lastoyz/dsn_pgu_adda_s3100_git/dsn/1.sch/S3100_CMU_ADDA__r210827__remap.pdf

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
SMBJ15A/DO-214AA
Breakdown Voltage: 18.5 V
Working Voltage: 15 V
Clamping Voltage: 24.4 V
Ipp - Peak Pulse Current: 24.6 A Package / Case: DO-214AA-2
Pd - Power Dissipation: 600 W

=== cut-off freq ===
1 / (2 * pi * sqrt (4.7e-6H * 22uF) ) = 15.6516404 kilohertz 1 / (2 * pi * sqrt (4.7e-6H * 47uF) ) = 10.708343 kilohertz

for power lines

for power lines

miniSMDC150F/16-2/4532
Hold Current: 1.5 A
Maximum Voltage: 16 V
Trip Current: 2.9 A
Resistance: 110 mOhms

LT1763CS8-5V
LT1763CS8-2.5V
LT1763CS8-3.3V
LT1763CS8-1.8V

DAMPER
Cbyp=22uF / Cdamp=470uF / L=4.7uH / R=0.22R Cbyp=10uF / Cdamp=220uF / L=2.2uH / R=0.22R Cbyp=100nF / Cdamp=4.7uF / L=22nH / R=0.22R

(15V-2.5V)/1mA=12.5Kohm

(15V-2.5V)/1.25mA=10Kohm ---- 1 / (2 * pi * (50 ohm) * (100 nF)) = 31.8309886 kilohertz 1 / (2 * pi * (50 ohm) * (10 pF)) = 318.309886 megahertz 1 / (2 * pi * (25e3 ohm) * (47 nF)) = 135.451015 hertz 1 / (2 * pi * (1000 ohm) * (47 nF)) = 3.38627538 kilohertz 1 / (2 * pi * (1000 ohm) * (470 nF)) = 338.627538 hertz 1 / (2 * pi * (1000 ohm) * (4700 nF)) = 33.8627538 hertz 1 / (2 * pi * (100 ohm) * (47 nF)) = 33.8627538 kilohertz 1 / (2 * pi * (100 ohm) * (470 nF)) = 3.38627538 kilohertz 1 / (2 * pi * (100 ohm) * (4700 nF)) = 338.627538 hertz ACASN1001S5001P1AT/1616 // Resistor Networks & Arrays 1K/5Kohm .1%/.05% 25/15ppm MPMA10015001AT5/SOT-23 // Resistor Networks & Arrays 1K/5Kohms 0.1%abs 0.05%ratio

414026-2
RF Series: SMB
Gender: Jack
Impedance: 50 Ohms
Minimum Frequency: -
Maximum Frequency: 4 GHz
Termination Style: Solder
Orientation: Right Angle
Polarity: Standard
Packaging: Bulk
Body Material: Brass
Contact Plating: Gold
Brand: TE Connectivity
Contact Material: Brass
Body Finish: Gold
Insulation Resistance: 1000 MOhms https://kr.mouser.com/datasheet/2/418/NG_CS_1307191_SMB_Connectors_0307-1234521.pdf

SRF2012A-121YA
Impedance: 120 Ohms
Tolerance: 25 %
Maximum DC Current: 400 mA
Maximum DC Resistance: 300 mOhms
Self Resonant Frequency: -
Minimum Operating Temperature: - 55 C Maximum Operating Temperature: + 125 C Package / Case: 0805 (2012 metric) Length: 2 mm
Width: 1.2 mm
Height: 1.2 mm
Packaging: Cut Tape
Packaging: MouseReel
Packaging: Reel
Product: Common Mode Line Filters https://kr.mouser.com/datasheet/2/54/rf2012aa-948268.pdf

DS90LV804TSQ/WQFN-32
Number of Drivers: 4 Driver Number of Receivers: 4 Receiver Data Rate: 800 Mb/s
Input Type: CML, LVDS, LVPECL Output Type: LVDS
Supply Voltage - Max: 3.45 V
Supply Voltage - Min: 3.15 V Minimum Operating Temperature: - 40 C Maximum Operating Temperature: + 85 C Mounting Style: SMD/SMT
Package / Case: LLP EP
Packaging: Cut Tape
Packaging: MouseReel
Packaging: Reel
Height: 0.8 mm
Input Voltage MAX: 0.1 V
Length: 5 mm
Series: DS90LV804
Width: 5 mm
Brand: Texas Instruments
Input Voltage MIN: - 0.1 V Maximum Output Voltage: 0.6 V Operating Supply Current: 140 mA Operating Supply Voltage: 3.3 V Pd - Power Dissipation: 4160 mW

SY89832UMG/QFN-16
Series: SY89832
Number of Outputs: 4 Output Maximum Input Frequency: 2.5 GHz Propagation Delay - Max: 570 ps Supply Voltage - Max: 2.625 V
Supply Voltage - Min: 2.375 V Minimum Operating Temperature: - 40 C Maximum Operating Temperature: + 85 C Mounting Style: SMD/SMT
Package / Case: QFN-16
Packaging: Tube
Brand: Microchip Technology / Micrel
Operating Supply Current: 75 mA
Product Type: Clock Buffer https://kr.mouser.com/datasheet/2/268/sy89832u-779039.pdf

1/(2*pi*47pF*10ohm)=338.627538 megahertz
1 / (2 * pi * (3.94700 nF) * (10 ohm)) = 4.03230157 megahertz
1 / (2 * pi * ((2.0 nF) + (47 pF)) * (10 ohm)) = 7.77503386 megahertz 1 / (2 * pi * ((1.0 nF) + (47 pF)) * (10 ohm)) = 15.2010452 megahertz GCM1885C1H202FA16J/2.0nF/1%/50V/1608

1/(2*pi*12pF*3*50ohm)=88.4194128 megahertz // 3 cap in IC
1 / (2 * pi * ((12 pF) + (130 pF)) * 3 * (50 ohm)) = 7.47206306 megahertz // 3 cap ext 1 / (2 * pi * ((12 pF) + (2* 56 pF)) * 3 * (50 ohm)) = 8.55671737 megahertz // 3 cap ext 1 / (2 * pi * ((12 pF) + (56 pF)) * 3 * (50 ohm)) = 15.6034258 megahertz

1.5A

THS4631DDA/SO-PowerPAD-8
http://www.ti.com/lit/ds/symlink/ths4631.pdf

1 / (2 * pi * (100 ohm) * (10 pF)) = 159.154943 megahertz

# 02. DAC powers regulators

# 03. [TRIG-IN/OUT, REF-IN/OUT] LVDS buffers and Clock IC trig signal to from FPGA/PLL // CMOS to LVDS

# 05. [ADC-IN] ADC port in (2ch) gain x1 or x1/12 // dc couple

# 06. ADC cores (2ch) Diff. driver // 15Msps ADC // filter BW7.5MHz // Clock driver

# 07. ADC control buffer (2ch) LVDS driver // 2.5V gate driver

# 08. AUX port and devices LAN port // DEBUG port // SIO port // EEPROM // TEMP sensor

== ext module control ==
3.3V
GND
CC11 : SDA // reserved for SSD1306 I2C CC9 : SCL // reserved ---- 3.3V

GND
CC8 : MOSI // reserved for MCP23S17 CC9 : SCLK // reserved
CC10: SCSB // reserved
CC12: MISO // reserved

TS1 TS0 SCALAR MULTIPLIER (µs/K) GND GND 10
GND VDD 40
VDD GND 160
VDD VDD 640 --T( C) = PERIOD(µs) / SCALAR MULTIPLIER(µs/ K) - 273.15 K --1MHz base count ... 0.1K resolution ... 16 bit counter

100C ~ 373K ~ 3730 us @ 10us/K 30C ~ 303K ~ 3030 us @ 10us/K

# 16. Mother board connector

S3100

# Mount holes and Power TP // Ground paths and Guide pin socket

# Powers on DGND

// +5VD

# 17. Mother board signal buffers

S3100

((3.3 V) - (1.0 V)) / (1e3 ohm) = 0.0023 amperes

# 10. Serial to Parallel circuits // MCP23S17T-E/ML and LED test drive

# 04. DAC cores (2ch) Single-Diff. translator // 400Msps DAC // filter BW90MHz // Clock IC

# 15. Powers on AGND // filters // +15V_FPGA // +15V_ANAL // +/-15V_AMP

# 14. Power Gated // +/-13.5V_AMP // +/-13.5V_ADC_BUF // +/-15V_AMP_GATED

# 12. Powers on GND_ANAL // REG and filter // +6V_ANAL // +5V_ANAL // +3.3V_ANAL // +2.5V_ANAL // +2.5V_ANAL_AUX

# 11. IO Powers on GND_FPGA // LDO REG and filter

// +3.3V_ISO | // +3.3V_FPGA_IO | // +3.3V_SP_IO // +3.3V_DAC_IO // +3.3V_EXT

XC6220B331MR-G/3.3V/1.2A/SOT-25-5 Package / Case: SOT-25-5
Output Voltage: 3.3 V
Output Current: 1.2 A
Number of Outputs: 1 Output Quiescent Current: 8 uA
Input Voltage MAX: 6 V
Input Voltage MIN: 1.6 V
Output Type: Fixed
Minimum Operating Temperature: - 40 C Maximum Operating Temperature: + 85 C Load Regulation: 10 mV
Dropout Voltage: 60 mV
Packaging: Cut Tape
Packaging: MouseReel
Packaging: Reel
Product: LDO Regulators
Type: Low Noise High Speed, CMOS LDO Voltage Regulator Brand: Torex Semiconductor
Dropout Voltage - Max: 655 mV
PSRR / Ripple Rejection - Typ: 50 dB
Voltage Regulation Accuracy: 1 % Line Regulation: 0.01 %/V
Operating Supply Current: 50 uA
Pd - Power Dissipation: 250 mW

# 13. Powers on GND_FPGA // SW REG // +5V_FPGA_CORE // MC1_VDCIN_P5V // +5V_FPGA_IO

# 01. [PULSE-OUT] AMP for DAC gain stage // LC filter

DAMPER
Cbyp=22uF / Cdamp=470uF / L=4.7uH / R=0.22R Cbyp=10uF / Cdamp=220uF / L=2.2uH / R=0.22R Cbyp=100nF / Cdamp=4.7uF / L=22nH / R=0.22R

1 / (2 * pi * (100 ohm) * (47 nF)) = 33.8627538 kilohertz 1 / (2 * pi * (100 ohm) * (470 nF)) = 3.38627538 kilohertz

1 / (2 * pi * (6000 ohm) * (47 nF)) = 564.379231 hertz 1 / (2 * pi * (6000 ohm) * (470 nF)) = 56.4379231 hertz

Place near R197
diff pair: Vadc2_amp_ac_P / Vadc2_amp_ac_N

Place near R286
diff pair: Vadc1_amp_ac_P / Vadc1_amp_ac_N

* note: place ADA4870ARRZ on BOT-side.

During normal operation, the TFL pin outputs a dc voltage (referenced to VEE) ranging from 1.5 V to 1.9 V that is relative to die temperature. The voltage on TFL changes at approximately
?3 mV/°C and can be used to indicate approximate increases in
die temperature.

* TEST drive

* trace in on BOT
* trace out on TOP

* place chokes on BOT

DAC data in has 100 ohm inside.

The pins are internally self-biased and the input signal should be ac-coupled via capacitors.

* trace in on BOT
* trace out on TOP

* place chokes on BOT

* TEST drive

DAC data in has 100 ohm inside.

*bias for 400mV
287/(287+1000)*1.8V = 0.401398601 volts 360/(360+1200)*1.8V = 0.415384615 volts

*bias for 400mV
287/(287+1000)*1.8V = 0.401398601 volts 360/(360+1200)*1.8V = 0.415384615 volts

1 / (2 * pi * (50 ohm) * (100 pF)) = 31.8309886 megahertz 1 / (2 * pi * (50 ohm) * (100 nF)) = 31.8309886 kilohertz 1 / (2 * pi * (50 ohm) * (47 nF)) = 67.7255077 kilohertz

SP_001
A[2,1,0]="001"

rise 0.05V/ms
((3.3 V) / (0.05 (V / ms))) / (2 * pi * (20e3 ohm)) = 525.211312 nanofarads

* ADC amp gain
12V --> 1V | vs | 11V --> 1V vs 1V --> 1V
1/12
x/(25+x)=1/12
25/x=12-1=11
x=25/11=2.273
24KR/1608/10ppm/0.05%/100mW_RG1608N-243-W-T1 2.2KR/1608/10ppm/0.05%/100mW_RG1608N-222-W-T1 2.2/(24+2.2)=0.08396946564=1/11.9090909091 2.4KR/1608/10ppm/0.05%/100mW_RG1608N-242-W-T1 2.2/(24+2.2)=0.0909090909=1/11

LT1763CS8-5V vs LT3045
... LT3045 for low noise 5V

ADP7182AUJZ-5.0-R7/TSOT-25-5 for -5V

250mA per ADA4870 supply with 50ohm load.

TS1 TS0 SCALAR MULTIPLIER (µs/K) GND GND 10
GND VDD 40
VDD GND 160
VDD VDD 640 --T( C) = PERIOD(µs) / SCALAR MULTIPLIER(µs/ K) - 273.15 K

삭삭:
PJ3
F3
L36
FB94
C399
CT15
C395

# LED17

R510
ZD46

삭삭:
U90
C475
C377
C376
R591
R592

삭삭:
U57
C347
ZD27
R906
R907

# LED19

C348
FB91
FB92

삭삭:
U58
C352
C353
C354
C355
U61
C372
C373
C374
C375
U63
C388
C394
C389
C393
U64
C400
C401
C402
C403

삭삭:
SJ3
SJ4
T7
T8
U113
U115
FB141
FB142
C608
C613
C625
C631
R697
R726
R734
R740
R750
R728
R731
R742
R748

삭삭:
U141
U142
D21
D22
D23
D24

삭삭:
Q1
ZD18
ZD19
Q2
ZD21
ZD20
TP66
TP70
RL1
RL2
Q3

# LED9

TP72

삭삭:
U31
U33
L27
L31
ZD40
ZD41
D5
D6
D4
D8

삭삭:
C226
C228
R184
R186
CT11
CT12

# < S3100-CMU-ADDA > Board name: S3100-CMU-ADDA ▶ Part number: S3100-CMU-ADDA-REV00 ▶ design file: S3100_CMU_ADDA__*.DSN

# Designed By: S JO Checked & Approved By: Jone

# === Revision note ===

Ver 0.0 || 2019.12.06 || PGU-CPU-F5500 test done.
Ver 1.0 || 2021.02.16 || PGU-CPU-S3000 initial draft.

# Ver 1.1 || 2021.04.05 || PGU-CPU-S3000 final BOM update

Ver 2.0 || 2021.05.13 || S3100-PGU initial draft.
Ver 3.0 || 2021.08.19 || S3100-CMU-ADDA initial draft.

# === PGU CPU BOARD ===

01.AMP for DAC [PULSE-OUT] 02.DAC powers 03.LVDS buffers and Clock IC [TRIG-IN/OUT, REF-IN/OUT] 04.DAC cores (2ch) 05.ADC port in (2ch) [ADC-IN] 06.ADC cores (2ch) 07.ADC control buffer (2ch) 08.AUX port and devices 09.FPGA interface (-1,-2,-3) 10.Serial to Parallel circuits 11.IO Powers on GND_FPGA 12.Powers on GND_ANAL 13.Powers on GND_FPGA 14.Power Gated 15.Powers on AGND 16.Mother board connector 17.Mother board signal buffer and power

# === 회회 및 BOM 변변변 요요 (2021.8.19) ===

S3100-CMU-ADDA 보보보 S3100-PGU 보보보보 수수수수, AC-counpled ADC 입입입 지지지지지.

# === Requirement === * PCB spec: FR-4, 6L, 1.6T, 360mm X 188.5mm * TOP/BOT impedance artwork (signle 50R / diff 100R)

* 2L and 5L are for GND.
* 3L and 4L are for GND / PWR.

# * BOARD edge clearance 2mm

* CGND on board egdes.

삭삭:
U133
U134

삭삭:
U111
L43
D16
C582
C583
R680
R674
C576
C592
R685
R686
R689
R692
C581
R683
C590
C595
R693
C599
R684
R690
C593

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
R698
R702
R706
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
FB149
FB150
ZD59
ZD60

삭삭:
U22
D3
L13
R82
C98
C114
C118
R102
C137
R129
R135
C157
C149
R103
C113
C131
TP43
R115
R123
C135

0
1 | 5 | 9-1 | 13
2 | 6 | 9-2 | 14
3 | | 9-3 | 15
4 | 7 12 | 10 | 16
| 8 11 | | 17

삭삭:
U3
FB13

[Molex]1719710006//50579406 --> [Molex]1719740006//50579406

mating part: [Molex]50579406

# ===final revision (2021.09.xx) ===

* 2021.5.13
임임 전전 커커커 파파 변변:

2EDGR-5.08-02P//2EDGK-5.08-02P --> 2EDGV-5.08-02P//2EDGK-5.08-02P

Guide Module
P1 for M3 bolt (PLATED)
P2/P3 for module guide pins (NON-PLATED)

삭삭:
LJ1
LJ2

# power net LAN_P3V3

삭삭:
TP
F5500용

DIAG_SIGNAL
DIAG_GUARD

DIAG_SIGNAL
DIAG_GUARD

DIAG_SIGNAL
DIAG_GUARD

M1_SPI_TX_CLK+
M1_SPI_TX_CLK-

M1_SPI_MOSI+
M1_SPI_MOSI-

M0_SPI_MOSI+ M0_SPI_MOSI-

M0_SPI_TX_CLK+ M0_SPI_TX_CLK- | M1_SPI_CS M0_SPI_CS

CAL_SPI_CS
CAL_SPI_CLK

CAL_SPI_MOSI
CAL_SPI_MISO

NC
BD_nRESET

NC
PRE_TRIG+
PRE_TRIG-

TRIG+ TRIG-

SOT+
SOT-

M1_SPI_RX_CLK+ M1_SPI_RX_CLK- M1_SPI_MISO+ M1_SPI_MISO-

M0_SPI_MISO+ M0_SPI_MISO-

M0_SPI_RX_CLK+ M0_SPI_RX_CLK-

DIAG_SIGNAL DIAG_GUARD

R1
R2---- R2 = R1 / ( Vo/0.798 -1 )

Vo = ( 1 + R1 / R2 ) * 0.798
( 1 + 40.2 / 7.68 ) * 0.798 = 4.97503125 V ( 1 + 40.2 / 6.8 ) * 0.798 = 5.51558823529 V ---- 40.2K/1608/0.1%_ERJ-PB3B4022V

7.68K/1608/0.1%_ERJ-PB3B7681V 6.8K/1608/0.1%_ERJ-PB3B6801V

R1
R2---- R2 = R1 / ( Vo/0.798 -1 )

Vo = ( 1 + R1 / R2 ) * 0.798
( 1 + 40.2 / 7.68 ) * 0.798 = 4.97503125 V ( 1 + 40.2 / 6.8 ) * 0.798 = 5.51558823529 V ---- 40.2K/1608/0.1%_ERJ-PB3B4022V

7.68K/1608/0.1%_ERJ-PB3B7681V 6.8K/1608/0.1%_ERJ-PB3B6801V

R1
R2---- R2 = R1 / ( Vo/0.798 -1 )

Vo = ( 1 + R1 / R2 ) * 0.798
( 1 + 40.2 / 7.68 ) * 0.798 = 4.97503125 V ( 1 + 40.2 / 6.8 ) * 0.798 = 5.51558823529 V ---- 40.2K/1608/0.1%_ERJ-PB3B4022V

7.68K/1608/0.1%_ERJ-PB3B7681V 6.8K/1608/0.1%_ERJ-PB3B6801V

R1
R2---- R2 = R1 / ( Vo/0.798 -1 )

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

7.68K/1608/0.1%_ERJ-PB3B7681V 6.8K/1608/0.1%_ERJ-PB3B6801V

R1
R2---- R2 = R1 / ( Vo/0.798 -1 )

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

7.68K/1608/0.1%_ERJ-PB3B7681V 6.8K/1608/0.1%_ERJ-PB3B6801V

for SY89832UMG/QFN-16

for SY89833LMG/QFN-16

for SY89832UMG/QFN-16

for SY89833LMG/QFN-16

삭삭:

U6
FB9

PN SWAP

PN SWAP

삭삭:
JJ1

# JTAG_PWR

삭삭:

FB6
FB7

# 09-1. FPGA interface

# 09-2. FPGA interface

# 09-3. FPGA interface

# +1.0VF GEN (for FPGA VCCINT)

Rb = (0.75 * 100,000) / (1.0 - 0.75) = 75,000 / 0.25
= 300,000
= 300K

# <MAX 3.0A>

Ra

Rb

# [FPGA Power] VCCINT = 1.0V VCCBRAM = 1.0V VAUX = 1.8V VAUX_IO = 1.8V VCCO_HR = 1.14~3.465V VCCO_HP = 1.14~1.89V (Spartan7에에 없없) VCCBATT = 1.8V VCCADC = 1.8V

# <MAX 2.0A>

R1

R2

# +3.3VF (for FPGA VCCO_HR)

TPS82084SIL:
Vout = 0.8V * (1+(R1/R2)) ---- 3.31V = 0.8V * (1+(160K/51K))

3.35V = 0.8V * (1+(510K/160K))

# +3.3VD GEN (for MAIN)

# <MAX 2.0A>

R1

R2

TPS82084SIL:
Vout = 0.8V * (1+(R1/R2)) ---- 3.31V = 0.8V * (1+(160K/51K))

3.35V = 0.8V * (1+(510K/160K))

# +1.8VF GEN (for FPGA VAUX)

# <MAX 2.0A>

R1

R2

TPS82084SIL:
Vout = 0.8V * (1+(R1/R2)) ---- 1.8V = 0.8V * (1+(200K/160K))

Initialization (bar)
Active-Low FPGA initialization pin or configuration error signal. The FPGA drives this pin Low when the
FPGA is in a configuration reset state, when the FPGA is initializing (clearing) its configuration memory, or when the FPGA has detected a configuration error. Upon completing the FPGA initialization process, INIT_B is released to high-Z at which time an external resistor is expected to pull INIT_B High. INIT_B can externally be held Low during power-up to stall the power-on configuration sequence at the end of the initialization process. When a High is detected at the INIT_B input after the initialization process, the FPGA proceeds with the remainder of the configuration sequence dictated by the M[2:0] pin settings.
Connect INIT_B to a ≤ 4.7 kΩ pull-up resistor to VCCO_0 to ensure clean Low-to-High transitions.

# [JTAG]

Done
A High signal on the DONE pin indicates completion of the configuration sequence. The DONE output is an open-drain output by default.

Program (bar)
Active-Low reset to configuration logic. When PROGRAM_B is pulsed Low, the FPGA configuration is cleared and a new configuration sequence is initiated. Configuration reset initiated upon falling edge, and configuration (i.e. programming) sequence begins upon the following rising edge.
Connect PROGRAM_B to an external ≤ 4.7 kΩ pull-up resistor to VCCO_0 to ensure a stable High input, and recommend push-button to GND to enable manual configuration reset.

# [FPGA Power] VCCINT = -0.5~1.1 [1.0V] VCCBRAM = -0.5~1.1 [1.0V] VCCAUX = -0.5 ~ 2.0V [1.8V] VCCAUX_IO = -0.5 ~ 2.0V [1.8V] VCCO_HR = 1.14~3.465V VCCO_HP = 1.14~1.89V (Artix7에에 없없) VCCBATT = -0.5 ~ 2.0V [1.8V] VCCADC = -0.5 ~ 2.0V [1.8V]

# [FPGA Power] VCCADC = -0.5 ~ 2.0V [1.8V] VREF = -0.5 ~ 2.0V [1.25V] to GNDADC

# FPGA - POWER

# MT25QL = 2.7V ~ 3.6V MT25QU = 1.7V ~ 2.0V

# [FPGA Power] VCCINT = -0.5~1.1 [1.0V] VCCBRAM = -0.5~1.1 [1.0V] VCCAUX = -0.5 ~ 2.0V [1.8V] VCCAUX_IO = -0.5 ~ 2.0V [1.8V] VCCO_HR = 1.14~3.465V VCCO_HP = 1.14~1.89V (Artix7에에 없없) VCCBATT = -0.5 ~ 2.0V [1.8V]

Pull-Up During Configuration (bar)
Active-Low PUDC_B input enables internal pull-up resistors on the SelectIO pins after power-up and during configuration.
> When PUDC_B is Low, internal pull-up resistors are enabled on each SelectIO pin.
> When PUDC_B is High, internal pull-up resistors are disabled on each SelectIO pin.
PUDC_B must be tied either directly, or via a ≤ 1kΩ to VCCO_14 or GND.
Caution! Do not allow this pin to float before and during configuration

If the TCK signal is
buffered, connect the buffer input to an external weak (e.g. 10 kΩ) pull-up resistor to maintain a valid High when no cable is connected.

If the TMS signal is buffered, connect the buffer
input to an external weak (e.g. 10 kΩ) pull-up resistor to maintain a valid High when no cable is connected.

VCCBATT is required only when using bitstream encryption. If battery is not used, connect VCCBATT
to either ground or VCCAUX.

If the VCCO_0 supply for bank 0 is
supplied with 2.5V or 3.3V, then the CFGBVS pin must
be tied High (i.e. connected to VCCO_0). Tie CFGBVS to Low (i.e. connected to GND), only if the VCCO_0 for bank 0 is less than or equal to 1.8V. If used during configuration, banks 14 and 15 should match the VCCO level applied to bank 0

Configuration Mode Sel (M2:0)
- Master SPI: 001
- Master Serial: 000
- JTAG: 101

# <MAX 1.0A>

# S25FL256SAGNFI001

# S25FL128SAGNFI001

# MT25QU256ABA1EW9_0SIT

Temperature-sensing diode pins (Anode: DXP; Cathode:
DXN). The thermal diode is accessed by using the DXP and DXN pins in bank 0. When not used, tie to GND.

# FPGA - Configuration Part

# EEPROM 16K 2048X8 1.8V~3.3V SERIAL EE IND

# FPGA IO

<0.55V>

# [FPGA Power] MGTAVCC = 1.0V MGTAVTT = 1.25V

# BANK 216 : MGT (NOT USED)

# Silk : ADDA BD ID : 0x05 <LSB 4Bits>

[0] [1]
[0] [1]

또또 INT를 제제제제
INT동동동동

RST를 제제제제 initialize or re-initialize

W5500

폴폴폴폴폴폴
구동
to. WIZ850 J1 | to. WIZ850 J2

JL1

JL2

# LAN 모모모모모모모모 Connector

# [F_LED0]

# [F_LED7]

# FPGA IO

* note: DAC1 has pn swap pairs.

AGND

+15V_FPGA

GND_FPGA

AGND

+15V_ANAL

GND_ANAL

+15VAIN

AGND

-15VAIN

+15V_AMP

GND_AMP

-15V_AMP

+13.5V_AMP

-13.5V_AMP

+6V_ANAL

+5V_ANAL

+2.5V_ANAL

GND_ANAL

GND_ANAL

GND_ANAL

GND_ANAL

+6V_ANAL_DAMP

+6V_ANAL_DAMP | +2.5V_ANAL_AUX

CGND

DGND | CGND
AGND | CGND

GND_AMP

GND_AMP | GND_ANAL

GND_AMP

GND_AMP | GND_ANAL

+5V_ANAL

GND_ANAL

+6V_ANAL_DAMP | +3.3V_ANAL0

GND_ANAL

+2.5V_ANAL

+5V_ANAL

GND_ANAL

+3.3V_ANAL2 | GND_FPGA

GND_ANAL

+2.5V_ANAL_AUX

GND_ANAL

GND_FPGA
GND_ANAL

+3.3V_ANAL1

GND_FPGA
GND_ANAL

+3.3V_ANAL0

GND_AMP

-13.5V_ADC_BUF

+13.5V_ADC_BUF

GND_AMP

-13.5V_ADC_BUF

+13.5V_ADC_BUF

-13.5V_AMP

+13.5V_AMP

+13.5V_ADC_BUF

-13.5V_ADC_BUF

GND_AMP

GND_AMP

+2.5V_ANAL_AUX

GND_ANAL

GND_FPGA

DISP_P3V3

GND_FPGA

GND_FPGA

TEMP_P3V3

GND_FPGA

MEM_P3V3

+15V_FPGA

GND_FPGA

+5V_FPGA_CORE

+5V_FPGA_IO

+3.3V_FPGA_IO

+3.3V_EXT

DGND

+15V_ANAL

GND_ANAL

+2.5V_ANAL_AUX

+5V_ANAL | +6V_ANAL

+2.5V_ANAL

+15VAIN

AGND

-15VAIN

+15V_AMP

-15V_AMP

+13.5V_AMP

GND_AMP

-13.5V_AMP

GND_FPGA

LED_P3V3

GND_FPGA

GND_FPGA

+3.3V_FPGA_IO

+5V_FPGA_IO

GND_FPGA

+3.3V_FPGA_IO | GND_FPGA

+3.3V_EXT

+5V_FPGA_IO

GND_FPGA

SPO_P3V3

LED_P3V3

GND_ANAL

+3.3V_ANAL1

GND_ANAL

+3.3V_ANAL2

+3.3V_ANAL0 | +3.3V_ANAL1 | +3.3V_ANAL2

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

+1.8VF

+1.8VF

VCC_ADC

+1.0VF

+3.3VF

VCC_ADC

+1.8VF | CONF_POW_1.8V

CONF_POW_1.8V

CONF_POW_1.8V

CONF_POW_1.8V | CONF_POW_1.8V

CONF_POW_1.8V

CONF_POW_1.8V

CONF_POW_1.8V

CONF_POW_1.8V

+1.8VF

+1.0VF

GND_ADC

GND_ADC
GND_ADC

GND_ADC

GND_ADC

GND_ADC

GND_FPGA

GND_FPGA

GND_FPGA

GND_FPGA

GND_FPGA

GND_FPGA

GND_FPGA

GND_FPGA

GND_FPGA | GND_FPGA

GND_FPGA

+3.3VF | +3.3VF

+3.3VF

GND_FPGA

GND_FPGA

+3.3VF | +3.3VF

+3.3VF

+3.3VF

+3.3VF | +3.3VF

+3.3VF

+3.3VF

+3.3VD | +3.3VD

+3.3VF

+3.3VF

+3.3VF

GND_FPGA

GND_FPGA

GND_FPGA

GND_FPGA

GND_FPGA

+1.8VF | +1.8VF

+3.3VF

+3.3VF | +3.3VF

+3.3VF

+1.8VF

+3.3VF

GND_FPGA | GND_FPGA
+3.3VF | +3.3VF | +3.3VF | +3.3VF

FPGA_CFG_D0

FPGA_CFG_D1

FPGA_CFG_D2

FPGA_CFG_D3

FPGA_CFG_PUDC_B

FPGA_CFG_FCS_B

FPGA_CFG_D0
FPGA_CFG_D1
FPGA_CFG_D2
FPGA_CFG_D3

FPGA_CFG_FCS_B

FPGA_CFG_PUDC_B

Title:

Size | Document Number | Rev
Date: | Sheet | of

Designed Checked Approved

TEAM

- 1.0

S3100-CMU-ADDA

Custom | S. JO | - | ____
Friday, August 27, 2021 | 1 | 2
| TBU

Title:

Size | Document Number | Rev
Date: | Sheet | of

Designed Checked Approved

TEAM

- 1.0

S3100-CMU-ADDA

Custom | S. JO | - | ____
Friday, August 27, 2021 | 1 | 2
| TBU

Title:

Size | Document Number | Rev
Date: | Sheet | of

Designed Checked Approved

TEAM

- 1.0

S3100-CMU-ADDA

Custom | S. JO | - | ____
Friday, August 27, 2021 | 1 | 2
| TBU

U163

SN74LVC1G126DBVR

OE 1

A 2

GND 3 | Y | 4
| VCC | 5

ZD5

BZT52C3V6_7_F/SOD-123 A C

R11

160K_F_1608

R92
2K_F_1608

C81

100NF_10V_0603

ZD50

BZT52C6V8-7-F/SOD-123

A C

C272

100nF/1005/10V

R98
0_F_1608

R727
100R/0603/1%

U166

SN74LVC1G126DBVR

OE 1

A 2

GND 3 | Y | 4
| VCC | 5

C145

1uF/2012/10V

C342
100nF/2012/16V/5%_VJ0805Y104JXJCW1BC

LCM23

EXC-24CH500U/1210/50R

1

2 | 3
| 4

F1

MINIASMDC150F/16-2/4532

1 | 2

C96

100NF_10V_0603

C147

10uF/3216/25V/10%

ZD53

ATV02W5V0B-HF/SOD-123

TP261

TP_DIP_H0_5XC0_9

1

R705
5.1KR/1608/10ppm/0.05%/100mW_RG1608N-512-W-T1

R984
1K/1608/1%

MH2
Mount_Hole

1

FB27

BLM21PG600SN1D_60R/3A/25%/2012

R768
100R/0603/1%

C565

100nF/3216/50V/5%_CGA5L2C0G1H104J160AA

R182

10K/1608/1%

C554
10uF/3216/25V/10%

R668
300R/1608/10ppm/0.05%/100mW_RG1608N-301-W-T1

F_LD2

LED_GREEN_SMD1608

C | A

U145

ADP7182AUJZ-5.0-R7/-5V/0.2A/TSOT-25-5

1 GND 2 Vin 3 EN | NC | 4 Vout 5

R831
100R/0603/1%

R124
10K_F_1608/DNP

J4

PIN_HEADER_2X5(2.54)

1 | 2 3 | 4 5 | 6 7 | 8 9 | 10

C114

100NF_10V_0603

C601
100nF/2012/16V/5%_VJ0805Y104JXJCW1BC

C249
100nF/2012/16V/5%_VJ0805Y104JXJCW1BC

C627
100nF/2012/16V/5%_VJ0805Y104JXJCW1BC

TP223

TP_DIP_H0_5XC0_9 1

GJ1

5223979-2

1
2
3

R887
0R/1608/1%

R712
0R/1608/1%

R139
0_F_1005

D15

1N4448WX-TP/75V/500mA/SOD-323

A | K

FB144

BLM21PG600SN1D_60R/3A/25%/2012

R300
0R/1608/1%

R1027

10K/1608/1%

R168
51_F_1608

LED12

RED/2012 C | A

R979
100KR/1608/1%

C547

1000pF/1608/50V/1%

U144

XC6220B331MR-G/3.3V/1.2A/SOT-25-5

Vin 1
GND 2
Ven 3 | BYPASS | 4
| Vout | 5

C344

100nF/2012/16V/5%_VJ0805Y104JXJCW1BC

C115

100NF_10V_0603

L42

100nH/2520/1%_LQW2UASR10F00L

LCM31

EXC-24CH500U/1210/50R

1

2 | 3
| 4

R545
0R/2012/1%

C322
100nF/1005/10V

FB2

BLM21PG600SN1D_60R/3A/25%/2012

C8

100nF/1005/10V

C330
47nF/1005/50V/5%_CC0402JRX7R9BB473

C244
100nF/3216/50V/5%_CGA5L2C0G1H104J160AA

LED7

GREEN/2012

A C

R1009 | 7.68K/1608/0.1%_ERJ-PB3B7681V

C326
47nF/1005/50V/5%_CC0402JRX7R9BB473

R918
30.1R/3216/25ppm/0.1%/2W_PCAN1206E30R1BST5

C62

100NF_10V_0603

R315
1K/1608/1%

+
CT1

470uF/7343/10V/10%/200mR_TPSE477K010R0200

R996 | 40.2K/1608/0.1%_ERJ-PB3B4022V

U19

XC6210B252MR-G/2.5V/0.7A/SOT-25-5

Vin 1
GND 2
Ven 3 | BYPASS | 4
| Vout | 5

TP124

TP_DIP_H0_5XC0_9

1

C604

10uF/3216/25V/10%

R905
0R/1608/1%

C266
47nF/1005/50V/5%_CC0402JRX7R9BB473

C648
100nF/2012/16V/5%_VJ0805Y104JXJCW1BC

MH7
Mount_Hole

1

R744
499R/1608/10ppm/0.05%/100mW_RG1608N-4990-W-T1

R879
0R/1608/1%

FB26

BLM21PG600SN1D_60R/3A/25%/2012

R309
0R/1608/1%

R797
100R/0603/1%

FB139

FBMH1608HM102-T_1KR/0.5A/25%/350mR/1608

TP216

TP_DIP_H0_5XC0_9 | 1

R328
0R/1608/1%

FB132

BLM21PG600SN1D_60R/3A/25%/2012

R94

0R/1608/1%

U127

NL17SV04XV5T2G/SOT-553

out 4

+ 5 - 3 in 2

FB65

BLM18KG121TH1D_120R/3A/25%/30mR/1608

C248

4.7uF/2012/50V/10%_CGA4J1X7R1H475K125AE

F7

PFMF.020.2/400mA_TR/400mR/4532 1 | 2

C504
100nF/2012/16V/5%_VJ0805Y104JXJCW1BC

R870

100R/0603/1%

TP7 TP_DIP_H0_5XC0_9

1

R90
2K_F_1608

R119
0_F_1608/DNP

R682

2.2K/1608/1%

C692
10pF/1608/50V/0.5pF__CGA3E2C0G1H100D080AD

R543
0R/2012/1%

LCM18

EXC-24CH500U/1210/50R

1

2 | 3
| 4

R830

49.9R/1608/25ppm/0.05%/100mW_WIN-T0603LF-03-49R9-A

C616
100nF/2012/16V/5%_VJ0805Y104JXJCW1BC

R719
100R/0603/1%

R802
100R/0603/1%

R720
0R/1608/1%

FB140

FBMH1608HM102-T_1KR/0.5A/25%/350mR/1608

R14

51K_F_1608

C64

100NF_10V_0603

R627
0R/2012/1%

R869
0R/1608/1%
1 | TP248 | TP_DIP_H0_5XC0_9

L37

IHLP2525BDER4R7M01/4.7uH

C722

100nF/1005/10V

FB81

BLM21PG600SN1D_60R/3A/25%/2012

U123

FIN1101K8X/US8-8

4 | GND_1
3 | EN | OUT+ | 6
2 | GND | VCC | 7
1 | IN-
OUT- | 5 IN+ | 8

C545
10uF/3216/25V/10%

C524

10uF/3216/25V/10%

C31

22UF_6.3V_2012_MLCC

C556

1000pF/1608/50V/1%

C84

100NF_10V_0603

FB57

BLM18KG121TH1D_120R/3A/25%/30mR/1608

R828
100R/0603/1%

R775
0R/1608/1%

T3

ACM1211-102-2PL-TL01/33.7uH/1K/6A/14mR/1211

1

3 | 2

4

C233
(OPEN)180pF/1608/50V/1%

R522
33R/1608/1%

TP222

TP_DIP_H0_5XC0_9 | 1

R839
(OPEN)0R/1608/1%

C615
100nF/2012/16V/5%_VJ0805Y104JXJCW1BC

C559
1000pF/1608/50V/1%

R778
100R/0603/1%

C242
10pF/1608/50V/0.5pF__CGA3E2C0G1H100D080AD

R898
20K/1608/1%

R43

0R/1608/1%

U107

AD8009ARZ/SOIC-8

4

V- 6
OUT | 3 +IN | 2
-IN 7 | V+ | 1

NC1

5

NC3

8

NC2

FB61

BLM21PG600SN1D_60R/3A/25%/2012

R152-1
330_F_1005

C128

100NF_50V_1005

C471

(OPEN)1000pF/1608/50V/1%

R165
51_F_1005

D16

FDLL4148/SOD

C

A

R971
0R/2012/1%

C570
10uF/3216/25V/10%

TP211

TP_DIP_H0_5XC0_9 | 1

LCM45

EXC-24CH500U/1210/50R

1

2 | 3
| 4
TP6 | TP_DIP_H0_5XC0_9

1

R104
0_F_1608

C143
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
