lastoyz/dsn_pgu_adda_s3100_git/txem7310_pll/_ref/PGU-CPU-S3100__R20210525.pdf

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
# * Measure: 3.3V * 1/11 = 0.3V See https://www.xilinx.com/support/documentation/user_guides/ug480_7Series_XADC.pdf Figure 2-8: Differential Input Signal Range // common mode 0.5V, diff mode 1V max

SILK:[0.275V] | SILK:[0.55V]

SMBJ15A/DO-214AA
Breakdown Voltage: 18.5 V
Working Voltage: 15 V
Clamping Voltage: 24.4 V
Ipp - Peak Pulse Current: 24.6 A Package / Case: DO-214AA-2
Pd - Power Dissipation: 600 W

=== cut-off freq ===
1 / (2 * pi * sqrt (4.7e-6H * 22uF) ) = 15.6516404 kilohertz 1 / (2 * pi * sqrt (4.7e-6H * 47uF) ) = 10.708343 kilohertz

for power lines

for power lines

miniSMDC150F/16-2/4532
Hold Current: 1.5 A
Maximum Voltage: 16 V
Trip Current: 2.9 A
Resistance: 110 mOhms

LT1763CS8-5V
LT1763CS8-2.5V
LT1763CS8-3.3V
LT1763CS8-1.8V

DAMPER
Cbyp=22uF / Cdamp=470uF / L=4.7uH / R=0.22R Cbyp=10uF / Cdamp=220uF / L=2.2uH / R=0.22R Cbyp=100nF / Cdamp=4.7uF / L=22nH / R=0.22R

CLK_COUT_PN 400MHz
ADC Conv clock 1 ~ 15MHz
DAC rate 400MHz

(15V-2.5V)/1mA=12.5Kohm

(15V-2.5V)/1.25mA=10Kohm ---- 1 / (2 * pi * (50 ohm) * (100 nF)) = 31.8309886 kilohertz 1 / (2 * pi * (50 ohm) * (10 pF)) = 318.309886 megahertz 1 / (2 * pi * (25e3 ohm) * (47 nF)) = 135.451015 hertz 1 / (2 * pi * (1000 ohm) * (47 nF)) = 3.38627538 kilohertz 1 / (2 * pi * (1000 ohm) * (470 nF)) = 338.627538 hertz 1 / (2 * pi * (1000 ohm) * (4700 nF)) = 33.8627538 hertz 1 / (2 * pi * (100 ohm) * (47 nF)) = 33.8627538 kilohertz 1 / (2 * pi * (100 ohm) * (470 nF)) = 3.38627538 kilohertz 1 / (2 * pi * (100 ohm) * (4700 nF)) = 338.627538 hertz ACASN1001S5001P1AT/1616 // Resistor Networks & Arrays 1K/5Kohm .1%/.05% 25/15ppm MPMA10015001AT5/SOT-23 // Resistor Networks & Arrays 1K/5Kohms 0.1%abs 0.05%ratio

414026-2
RF Series: SMB
Gender: Jack
Impedance: 50 Ohms
Minimum Frequency: -
Maximum Frequency: 4 GHz
Termination Style: Solder
Orientation: Right Angle
Polarity: Standard
Packaging: Bulk
Body Material: Brass
Contact Plating: Gold
Brand: TE Connectivity
Contact Material: Brass
Body Finish: Gold
Insulation Resistance: 1000 MOhms https://kr.mouser.com/datasheet/2/418/NG_CS_1307191_SMB_Connectors_0307-1234521.pdf

SRF2012A-121YA
Impedance: 120 Ohms
Tolerance: 25 %
Maximum DC Current: 400 mA
Maximum DC Resistance: 300 mOhms
Self Resonant Frequency: -
Minimum Operating Temperature: - 55 C Maximum Operating Temperature: + 125 C Package / Case: 0805 (2012 metric) Length: 2 mm
Width: 1.2 mm
Height: 1.2 mm
Packaging: Cut Tape
Packaging: MouseReel
Packaging: Reel
Product: Common Mode Line Filters https://kr.mouser.com/datasheet/2/54/rf2012aa-948268.pdf

DS90LV804TSQ/WQFN-32
Number of Drivers: 4 Driver Number of Receivers: 4 Receiver Data Rate: 800 Mb/s
Input Type: CML, LVDS, LVPECL Output Type: LVDS
Supply Voltage - Max: 3.45 V
Supply Voltage - Min: 3.15 V Minimum Operating Temperature: - 40 C Maximum Operating Temperature: + 85 C Mounting Style: SMD/SMT
Package / Case: LLP EP
Packaging: Cut Tape
Packaging: MouseReel
Packaging: Reel
Height: 0.8 mm
Input Voltage MAX: 0.1 V
Length: 5 mm
Series: DS90LV804
Width: 5 mm
Brand: Texas Instruments
Input Voltage MIN: - 0.1 V Maximum Output Voltage: 0.6 V Operating Supply Current: 140 mA Operating Supply Voltage: 3.3 V Pd - Power Dissipation: 4160 mW

SY89832UMG/QFN-16
Series: SY89832
Number of Outputs: 4 Output Maximum Input Frequency: 2.5 GHz Propagation Delay - Max: 570 ps Supply Voltage - Max: 2.625 V Supply Voltage - Min: 2.375 V Minimum Operating Temperature: - 40 C Maximum Operating Temperature: + 85 C Mounting Style: SMD/SMT
Package / Case: QFN-16
Packaging: Tube
Brand: Microchip Technology / Micrel
Operating Supply Current: 75 mA
Product Type: Clock Buffer https://kr.mouser.com/datasheet/2/268/sy89832u-779039.pdf

1/(2*pi*47pF*10ohm)=338.627538 megahertz
1 / (2 * pi * (3.94700 nF) * (10 ohm)) = 4.03230157 megahertz
1 / (2 * pi * ((2.0 nF) + (47 pF)) * (10 ohm)) = 7.77503386 megahertz 1 / (2 * pi * ((1.0 nF) + (47 pF)) * (10 ohm)) = 15.2010452 megahertz GCM1885C1H202FA16J/2.0nF/1%/50V/1608

1/(2*pi*12pF*3*50ohm)=88.4194128 megahertz // 3 cap in IC
1 / (2 * pi * ((12 pF) + (130 pF)) * 3 * (50 ohm)) = 7.47206306 megahertz // 3 cap ext 1 / (2 * pi * ((12 pF) + (2* 56 pF)) * 3 * (50 ohm)) = 8.55671737 megahertz // 3 cap ext 1 / (2 * pi * ((12 pF) + (56 pF)) * 3 * (50 ohm)) = 15.6034258 megahertz

1.5A

THS4631DDA/SO-PowerPAD-8
http://www.ti.com/lit/ds/symlink/ths4631.pdf

1 / (2 * pi * (100 ohm) * (10 pF)) = 159.154943 megahertz

# 02. DAC powers regulators

# 03. [TRIG-IN/OUT, REF-IN/OUT] LVDS buffers and Clock IC trig signal to from FPGA/PLL // CMOS to LVDS

# 05. [ADC-IN] ADC port in (2ch) gain x1 or x1/12 // dc couple

# 06. ADC cores (2ch) Diff. driver // 15Msps ADC // filter BW7.5MHz // Clock driver

# 07. ADC control buffer (2ch) LVDS driver // 2.5V gate driver

# 08. AUX port and devices LAN port // DEBUG port // SIO port // EEPROM // TEMP sensor

== ext module control ==
3.3V
GND
CC11 : SDA // reserved for SSD1306 I2C CC9 : SCL // reserved ---- 3.3V

GND
CC8 : MOSI // reserved for MCP23S17 CC9 : SCLK // reserved
CC10: SCSB // reserved
CC12: MISO // reserved

TS1 TS0 SCALAR MULTIPLIER (µs/K) GND GND 10
GND VDD 40
VDD GND 160
VDD VDD 640 --T( C) = PERIOD(µs) / SCALAR MULTIPLIER(µs/ K) - 273.15 K --1MHz base count ... 0.1K resolution ... 16 bit counter

100C ~ 373K ~ 3730 us @ 10us/K 30C ~ 303K ~ 3030 us @ 10us/K

# 09. FPGA module interface XEM7310

# 16. Mother board connector

S3100

# Mount holes and Power TP // Ground paths and Guide pin socket

# Powers on DGND

// +5VD

# 17. Mother board signal buffers

S3100

((3.3 V) - (1.0 V)) / (1e3 ohm) = 0.0023 amperes

# 10. Serial to Parallel circuits // MCP23S17T-E/ML and LED test drive

# 04. DAC cores (2ch) Single-Diff. translator // 400Msps DAC // filter BW90MHz // Clock IC

# 15. Powers on AGND // filters // +15V_FPGA // +15V_ANAL // +/-15V_AMP

# 14. Power Gated // +/-13.5V_AMP // +/-13.5V_ADC_BUF // +/-15V_AMP_GATED

# 12. Powers on GND_ANAL // REG and filter // +6V_ANAL // +5V_ANAL // +3.3V_ANAL // +2.5V_ANAL // +2.5V_ANAL_AUX

# 11. IO Powers on GND_FPGA // LDO REG and filter

// +3.3V_ISO | // +3.3V_FPGA_IO | // +3.3V_SP_IO // +3.3V_DAC_IO // +3.3V_EXT

XC6220B331MR-G/3.3V/1.2A/SOT-25-5 Package / Case: SOT-25-5
Output Voltage: 3.3 V
Output Current: 1.2 A
Number of Outputs: 1 Output Quiescent Current: 8 uA
Input Voltage MAX: 6 V
Input Voltage MIN: 1.6 V
Output Type: Fixed
Minimum Operating Temperature: - 40 C Maximum Operating Temperature: + 85 C Load Regulation: 10 mV
Dropout Voltage: 60 mV
Packaging: Cut Tape
Packaging: MouseReel
Packaging: Reel
Product: LDO Regulators
Type: Low Noise High Speed, CMOS LDO Voltage Regulator Brand: Torex Semiconductor
Dropout Voltage - Max: 655 mV
PSRR / Ripple Rejection - Typ: 50 dB
Voltage Regulation Accuracy: 1 % Line Regulation: 0.01 %/V
Operating Supply Current: 50 uA
Pd - Power Dissipation: 250 mW

# 13. Powers on GND_FPGA // SW REG // +5V_FPGA_CORE // MC1_VDCIN_P5V // +5V_FPGA_IO

# 01. [PULSE-OUT] AMP for DAC gain stage // LC filter

=== JTAG artwork note ===
* group route for JTAG_xxx * GND guard for JTAG_xxx

DAMPER
Cbyp=22uF / Cdamp=470uF / L=4.7uH / R=0.22R Cbyp=10uF / Cdamp=220uF / L=2.2uH / R=0.22R Cbyp=100nF / Cdamp=4.7uF / L=22nH / R=0.22R

1 / (2 * pi * (100 ohm) * (47 nF)) = 33.8627538 kilohertz 1 / (2 * pi * (100 ohm) * (470 nF)) = 3.38627538 kilohertz

1 / (2 * pi * (6000 ohm) * (47 nF)) = 564.379231 hertz 1 / (2 * pi * (6000 ohm) * (470 nF)) = 56.4379231 hertz

Place near R197
diff pair: Vadc2_amp_ac_P / Vadc2_amp_ac_N

Place near R286
diff pair: Vadc1_amp_ac_P / Vadc1_amp_ac_N

== CLK IC ==
* CLK_LD to LED
* CLK_STAT can replace CLK_LD

* note: place ADA4870ARRZ on BOT-side.

During normal operation, the TFL pin outputs a dc voltage (referenced to VEE) ranging from 1.5 V to 1.9 V that is relative to die temperature. The voltage on TFL changes at approximately
?3 mV/°C and can be used to indicate approximate increases in
die temperature.

* TEST drive

* DAC trace on BOT with one via.

* trace in on BOT
* trace out on TOP

* place chokes on BOT

DAC data in has 100 ohm inside.

The pins are internally self-biased and the input signal should be ac-coupled via capacitors.

* trace in on BOT
* trace out on TOP

* place chokes on BOT

* TEST drive

DAC data in has 100 ohm inside.

*bias for 400mV
287/(287+1000)*1.8V = 0.401398601 volts 360/(360+1200)*1.8V = 0.415384615 volts

*bias for 400mV
287/(287+1000)*1.8V = 0.401398601 volts 360/(360+1200)*1.8V = 0.415384615 volts

1 / (2 * pi * (50 ohm) * (100 pF)) = 31.8309886 megahertz 1 / (2 * pi * (50 ohm) * (100 nF)) = 31.8309886 kilohertz 1 / (2 * pi * (50 ohm) * (47 nF)) = 67.7255077 kilohertz

SP_001
A[2,1,0]="001"

rise 0.05V/ms
((3.3 V) / (0.05 (V / ms))) / (2 * pi * (20e3 ohm)) = 525.211312 nanofarads

* ADC amp gain
12V --> 1V | vs | 11V --> 1V
1/12
x/(25+x)=1/12
25/x=12-1=11
x=25/11=2.273
24KR/1608/10ppm/0.05%/100mW_RG1608N-243-W-T1 2.2KR/1608/10ppm/0.05%/100mW_RG1608N-222-W-T1 2.2/(24+2.2)=0.08396946564=1/11.9090909091 2.4KR/1608/10ppm/0.05%/100mW_RG1608N-242-W-T1 2.2/(24+2.2)=0.0909090909=1/11

LT1763CS8-5V vs LT3045
... LT3045 for low noise 5V

ADP7182AUJZ-5.0-R7/TSOT-25-5 for -5V

250mA per ADA4870 supply with 50ohm load.

TS1 TS0 SCALAR MULTIPLIER (µs/K) GND GND 10
GND VDD 40
VDD GND 160
VDD VDD 640 --T( C) = PERIOD(µs) / SCALAR MULTIPLIER(µs/ K) - 273.15 K

삭삭:
R688
C594
R695
C603

삭삭:
PJ3
F3
L36
FB94
C399
CT15
C395

# LED17

R510
ZD46

삭삭:
U90
C475
C377
C376
R591
R592

삭삭:
U57
C347
ZD27
R906
R907

# LED19

C348
FB91
FB92

삭삭:
U58
C352
C353
C354
C355
U61
C372
C373
C374
C375
U63
C388
C394
C389
C393
U64
C400
C401
C402
C403

삭삭:
SJ3
SJ4
T7
T8
U113
U115
FB141
FB142
C608
C613
C625
C631
R697
R726
R734
R740
R750
R728
R731
R742
R748

삭삭:
U141
U142
D21
D22
D23
D24

삭삭:
Q1
ZD18
ZD19
Q2
ZD21
ZD20
TP66
TP70
RL1
RL2
Q3

# LED9

TP72

삭삭:
U31
U33
L27
L31
ZD40
ZD41
D5
D6
D4
D8

삭삭:
C226
C228
R184
R186
CT11
CT12

# < S3100-PGU > Board name: S3100-PGU ▶ Part number: S3100-PGU-REV00 ▶ design file: PGU-CPU-S3100__*.DSN

# Designed By: S JO Checked & Approved By: Jone

# === Revision note ===

Ver 0.0 || 2019.12.06 || PGU-CPU-F5500 test done.
Ver 1.0 || 2021.02.16 || PGU-CPU-S3000 initial draft.

# Ver 1.1 || 2021.04.05 || PGU-CPU-S3000 final BOM update

Ver 2.0 || 2021.05.13 || S3100-PGU initial draft.

# === PGU CPU BOARD ===

01.AMP for DAC [PULSE-OUT] 02.DAC powers 03.LVDS buffers and Clock IC [TRIG-IN/OUT, REF-IN/OUT] 04.DAC cores (2ch) 05.ADC port in (2ch) [ADC-IN] 06.ADC cores (2ch) 07.ADC control buffer (2ch) 08.AUX port and devices 09.FPGA module interface 10.Serial to Parallel circuits 11.IO Powers on GND_FPGA 12.Powers on GND_ANAL 13.Powers on GND_FPGA 14.Power Gated 15.Powers on AGND 16.Mother board connector F5500 17.Isolators and Powers on DGND

# === 회회 및 BOM 변변변 요요 (2020.5.13) === S3100-PGU 보보보 PGU-CPU-S3000 에에 수수수수수수, Mother board 회로 SPI 통통통

지지지지지.

# - V2_1. 보보 크크 확확: 360mm * 188.5mm

- V2_2. 마마마마 수수: 6개로 통신 추추추추 (MH22~MH27), 5개마(MH1,MH2,MH15,MH16,MH17) 위위 조수.
- V2_3. Guide pin socket모모(GJ1) 추추.

# - V2_4. 커커커 파마 변변(PJ1,PJ2): 2EDGV-5.08-02P//2EDGK-5.08-02P

- V2_5. FJ1 S3100 connector 핀핀수회 변변.
- V2_6. LAN interface를 SPI interface회 수수지지지. LJ1, LJ2 삭삭.
- V2_7. Slot ID 통신 버버 추추: U163, U164, U165, U166.
- V2_8. SPI 버버 추추: U153~U157, U159~U162.
- V2_9. Mother board SPI 통통통 5V 전지 IC 추추: U158.
- V2_10. LDO 전지 IC package 변변: U1, U2, U6, U23, U65, U66, U143, U144, U151.

# - V2_11. 불불요 전지 회회 삭삭: 3R/2012/100ppm/1%_PCAN0805K3R00FST5 -->

0R/2012/1%

# - V2_12. SW REG IC 변변: U148, U149, U150, U152. (TPS82130SILT-->MPM3610GQV-Z) - V2_13. clock buffer IC 파마 변변: U46, U52. (SY89832UMG-->SY89833LMG) - V2_14. FAN 전지 포마 추추: PJ3 - V2_15. 과과과 전지 IC 삭삭: U6 삭삭

# === Requirement === * PCB spec: FR-4, 6L, 1.6T, 360mm X 188.5mm * TOP/BOT impedance artwork (signle 50R / diff 100R)

* 2L and 5L are for GND.
* 3L and 4L are for GND / PWR.

# * BOARD edge clearance 2mm

* CGND on board egdes.

삭삭:
U133
U134

삭삭:
U111
L43
D16
C582
C583
R680
R674
C576
C592
R685
R686
R689
R692
C581
R683
C590
C595
R693
C599
R684
R690
C593

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
R698
R702
R706
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
FB149
FB150
ZD59
ZD60

삭삭:
U22
D3
L13
R82
C98
C114
C118
R102
C137
R129
R135
C157
C149
R103
C113
C131
TP43
R115
R123
C135

0
1 | 5 | 9 | 13
2 | 6 10 | 14
3 | 7 11 | 15
4 | 8 12 | 16
| | | 17

삭삭:
U3
FB13

[Molex]1719710006//50579406 --> [Molex]1719740006//50579406

mating part: [Molex]50579406

# ===BOM update (2021.05.24) === * TBD

Relay Path 활활활활,

# 저저 (2EA) 미미미

처처 (20121.4.5):
R943, R944

* 2021.5.13
임임 전전 커커커 파파 변변:

2EDGR-5.08-02P//2EDGK-5.08-02P --> 2EDGV-5.08-02P//2EDGK-5.08-02P

Guide Module
P1 for M3 bolt (PLATED)
P2/P3 for module guide pins (NON-PLATED)

삭삭:
LJ1
LJ2

# power net LAN_P3V3

삭삭:
TP
F5500용

DIAG_SIGNAL
DIAG_GUARD

DIAG_SIGNAL
DIAG_GUARD

DIAG_SIGNAL
DIAG_GUARD

M1_SPI_TX_CLK+
M1_SPI_TX_CLK-

M1_SPI_MOSI+
M1_SPI_MOSI-

M0_SPI_MOSI+ M0_SPI_MOSI-

M0_SPI_TX_CLK+ M0_SPI_TX_CLK- | M1_SPI_CS M0_SPI_CS

CAL_SPI_CS
CAL_SPI_CLK

CAL_SPI_MOSI
CAL_SPI_MISO

NC
BD_nRESET

NC
PRE_TRIG+
PRE_TRIG-

TRIG+ TRIG-

SOT+
SOT-

M1_SPI_RX_CLK+ M1_SPI_RX_CLK- M1_SPI_MISO+ M1_SPI_MISO-

M0_SPI_MISO+ M0_SPI_MISO-

M0_SPI_RX_CLK+ M0_SPI_RX_CLK-

DIAG_SIGNAL DIAG_GUARD

R1
R2---- R2 = R1 / ( Vo/0.798 -1 )

Vo = ( 1 + R1 / R2 ) * 0.798
( 1 + 40.2 / 7.68 ) * 0.798 = 4.97503125 V ( 1 + 40.2 / 6.8 ) * 0.798 = 5.51558823529 V ---- 40.2K/1608/0.1%_ERJ-PB3B4022V

7.68K/1608/0.1%_ERJ-PB3B7681V 6.8K/1608/0.1%_ERJ-PB3B6801V

R1
R2---- R2 = R1 / ( Vo/0.798 -1 )

Vo = ( 1 + R1 / R2 ) * 0.798
( 1 + 40.2 / 7.68 ) * 0.798 = 4.97503125 V ( 1 + 40.2 / 6.8 ) * 0.798 = 5.51558823529 V ---- 40.2K/1608/0.1%_ERJ-PB3B4022V

7.68K/1608/0.1%_ERJ-PB3B7681V 6.8K/1608/0.1%_ERJ-PB3B6801V

R1
R2---- R2 = R1 / ( Vo/0.798 -1 )

Vo = ( 1 + R1 / R2 ) * 0.798
( 1 + 40.2 / 7.68 ) * 0.798 = 4.97503125 V ( 1 + 40.2 / 6.8 ) * 0.798 = 5.51558823529 V ---- 40.2K/1608/0.1%_ERJ-PB3B4022V

7.68K/1608/0.1%_ERJ-PB3B7681V 6.8K/1608/0.1%_ERJ-PB3B6801V

R1
R2---- R2 = R1 / ( Vo/0.798 -1 )

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

7.68K/1608/0.1%_ERJ-PB3B7681V 6.8K/1608/0.1%_ERJ-PB3B6801V

R1
R2---- R2 = R1 / ( Vo/0.798 -1 )

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

7.68K/1608/0.1%_ERJ-PB3B7681V 6.8K/1608/0.1%_ERJ-PB3B6801V

for SY89832UMG/QFN-16

for SY89833LMG/QFN-16

for SY89832UMG/QFN-16

for SY89833LMG/QFN-16

삭삭:

U6
FB9

PN SWAP

PN SWAP

GND_FPGA

GND_FPGA

MC2_VCCO

GND_FPGA

GND_FPGA

GND_FPGA

MC1_VCCO

GND_FPGA

MC2_P3V3

MC1_P3V3

GND_FPGA

GND_FPGA

MC1_VDCIN_P5V

AGND

+15V_FPGA

GND_FPGA

AGND

+15V_ANAL

GND_ANAL

+15VAIN

AGND

-15VAIN

+15V_AMP

GND_AMP

-15V_AMP

+13.5V_AMP

-13.5V_AMP

+6V_ANAL

+5V_ANAL

+2.5V_ANAL

GND_ANAL

GND_ANAL

GND_ANAL

GND_ANAL

+6V_ANAL_DAMP

+6V_ANAL_DAMP | +2.5V_ANAL_AUX

CGND

CGND

DGND | CGND
AGND | CGND

GND_AMP

GND_AMP | GND_ANAL

GND_AMP

GND_AMP | GND_ANAL

+5V_ANAL

GND_ANAL

+6V_ANAL_DAMP | +3.3V_ANAL0

GND_ANAL

+2.5V_ANAL

+5V_ANAL

GND_ANAL

+3.3V_ANAL2 | GND_FPGA

GND_ANAL

+2.5V_ANAL_AUX

GND_ANAL

GND_FPGA
GND_ANAL

+3.3V_ANAL1

GND_FPGA
GND_ANAL

+3.3V_ANAL0

GND_AMP

-13.5V_ADC_BUF

+13.5V_ADC_BUF

GND_AMP

-13.5V_ADC_BUF

+13.5V_ADC_BUF

-13.5V_AMP

+13.5V_AMP

+13.5V_ADC_BUF

-13.5V_ADC_BUF

TEMP_P3V3

GND_AMP

GND_AMP

+2.5V_ANAL_AUX

GND_ANAL

GND_FPGA

GND_FPGA | GND_FPGA GND_FPGA

DISP_P3V3

GND_FPGA

GND_FPGA

TEMP_P3V3

GND_FPGA

MEM_P3V3

+15V_FPGA

GND_FPGA

+5V_FPGA_CORE

+5V_FPGA_IO

+3.3V_FPGA_IO

+3.3V_EXT

DGND

+15V_ANAL

GND_ANAL

+2.5V_ANAL_AUX

+5V_ANAL | +6V_ANAL

+2.5V_ANAL

+15VAIN

AGND

-15VAIN

+15V_AMP

-15V_AMP

+13.5V_AMP

GND_AMP

-13.5V_AMP

GND_FPGA

LED_P3V3

GND_FPGA

GND_FPGA

+3.3V_FPGA_IO

+5V_FPGA_IO

GND_FPGA

+3.3V_FPGA_IO

JTAG_PWR

GND_FPGA

+3.3V_EXT

+5V_FPGA_IO

GND_FPGA

+3.3V_EXT

GND_FPGA

SPO_P3V3

LED_P3V3

GND_FPGA

MC1_P1V0

MC1_P1V8

GND_FPGA

GND_FPGA

GND_ANAL

+3.3V_ANAL1

GND_ANAL

+3.3V_ANAL2

+3.3V_ANAL0 | +3.3V_ANAL1 | +3.3V_ANAL2

+15VAIN

+15VAIN

GND_ANAL GND_FPGA

MEM_P3V3

TEMP_P3V3

DISP_P3V3

SPO_P3V3

+5V_FPGA_SWR | +5V_FPGA_CORE

GND_FPGA

+5V_FPGA_CORE
MC1_VDCIN_P5V

CGND

GND_AMP

GND_AMP
GND_AMP | GND_AMP

GND_AMP

GND_AMP

GND_ANAL

GND_ANAL

GND_ANAL

+13.5V_AMP__DAC_BUF0

-13.5V_AMP__DAC_BUF0

GND_AMP

GND_AMP

+13.5V_AMP__DAC_BUF1

-13.5V_AMP__DAC_BUF1

+5V_AMP__DAC_BUF0_0

-5V_AMP__DAC_BUF0_0
-5V_AMP__DAC_BUF0_1

+5V_AMP__DAC_BUF0_1

GND_AMP | GND_ANAL

GND_ANAL

GND_ANAL

GND_ANAL

+1.8V_ANAL__DAC_DVDD_0

+3.3V_ANAL__DAC_AVDD_0 | +3.3V_ANAL__DAC_DVDD_0
+1.8V_ANAL__DAC_CVDD_0 | +1.8V_ANAL__DAC_DVDD_0

+3.3V_ANAL__DAC_LVDS_0

GND_ANAL

+3.3V_ANAL__DAC_LVDS_0

GND_ANAL

GND_ANAL

+3.3V_ANAL__DAC_LVDS_0

GND_ANAL

+3.3V_ANAL__DAC_LVDS_0

GND_ANAL

+3.3V_ANAL__CLK

GND_ANAL

+3.3V_ANAL__DAC_DVDD_1

+1.8V_ANAL__DAC_CVDD_1

GND_ANAL

+1.8V_ANAL__DAC_CVDD_1 | +1.8V_ANAL__DAC_DVDD_1

GND_ANAL

GND_ANAL

GND_ANAL

+3.3V_ANAL__DAC_LVDS_1

GND_ANAL

GND_ANAL

GND_ANAL

GND_ANAL

+3.3V_ANAL__DAC_LVDS_1

+3.3V_ANAL__DAC_LVDS_1

GND_ANAL

+1.8V_ANAL__DAC_DVDD_1

GND_AMP

GND_ANAL

+3.3V_ANAL__DAC_AVDD_1

GND_ANAL

GND_ANAL

+3.3V_ANAL__DAC_LVDS_1

GND_ANAL

+1.8V_ANAL__DAC_CVDD_0

GND_ANAL

GND_ANAL

+3.3V_ANAL__CLK

+3.3V_ANAL__BUF

GND_ANAL

+3.3V_ANAL__BUF

GND_ANAL

+3.3V_ANAL__BUF

GND_ANAL

GND_ANAL

+3.3V_ANAL__CLK

GND_ANAL

GND_ANAL

+3.3V_ANAL__CLK

GND_FPGA

SPO_P3V3

GND_FPGA

SPO_P3V3

SPO_P3V3

GND_FPGA

SPO_P3V3

GND_FPGA

GND_ANAL

GND_ANAL

TRIG_P3V3

GND_ANAL

GND_ANAL GND_FPGA

GND_ANAL

GND_ANAL

GND_ANAL

+6V_ANAL__DAC

+3.3V_ANAL__DAC_DVDD_0

+3.3V_ANAL__DAC_LVDS_0

+3.3V_ANAL__DAC_AVDD_0

GND_ANAL

GND_ANAL

+3.3V_ANAL__DAC_DVDD_1

+3.3V_ANAL__DAC_LVDS_1

+3.3V_ANAL__DAC_AVDD_1

GND_ANAL

GND_ANAL

GND_ANAL
GND_ANAL

+1.8V_ANAL__DAC_DVDD_0

+1.8V_ANAL__DAC_CVDD_0 GND_ANAL

GND_ANAL
GND_ANAL

+1.8V_ANAL__DAC_DVDD_1

+1.8V_ANAL__DAC_CVDD_1 GND_ANAL

GND_ANAL
GND_ANAL

+3.3V_ANAL__CLK

+3.3V_ANAL__BUF

GND_ANAL

+6V_ANAL__DAC

GND_ANAL

GND_ANAL

GND_ANAL

GND_ANAL

GND_ANAL

GND_ANAL

GND_ANAL

GND_ANAL

GND_ANAL

GND_ANAL

GND_ANAL

GND_ANAL

GND_ANAL

-13.5V_AMP__DAC

GND_AMP

+5V_AMP__DAC

-5V_AMP0__DAC

GND_AMP

GND_AMP

+13.5V_AMP__DAC

+13.5V_AMP | +13.5V_AMP__DAC

-13.5V_AMP__DAC

-13.5V_AMP

+13.5V_AMP__DAC

-13.5V_AMP__DAC

+13.5V_AMP__DAC_BUF0

+5V_AMP__DAC

-5V_AMP0__DAC

-13.5V_AMP__DAC_BUF1

GND_AMP

GND_AMP

+13.5V_AMP__DAC_BUF1

+5V_AMP__DAC_BUF0_0

-5V_AMP__DAC_BUF1_1

-13.5V_AMP__DAC_BUF0

+5V_AMP__DAC_BUF0_1

+5V_AMP__DAC_BUF1_0

+5V_AMP__DAC_BUF1_1

-5V_AMP__DAC_BUF0_0

-5V_AMP__DAC_BUF0_1

-5V_AMP__DAC_BUF1_0

+13.5V_AMP__DAC_BUF1

-13.5V_AMP__DAC_BUF1

GND_AMP

GND_AMP

GND_AMP

GND_AMP

GND_AMP
GND_AMP

-5V_AMP__DAC_BUF1_1

+5V_AMP__DAC_BUF1_1

-5V_AMP__DAC_BUF1_0

+5V_AMP__DAC_BUF1_0

+5V_AMP__DAC_BUF1_1

-5V_AMP__DAC_BUF1_1

GND_AMP

GND_AMP

+13.5V_AMP__DAC_BUF0

GND_AMP

-13.5V_AMP__DAC_BUF0 | -13.5V_AMP__DAC_BUF1

+13.5V_AMP__DAC_BUF1

+13.5V_AMP__DAC_BUF0

-13.5V_AMP__DAC_BUF0

+5V_AMP__DAC_BUF0_0

-5V_AMP__DAC_BUF0_0

GND_AMP

+5V_AMP__DAC_BUF0_1

-5V_AMP__DAC_BUF0_1

GND_AMP

+5V_AMP__DAC_BUF1_0

-5V_AMP__DAC_BUF1_0

GND_AMP

GND_AMP

GND_AMP

GND_AMP

GND_AMP

GND_AMP

GND_AMP

GND_ANAL

GND_ANAL

GND_AMP

+3.3V_ANAL__CLK

+6V_ANAL__DAC

GND_ANAL | GND_AMP

TEMP2_P3V3

TRIG_P3V3

GND_ANAL

+6V_ANAL__DAC

GND_ANAL

JTAG_PWR

GND_FPGA

-5V_AMP1__DAC

-5V_AMP1__DAC

GND_AMP | GND_AMP

GND_RL

PWR_RL1_5V

GND_RL

PWR_RL2_5V

+15V_AMP

-15V_AMP

GND_AMP

CGND

+15VDIN

+15VAIN

-15VAIN

DGND | DGND | DGND | DGND
| AGND | AGND

+3.3V_FPGA_IO

DGND | GND_FPGA

GND_FPGA

+5VD

DGND

+5VD

DGND | DGND

+3.3V_FPGA_IO

GND_FPGA

+5VD

+5VD

DGND

+3.3V_FPGA_IO

GND_FPGA

DGND

DGND | GND_FPGA

DGND
+5VD

+15VDIN

GND_AMP

+13.5V_AMP__DAC

PWR_RL_5V

PWR_RL2_5V

PWR_RL1_5V

GND_RL

+15V_FPGA

GND_FPGA+5V_FPGA_SWR

+5V_FPGA_IO

+15V_ANAL

+6V_ANAL__DAC

GND_ANAL

+6V_ANAL

GND_ANAL

+15V_ANAL

+3.3V_ANAL2

+2.5V_ANAL_AUX

+3.3V_ANAL2

+3.3V_EXT

Title:

Size | Document Number | Rev
Date: | Sheet | of

Designed Checked Approved

TEAM

- 1.0

PGU_CPU_S3100

Custom | S. JO | - | ____
Tuesday, May 25, 2021 | 1 | 2
| TBU

Title:

Size | Document Number | Rev
Date: | Sheet | of

Designed Checked Approved

TEAM

- 1.0

PGU_CPU_S3100

Custom | S. JO | - | ____
Tuesday, May 25, 2021 | 1 | 2
| TBU

Title:

Size | Document Number | Rev
Date: | Sheet | of

Designed Checked Approved

TEAM

- 1.0

PGU_CPU_S3100

Custom | S. JO | - | ____
Tuesday, May 25, 2021 | 1 | 2
| TBU

R639
0R/1608/1%

LCM14

EXC-24CH500U/1210/50R

1

2 | 3
| 4

C332
10nF/1005/10V

R874

2.4KR/1608/10ppm/0.05%/100mW_RG1608N-242-W-T1

TP162 | 1

FB135

BLM21PG600SN1D_60R/3A/25%/2012

TP138

TP_DIP_H0_5XC0_9

1

FB106

(OPEN)BLM18KG121TH1D_120R/3A/25%/30mR/1608

C618
1000pF/1608/50V/1%

C649
100nF/2012/16V/5%_VJ0805Y104JXJCW1BC
1 | TP251 | TP_DIP_H0_5XC0_9

C691
(OPEN)10pF/1608/50V/5%_C1608C0G100J50VB
J25 | JUMPER/2mm_pitch
1 | 2

R327

100R/0603/1%

TP256

TP_DIP_H0_5XC0_9

1

R724
51R/1608/50ppm/0.5%/100mW_RT0603DRE0751RL

R818
0R/1608/1%

R710
0R/1608/1%

C591
100nF/2012/16V/5%_VJ0805Y104JXJCW1BC
R995 | 6.8K/1608/0.1%_ERJ-PB3B6801V

R791
0R/1608/1%

ZD43

TV02W150B-G/SOD-123

R744
499R/1608/10ppm/0.05%/100mW_RG1608N-4990-W-T1

C716

100nF/1005/10V

TP12

TP_DIP_H0_5XC0_9 | 1

R212
0R/1608/1%

R910
(OPEN)0R/1608/1%

FB47

BLM21PG600SN1D_60R/3A/25%/2012

R784
0R/1608/1%

+CT10

22uF/CASED/35V/10%_T495D226K035ATE260

U120

FIN1101K8X/US8-8

4 | GND_1
3 | EN | OUT+ | 6
2 | GND | VCC | 7
1 | IN-
OUT- | 5 IN+ | 8

F4

MINIASMDC150F/16-2/4532

2 | 1

C534

13pF/2012/250V/1%_GCM21A5C2E130FX01D

FB87

BLM21PG600SN1D_60R/3A/25%/2012

FB122

BLM18KG121TH1D_120R/3A/25%/30mR/1608

LCM16

EXC-24CH500U/1210/50R

1

2 | 3
| 4

C68

22uF/2012/10V

ZD44

TV02W150B-G/SOD-123

R761
100R/0603/1%

R305
(OPEN)0R/1608/1%

R753
0R/1608/1%

R815
499R/1608/10ppm/0.05%/100mW_RG1608N-4990-W-T1

C36

100nF/1005/10V

J24 | JUMPER/2mm_pitch
1 | 2

C607
100nF/2012/16V/5%_VJ0805Y104JXJCW1BC

R632
U143 | 0R/1608/1%

XC6220B331MR-G/3.3V/1.2A/SOT-25-5

Vin 1
GND 2
Ven 3 | BYPASS | 4
| Vout | 5

FB134

BLM18KG121TH1D_120R/3A/25%/30mR/1608

R660
0R/1608/1%

R197
100R/0603/1%

R285
0R/1608/1%

LCM48

EXC-24CH500U/1210/50R

1

2 | 3
| 4

C337

10uF/3216/25V/10%

LED3

GREEN/2012

A C

LCM32

EXC-24CH500U/1210/50R

1

2 | 3
| 4

R825
100R/0603/1%

SJ8

414026-2

GRD1 3 | SIG | 1
GRD2 4

GRD0 2

GRD3 5

C307

1uF/2012/10V

R544
0R/2012/1%

R807
499R/1608/10ppm/0.05%/100mW_RG1608N-4990-W-T1

C324
0.1pF/1005/25V/0.05pF_GRM1555C1ER10WA01D
C628 | 47nF/1005/50V/5%_CC0402JRX7R9BB473

R762
51R/1608/50ppm/0.5%/100mW_RT0603DRE0751RL

C579
4.7uF/2012/50V/10%_CGA4J1X7R1H475K125AE

MH7
Mount_Hole

1

A

B

G1

G2

C657
10pF/1608/100V/20%_101X14N100MV4T

U116
AD9516-1BCPZ/LFCSP-64

VS 1
REFMON 2
LD 3
VCP 4
CP 5
STATUS 6
REF_SEL 7
SYNC 8

LF 9

BYPASS

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
SCLK

16

CS 17

NC2 18

NC3 19

NC4 20

# SDO 21

# SDIO 22

# RST 23

PD 24

# OUT4P 25

# OUT4N 26

# VS_LVPECL 27

# OUT5P 28

# OUT5N 29

VS 30

VS 31

VS 32

EPAD_GND

65

OUT3P

40

OUT3N

39

VS

38

GND

37

OUT9N

36

OUT9P

35

OUT8N

34

OUT8P

33

OUT6P

48

OUT6N

47

OUT7P

46

OUT7N

45

GND

44

OUT2P

43

OUT2N

42

VS_LVPECL

41

# OUT0P 56

# OUT0N 55

# VS_LVPECL 54

# OUT1P 53

# OUT1N 52

VS 51

VS 50

VS 49

# REFIN_P 64

# REFIN_N 63

# CPRSET 62

VS 61

VS 60

# GND 59

# RSET 58

VS 57

R981 | 6.8K/1608/0.1%_ERJ-PB3B6801V

C606
100nF/2012/16V/5%_VJ0805Y104JXJCW1BC

R800
0R/1608/1%

MH12
Mount_Hole

1

FB153

BLM21PG600SN1D_60R/3A/25%/2012

C553

1000pF/1608/50V/1%

R799
51R/1608/50ppm/0.5%/100mW_RT0603DRE0751RL

R893
0R/1608/1%

C309

100nF/2012/16V/5%_VJ0805Y104JXJCW1BC

T6

SRF2012A-121YA/120R/400mA/200mR/2012

1 | 2
4 | 3

C659
100nF/2012/16V/5%_VJ0805Y104JXJCW1BC

R664

1.2KR/1608/10ppm/0.05%/100mW_RG1608N-122-W-T1

C509

180pF/2012/50V/1%_CC0805FRNPO9BN181

LCM5

EXC-24CH500U/1210/50R

1

2 | 3
| 4

C648
100nF/2012/16V/5%_VJ0805Y104JXJCW1BC

C266
47nF/1005/50V/5%_CC0402JRX7R9BB473

R905
0R/1608/1%

C506
4.7uF/2012/50V/10%_CGA4J1X7R1H475K125AE

C636
100nF/2012/16V/5%_VJ0805Y104JXJCW1BC

R638
51R/1608/50ppm/0.5%/100mW_RT0603DRE0751RL

LCM19

EXC-24CH500U/1210/50R

1

2 | 3
| 4

U99
ADA4870ARRZ/PSOP-20
TFL | 2
SD | 3
ON | 4
NC1 | 5
INP | 6
INN | 7
OUTF | 8
NC2 | 9

VCC

18

OUT1

17

OUT2

16

OUT3

15

VEE

13

VEE

12

VCC

19 VCC

20

VCC 1

VEE

10
VEE
11 | EP 21

OUT4

14

C719

22uF/2012/10V

FB146
FBMH1608HM102-T_1KR/0.5A/25%/350mR/1608

C700

10uF/3216/25V/10%

C313
10nF/1005/10V
C702 | 10nF/1005/10V

C539

100nF/3216/50V/5%_CGA5L2C0G1H104J160AA

C290

10uF/3216/25V/10%

C521
4.7uF/2012/50V/10%_CGA4J1X7R1H475K125AE

R722
20K/1608/1%

FB159

(OPEN)BLM21PG600SN1D_60R/3A/25%/2012

FJ1A

5536507_3

A1 | 1
A2 | 2
A3 | 3
A4 | 4
A5 | 5
A6 | 6
A7 | 7
A8 | 8
A9 | 9
A10 | 10
A11 | 11
A12 | 12
A13 | 13
A14 | 14
A15 | 15
A16 | 16
A17 | 17
A18 | 18
A19 | 19
A20 | 20
A21 | 21
A22 | 22
A23 | 23
A24 | 24

R871
0R/1608/1%

C273
10nF/1005/10V

LCM45

EXC-24CH500U/1210/50R

1

2 | 3
| 4

C604

10uF/3216/25V/10%

C300
100nF/2012/16V/5%_VJ0805Y104JXJCW1BC

R792
0R/1608/1%

C369

1uF/2012/10V

C569

100nF/3216/50V/5%_CGA5L2C0G1H104J160AA

R875 | 1KR/0603/1%

R978
100R/0603/1%

F9

PFMF.020.2/400mA_TR/400mR/4532 1 | 2

C589
100nF/2012/16V/5%_VJ0805Y104JXJCW1BC

C516
100nF/2012/16V/5%_VJ0805Y104JXJCW1BC

TP124

TP_DIP_H0_5XC0_9

1

U19

XC6210B252MR-G/2.5V/0.7A/SOT-25-5

Vin 1
GND 2
Ven 3 | BYPASS | 4
| Vout | 5
R996 | 40.2K/1608/0.1%_ERJ-PB3B4022V

FB109

BLM21PG600SN1D_60R/3A/25%/2012

SJ7

414026-2

GRD1 3 | SIG | 1
GRD2 4

GRD0 2

GRD3 5

C701 | 10nF/1005/10V

U87
SN74LVC1G06DRLR/SOT-5X3-5
out 4

+ 5 - 3 in 2

MH10
Mount_Hole

1

R999
24.9R/0603/1%

C407

100nF/1005/10V

+
CT1

470uF/7343/10V/10%/200mR_TPSE477K010R0200

R816
499R/1608/10ppm/0.05%/100mW_RG1608N-4990-W-T1

R694

100R/3216/25ppm/0.1%/6W_PCAN1206E1000BST3

R716
100R/0603/1%

C268
10nF/1005/10V

R717
10KR/1608/10ppm/0.05%/100mW_RG1608N-103-W-T1

R974
0R/2012/1%

L41
220nH/2520/1%_LQW2UASR22F00L

R915
(OPEN)0R/1608/1%

D14

1N4448WX-TP/75V/500mA/SOD-323

A | K

C557
100nF/2012/16V/5%_VJ0805Y104JXJCW1BC

FB128
FBMH1608HM102-T_1KR/0.5A/25%/350mR/1608

R315
1K/1608/1%

TP125

TP_DIP_H0_5XC0_9

1

C224

100nF/3216/50V/5%_CGA5L2C0G1H104J160AA

R806
100R/0603/1%

C2

1uF/2012/10V

TP119

TP_DIP_H0_5XC0_9

1

ZD10

BZT52C6V8-7-F/SOD-123

A C

TP257

TP_DIP_H0_5XC0_9

1

R179

10K/1608/1%

FB133

BLM18KG121TH1D_120R/3A/25%/30mR/1608

R661
47R/1608/10ppm/0.5%/100mW_RG1608N-470-D-T5

ZD33

BZT52C3V6-7-F/SOD-123

A C

C404

100nF/1005/10V

TP211

TP_DIP_H0_5XC0_9 | 1

R918
30.1R/3216/25ppm/0.1%/2W_PCAN1206E30R1BST5

C326
47nF/1005/50V/5%_CC0402JRX7R9BB473

C723

100nF/1005/10V

U101

AD8009ARZ/SOIC-8

4

V- 6
OUT | 3 +IN | 2
-IN 7 | V+ | 1

NC1

5

NC3

8

NC2

D12

1N4448WX-TP/75V/500mA/SOD-323

A | K
1 | TP164 | TP_DIP_H0_5XC0_9

R810
499R/1608/10ppm/0.05%/100mW_RG1608N-4990-W-T1

C720

100nF/1005/10V

TP209

TP_DIP_H0_5XC0_9

1

LCM4

EXC-24CH500U/1210/50R

1

2 | 3
| 4

R760
0R/1608/1%

C654
100nF/2012/16V/5%_VJ0805Y104JXJCW1BC
R1009 | 7.68K/1608/0.1%_ERJ-PB3B7681V

R894
0R/1608/1%

U151

XC6210B182MR-G/1.8V/0.7A/SOT-25-5

Vin 1
GND 2
Ven 3 | BYPASS | 4
| Vout | 5

C497
470nF/1608/50V/10%
C660 | 100pF/1005/50V/5%_UMK105CH101JVHF

R662

200R/1608/25ppm/0.5%/62.5mW_RR0816P-201-D

R367
100R/0603/1%

R406

10K/1608/1%

FB143

FBMH1608HM102-T_1KR/0.5A/25%/350mR/1608

TP129

TP_DIP_H0_5XC0_9

1

C390

22uF/2012/10V

R542
0R/2012/1%

C537
4.7uF/2012/50V/10%_CGA4J1X7R1H475K125AE

R801
0R/1608/1%

FB155

BLM21PG600SN1D_60R/3A/25%/2012

TP117

TP_DIP_H0_5XC0_9

1

U48

LTC6655BHMS8-2.048/MSOP-8

SHDN 1

VIN 2

GND3 3

GND4 4 | GND5 | 5
| VOUT_S | 6
| VOUT_F | 7
| GND8 | 8

U1

XC6220B331MR-G/3.3V/1.2A/SOT-25-5

Vin 1
GND 2
Ven 3 | BYPASS | 4
| Vout | 5

C570
10uF/3216/25V/10%

C106

1uF/2012/10V

D17

FDLL4148/SOD

C

A

C498

100nF/1005/10V

R767
1.2KR/1608/10ppm/0.05%/100mW_RG1608N-122-W-T1 | 1 | TP165 | TP_DIP_H0_5XC0_9

R911
(OPEN)0R/1608/1%

LED7

GREEN/2012

A C

C319

100nF/2012/16V/5%_VJ0805Y104JXJCW1BC

C710
4.7uF/2012/50V/10%_CGA4J1X7R1H475K125AE

U103
LT3045EMSE-1/adj/0.5A/MSOP-12

1 IN 2 IN_

3 VIOC 4 EN/UV

5 PG 6 ILIM | PGFB | 7 SET | 8
| GND | | 9
OUTS | 10

OUT_ 11

OUT 12

# GND_EP 13

+

CT18
22uF/CASED/35V/10%_T495D226K035ATE260

R703
0R/1608/1%

R759
0R/1608/1%

R537
1K/1608/1%

C244
100nF/3216/50V/5%_CGA5L2C0G1H104J160AA

C330
47nF/1005/50V/5%_CC0402JRX7R9BB473

C8

100nF/1005/10V

R730
100R/0603/1%

U65

XC6220B331MR-G/3.3V/1.2A/SOT-25-5

Vin 1
GND 2
Ven 3 | BYPASS | 4
| Vout | 5

R790
0R/1608/1%

C550

1000pF/1608/50V/1%

R538
0R/2012/1%

TP116

TP_DIP_H0_5XC0_9

1

U154

SN74LVC1G126DBVR

OE 1

A 2

GND 3 | Y | 4
| VCC | 5

R1003
(OPEN)100R/1005/1%

L40

100nH/2520/1%_LQW2UASR10F00L

C247
10pF/1608/50V/0.5pF__CGA3E2C0G1H100D080AD

LCM43

EXC-24CH500U/1210/50R

1

2 | 3
| 4

FB56

BLM18KG121TH1D_120R/3A/25%/30mR/1608

R536
0R/2012/1%

SJ6

414026-2

GRD1 3 | SIG | 1
GRD2 4

GRD0 2

GRD3 5

R741
499R/1608/10ppm/0.05%/100mW_RG1608N-4990-W-T1

OSC1
XLL738400.000000X/0705/400MHz/3.3V
CLK+ | 4
VDD | 6

GND 3

NC 2

E/D 1

CLK- | 5
R982 | 40.2K/1608/0.1%_ERJ-PB3B4022V

U129
FIN1101K8X/US8-84

GND_1 6
OUT+ | 3 EN | 2
GND 7 | VCC | 1

IN-

5 | OUT-
8 | IN+

C584
1000pF/1608/50V/1%

R201
(OPEN)0R/1608/1%

TP221

TP_DIP_H0_5XC0_9 | 1

R971
0R/2012/1%

D16

FDLL4148/SOD

C

A

FB2

BLM21PG600SN1D_60R/3A/25%/2012

C322
100nF/1005/10V

C315

100nF/1005/10V

T9

SRF2012A-121YA/120R/400mA/200mR/2012

1 | 2
4 | 3

C705

22uF/2012/10V

C299
100nF/1005/10V

TP203 1

1 | TP245 | TP_DIP_H0_5XC0_9

TP121

TP_DIP_H0_5XC0_9

1
FB43

BLM21PG600SN1D_60R/3A/25%/2012

LCM27

EXC-24CH500U/1210/50R

1

2 | 3
| 4

R812
499R
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
