lastoyz/dsn_pgu_adda_s3100_git/dsn/2.dim/fpga_hs_top__rev_b0__top_view.png

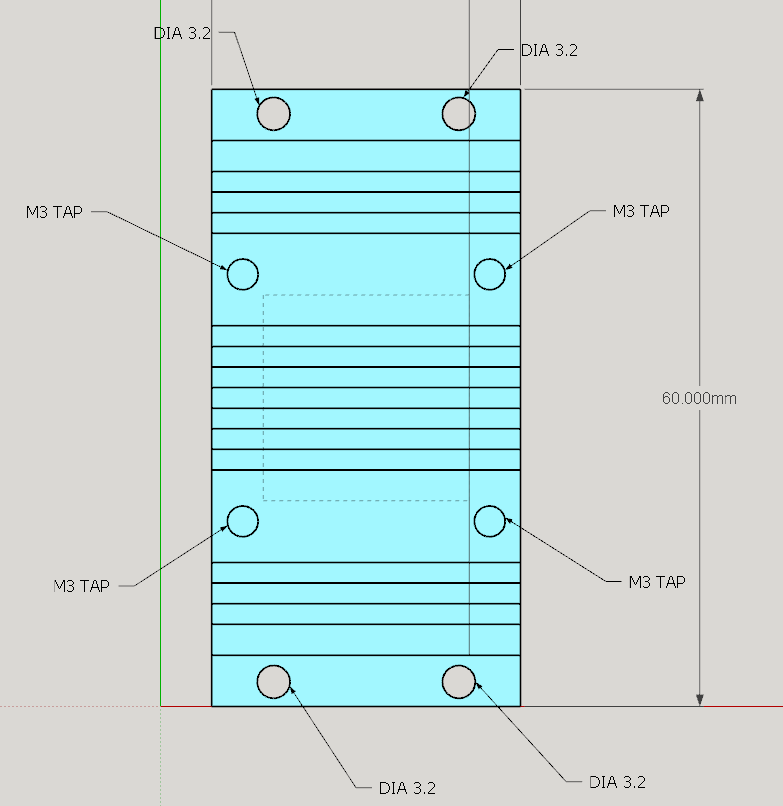
dsn/2.dim/fpga_hs_top__rev_b0__top_view.png
