lastoyz/dsn_pgu_adda_s3100_git/dsn/1.sch/_ref/CPU_CORE_CORTEX_M7_BOM_2021_1201.xlsx

CPU_CORE_CORTEX_M7_BD Revised: Wednesday, November 25, 2020 |  |  |  |  | 20211201 | R59 장착
01. COVER Revision: 1.0
TM1
Seol YK
JOH JH
Bill Of Materials November 25,2020 15:57:18
Item | Quantity | Reference | Part | pcb footprint
______________________________________________
1 | 1 | +5VD | +5VD | TP_DIP_H1_0XC1_5
2 | 1 | +5VD_IN | +5VD_IN | TP_DIP_H1_0XC1_5
3 | 1 | +3.3VD | +3.3VD | TP_DIP_H1_0XC1_5
4 | 1 | +3.3VD_IN | +3.3VD_IN | TP_DIP_H1_0XC1_5
5 | 1 | CC1 | 220UF_10V_7343(D)_TANTAL | TANTALD_7343 | 미입고
6 | 1 | C1 | 10UF_6.3V_1608 | C1608L
7 | 6 | C2,C55,C56,C59,C60,C61 | 100NF_50V_1608 | C1608L
8 | 2 | C3,C4 | 2.2UF_10V_1608 | C1608L
9 | 5 | C5,C16,C34,C44,C48 | 4.7UF_10V_1608 | C1608L
10 | 39 | C6,C7,C8,C9,C10,C11,C12,C13,C14,C15,C17,C18,C19,C20,C21,C22,C23,C24,C25,C26,C30,C31,C32,C33,C35,C36,C37,C38,C39,C40,C41,C42,C43,C49,C50,C51,C52,C53,C54 | 100NF_16V_1005 | C1005L
11 | 2 | C27,C28 | 22PF_50V_1608 | C1608L
12 | 1 | C29 | 1UF_16V_1608 | C1608L
13 | 3 | C57,C62,C63 | 100NF_50V_1005 | C1005L
14 | 2 | C58,C68 | 22UF_10V_2012 | C2012L
15 | 1 | C64 | 1UF_35V_1005 | C1005L | 25V
16 | 1 | C65 | 47UF_10V_2012 | C2012L | 6.3V
17 | 1 | C66 | 3.3NF_50V_1608_GRM1885C1H332JA01D | c1608l
18 | 1 | C67 | 10UF_50V_3216 | C3216L
19 | 1 | FMC_CLK | FMC_CLK | TP_DIP_H1_0XC1_5
20 | 1 | FMC_NCE | FMC_NCE | TP_DIP_H1_0XC1_5
21 | 1 | FMC_NE1 | FMC_NE1 | TP_DIP_H1_0XC1_5
22 | 1 | FMC_NE2 | FMC_NE2 | TP_DIP_H1_0XC1_5
23 | 1 | FMC_NE3 | FMC_NE3 | TP_DIP_H1_0XC1_5
24 | 1 | FMC_NE4 | FMC_NE4 | TP_DIP_H1_0XC1_5
25 | 1 | FMC_NOE | FMC_NOE | TP_DIP_H1_0XC1_5
26 | 1 | FMC_NWE | FMC_NWE | TP_DIP_H1_0XC1_5
27 | 1 | F1 | MINISMDC260F/4532 | MINISMDC4532
28 | 1 | HB1 | HOLE2_7XPAD5_0 | MTG2_7x5_0
29 | 1 | JP1 | 70553-0001(MOLEX)/DNP | DIP2N-SDA-70553-0001 | 1개 입고
30 | 1 | JP2 | PIN_HEADER 1x2 (2.54mm)/DNP | HEADER2N_P2_54
31 | 1 | J1 | BHRA-01-20P | HEADER_10X2_2_54_BOX_ANGLE
32 | 2 | J2,J3 | QTE-060-01-L-D-A | QTE-060-01-L-D-A
33 | 1 | J6 | AW0500_03 | DIP-AW0500-03 | 미입고
34 | 1 | J7 | LA0640_03 | DIP-LA0640-03
35 | 1 | J9 | LA0640_04 | DIP-LA0640-04
36 | 2 | LED1,LED6 | LED_YELLOW_SMD1608 | LED1608-AC
37 | 5 | LED2,LED3,LED4,LED5,LED8 | LED_GREEN_SMD1608 | LED1608-AC
38 | 1 | LED7 | LED_RED_SMD1608 | LED1608-AC
39 | 1 | PSW1 | PTS645SK50JSMTR92 LFS | TACT4_SW_YST1105S | 미입고
40 | 1 | QSPI_BK1_IO0 | QSPI_BK1_IO0 | TP_DIP_H1_0XC1_5
41 | 1 | QSPI_BK1_IO1 | QSPI_BK1_IO1 | TP_DIP_H1_0XC1_5
42 | 1 | QSPI_BK1_IO2 | QSPI_BK1_IO2 | TP_DIP_H1_0XC1_5
43 | 1 | QSPI_BK1_IO3 | QSPI_BK1_IO3 | TP_DIP_H1_0XC1_5
44 | 1 | QSPI_BK1_NCS | QSPI_BK1_NCS | TP_DIP_H1_0XC1_5
45 | 1 | QSPI_CLK | QSPI_CLK | TP_DIP_H1_0XC1_5
46 | 1 | RN1 | 0_J_RP164P | ARC3216W-1-8 | 미입고 | 3216 RN 0 옴
47 | 1 | RN2 | 0_J_RP164P/DNP | ARC3216W-1-8
48 | 9 | R1,R2,R3,R4,R5,R9,R27,R37,R38 | 10K_F_1608 | R1608L
49 | 11 | R6,R14,R15,R16,R17,R18,R28,R29,R69,R70,R77 | 10K_F_1005 | R1005L
50 | 1 | R7 | 49.9K_F_1608 | R1608L
51 | 2 | R8,R10 | 0_F_1608/DNP | R1608L
52 | 31 | R11,R12,R13,R25,R26,R33,R34,R35,R40,R41,R42,R43,R50,R56,R57,R58,R59,R60,R62,R66,R67,R68,R71,R73,R74,R75,R76,R79,R80,R85,R86 | 0_F_1005 | R1005L | R59 추가
53 | 1 | R30 | 1M_F_1005 | R1005L
54 | 2 | R31,R32 | 4.7K_F_1608 | R1608L
55 | 1 | R44 | 100K_D_1608/25PPM | R1608L
56 | 1 | R45 | 320K_D_1608/25PPM | R1608L
57 | 1 | R46 | 2K_F_1608 | R1608L
58 | 2 | R47,R48 | 2K_F_1005 | R1005L
59 | 5 | R49,R51,R52,R53,R92 | 1.3K_F_1608 | R1608L
60 | 9 | R61,R63,R64,R65,R72,R87,R89,R90,R91 | 0_F_1005/DNP | R1005L | R59 제거
61 | 1 | R78 | 100_F_1608 | R1608L
62 | 1 | SPI_#1_MISO | SPI_#1_MISO | TP_DIP_H1_0XC1_5
63 | 1 | SPI_#1_MOSI | SPI_#1_MOSI | TP_DIP_H1_0XC1_5
64 | 1 | SPI_#1_SCLK | SPI_#1_SCLK | TP_DIP_H1_0XC1_5
65 | 1 | SPI_#1_nCS | SPI_#1_nCS | TP_DIP_H1_0XC1_5
66 | 1 | SPI_#2_MISO | SPI_#2_MISO | TP_DIP_H1_0XC1_5
67 | 1 | SPI_#2_MOSI | SPI_#2_MOSI | TP_DIP_H1_0XC1_5
68 | 1 | SPI_#2_SCLK | SPI_#2_SCLK | TP_DIP_H1_0XC1_5
69 | 1 | SPI_#2_nCS | SPI_#2_nCS | TP_DIP_H1_0XC1_5
70 | 1 | SW_nRESET_OUT | SW_nRESET_OUT | TP_DIP_H1_0XC1_5
71 | 1 | SW1 | KSD-02S | SW-KSD-02S
72 | 1 | TIM#1_CH1 | TIM#1_CH1 | TP_DIP_H1_0XC1_5
73 | 1 | TIM#2_CH4 | TIM#2_CH4 | TP_DIP_H1_0XC1_5
74 | 1 | U1 | STM32F767NI | STM32F769XX
75 | 1 | U2 | TPS3808G33DBVR | TPS3808
76 | 2 | U3,U6 | IS42S16320F-7BLI | IS42_45R16320F
77 | 1 | U4 | 24LC16B | 24LC16B
78 | 1 | U5 | MT29F1G08ABAEAWP:E | TSSOP48_P0_5_W20
79 | 1 | U7 | SP3232ECN-L | NSOIC16_P1_27_W6_0
80 | 1 | U8 | TPS82130SILR/USiP-8 | USIL8N-P0_65-W2_9X3_1-TM1_1X1_9
81 | 1 | X1 | ECS-250-18-36B-CKY-TR(25MHz) | CRYSTAL_SX22
82 | 1 | ZD1 | BZT52C5V6_13_F/SOD-123 | SOD123-AC
83 | 1 | ZD2 | BZT52C3V6_7_F/SOD-123 | SOD123-AC
