lastoyz/dsn_pgu_adda_s3100_git/dsn/1.sch/_ref/S3100_CPU_BASE_VER1.0_SCH_210818_BOM_OPMODE 수정.xlsx

[S3100] CPU_BASE Revised: Wednesday, April 28, 2021
01. Cover Revision: 1.0 |  |  |  |  | 20210818 | W5300 OPMODE 수정 | R143, R145, R147 DNP 처리 | 설영기
TM1
Seol YK
Seol YK
Cho JH
Bill Of Materials April 28,2021 10:46:38
Item | Quantity | Reference | Part | 비고
______________________________________________
1 | 6 | BC1,BC2,BC5,BC6,BC10,BC11 | 22UF_16V_2012_MLCC
2 | 104 | BC3,BC4,BC7,BC8,BC9,BC16,BC18,BC19,BC20,BC21,BC22,BC23,BC24,BC25,BC26,BC27,BC28,BC29,BC30,BC31,BC32,BC33,BC34,BC35,BC36,BC37,BC38,BC39,BC40,BC42,BC43,BC44,BC45,BC46,BC47,BC48,BC49,BC50,BC51,BC52,BC53,BC54,BC55,BC56,BC57,BC58,BC59,BC60,BC61,BC62,BC63,BC64,BC65,BC66,BC67,BC68,BC69,BC70,BC71,BC72,BC73,BC74,BC75,BC76,BC77,BC78,BC79,BC80,BC81,BC82,BC83,BC84,BC85,BC86,BC87,BC88,BC89,BC90,BC91,BC92,BC93,BC94,BC95,BC96,BC97,BC98,BC99,BC100,BC101,BC102,BC103,BC104,BC105,BC106,BC107,BC108,BC109,BC110,BC111,BC112,BC113,BC114,BC115,BC116 | 100NF_50V_1608_MLCC
3 | 3 | C6,C8,BC12 | 22UF_6.3V_2012_MLCC
4 | 6 | BC13,BC14,BC15,C99,C100,C102 | 10UF_10V_2012_MLCC
5 | 2 | C10,BC17 | 47UF_6.3V_3216_MLCC
6 | 1 | BC41 | 390PF_50V_2012_MLCC
7 | 3 | CT1,CT2,CT3 | 47UF_25V_7343_TANTAL
8 | 1 | CX1 | 1000PF/2KV_세라믹
9 | 2 | CX2,CX3 | 1000PF/2KV_세라믹/DNP
10 | 1 | C1 | 470NF_50V_1608_MLCC
11 | 3 | C2,C3,C12 | 4.7UF_25V_3216_MLCC
12 | 1 | C4 | 680PF_50V_1608_MLCC
13 | 1 | C5 | 47UF_25V_3225_MLCC
14 | 1 | C7 | 15NF_50V_1608_MLCC
15 | 1 | C9 | 15PF_50V_1608_MLCC
16 | 1 | C11 | 22UF_16V_3216_MLCC
17 | 57 | C13,C16,C17,C18,C19,C20,C21,C22,C23,C24,C25,C26,C29,C30,C31,C32,C33,C34,C35,C36,C37,C38,C39,C40,C45,C46,C47,C48,C49,C50,C51,C52,C53,C54,C55,C56,C57,C66,C70,C71,C72,C73,C74,C75,C77,C78,C79,C80,C81,C82,C84,C85,C86,C88,C89,C90,C91 | 100NF_10V_0603_MLCC
18 | 1 | C14 | 1NF_10V_0603_MLCC
19 | 1 | C15 | 100PF_10V_0603_MLCC
20 | 8 | C27,C28,C41,C42,C58,C59,C93,C95 | 4.7UF_10V_1005_MLCC
21 | 2 | C43,C62 | 22UF_10V_2012_MLCC
22 | 2 | C44,C63 | 1UF_35V_1005_MLCC
23 | 2 | C60,C61 | 10NF_6.3V_0603_MLCC
24 | 8 | C64,C67,C68,C69,C76,C83,C87,C96 | 100NF_50V_1005_MLCC
25 | 1 | C65 | 470NF_6.3V_0603_MLCC
26 | 2 | C92,C94 | 22UF_6.3V_1608_MLCC
27 | 2 | C97,C98 | 18PF_50V_1608_MLCC
28 | 1 | C101 | 3.3UF_25V_2012_MLCC
29 | 2 | C103,C104 | 100PF_50V_1608_MLCC
30 | 4 | C105,C106,C107,C108 | 100NF_50V_2012_MLCC
31 | 7 | C109,C110,C111,C112,C113,C114,C115 | 1NF_50V_1608_MLCC
32 | 1 | DCDC1 | PQP3-D12-S12-M
33 | 1 | D1 | MBRA340T3G
34 | 1 | D2 | 1SS181
35 | 10 | FBX1,FBX2,FBX3,FB4,FBX5,FB5,FBX6,FB6,FBX7,FBX8 | HH_1M3216_601JT
36 | 3 | FBX4,FB7,FB8 | HH_1M3216_601JT/DNP
37 | 3 | FB1,FB2,FB3 | HH-1M1608-221JT
38 | 1 | F_TP1 | F_TP0
39 | 1 | F_TP2 | F_TP1
40 | 1 | F_TP3 | F_TP2
41 | 1 | F_TP4 | F_TP3
42 | 1 | F_TP5 | F_TP4
43 | 1 | F_TP6 | F_TP5
44 | 1 | F_TP7 | F_TP6
45 | 1 | F_TP8 | F_TP7
46 | 2 | F1,F4 | MINISMDC260F/16-2/HD2.6A/4532
47 | 1 | F2 | MINISMDC260F/16-2/HD2.6A/4532/DNP
48 | 1 | F3 | MINISMDC260F/13.2-2/HD2.6A/4532
49 | 7 | HB1,HB2,HB3,HB4,HB5,HB6,HB7 | D3.3P6.0
50 | 1 | HCORE1 | D2.7P5.0
51 | 2 | HGH1,HGH2 | D3.2P6.0
52 | 3 | HP1,HP2,HP3 | D2.8P4.0
53 | 1 | JC1 | RB1_125BAG1A
54 | 1 | JC2 | DS903M09_AN_PCB
55 | 1 | JEXT1 | N10214-5212PC_3M_MDR
56 | 1 | JIG1 | S3100_CPU_BASE_BOTTOM_PLATE | 지그 사급
57 | 1 | JIG2 | S3100_CPU_BASE_COVER | 지그 사급
58 | 7 | JIG3,JIG4,JIG5,JIG6,JIG7,JIG8,JIG9 | S3100_CPU_BASE_PCB_SUPPORT_11MM | 지그 사급
59 | 1 | JIG10 | S3100_CPU_BASE_FRONT_COVER | 지그 사급
60 | 1 | JK1 | 55917_1410/DNP
61 | 2 | JL1,JL2 | HIF3H_6SA_2.54DSA
62 | 1 | JP1 | 5536507_3
63 | 2 | JS1,JS2 | QSE_060_01_L_D_A
64 | 1 | J1 | LW0640_02
65 | 1 | J2 | 87831-1420
66 | 1 | J3 | ZST_117_03_G_D_740
67 | 1 | J4 | PIN HEADER 1X2 (2.54)/DNP
68 | 1 | J5 | HIF3FC_10PA_2.54DSA/DNP
69 | 1 | J6 | 5536507_2
70 | 2 | J7,J9 | CONSMA002-L-G
71 | 1 | J8 | LW0640_06
72 | 6 | K1,K2,K3,K4,K5,K6 | S1A050000 | 사급
73 | 13 | LED1,LD1,LED2,LD2,LED3,LD3,LED4,LD4,LD5,LED6,LD6,LD7,LD8 | LED_GREEN_SMD1608
74 | 1 | LED5 | LED_RED_SMD1608
75 | 1 | LED7 | LED_YELLOW_SMD1608
76 | 1 | LED8 | 3MM/DIP/GREEN
77 | 2 | LED9,LED10 | 3MM/DIP/YELLOW
78 | 2 | L1,L2 | IHLP2525BDER4R7M01_4.7UH
79 | 1 | L3 | RLS-686-R
80 | 2 | RN1,RN2 | 100_J_RP164P
81 | 3 | RN3,RN4,RN5 | 10K_J_RP164P
82 | 10 | RX1,RX2,RX3,RX4,RX5,RX6,RX7,RX8,RX9,R89 | 0_F_1005/DNP
83 | 11 | R1,R132,R188,R199,R200,R203,R204,R207,R208,R453,R458 | 0_F_1608/DNP
84 | 29 | R2,R3,R4,R5,R6,R7,R8,R27,R78,R127,R129,R130,R131,R133,R134,R146,R148,R149,R225,R230,R238,R242,R246,R254,R255,R262,R270,R271,R459 | 10K_F_1608
85 | 1 | R9 | 15K_F_1608
86 | 2 | R10,R25 | 4.7K_F_1608
87 | 1 | R11 | 1.6K_F_1608
88 | 76 | R12,R20,R26,R30,R31,R32,R33,R36,R37,R38,R39,R40,R41,R42,R43,R44,R45,R46,R47,R48,R49,R51,R61,R63,R64,R66,R68,R69,R122,R123,R125,R126,R150,R151,R152,R154,R177,R178,R181,R182,R186,R187,R189,R190,R191,R192,R193,R194,R195,R196,R209,R210,R211,R212,R213,R214,R215,R216,R217,R218,R219,R220,R221,R222,R223,R229,R232,R237,R239,R245,R249,R253,R256,R261,R264,R269 | 1K_F_1608
89 | 1 | R13 | 536K_F_1608
90 | 1 | R14 | 63.4K_F_1608
91 | 2 | R15,R24 | 100K_F_1608
92 | 3 | R16,R17,R23 | 160K_F_1608
93 | 2 | R18,R19 | 51K_F_1608
94 | 1 | R21 | 300K_F_1608
95 | 1 | R22 | 200K_F_1608
96 | 33 | R28,R29,R34,R35,R183,R184,R185,R197,R198,R201,R202,R205,R206,R226,R228,R233,R236,R241,R244,R250,R252,R258,R260,R267,R268,R449,R450,R451,R452,R454,R455,R456,R457 | 0_F_1608
96-1 | 3 | R143,R145,R147 | 0_F_1608/DNP |  | W5300 OPMODE 수정
97 | 8 | R50,R52,R53,R54,R56,R57,R58,R60 | 2K_F_1005
98 | 8 | R55,R92,R93,R102,R109,R111,R113,R116 | 1K_F_1005
99 | 1 | R59 | 100_J_0603
100 | 3 | R62,R65,R67 | 1K_F_1608/DNP
101 | 14 | R70,R71,R72,R73,R74,R75,R76,R77,R90,R91,R94,R96,R98,R100 | 0_F_1005
102 | 3 | R79,R80,R107 | 330_F_1005
103 | 1 | R81 | 2K_F_1608
104 | 3 | R95,R99,R101 | 10K_F_1005
105 | 1 | R97 | 10K_F_1005/DNP
106 | 4 | R103,R105,R106,R108 | 4.7K_F_1005
107 | 1 | R104 | 2.4K_F_1005
108 | 4 | R110,R112,R114,R115 | 1K_F_1005/DNP
109 | 2 | R117,R120 | 51_F_1608
110 | 3 | R118,R119,R121 | 51_F_1005
111 | 11 | R124,R128,R224,R234,R240,R247,R259,R265,R272,R273,R276 | 100_F_1005/DNP
112 | 4 | R135,R136,R141,R142 | 49.9_F_2012
113 | 2 | R137,R140 | 200_F_2012
114 | 1 | R138 | 12K_F_2012
115 | 1 | R139 | 300_F_2012
116 | 2 | R144,R277 | 4.7K_F_2012
117 | 1 | R153 | 1M_F_2012
118 | 4 | R155,R156,R158,R159 | 3.3K_F_2012
119 | 15 | R157,R160,R460,R461,R462,R463,R464,R465,R466,R467,R468,R469,R470,R471,R472 | 22_F_1608
120 | 4 | R161,R162,R166,R167 | 1.2K_F_2012
121 | 7 | R163,R164,R165,R169,R173,R174,R175 | 330_F_2012
122 | 4 | R168,R170,R171,R172 | 2.4K_F_2012/DNP
123 | 3 | R176,R179,R180 | 50_F_1608
124 | 6 | R227,R235,R243,R251,R257,R266 | 100_F_1005
125 | 1 | R278 | 330_F_3216
126 | 5 | R279,R280,R281,R282,R283 | 0_F_2012
127 | 1 | SW1 | KSP_04H
128 | 1 | SW2 | KHS22
129 | 1 | TP1 | nNE1
130 | 1 | TP2 | nNE2
131 | 1 | TP3 | nNE3
132 | 1 | TP4 | nNE4
133 | 1 | TP5 | RDY
134 | 1 | TP6 | nOE
135 | 1 | TP7 | nWE
136 | 1 | TP8 | FMC_CLK
137 | 1 | TP9 | +15VD
138 | 1 | TP10 | +5VD
139 | 1 | TP11 | +3.3VD
140 | 1 | TP12 | +3.3VF
141 | 1 | TP13 | +1.8VF
142 | 1 | TP14 | +1.0VF
143 | 1 | TP15 | +12VS
144 | 4 | TP16,TP17,TP18,TP19 | DGND
145 | 1 | TP20 | CASE_GND
146 | 1 | TP21 | HIF_GND
147 | 1 | TP22 | CW_GND
148 | 1 | TP23 | +0.275V
149 | 1 | TP24 | +0.55V
150 | 1 | TP25 | GPIB_nCS
151 | 1 | TP26 | GPIB_IRQ
152 | 1 | TP27 | GPIB_DATA_nOE
153 | 1 | TP28 | GPIB_SW_nOE
154 | 1 | TP29 | M0_SPI_RX_CLK
155 | 1 | TP30 | M0_SPI_TX_CLK
156 | 1 | TP31 | M0_SPI_MISO
157 | 1 | TP32 | M0_SPI_MOSI
158 | 1 | TP33 | M1_SPI_RX_CLK
159 | 1 | TP34 | M1_SPI_TX_CLK
160 | 1 | TP35 | M1_SPI_MISO
161 | 1 | TP36 | M1_SPI_MOSI
162 | 1 | TP37 | M2_SPI_RX_CLK
163 | 1 | TP38 | M2_SPI_TX_CLK
164 | 1 | TP39 | M2_SPI_MISO
165 | 1 | TP40 | M2_SPI_MOSI
166 | 1 | TP41 | TRIG
167 | 1 | TP42 | SOT
168 | 1 | TP43 | PRE_TRIG
169 | 2 | T1,T2 | TTWB2040LB
170 | 1 | U1 | LT3680IDD_DFN10
171 | 3 | U2,U3,U4 | TPS82084SIL
172 | 1 | U5 | EN5337QI
173 | 1 | U6 | RH-153.3D/H6
174 | 11 | U7,U8,U9,U10,U11,U23,U38,U39,U40,U42,U43 | SN74ALVC164245DGGR
175 | 6 | U12,U14,U15,U17,U18,U19 | SN74LVC8T245PW
176 | 1 | U13 | XC7A200T-1FBG484
177 | 1 | U16 | DSC1103CI2_200MHz
178 | 1 | U20 | REF3012AIDBZR
179 | 1 | U21 | MT25QU128ABA1EW9_0SIT
180 | 1 | U22 | TNT4882_BQ
181 | 1 | U24 | W5300
182 | 1 | U25 | RCLAMP0524P
183 | 1 | U26 | H_311C
184 | 2 | U27,U29 | PS2801-4/SSOP
185 | 1 | U28 | MAX3232CSE
186 | 2 | U30,U65 | MC1413D
187 | 2 | U31,U34 | LT1016IS8
188 | 2 | U32,U37 | NC7SZ08M5X
189 | 1 | U33 | LRPS-2-1J
190 | 3 | U35,U36,U41 | SN74LVC4245APW
191 | 15 | U44,U46,U47,U48,U50,U51,U53,U54,U56,U58,U59,U61,U62,U63,U64 | ST485ABDR
192 | 6 | U45,U49,U52,U55,U57,U60 | SN74LVC1G126DBVR
193 | 1 | U66 | 11AA160T-I/TT
194 | 1 | X1 | 40MHZ_3.3V_SMD5032_OSC
195 | 1 | X2 | 25MHZ_HALF_TYPE_XTAL
196 | 1 | Y1 | 10MHZ_3.3V_SMD5032_OSC
197 | 1 | ZD1 | ATV02W150B-HF/SOD-123
198 | 1 | ZD2 | BZT52C5V6_7_F(SOD123)
199 | 3 | ZD3,ZD4,ZD7 | BZT52C3V6_7_F/SOD-123
200 | 2 | ZD5,ZD6 | BZT52C2V0_7_F/SOD-123
201 | 4 | ZD8,ZD9,ZD10,ZD11 | BZT52C13T-7
