lastoyz/dsn_pgu_adda_s3100_git/dsn/2.dim/fpga_hs_top__rev_b1.stp

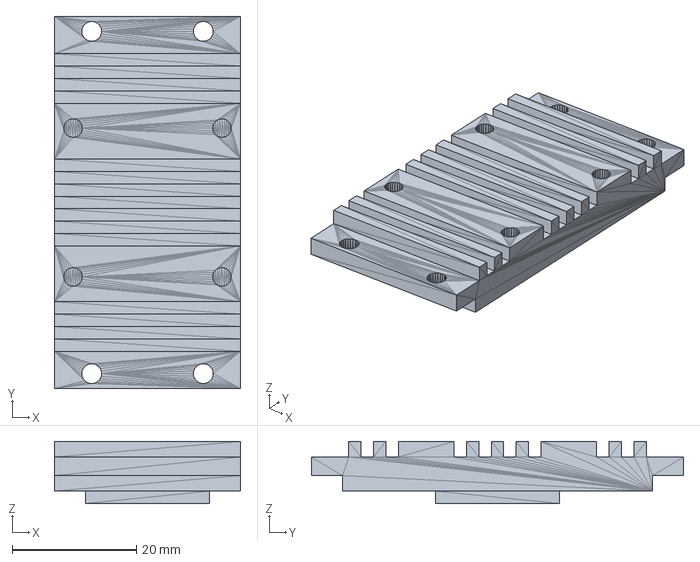
[picture p3: CAD file, 2021-12-30]
dsn/2.dim/fpga_hs_top__rev_b1.stp
30.0 x 60.0 x 10.0 mm
