lastoyz/dsn_pgu_adda_s3100_git/(list of files, cad)

Other CAD files:
dsn/2.dim/fpga_hs_top__rev_b0.stp
dsn/2.dim/fpga_hs_top__rev_b.skp
dsn/2.dim/fpga_hs_top__rev_b0.obj
dsn/2.dim/fpga_hs_top__rev_b0.skp
dsn/2.dim/fpga_hs_top__rev_b1.skp
