lastoyz/dsn_pgu_adda_s3100_git/dsn/2.dim/S3100-CMU-ADDA__r20210824__pcb_guide.png

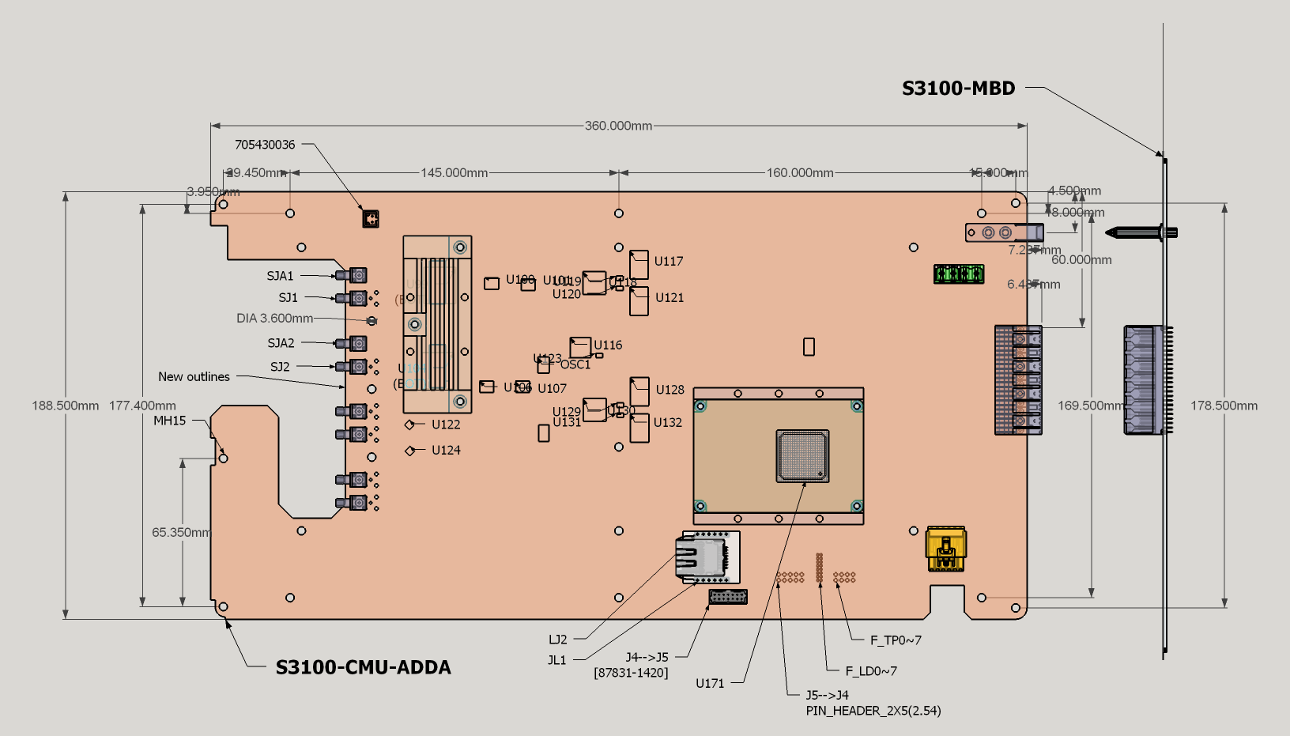
dsn/2.dim/S3100-CMU-ADDA__r20210824__pcb_guide.png
