lastoyz/dsn_pgu_adda_s3100_git/txem7310_pll/txem7310_pll.srcs/_test/cpp__TSPACE_/T-SPACE/Workspace/Test/IV_Sweep_NMOS_Id-Vg.xlsx

Sheet: Settings
=====================
Append 2
=====================
Test Name | IV_Sweep_NMOS_Id-Vg
Test Date | 2021-04-19 19:43:04
Test Time | 5.035s
Mode | Sweep Measure
Speed | Medium
Hold Time | 0.1s
Delay Time | 0.01s
Instrument Channel | SMU1 | SMU2 | SMU3 | SMU4
Force Channel Name | Vgate | Vdrain | Vsource | Vbody
Force Mode | Voltage Sweep | Voltage Bias | Voltage Bias | Voltage Bias
Sweep Mode | VAR1 | Constant | Constant | Constant
Sweep Direction | Single | N/A | N/A | N/A
Start/Level | 0 | 10 | 0 | 0
Stop/Offset | 10 | N/A | N/A | N/A
Step/Ratio | 0.2 | N/A | N/A | N/A
Number of Points | 51 | N/A | N/A | N/A
Compliance | 0.1 | 0.1 | 0.1 | 0.1
Measure Channel Name | IGate | Idrain | Isource | N/A
Measure Mode | Voltage Measured | Current Measured | Current Measured | N/A
Measure Range | Limited Auto=2V | Limited Auto=1nA | Limited Auto=1nA | N/A
Frequency | N/A | N/A | N/A | N/A
AC Level | N/A | N/A | N/A | N/A
=====================
Append 1
=====================
Test Name | IV_Sweep_NMOS_Id-Vg
Test Date | 2021-04-19 19:42:57
Test Time | 4.915s
Mode | Sweep Measure
Speed | Medium
Hold Time | 0.1s
Delay Time | 0.01s
Instrument Channel | SMU1 | SMU2 | SMU3 | SMU4
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
