lastoyz/dsn_pgu_adda_s3100_git/txem7310_pll/txem7310_pll.srcs/_test/cpp__TSPACE_/T-SPACE/Workspace/Test/Gm_test.xlsx

Sheet: Settings
=====================
Run
=====================
Test Name | NMOS_Id-Vg
Test Date | 2021-05-21 10:24:57
Test Time | 5.583s
Mode | Sweep Measure
Speed | Medium
Hold Time | 0.01s
Delay Time | 0.01s
Instrument Channel | SMU1 | SMU2 | SMU3
Force Channel Name | Vgate | Vdrain | Vsource
Force Mode | Voltage Sweep | Voltage Sweep | Voltage Bias
Sweep Mode | VAR1 | VAR2 | Constant
Sweep Direction | N/A | N/A | N/A
Start/Level | 0 | 0.05 | 0
Stop/Offset | 5 | 0.05 | N/A
Step/Ratio | 0.1 | 0 | N/A
Number of Points | 51 | 1 | N/A
Compliance | 0.1 | 0.1 | 0.1
Measure Channel Name | N/A | Idrain | N/A
Measure Mode | N/A | Current Measured | N/A
Measure Range | N/A | Limited Auto = 1nA | N/A
Frequency | N/A | N/A | N/A
AC Level | N/A | N/A | N/A
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
