lastoyz/dsn_pgu_adda_s3100_git/txem7310_pll/txem7310_pll.srcs/_test/cpp__TSPACE_/T-SPACE/Workspace/Test/IV_Sweep_NMOS_Id-Vd_test.xlsx

Sheet: Settings
=====================
Run
=====================
Test Name | IV_Sweep_NMOS_Id-Vd
Test Date | 2021-04-19 16:55:22
Test Time | 41.715s
Mode | Sweep Measure
Speed | Medium
Hold Time | 0s
Delay Time | 0s
Instrument Channel | SMU1 | SMU2 | SMU3
Force Channel Name | Vdrain | Vgate | Vsource
Force Mode | Voltage Sweep | Voltage Sweep | Voltage Bias
Sweep Mode | VAR1 | VAR2 | Constant
Sweep Direction | Single | N/A | N/A
Start/Level | 0 | 2 | 0
Stop/Offset | 5 | 4 | N/A
Step/Ratio | 0.2 | 0.25 | N/A
Number of Points | 26 | 9 | N/A
Compliance | 0.1 | 0.1 | 0.1
Measure Channel Name | Idrain | N/A | N/A
Measure Mode | Current Measured | N/A | N/A
Measure Range | Limited Auto=1nA | N/A | N/A
Frequency | N/A | N/A | N/A
AC Level | N/A | N/A | N/A
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
