lastoyz/dsn_pgu_adda_s3100_git/txem7310_pll/txem7310_pll.srcs/_test/cpp__TSPACE_/T-SPACE/Workspace/Test/IV_Sweep_NMOS_Id-Vg2.xlsx

Sheet: Settings
=====================
Append 10
=====================
Test Name | IV_Sweep_NMOS_Id-Vg
Test Date | 2021-04-05
Test Time | 09:47:12
Tact time | 74.459(sec)
=====================
Append 9
=====================
Test Name | IV_Sweep_NMOS_Id-Vg
Test Date | 2021-04-05
Test Time | 09:46:26
Tact time | 44.155(sec)
=====================
Append 8
=====================
Test Name | IV_Sweep_NMOS_Id-Vg
Test Date | 2021-04-05
Test Time | 09:46:08
Tact time | 14.048(sec)
=====================
Append 7
=====================
Test Name | IV_Sweep_NMOS_Id-Vg
Test Date | 2021-04-05
Test Time | 09:45:52
Tact time | 13.877(sec)
=====================
Append 6
=====================
Test Name | IV_Sweep_NMOS_Id-Vg
Test Date | 2021-04-05
Test Time | 09:45:36
Tact time | 13.492(sec)
=====================
Append 5
=====================
Test Name | IV_Sweep_NMOS_Id-Vg
Test Date | 2021-04-05
Test Time | 09:45:20
Tact time | 7.459(sec)
=====================
Append 4
=====================
Test Name | IV_Sweep_NMOS_Id-Vg
Test Date | 2021-04-05
Test Time | 09:45:10
Tact time | 7.522(sec)
=====================
Append 3
=====================
Test Name | IV_Sweep_NMOS_Id-Vg
Test Date | 2021-04-05
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
