lastoyz/dsn_pgu_adda_s3100_git/txem7310_pll/txem7310_pll.srcs/_test/cpp__TSPACE_/T-SPACE/Workspace/Test/IV_Sweep_NMOS_Id-Vg_Stress_org.xlsx

Sheet: Settings
=====================
Append 2
=====================
Test Name | NMOS_Id-Vg_gm.2tsd
Test Date | 2021-05-20 17:06:54
Test Time | 26.345s
=====================
Append 1
=====================
Test Name | NMOS_Id-Vg_gm.2tsd
Test Date | 2021-05-20 17:06:37
Test Time | 4.422s
=====================
Run
=====================
Test Name | NMOS_Id-Vg_gm.2tsd
Test Date | 2021-05-20 17:06:25
Test Time | 1.143s

Sheet: Data
Vdrain | Vgate | Idrain | gm
0.05 | 0 | 4.154e-13 | -5.923e-12
0.05 | 0.5 | -2.546e-12 | 2.412e-11
0.05 | 1 | 2.454e-11 | 8.076e-08
0.05 | 1.5 | 8.075e-08 | 2.103e-05
0.05 | 2 | 2.103e-05 | 7.013e-05
0.05 | 2.5 | 7.021e-05 | 9.63e-05
0.05 | 3 | 0.0001173 | 9.025e-05
0.05 | 3.5 | 0.0001605 | 8.315e-05
0.05 | 4 | 0.0002005 | 7.76e-05
0.05 | 4.5 | 0.0002381 | 7.31e-05
0.05 | 5 | 0.0002736 | 7.104e-05
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
