lastoyz/dsn_pgu_adda_s3100_git/txem7310_pll/txem7310_pll.srcs/_test/cpp__TSPACE_/T-SPACE/Workspace/Test/NMOS_Id-Vg_gm.2tsd.xlsx

Sheet: Settings
=====================
Append 1
=====================
Test Name | NMOS_Id-Vg_gm
Test Date | 2021-05-20 16:37:43
Test Time | 5.686s
Mode | Sweep Measure
Speed | Medium
Hold Time | 0.01s
Delay Time | 0.01s
Instrument Channel | SMU2 | SMU1 | SMU3
Force Channel Name | Vgate | Vdrain | Vsource
Force Mode | Voltage Sweep | Voltage Sweep | Voltage Bias
Sweep Mode | VAR1 | VAR2 | Constant
Sweep Direction | N/A | N/A | N/A
Start/Level | 0 | 0.05 | 0
Stop/Offset | 5 | 0.05 | N/A
Step/Ratio | 0.05 | 0 | N/A
Number of Points | 101 | 1 | N/A
Compliance | 0.1 | 0.1 | 0.1
Measure Channel Name | N/A | Idrain | N/A
Measure Mode | N/A | Current Measured | N/A
Measure Range | N/A | Limited Auto = 1nA | N/A
Frequency | N/A | N/A | N/A
AC Level | N/A | N/A | N/A
=====================
Run
=====================
Test Name | NMOS_Id-Vg_gm
Test Date | 2021-05-20 16:37:35
Test Time | 5.677s
Mode | Sweep Measure
Speed | Medium
Hold Time | 0.01s
Delay Time | 0.01s
Instrument Channel | SMU2 | SMU1 | SMU3
Force Channel Name | Vgate | Vdrain | Vsource
Force Mode | Voltage Sweep | Voltage Sweep | Voltage Bias
Sweep Mode | VAR1 | VAR2 | Constant
Sweep Direction | N/A | N/A | N/A
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
