lastoyz/dsn_pgu_adda_s3100_git/txem7310_pll/txem7310_pll.srcs/_test/cpp__TSPACE_/T-SPACE/Workspace/Test/test.xlsx

Vgate(V) | Vdrain(V) | Idrain(A)
4 | 0 | 2.99026e-06
4 | 0.2 | 0.000755757
4 | 0.4 | 0.00137321
4 | 0.6 | 0.00185592
4 | 0.8 | 0.00220735
4 | 1 | 0.00243216
4 | 1.2 | 0.00254801
4 | 1.4 | 0.00259745
4 | 1.6 | 0.00262153
4 | 1.8 | 0.0026368
4 | 2 | 0.0026485
4 | 2.2 | 0.002658
4 | 2.4 | 0.00266614
4 | 2.6 | 0.0026736
4 | 2.8 | 0.00268022
4 | 3 | 0.00268632
4 | 3.2 | 0.00269183
4 | 3.4 | 0.00269726
4 | 3.6 | 0.00270227
4 | 3.8 | 0.0027071
4 | 4 | 0.00271185
4 | 4.2 | 0.00271609
4 | 4.4 | 0.00272041
4 | 4.6 | 0.00272448
4 | 4.8 | 0.00272839
4 | 5 | 0.00273229
