lastoyz/dsn_pgu_adda_s3100_git/txem7310_pll/txem7310_pll.srcs/_test/cpp__TSPACE_/T-SPACE/Workspace/Test/2021.04.16.WY_C-CYTOP_100 10min.csv

[TestInfo]
Test Name | WY_MIM
Test Date | 2021-04-16
Test Time | 00:23:32
Tact time | 3.687(sec)
[TestData]
No | Index | GraphX:Vgate(V) | GraphY:Igate(A) | Isource(A)
1 | 1 | 0.00000E+000 | 2.28521E-011 | -3.43379E-011
1 | 2 | 1.00000E-001 | 3.41731E-011 | -4.49125E-011
1 | 3 | 2.00000E-001 | 5.00063E-010 | -3.78689E-010
1 | 4 | 3.00000E-001 | 5.11008E-010 | -3.92474E-010
1 | 5 | 4.00000E-001 | 5.34821E-010 | -4.12647E-010
1 | 6 | 5.00000E-001 | 5.48607E-010 | -4.27945E-010
1 | 7 | 6.00000E-001 | 5.74675E-010 | -4.53581E-010
1 | 8 | 7.00000E-001 | 6.03668E-010 | -4.79974E-010
1 | 9 | 8.00000E-001 | 6.37256E-010 | -5.13932E-010
1 | 10 | 9.00000E-001 | 6.78782E-010 | -5.56967E-010
1 | 11 | 1.00000E+000 | 7.57739E-010 | -6.38079E-010
1 | 12 | 1.10000E+000 | 8.35193E-010 | -7.17005E-010
1 | 13 | 1.20000E+000 | 9.40302E-010 | -8.18878E-010
1 | 14 | 1.30000E+000 | 1.08151E-009 | -9.59584E-010
1 | 15 | 1.40000E+000 | 1.24970E-009 | -1.13139E-009
1 | 16 | 1.50000E+000 | 1.39199E-009 | -1.26756E-009
1 | 17 | 1.60000E+000 | 1.46886E-009 | -1.35018E-009
1 | 18 | 1.70000E+000 | 1.62752E-009 | -1.50896E-009
1 | 19 | 1.80000E+000 | 1.89172E-009 | -1.77406E-009
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
