lastoyz/dsn_pgu_adda_s3100_git/txem7310_pll/txem7310_pll.srcs/_test/cpp__TSPACE_/T-SPACE/Workspace/Test/2021.04.16.WY_C-CYTOP_100 10min_350 1h.csv

[TestInfo]
Test Name | WY_MIM
Test Date | 2021-04-16
Test Time | 01:31:09
Tact time | 8.436(sec)
[TestData]
No | Index | GraphX:Vgate(V) | GraphY:Igate(A) | Isource(A)
1 | 1 | 0.00000E+000 | -8.23786E-013 | 1.25179E-011
1 | 2 | 1.00000E-001 | -2.50466E-013 | 1.10658E-011
1 | 3 | 2.00000E-001 | 3.99800E-010 | -2.62275E-010
1 | 4 | 3.00000E-001 | 4.03225E-010 | -2.65385E-010
1 | 5 | 4.00000E-001 | 4.04562E-010 | -2.66898E-010
1 | 6 | 5.00000E-001 | 4.07236E-010 | -2.68075E-010
1 | 7 | 6.00000E-001 | 4.04646E-010 | -2.65890E-010
1 | 8 | 7.00000E-001 | 3.97711E-010 | -2.61267E-010
1 | 9 | 8.00000E-001 | 3.99549E-010 | -2.63620E-010
1 | 10 | 9.00000E-001 | 4.04562E-010 | -2.68495E-010
1 | 11 | 1.00000E+000 | 3.85679E-010 | -2.53702E-010
1 | 12 | 1.10000E+000 | 4.00719E-010 | -2.65385E-010
1 | 13 | 1.20000E+000 | 3.97711E-010 | -2.62695E-010
1 | 14 | 1.30000E+000 | 4.05398E-010 | -2.69336E-010
1 | 15 | 1.40000E+000 | 4.00552E-010 | -2.65133E-010
1 | 16 | 1.50000E+000 | 4.05982E-010 | -2.69420E-010
1 | 17 | 1.60000E+000 | 4.00719E-010 | -2.65301E-010
1 | 18 | 1.70000E+000 | 4.06567E-010 | -2.70849E-010
1 | 19 | 1.80000E+000 | 4.03225E-010 | -2.66982E-010
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
