lastoyz/dsn_pgu_adda_s3100_git/txem7310_pll/txem7310_pll.srcs/_test/cpp__TSPACE_/T-SPACE/Workspace/Test/2021.04.16.WY_CYTOP_100 10min.csv

[TestInfo]
Test Name | WY_MIM
Test Date | 2021-04-16
Test Time | 00:11:27
Tact time | 4.172(sec)
[TestData]
No | Index | GraphX:Vgate(V) | GraphY:Igate(A) | Isource(A)
1 | 1 | 0.00000E+000 | 6.41239E-011 | -8.32467E-011
1 | 2 | 1.00000E-001 | 8.53311E-008 | -8.45683E-008
1 | 3 | 2.00000E-001 | 2.56924E-007 | -2.57046E-007
1 | 4 | 3.00000E-001 | 6.10576E-007 | -6.10734E-007
1 | 5 | 4.00000E-001 | 1.16787E-006 | -1.16675E-006
1 | 6 | 5.00000E-001 | 1.99253E-006 | -1.99092E-006
1 | 7 | 6.00000E-001 | 3.11310E-006 | -3.11391E-006
1 | 8 | 7.00000E-001 | 4.79765E-006 | -4.79373E-006
1 | 9 | 8.00000E-001 | 6.66244E-006 | -6.66984E-006
1 | 10 | 9.00000E-001 | 9.56710E-006 | -9.54988E-006
1 | 11 | 1.00000E+000 | 1.16679E-005 | -1.16718E-005
1 | 12 | 1.10000E+000 | 1.57756E-005 | -1.58067E-005
1 | 13 | 1.20000E+000 | 2.05221E-005 | -2.04976E-005
1 | 14 | 1.30000E+000 | 2.56910E-005 | -2.56624E-005
1 | 15 | 1.40000E+000 | 3.11940E-005 | -3.11285E-005
1 | 16 | 1.50000E+000 | 3.66125E-005 | -3.64457E-005
1 | 17 | 1.60000E+000 | 3.84285E-005 | -3.81077E-005
1 | 18 | 1.70000E+000 | 4.21545E-005 | -4.21352E-005
1 | 19 | 1.80000E+000 | 4.75840E-005 | -4.74887E-005
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
