lastoyz/dsn_pgu_adda_s3100_git/txem7310_pll/txem7310_pll.srcs/_test/cpp__TSPACE_/T-SPACE/Workspace/Test/2021.04.16.WY_CYTOP_100 10min_200 1h.csv

[TestInfo]
Test Name | WY_MIM
Test Date | 2021-04-16
Test Time | 00:39:12
Tact time | 10.499(sec)
[TestData]
No | Index | GraphX:Vgate(V) | GraphY:Igate(A) | Isource(A)
1 | 1 | 0.00000E+000 | 2.00892E-012 | -1.55971E-012
1 | 2 | 1.00000E-001 | 3.99872E-012 | -3.63650E-012
1 | 3 | 2.00000E-001 | 6.50256E-012 | -6.18036E-012
1 | 4 | 3.00000E-001 | 8.87374E-012 | -8.50736E-012
1 | 5 | 4.00000E-001 | 1.18999E-011 | -1.15600E-011
1 | 6 | 5.00000E-001 | 1.53074E-011 | -1.49462E-011
1 | 7 | 6.00000E-001 | 2.06384E-011 | -2.02758E-011
1 | 8 | 7.00000E-001 | 2.52647E-011 | -2.49715E-011
1 | 9 | 8.00000E-001 | 3.13917E-011 | -3.11102E-011
1 | 10 | 9.00000E-001 | 4.07603E-011 | -4.04015E-011
1 | 11 | 1.00000E+000 | 5.03031E-011 | -5.00181E-011
1 | 12 | 1.10000E+000 | 6.07081E-011 | -6.04938E-011
1 | 13 | 1.20000E+000 | 6.99109E-011 | -6.95599E-011
1 | 14 | 1.30000E+000 | 7.51424E-011 | -7.49479E-011
1 | 15 | 1.40000E+000 | 8.66087E-011 | -8.64245E-011
1 | 16 | 1.50000E+000 | 9.19314E-011 | -9.16623E-011
1 | 17 | 1.60000E+000 | 9.91113E-011 | -9.88602E-011
1 | 18 | 1.70000E+000 | 1.03953E-010 | -1.03706E-010
1 | 19 | 1.80000E+000 | 1.03497E-010 | -1.03172E-010
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
