lastoyz/dsn_pgu_adda_s3100_git/txem7310_pll/txem7310_pll.srcs/_test/cpp__TSPACE_/T-SPACE/Workspace/Test/2021.04.16.WY_CYTOP_100 10min_350 1h.csv

[TestInfo]
Test Name | WY_MIM
Test Date | 2021-04-16
Test Time | 01:25:50
Tact time | 9.762(sec)
[TestData]
No | Index | GraphX:Vgate(V) | GraphY:Igate(A) | Isource(A)
1 | 1 | 0.00000E+000 | 2.01721E-012 | -2.80245E-012
1 | 2 | 1.00000E-001 | 3.25255E-012 | -3.76161E-012
1 | 3 | 2.00000E-001 | 4.61225E-012 | -5.02103E-012
1 | 4 | 3.00000E-001 | 6.11289E-012 | -6.40555E-012
1 | 5 | 4.00000E-001 | 8.16073E-012 | -8.42396E-012
1 | 6 | 5.00000E-001 | 1.11454E-011 | -1.12097E-011
1 | 7 | 6.00000E-001 | 1.48183E-011 | -1.48295E-011
1 | 8 | 7.00000E-001 | 2.08457E-011 | -2.09181E-011
1 | 9 | 8.00000E-001 | 2.83821E-011 | -2.83578E-011
1 | 10 | 9.00000E-001 | 3.76513E-011 | -3.75741E-011
1 | 11 | 1.00000E+000 | 5.08337E-011 | -5.07020E-011
1 | 12 | 1.10000E+000 | 5.87349E-011 | -5.85671E-011
1 | 13 | 1.20000E+000 | 6.87834E-011 | -6.86258E-011
1 | 14 | 1.30000E+000 | 7.70493E-011 | -7.68913E-011
1 | 15 | 1.40000E+000 | 8.70398E-011 | -8.68498E-011
1 | 16 | 1.50000E+000 | 1.03091E-010 | -1.02897E-010
1 | 17 | 1.60000E+000 | 1.01184E-010 | -1.00862E-010
1 | 18 | 1.70000E+000 | 1.08778E-010 | -1.08585E-010
1 | 19 | 1.80000E+000 | 1.04351E-010 | -1.04115E-010
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
