lastoyz/dsn_pgu_adda_s3100_git/txem7310_pll/txem7310_pll.srcs/_test/cpp__TSPACE_/T-SPACE/Images/fail.jpg

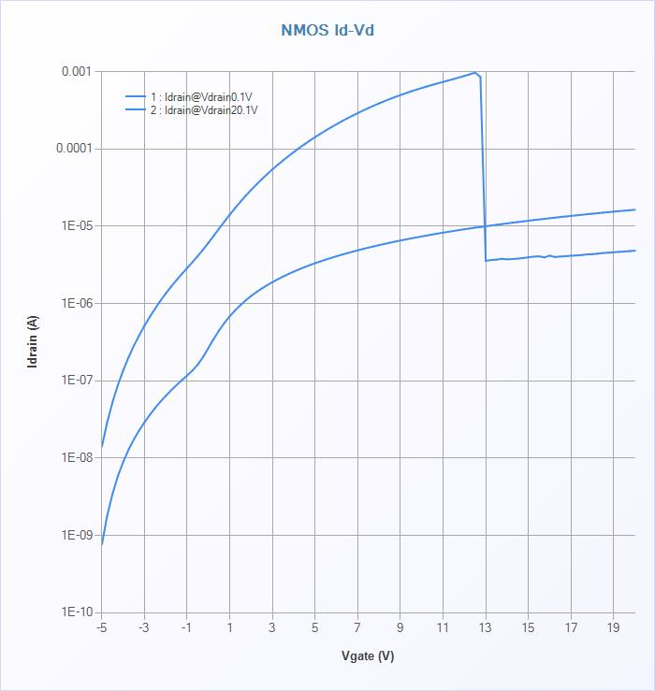
txem7310_pll/txem7310_pll.srcs/_test/cpp__TSPACE_/T-SPACE/Images/fail.jpg
