lastoyz/dsn_pgu_adda_s3100_git/dsn/1.sch/_ref/CMU_CPU_F5500_R190510__DEBUG_0709.pdf

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
D | D
C | C
B | B
A | A

# === Requirement === * PCB spec: FR-4, 6L, 1.6T, 360mm X 144mm * TOP/BOT impedance artwork (signle 50R / diff 100R)

* 2L and 5L are for GND.
* 3L and 4L are for GND / PWR.

# * BOARD edge clearance 2mm

* CGND on board egdes.

* CMU backplane pin map ... A --> B --> C --> D CC0 : SPO_CD0
CC1 : SPO_EN0
CC2 : SPO_CD1 <<< bias board
CC3 : SPO_EN1 <<< bias board CC4 : SPO_CD2
CC5 : SPO_EN2
CC6 : SPO_CD3 // reserved
CC7 : SPO_EN3 // reserved

# * Measure: 3.3V * 1/11 = 0.3V See https://www.xilinx.com/support/documentation/user_guides/ug480_7Series_XADC.pdf Figure 2-8: Differential Input Signal Range // common mode 0.5V, diff mode 1V max

SILK:[0.275V] | SILK:[0.55V]

SMBJ15A/DO-214AA
Breakdown Voltage: 18.5 V
Working Voltage: 15 V
Clamping Voltage: 24.4 V
Ipp - Peak Pulse Current: 24.6 A Package / Case: DO-214AA-2
Pd - Power Dissipation: 600 W

=== cut-off freq ===
1 / (2 * pi * sqrt (4.7e-6H * 22uF) ) = 15.6516404 kilohertz 1 / (2 * pi * sqrt (4.7e-6H * 47uF) ) = 10.708343 kilohertz

CC8 : MOSI // reserved for MCP23S17 CC9 : SCLK // reserved
CC10: SCSB // reserved
CC11: TEST-OUT
CC12: MISO // reserved
CC13: RBCK2
CC14: RBCK1
CC15: UNBAL

CC16: D_R
CC17: C_R
CC18: B_R
CC19: A_R
CC20: D_D
CC21: C_D
CC22: B_D
CC23: A_D

CD0+: MOSI0+ // reserved
CD0-: MOSI0- // reserved
CD1+: MOSI1+ // reserved
CD1-: MOSI1- // reserved
CD2+: MISO0+ // reserved
CD2-: MISO0- // reserved
CD3+: MISO1+ // reserved
CD3-: MISO1- // reserved

== thermal note ==
LM317SX/TO-263-3 // 41.0 deg/W
LM337KTTR/TO-263 // 25.3 deg/W
//
8mA load ... Vdrop = 15V-13.5V=1.5V ... 1.5V*8mA=12mW ... 12mW*41deg/W=0.492deg 0.8A load ... Vdrop = 15V-13.5V=1.5V ... 1.5V*0.8A=1.2W ... 1.2W*41deg/W=49.2deg <<< 8mA load ... Vdrop = 40V-36V=4V ... 4V*8mA=32mW ... 32mW*41deg/W=1.31200 deg
0.8A load ... Vdrop = 40V-36V=4V | ... 4V*0.8A=3.2W ... 3.2W*41deg/W=131.200deg !!!
0.3A load ... Vdrop = 40V-36V=4V | ... 4V*0.3A=1.2W ... 1.2W*41deg/W=49.2deg <<<

R1

R2

== Vout ==
Vout = 1.25 * (1 + R2/R1)+Vadj
Vadj=100uA*R2 (max)
Iprog=Vout*(R1+R2) --Vadj=(100e-6 amperes) * 1.5e3 ohms = 0.15 volts

Vadj=(100e-6 amperes) * 1.47e3 ohms = 0.147 volts --1.25 * (1 + 1.5k/3.3k) = 1.81V

1.25 * (1 + 1.5k/1.2k) = 2.81V, 2.81V/(1.5e3ohm+1.2e3ohm)=1mA
1.25 * (1 + 1.47e3/150) = 13.5V, 13.5V/(1.47e3ohm+150ohm)=8.3mA
1.25 * (1 + 4.02e3/143) = 36.39V, 36.39V/(4.02e3ohm+143ohm)=8.7mA, 0.32W !! --RT0603DRD07150RL/150R/1608/0.5%/25ppm/0.1W

RT0603DRD071K47L/1.47K/1608/0.5%/25ppm/0.1W TNPW1206150RBEEA/150R/3216/0.1%/25ppm/0.4W TNPW12061K47BEEN/1.47K/3216/0.1%/25ppm/0.4W TNPW1206143RBEEN/143R/3216/0.1%/25ppm/0.4W TNPW12064K02BEEA/4.02K/3216/0.1%/25ppm/0.4W

PG_XX_REG

IHLP2020BZERR68M01/680nH/20%/15A/12.4mR https://kr.mouser.com/datasheet/2/427/ihlp-2020bz-01-270737.pdf

CMDSH-3TR/30V/100mA/SOD-323 https://kr.mouser.com/datasheet/2/68/cmdsh-3-39175.pdf

Forced Continuous Mode

VRT = INTVCC // 2MHz 30%
RRT = 324k // 1MHz 30%
RRT = 160k // 2MHz 30%
RRT = 80.6k // 4MHz 30%

INTVcc=3.3V

VOUT = 0.6V *(1+R1/R2)
0.6V *(1+180e3/40e3) = 3.3 volts

### 0.6 V * (1 + (232e3 / 40e3)) = 4.08 volts // for DAC 0.6 V * (1 + (300e3 / 40e3)) = 5.1 volts // for FPGA IO

0.6V *(1+360e3/40e3) = 6V | // for ADC
0.6V *(1+316e3/40e3) = 5.34V | // for ADC option or FPGA IO option --PCF0805R-232KBT1/232K/2012/25ppm/0.1%

CPF0805B300KE1/300K/2012/25ppm/0.1% CPF0805B360KE1/360K/2012/25ppm/0.1% --TNPW060340K0BEEA/40K/1608/25ppm/0.1%

PGND (Pins 3, 4): Power Ground Pin.
The terminal of the input bypass capacitor, CIN, and the terminal of the output capacitor, COUT , should be tied to this pin with a low impedance connection.

SGND (Exposed Pad Pin 17): Signal Ground Pin.
This pin should have a low noise connection to reference ground. The feedback resistor network, external compensation network and RT resistor should be connected to
this ground.

for power lines

for power lines

miniSMDC150F/16-2/4532
Hold Current: 1.5 A
Maximum Voltage: 16 V
Trip Current: 2.9 A
Resistance: 110 mOhms

DAMPER
Cbyp=22uF / Cdamp=470uF / L=4.7uH / R=0.22R Cbyp=10uF / Cdamp=220uF / L=2.2uH / R=0.22R Cbyp=100nF / Cdamp=4.7uF / L=22nH / R=0.22R

TPSE227K016R0150/220uF/10%/16V/150mR Capacitance: 220 uF
Voltage Rating DC: 16 VDC
Tolerance: 10 %
ESR: 150 mOhms
Case Code - in: 2917
Case Code - mm: 7343
Height: 4.1 mm
Mfr Case Code: E case

IHLP2525CZER2R2M01/2.2uH/20%/14A/20mR/6363 Shielding: Shielded
Inductance: 2.2 uH
Tolerance: 20 %
Maximum DC Current: 14 A
Maximum DC Resistance: 20 mOhms Self Resonant Frequency: 5 MHz Package / Case: 2525 (6363 metric) Length: 6.86 mm
Width: 6.47 mm
Height: 3 mm

LT1763CS8-5V
LT1763CS8-2.5V
LT1763CS8-3.3V
LT1763CS8-1.8V

DAMPER
Cbyp=22uF / Cdamp=470uF / L=4.7uH / R=0.22R Cbyp=10uF / Cdamp=220uF / L=2.2uH / R=0.22R Cbyp=100nF / Cdamp=4.7uF / L=22nH / R=0.22R

OSC_DIFF_IN 200 ~ 500MHz
Conv clock 1 ~ 15MHz

// reserved for reset or interlock

(15V-2.5V)/1mA=12.5Kohm
(15V-2.5V)/1.25mA=10Kohm ---- 1 / (2 * pi * (50 ohm) * (100 nF)) = 31.8309886 kilohertz

1 / (2 * pi * (50 ohm) * (10 pF)) = 318.309886 megahertz 1 / (2 * pi * (25e3 ohm) * (47 nF)) = 135.451015 hertz
1 / (2 * pi * (1000 ohm) * (47 nF)) = 3.38627538 kilohertz 1 / (2 * pi * (1000 ohm) * (470 nF)) = 338.627538 hertz 1 / (2 * pi * (1000 ohm) * (4700 nF)) = 33.8627538 hertz 1 / (2 * pi * (100 ohm) * (47 nF)) = 33.8627538 kilohertz 1 / (2 * pi * (100 ohm) * (470 nF)) = 3.38627538 kilohertz 1 / (2 * pi * (100 ohm) * (4700 nF)) = 338.627538 hertz

ACASN1001S5001P1AT/1616
// Resistor Networks & Arrays 1K/5Kohm .1%/.05% 25/15ppm MPMA10015001AT5/SOT-23
// Resistor Networks & Arrays 1K/5Kohms 0.1%abs 0.05%ratio

414026-2
RF Series: SMB
Gender: Jack
Impedance: 50 Ohms
Minimum Frequency: -
Maximum Frequency: 4 GHz
Termination Style: Solder
Orientation: Right Angle
Polarity: Standard
Packaging: Bulk
Body Material: Brass
Contact Plating: Gold
Brand: TE Connectivity
Contact Material: Brass
Body Finish: Gold
Insulation Resistance: 1000 MOhms https://kr.mouser.com/datasheet/2/418/NG_CS_1307191_SMB_Connectors_0307-1234521.pdf

SRF2012A-121YA
Impedance: 120 Ohms
Tolerance: 25 %
Maximum DC Current: 400 mA
Maximum DC Resistance: 300 mOhms Self Resonant Frequency: -
Minimum Operating Temperature: - 55 C Maximum Operating Temperature: + 125 C Package / Case: 0805 (2012 metric) Length: 2 mm
Width: 1.2 mm
Height: 1.2 mm
Packaging: Cut Tape
Packaging: MouseReel
Packaging: Reel
Product: Common Mode Line Filters https://kr.mouser.com/datasheet/2/54/rf2012aa-948268.pdf

DS90LV804TSQ/WQFN-32
Number of Drivers: 4 Driver Number of Receivers: 4 Receiver Data Rate: 800 Mb/s
Input Type: CML, LVDS, LVPECL Output Type: LVDS
Supply Voltage - Max: 3.45 V
Supply Voltage - Min: 3.15 V
Minimum Operating Temperature: - 40 C Maximum Operating Temperature: + 85 C Mounting Style: SMD/SMT
Package / Case: LLP EP
Packaging: Cut Tape
Packaging: MouseReel
Packaging: Reel
Height: 0.8 mm
Input Voltage MAX: 0.1 V
Length: 5 mm
Series: DS90LV804
Width: 5 mm
Brand: Texas Instruments
Input Voltage MIN: - 0.1 V Maximum Output Voltage: 0.6 V Operating Supply Current: 140 mA Operating Supply Voltage: 3.3 V Pd - Power Dissipation: 4160 mW

SY89832UMG/QFN-16
Series: SY89832
Number of Outputs: 4 Output Maximum Input Frequency: 2.5 GHz Propagation Delay - Max: 570 ps Supply Voltage - Max: 2.625 V
Supply Voltage - Min: 2.375 V Minimum Operating Temperature: - 40 C Maximum Operating Temperature: + 85 C Mounting Style: SMD/SMT
Package / Case: QFN-16
Packaging: Tube
Brand: Microchip Technology / Micrel
Operating Supply Current: 75 mA
Product Type: Clock Buffer https://kr.mouser.com/datasheet/2/268/sy89832u-779039.pdf

[ADI]ADR421ARZ/SO-8 2.5V ref, 5V~18V-in 100R/2012/25ppm/0.1%/1W_PCAN0805E1000BST5

* 1 / (2 * | pi | * | (100 pF) * (100e3 ohm)) = 15.9154943 kilohertz

== new resistor net ==
499 --> | 124R/1608/0.1%_TNPW0603124RBEEA
866 --> | 215R/1608/0.1%_TNPW0603215RBEEA
1070 --> | 267R/1608/0.1%_TNPW0603267RBEEA
2320 --> | 576R/1608/0.1%_TNPW0603576RBEEA
2000 --> | 499R/1608/0.1%_TNPW0603499RBEEA

* 100nF
1/(2*pi*22e3ohm*100nF) = 72.3Hz 1/(2*pi*10e3ohm*100nF) = 159.1Hz

1/(2*pi*47pF*10ohm)=338.627538 megahertz
1 / (2 * pi * (3.94700 nF) * (10 ohm)) = 4.03230157 megahertz
1 / (2 * pi * ((2.0 nF) + (47 pF)) * (10 ohm)) = 7.77503386 megahertz 1 / (2 * pi * ((1.0 nF) + (47 pF)) * (10 ohm)) = 15.2010452 megahertz GCM1885C1H202FA16J/2.0nF/1%/50V/1608
1/(2*pi*12pF*3*50ohm)=88.4194128 megahertz | // | 3 | cap in IC
1 / (2 * pi * ((12 pF) + (130 pF)) * 3 * (50 | ohm)) | = 7.47206306 megahertz // 3 cap ext
1 / (2 * pi * ((12 pF) + (2* 56 pF)) * 3 * | (50 | ohm)) = 8.55671737 megahertz // 3 cap ext
1 / (2 * pi * ((12 pF) + (56 pF)) * 3 * (50 | ohm)) | = 15.6034258 megahertz

1.5A

1.5A

THS4631DDA/SO-PowerPAD-8
http://www.ti.com/lit/ds/symlink/ths4631.pdf

THS4631DDA/SO-PowerPAD-8
http://www.ti.com/lit/ds/symlink/ths4631.pdf

DAMPER
Cbyp=22uF / Cdamp=470uF / L=4.7uH / R=0.22R Cbyp=10uF / Cdamp=220uF / L=2.2uH / R=0.22R Cbyp=100nF / Cdamp=4.7uF / L=22nH / R=0.22R

LQG18HH22NJ00D/22nH/500mA/5%/500mR/1608 500mA
Shielding: Shielded
Inductance: 22 nH
Tolerance: 5 %
Maximum DC Current: 500 mA Maximum DC Resistance: 500 mOhms Self Resonant Frequency: 1.6 GHz Saturation Current: -
Minimum Operating Temperature: - 55 C Maximum Operating Temperature: + 125 C Q Minimum: 12
Test Frequency: 100 MHz
Termination: -
Mounting Style: PCB Mount
Package / Case: 0603 (1608 metric) Length: 1.6 mm
Width: 0.8 mm
Height: 0.8 mm
Application: RF
Qualification: AEC-Q200
Series: LQG
Packaging: Cut Tape
Packaging: MouseReel
Packaging: Reel
Product: Fixed Inductors

TPSD475K050R0250/4.7uF/10%/50V/250mR/7343 Capacitance: 4.7 uF
Voltage Rating DC: 50 VDC
Tolerance: 10 %
ESR: 250 mOhms
Case Code - in: 2917
Case Code - mm: 7343
Height: 2.9 mm
Mfr Case Code: D case
Minimum Operating Temperature: - 55 C Maximum Operating Temperature: + 125 C Packaging: Cut Tape
Packaging: MouseReel
Packaging: Reel
Length: 7.3 mm
Product: Tantalum Solid Low ESR Standard Grade Termination Style: SMD/SMT
Width: 4.3 mm
Brand: AVX
Leakage Current: 2.4 uA
Capacitance - nF: 4700 nF

1 / (2 * pi * (100 ohm) * (10 pF)) = 159.154943 megahertz

# BIAS BASE LEVEL DAC // 4ch // -5V~+5V

# [PULSE-OUT] DWAVE 8-F 4-LEVEL Open drain driver // 6ch gates or 2ch wave-out

# ADC port in (2ch) Common-mode choke // ac-coupling // filter // opamp ac-gain x1, x11 or x101

# ADC cores (2ch)

Diff. driver // 15Msps ADC // filter BW7.5MHz // Clock driver | ADC control buffer (2ch)
| LVDS driver // 2.5V gate driver

# AUX port and devices LAN port // DEBUG port // SIO port // EEPROM // TEMP sensor

=== WIZ820io / WIZ850io ===
J1-L, J2-R
J1, | GND/GND/MOSI/SCLK/SSN/INTN
J2, | GND/VIN3.3/VIN3.3/PWDN/RSTN/MISO
artwork note: | no part place on the top box relating to LJ1 / LJ2
BOT trace artwork preferred.

== ext module control ==
3.3V
GND
CC11 : SDA // reserved for SSD1306 I2C CC9 : SCL // reserved ---- 3.3V

GND
CC8 : MOSI // reserved for MCP23S17 CC9 : SCLK // reserved
CC10: SCSB // reserved
CC12: MISO // reserved

TS1 TS0 SCALAR MULTIPLIER (µ s/K) GND GND 10
GND VDD 40
VDD GND 160
VDD VDD 640 --T( C) = PERIOD(µ s) / SCALAR MULTIPLIER(µ s/ K) - 273.15 K

# FPGA module interface XEM7310

# Mother board connector

F5500

# Mount holes and Power TP // Ground paths

# Powers on DGND // +3.3V_D

+12V~+15V

Impedance: 60 Ohms
Maximum DC Current: 3 A
Tolerance: 25 %
Maximum DC Resistance: 25 mOhms

Inductance: 4.7 uH
Tolerance: 20 %
Maximum DC Current: 10 A
Maximum DC Resistance: 63 mOhms Self Resonant Frequency: 5 MHz

Hold Current: 1.5 A
Maximum Voltage: 16 V
Trip Current: 2.9 A
Resistance: 110 mOhms

# Isolators // DGND vs GND_FPGA

SPO_000
A[2,1,0]="000"

H:pull-up, L:open-drain

SPO_001
A[2,1,0]="001"

H:pull-up, L:open-drain

SPO_010
A[2,1,0]="010"

H:pull-up, L:open-drain

((3.3 V) - (1.0 V)) / (1e3 ohm) = 0.0023 amperes

# Serial to Parallel circuits // SN74LV8153 and LED test drive

# [TEST-OUT] LC filter 12MHz // THS4631 opamp 3x or 6x

1 / (2 * pi * (24.0e3 ohm) * (47 nF)) = 141.094808 hertz 1 / (2 * pi * (24.0e3 ohm) * (4.7 uF)) = 1.41094808 hertz 1 / (2 * pi * (24.0e3 ohm) * (47 uF)) = 0.141094808 hertz

# Powers on AGND // filters // +15V_FPGA // +15V_ANAL // +/-15V_AMP

* 12.4V 5mA

* 12.4V 5mA

((13.5 V) - (12.4 V)) / (1e3 ohm) = 0.0011 amperes (12.4 V) / (100e3 ohm) = 0.000124 amperes
(3.3 V) / (1 mA) = 3300 ohms
(3.3 V) / (10 mA) = 330 ohms

# Power Gated // +/-13.5V_AMP // +/-13.5V_ADC_BUF // +/-15V_AMP_GATED

# Powers on GND_ANAL // REG and filter // +6V_ANAL // +5V_ANAL // +3.3V_ANAL // +2.5V_ANAL // +2.5V_ANAL_AUX

# IO Powers on GND_FPGA // LDO REG and filter

// +3.3V_ISO | // +3.3V_FPGA_IO | // +3.3V_SP_IO // +3.3V_DAC_IO // +3.3V_EXT

XC6220B331MR-G/3.3V/1.2A/SOT-25-5 Package / Case: SOT-25-5
Output Voltage: 3.3 V
Output Current: 1.2 A
Number of Outputs: 1 Output Quiescent Current: 8 uA
Input Voltage MAX: 6 V
Input Voltage MIN: 1.6 V
Output Type: Fixed
Minimum Operating Temperature: - 40 C Maximum Operating Temperature: + 85 C Load Regulation: 10 mV
Dropout Voltage: 60 mV
Packaging: Cut Tape
Packaging: MouseReel
Packaging: Reel
Product: LDO Regulators
Type: Low Noise High Speed, CMOS LDO Voltage Regulator Brand: Torex Semiconductor
Dropout Voltage - Max: 655 mV
PSRR / Ripple Rejection - Typ: 50 dB
Voltage Regulation Accuracy: 1 % Line Regulation: 0.01 %/V
Operating Supply Current: 50 uA
Pd - Power Dissipation: 250 mW

# Powers on GND_FPGA // SW REG // +5V_FPGA_CORE // MC1_VDCIN_P5V // +5V_FPGA_IO

PG_XX_REG

IHLP2020BZERR68M01/680nH/20%/15A/12.4mR https://kr.mouser.com/datasheet/2/427/ihlp-2020bz-01-270737.pdf

CMDSH-3TR/30V/100mA/SOD-323 https://kr.mouser.com/datasheet/2/68/cmdsh-3-39175.pdf

Forced Continuous Mode

VRT = INTVCC // 2MHz 30%
RRT = 324k // 1MHz 30%
RRT = 160k // 2MHz 30%
RRT = 80.6k // 4MHz 30%

INTVcc=3.3V

VOUT = 0.6V *(1+R1/R2)
0.6V *(1+180e3/40e3) = 3.3 volts

### 0.6 V * (1 + (232e3 / 40e3)) = 4.08 volts // for DAC 0.6 V * (1 + (300e3 / 40e3)) = 5.1 volts // for FPGA IO

0.6V *(1+360e3/40e3) = 6V | // for ADC
0.6V *(1+316e3/40e3) = 5.34V | // for ADC option or FPGA
PCF0805R-232KBT1/232K/2012/25ppm/0.1% CPF0805B300KE1/300K/2012/25ppm/0.1% CPF0805B360KE1/360K/2012/25ppm/0.1% --TNPW060340K0BEEA/40K/1608/25ppm/0.1%

PGND (Pins 3, 4): Power Ground Pin.
The terminal of the input bypass capacitor, CIN, and the terminal of the output capacitor, COUT , should be tied to this pin with a low impedance connection.

SGND (Exposed Pad Pin 17): Signal Ground Pin.
This pin should have a low noise connection to reference ground. The feedback resistor network, external compensation network and RT resistor should be connected to
this ground.

AD9854 CMOS 300 MSPS Quadrature Complete DDS, 12 bit http://www.analog.com/media/en/technical-documentation/data-sheets/AD9854.pdf 120MHz BW LPF
... other LPFs are picked up by simulation. not calculation.

Design Low Pass Elliptic filters https://www.coilcraft.com/apps/lc_filter_designer/lc_filter_designer.cfm ripple .000001 dB
stop 60dB
imp 50R
band 120MHz
poles 7
1008

1 / (2 * pi * (50 ohm) * (10 pF)) = 318.309886 megahertz

# [PULSE-OUT-AUX] DWAVE 8-F 4-LEVEL Open drain driver // 6ch gates or 2ch wave-out

* 10pF
1/(2*pi*25ohm*10pF) = 636.619772 megahertz

* 10pF
1/(2*pi*25ohm*10pF) = 636.619772 megahertz

== new resistor net ==
499 --> | 124R/1608/0.1%_TNPW0603124RBEEA
866 --> | 215R/1608/0.1%_TNPW0603215RBEEA
1070 --> | 267R/1608/0.1%_TNPW0603267RBEEA
2320 --> | 576R/1608/0.1%_TNPW0603576RBEEA
2000 --> | 499R/1608/0.1%_TNPW0603499RBEEA

* 100nF
1/(2*pi*22e3ohm*100nF) = 72.3Hz 1/(2*pi*10e3ohm*100nF) = 159.1Hz
1 / (2 * pi * (10e3 ohm) * (47 nF)) = 338.627538 hertz

== reserved ==
ADC_10_DB_P
ADC_10_DB_N
ADC_10_DA_P
ADC_10_DA_N

== reserved ==
ADC_10_DCO_P
ADC_10_DCO_N

== reserved (24EA) ==
DAC_D8P
DAC_D8N

DAC_D9P
DAC_D9N
DAC_D10P
DAC_D10N
DAC_D11P
DAC_D11N

DAC_D12P
DAC_D12N

DAC_D13P
DAC_D13N
DAC_D14P
DAC_D14N
DAC_D15P
DAC_D15N
DAC_SDO

DAC_SDIO
DAC_SCLK

DAC_CSB
CD3+
CD3-
CD1+
CD1-

== reserved (2EA) ==
DAC_DCO_P
DAC_DCO_N

== reserved (8EA) ==
DAC_D6P
DAC_D6N

DAC_D7P
DAC_D7N
CD0+
CD0-
CD2+
CD2-

== reserved (14EA) ==
DAC_D4P
DAC_D4N
DAC_D3P
DAC_D3N
DAC_D2P
DAC_D2N

DAC_D1P
DAC_D1N

DAC_D0P
DAC_D0N
DAC_DCI_P
DAC_DCI_N
DAC_D5P
DAC_D5N

== reserved ==
ADC_11_DB_P
ADC_11_DB_N
ADC_11_DA_P
ADC_11_DA_N
ADC_11_DCO_P
ADC_11_DCO_N

== reserved ==
(REMOVE)BIAS_LOAD_B
(REMOVE)BIAS_CLR_B

== reserved ==
(REMOVE)ADC_XX_DUAL_LANE_B

PN SWAP IN FW

PN SWAP IN FW

PN SWAP IN FW

=== JTAG artwork note ===
* group route for JTAG_xxx * GND guard for JTAG_xxx

* 47nF
1 / (2 * pi * (24.9e3 ohm) * (47 nF)) = 135.994995 hertz

1.5A

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

1 / (2 * pi * (100 ohm) * (47 nF)) = 33.8627538 kilohertz 1 / (2 * pi * (100 ohm) * (470 nF)) = 3.38627538 kilohertz

1 / (2 * pi * (6000 ohm) * (47 nF)) = 564.379231 hertz 1 / (2 * pi * (6000 ohm) * (470 nF)) = 56.4379231 hertz

TS1 TS0 SCALAR MULTIPLIER (µ s/K) GND GND 10
GND VDD 40
VDD GND 160
VDD VDD 640 --T( C) = PERIOD(µ s) / SCALAR MULTIPLIER(µ s/ K) - 273.15 K

Place near C70.
diff pair: DWAVE_R_OUT1_P / DWAVE_R_OUT1_N

Place near C141.
diff pair: DWAVE_R_OUT2_P / DWAVE_R_OUT2_N

Place near R197
diff pair: Vadc2_amp_ac_P / Vadc2_amp_ac_N

Place near R286
diff pair: Vadc1_amp_ac_P / Vadc1_amp_ac_N

=== debug_0601 ===
* R599 : (OPEN)0R/1608/1%
* R600 : (OPEN)0R/1608/1%

=== debug_0607 ===
ADC filter BW adjust
* C262 : (OPEN)47pF/0603/25V/1% * C270 : (OPEN)47pF/0603/25V/1% * C328 : (OPEN)47pF/0603/25V/1% * C334 : (OPEN)47pF/0603/25V/1% * C260 : (OPEN)56pF/1608/50V/1% * C264 : (OPEN)56pF/1608/50V/1% * C276 : (OPEN)56pF/1608/50V/1% * C327 : (OPEN)56pF/1608/50V/1% * C329 : (OPEN)56pF/1608/50V/1% * C336 : (OPEN)56pF/1608/50V/1% * C465 : (OPEN)56pF/1608/50V/1% * C466 : (OPEN)56pF/1608/50V/1% * C467 : (OPEN)56pF/1608/50V/1% * C468 : (OPEN)56pF/1608/50V/1% * C469 : (OPEN)56pF/1608/50V/1% * C470 : (OPEN)56pF/1608/50V/1% * C257 : (OPEN)1000pF/1608/50V/1% * C279 : (OPEN)1000pF/1608/50V/1% * C325 : (OPEN)1000pF/1608/50V/1% * C338 : (OPEN)1000pF/1608/50V/1% * C471 : (OPEN)1000pF/1608/50V/1% * C472 : (OPEN)1000pF/1608/50V/1% * C473 : (OPEN)1000pF/1608/50V/1% * C474 : (OPEN)1000pF/1608/50V/1%

=== debug_0607 ===
BUFFER adjust
* C233 : 180pF/1608/50V/1% * C263 : 180pF/1608/50V/1%
* R211 : (OPEN)0.22R/1608/1%
* R309 : (OPEN)0.22R/1608/1%
* C245 : 1nF/1608/50V/5% --> 270pF/1608/50V/1% (*pending) * C295 : 1nF/1608/50V/5% --> 270pF/1608/50V/1% (*pending)

=== debug_0627 ===
* buf feedback cap remove
C233 | 180pF/1608/50V/1% --> (OPEN)180pF/1608/50V/1%
C263 | 180pF/1608/50V/1% --> (OPEN)180pF/1608/50V/1%
* buf feedback res replace
R191 | 499R/1608/1%_RN731JTTD4990F25 --> | 0.22R/1608/1%
R262 | 499R/1608/1%_RN731JTTD4990F25 --> | 0.22R/1608/1%
* buf feedback gain res remove
R190 | 4.99R/1608/1% --> (OPEN)4.99R/1608/1%
R193 | 49.9R/1608/1% --> (OPEN)49.9R/1608/1%
R254 | 4.99R/1608/1% --> (OPEN)4.99R/1608/1%
R278 | 49.9R/1608/1% --> (OPEN)49.9R/1608/1%
* buf out damp cap remove
C245 | 1nF/1608/50V/5% --> (OPEN)1nF/1608/50V/5%
C295 | 1nF/1608/50V/5% --> (OPEN)1nF/1608/50V/5%

=== debug_0627 ===
* test out gain 0.55
C156 | 10pF/1608/50V/5%_C1608C0G100J50VB | --> | (TMP)124R/1608/0.1%_TNPW0603124RBEEA
C216 | 10pF/1608/50V/5%_C1608C0G100J50VB | --> | (TMP)124R/1608/0.1%_TNPW0603124RBEEA
// will add Res parallel to Cap
R91 | 0R/1608/1% --> (OPEN)0R/1608/1%
R105 | 0R/1608/1% --> (OPEN)0R/1608/1%
R143 | 0R/1608/1% --> (OPEN)0R/1608/1%
R160 | 0R/1608/1% --> (OPEN)0R/1608/1%

=== debug_0627 ===
* dwave out cap place
C500 | (OPEN)10pF/1608/50V/5%_C1608C0G100J50VB --> 43pF/1608/50V/5%
C504 | (OPEN)10pF/1608/50V/5%_C1608C0G100J50VB --> 43pF/1608/50V/5%
C508 | (OPEN)10pF/1608/50V/5%_C1608C0G100J50VB --> 43pF/1608/50V/5%
C512 | (OPEN)10pF/1608/50V/5%_C1608C0G100J50VB --> 43pF/1608/50V/5%
* 1/8_R setting
R44 | 124R/1608/0.1%_TNPW0603124RBEEA --> | (OPEN)124R/1608/0.1%_TNPW0603124RBEEA
R98 | 124R/1608/0.1%_TNPW0603124RBEEA --> | (OPEN)124R/1608/0.1%_TNPW0603124RBEEA
R567 | 124R/1608/0.1%_TNPW0603124RBEEA --> | (OPEN)124R/1608/0.1%_TNPW0603124RBEEA
R576 | 124R/1608/0.1%_TNPW0603124RBEEA --> | (OPEN)124R/1608/0.1%_TNPW0603124RBEEA
R68 | 499R/1608/0.1%_TNPW0603499RBEEA --> | (OPEN)499R/1608/0.1%_TNPW0603499RBEEA
R133 | 499R/1608/0.1%_TNPW0603499RBEEA --> | (OPEN)499R/1608/0.1%_TNPW0603499RBEEA
R581 | 499R/1608/0.1%_TNPW0603499RBEEA --> | (OPEN)499R/1608/0.1%_TNPW0603499RBEEA
R582 | 499R/1608/0.1%_TNPW0603499RBEEA --> | (OPEN)499R/1608/0.1%_TNPW0603499RBEEA
R74 | 576R/1608/0.1%_TNPW0603576RBEEA --> | (OPEN)576R/1608/0.1%_TNPW0603576RBEEA
R124 | 576R/1608/0.1%_TNPW0603576RBEEA --> | (OPEN)576R/1608/0.1%_TNPW0603576RBEEA
R561 | 576R/1608/0.1%_TNPW0603576RBEEA --> | (OPEN)576R/1608/0.1%_TNPW0603576RBEEA
R570 | 576R/1608/0.1%_TNPW0603576RBEEA --> | (OPEN)576R/1608/0.1%_TNPW0603576RBEEA
R65 | 267R/1608/0.1%_TNPW0603267RBEEA __> | (OPEN)267R/1608/0.1%_TNPW0603267RBEEA
R118 | 267R/1608/0.1%_TNPW0603267RBEEA __> | (OPEN)267R/1608/0.1%_TNPW0603267RBEEA
R564 | 267R/1608/0.1%_TNPW0603267RBEEA __> | (OPEN)267R/1608/0.1%_TNPW0603267RBEEA
R571 | 267R/1608/0.1%_TNPW0603267RBEEA __> | (OPEN)267R/1608/0.1%_TNPW0603267RBEEA
R48 | 215R/1608/0.1%_TNPW0603215RBEEA --> | (OPEN)215R/1608/0.1%_TNPW0603215RBEEA
R107 | 215R/1608/0.1%_TNPW0603215RBEEA --> | (OPEN)215R/1608/0.1%_TNPW0603215RBEEA
R565 | 215R/1608/0.1%_TNPW0603215RBEEA --> | (OPEN)215R/1608/0.1%_TNPW0603215RBEEA
R587 | 215R/1608/0.1%_TNPW0603215RBEEA --> | (OPEN)215R/1608/0.1%_TNPW0603215RBEEA

=== debug_0629 ===
* buf in damp cap replace
C243 | 1nF/1608/50V/5% --> 56pF/1608/50V/5%
C293 | 1nF/1608/50V/5% --> 56pF/1608/50V/5%
R211 | (OPEN)0.22R/1608/1% --> 0.22R/1608/1%
R309 | (OPEN)0.22R/1608/1% --> 0.22R/1608/1%

=== debug_0709 ===
* R28, R82: | 100K/1608/1% --> (OPEN)100K/1608/1%
* D1, | D3 : | CMDSH-3TR/30V/100mA/SOD-323 --> (OPEN)CMDSH-3TR/30V/100mA/SOD-323

DGND

AGND

DGND

AGND

+66VAIN

-66VAIN

AGND
+40VAIN
-40VAIN
-15VAIN
+15VAIN
AGND
+5VAIN
-5VAIN
AGND
DGND ISO_CC8

ISO_CC9
ISO_CC10
ISO_CC11
ISO_CC12
ISO_CC13
ISO_CC14
ISO_CC15

DGND
+5VDIN

DGND

AGND

+66VAIN

-66VAIN

AGND
+40VAIN
-40VAIN
-15VAIN
+15VAIN
AGND
+5VAIN
-5VAIN
AGND
DGND ISO_CC16

ISO_CC17
ISO_CC18
ISO_CC19
ISO_CC20
ISO_CC21
ISO_CC22
ISO_CC23

DGND
+5VDIN

DGND

AGND

+66VAIN

-66VAIN

AGND
+40VAIN
-40VAIN
-15VAIN
+15VAIN
AGND
+5VAIN
-5VAIN
AGND
DGND ISO_CD0+

ISO_CD0-
ISO_CD1+
ISO_CD1-
ISO_CD2+
ISO_CD2-
ISO_CD3+
ISO_CD3-

DGND
+5VDIN

-66VAIN
+66VAIN
AGND
+40VAIN
-40VAIN
-15VAIN
+15VAIN
AGND
+5VAIN
-5VAIN
AGND
DGND ISO_CC0

ISO_CC1
ISO_CC2
ISO_CC3
ISO_CC4
ISO_CC5
ISO_CC6
ISO_CC7

DGND
+5VDIN

JTAG_TDO

JTAG_TCK
JTAG_TMS
JTAG_TDI

LAN_MISO

FPGA_IO_D

LAN_RSTn

LAN_SSNn
LAN_SCLK

LAN_MOSI

ADC_01_DCO_P
ADC_01_DCO_N

ADC_01_DB_P
ADC_01_DB_N

ADC_01_DA_P
ADC_01_DA_N

LAN_INTn

DWAVE_F01

DWAVE_F03

DWAVE_F02

DWAVE_F11
DWAVE_F12
DWAVE_F13
BIAS_SYNCn
BIAS_SCLK
BIAS_SDI

BIAS_SDO

CC0
CC1
CC2
CC3
CC4
CC5 FPGA_IO_A | CC8 CC9

CC10

CC11

CC12

CC16
CC17
CC18

FPGA_IO_B

CC13

CC22
CC23

CC19

OSC_IN_N

OSC_IN_P

CC14

CC15

CC20
CC21
CC6

CC7

ADC_00_DCO_P
ADC_00_DCO_N

ADC_00_DA_P
ADC_00_DA_N
ADC_00_DB_P
ADC_00_DB_N

ISO_CC8
ISO_CC9
ISO_CC10
ISO_CC11

ISO_CC12
ISO_CC13
ISO_CC14
ISO_CC15
ISO_CC16
ISO_CC17

ISO_CC18
ISO_CC19
ISO_CC20
ISO_CC21
ISO_CC22
ISO_CC23

ISO_CC0
ISO_CC1
ISO_CC2
ISO_CC3
ISO_CC4
ISO_CC5

ISO_CC6
ISO_CC7 CC6 CC7

CC8
CC9
CC10
CC11

CC12
CC13
CC14
CC15
CC16
CC17

CC18
CC19
CC20
CC21
CC22
CC23

CC0
CC1
CC2
CC3
CC4
CC5

FPGA_IO_C

BUF_ADC_00_DCO_N

BUF_ADC_00_DA_N
BUF_ADC_00_DB_P
BUF_ADC_00_DB_N

ADC_00_TEST_P

BUF_ADC_01_DB_P

BUF_ADC_01_DCO_P
BUF_ADC_01_DCO_N

BUF_ADC_01_DA_N

BUF_ADC_01_DB_N

ADC_01_TEST_P

Vadc1_amp_ac | Vadc1_amp_ac_P
Vadc2_amp_ac | Vadc2_amp_ac_P Vadc2_amp_ac_N

Vadc1_amp_ac_N

BUF_ADC_00_DCO_P

BUF_ADC_00_DA_P

BUF_ADC_01_DA_P

BUF_ADC_XX_CLK_N

BUF_ADC_XX_CLK_P

BUF_ADC_XX_CNV_P
BUF_ADC_XX_CNV_N

BUF_ADC_XX_CLK_N

BUF_ADC_01_CLK_N | BUF_ADC_XX_CLK_P

BUF_ADC_01_CLK_P

BUF_ADC_00_CLK_N

BUF_ADC_00_CLK_P

BUF_ADC_XX_CNV_N

BUF_ADC_01_CNV_N | BUF_ADC_XX_CNV_P

BUF_ADC_01_CNV_P

BUF_ADC_00_CNV_N

BUF_ADC_00_CNV_P

BUF_OSC_IN_N

BUF_ADC_00_CLK_N

BUF_ADC_00_CLK_P

BUF_ADC_01_CLK_N

BUF_ADC_01_CLK_P

BUF_ADC_01_CNV_P

DWAVE_F22

DWAVE_F21

DWAVE_F23
DWAVE_F31

DWAVE_F33

DWAVE_F32

ADC_XX_TEST_B
ADC_XX_CNV_N

ADC_XX_CNV_P

ADC_XX_CLK_N

ADC_XX_CLK_P

BUF_ADC_01_CNV_N

BUF_ADC_00_CNV_N

BUF_ADC_00_CNV_P

BUF_ADC_01_DB_N

BUF_ADC_01_DCO_P

BUF_ADC_01_DB_P

BUF_ADC_01_DCO_N
BUF_ADC_01_DA_P
BUF_ADC_01_DA_N

BUF_ADC_00_DCO_P
BUF_ADC_00_DCO_N

BUF_ADC_00_DB_P
BUF_ADC_00_DB_N

BUF_ADC_00_DA_N

BUF_ADC_00_DA_P

VREF_DAC

BIAS_SDO

CLR_DAC

B2C_DAC

LOAD_DAC

BIAS_SDI

BIAS_SCLK

BIAS_SYNCn

DAC_BIAS_A

CLR_DAC

LOAD_DAC

B2C_DAC | DAC_BIAS_B
| DAC_BIAS_C
| DAC_BIAS_D

DWAVE_R_OUT1

DWAVE_R_OUT2

F_0

F_90

DWAVE_OUT1
INV_DWAVE_F01

DWAVE_OUT2_F2
DWAVE_OUT2_F3

DWAVE_OUT1_F1
DWAVE_OUT1_F2
DWAVE_OUT1_F3

DWAVE_OUT2

DWAVE_OUT2_F1

SW_GAIN_ADC2_10X

Vadc2_amp_ac

SW_GAIN_ADC2_100X

SW_GAIN_ADC1_10X

Vadc1_amp_ac

SW_GAIN_ADC1_100X

ISO_CD0+
ISO_CD0-
ISO_CD1+
ISO_CD1-
ISO_CD2+
ISO_CD2-
ISO_CD3+
ISO_CD3-

PORT_DWAVE_OUT2

PORT_DWAVE_OUT1

Vadc2_ac

Vadc1_ac

ADC_XX_TEST_B

ADC_01_TEST_P

ADC_00_TEST_P

JTAG_TCK

JTAG_TDO

JTAG_TMS

JTAG_TDI

JTAG_TCK

CC9

CC8

CC12

CC10

CC11

FPGA_IO_A

FPGA_IO_B

LAN_SCLK
LAN_SSNn

LAN_MOSI

LAN_INTn | LAN_MISO LAN_RSTn

BUF_OSC_IN_N

BUF_OSC_IN_P

BUF_OSC_IN_P

+15VDIN_EX

GND_15VDIN_EX

SPO_TEST_EN

SPO_TEST_CDAT

PWR_AMP_ON
PWR_ANAL_ON

USER_LED_ST7

SPO_TEST_EN

SPO_TEST_CDAT

USER_LED_ST0
USER_LED_ST1
USER_LED_ST2
USER_LED_ST3
USER_LED_ST4
USER_LED_ST5
USER_LED_ST6

SPO_TEST_EN

SPO_TEST_CDAT

SW_GAIN_ADC1_10X
SW_GAIN_ADC1_100X

SW_GAIN_ADC2_10X
SW_GAIN_ADC2_100X

SPO_TEST_EN

SPO_TEST_CDAT

USER_LED_ST0

USER_LED_ST6

USER_LED_ST2

USER_LED_ST4

Vsq_filter_in | Vsq_BW12M

Vs_out
Vs_stage1_out

DWAVE_R_OUT2_P

Vsq_filter_in

Vs_filter_in | Vs_BW12M

DWAVE_R_OUT1_P

Vs_filter_in

Vsq_out

Vs_out

DWAVE_R_OUT2

+15V_AMP_GATED_CON

-15V_AMP_GATED_CON

PWR_AMP_ON

+15V_AMP_GATED_CON
-15V_AMP_GATED_CON

DWAVE_F03

DWAVE_F11

INV_DWAVE_F03

INV_DWAVE_F11

INV_DWAVE_F12 | DWAVE_F12

INV_DWAVE_F13

DWAVE_F01

DWAVE_F02

INV_DWAVE_F01

INV_DWAVE_F02

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
INV_DWAVE_F02

INV_DWAVE_F03

INV_DWAVE_F11

INV_DWAVE_F12

INV_DWAVE_F13

INV_DWAVE_F22

INV_DWAVE_F23

INV_DWAVE_F31

INV_DWAVE_F32

INV_DWAVE_F33

DWAVE_F23

DWAVE_F31

INV_DWAVE_F23

INV_DWAVE_F31

INV_DWAVE_F32 | DWAVE_F32

INV_DWAVE_F33

DWAVE_F21

DWAVE_F22

INV_DWAVE_F21

INV_DWAVE_F22

DWAVE_R_OUT3

DWAVE_R_OUT4

DWAVE_OUT3
INV_DWAVE_F21

DWAVE_OUT4_F2
DWAVE_OUT4_F3

DWAVE_OUT3_F1
DWAVE_OUT3_F2
DWAVE_OUT3_F3

DWAVE_OUT4

DWAVE_OUT4_F1

PORT_DWAVE_OUT4

PORT_DWAVE_OUT3

DWAVE_OUT4

DWAVE_OUT3

Vsq_out
Vsq_stage1_out

Vsq_BW12M

Vs_BW12M

PWR_ANAL_ON

ADC_01_DB_P

ADC_01_DCO_N

ADC_01_DB_N

ADC_01_DCO_P

ADC_01_DA_N

ADC_01_DA_P

OSC_IN_P

OSC_IN_N

ADC_00_DCO_P

ADC_00_DCO_N

ADC_00_DB_P

ADC_00_DB_N

ADC_00_DA_N

ADC_00_DA_P

ADC_XX_CNV_P

ADC_XX_CNV_N

ADC_XX_CLK_P

ADC_XX_CLK_N

ISO_CC7

ISO_CC6

ISO_CC5

ISO_CC4

ISO_CC3

ISO_CC2

ISO_CC1

ISO_CC0

PORT_VSQ_OUT

PORT_VS_OUT

DAC_BIAS_D

DAC_BIAS_C

PORT_VSQ_OUT | PORT_VS_OUT

DAC_BIAS_D

DAC_BIAS_C

PORT_DWAVE_OUT2 | PORT_DWAVE_OUT1

DAC_BIAS_B

DAC_BIAS_A

PORT_DWAVE_OUT4 | PORT_DWAVE_OUT3

DWAVE_R_OUT1_N

FPGA_IO_D

F_90DWAVE_OUT2

F_0DWAVE_OUT1

DWAVE_R_OUT1

DWAVE_R_OUT2_N

INV_DWAVE_F01_GR5 | DWAVE_F01_GR1
INV_DWAVE_F02_GR5 | DWAVE_F02_GR1
INV_DWAVE_F03_GR5 | DWAVE_F03_GR1
INV_DWAVE_F11_GR6 | DWAVE_F11_GR2
INV_DWAVE_F12_GR6 | DWAVE_F12_GR2

DWAVE_F13

INV_DWAVE_F13_GR6 | DWAVE_F13_GR2

DWAVE_F33

DWAVE_F33_GR4

DWAVE_F32_GR4

INV_DWAVE_F31_GR8 | DWAVE_F31_GR4

INV_DWAVE_F32_GR8

INV_DWAVE_F33_GR8

DWAVE_F23_GR3

DWAVE_F22_GR3

INV_DWAVE_F21_GR7 | DWAVE_F21_GR3

INV_DWAVE_F22_GR7

INV_DWAVE_F23_GR7

DGND

AGND

DGND

AGND

DGND

AGND

DGND

AGND

GND_FPGA

GND_FPGA

MC2_VCCO

GND_FPGA

GND_FPGA

GND_FPGA

MC1_VCCO

GND_FPGA

MC2_P3V3

MC1_P3V3

GND_FPGA

GND_FPGA

+3.3V_ISO | +3.3V_D

DGND

GND_FPGA

+3.3V_ISO

DGND

+3.3V_D

GND_FPGA

+3.3V_ISO

DGND

+3.3V_D

GND_FPGA

+3.3V_ISO

DGND

+3.3V_D

GND_FPGA

+6V_ANAL

+15V_ANAL

GND_ANAL

MC1_VDCIN_P5V

AGND

+15V_FPGA

GND_FPGA

AGND

+15V_ANAL

GND_ANAL

+15VAIN

AGND

-15VAIN

+15V_AMP

GND_AMP

-15V_AMP

+15V_AMP_GATED

GND_AMP

-15V_AMP_GATED

+13.5V_AMP

-13.5V_AMP

+6V_ANAL

+5V_ANAL

+2.5V_ANAL

GND_ANAL

GND_ANAL

GND_ANAL

GND_ANAL

+6V_ANAL_DAMP

+6V_ANAL_DAMP | +2.5V_ANAL_AUX

CGND

CGND

DGND | CGND
AGND | CGND

GND_AMP

GND_AMP | GND_ANAL

GND_AMP

GND_AMP | GND_ANAL

+5V_ANAL

GND_ANAL

+6V_ANAL_DAMP | +3.3V_ANAL0

GND_ANAL

+2.5V_ANAL

+5V_ANAL

GND_ANAL

+3.3V_ANAL2 | GND_FPGA

+2.5V_ANAL_AUX

GND_ANAL

+2.5V_ANAL_AUX

GND_ANAL

GND_FPGA
GND_ANAL

+3.3V_ANAL1

GND_FPGA
GND_ANAL

+3.3V_ANAL0

BIAS_P3V3

+13.5V_AMP

GND_AMP

GND_FPGA | GND_AMP

BIAS_P3V3

GND_FPGA

GND_AMP

-13.5V_AMP

+13.5V_AMP

GND_AMP | GND_FPGA

GND_AMP

GND_AMP

GND_AMP

GND_AMP

GND_AMP

-13.5V_ADC_BUF

+13.5V_ADC_BUF

GND_AMP

-13.5V_ADC_BUF

+13.5V_ADC_BUF

GND_AMP

-13.5V_AMP

+13.5V_AMP

+13.5V_ADC_BUF

-13.5V_ADC_BUF

TEMP_P3V3

GND_AMP

GND_AMP

GND_AMP

GND_AMP

+2.5V_ANAL_AUX

GND_ANAL

GND_FPGA

GND_FPGA

LAN_P3V3

GND_FPGA

JTAG_PWR

GND_FPGA | GND_FPGA GND_FPGA

DISP_P3V3

GND_FPGA

GND_FPGA

TEMP_P3V3

GND_FPGA

MEM_P3V3

+15V_FPGA

GND_FPGA

+5V_FPGA_CORE

+5V_FPGA_IO

+3.3V_FPGA_IO

+3.3V_ISO

+3.3V_EXT

DGND

+3.3V_D | +5VDIN +5V_D_REG
+15V_ANAL | +15VDIN

GND_ANAL

+2.
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
