lastoyz/dsn_pgu_adda_s3100_git/txem7310_pll/_ref/s3100_cpu_base_v100_20210319.pdf

# Designed By: YKSeol

# 검정색 TEXT : 회로도 설명

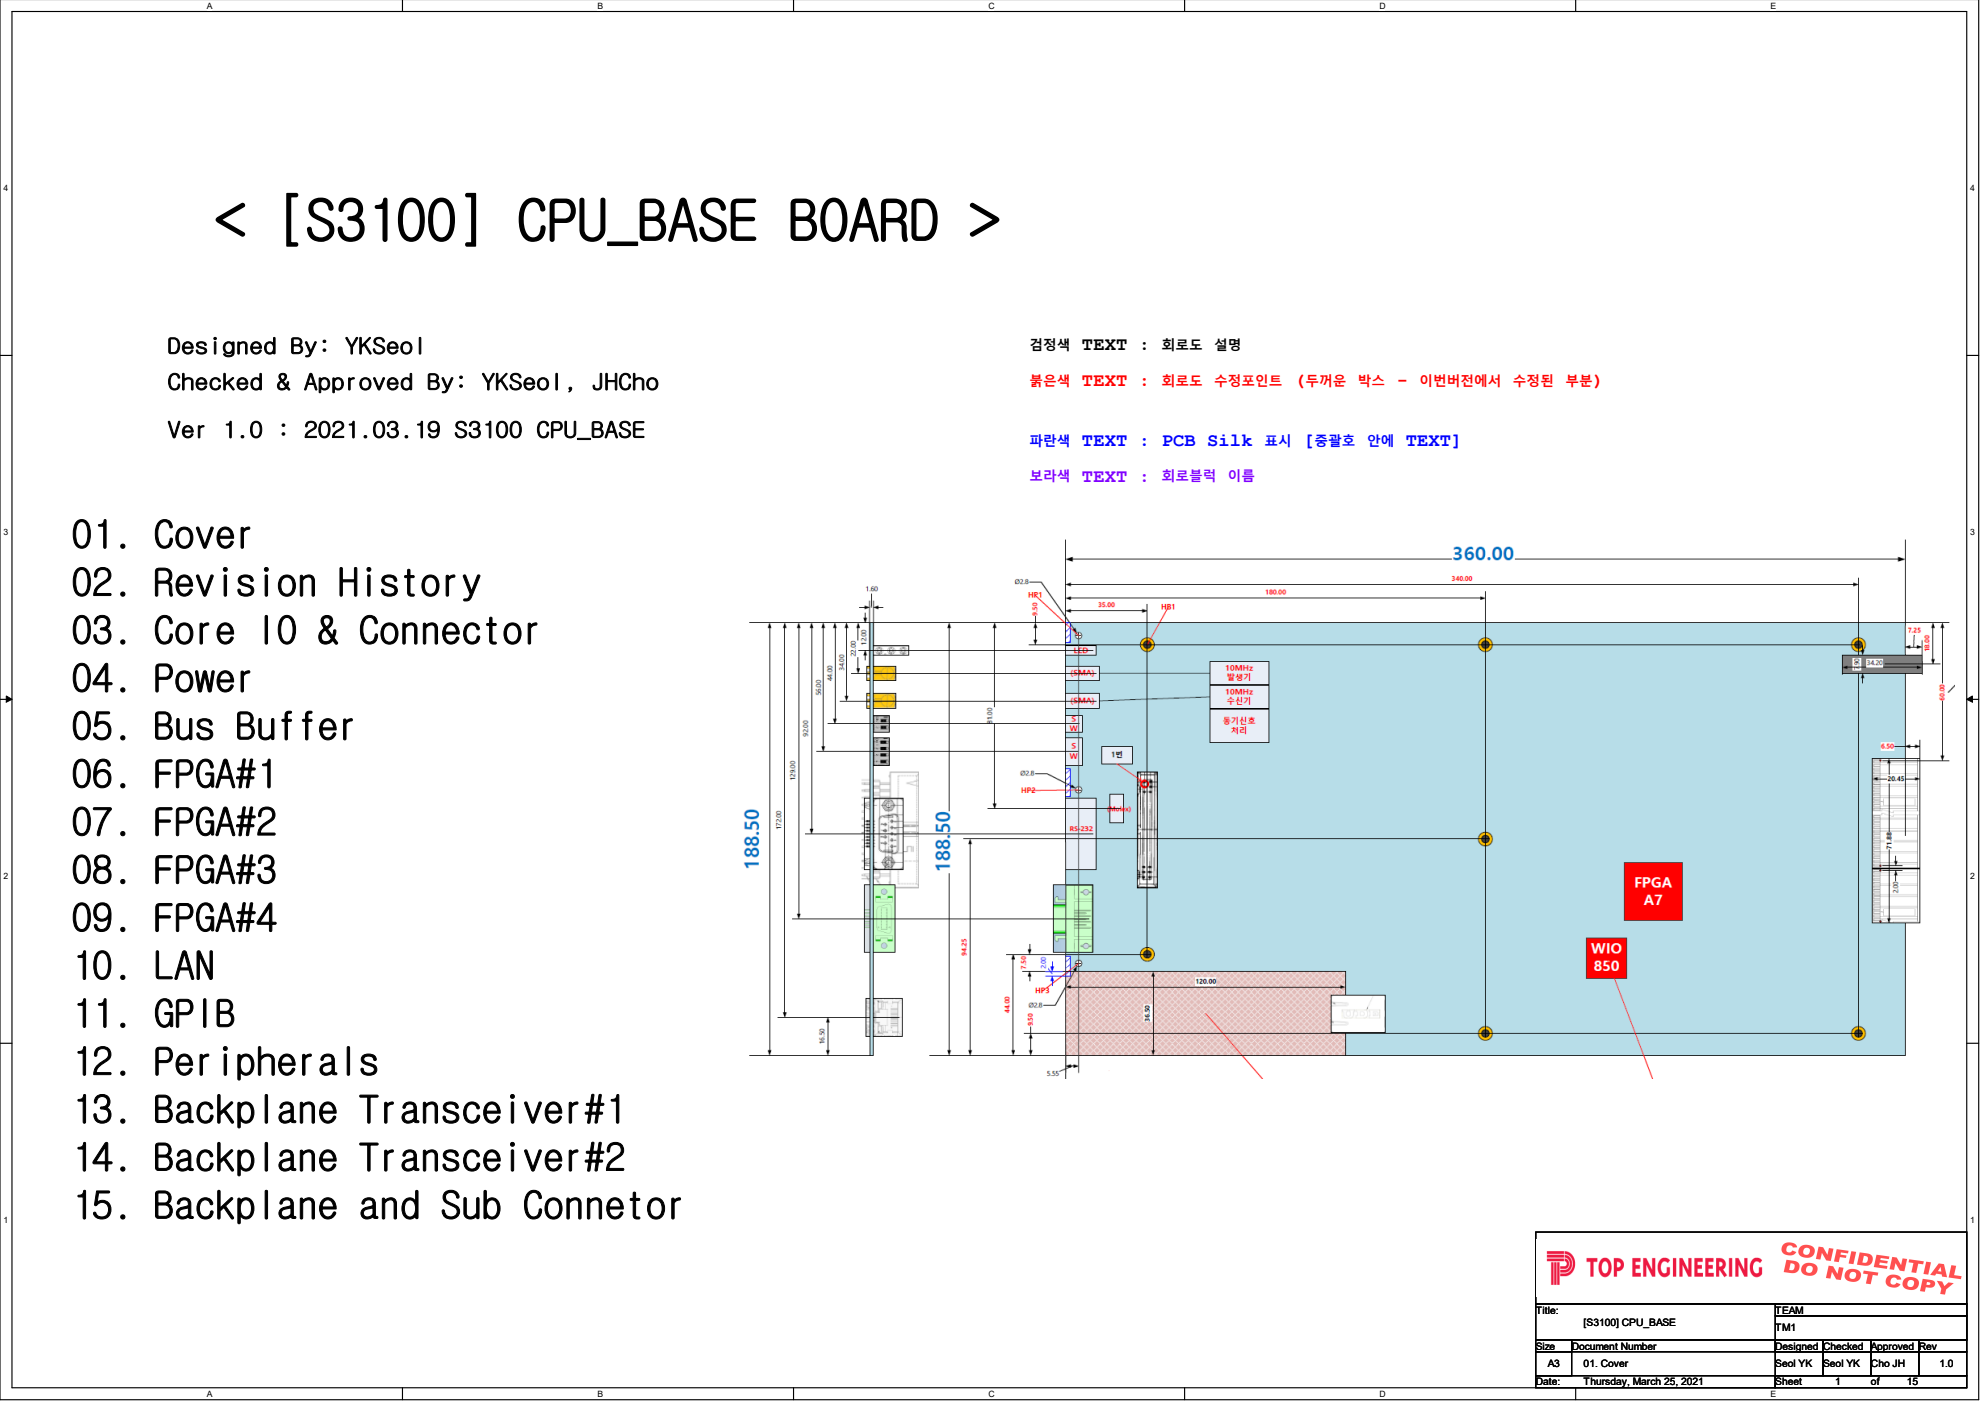
[picture p26: page 1]
< [S3100] CPU_BASE BOARD >; Ver 1.0 : 2021.03.19 S3100 CPU_BASE; Title:; Size; Document Number; Rev; Date:; Sheet; TEAM; 01. Cover; [S3100] CPU_BASE; Seol YK Seol YK Cho JH; Thursday, March 25, 2021

Checked & Approved By: YKSeol, JHCho

붉은색 TEXT : 회로도 수정포인트 (두꺼운 박스 - 이번버전에서 수정된 부분)

파란색 TEXT : PCB Silk 표시 [중괄호 안에 TEXT]

보라색 TEXT : 회로블럭 이름

01. Cover
02. Revision History
03. Core IO & Connector
04. Power
05. Bus Buffer
06. FPGA#1
07. FPGA#2
08. FPGA#3
09. FPGA#4
10. LAN
11. GPIB
12. Peripherals
13. Backplane Transceiver#1
14. Backplane Transceiver#2
15. Backplane and Sub Connetor

Designed Checked Approved

# <Revision History >

# Date Version

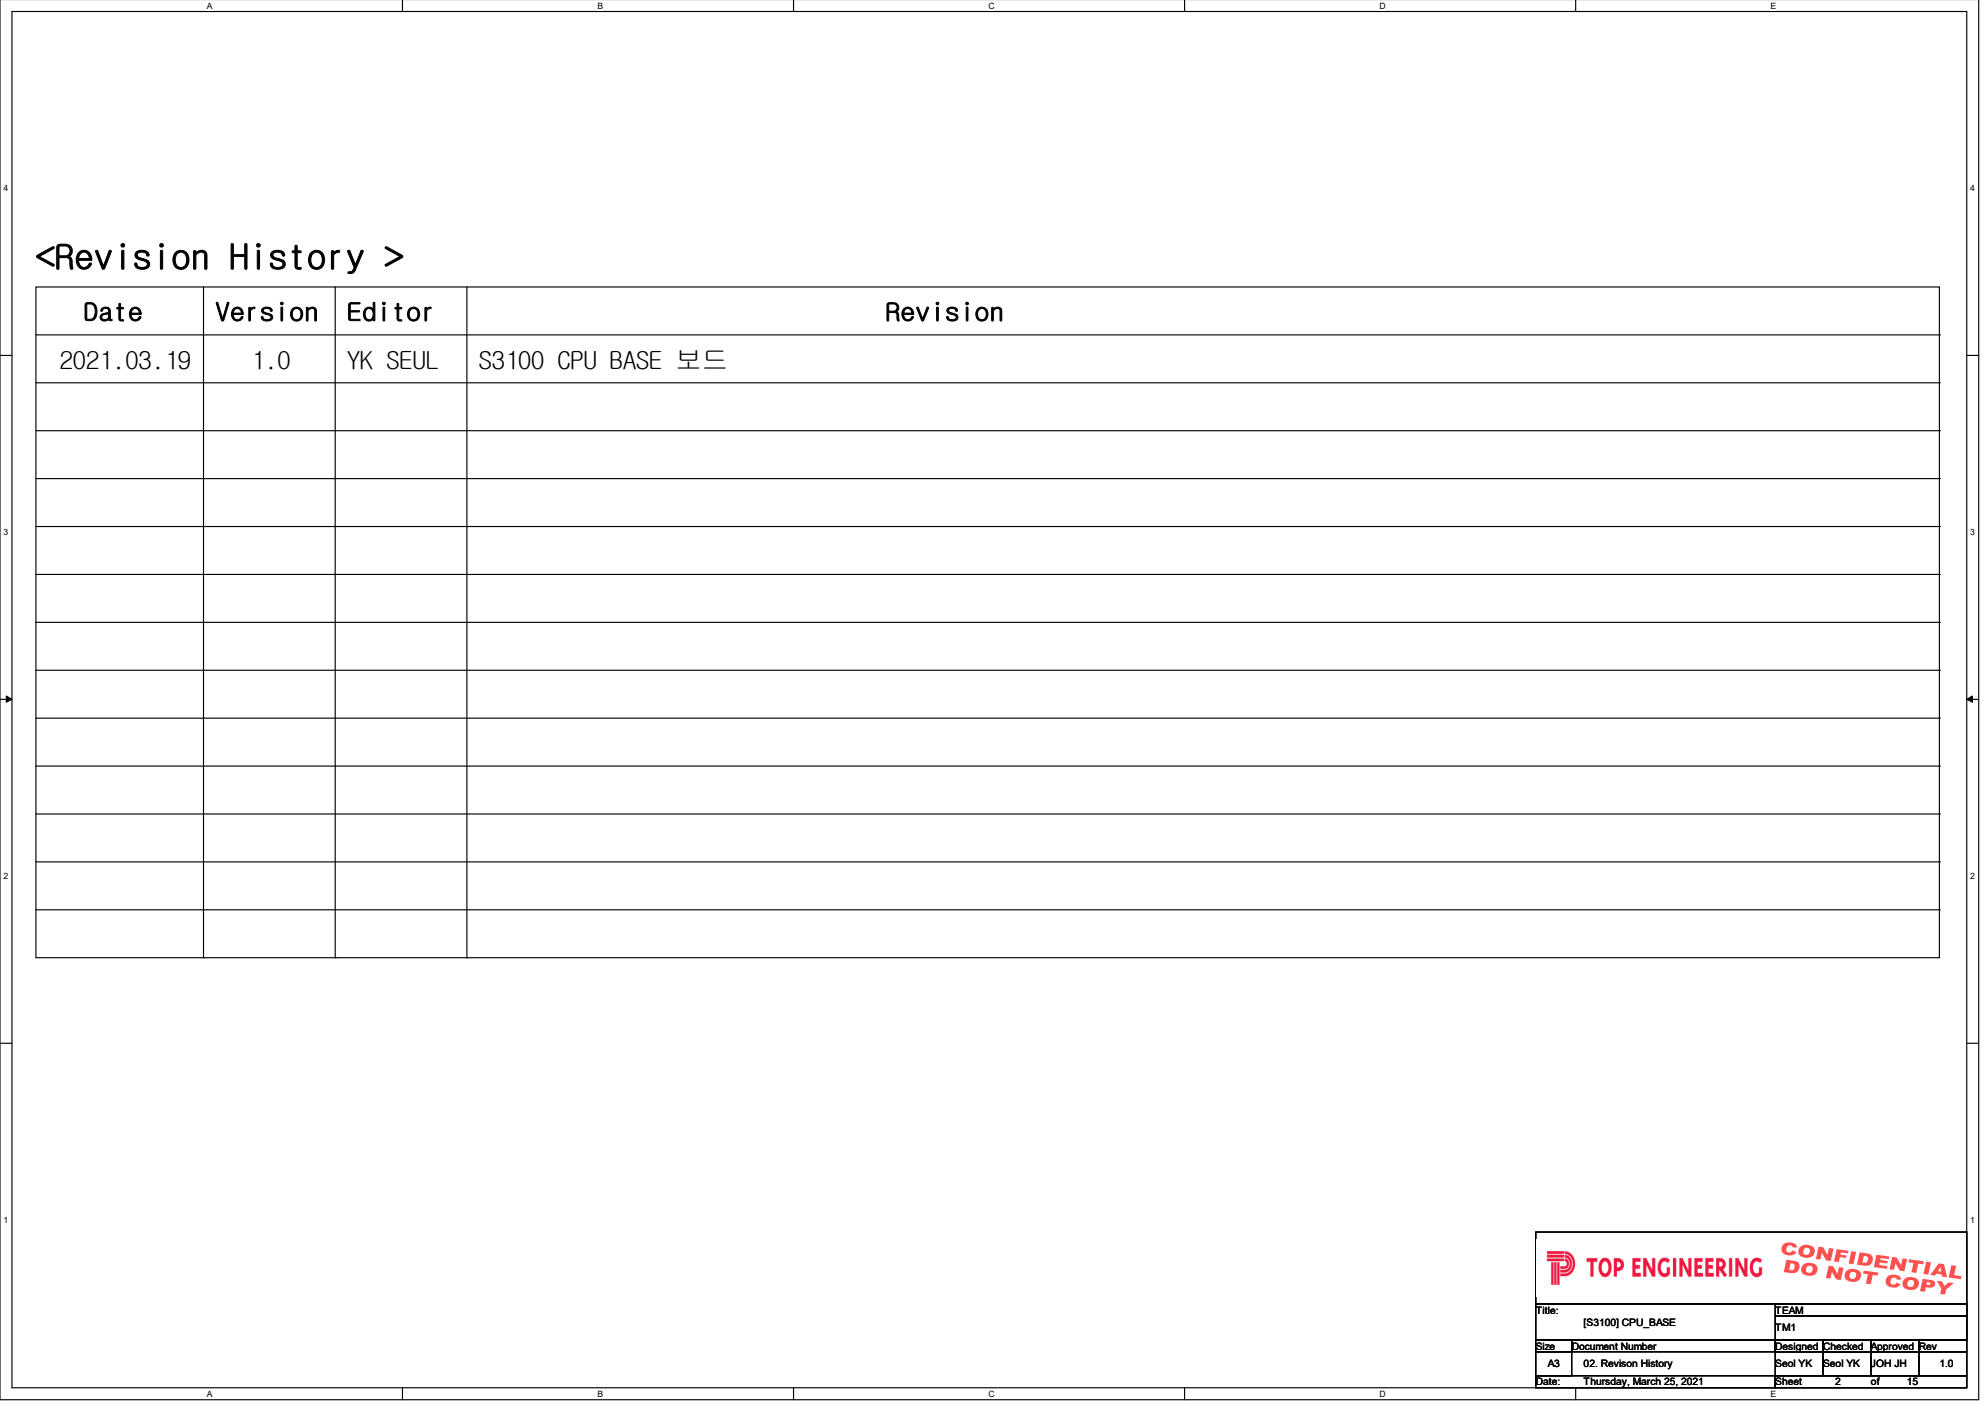
[picture p27: page 2]
S3100 CPU BASE 보드; Revision; Editor; YK SEUL; 02. Revison History; Seol YK Seol YK JOH JH; Thursday, March 25, 2021

# CORE BD (Cortex-M7) CONNECTOR

# 전면판 고정 홀

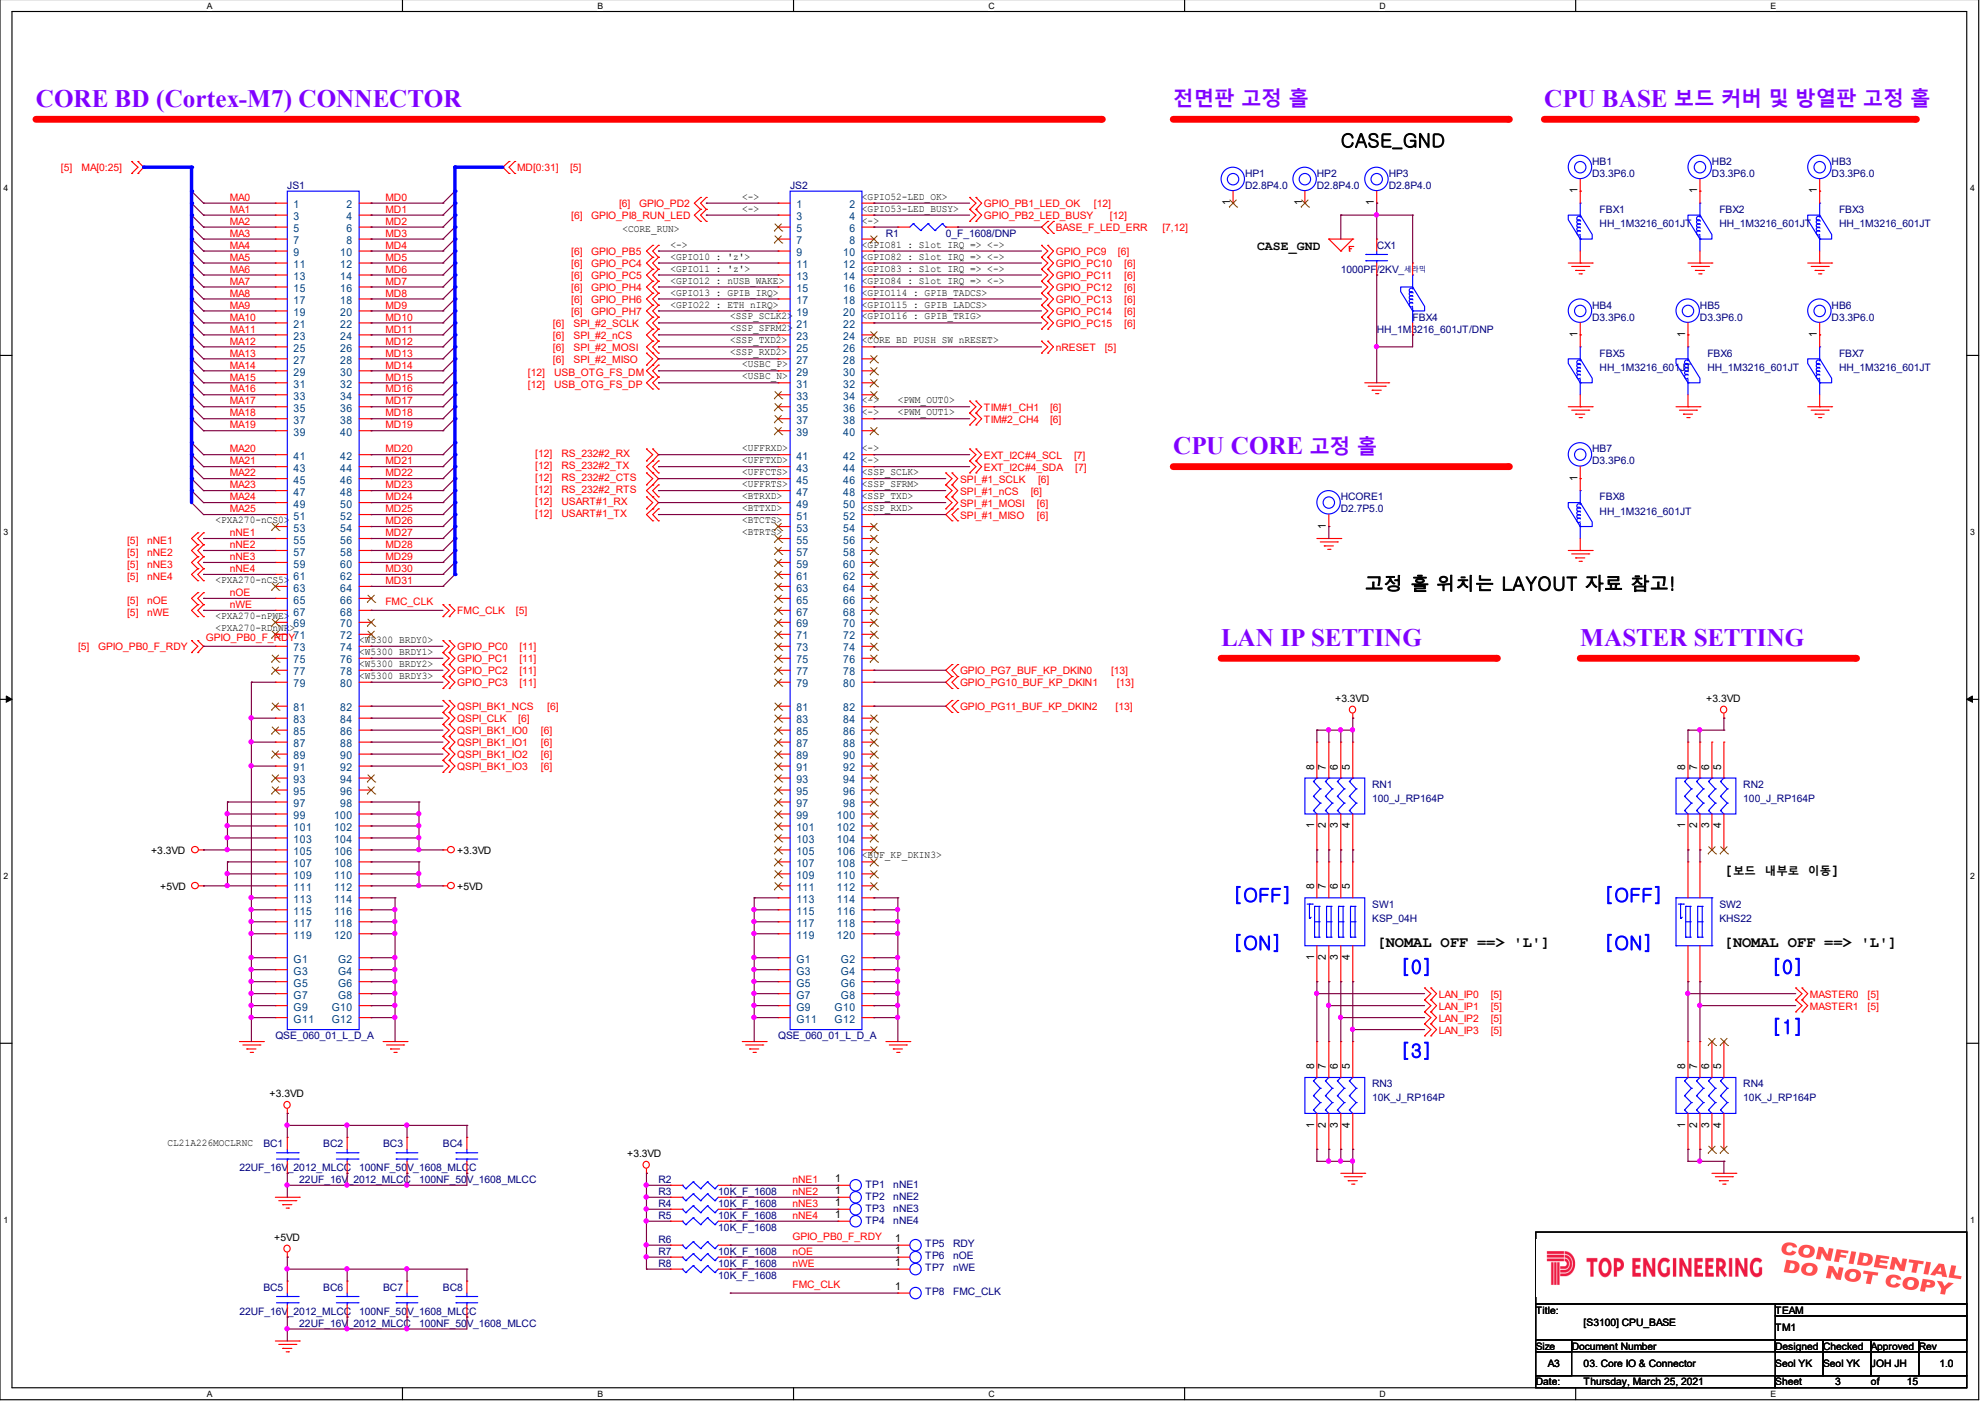
[picture p28: page 3]

CPU BASE 보드 커버 및 방열판 고정 홀

<CORE BD PUSH SW nRESET>

고정 홀 위치는 LAYOUT 자료 참고!

# REGURATOR

[+15V]

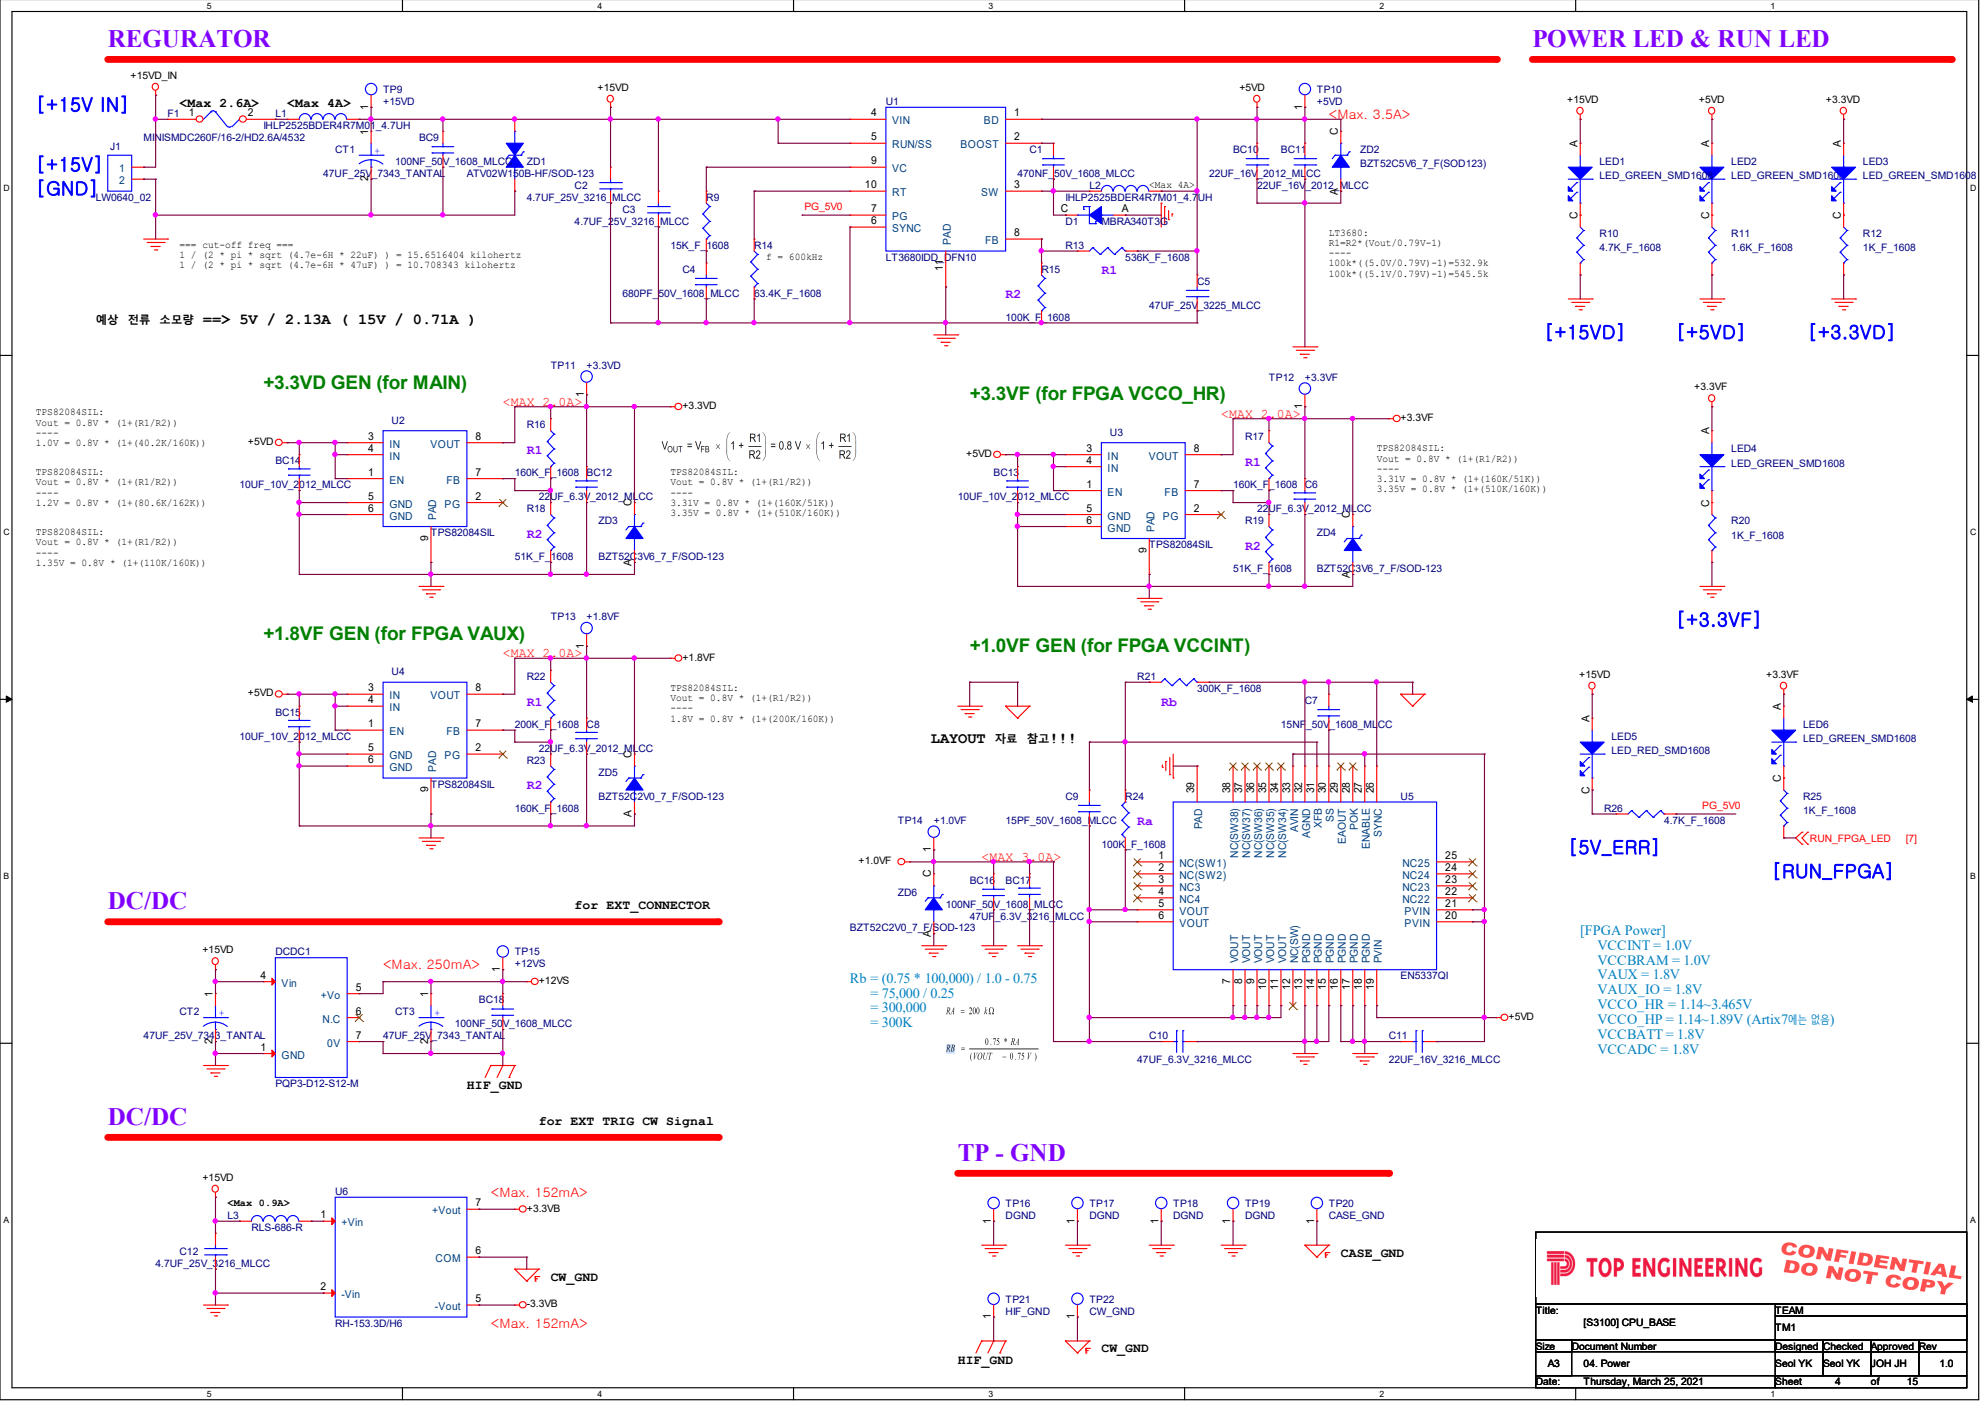
[picture p29: page 4]

POWER LED & RUN LED

+1.8VF GEN (for FPGA VAUX)

+1.0VF GEN (for FPGA VCCINT)

AGND 32 AVIN 33 NC(SW34) 34 NC(SW35) 35 NC(SW36) 36 NC(SW37) 37 NC(SW38) 38

# CORE to BASE BD

# BUFFER

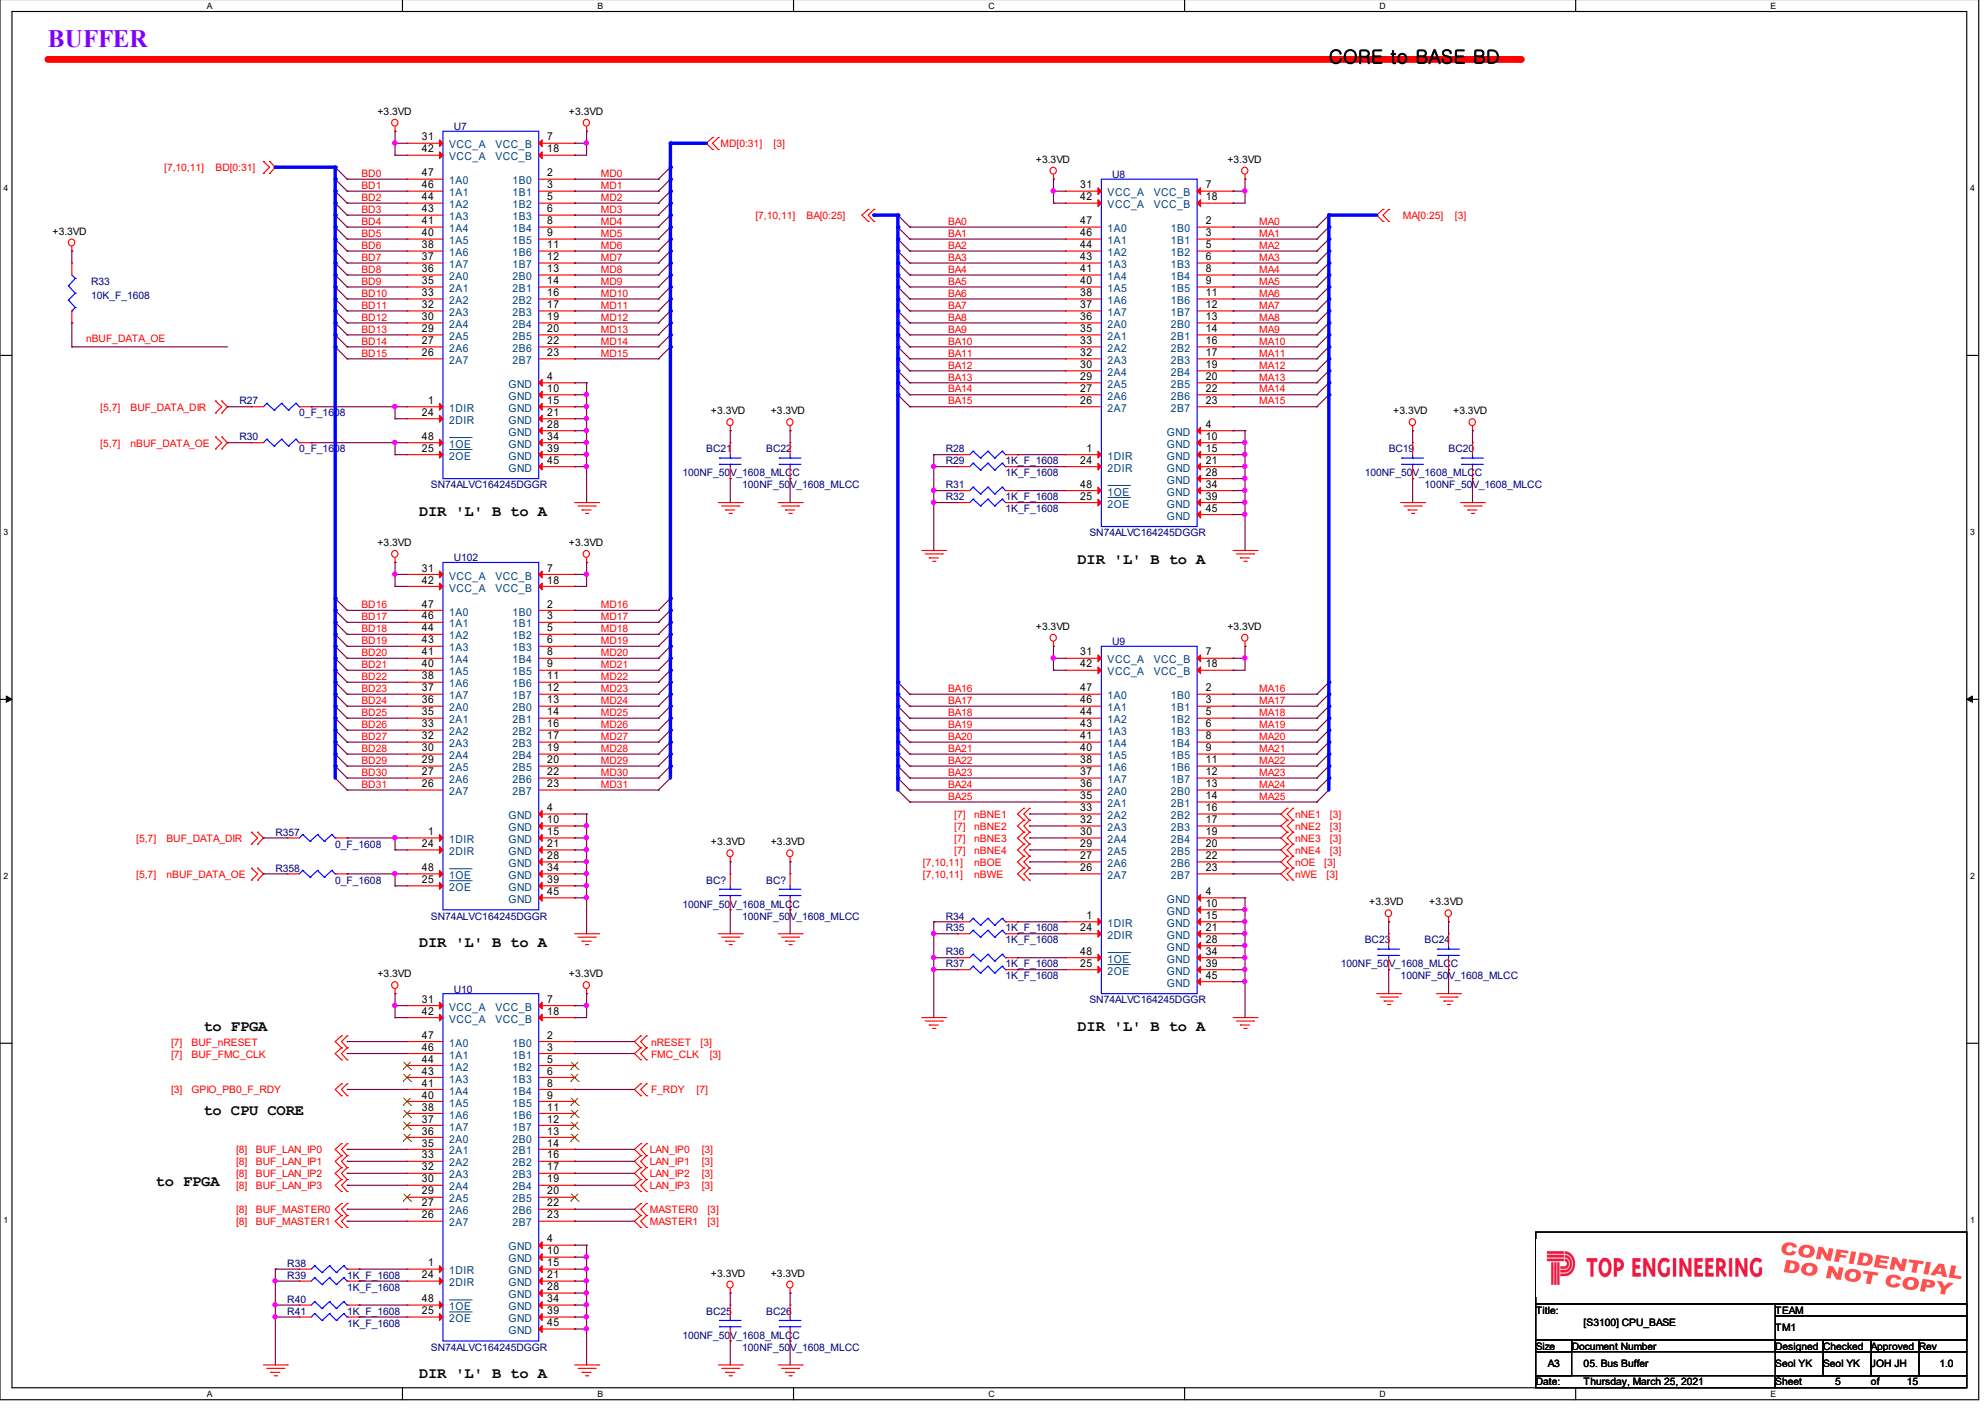
[picture p30: page 5]

FPGA - BANK 13 | FPGA - BANK 14

## BANK 14 : FPGA CONFIG & LED & GPIO

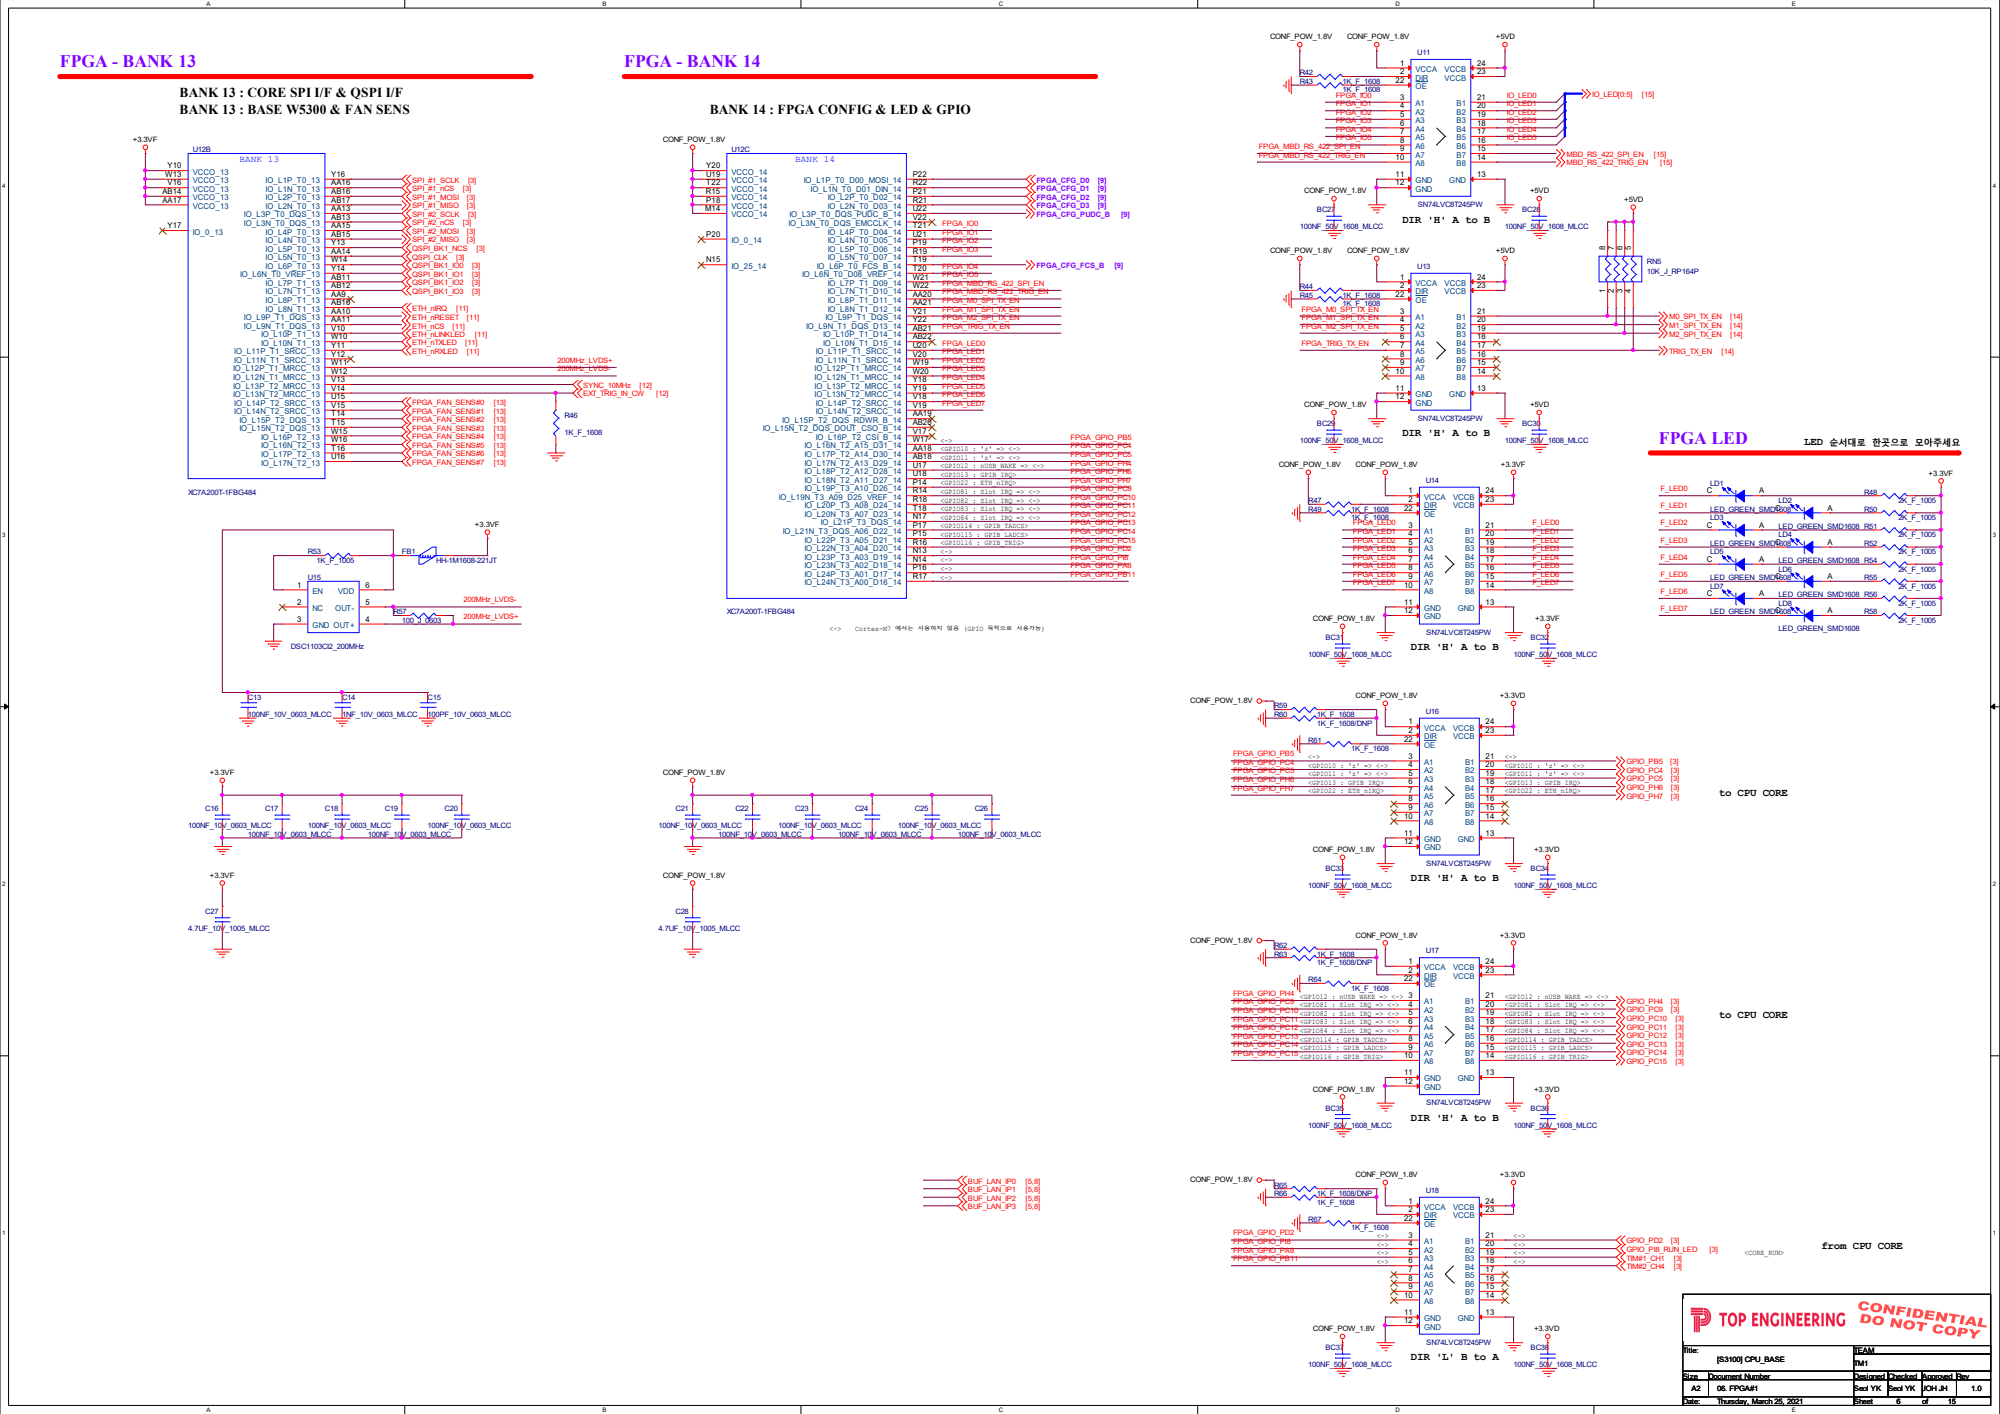
[picture p31: page 6]

BANK 13 : CORE SPI I/F & QSPI I/F
BANK 13 : BASE W5300 & FAN SENS

FPGA - BANK 15 | FPGA - BANK 16

## BANK 15 : TP & LAN MODULE CONTROL

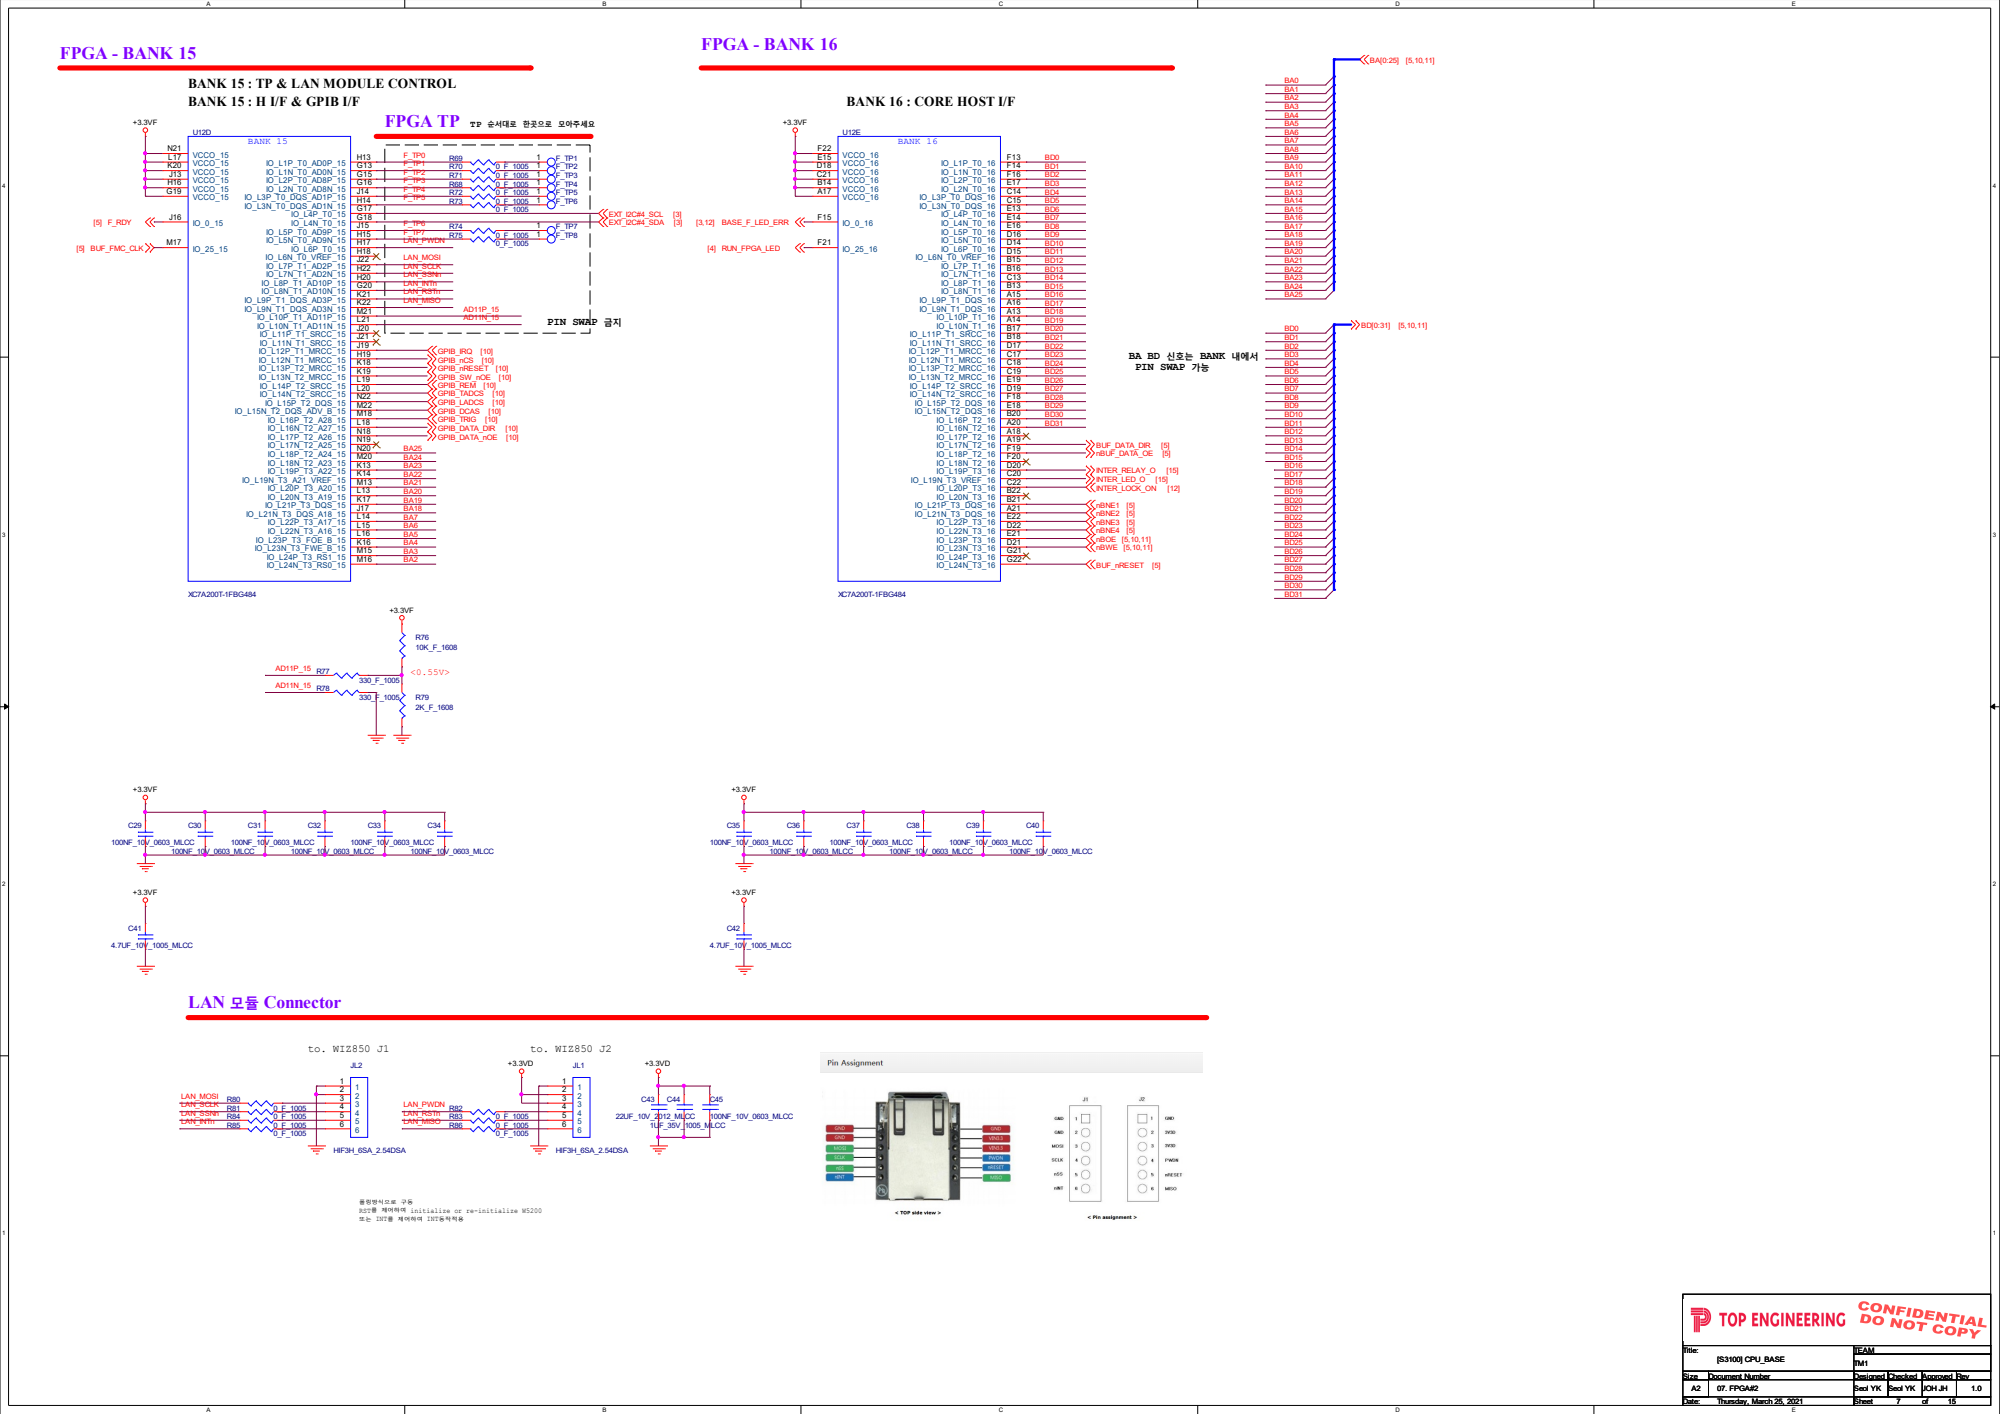
[picture p32: page 7]

FPGA TP TP 순서대로 한곳으로 모아주세요

BA BD 신호는 BANK 내에서
PIN SWAP 가능

폴링방식으로 구동
RST를 제어하여 initialize or re-initialize W5200
또는 INT를 제어하여 INT동작적용

FPGA - BANK 34 | FPGA - BANK 35 | FPGA - BANK 216
BANK 34 : OUT M1 SPI | BANK 35 : OUT M2 SPI | BANK 216 : MGT (NOT USED)

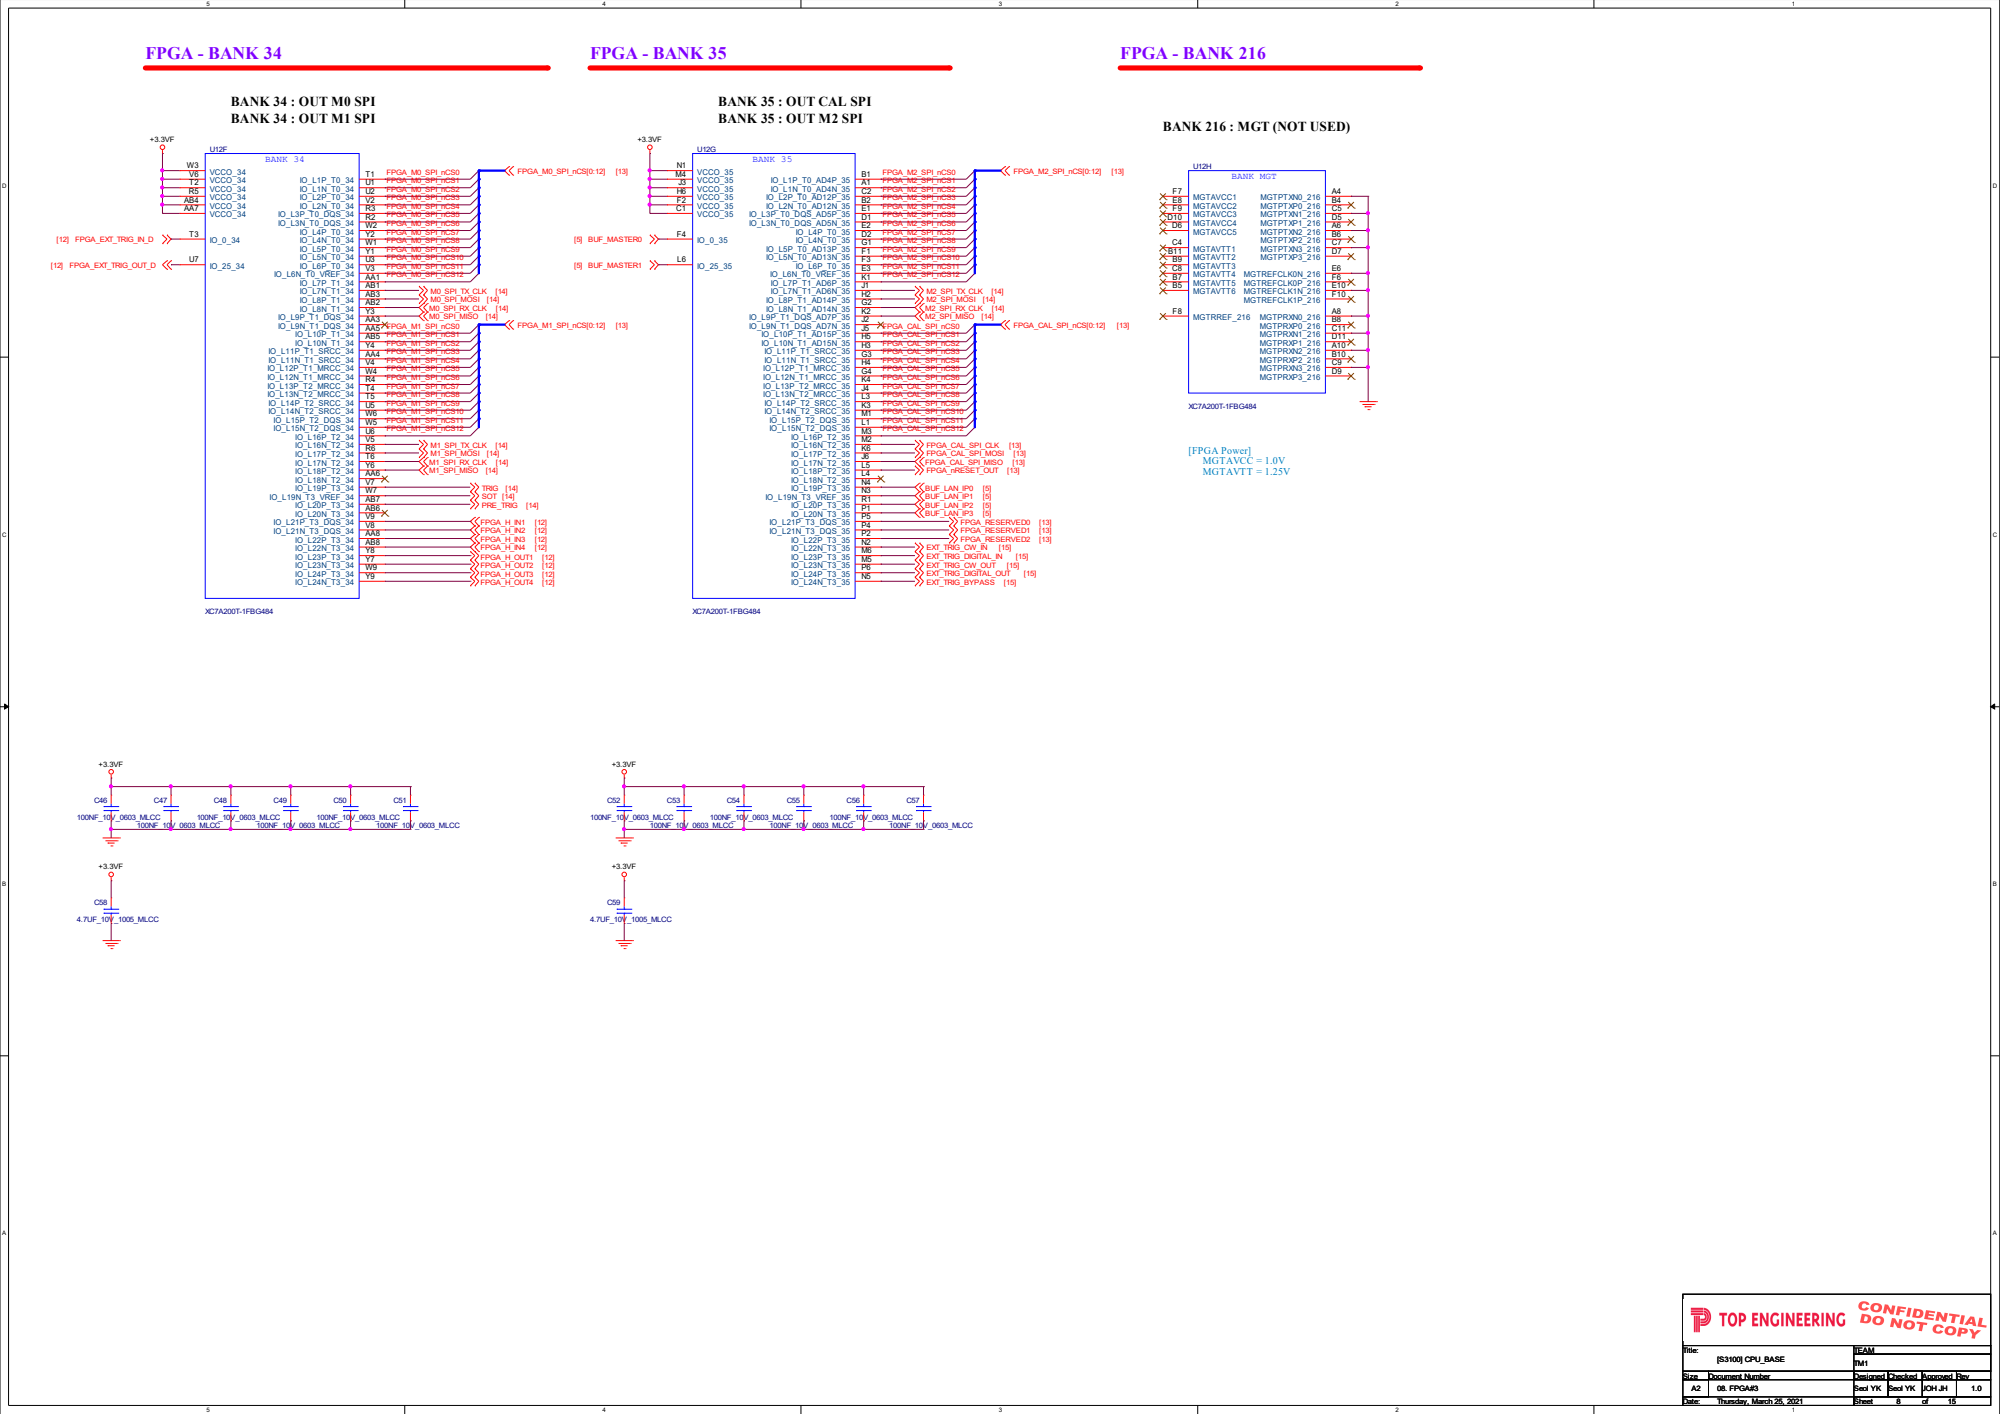
[picture p33: page 8]

D | D
C | C
B | B
A | A

Initialization (bar)
Active-Low FPGA initialization pin or configuration error signal. The FPGA drives this pin Low when the FPGA is in a configuration reset state, when the FPGA is initializing (clearing) its configuration memory, or when the FPGA has detected a configuration error. Upon completing the FPGA initialization process, INIT_B is released to high-Z at which time an external resistor is expected to pull INIT_B High. INIT_B can externally be held Low during power-up to stall the power-on configuration sequence at the end of the initialization process. When a High is detected at the INIT_B input after the initialization process, the FPGA proceeds with the remainder of the configuration sequence dictated by the M[2:0] pin settings.
Connect INIT_B to a ≤ 4.7 kΩ pull-up resistor to VCCO_0 to ensure clean Low-to-High transitions.

# [JTAG]

Done
A High signal on the DONE pin indicates completion of the configuration sequence. The DONE output is an open-drain output by default.

Program (bar)
Active-Low reset to configuration logic. When PROGRAM_B is pulsed Low, the FPGA configuration is cleared and a new configuration sequence is initiated. Configuration reset initiated upon falling edge, and configuration (i.e. programming) sequence begins upon the following rising edge.
Connect PROGRAM_B to an external ≤ 4.7 kΩ pull-up resistor to VCCO_0 to ensure a stable High input, and recommend push-button to GND to enable manual configuration reset.

# [FPGA Power] VCCINT = -0.5~1.1 [1.0V] VCCBRAM = -0.5~1.1 [1.0V] VCCAUX = -0.5 ~ 2.0V [1.8V] VCCAUX_IO = -0.5 ~ 2.0V [1.8V] VCCO_HR = 1.14~3.465V VCCO_HP = 1.14~1.89V (Artix7에는 없음) VCCBATT = -0.5 ~ 2.0V [1.8V] VCCADC = -0.5 ~ 2.0V [1.8V]

# [FPGA Power] VCCADC = -0.5 ~ 2.0V [1.8V] VREF = -0.5 ~ 2.0V [1.25V] to GNDADC

# FPGA - POWER

## MT25QL = 2.7V ~ 3.6V MT25QU = 1.7V ~ 2.0V

# [FPGA Power] VCCINT = -0.5~1.1 [1.0V] VCCBRAM = -0.5~1.1 [1.0V] VCCAUX = -0.5 ~ 2.0V [1.8V] VCCAUX_IO = -0.5 ~ 2.0V [1.8V] VCCO_HR = 1.14~3.465V VCCO_HP = 1.14~1.89V (Artix7에는 없음) VCCBATT = -0.5 ~ 2.0V [1.8V]

Pull-Up During Configuration (bar)
Active-Low PUDC_B input enables internal pull-up resistors on the SelectIO pins after power-up and during configuration.
> When PUDC_B is Low, internal pull-up resistors are enabled on each SelectIO pin.
> When PUDC_B is High, internal pull-up resistors are disabled on each SelectIO pin.
PUDC_B must be tied either directly, or via a ≤ 1kΩ to VCCO_14 or GND.
Caution! Do not allow this pin to float before and during configuration

If the TCK signal is
buffered, connect the buffer input to an external weak (e.g. 10 kΩ) pull-up resistor to maintain a valid High when no cable is connected.

If the TMS signal is buffered, connect the buffer
input to an external weak (e.g. 10 kΩ) pull-up resistor to maintain a valid High when no cable is connected.

VCCBATT is required only when using bitstream encryption. If battery is not used, connect VCCBATT
to either ground or VCCAUX.

If the VCCO_0 supply for bank 0 is
supplied with 2.5V or 3.3V, then the CFGBVS pin must
be tied High (i.e. connected to VCCO_0). Tie CFGBVS to Low (i.e. connected to GND), only if the VCCO_0 for bank 0 is less than or equal to 1.8V. If used during configuration, banks 14 and 15 should match the VCCO level applied to bank 0

Configuration Mode Sel (M2:0)
- Master SPI: 001
- Master Serial: 000
- JTAG: 101

## <MAX 1.0A>

## S25FL256SAGNFI001

## S25FL128SAGNFI001

## MT25QU256ABA1EW9_0SIT

Temperature-sensing diode pins (Anode: DXP; Cathode:
DXN). The thermal diode is accessed by using the DXP and DXN pins in bank 0. When not used, tie to GND.

# FPGA - Configuration Part

## VCC_ADC

+1.0VF | +1.8VF | +1.0VF

+1.0VF

+1.0VF

+1.8VF

+1.8VF

## VCC_ADC

+1.0VF

## VCC_ADC

+1.8VF | CONF_POW_1.8V

## CONF_POW_1.8V

## CONF_POW_1.8V

CONF_POW_1.8V | CONF_POW_1.8V

## CONF_POW_1.8V

## CONF_POW_1.8V

## CONF_POW_1.8V

## CONF_POW_1.8V

+1.8VF

+1.0VF

+3.3VF

## [6] FPGA_CFG_PUDC_B

## [6] FPGA_CFG_D1

## FPGA_CFG_D0 [6]

## [6] FPGA_CFG_FCS_B FPGA_CFG_D2 [6]

## [6] FPGA_CFG_D3

09. FPGA#4 | 1.0
Thursday, March 25, 2021 | 9 | 15
09. FPGA#4 | 1.0
Thursday, March 25, 2021 | 9 | 15
09. FPGA#4 | 1.0
Thursday, March 25, 2021 | 9 | 15

R114

## 1K_F_1005

R102

## 2.4K_F_1005

C91

## 100NF_10V_0603_MLCC

C70

## 100NF_10V_0603_MLCC

R91

## 1K_F_1005

C66

## 100NF_10V_0603_MLCC

R111

## 1K_F_1005

C68

## 100NF_50V_1005_MLCC

C78

## 100NF_10V_0603_MLCC

C90

## 100NF_10V_0603_MLCC

C69

## 100NF_50V_1005_MLCC

R109

## 1K_F_1005

C77

## 100NF_10V_0603_MLCC

R96

## 0_F_1005

R126

## 100_F_1005/DNP

C65

## 470NF_6.3V_0603_MLCC

R106

## 4.7K_F_1005

C95

## 4.7UF_10V_1005_MLCC

R89

## 0_F_1005

FB3

## HH-1M1608-221JT

C81

## 100NF_10V_0603_MLCC

U20

## MT25QU128ABA1EW9_0SIT

## VCC 8

DQ0 5

S# 1

W/VPP/DQ2 | 3
C | 6

DQ1 2

VSS | 4
HOLD/DQ3 7 | EPAD

9

R121

## 1K_F_1608

C73

## 100NF_10V_0603_MLCC

R107

## 1K_F_1005

## JTAG

J2

87831-1420

## GND 1

| CONF_POW | 2

## GND 3

| JTAG_TMS | 4

## GND 5

| JTAG_TCK | 6

## GND 7

| JTAG_TDO | 8

## GND 9

| JTAG_TDI | 10
GND 11 | N.C12 | 12
GND 13 | N.C14 | 14

C92

## 22UF_6.3V_1608_MLCC

TP23
+0.275V

1

C63

## 1UF_35V_1005_MLCC

C71

## 100NF_10V_0603_MLCC

R97

## 10K_F_1005

C88

## 100NF_10V_0603_MLCC

C84

## 100NF_10V_0603_MLCC

C93

## 4.7UF_10V_1005_MLCC

R118

## 51_F_1608

C85

## 100NF_10V_0603_MLCC

C61

## 10NF_6.3V_0603_MLCC

R93

## 10K_F_1005

R115

## 51_F_1608

R88

## 0_F_1005

R113

## 1K_F_1005/DNP

C80

## 100NF_10V_0603_MLCC

C89

## 100NF_10V_0603_MLCC

C75

## 100NF_10V_0603_MLCC

R100

## 1K_F_1005

## XC7A200T-1FBG484

U12J

## VCCINT T8 VCCINT T10 VCCINT R9 VCCINT R7 VCCINT P10 VCCINT P8 VCCINT N7 VCCINT M8 VCCINT K8 VCCINT L7 VCCINT J9 VCCINT J7 VCCINT H8 VCCINT H10

VCCAUX | R11
VCCAUX | P12
VCCAUX | M12
VCCAUX | K12
VCCAUX | H12
VCCBRAM | N11
VCCBRAM | L11
VCCBRAM | J11

C60

## 10NF_6.3V_0603_MLCC

R112

## 1K_F_1005/DNP

R90

## 1K_F_1005

C79

## 100NF_10V_0603_MLCC

TP24
+0.55V

1

R103

## 4.7K_F_1005

C76

## 100NF_50V_1005_MLCC

R125

## 10K_F_1608

C64

## 100NF_50V_1005_MLCC

## BANK 0

## XC7A200T-1FBG484

U12A

## VCCO_0 T12 VCCO_0 F12

## DXN_0

N9

VCCADC_0 | K10
GNDADC_0 | K9
DXP_0 | N10

## VREFN_0

## L9 VREFP_0

M10

## VP_0

L10

## VN_0

M9

## VCCBATT_0 E12

## CCLK_0 L12

TDO_0 | U13
TDI_0 | R13
TMS_0 | T13 TCK_0 | V12

## INIT_B_0

U12

## PROGRAM_B_0 N12

## CFGBVS_0 U8

## DONE_0 G11

M2_0

U9

M0_0

U11

M1_0

U10

R110

## 1K_F_1005/DNP

R117

## 51_F_1005

R101

## 4.7K_F_1005

R123

## 1K_F_1608

R105

## 330_F_1005

R94

## 0_F_1005

R104

## 4.7K_F_1005

R122

## 100_F_1005/DNP

C72

## 100NF_10V_0603_MLCC

C87

## 100NF_50V_1005_MLCC

R92

## 0_F_1005

FB2
HH-1M1608-221JT | C62
| 22UF_10V_2012_MLCC

ZD7

## BZT52C3V6_7_F/SOD-123

A | C

R99

## 10K_F_1005

R119

## 51_F_1005

C94

## 22UF_6.3V_1608_MLCC

R120

## 1K_F_1608

BC39

## 390PF_50V_2012_MLCC

C82

## 100NF_10V_0603_MLCC

R87

## 0_F_1005/DNP

R116

## 51_F_1005

C67

## 100NF_50V_1005_MLCC

C86

## 100NF_10V_0603_MLCC

C83

## 100NF_50V_1005_MLCC

## XC7A200T-1FBG484

U12I

GND W18 GND V21 GND V11 GND V1 GND U14 GND Y15 GND Y5 GND W8 GND T17 GND U4 GND T11 GND T7 GND T9 GND R10 GND R20 GND R12 GND P9 GND P7 GND R8 GND P13 GND P11 GND N8 GND N6 GND P3 GND N16 GND L22 GND L8 GND L2 GND K15 GND M11 GND M7 GND K5 GND M19 GND K11 GND K7 GND J8 GND H21 GND H11 GND H9 GND H7 GND J18 GND J12 GND J10 GND H1

GND | G10
GND | G9
GND | G14
GND | G12
GND | G5
GND | G8
GND | G7
GND | G6
GND | F5
GND | E20
GND | F17
GND | F11
GND | E11
GND | E7
GND | E9
GND | D13
GND | E5
GND | E4
GND | D8
GND | D4
GND | D12
GND | C12
GND | C10
GND | C6
GND | D3
GND | C16
GND | B3
GND | C3
GND | B19
GND | B12
GND | AA22
GND | AA12
GND | AB19
GND | AB9
GND | A22
GND | AA2
GND | A12
GND | A11
GND | A9
GND | A5
GND | A7
GND | A2
GND | A3

C96

## 100NF_50V_1005_MLCC

R108

## 1K_F_1005/DNP

R95

## 10K_F_1005/DNP

C74

## 100NF_10V_0603_MLCC

U19

## REF3012AIDBZR

IN

1

## OUT 2

GND

3

R124

## 1K_F_1608

R98

## 0_F_1005

## VREF+

## VREF+

## B0_XADC_VP B0_XADC_VN

## JTAG_TCK

## JTAG_TDO

## JTAG_TMS

## JTAG_TDI

## JTAG_TCK

## FPGA_VBATT

## FPGA_DONE

## FPGA_INIT_B FPGA_PROG_B

## FPGA_CCLK

## FPGA_M2

## FPGA_M0

## FPGA_M1

## FPGA_M0 FPGA_M1 FPGA_M2

## FPGA_VBATT

## FPGA_DONE

## FPGA_CFGBVS

## FPGA_PROG_B

## FPGA_CFGBVS

## FROM_nHOLD

## FROM_DQ2/nW

## FROM_nS

## FROM_nHOLD FROM_DQ2/nW

## FROM_nS

## FPGA_CCLK

## FPGA_CCLK

## JTAG_TDO JTAG_TDI

## JTAG_TCK JTAG_TMS

## FPGA_INIT_B

## B0_XADC_VP B0_XADC_VN

# GPIB (Option)

+5VD

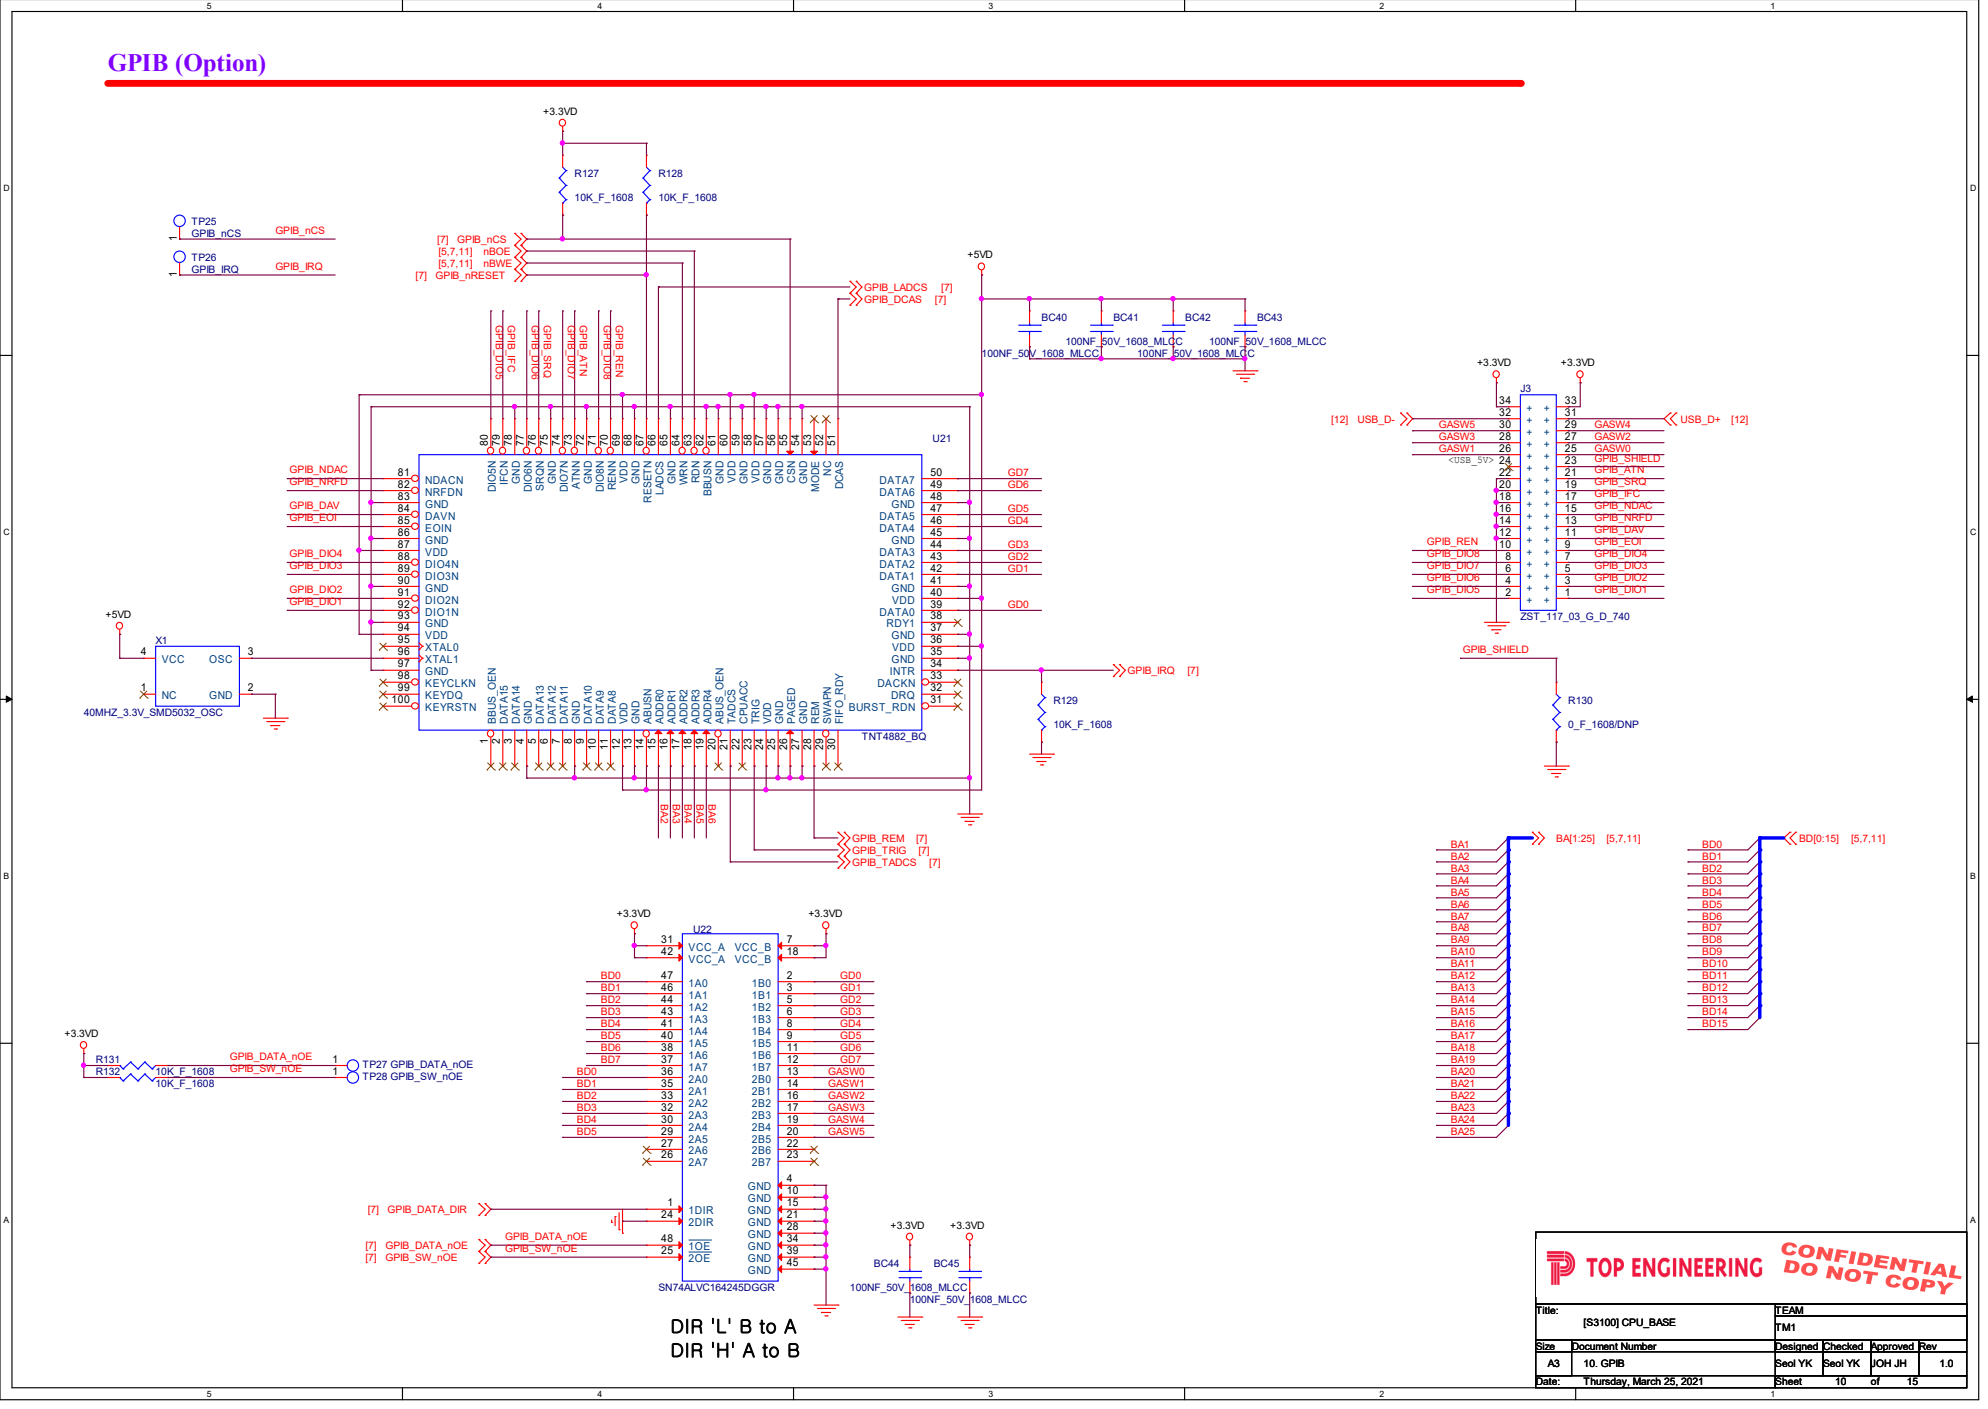
[picture p34: page 10]

# LAN I/F

+3.3VA +1.8VA | +3.3VD | +1.8VD

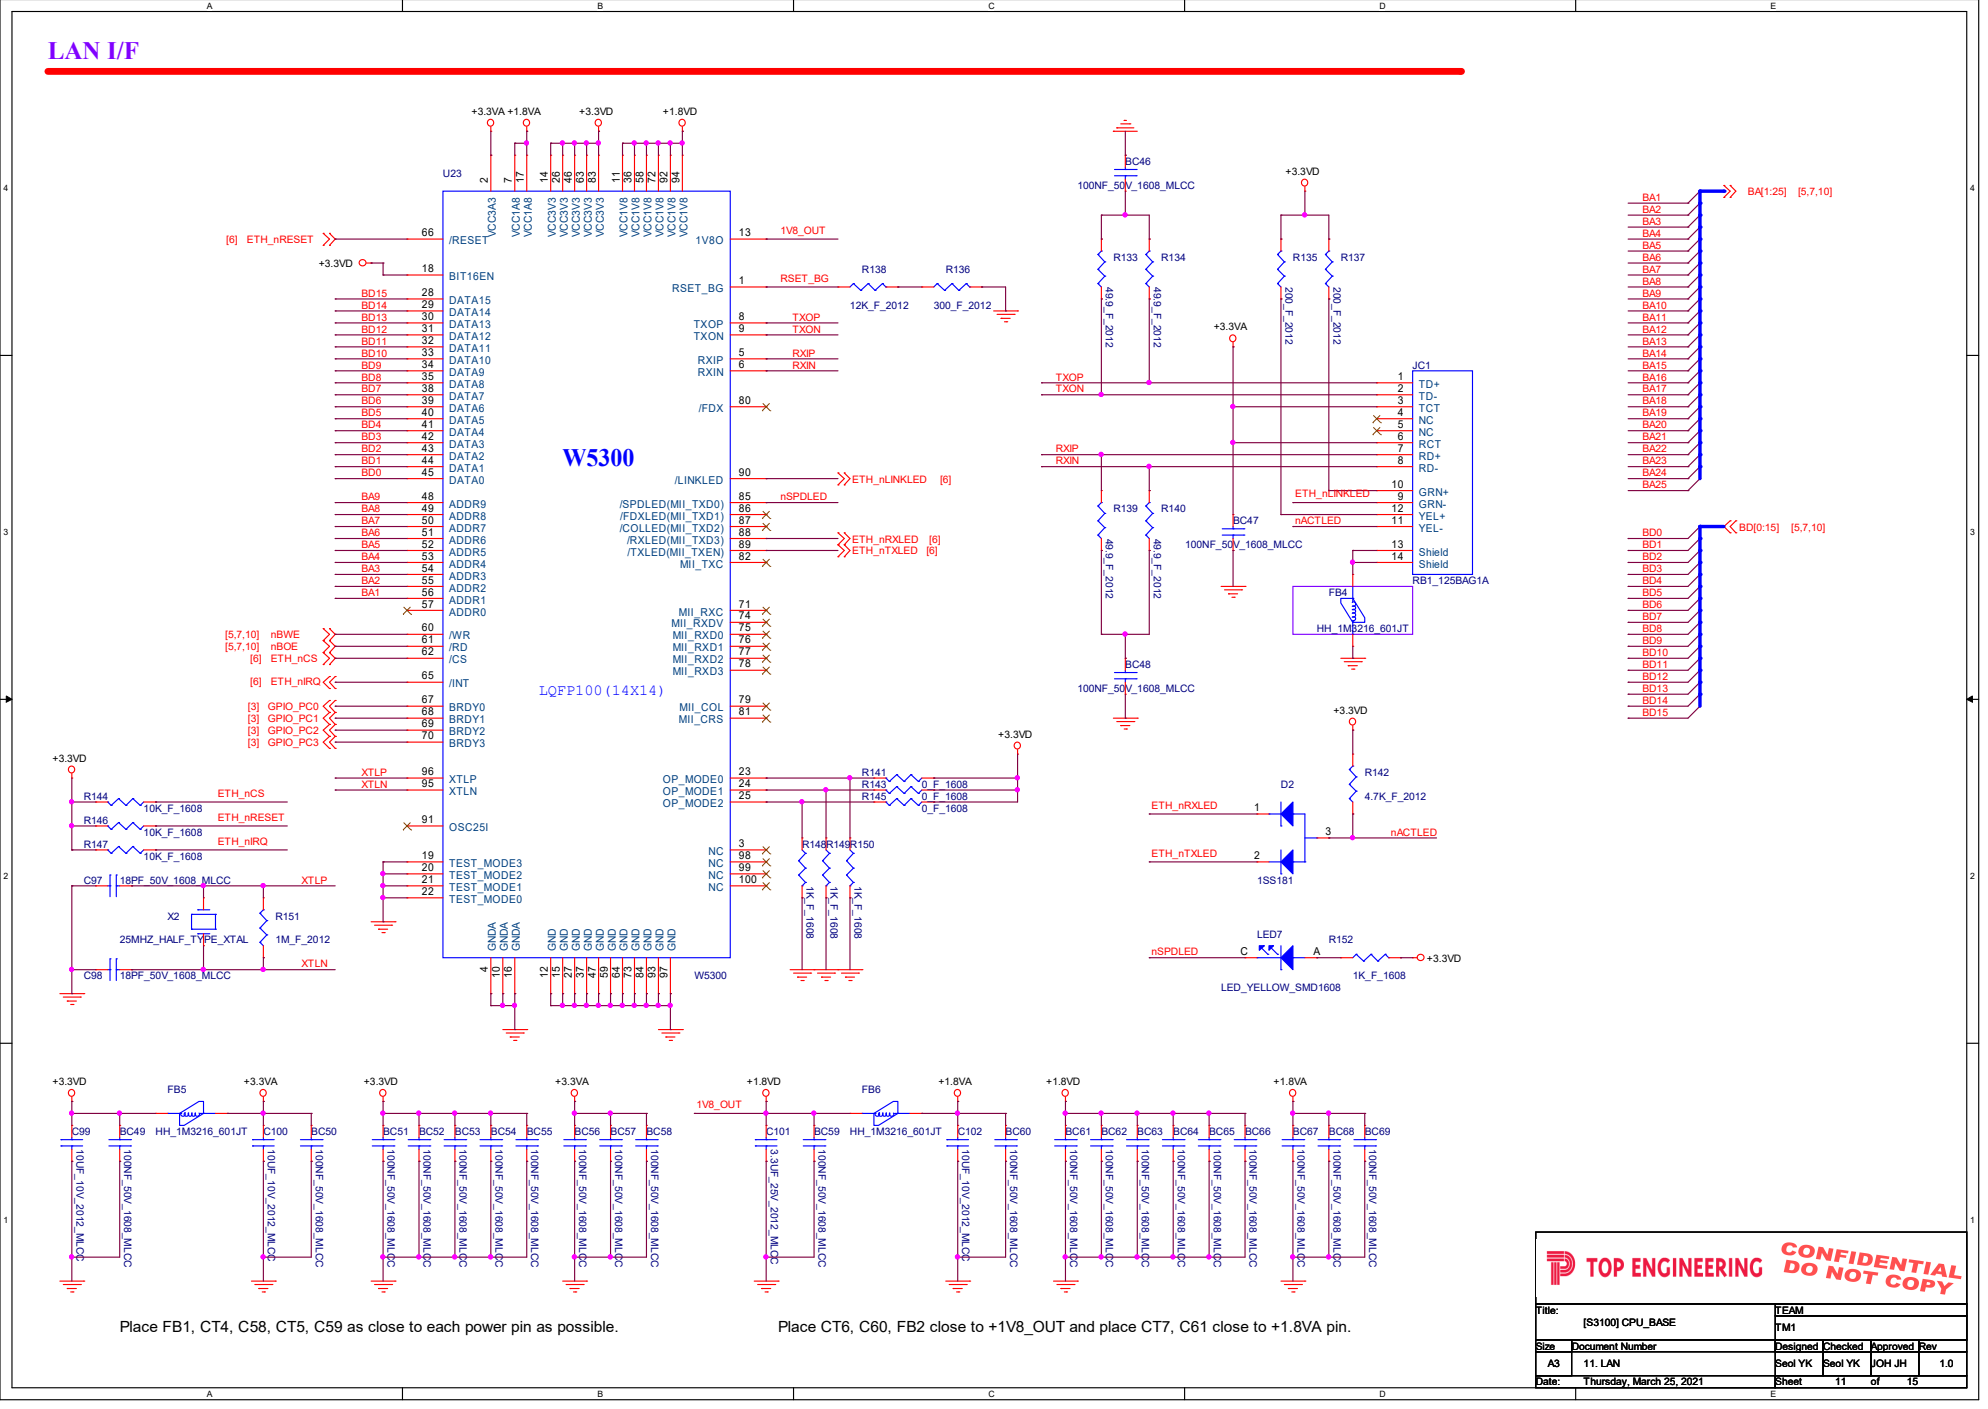
[picture p35: page 11]

# STATUS LED

OK | BUSY | ERR

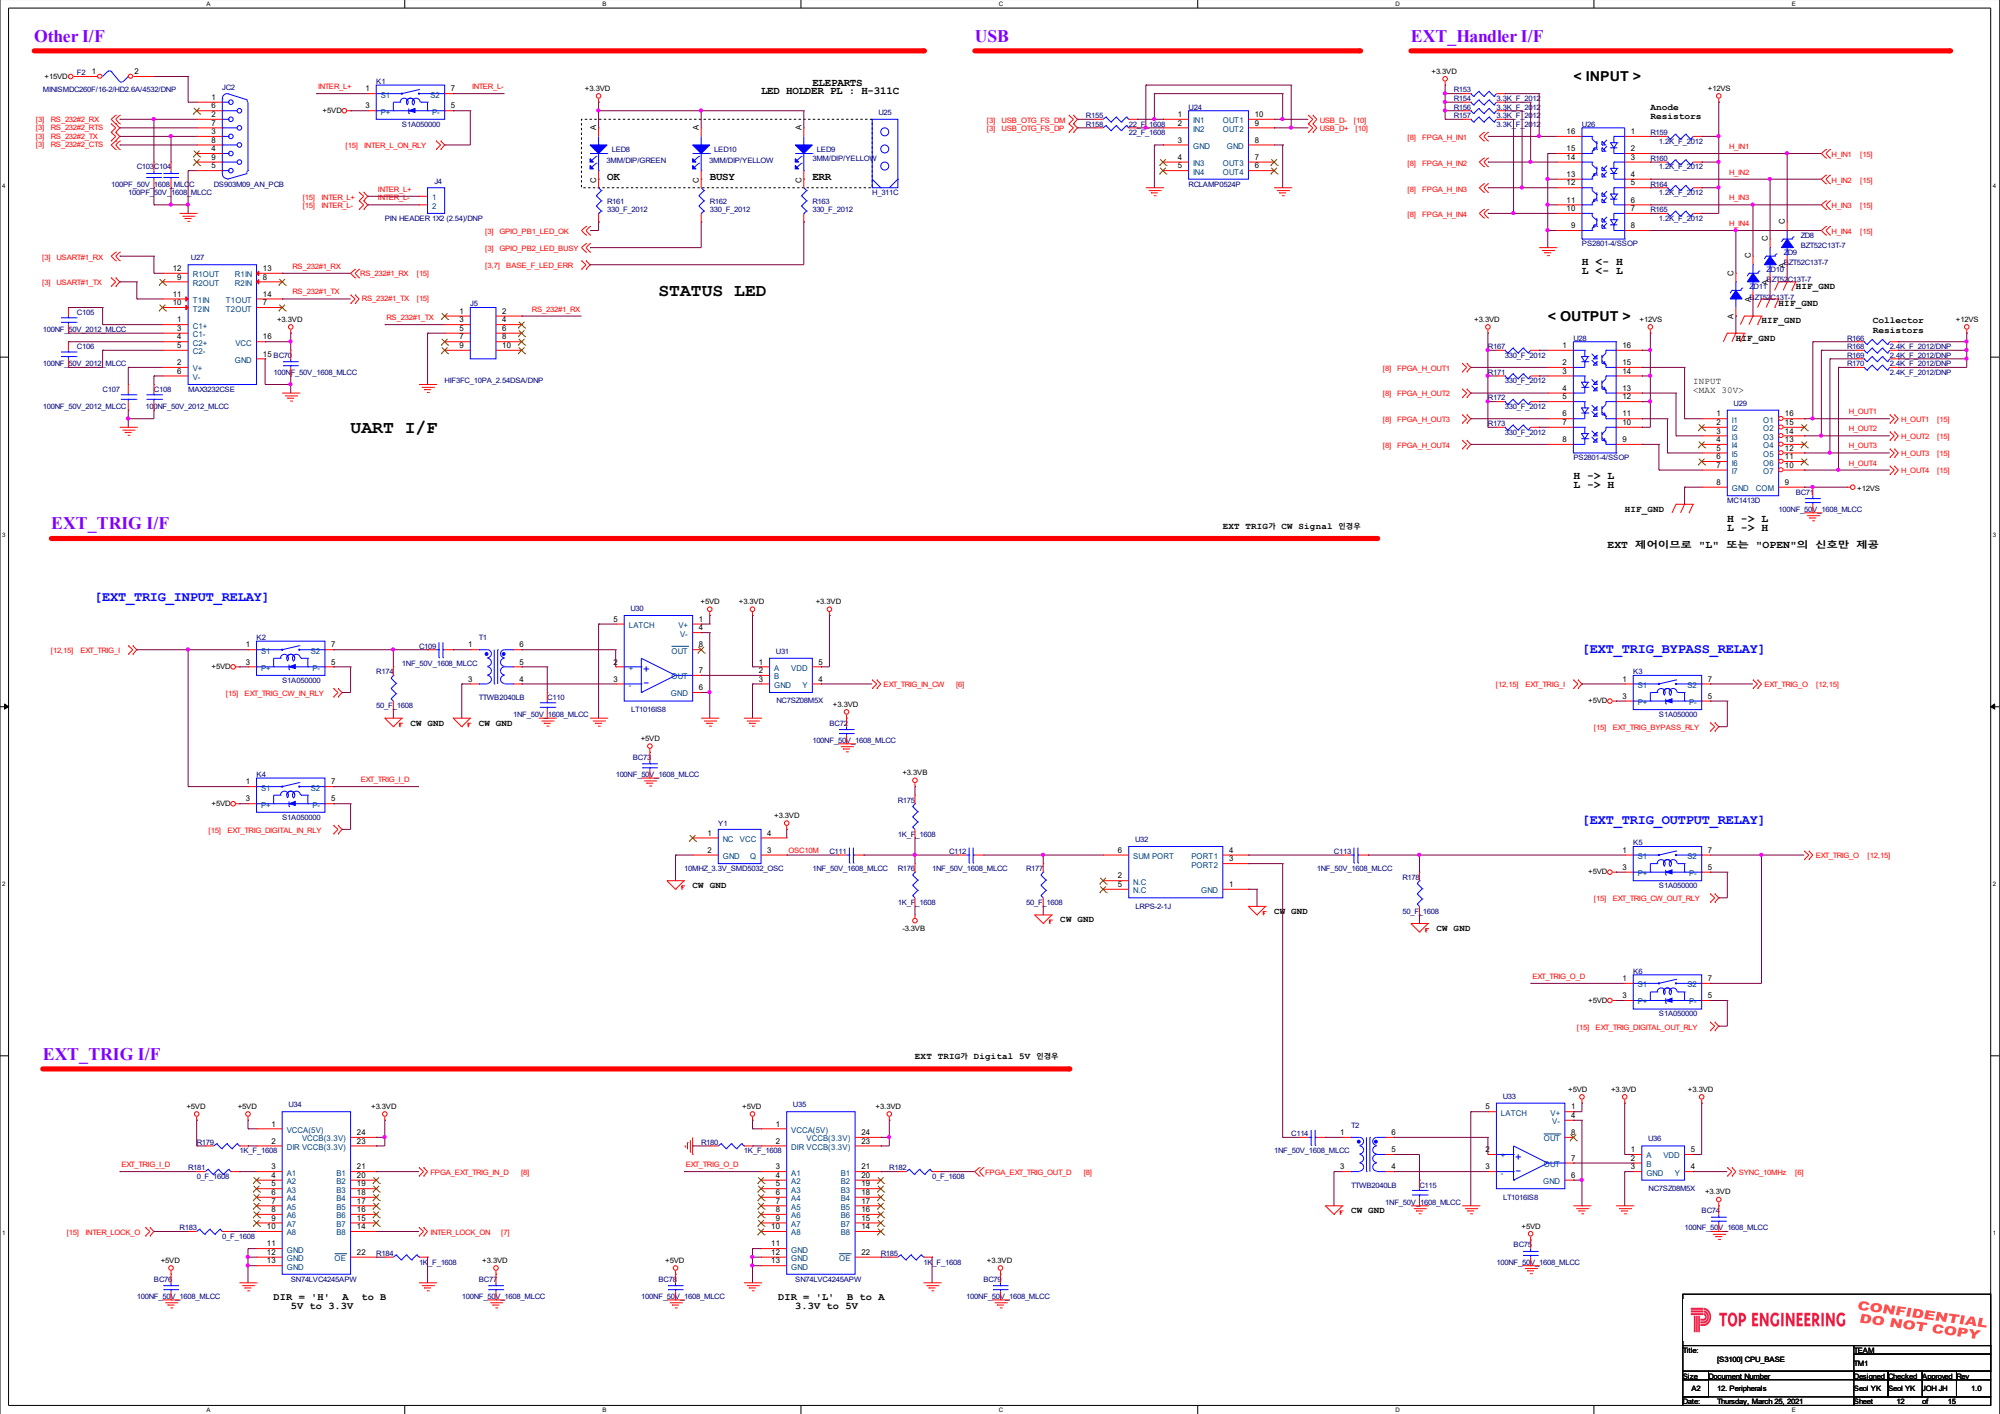
[picture p36: page 12]

EXT 제어이므로 "L" 또는 "OPEN"의 신호만 제공

LEVEL SHIFT (CS) | BASE to MOTHER BD

# BASE to MOTHER (LED & KEY)

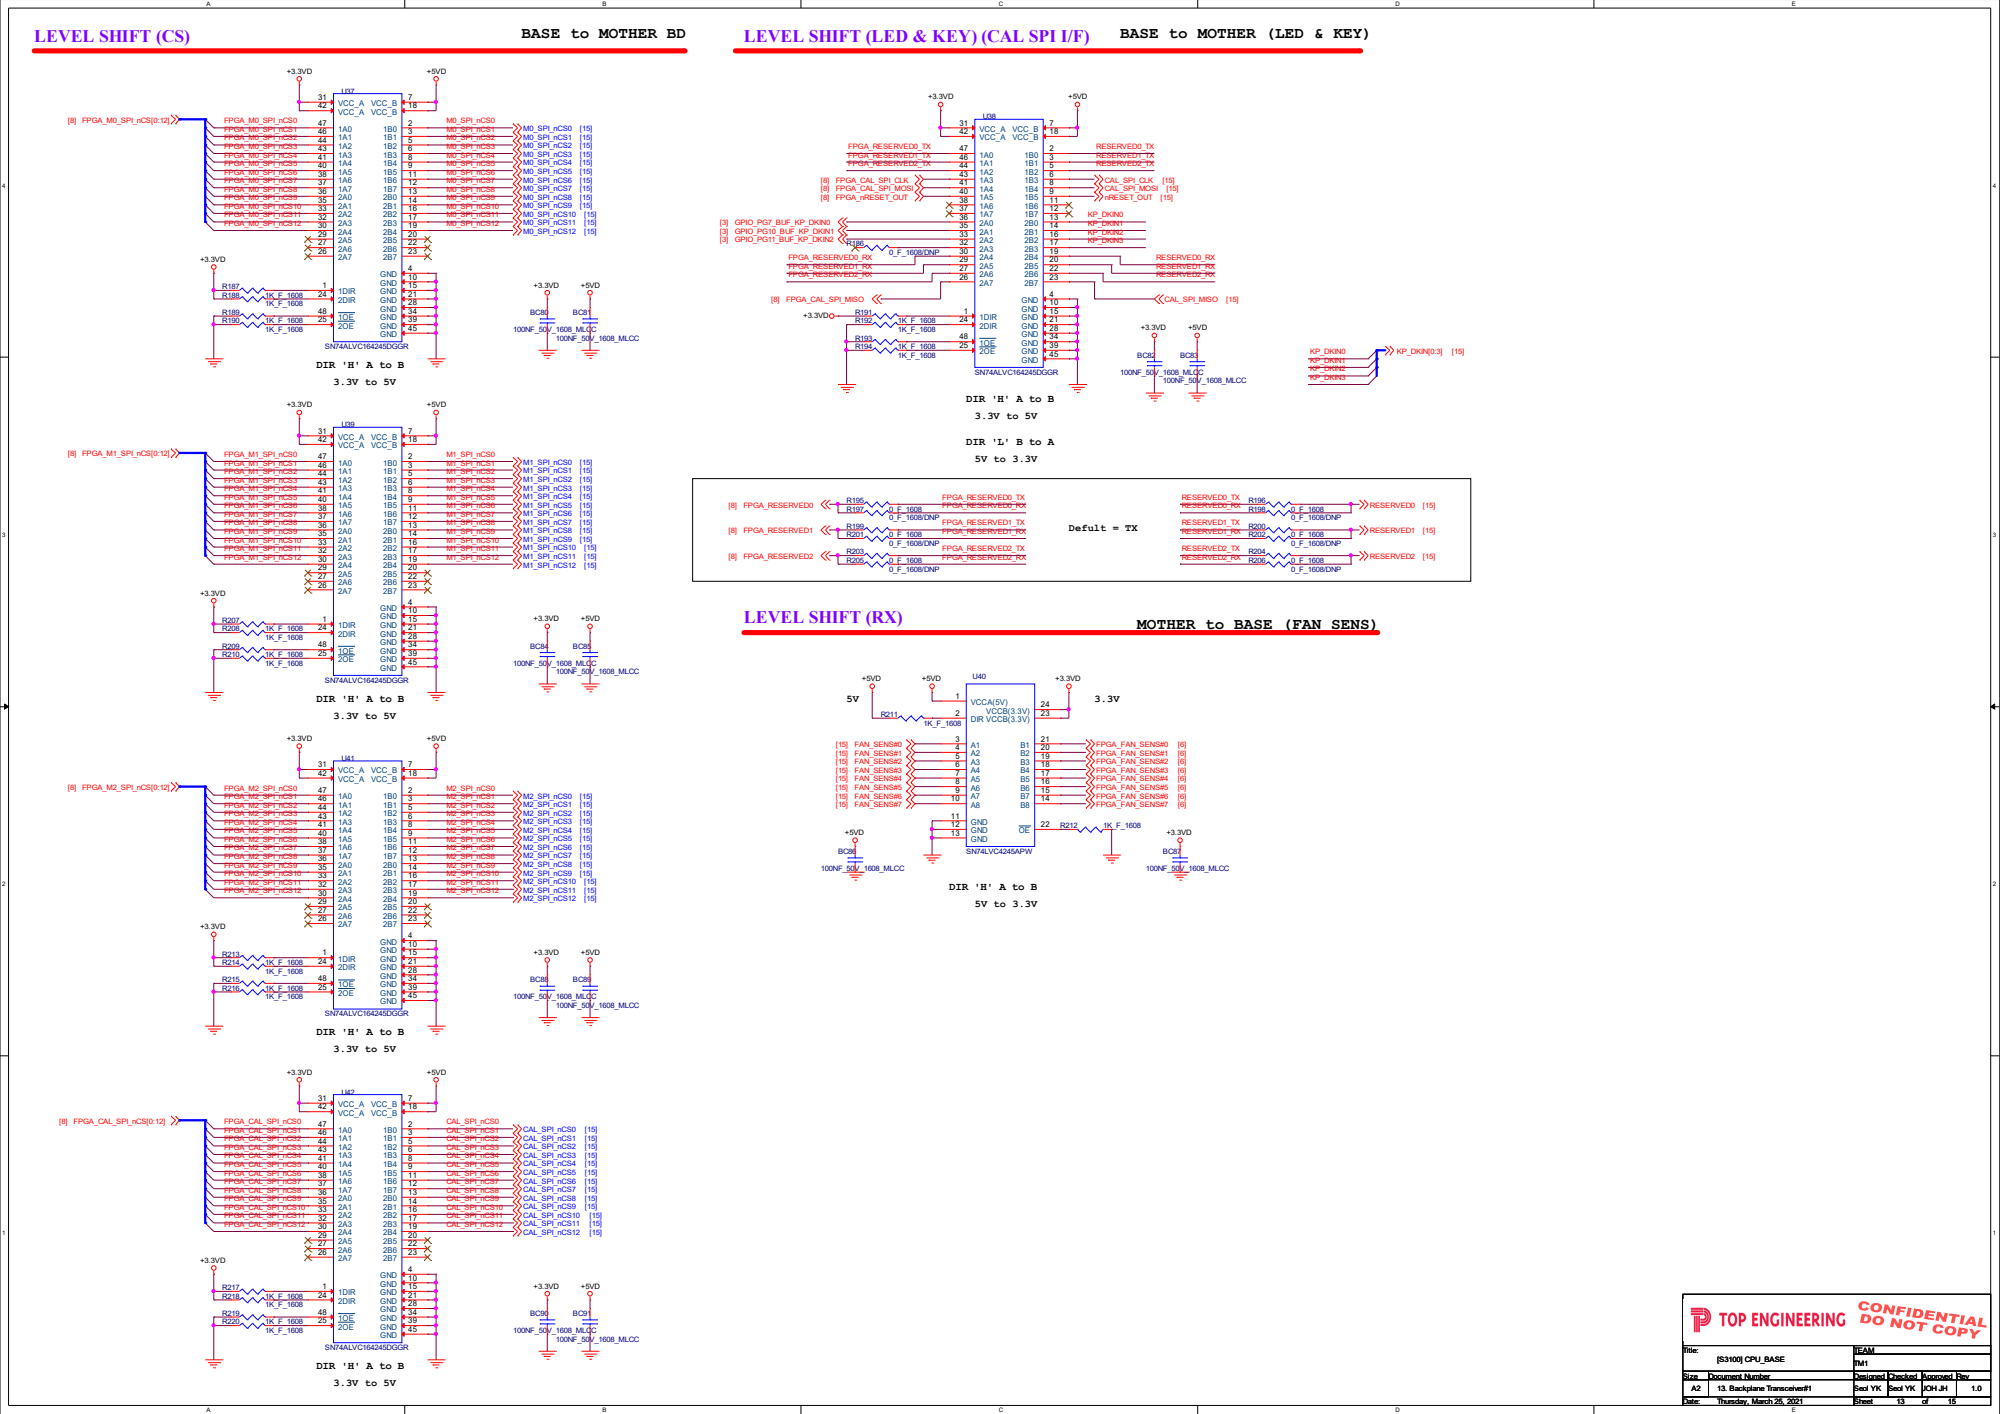
[picture p37: page 13]

LEVEL SHIFT (LED & KEY) (CAL SPI I/F)

MOTHER to BASE (FAN SENS)

RS-422 TX | RS-422 RX

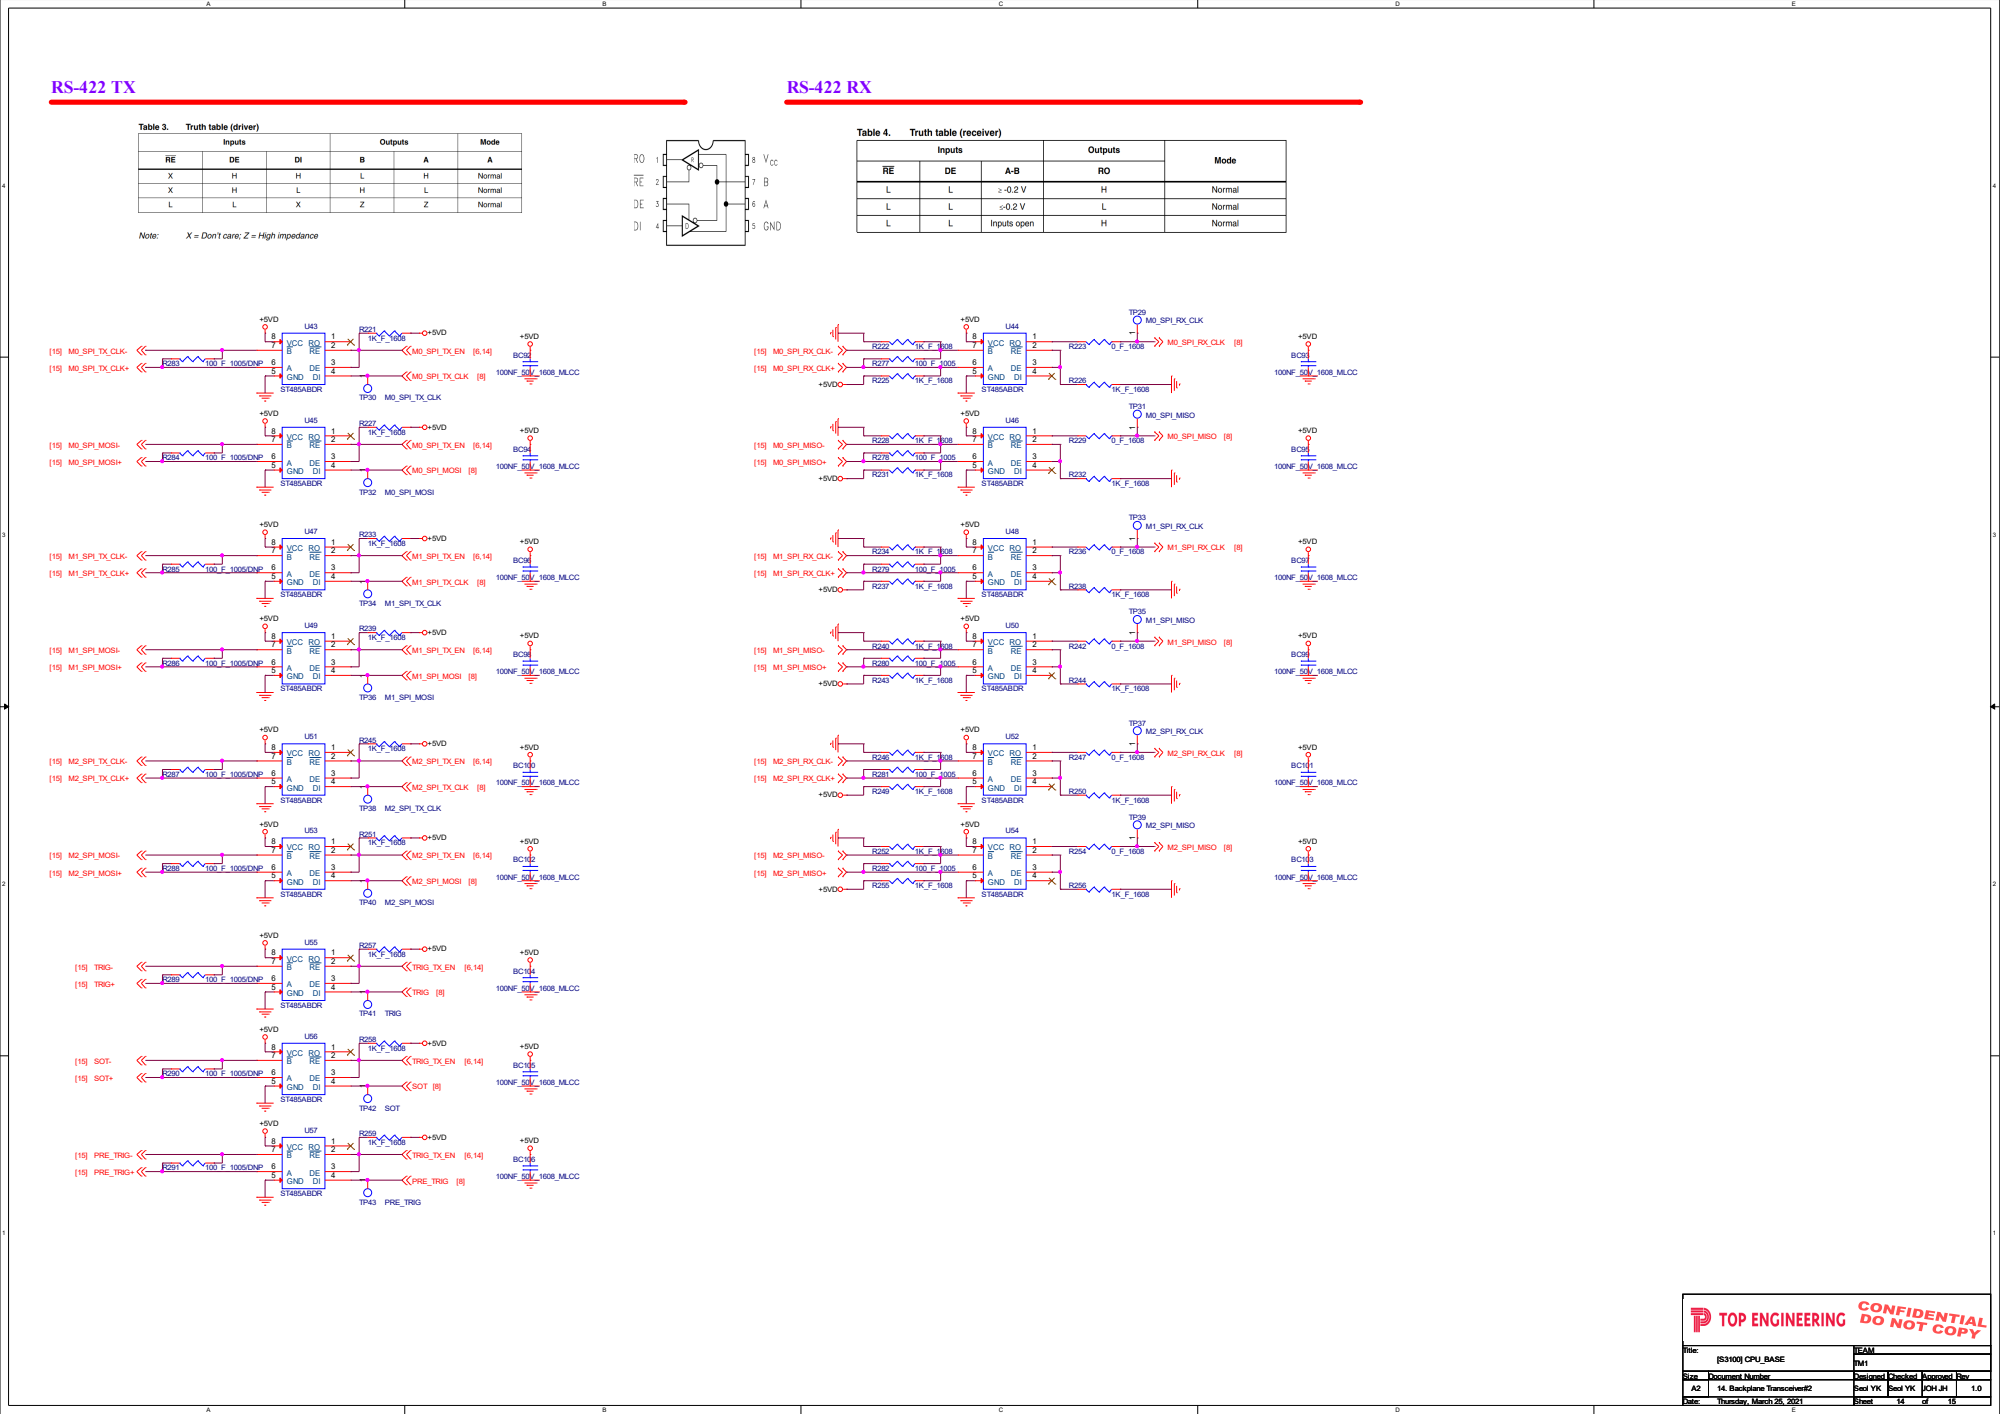
[picture p38: page 14]

# SYSTEM BUS CONNECTOR

# EXT_CONNECTOR

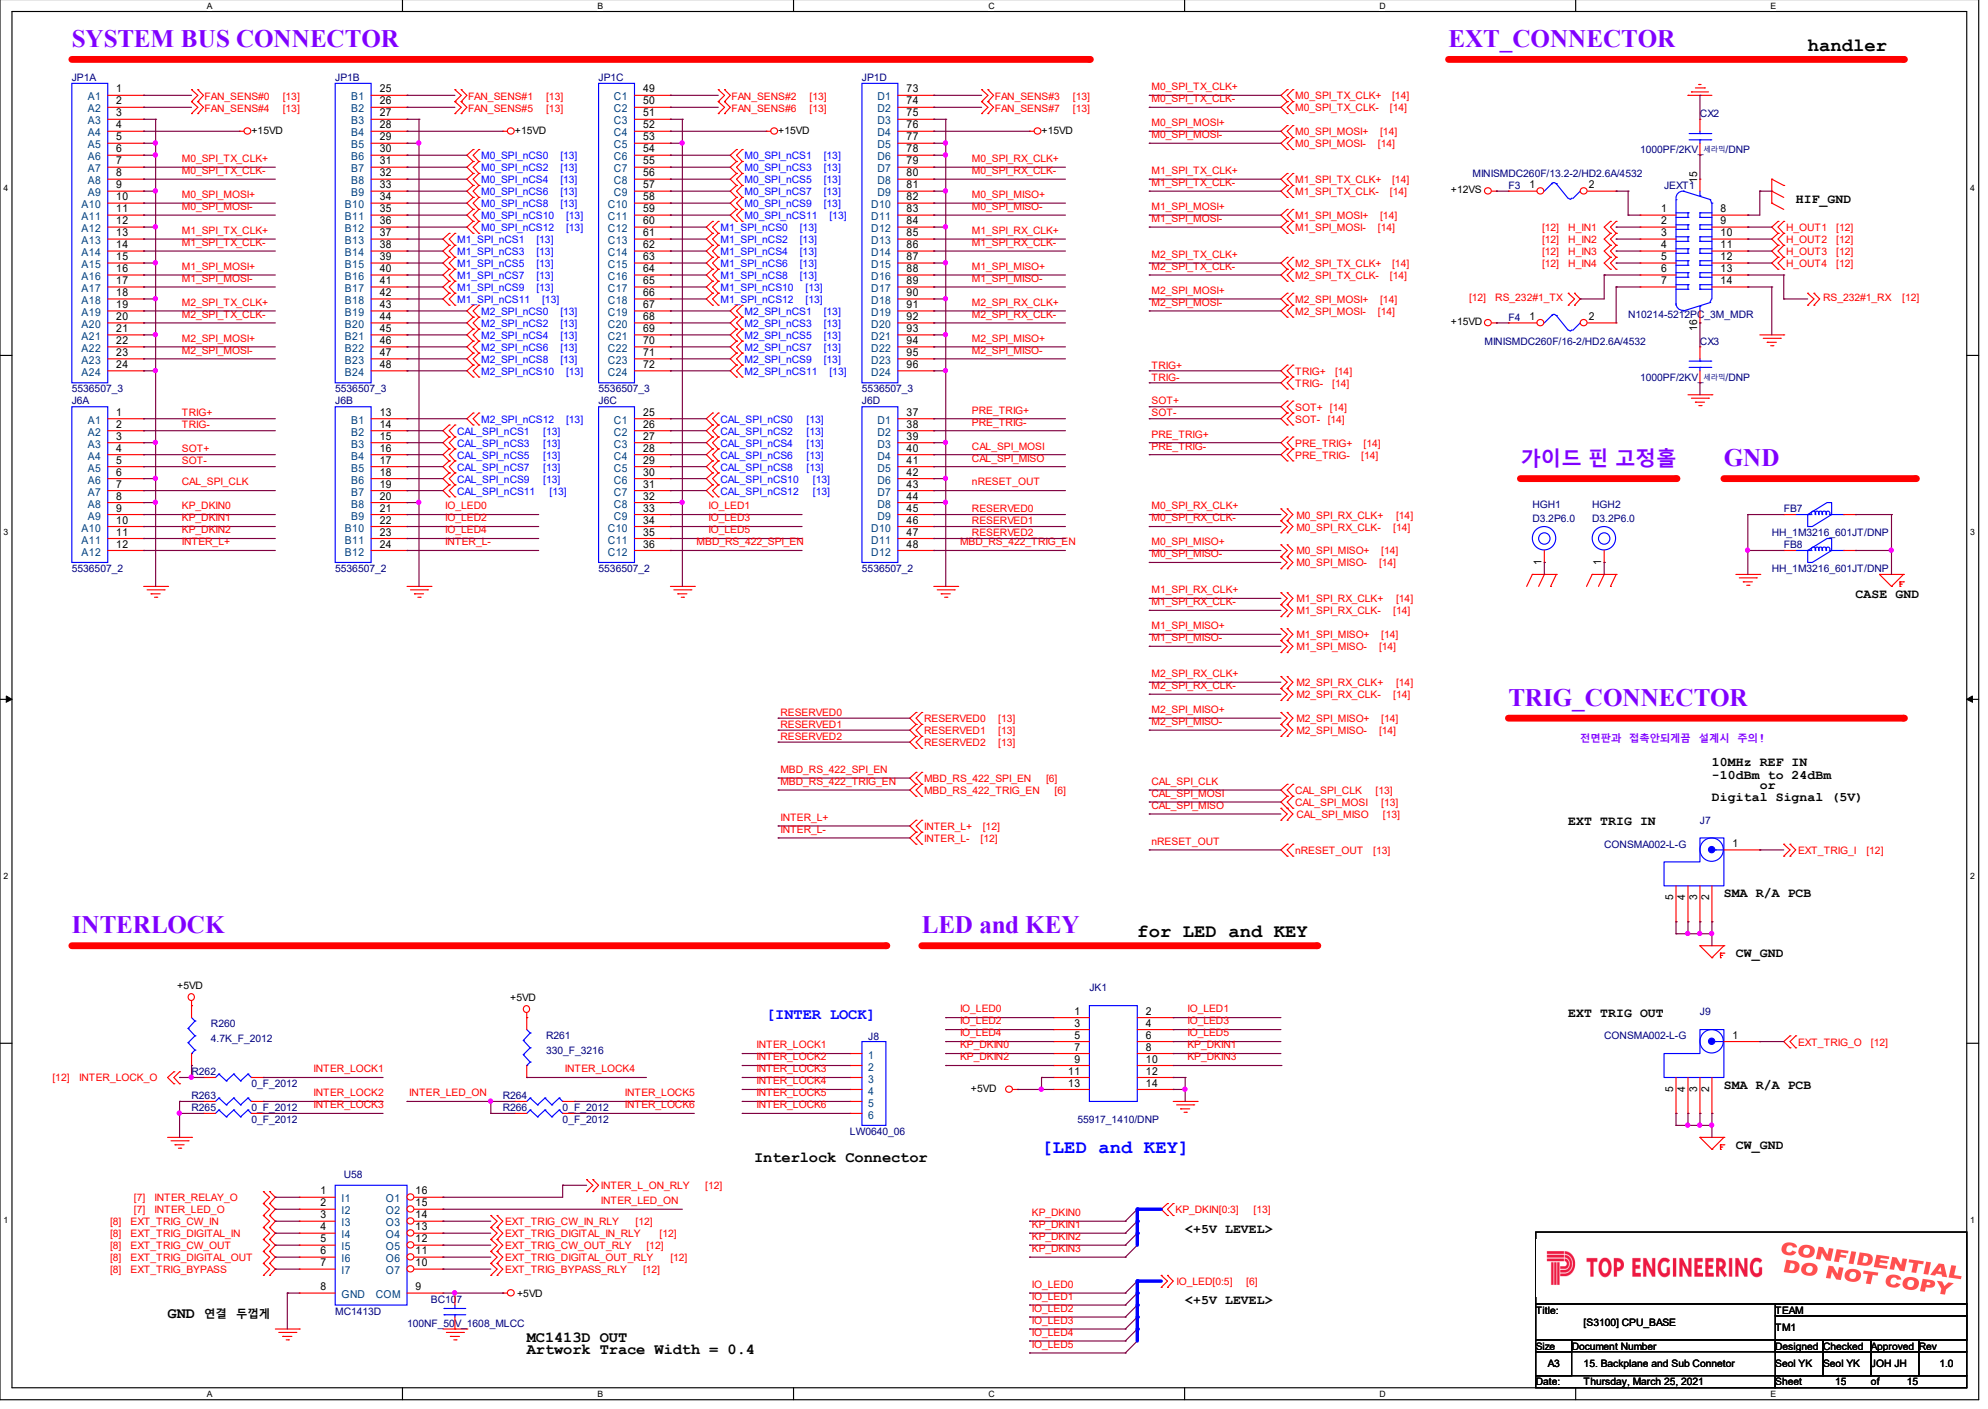
[picture p39: page 15]

전면판과 접촉안되게끔 설계시 주의!

for LED and KEY
