lastoyz/dsn_pgu_adda_s3100_git/dsn/1.sch/_ref/cpu_core_cortex_m7_20201112.pdf

# < CPU_CORE_CORTEX_M7 BD>

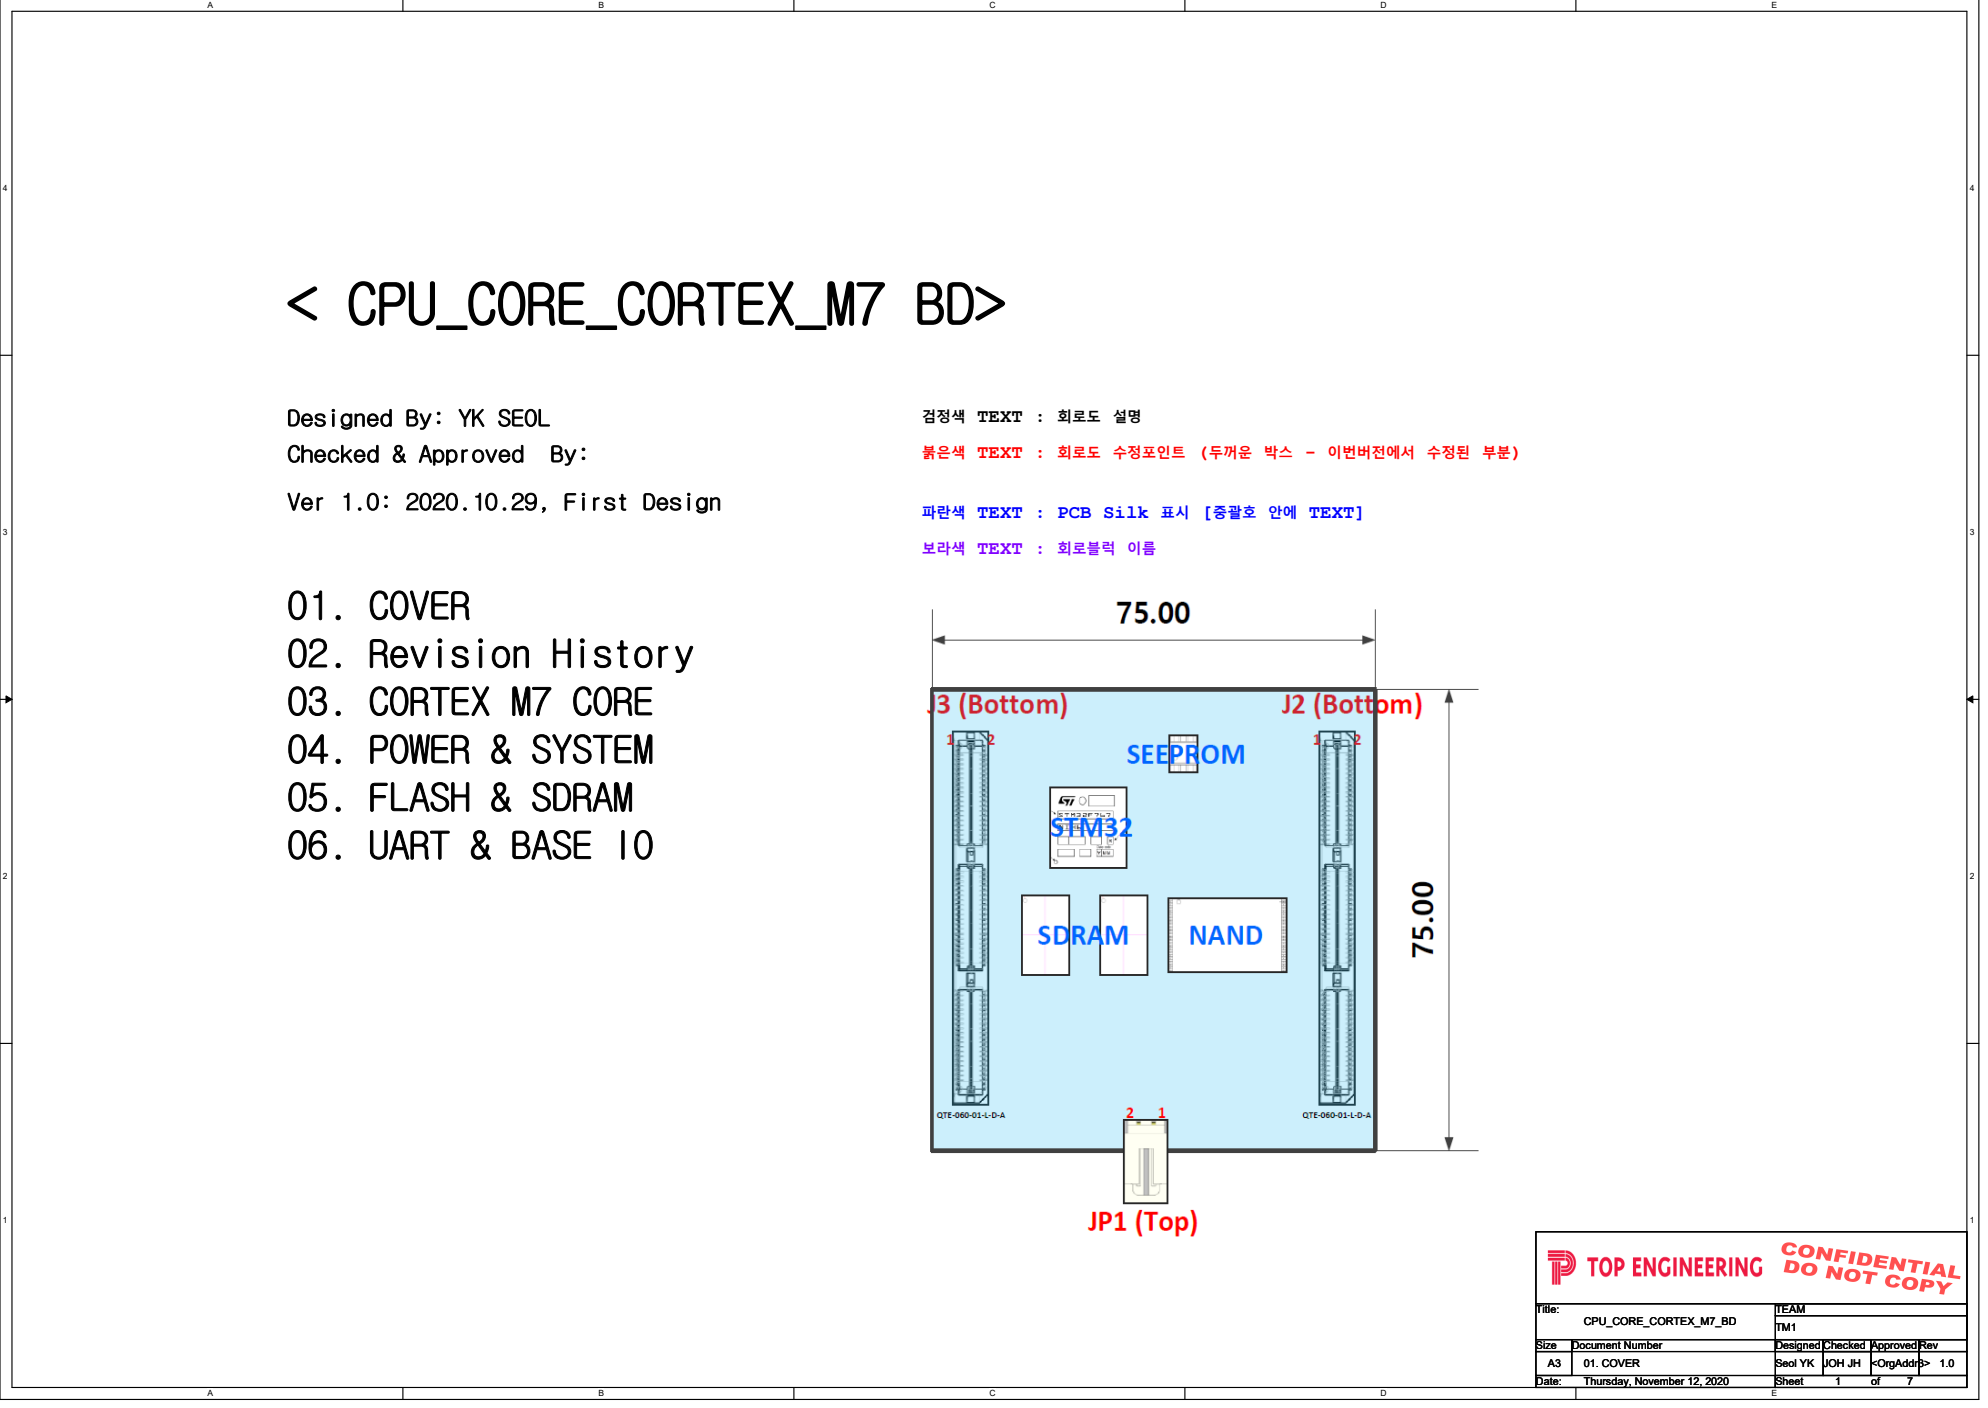
[picture p40: page 1]
Title:; Size; Document Number; Rev; Date:; Sheet; Designed Checked Approved; TEAM; 01. COVER; CPU_CORE_CORTEX_M7_BD; Seol YK JOH JH <OrgAddr3>; Thursday, November 12, 2020

Designed By: YK SEOL
Checked & Approved By:

검정색 TEXT : 회로도 설명

붉은색 TEXT : 회로도 수정포인트 (두꺼운 박스 - 이번버전에서 수정된 부분)

Ver 1.0: 2020.10.29, First Design

파란색 TEXT : PCB Silk 표시 [중괄호 안에 TEXT]

보라색 TEXT : 회로블럭 이름

01. COVER
02. Revision History
03. CORTEX M7 CORE
04. POWER & SYSTEM
05. FLASH & SDRAM
06. UART & BASE IO

Date | Version
Editor | Revision

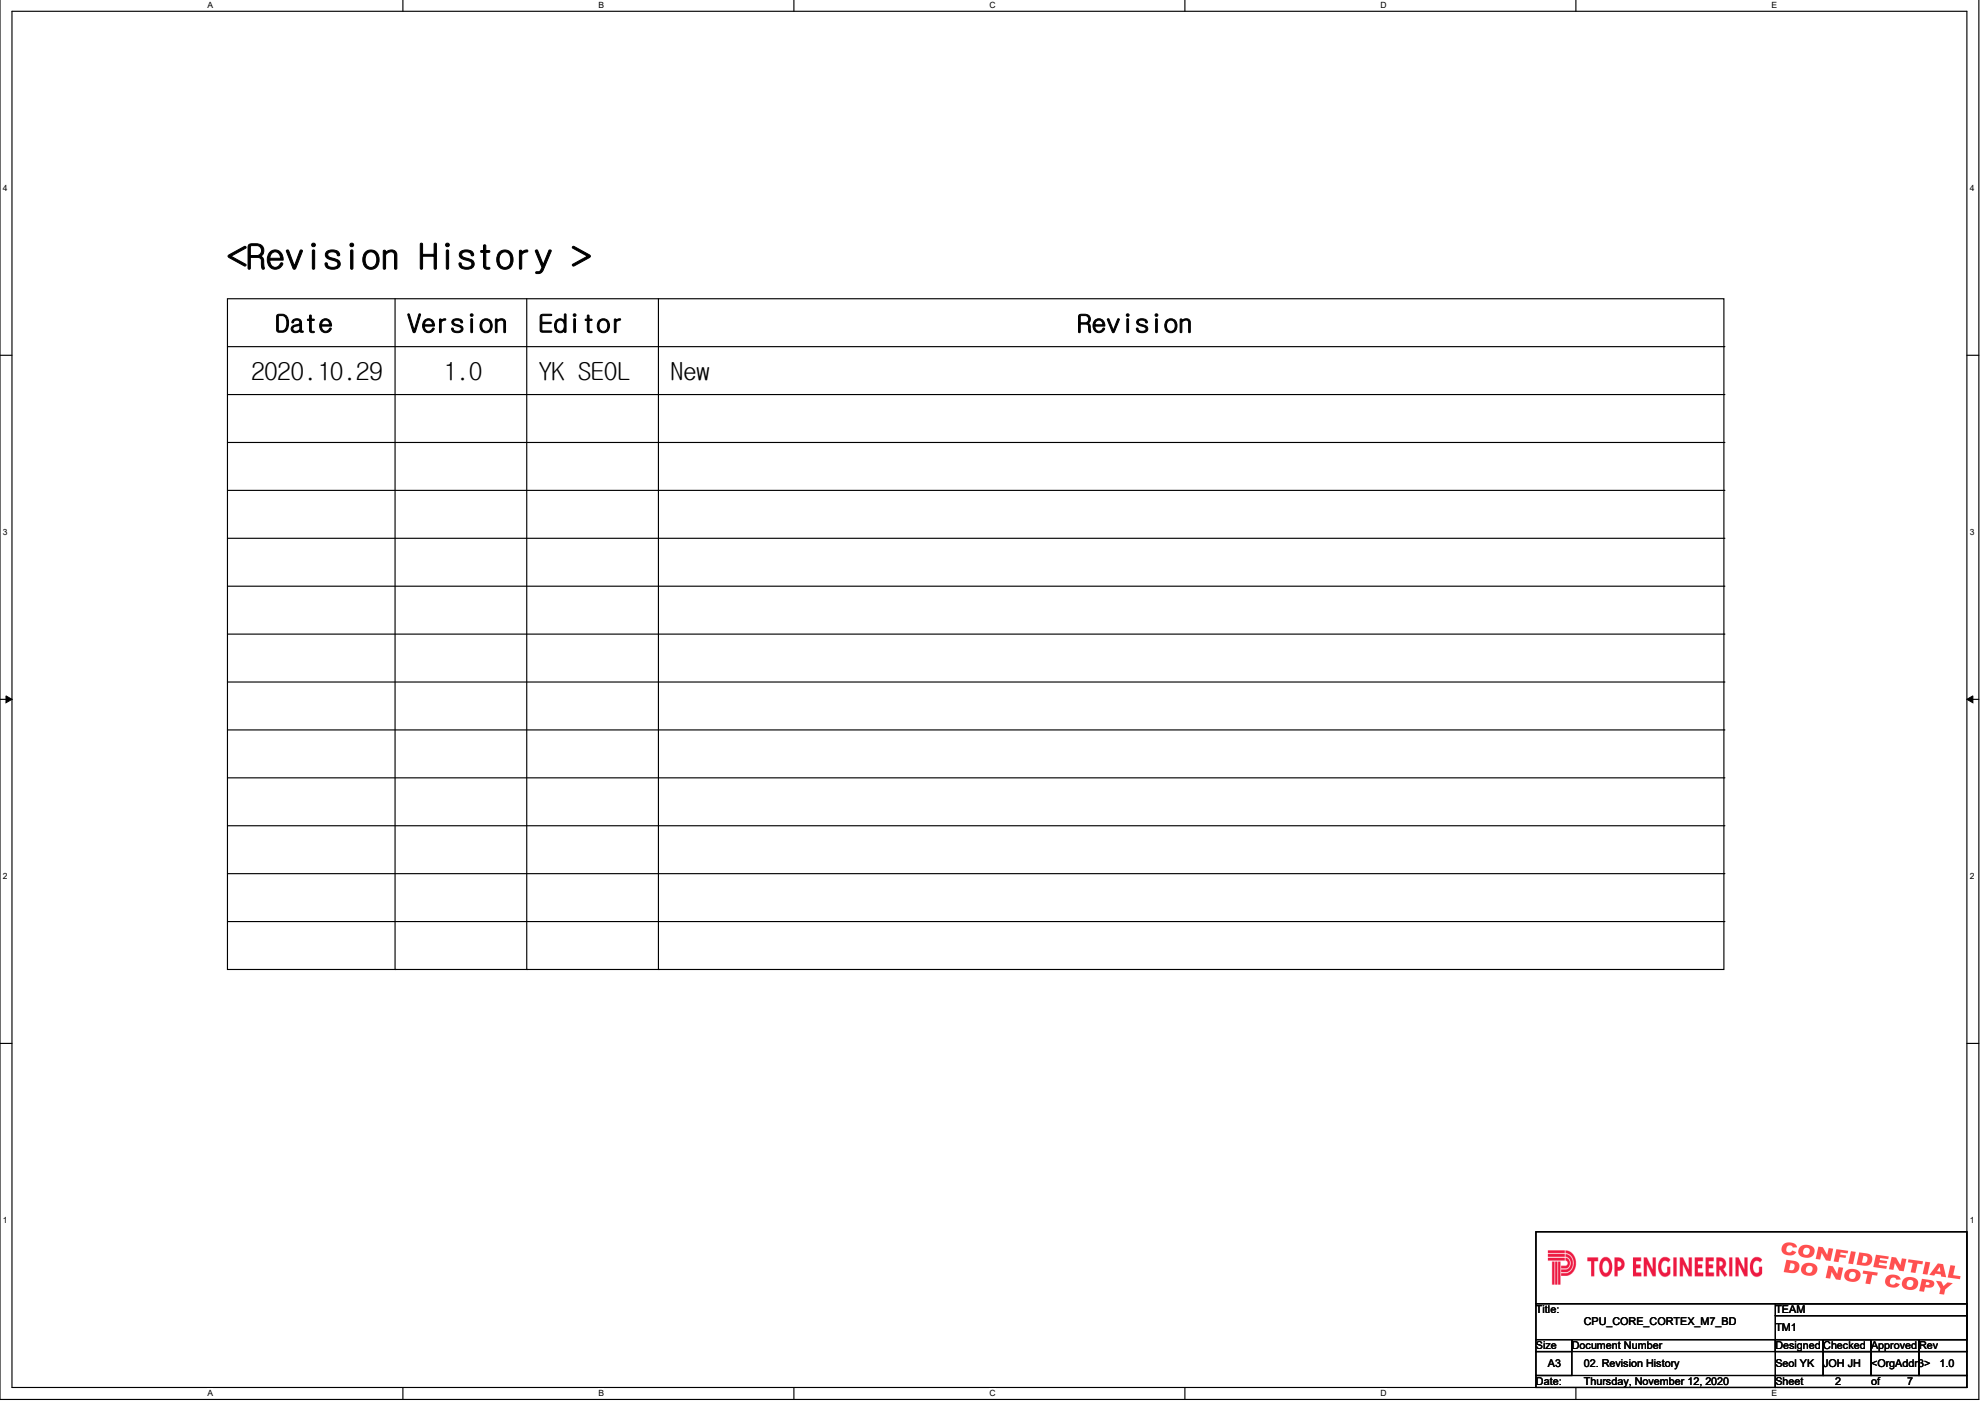
[picture p41: page 2]
New; <Revision History >; YK SEOL; 02. Revision History; Thursday, November 12, 2020

### MCU PIN DEFINE

MCU (1/3) | BOOT Option

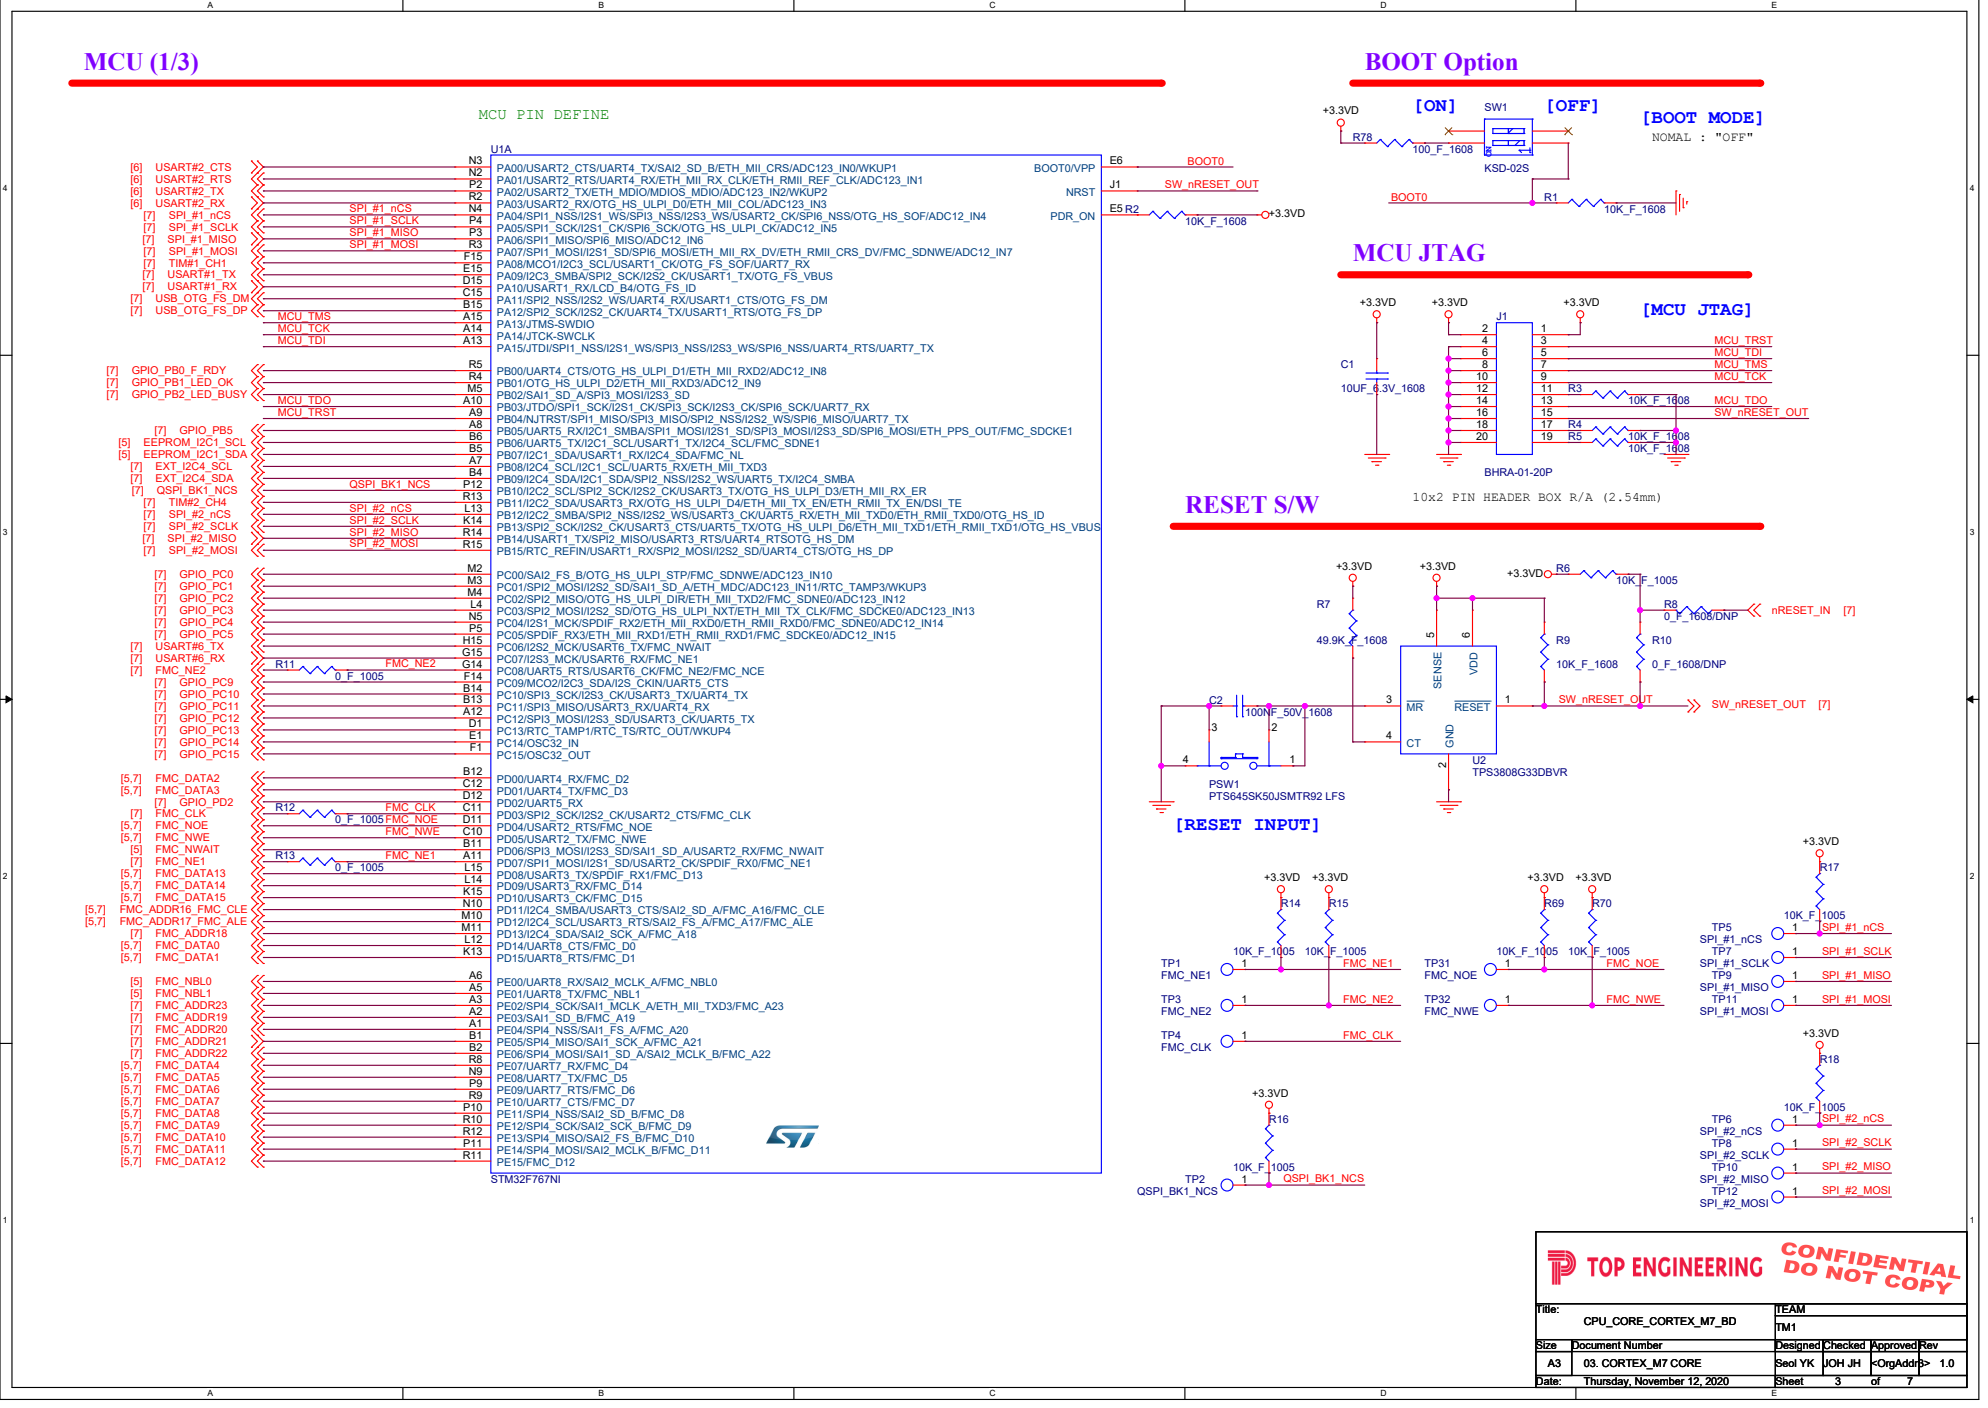
[picture p42: page 3]

MCU (2/3) | MCU (3/3)

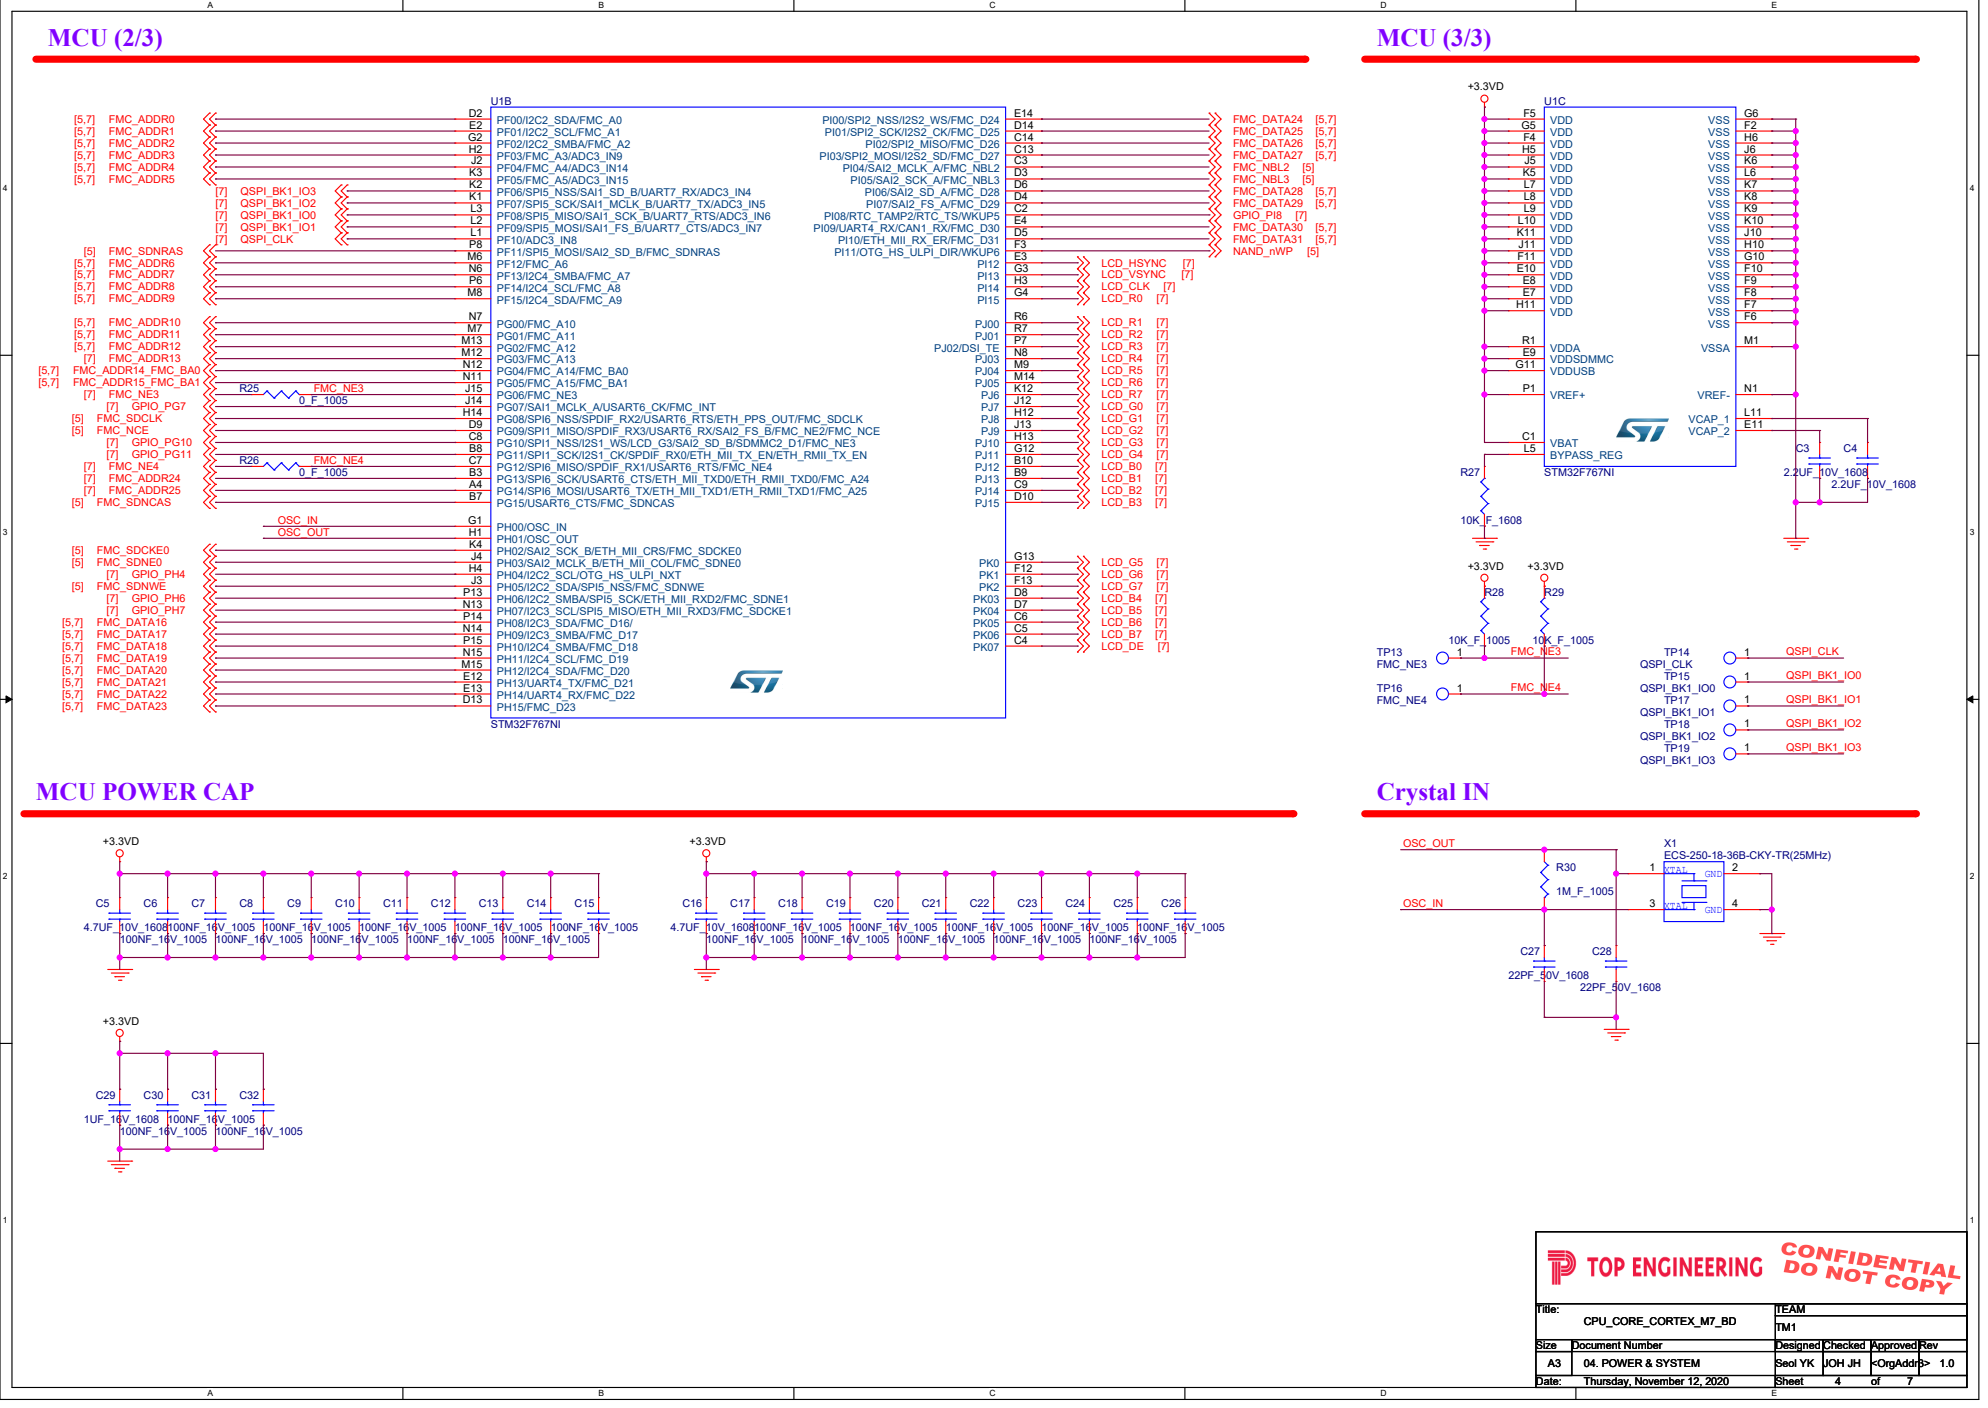
[picture p43: page 4]

# NAND FLASH (x8)

SDRAM | SEEP ROM

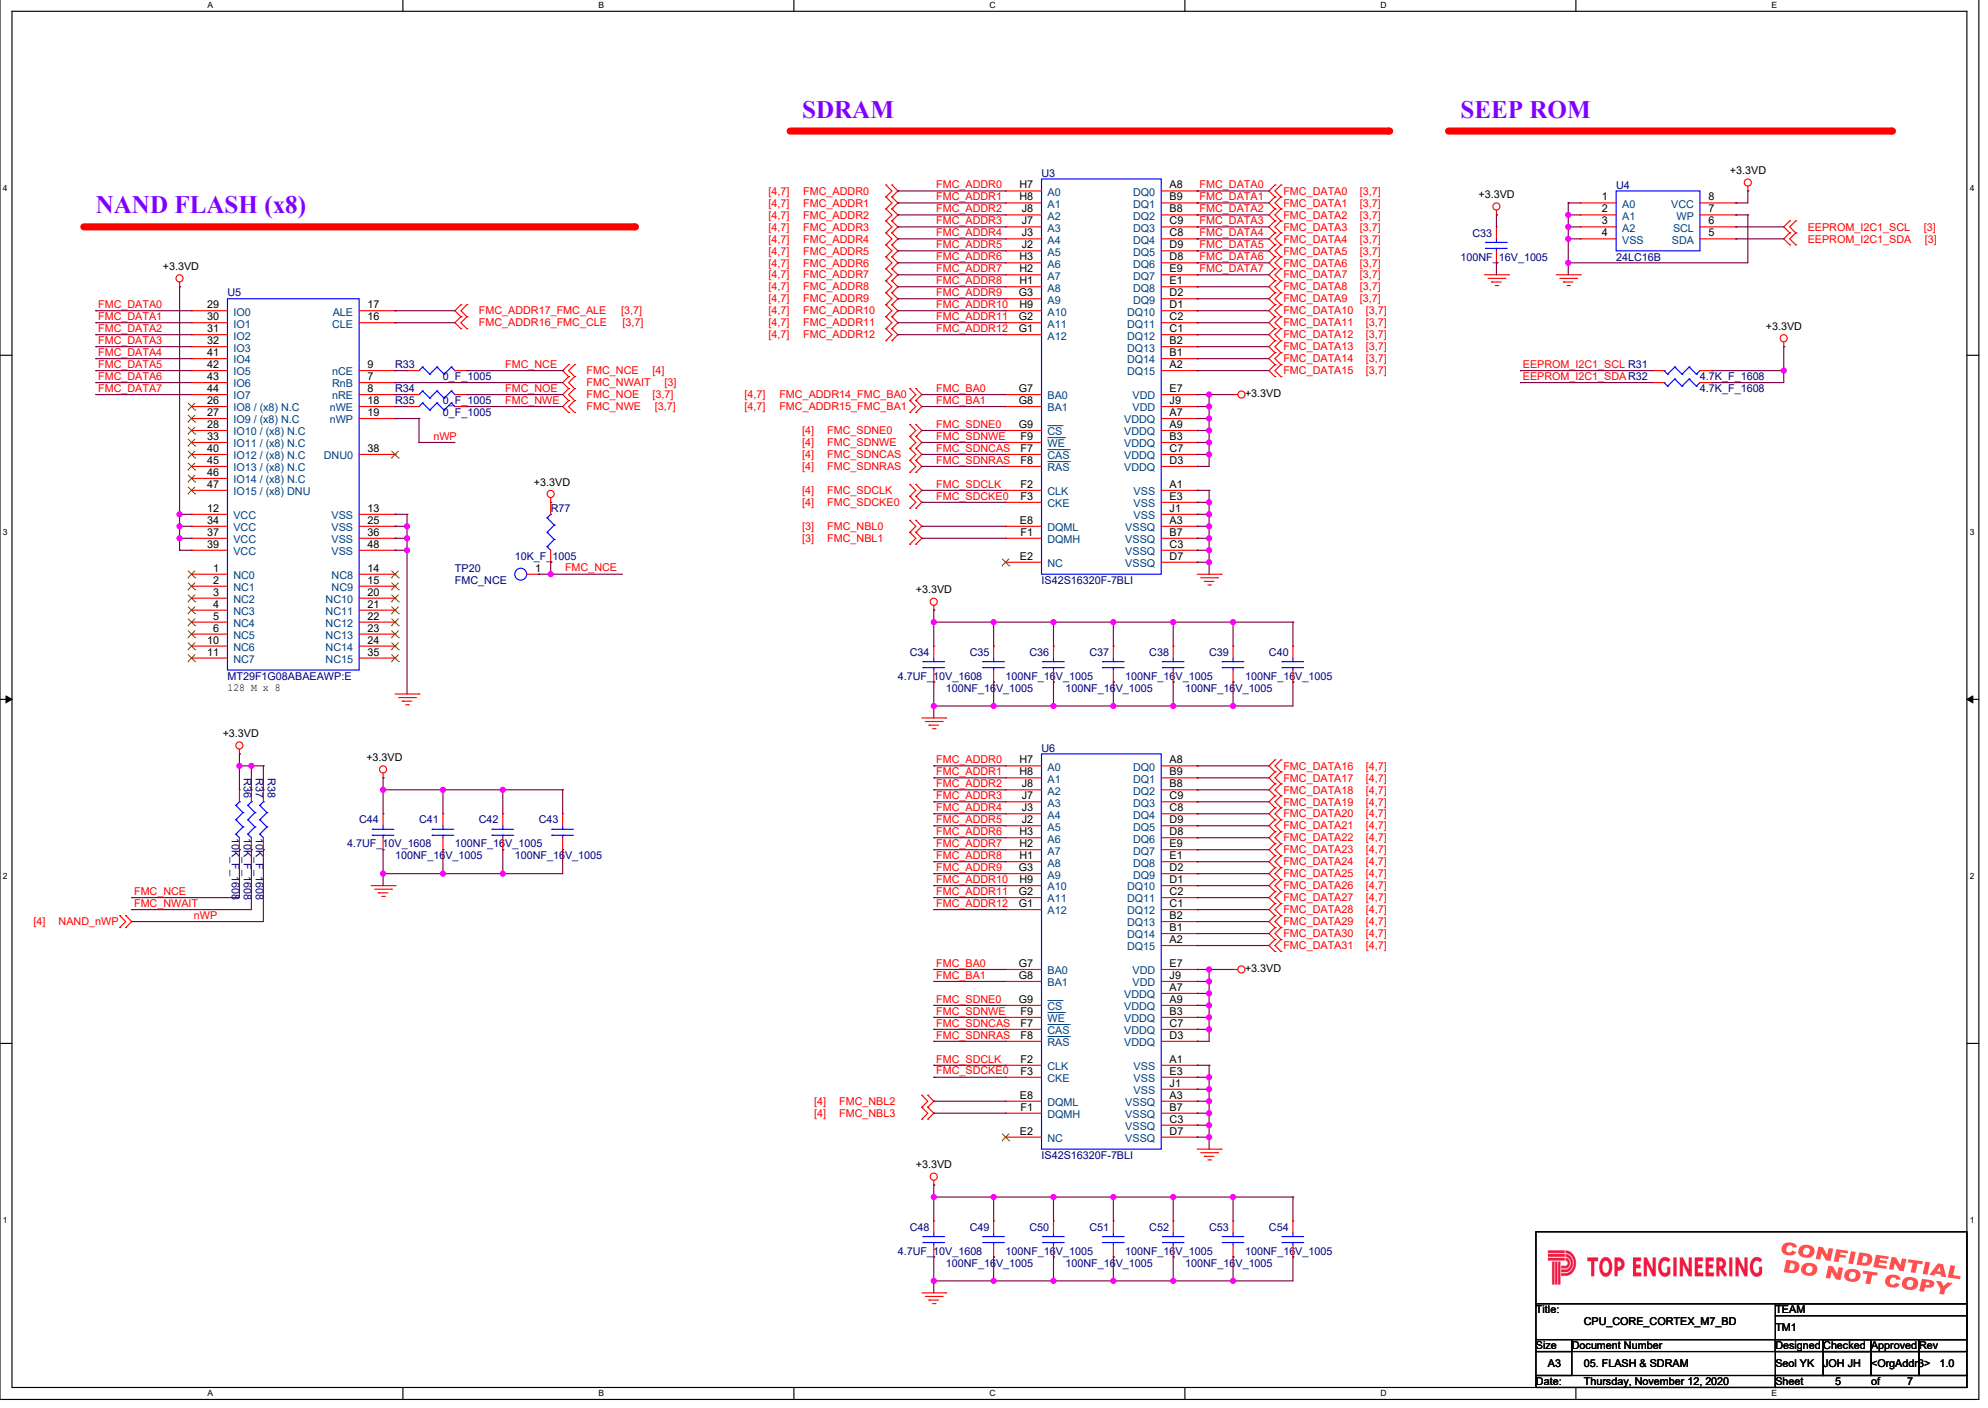
[picture p44: page 5]

# [EXT_POW]

# 보조전원 커넥터

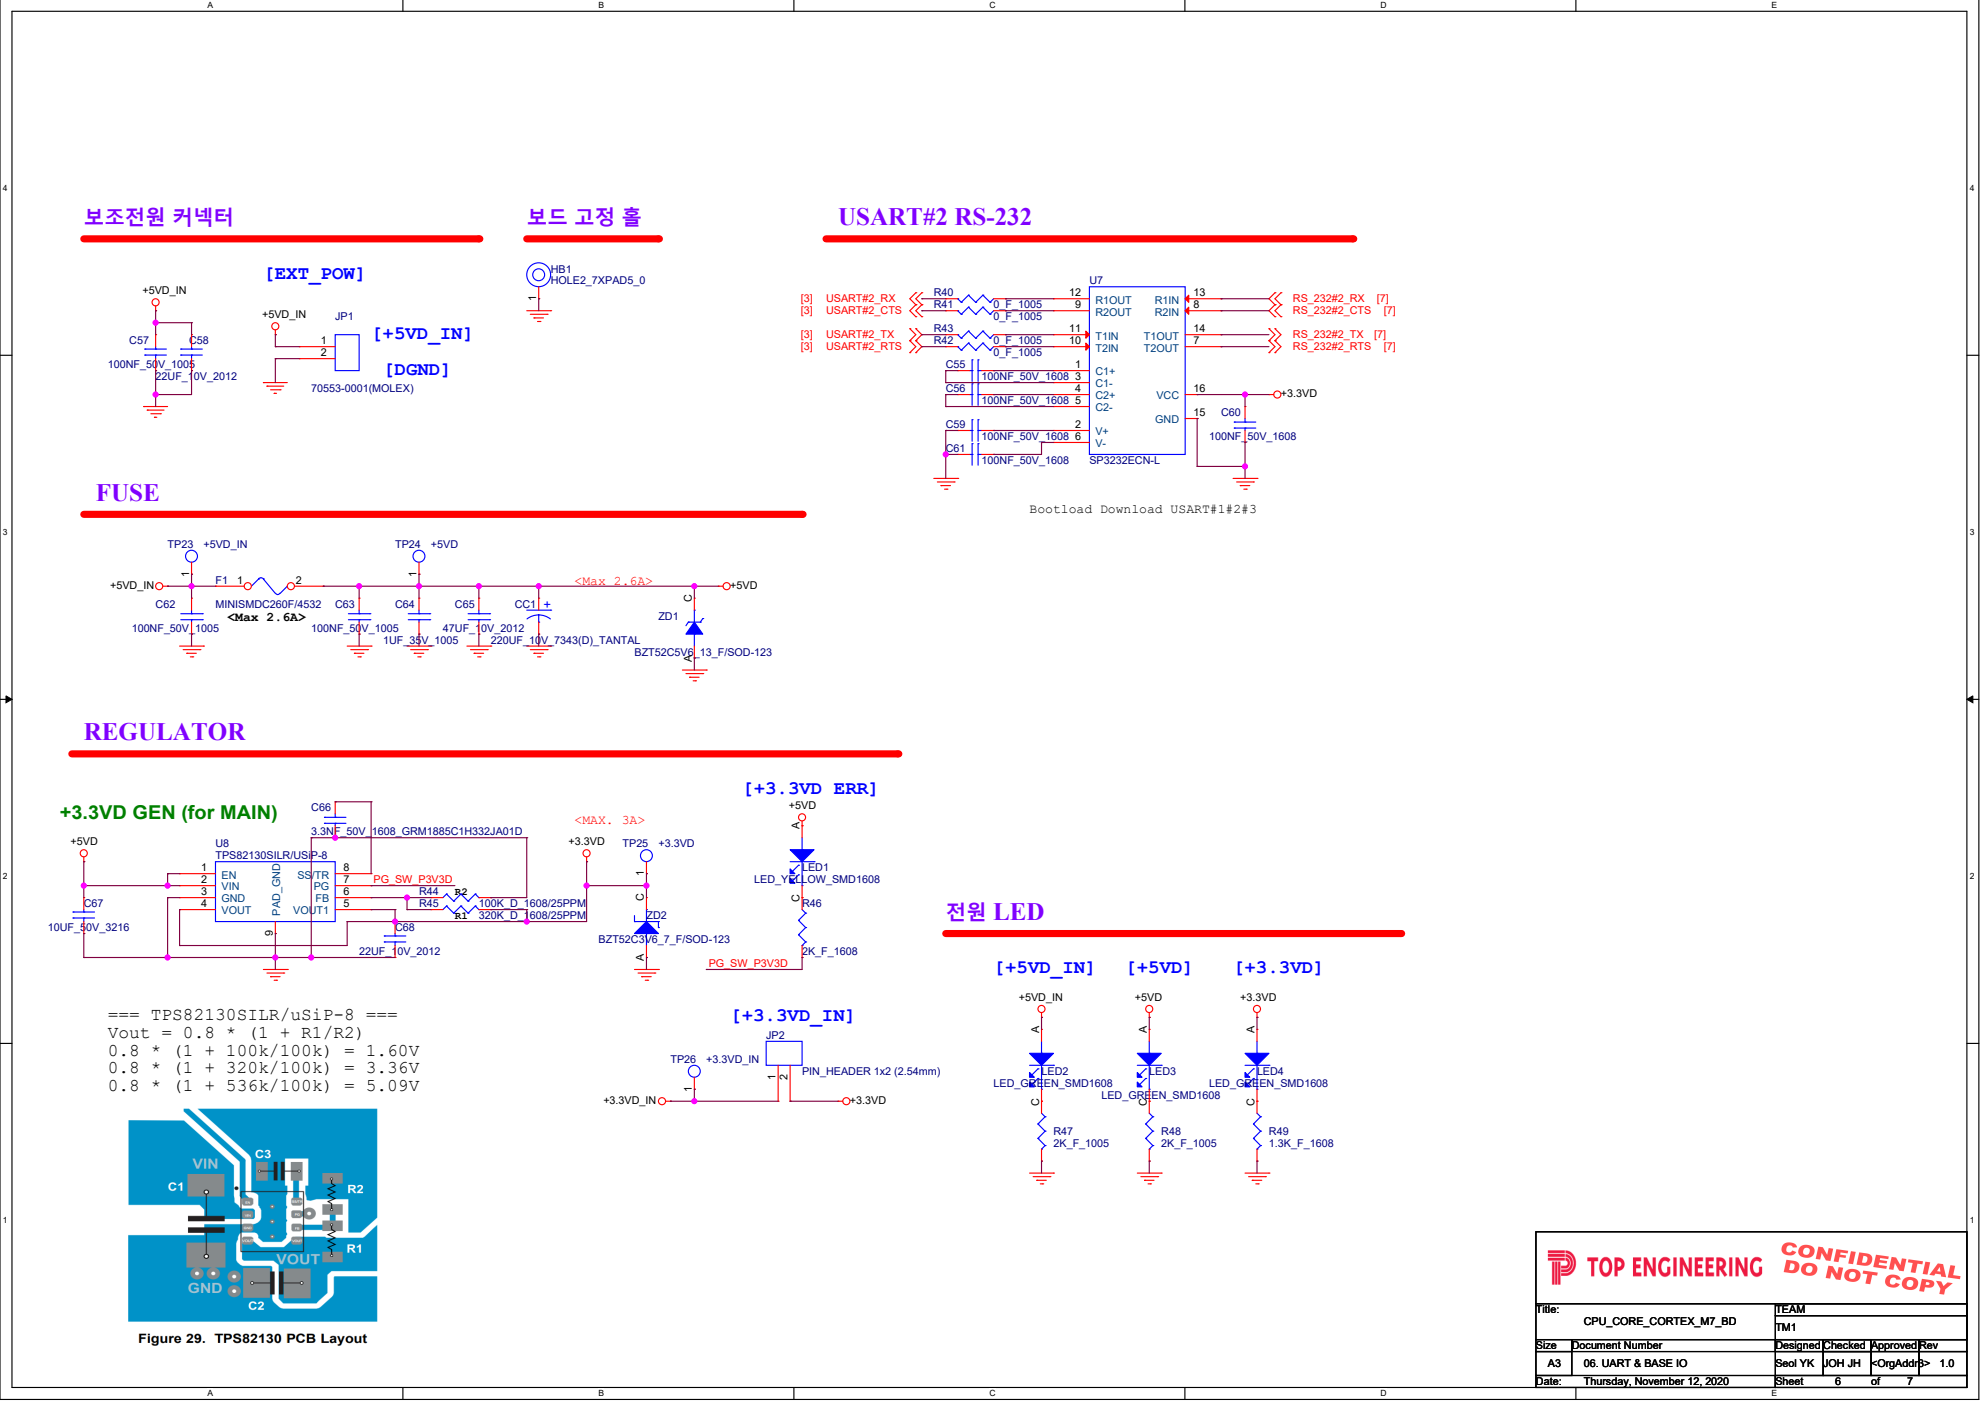
[picture p45: page 6]

# CONNECTOR (BOTTOM)

[OK]

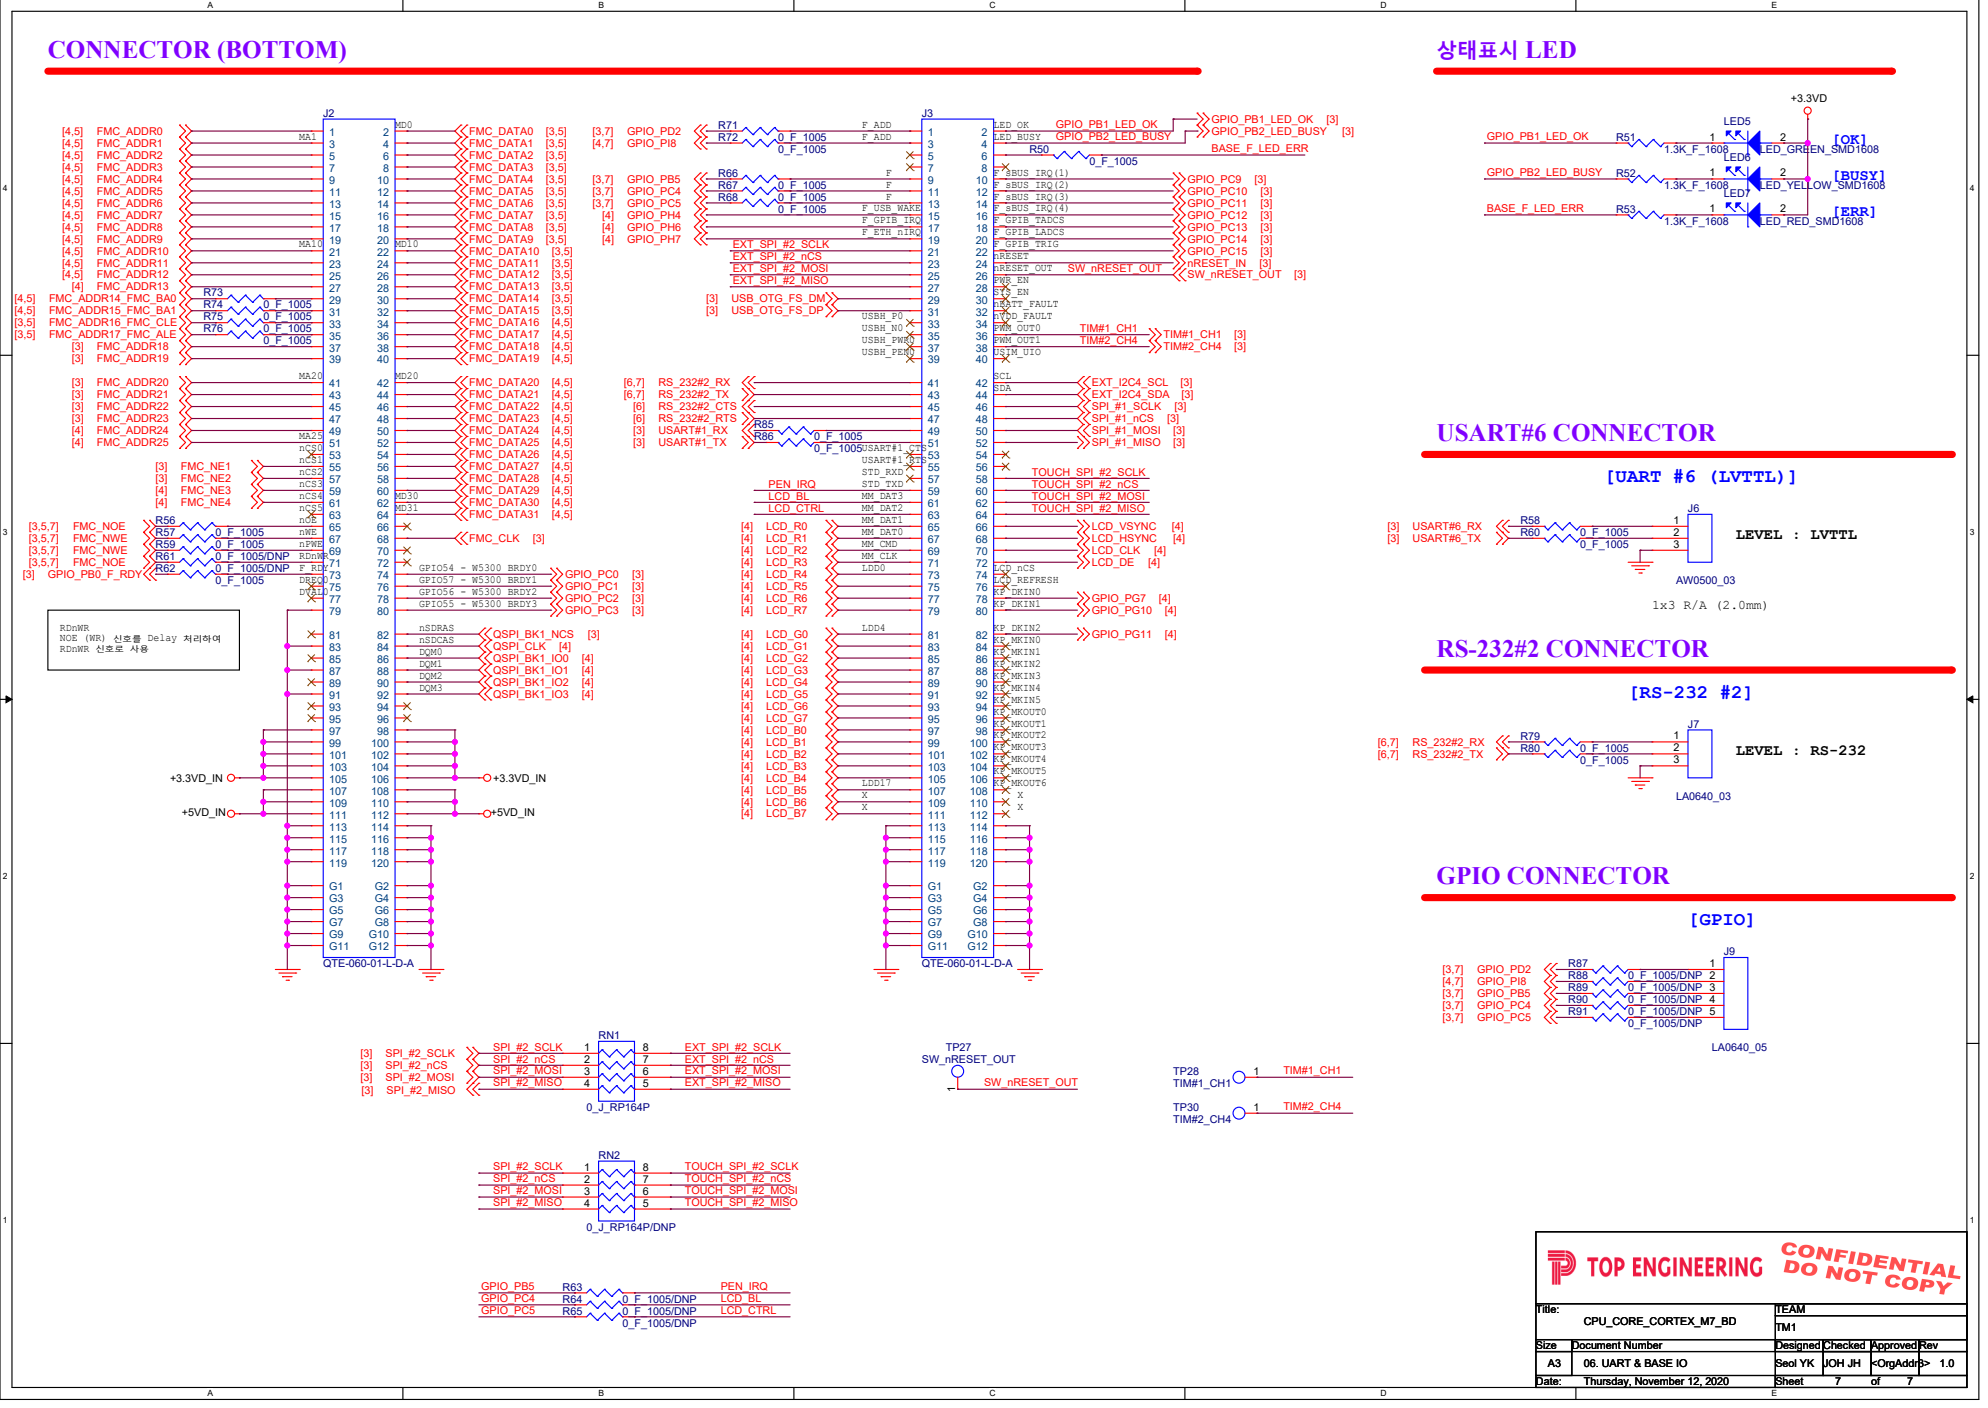
[picture p46: page 7]

RDnWR
NOE (WR) 신호를 Delay 처리하여
RDnWR 신호로 사용
