lastoyz/dsn_pgu_adda_s3100_git/dsn/1.sch/_ref/FPGA_MODULE_V11_20200812-4M.pdf

Designed | By: | YK | SEOL
Checked | & | Approved | By: | JH | Cho

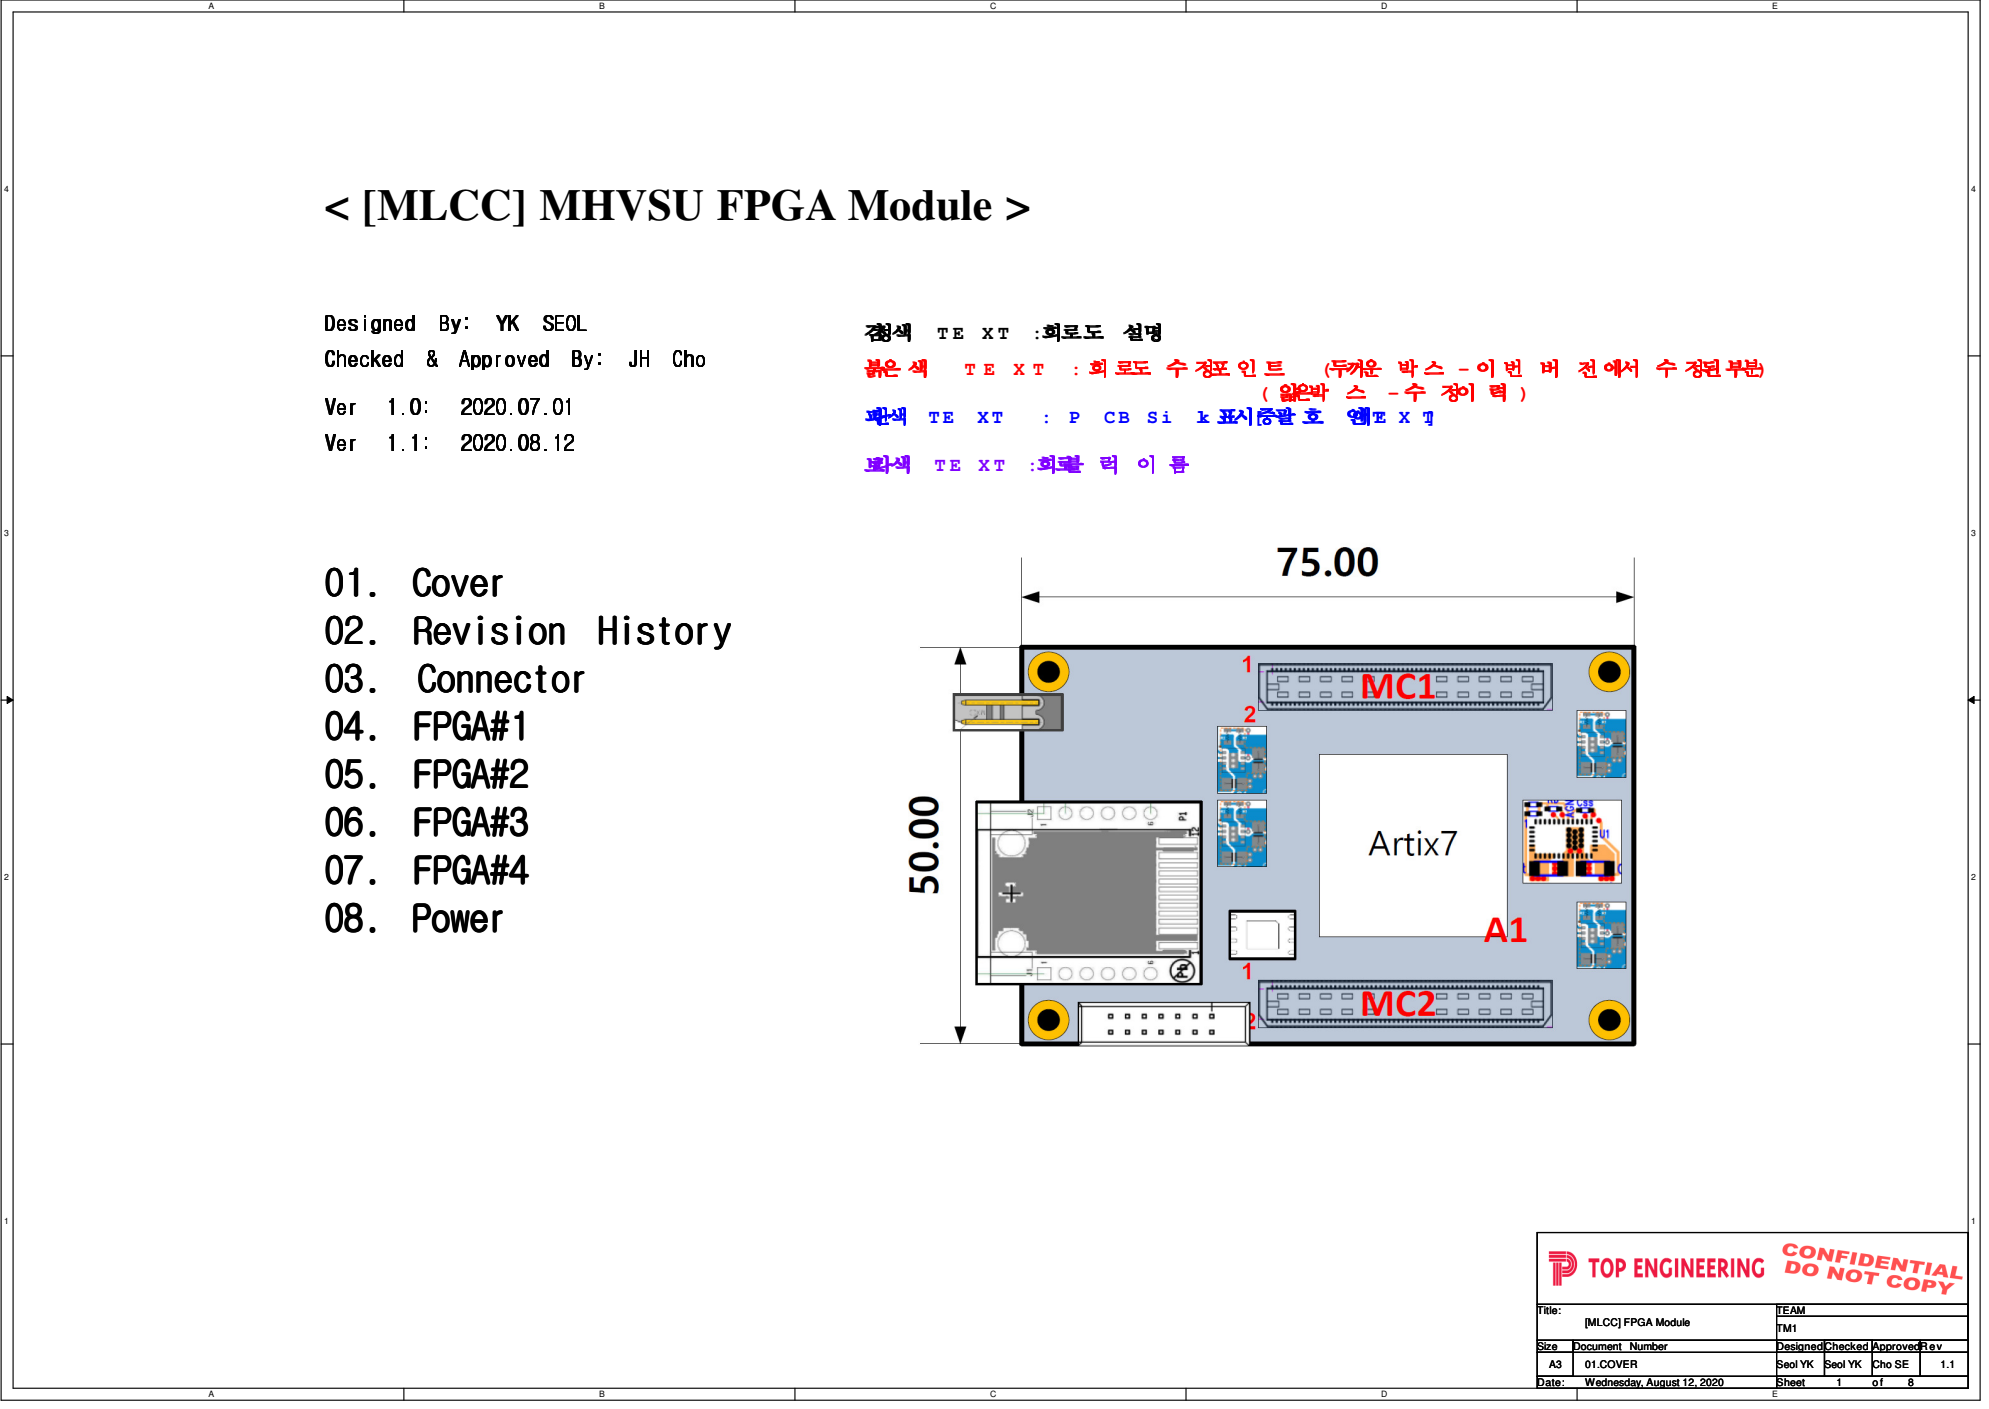
[picture p47: page 1]
01. Cover; 04. FPGA#1; 08. Power; 03. Connector; Ver; 02. Revision History; 검검검; : 회회회; 파파검 T E; 보보검 T E X T; : 회회회 회 이 이; (두두두 박 박 - 이 이 이 이 안이 수 검수부부); ( 얇붉박 박; 05. FPGA#2 06. FPGA#3 07. FPGA#4; Title:; Size; Document Number; Date:; Sheet; Designed Checked Approved; TEAM; 01.COVER; Seol YK Seol YK Cho SE; Wednesday, August 12, 2020

< [MLCC] MHVSU FPGA Module >

[MLCC] FPGA Module

Date | Version

## Revision

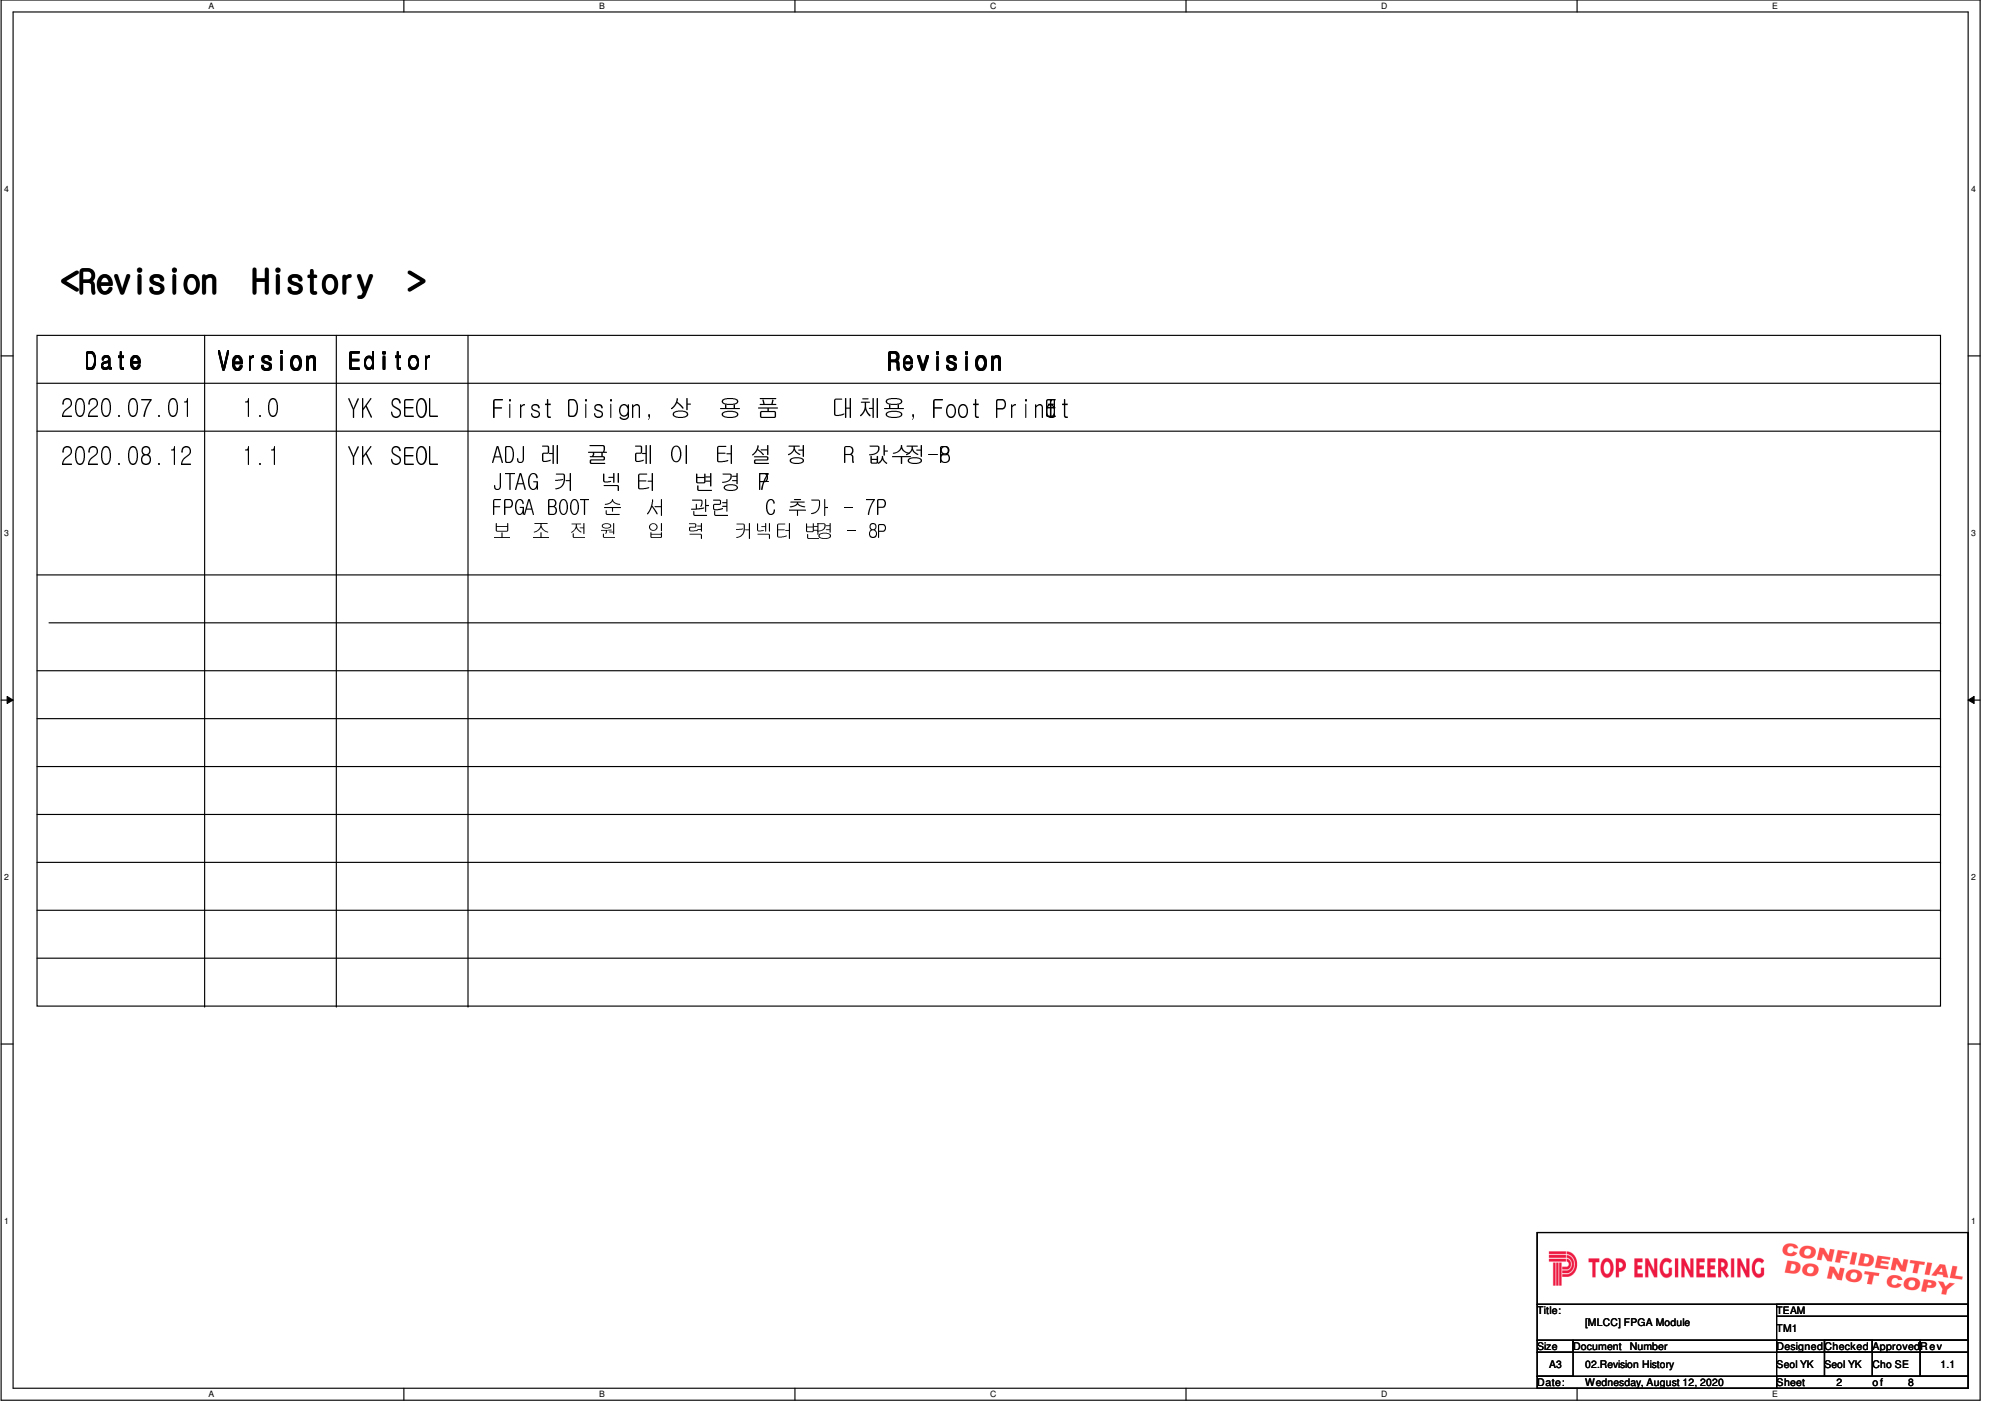
[picture p48: page 2]
First Disign,; 대체용,; Foot Print Edit; <Revision History >; Editor; YK SEOL; ADJ 레; JTAG 커; FPGA BOOT 순; 커넥터 변경 -; 02.Revision History; Wednesday, August 12, 2020

# MHVSU BASE BD 커커커 (BOTTOM) +5VD_IN

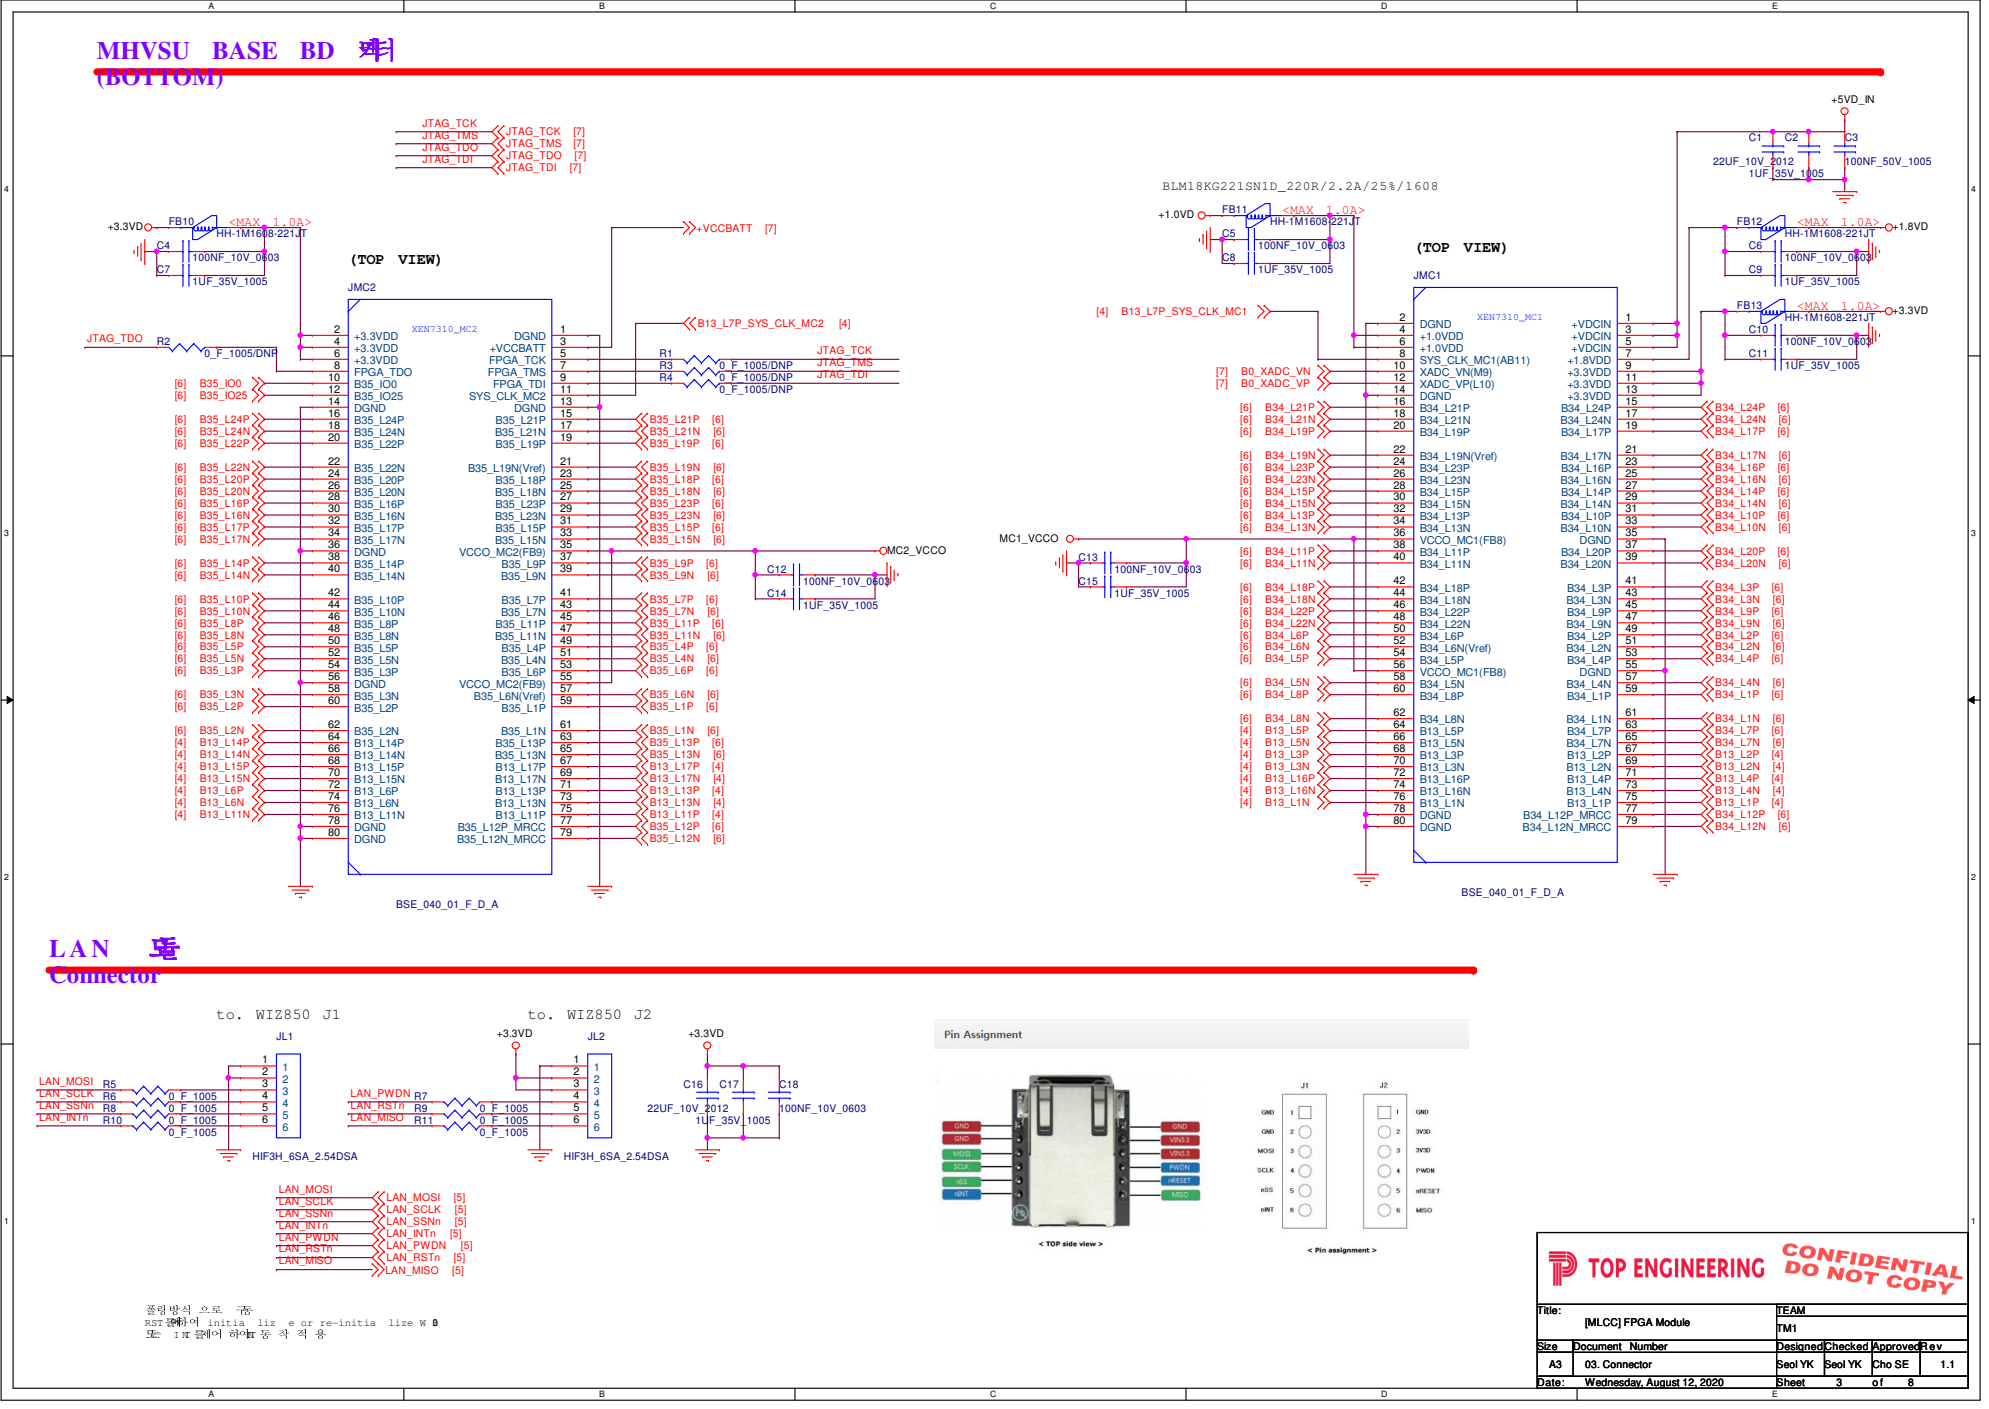
[picture p49: page 3]

(TOP VIEW)

BANK 13 : MC1 & MC2 | BANK 14 : FPGA CONFIG & GPIO
FPGA - BANK 13 | FPGA - BANK 14

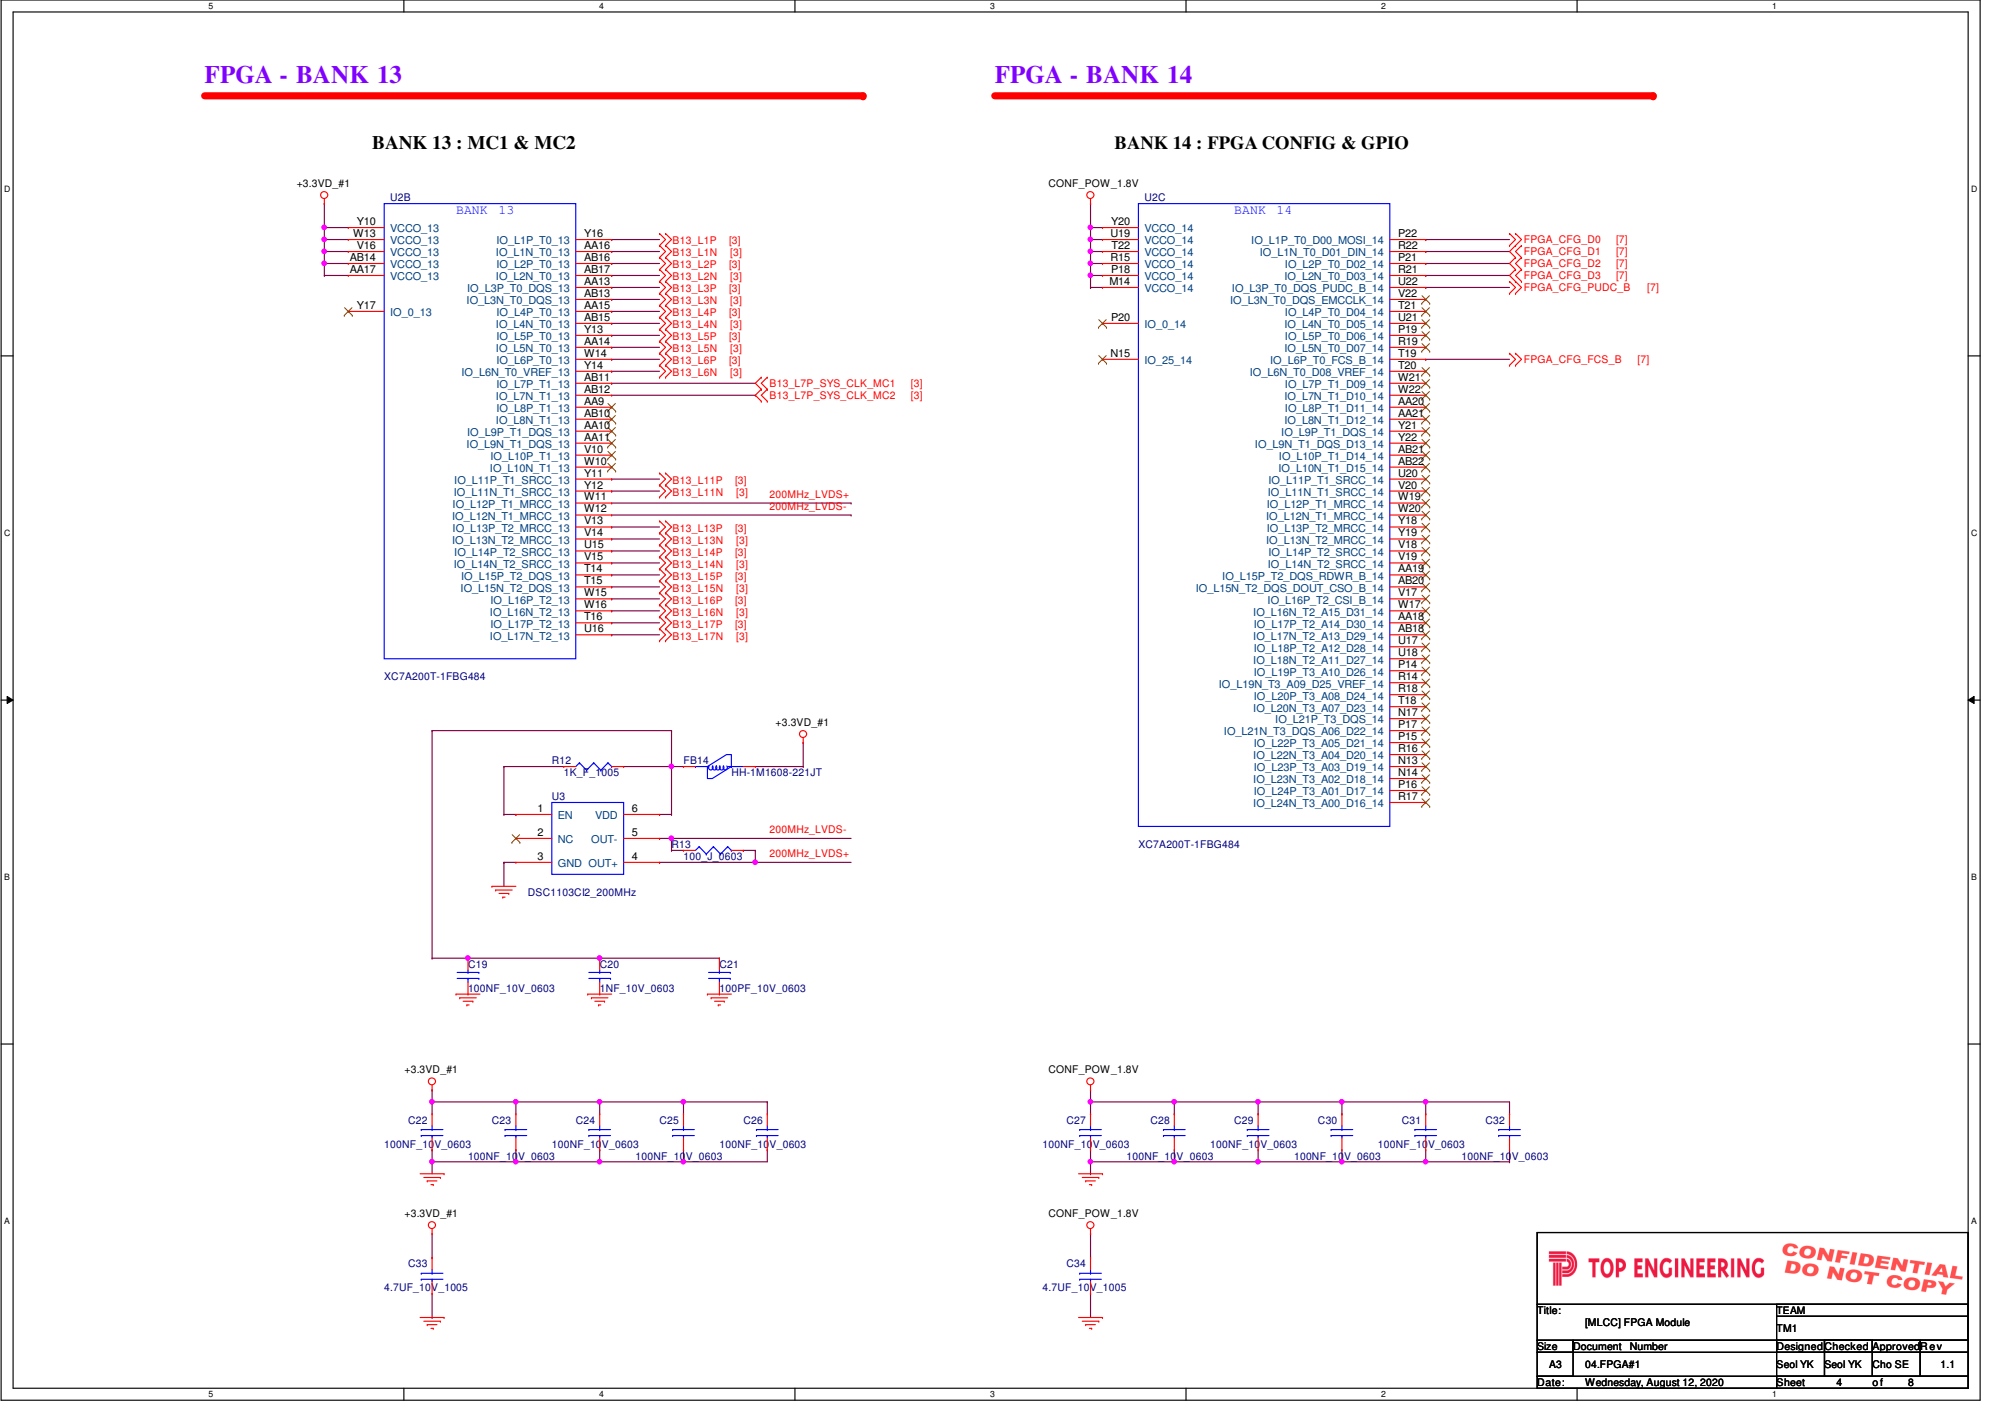
[picture p50: page 4]

BANK 15 : LAN CONTROL | BANK 16 : TP & LED
FPGA - BANK 15 | FPGA - BANK 16

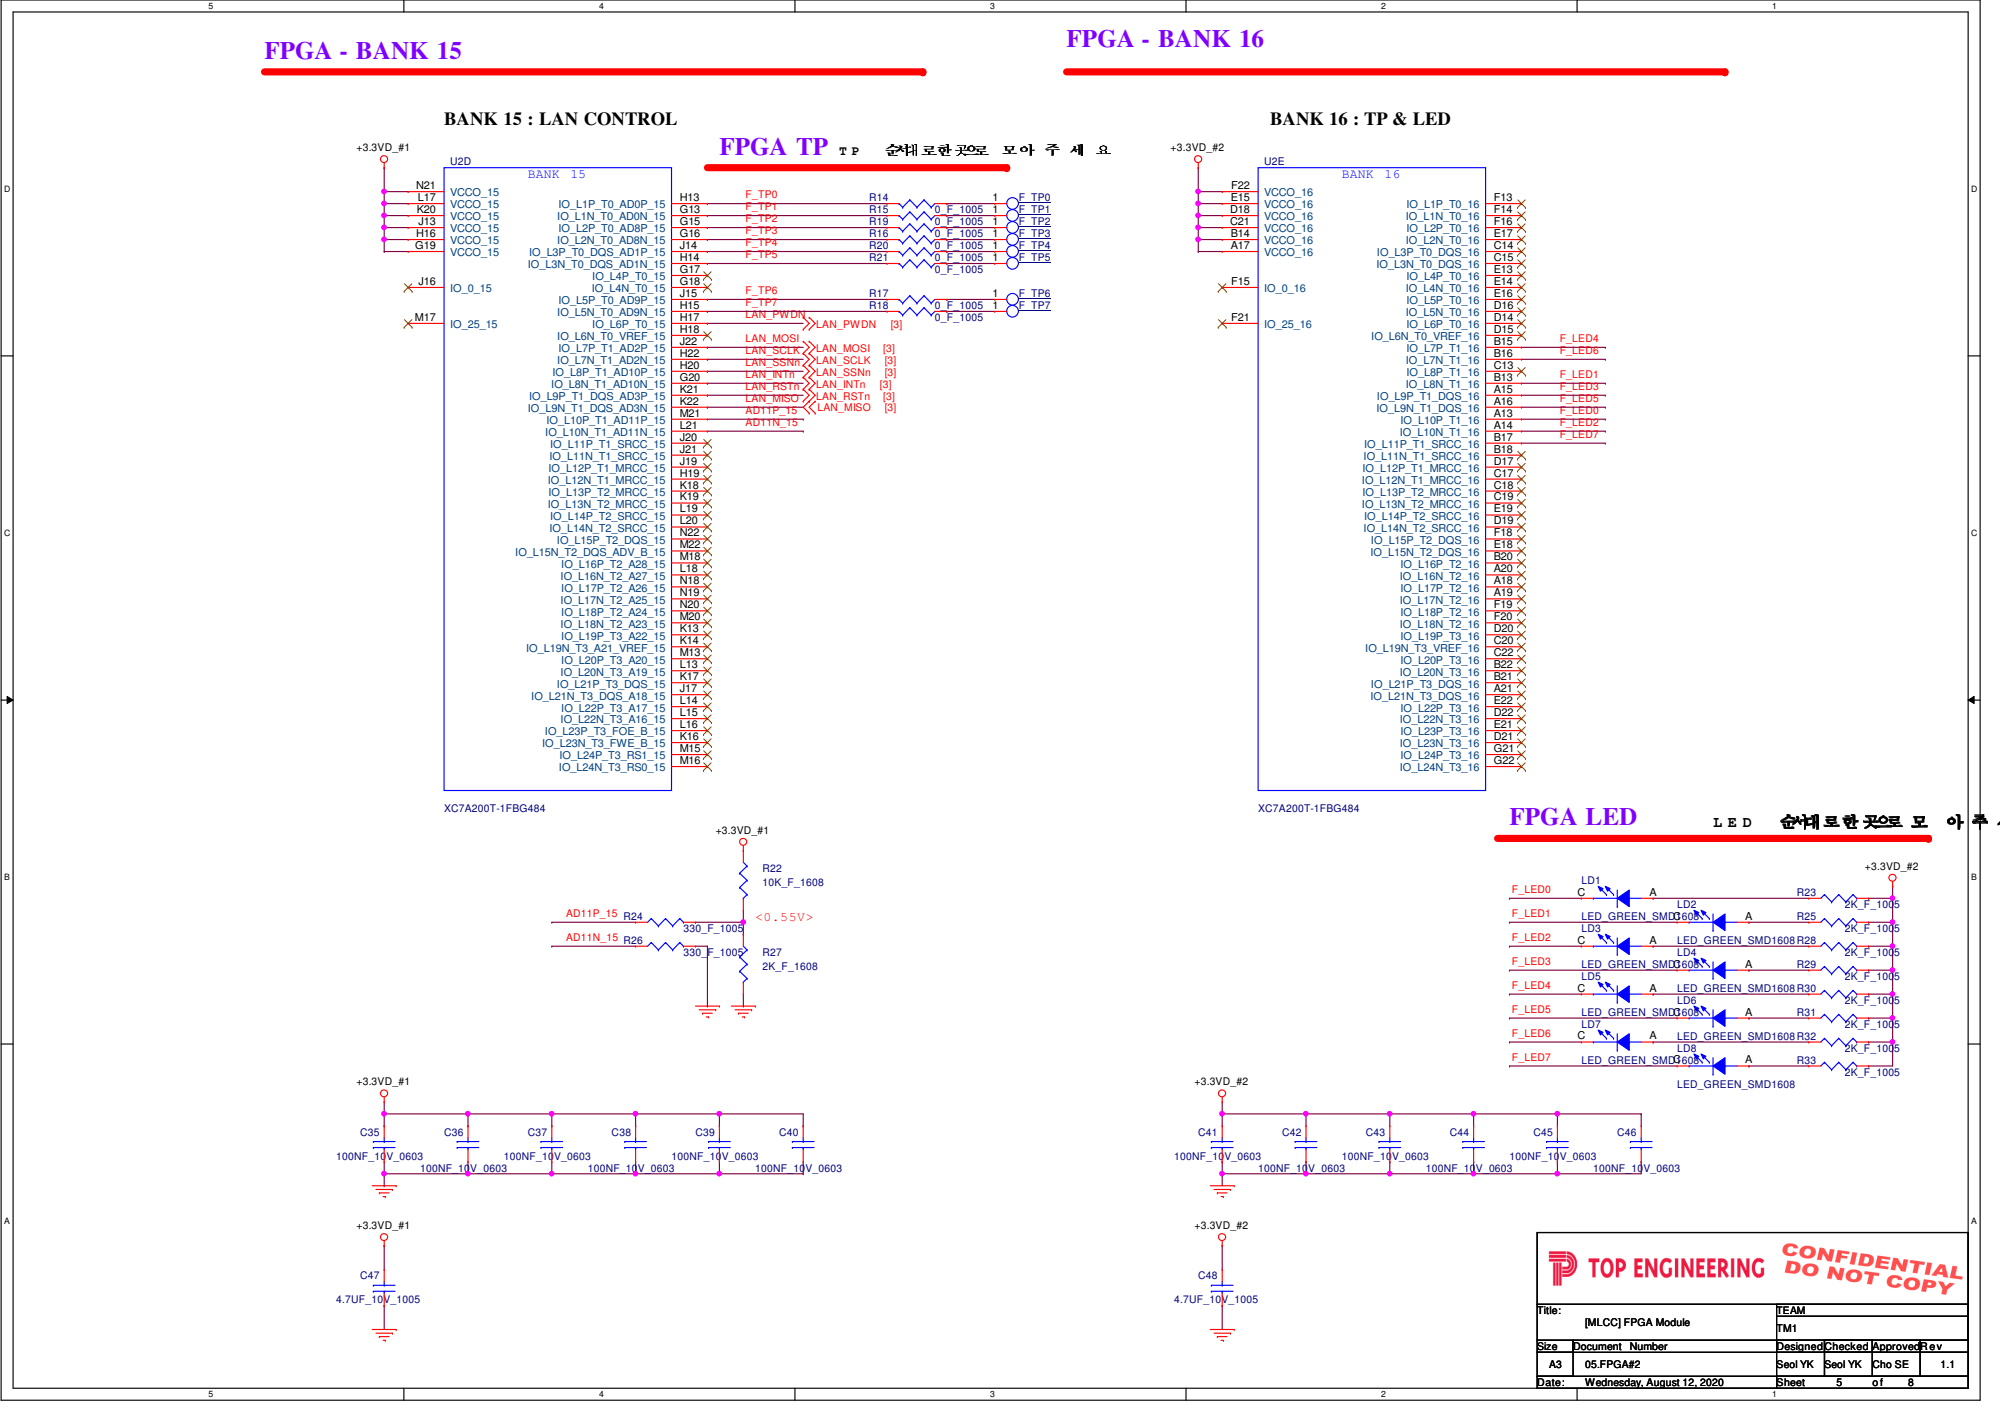
[picture p51: page 5]

BANK 34 : MC1 | BANK 35 : MC2

## BANK 216 : MGT (NOT USED)

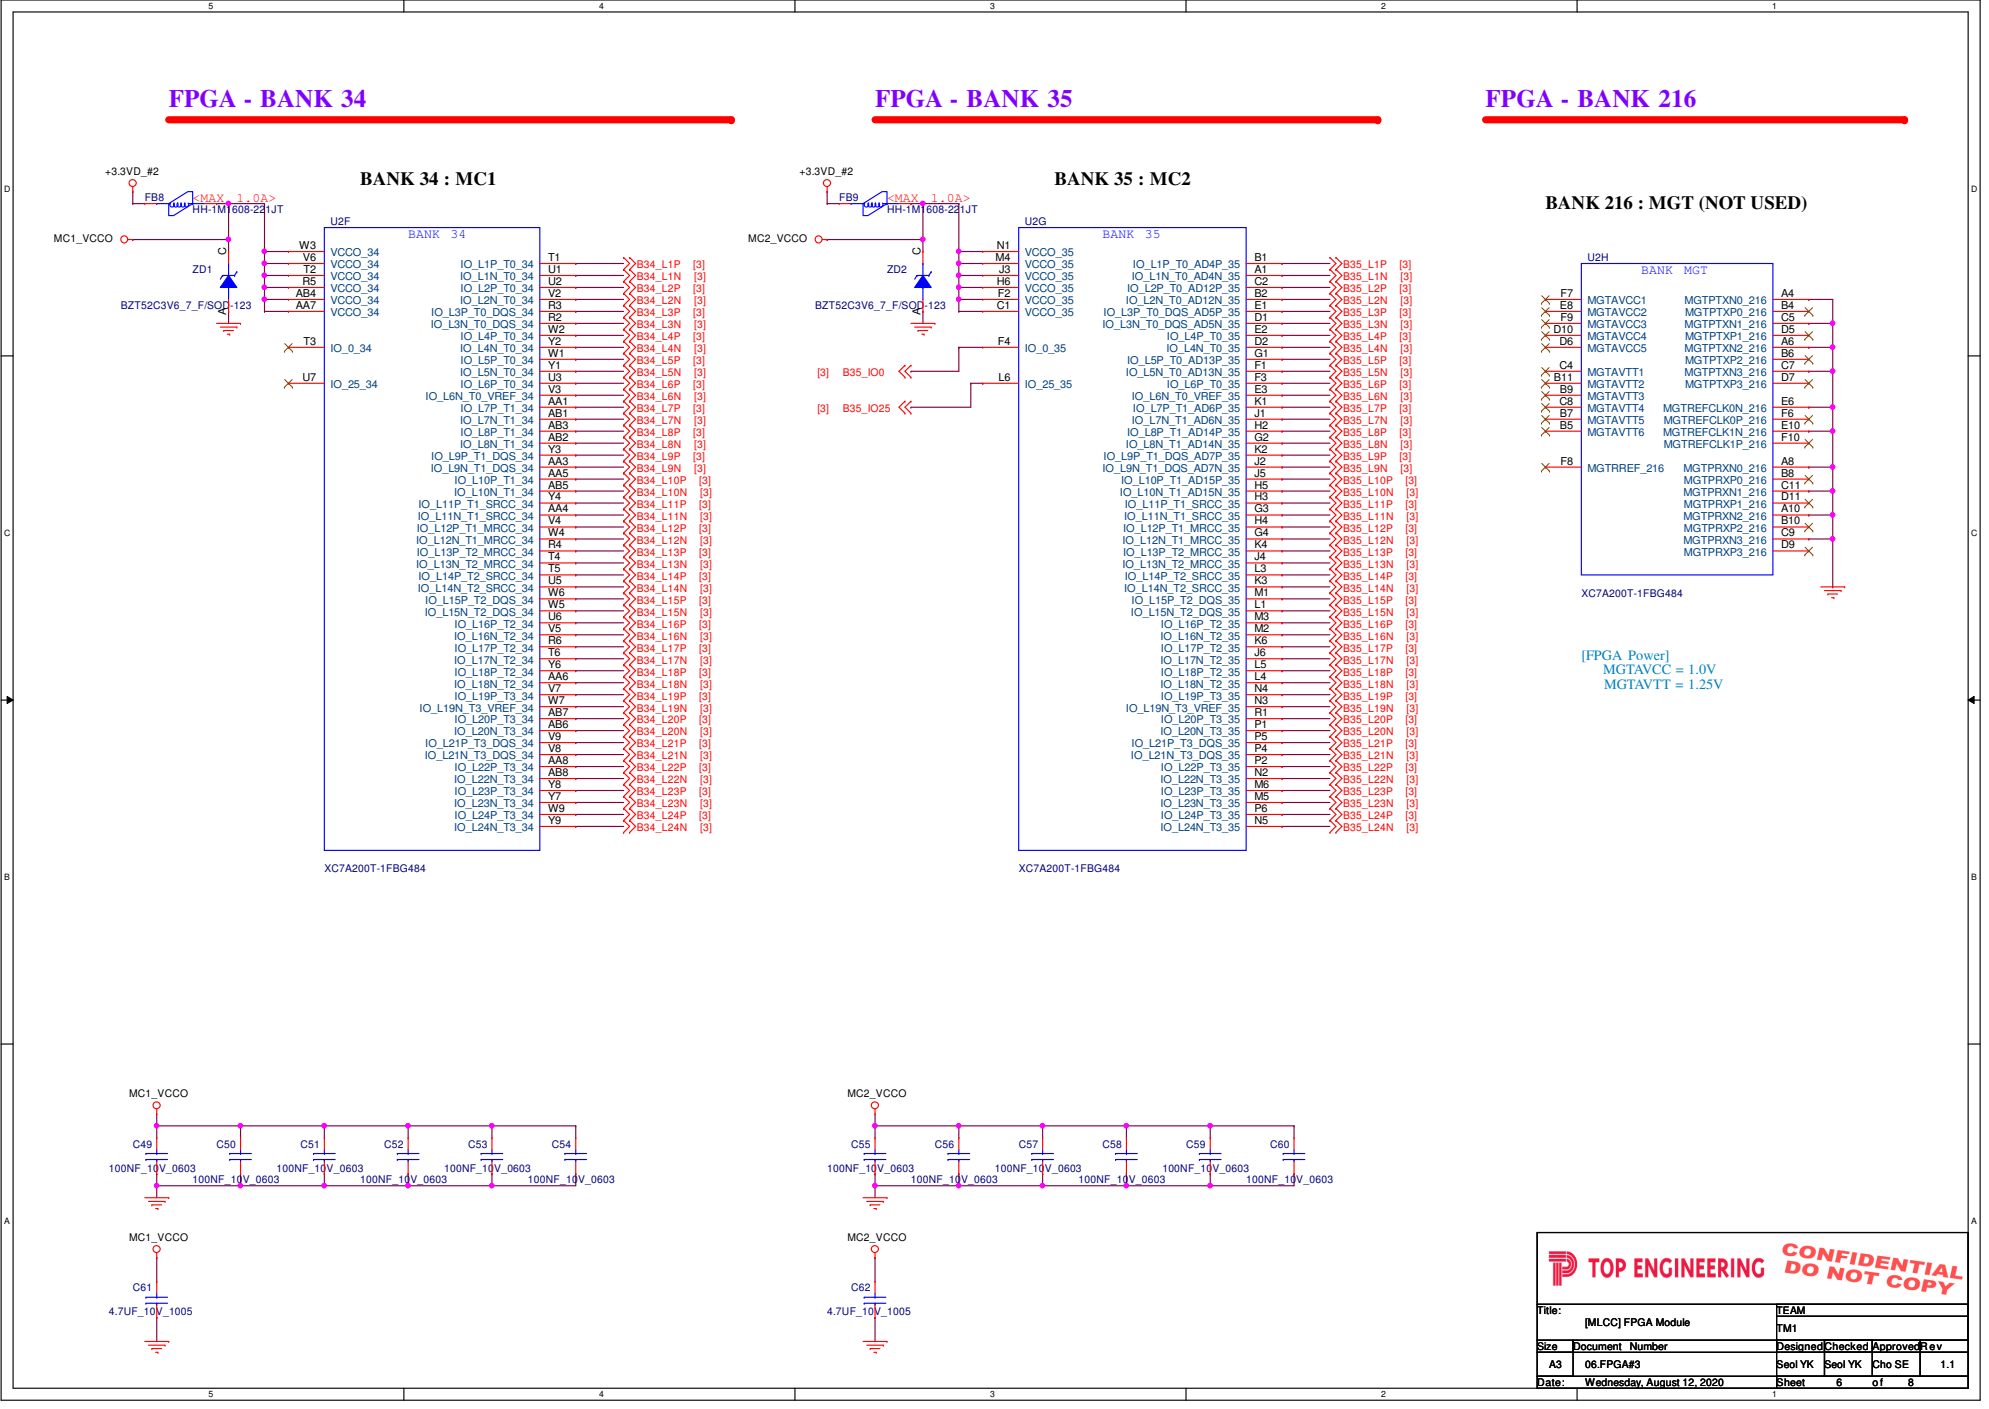
[picture p52: page 6]

D | D
C | C
B | B
A | A

Pull-Up During Configuration (bar)
Active-Low PUDC_B input enables internal pull-up resistors on the SelectIO pins after power-up and during configuration.
> When PUDC_B is Low, internal pull-up resistors are enabled on each SelectIO pin.
> When PUDC_B is High, internal pull-up resistors are disabled on each SelectIO pin.
PUDC_B must be tied either directly, or via a ≤ 1kΩ to VCCO_14 or GND.
Caution! Do not allow this pin to float before and during configuration

If the TCK signal is
buffered, connect the buffer input to an external weak (e.g. 10 kΩ ) pull-up resistor to maintain a valid High when no cable is connected.

If the TMS signal is buffered, connect the buffer
input to an external weak (e.g. 10 kΩ ) pull-up resistor to maintain a valid High when no cable is connected.

VCCBATT is required only when using bitstream encryption. If battery is not used, connect VCCBATT
to either ground or VCCAUX.

If the VCCO_0 supply for bank 0 is
supplied with 2.5V or 3.3V, then the CFGBVS pin must be tied High (i.e. connected to VCCO_0). Tie CFGBVS to Low (i.e. connected to GND), only if the VCCO_0 for bank

### 0 is less than or equal to 1.8V. If used during

configuration, banks 14 and 15 should match the VCCO level applied to bank 0

Configuration Mode Sel (M2:0)
- Master SPI: 001
- Master Serial: 000
- JTAG: 101

S25FL256SAGNFI001

S25FL128SAGNFI001

MT25QU256ABA1EW9_0SIT MT25QL = 2.7V ~ 3.6V MT25QU = 1.7V ~ 2.0V

[FPGA Power]
VCCINT = -0.5~1.1 [1.0V]
VCCBRAM = -0.5~1.1 [1.0V]
VCCAUX = -0.5 ~ 2.0V [1.8V]
VCCAUX_IO = -0.5 ~ 2.0V [1.8V]
VCCO_HR = 1.14~3.465V
VCCO_HP = 1.14~1.89V (Artix7에에없없) VCCBATT = -0.5 ~ 2.0V [1.8V]
FPGA - POWER | FPGA - Configuration Part

[JTAG]

[FPGA Power]
VCCINT = -0.5~1.1 [1.0V]
VCCBRAM = -0.5~1.1 [1.0V]
VCCAUX = -0.5 ~ 2.0V [1.8V]
VCCAUX_IO = -0.5 ~ 2.0V [1.8V]
VCCO_HR = 1.14~3.465V
VCCO_HP = 1.14~1.89V (Artix7에에없없) VCCBATT = -0.5 ~ 2.0V [1.8V]
VCCADC = -0.5 ~ 2.0V [1.8V]

[FPGA Power]
VCCADC = -0.5 ~ 2.0V [1.8V] VREF = -0.5 ~ 2.0V [1.25V]
to GNDADC

<MAX 1.0A>

Temperature-sensing diode pins (Anode: DXP; Cathode:
DXN). The thermal diode is accessed by using the DXP and DXN pins in bank 0. When not used, tie to GND.

Program (bar)
Active-Low reset to configuration logic. When PROGRAM_B is pulsed Low, the FPGA configuration is cleared and a new configuration sequence is initiated. Configuration reset initiated upon falling edge, and configuration (i.e. programming) sequence begins upon the following rising edge.
Connect PROGRAM_B to an external ≤ | 4.7 kΩ | pull-up
resistor to VCCO_0 to ensure a stable High input, and recommend push-button to GND to enable manual configuration reset.

Initialization (bar)
Active-Low FPGA initialization pin or configuration error signal. The FPGA drives this pin Low when the FPGA is in a configuration reset state, when the FPGA is initializing (clearing) its configuration memory, or when the FPGA has detected a configuration error. Upon completing the FPGA initialization process, INIT_B is released to high-Z at which time an external resistor is expected to pull INIT_B High. INIT_B can externally be held Low during power-up to stall the power-on configuration sequence at the end of the initialization process. When a High is detected at the INIT_B input after the initialization process, the FPGA proceeds with the remainder of the configuration sequence dictated by the M[2:0] pin settings.
Connect INIT_B to a ≤ | 4.7 kΩ | pull-u p resisto r t o VCCO_0
to ensure clean Low-to-High transitions.

Done
A High signal on the DONE pin indicates completion of the configuration sequence. The DONE output is an open-drain output by default.

### 1 차 제동제 실실 커커커 연 연 실 수

<Ver 1.1 Edit>

<Ver 1.1 Add>

JTAG_TCK

JTAG_TDO

JTAG_TMS

JTAG_TDI

JTAG_TCK

FPGA_DONE

FPGA_INIT_B
FPGA_PROG_B

FPGA_M2

FPGA_M0

FPGA_M1

FPGA_VBATT
FPGA_CFGBVS

FROM_nHOLD

FROM_DQ2/nW

FROM_nS

FROM_nHOLD
FROM_DQ2/nW

FROM_nS

FPGA_CCLK

FPGA_CCLK

FPGA_VBATT

FPGA_CCLK

FPGA_M0
FPGA_M1
FPGA_M2

FPGA_DONE

FPGA_PROG_B

FPGA_CFGBVS

JTAG_TDO
JTAG_TDI

JTAG_TCK
JTAG_TMS

FPGA_INIT_B

VREF+

VREF+

+1.8VD | CONF_POW_1.8V
+1.0VD | +1.8VD | +1.0VD

+1.0VD

+1.0VD

+1.8VD

+1.8VD

+1.0VD

+1.0VD

+1.8VD | VCC_ADC | VCC_ADC

VCC_ADC

CONF_POW_1.8V

CONF_POW_1.8V

CONF_POW_1.8V | CONF_POW_1.8V

CONF_POW_1.8V

CONF_POW_1.8V

CONF_POW_1.8V

CONF_POW_1.8V

[4] FPGA_CFG_PUDC_B
[4] FPGA_CFG_D1

FPGA_CFG_D0 [4]

[4] FPGA_CFG_FCS_B
FPGA_CFG_D2 [4]
[4] FPGA_CFG_D3

JTAG_TCK [3]
JTAG_TMS [3]
JTAG_TDI | [3]
JTAG_TDO | [3]
B0_XADC_VP | [3]
B0_XADC_VN | [3]
[3] +VCCBATT
07.FPGA#4 | 1.1
Wednesday, August 12, 2020 | 7 | 8
07.FPGA#4 | 1.1
Wednesday, August 12, 2020 | 7 | 8
07.FPGA#4 | 1.1
Wednesday, August 12, 2020 | 7 | 8

R60
1K_F_1005/DNP

C71

100NF_10V_0603

R40
10K_F_1005

C96

4.7UF_10V_1005

R48
4.7K_F_1005

R64
51_F_1005

C92

100NF_10V_0603

R54
1K_F_1005

JTAG

J3

87831-1420

GND 1 | CONF_POW | 2
GND 3 | JTAG_TMS | 4
GND 5 | JTAG_TCK | 6
GND 7 | JTAG_TDO | 8
GND 9 | JTAG_TDI | 10
GND 11 | N.C12 | 12
GND 13 | N.C14 | 14

R42
10K_F_1005/DNP

C72

100NF_10V_0603

C95

22UF_6.3V_1608

R44
10K_F_1005

R62
51_F_1608

C73

100NF_10V_0603

C66

100NF_10V_0603

R41
0_F_1005

C87

100NF_10V_0603

R52
330_F_1005

C93

22UF_6.3V_1608

R46
10K_F_1005

R43
0_F_1005

C74

100NF_10V_0603

R65
51_F_1608

C65

470NF_6.3V_0603

R50
4.7K_F_1005

C77

100NF_50V_1005

R66
51_F_1005

U5

REF3012AIDBZR

IN 1 | OUT | 2

GND

3

BANK 0

XC7A200T-1FBG484

U2A

VCCO_0 T12
VCCO_0 F12
DXN_0 | N9
VCCADC_0 | K10
GNDADC_0 | K9
DXP_0 | N10
VREFN_0 | L9 VREFP_0 | M10
VP_0 | | L10
VN_0 | | M9

VCCBATT_0 E12

CCLK_0 L12

TDO_0 | U13
TDI_0 | R13
TMS_0 | T13 TCK_0 | V12
INIT_B_0 | U12

PROGRAM_B_0 N12

CFGBVS_0 U8

DONE_0 G11

M2_0 U9

M0_0 U11
M1_0 U10

XC7A200T-1FBG484

U2J

VCCINT T8
VCCINT T10
VCCINT R9
VCCINT R7
VCCINT P10
VCCINT P8
VCCINT N7
VCCINT M8
VCCINT K8
VCCINT L7
VCCINT J9
VCCINT J7
VCCINT H8
VCCINT H10
VCCAUX | R11
VCCAUX | P12
VCCAUX | M12
VCCAUX | K12
VCCAUX | H12
VCCBRAM | N11
VCCBRAM | L11
VCCBRAM | J11

R68
100_F_1005/DNP

C75

100NF_10V_0603

R45
0_F_1005

C78

100NF_10V_0603

C94

4.7UF_10V_1005

C69

10NF_6.3V_0603 | R37
1K_F_1005

C80

100NF_10V_0603

R67
100_F_1005/DNP

C76

100NF_10V_0603

R49
2.4K_F_1005

R57
1K_F_1005/DNP

C63

10NF_6.3V_0603

C79

100NF_10V_0603

C118

100NF_50V_1608

C88

100NF_50V_1005

R55
1K_F_1005/DNP

C64

22UF_10V_2012

R51
4.7K_F_1005

R56
1K_F_1005

C81

100NF_10V_0603

C68

100NF_50V_1005

R35
0_F_1005

C89

100NF_10V_0603

R38
1K_F_1005

C67

1UF_35V_1005

C84

100NF_50V_1005

C119

100NF_50V_1608

FB15
HH-1M1608-221JT

R59
1K_F_1005/DNP

R53
4.7K_F_1005

R47
1K_F_1005

C82

100NF_10V_0603

U6

MT25QU128ABA1EW9_0SIT

VCC 8 | DQ0 | 5

S# 1

| W/VPP/DQ2 | 3
| C | 6

DQ1 2

VSS 4

HOLD/DQ3 7

EPAD

9

C85

100NF_10V_0603

R58
1K_F_1005

C91

100NF_10V_0603

R34
0_F_1005/DNP

C70

100NF_50V_1005

XC7A200T-1FBG484

U2I

GND W18
GND V21
GND V11
GND V1
GND U14
GND Y15
GND Y5
GND W8
GND T17
GND U4
GND T11
GND T7
GND T9
GND R10
GND R20
GND R12
GND P9
GND P7
GND R8
GND P13
GND P11
GND N8
GND N6
GND P3
GND N16
GND L22
GND L8
GND L2
GND K15
GND M11
GND M7
GND K5
GND M19
GND K11
GND K7
GND J8
GND H21
GND H11
GND H9
GND H7
GND J18
GND J12
GND J10
GND H1
GND | G10
GND | G9
GND | G14
GND | G12
GND | G5
GND | G8
GND | G7
GND | G6
GND | F5
GND | E20
GND | F17
GND | F11
GND | E11
GND | E7
GND | E9
GND | D13
GND | E5
GND | E4
GND | D8
GND | D4
GND | D12
GND | C12
GND | C10
GND | C6
GND | D3
GND | C16
GND | B3
GND | C3
GND | B19
GND | B12
GND | AA22
GND | AA12
GND | AB19
GND | AB9
GND | A22
GND | AA2
GND | A12
GND | A11
GND | A9
GND | A5
GND | A7
GND | A2
GND | A3

R36
0_F_1005

C86

100NF_10V_0603

R63
51_F_1005

FB16
HH-1M1608-221JT

C90

100NF_10V_0603

R61
1K_F_1005

R39
0_F_1005

C83

100NF_10V_0603

## +1.0VD GEN

# Regulator

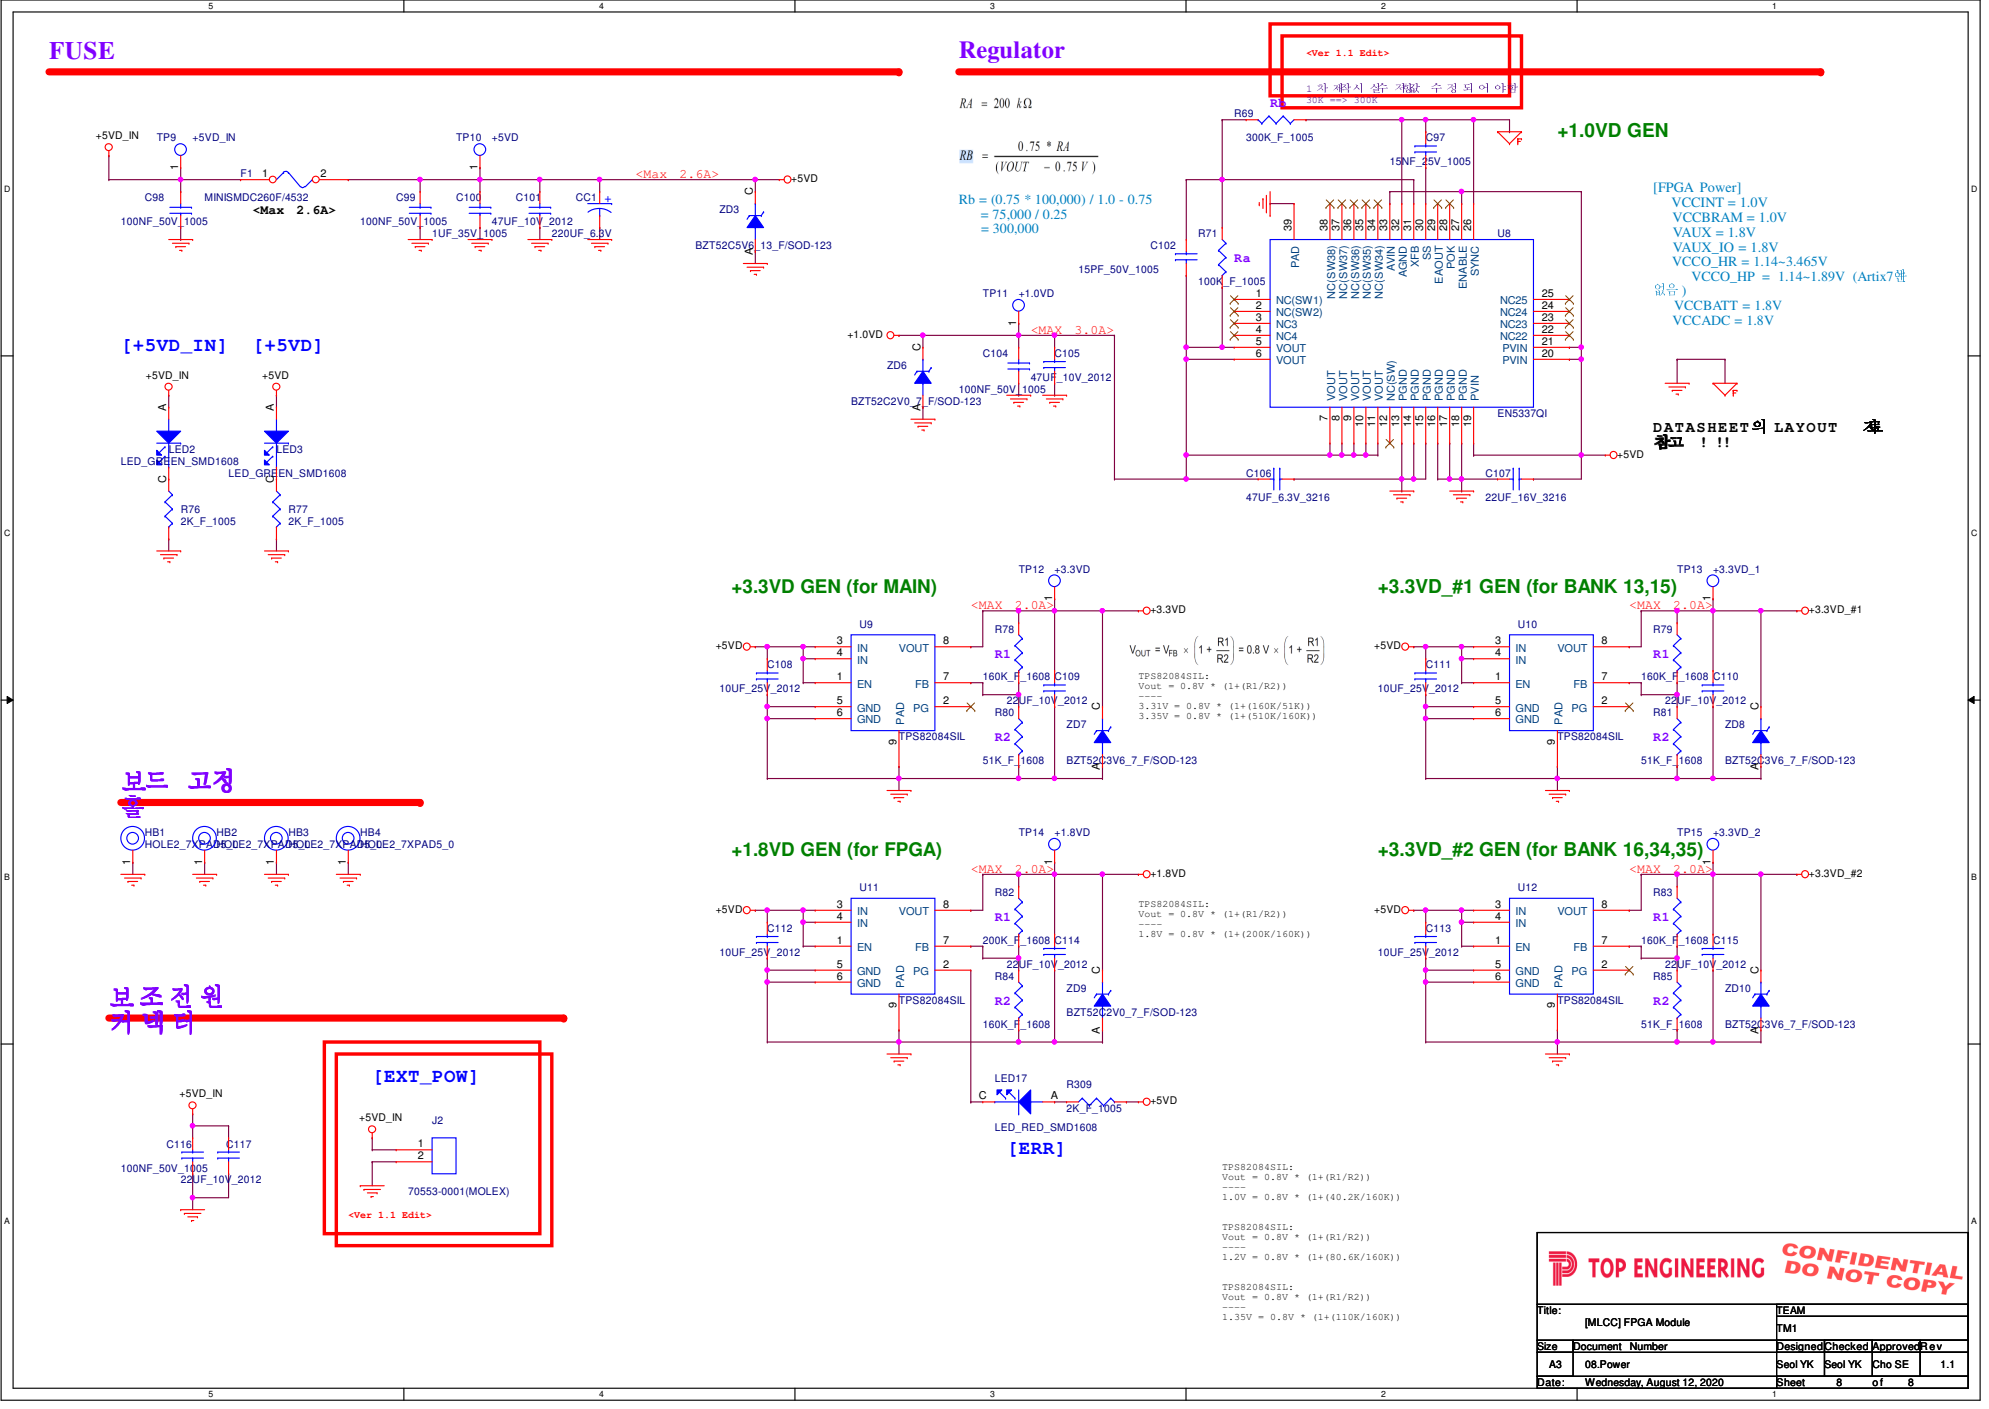
[picture p53: page 8]

1 차 제동제 실실 저저저 실 수 수 제 수수
