lastoyz/dsn_pgu_adda_s3100_git/dsn/1.sch/_ref/hlsmu_20210729.pdf

# Ver 1.0 : 2021.07.12

# Designed By: YK Seul & DH Yoo & SH Yoon

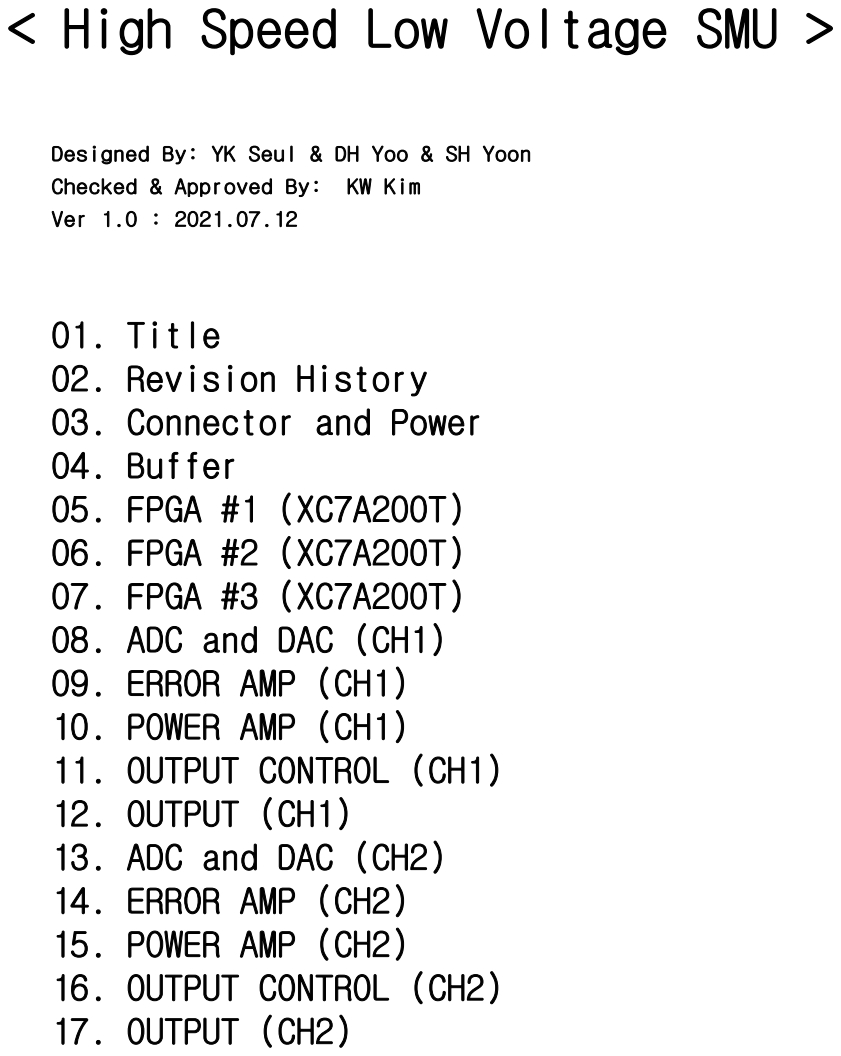
[picture p54: page 1]
Checked & Approved By:; KW Kim; Title:; Size; Document Number; Rev; Date:; Sheet; TEAM; 01. Title; DH YOO; Seol YK; Tuesday, July 27, 2021; TM개발1팀

< High Speed Low Voltage SMU >

01. Title
02. Revision History
03. Connector and Power
04. Buffer
05. FPGA #1 (XC7A200T)
06. FPGA #2 (XC7A200T)
07. FPGA #3 (XC7A200T)
08. ADC and DAC (CH1)
09. ERROR AMP (CH1)
10. POWER AMP (CH1)
11. OUTPUT CONTROL (CH1)
12. OUTPUT (CH1)
13. ADC and DAC (CH2)
14. ERROR AMP (CH2)
15. POWER AMP (CH2)
16. OUTPUT CONTROL (CH2)
17. OUTPUT (CH2)

High Speed & Low Voltage SMU

Designed Checked Approved

Date | Version
2021.07.12 | 24bit Resoultion DAC

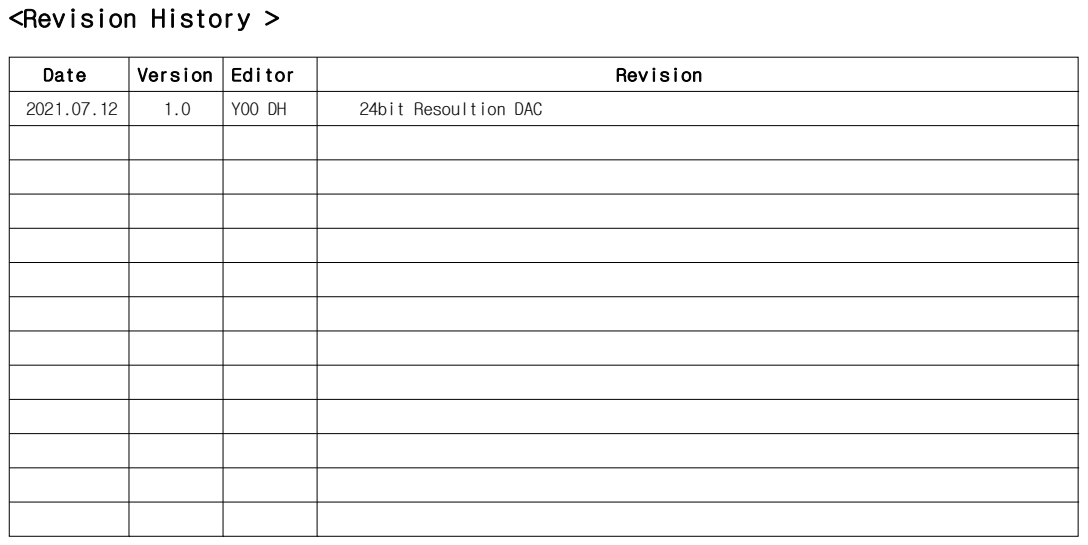
[picture p55: page 2]
Revision; <Revision History >; Editor; YOO DH; 02. Revision History; Tuesday, July 27, 2021

INPUT CONNECTOR | POWER LED & RUN LED | POWER FILTER
[+5VD] | [+3.3VD] | [RUN_FPGA]

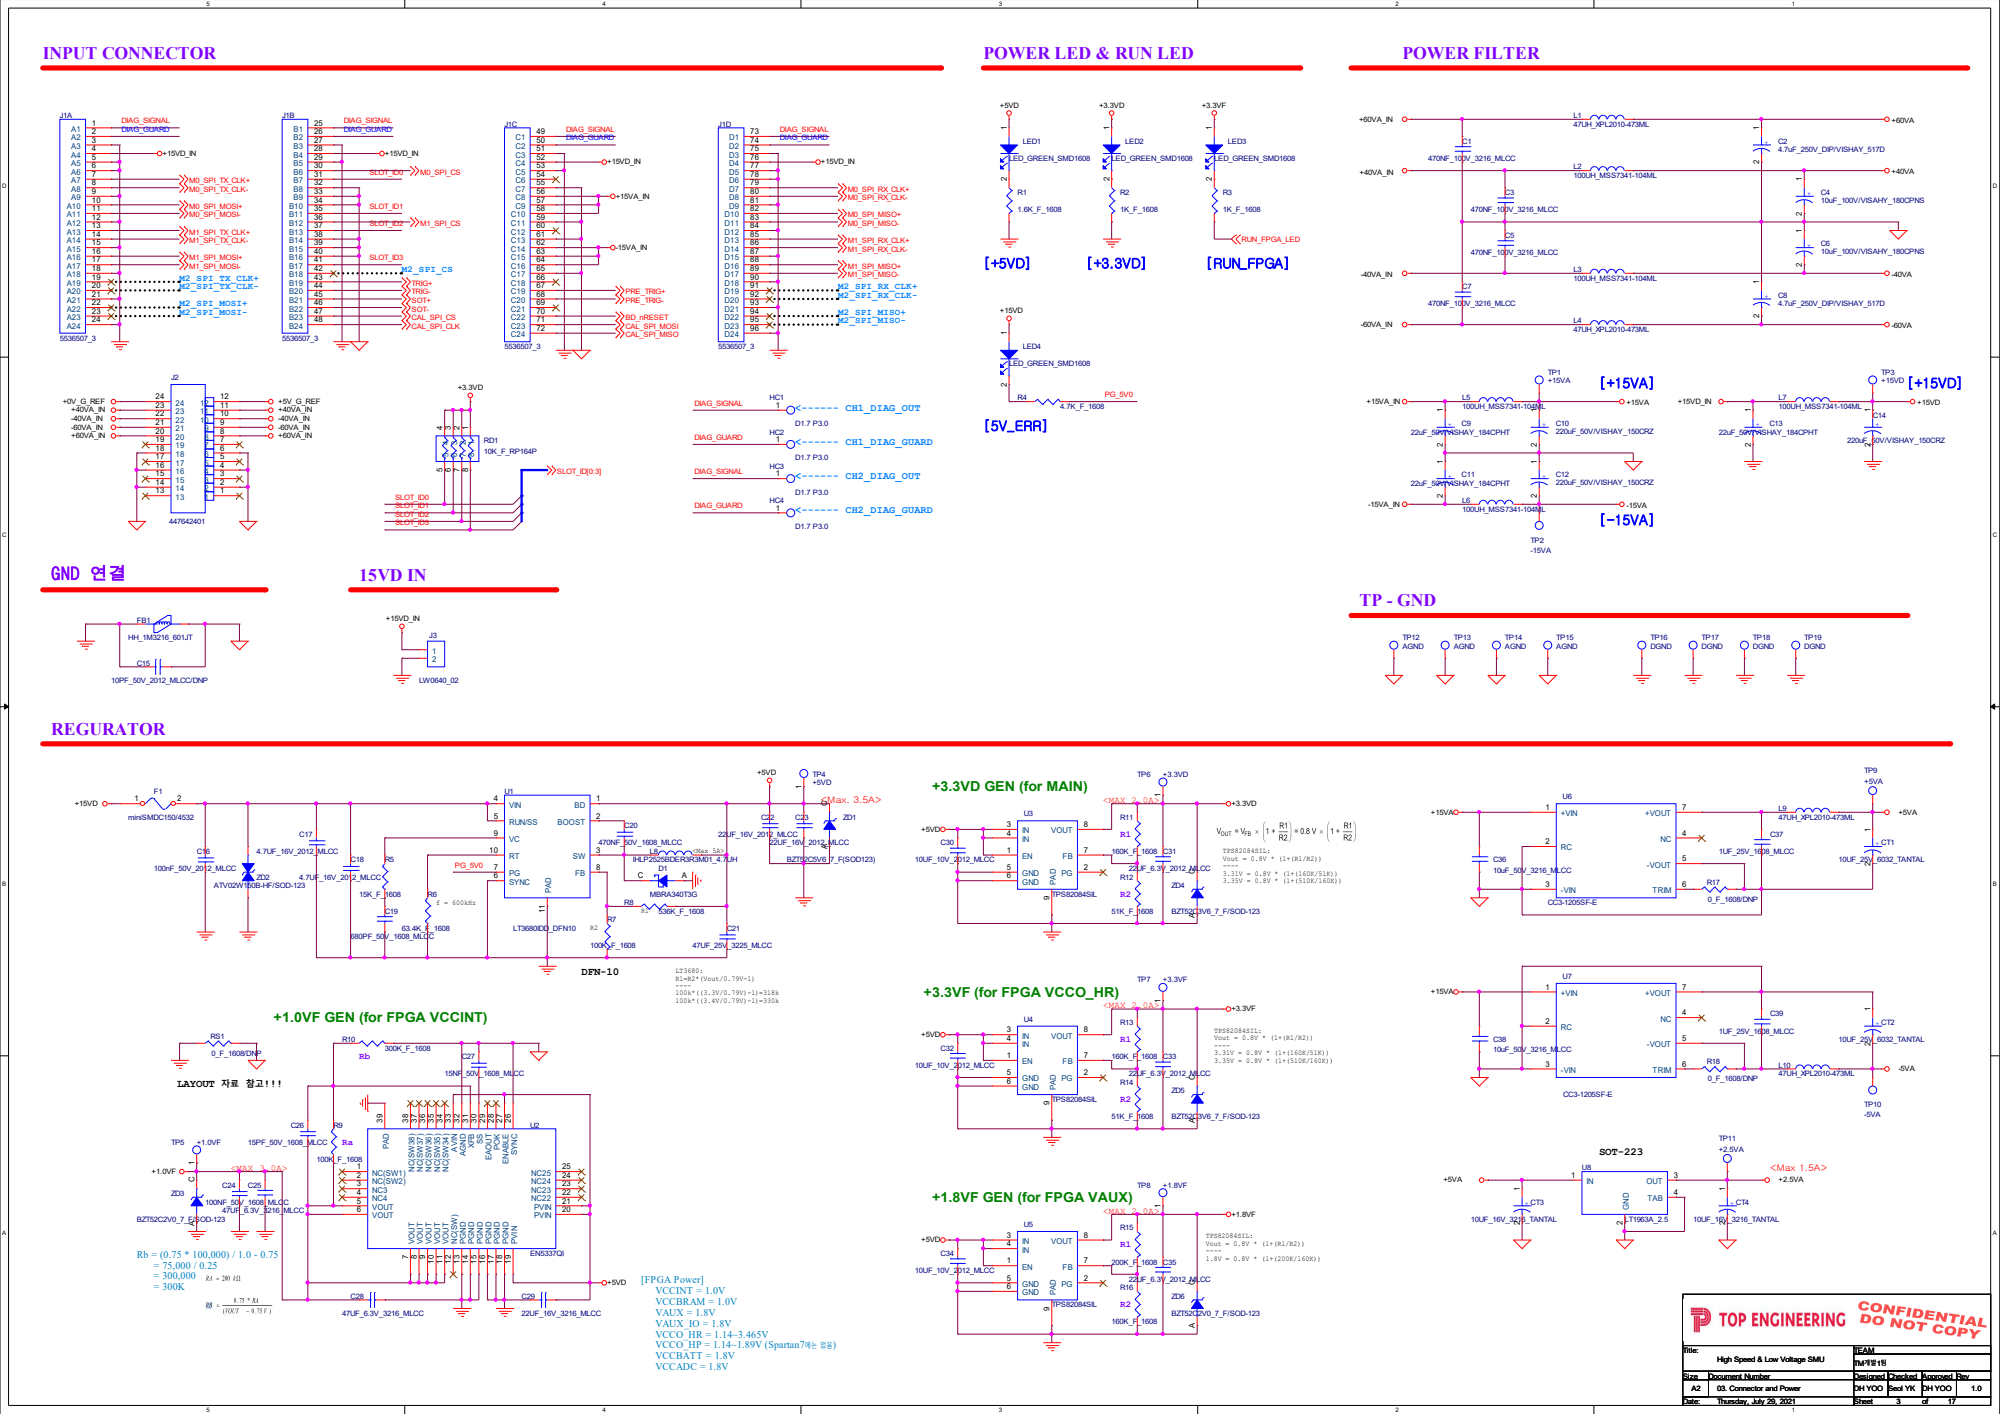
[picture p56: page 3]

+1.0VF GEN (for FPGA VCCINT)

+1.8VF GEN (for FPGA VAUX)

# Differential 신호는 패턴 길이 동일하게 적용

# 텀저항 및 풀업 풀다운 저항은 수신측 근처

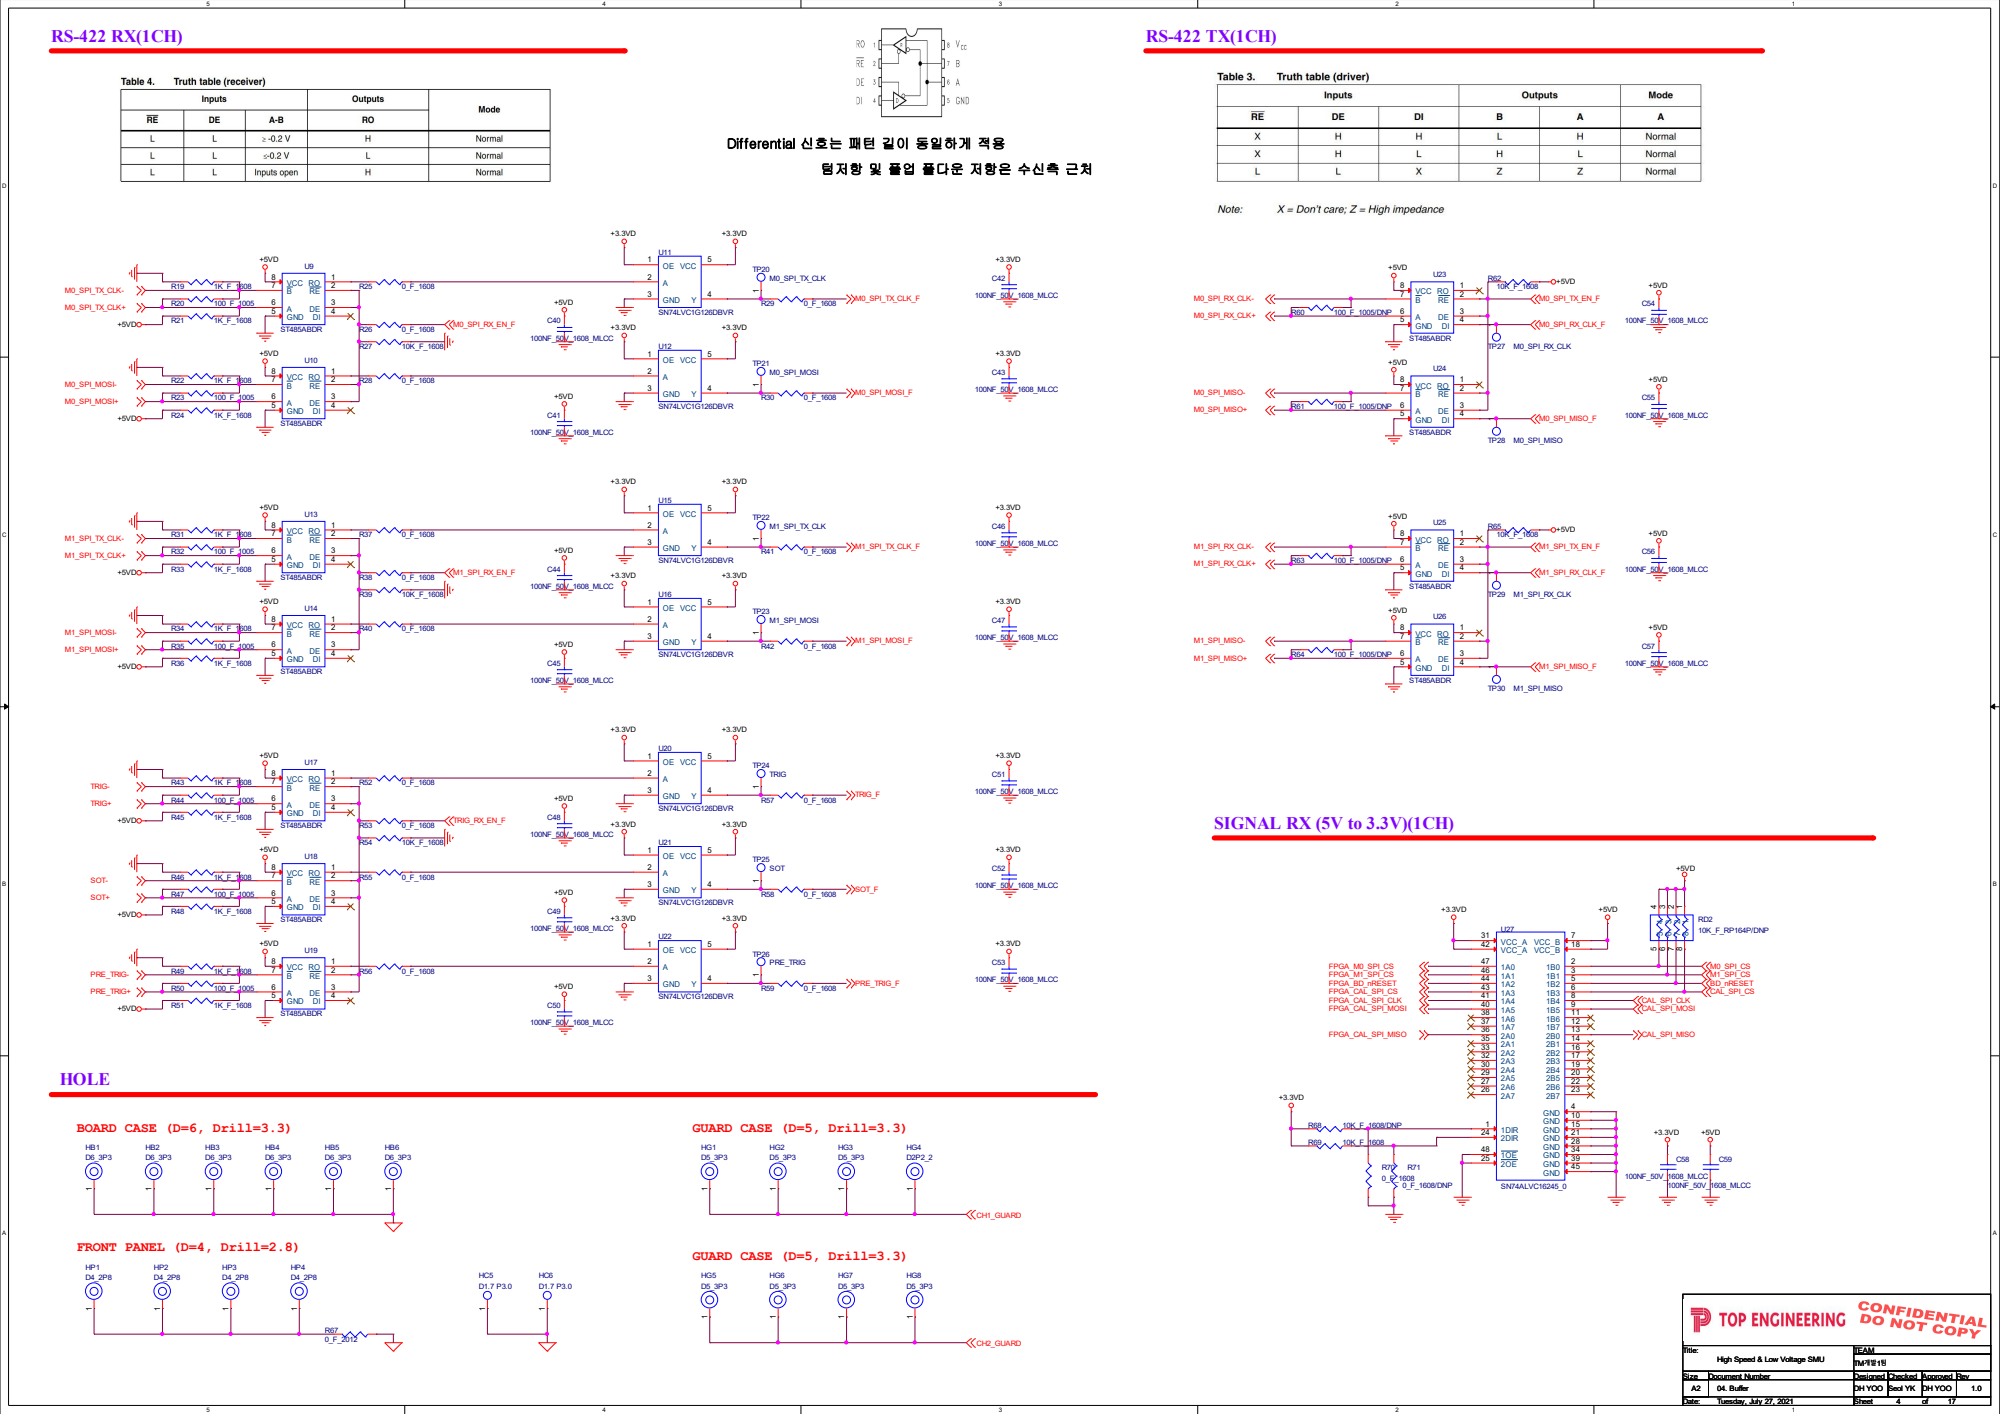
[picture p57: page 4]

FPGA IO | SPI EEPROM | Calibration DATA 저장용 Serial EEPROM

# EEPROM 16K 2048X8 1.8V SERIAL EE IND(CH1)

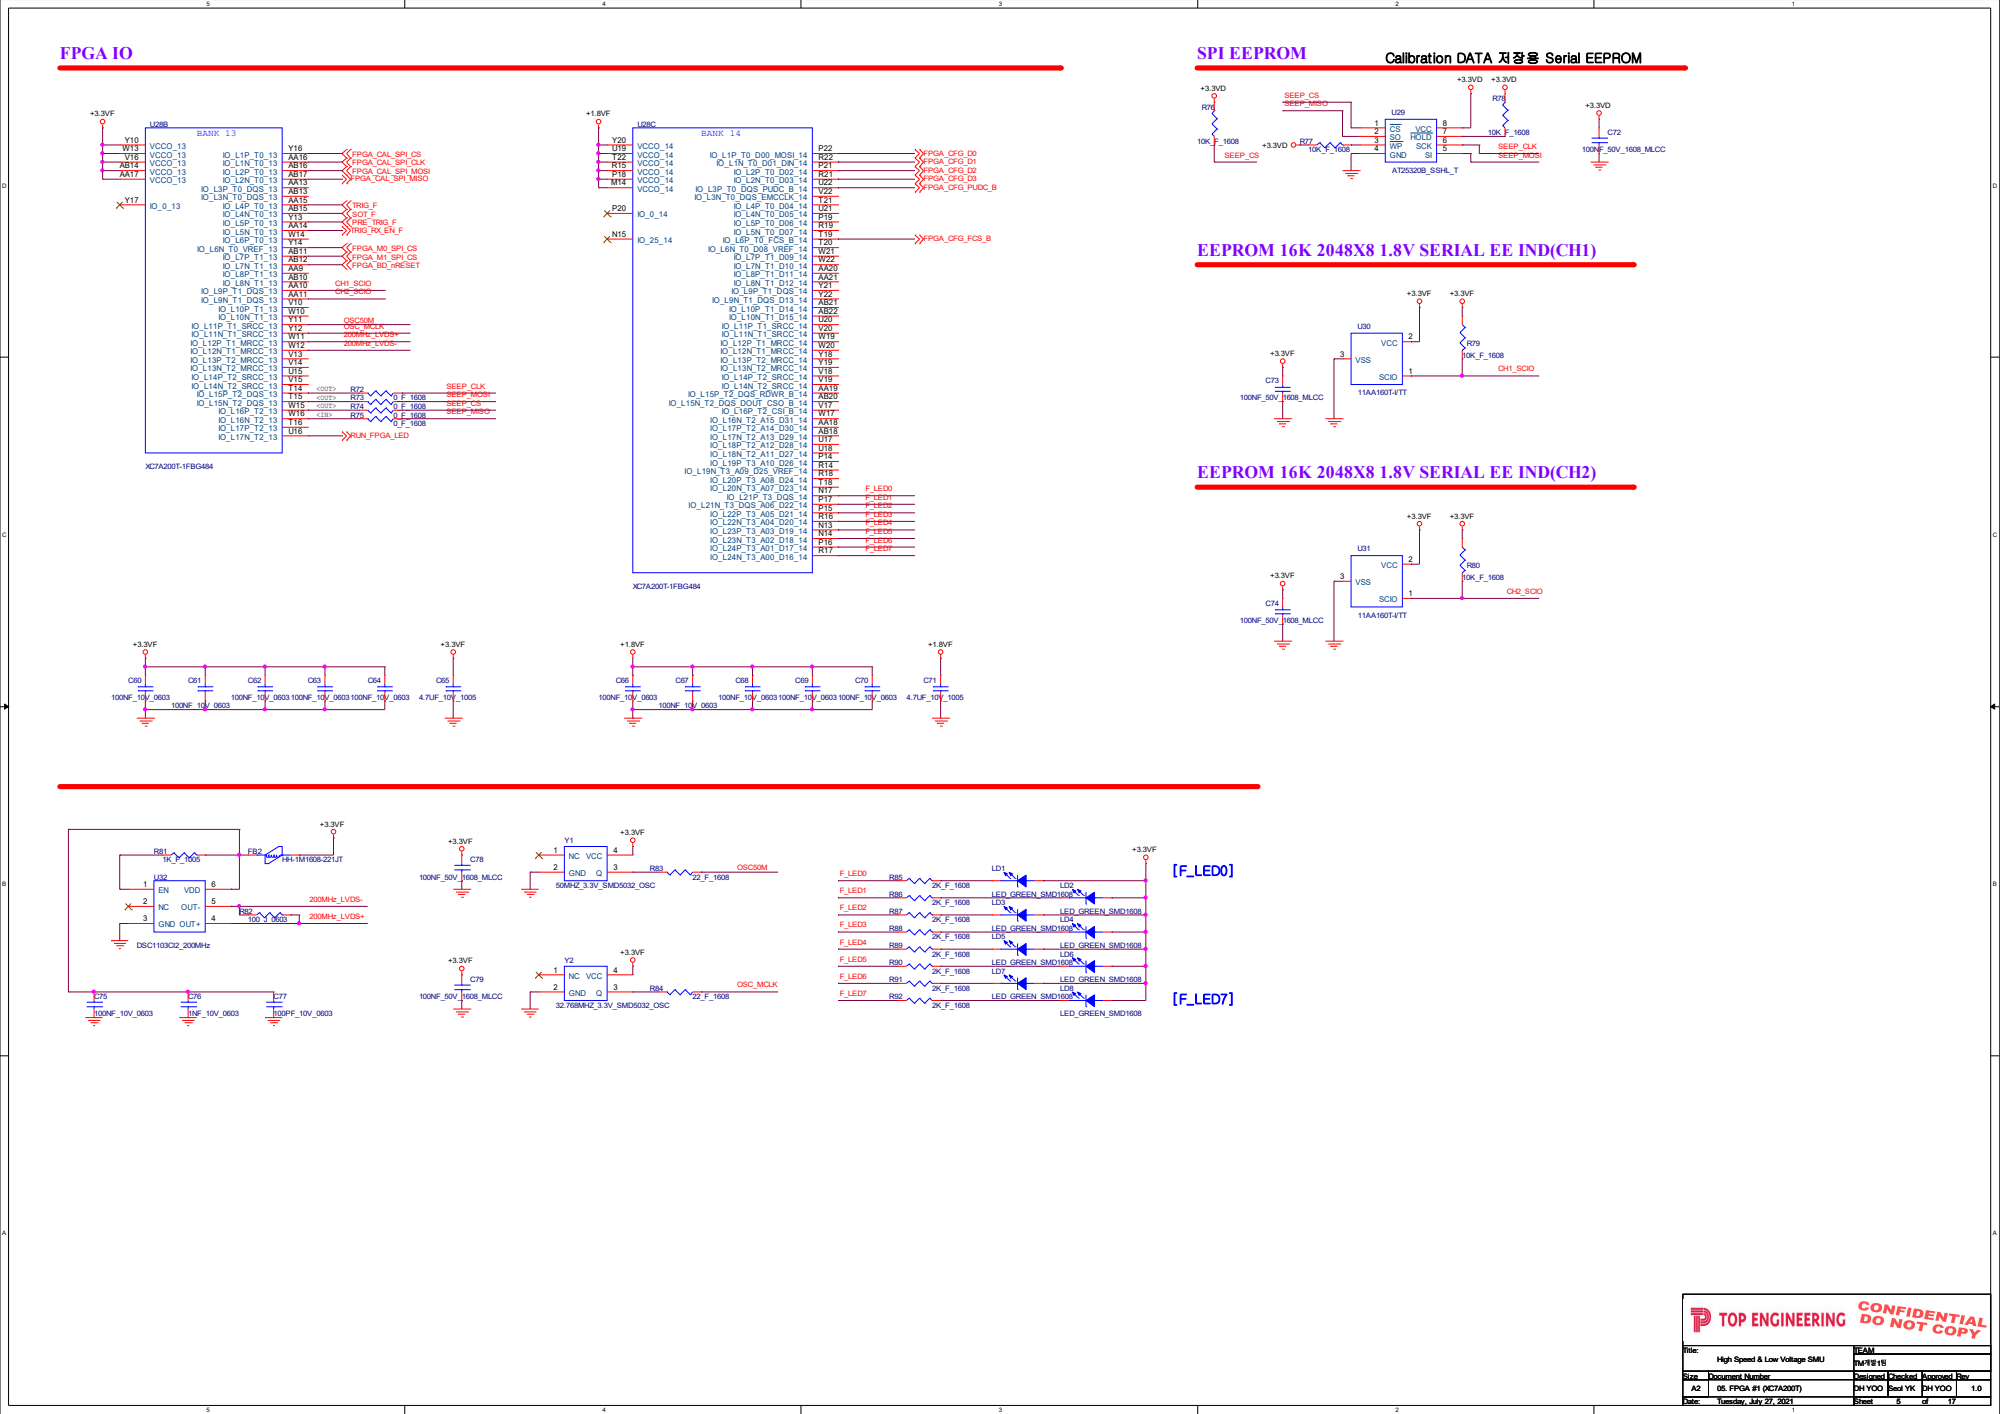
[picture p58: page 5]

EEPROM 16K 2048X8 1.8V SERIAL EE IND(CH2)

# FPGA IO LAN 모듈 Connector(1CH)

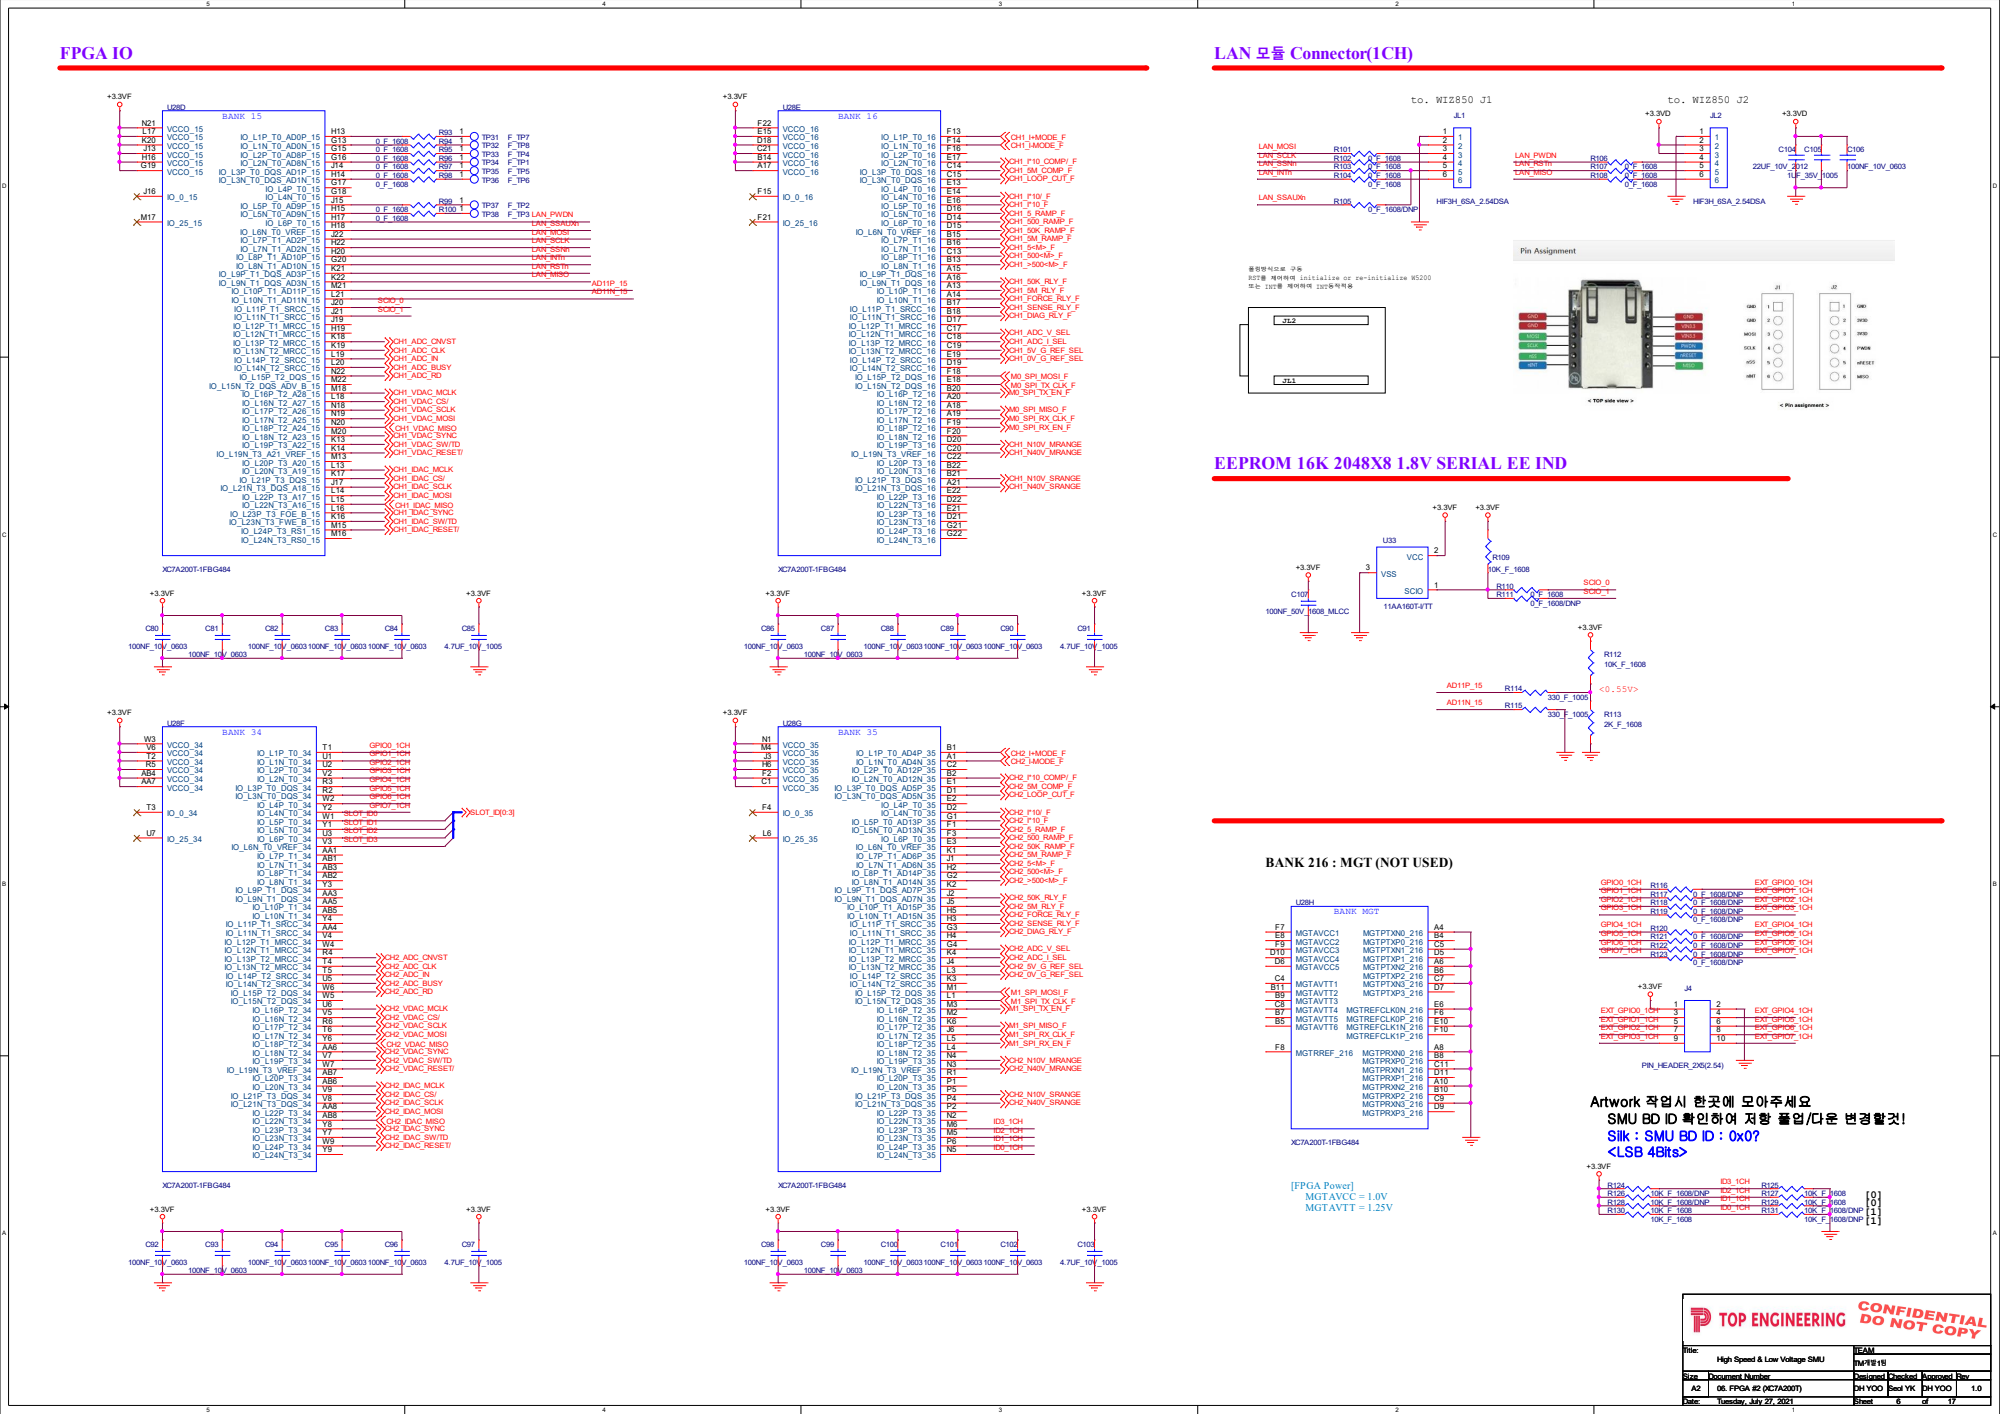
[picture p59: page 6]

폴링방식으로 구동
RST를 제어하여 initialize or re-initialize W5200
또는 INT를 제어하여 INT동작적용

EEPROM 16K 2048X8 1.8V SERIAL EE IND

BANK 216 : MGT (NOT USED)

Artwork 작업시 한곳에 모아주세요
SMU BD ID 확인하여 저항 풀업/다운 변경할것!
Silk : SMU BD ID : 0x0?
<LSB 4Bits>

D | D
C | C
B | B
A | A

Initialization (bar)
Active-Low FPGA initialization pin or configuration error signal. The FPGA drives this pin Low when the
FPGA is in a configuration reset state, when the FPGA is initializing (clearing) its configuration memory, or when the FPGA has detected a configuration error. Upon completing the FPGA initialization process, INIT_B is released to high-Z at which time an external resistor is expected to pull INIT_B High. INIT_B can externally be held Low during power-up to stall the power-on configuration sequence at the end of the initialization process. When a High is detected at the INIT_B input after the initialization process, the FPGA proceeds with the remainder of the configuration sequence dictated by the M[2:0] pin settings.
Connect INIT_B to a ≤ 4.7 kΩ pull-up resistor to VCCO_0 to ensure clean Low-to-High transitions.

## [JTAG]

Done
A High signal on the DONE pin indicates completion of the configuration sequence. The DONE output is an open-drain output by default.

Program (bar)
Active-Low reset to configuration logic. When PROGRAM_B is pulsed Low, the FPGA configuration is cleared and a new configuration sequence is initiated. Configuration reset initiated upon falling edge, and configuration (i.e. programming) sequence begins upon the following rising edge.
Connect PROGRAM_B to an external ≤ 4.7 kΩ pull-up resistor to VCCO_0 to ensure a stable High input, and recommend push-button to GND to enable manual configuration reset.

## [FPGA Power] VCCINT = -0.5~1.1 [1.0V] VCCBRAM = -0.5~1.1 [1.0V] VCCAUX = -0.5 ~ 2.0V [1.8V] VCCAUX_IO = -0.5 ~ 2.0V [1.8V] VCCO_HR = 1.14~3.465V VCCO_HP = 1.14~1.89V (Artix7에는 없음) VCCBATT = -0.5 ~ 2.0V [1.8V] VCCADC = -0.5 ~ 2.0V [1.8V]

## [FPGA Power] VCCADC = -0.5 ~ 2.0V [1.8V] VREF = -0.5 ~ 2.0V [1.25V] to GNDADC

# FPGA - POWER

MT25QL = 2.7V ~ 3.6V
MT25QU = 1.7V ~ 2.0V

## [FPGA Power] VCCINT = -0.5~1.1 [1.0V] VCCBRAM = -0.5~1.1 [1.0V] VCCAUX = -0.5 ~ 2.0V [1.8V] VCCAUX_IO = -0.5 ~ 2.0V [1.8V] VCCO_HR = 1.14~3.465V VCCO_HP = 1.14~1.89V (Artix7에는 없음) VCCBATT = -0.5 ~ 2.0V [1.8V]

Pull-Up During Configuration (bar)
Active-Low PUDC_B input enables internal pull-up resistors on the SelectIO pins after power-up and during configuration.
> When PUDC_B is Low, internal pull-up resistors are enabled on each SelectIO pin.
> When PUDC_B is High, internal pull-up resistors are disabled on each SelectIO pin.
PUDC_B must be tied either directly, or via a ≤ 1kΩ to VCCO_14 or GND.
Caution! Do not allow this pin to float before and during configuration

If the TCK signal is
buffered, connect the buffer input to an external weak (e.g. 10 kΩ) pull-up resistor to maintain a valid High when no cable is connected.

If the TMS signal is buffered, connect the buffer
input to an external weak (e.g. 10 kΩ) pull-up resistor to maintain a valid High when no cable is connected.

VCCBATT is required only when using bitstream encryption. If battery is not used, connect VCCBATT
to either ground or VCCAUX.

If the VCCO_0 supply for bank 0 is
supplied with 2.5V or 3.3V, then the CFGBVS pin must be tied High (i.e. connected to VCCO_0). Tie CFGBVS to Low (i.e. connected to GND), only if the VCCO_0 for bank 0 is less than or equal to 1.8V. If used during configuration, banks 14 and 15 should match the VCCO level applied to bank 0

Configuration Mode Sel (M2:0)
- Master SPI: 001
- Master Serial: 000
- JTAG: 101

<MAX 1.0A>

S25FL256SAGNFI001

S25FL128SAGNFI001

MT25QU256ABA1EW9_0SIT

Temperature-sensing diode pins (Anode: DXP; Cathode:
DXN). The thermal diode is accessed by using the DXP and DXN pins in bank 0. When not used, tie to GND.

# FPGA - Configuration Part

VCC_ADC

+1.0VF | +1.8VF | +1.0VF

+1.0VF

+1.0VF

+1.8VF

+1.8VF

VCC_ADC

+1.0VF

+3.3VF

VCC_ADC

+1.8VF | CONF_POW_1.8V

CONF_POW_1.8V

CONF_POW_1.8V

CONF_POW_1.8V | CONF_POW_1.8V

CONF_POW_1.8V

CONF_POW_1.8V

CONF_POW_1.8V

CONF_POW_1.8V

+1.8VF

+1.0VF

GND_ADC

GND_ADC
GND_ADC

GND_ADC

GND_ADC

GND_ADC

FPGA_CFG_D0

FPGA_CFG_D1

FPGA_CFG_D2

FPGA_CFG_D3

FPGA_CFG_PUDC_B

FPGA_CFG_FCS_B

07. FPGA #3 (XC7A200T) | 1.0
A2 | DH YOO DH YOO DH YOO
Tuesday, July 27, 2021 | 7 | 17

TM개발 1팀

07. FPGA #3 (XC7A200T) | 1.0
A2 | DH YOO DH YOO DH YOO
Tuesday, July 27, 2021 | 7 | 17

TM개발 1팀

07. FPGA #3 (XC7A200T) | 1.0
A2 | DH YOO DH YOO DH YOO
Tuesday, July 27, 2021 | 7 | 17

TM개발 1팀

C137
390PF_50V_2012_MLCC

R146
0_F_1005

R138
0_F_1005

C136

4.7UF_10V_1005

C110

10NF_6.3V_0603

C138
100NF_50V_1005

FB4
HH-1M1608-221JT

R152
4.7K_F_1005 | R154
4.7K_F_1005

U34

REF3012AIDBZR

IN

1
OUT

2

GND

3

C114

100NF_10V_0603

R132

1K_F_1608

R150
1K_F_1005

R170
100_F_1005/DNP

R148
0_F_1005

R155
4.7K_F_1005

C113

100NF_10V_0603

C134

4.7UF_10V_1005

C142

100NF_50V_1005

C118

100NF_50V_1005

R133

1K_F_1608

C109

100NF_10V_0603

R169
100_F_1005/DNP

C141

1UF_35V_1005

U35

MT25QU128ABA1EW9_0SIT

VCC

8
DQ0

5

S#

1

W/VPP/DQ2

3

C

6

DQ1

2

VSS

4

HOLD/DQ3

7

EPAD

9

EPAD

10

R140
1K_F_1005

C119

100NF_10V_0603

TP39
+0.275V

1

R143
10K_F_1005

R166
51_F_1005

C128

100NF_50V_1005

R135
1K_F_1608

R139
0_F_1005

R167
51_F_1005

R145
10K_F_1005/DNP

BANK 0

XC7A200T-1FBG484

U28A

VCCO_0

T12

VCCO_0

F12

DXN_0

N9

VCCADC_0

K10

GNDADC_0

K9

DXP_0

N10

VREFN_0

VREFP_0 L9 M10

VP_0

L10

VN_0

M9

VCCBATT_0

E12

CCLK_0

L12

TDO_0

U13

TDI_0

R13

TMS_0

TCK_0 T13 V12

INIT_B_0

U12

PROGRAM_B_0

N12

CFGBVS_0

U8

DONE_0

G11

M2_0

U9

M0_0

U11

M1_0

U10

R158
1K_F_1005

ZD7

BZT52C3V6_7_F/SOD-123

A | C

C143

100NF_50V_1608

C121

100NF_10V_0603

C115

100NF_10V_0603

XC7A200T-1FBG484

U28I

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
AA22

GND

AA12

GND

AB19

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
C108

470NF_6.3V_0603_MLCC

C129

100NF_10V_0603

C145

100NF_10V_0603

10NF_6.3V_0603

R157
1K_F_1005/DNP

R159
1K_F_1005/DNP

R147
10K_F_1005

R164
51_F_1608

C120

100NF_10V_0603

R141
1K_F_1005

R142
0_F_1005

C131

100NF_10V_0603

C116

100NF_10V_0603

R161
1K_F_1005/DNP

C135

22UF_6.3V_1608

R149
10K_F_1005

TP40
+0.55V

1

C144

100NF_50V_1608

C130

100NF_10V_0603

R160
1K_F_1005

R165
51_F_1005

C122

100NF_10V_0603
R168
51_F_1608

R144
0_F_1005

C133

22UF_6.3V_1608

C117

100NF_10V_0603

R134
1K_F_1608

C125

100NF_50V_1005

C111

100NF_50V_1005

R151
4.7K_F_1005

R162
1K_F_1005/DNP

C123

100NF_10V_0603

JTAG

J5

87831-1420

GND

1
CONF_POW

2

GND

3
JTAG_TMS

4

GND

5
JTAG_TCK

6

GND

7
JTAG_TDO

8

GND

9
JTAG_TDI

10

GND

11
N.C12

12

GND

13
N.C14

14

R156
1K_F_1005

C126

100NF_10V_0603

C132

100NF_10V_0603

R137
0_F_1005/DNP

R163
1K_F_1005

C124

100NF_10V_0603

C112

100NF_10V_0603

R136
10K_F_1608

FB3
HH-1M1608-221JT | C140
| 22UF_10V_2012

R152-1
330_F_1005

C127

100NF_10V_0603

XC7A200T-1FBG484

U28J

VCCINT

T8

VCCINT

T10

VCCINT

R9

VCCINT

R7

VCCINT

P10

VCCINT

P8

VCCINT

N7

VCCINT

M8

VCCINT

K8

VCCINT

L7

VCCINT

J9

VCCINT

J7

VCCINT

H8

VCCINT

H10

VCCAUX

R11

VCCAUX

P12

VCCAUX

M12

VCCAUX

K12

VCCAUX

H12

VCCBRAM

N11

VCCBRAM

L11

VCCBRAM

J11

R153
2.4K_F_1005

B0_XADC_VP
B0_XADC_VN

VREF+

VREF+

B0_XADC_VP
B0_XADC_VN

JTAG_TCK

JTAG_TDO

JTAG_TMS

JTAG_TDI

JTAG_TCK

FPGA_VBATT

FPGA_DONE

FPGA_INIT_B
FPGA_PROG_B

FPGA_CCLK

FPGA_M2

FPGA_M0

FPGA_M1

FPGA_M0
FPGA_M1
FPGA_M2

FPGA_VBATT

FPGA_DONE

FPGA_CFGBVS

FPGA_PROG_B

FPGA_CFGBVS

FROM_nHOLD

FROM_DQ2/nW

FROM_nS

FROM_nHOLD
FROM_DQ2/nW

FROM_nS

FPGA_CCLK

FPGA_CCLK

JTAG_TDO
JTAG_TDI

JTAG_TCK
JTAG_TMS

FPGA_INIT_B

VM RANGE | I_ADCIN

## ADC SEL

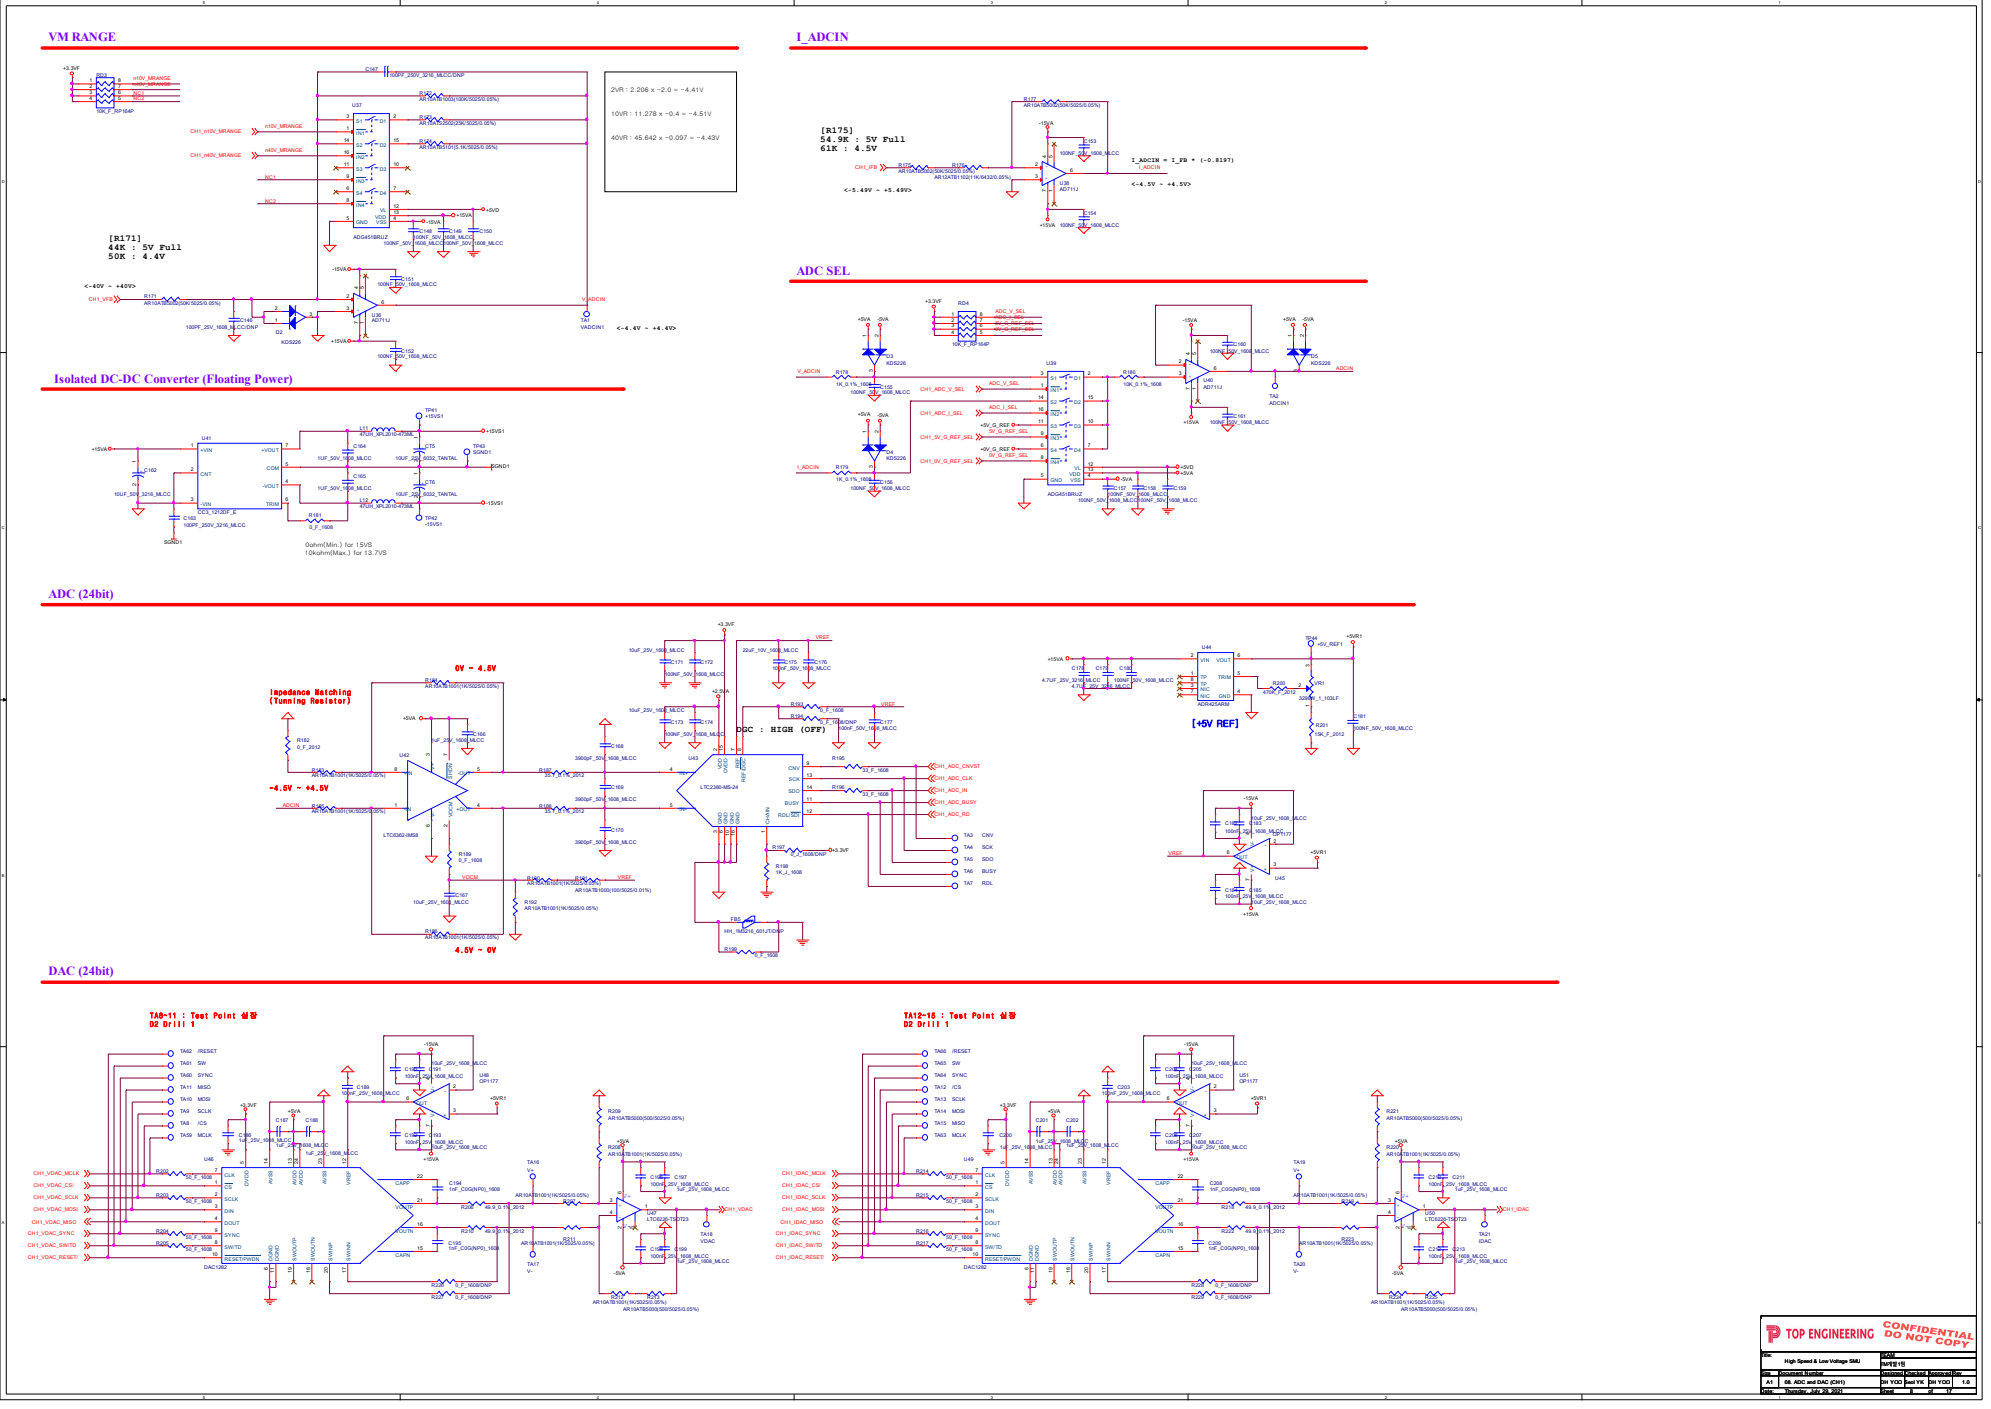
[picture p60: page 8]

Isolated DC-DC Converter (Floating Power)

Designed Checked Approv ed

# S RANGE

## 40VR : 3.75 x -12.171 = -45.642V

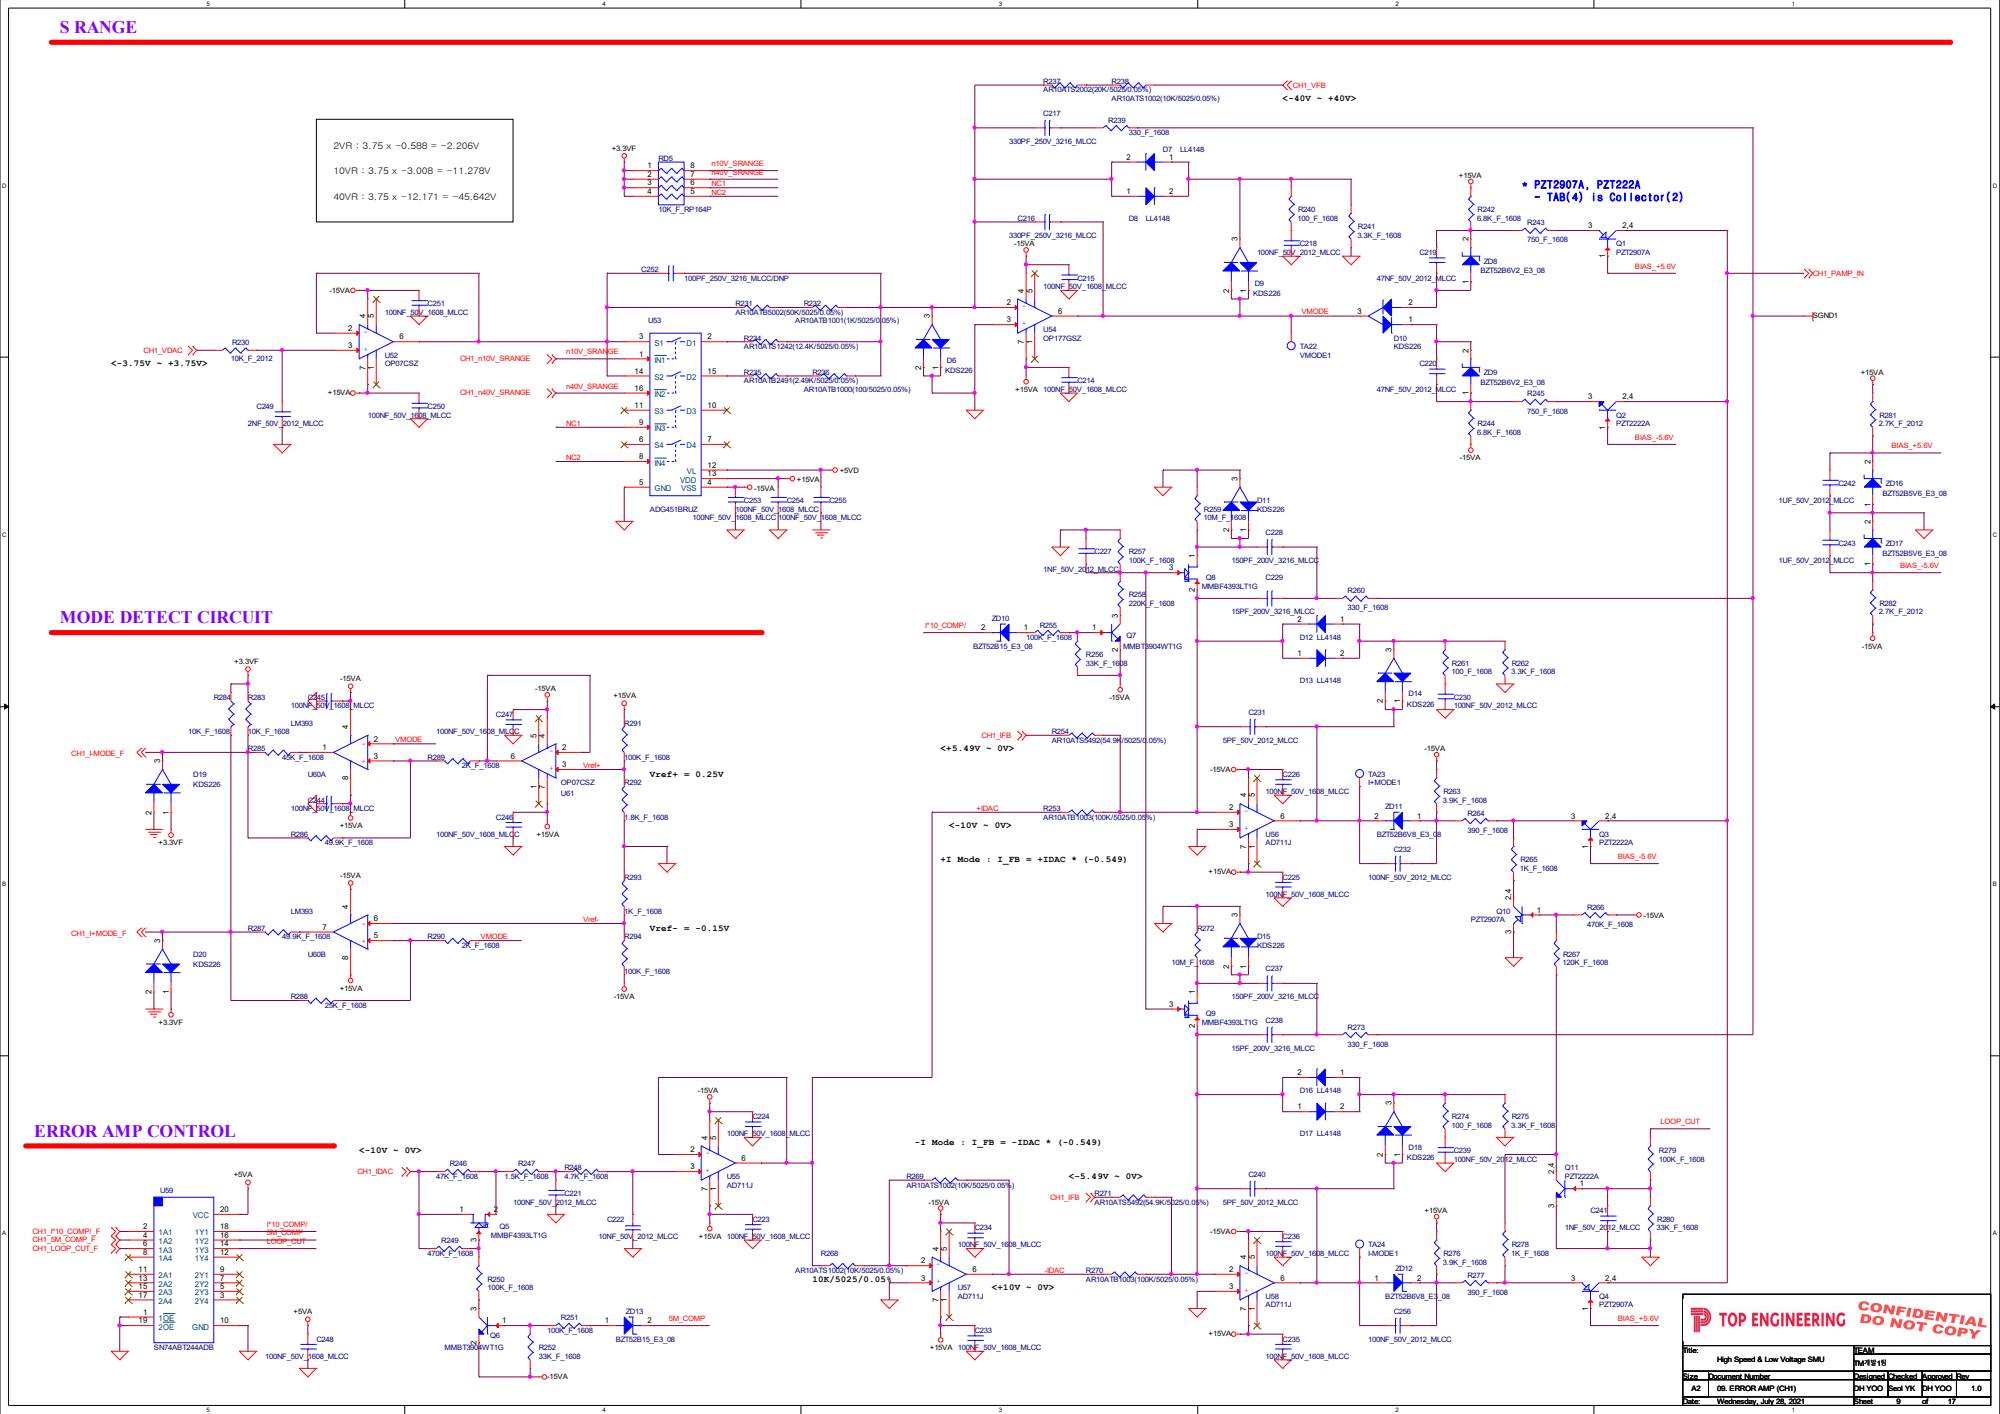
[picture p61: page 9]

# POWER AMP

## 2SC3588-K

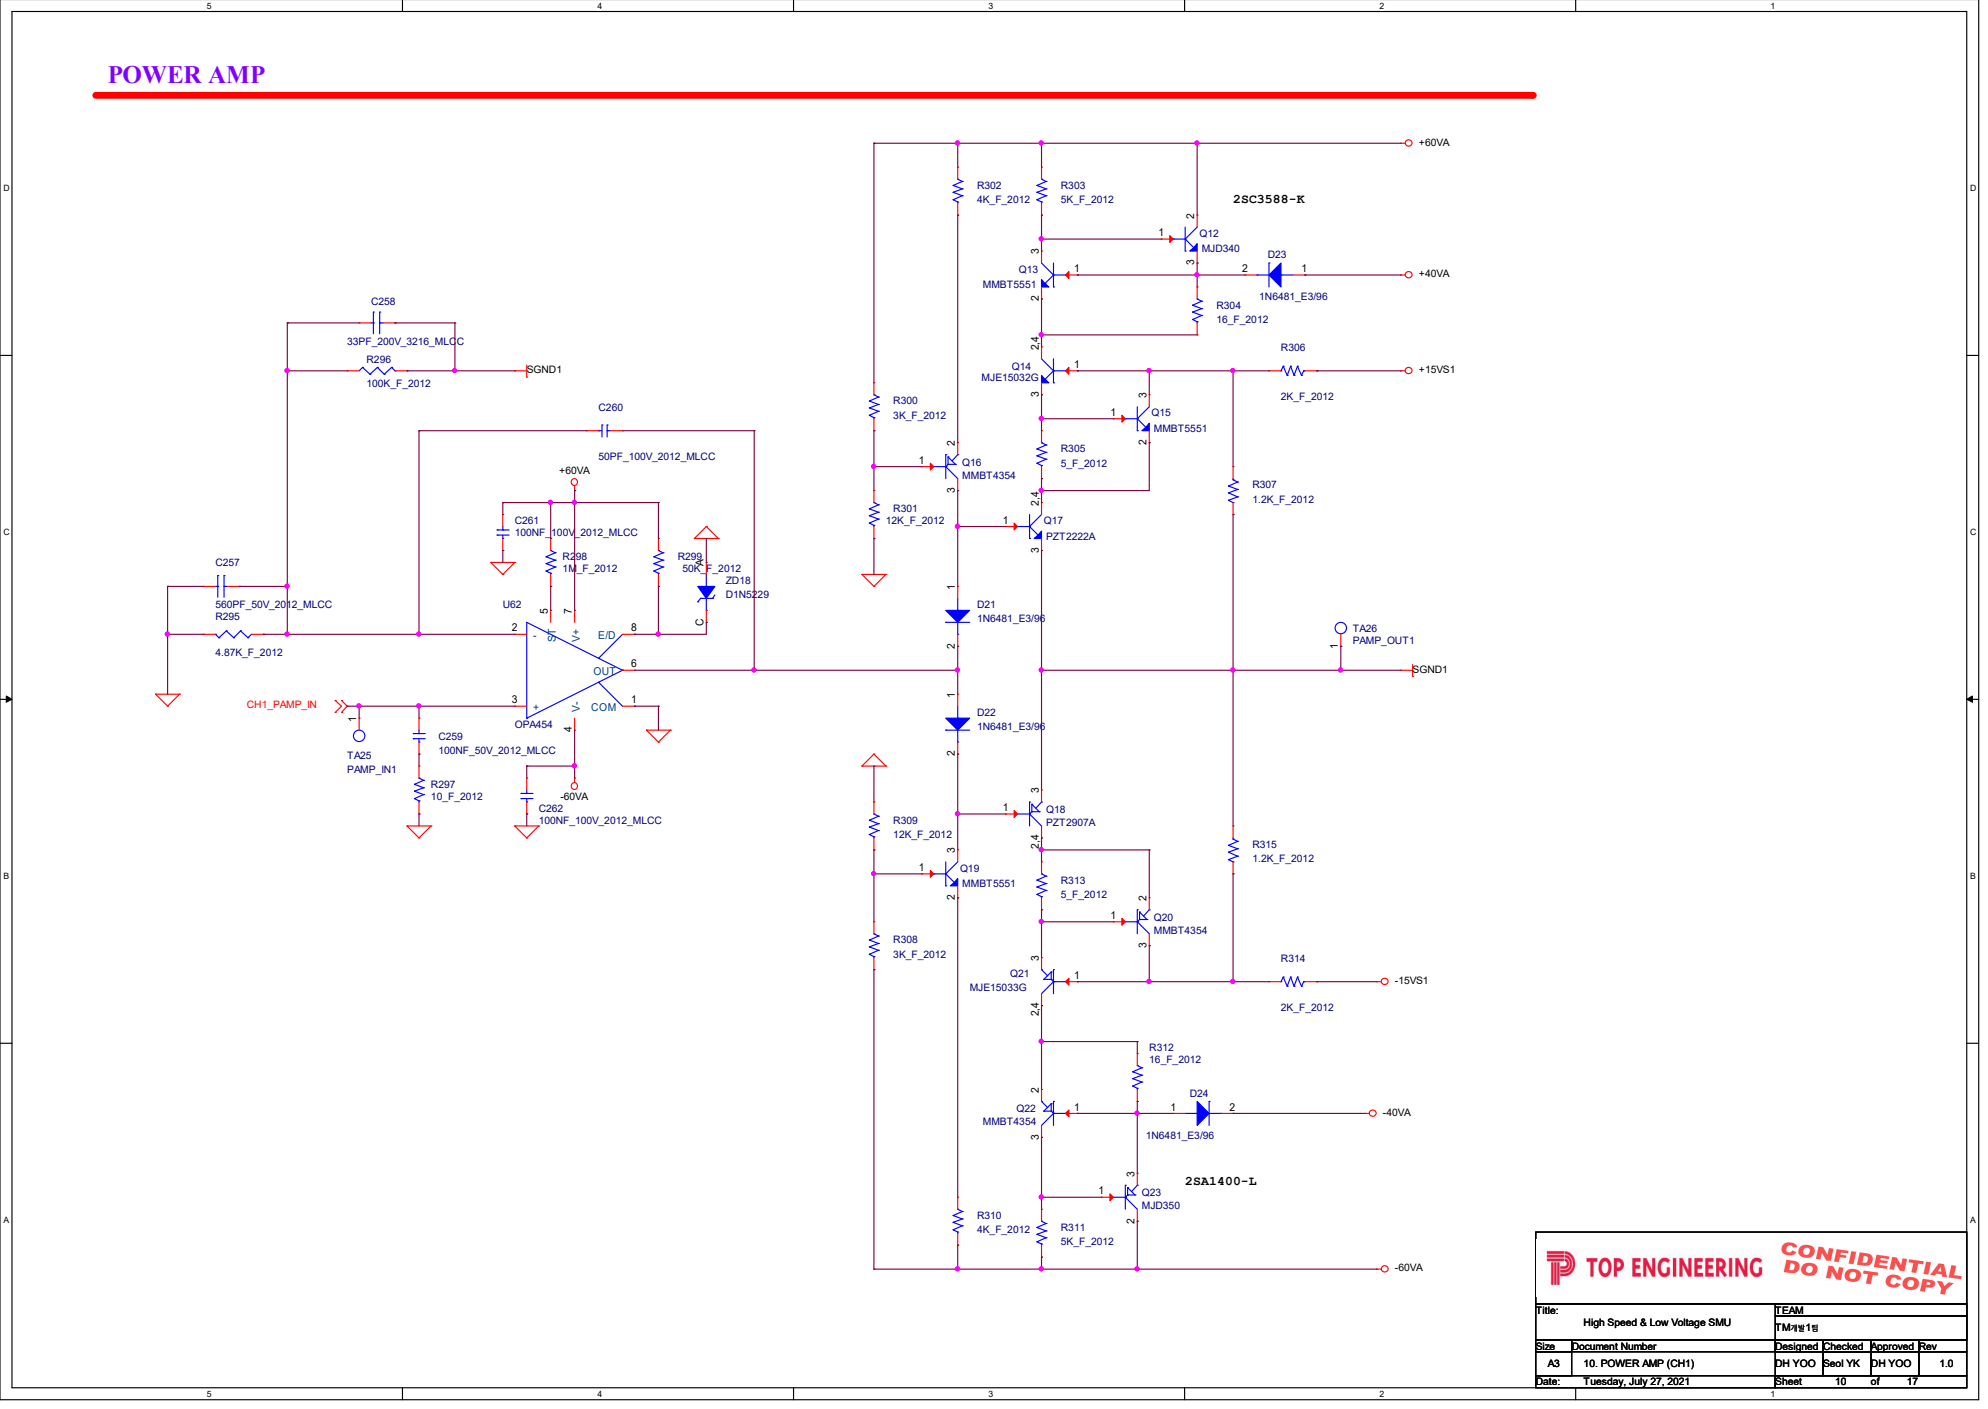
[picture p62: page 10]

CONTROL SIGNAL BUFFER | SIGNAL ISOLATE | I RANGE CONTROL

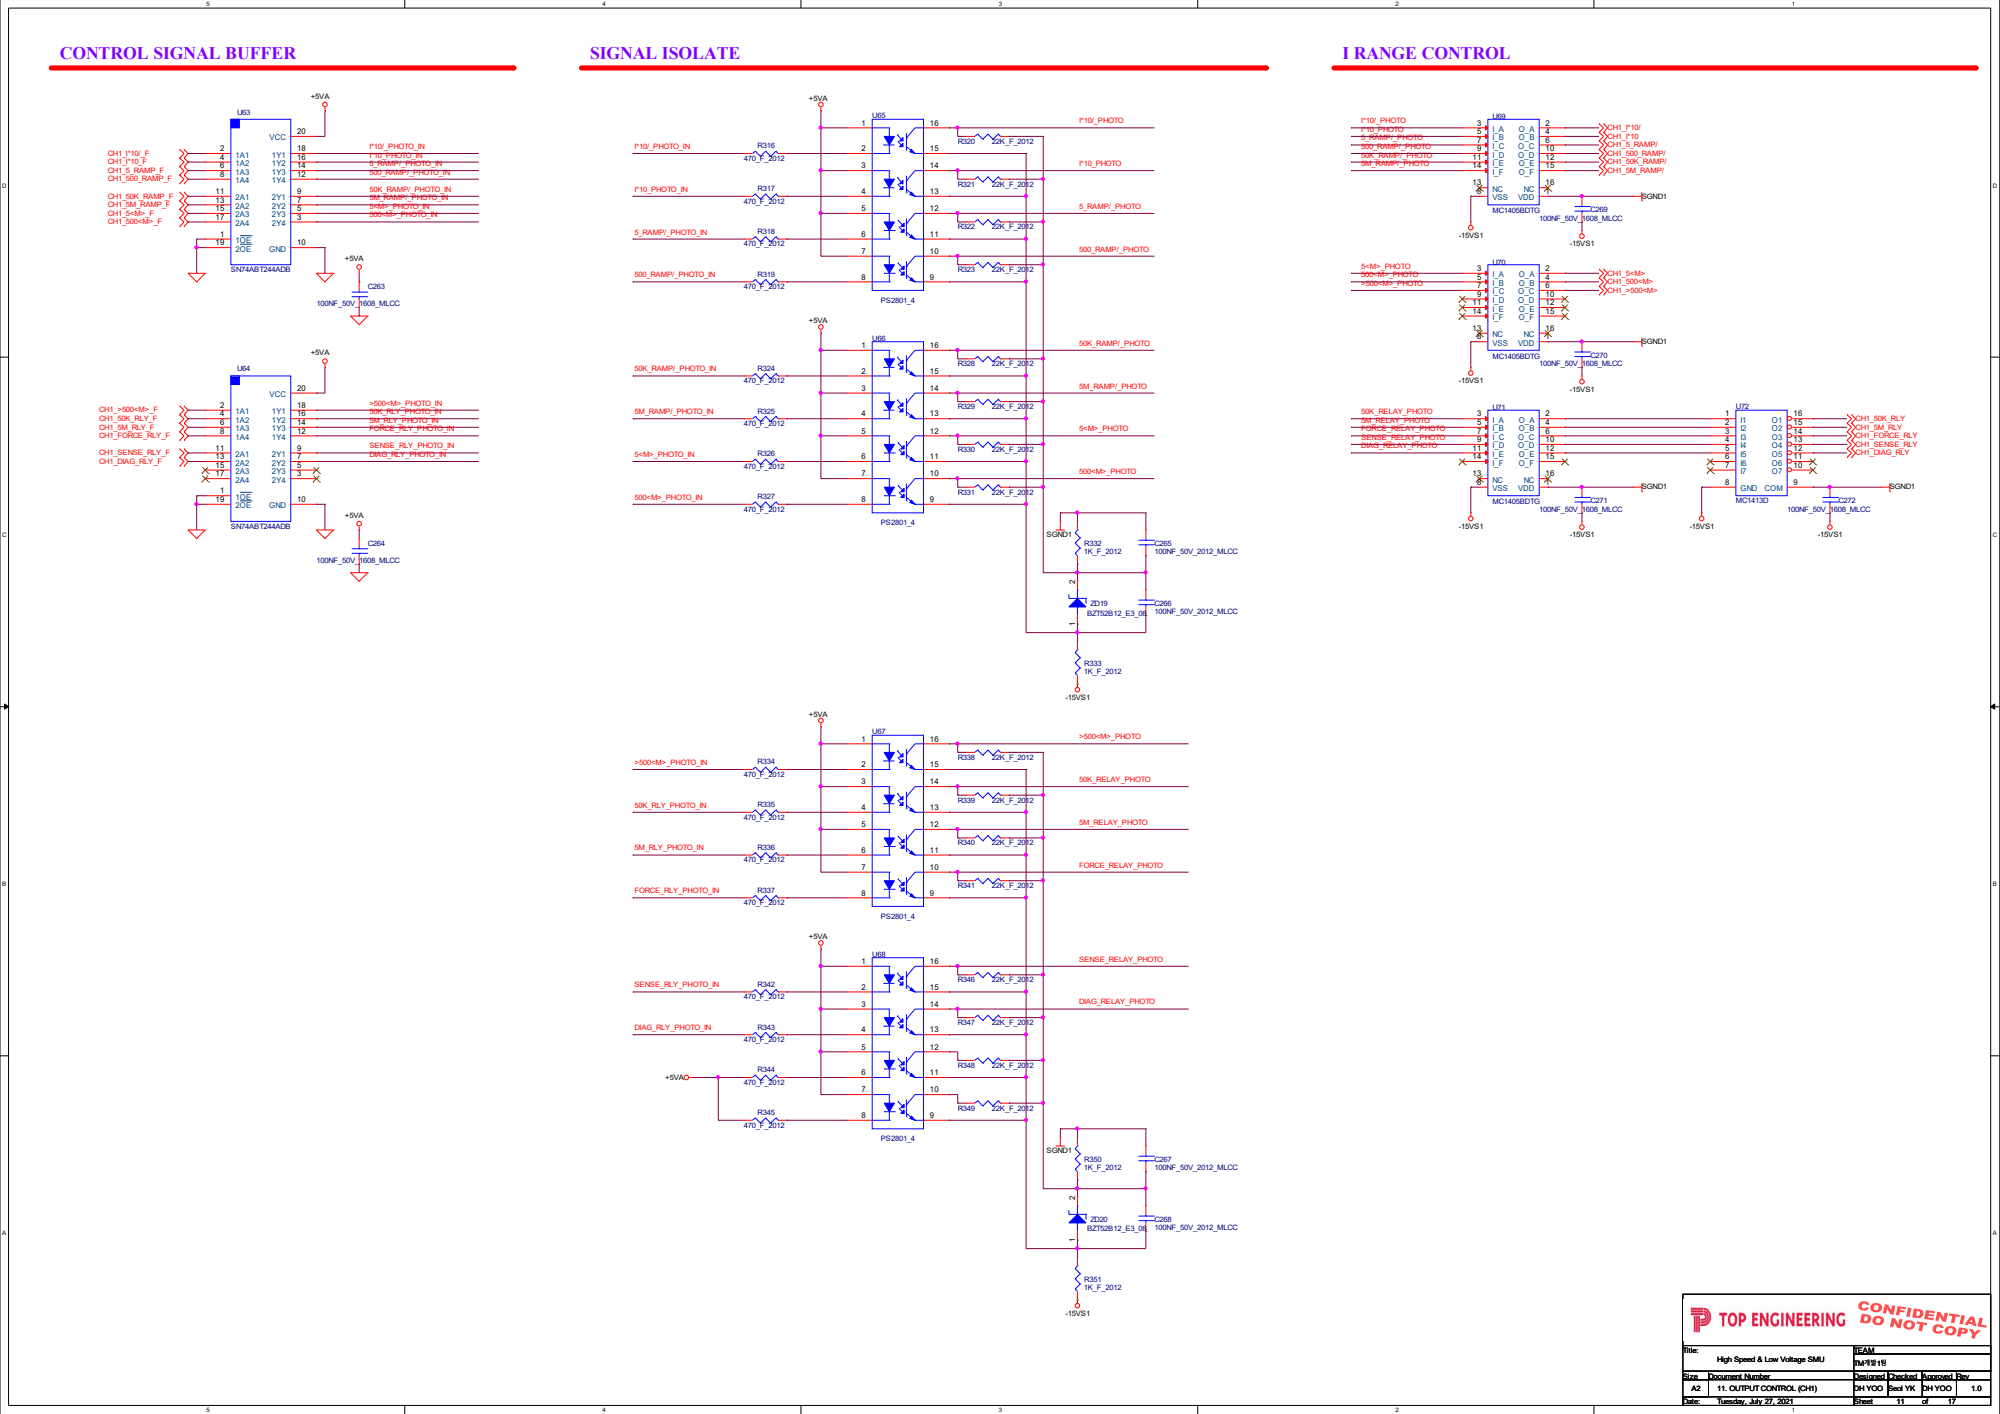
[picture p63: page 11]

## OUTPUT

## U74,U78 장착용 소켓

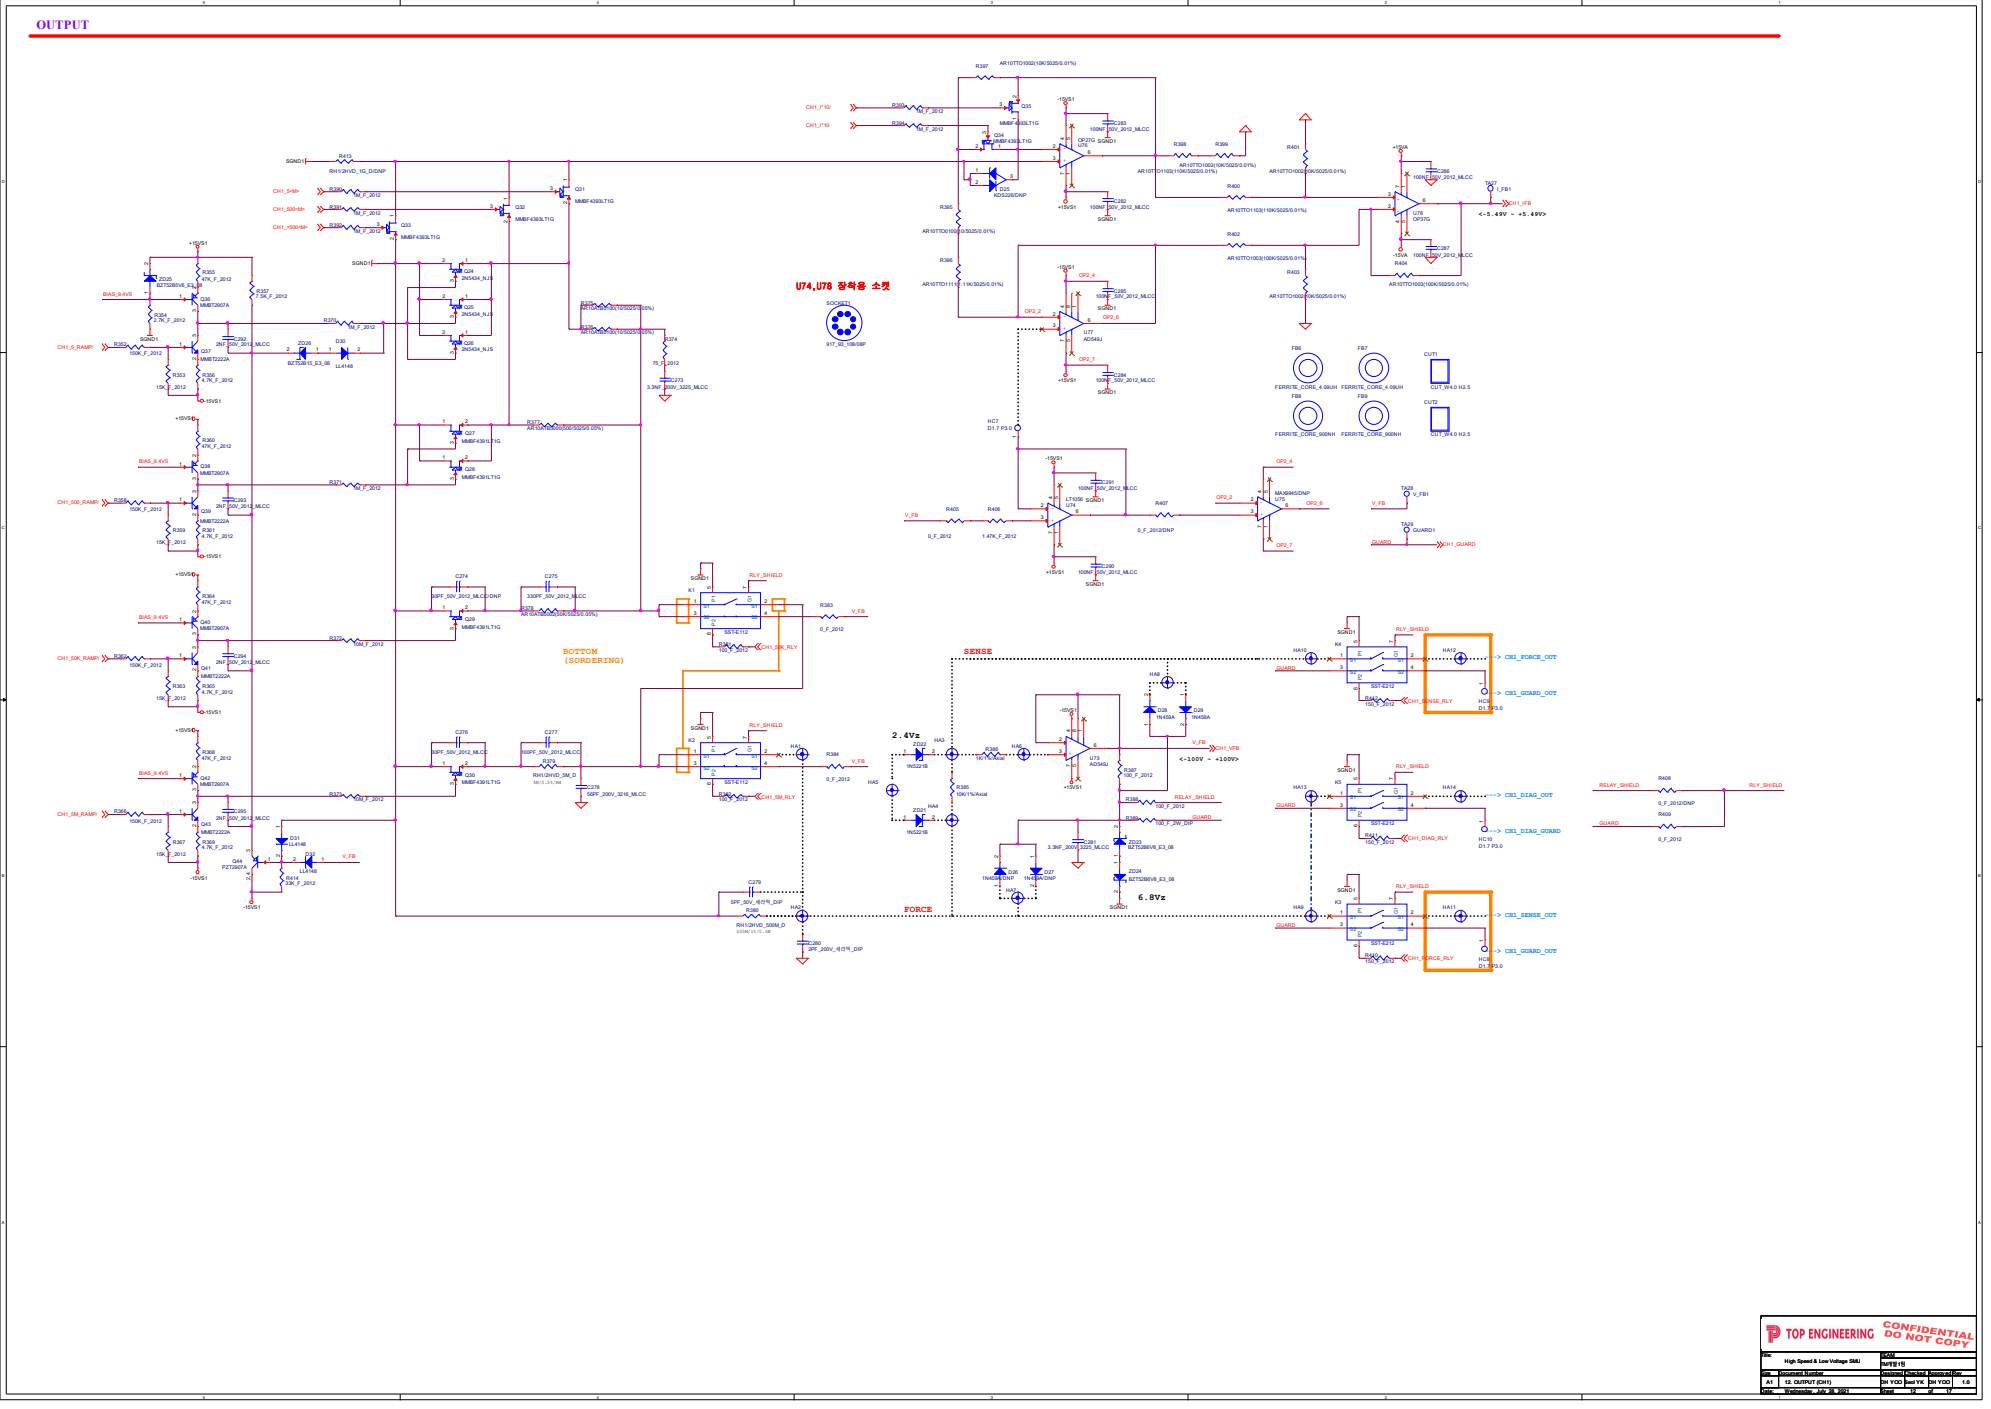
[picture p64: page 12]

Designed Checked Approv ed

VM RANGE | I_ADCIN

## ADC SEL

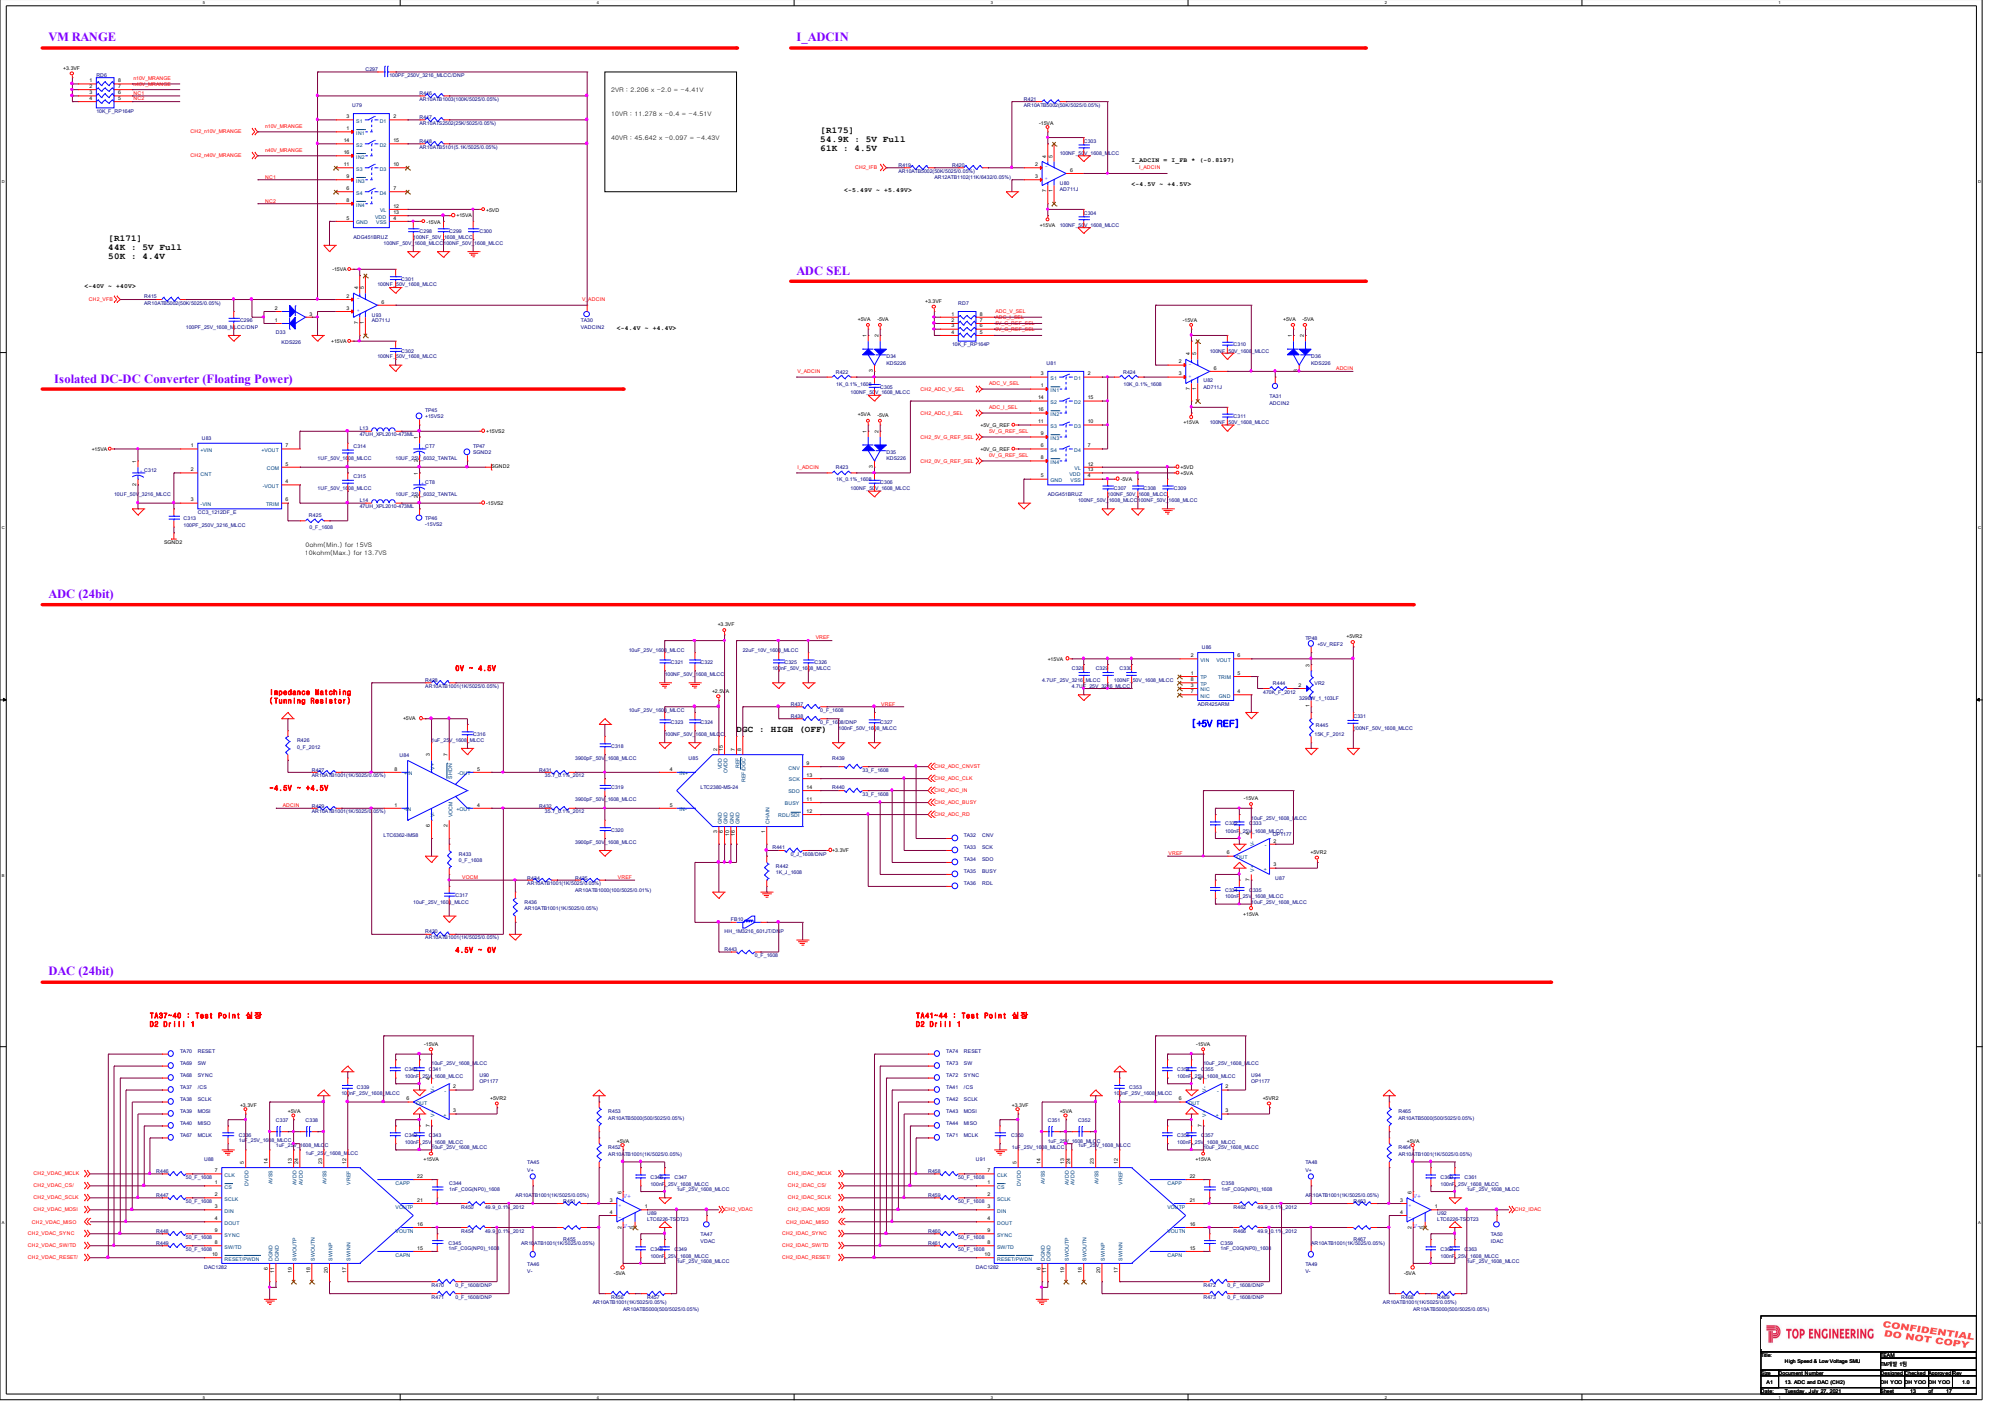
[picture p65: page 13]

Isolated DC-DC Converter (Floating Power)

[+5V REF] DGC : HIGH (OFF)

Designed Checked Approv ed

# S RANGE

## 40VR : 3.75 x -12.171 = -45.642V

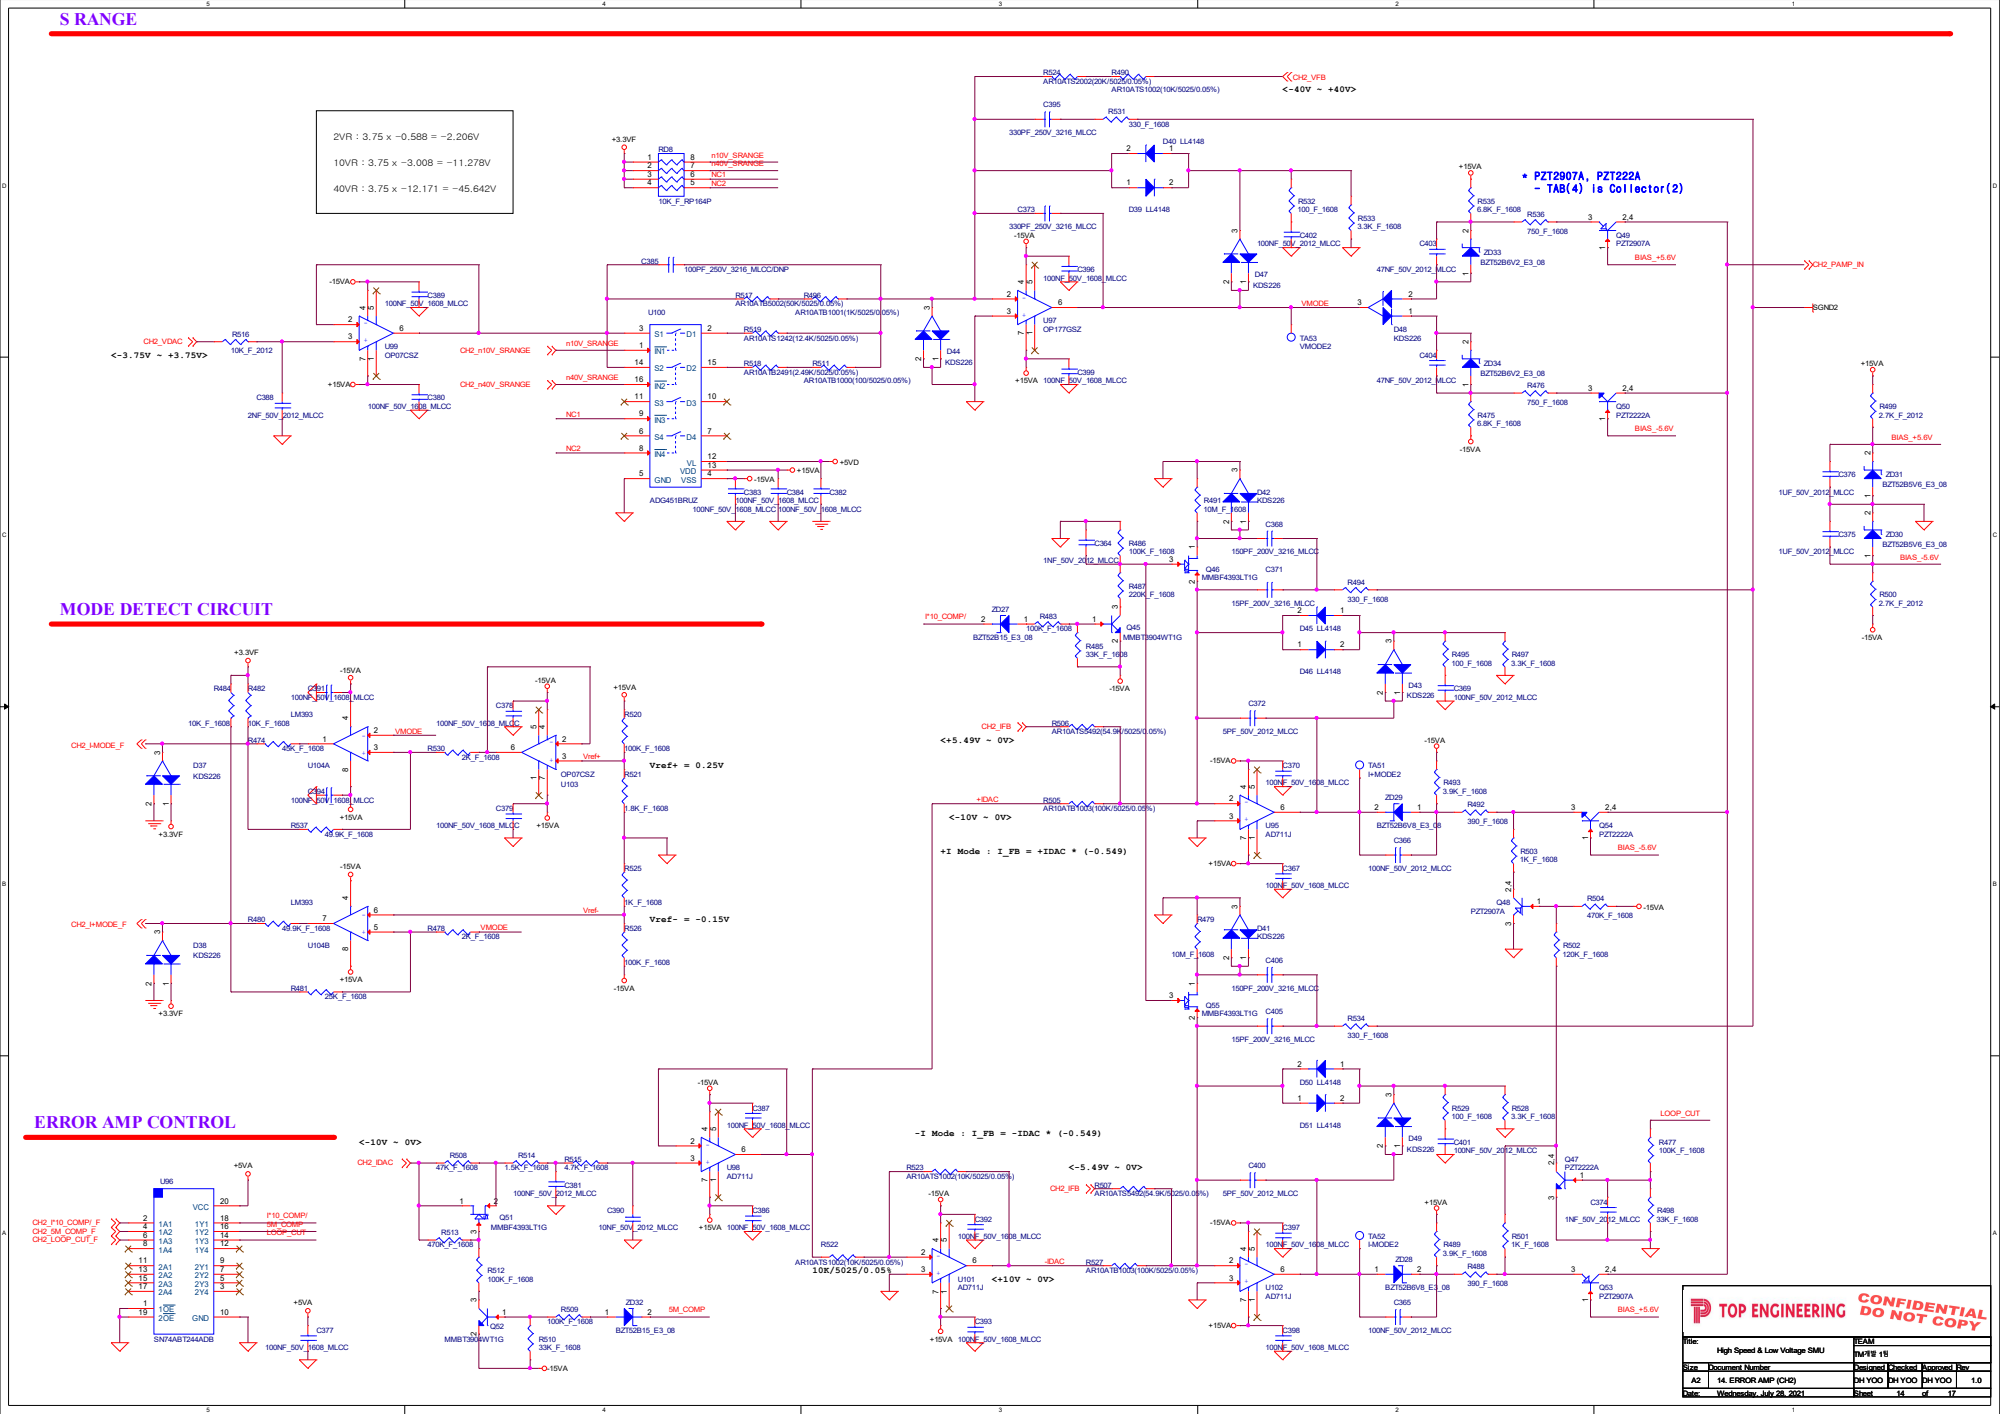
[picture p66: page 14]

## 2SC3588-K

# POWER AMP

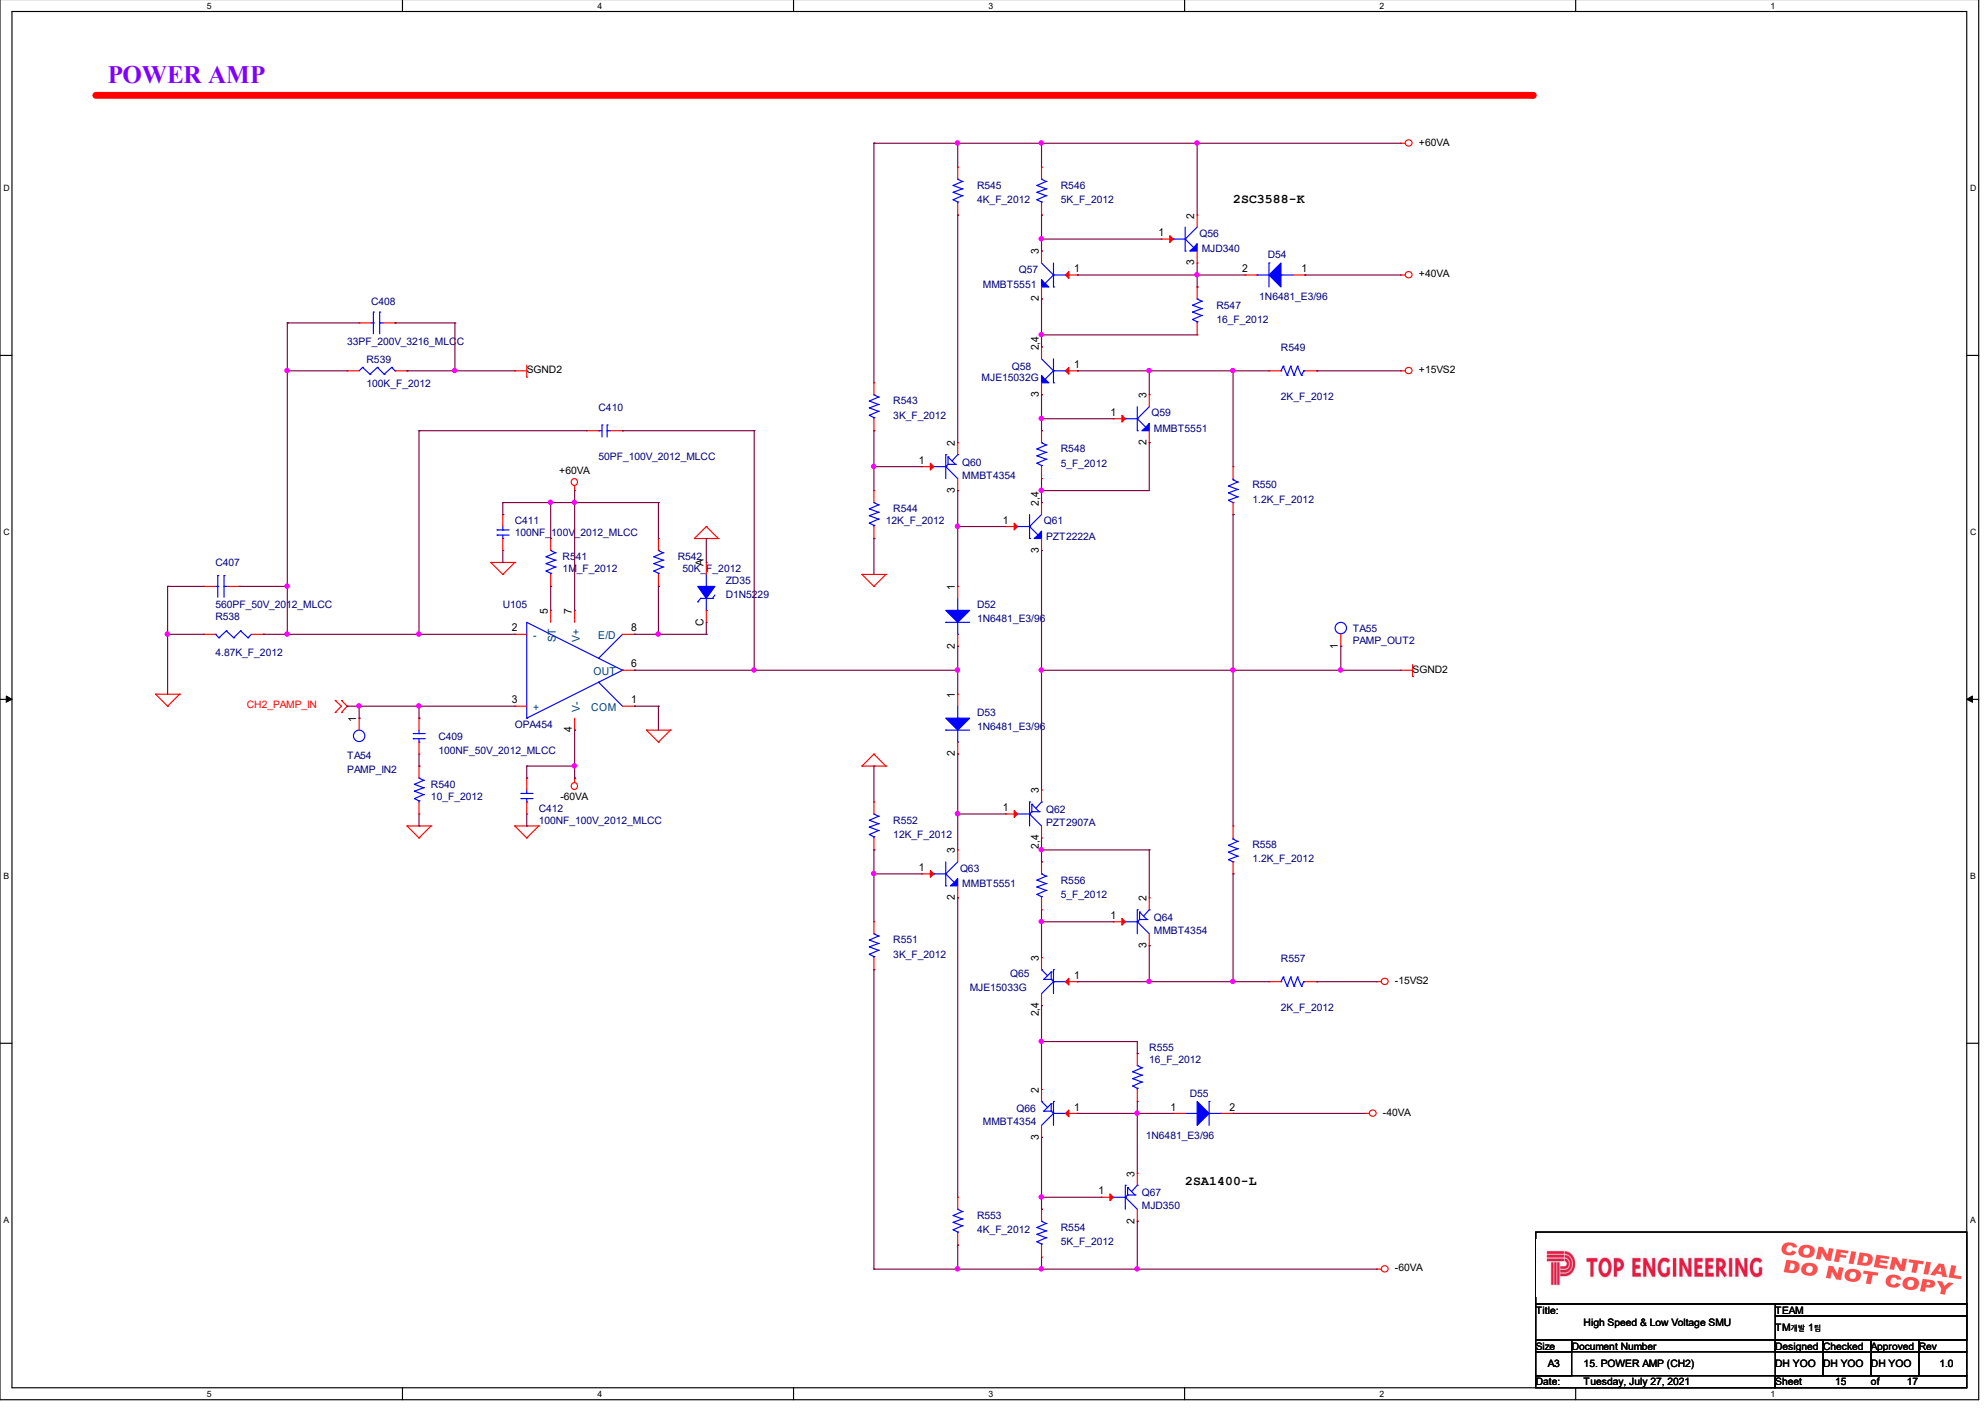
[picture p67: page 15]

CONTROL SIGNAL BUFFER | SIGNAL ISOLATE | I RANGE CONTROL

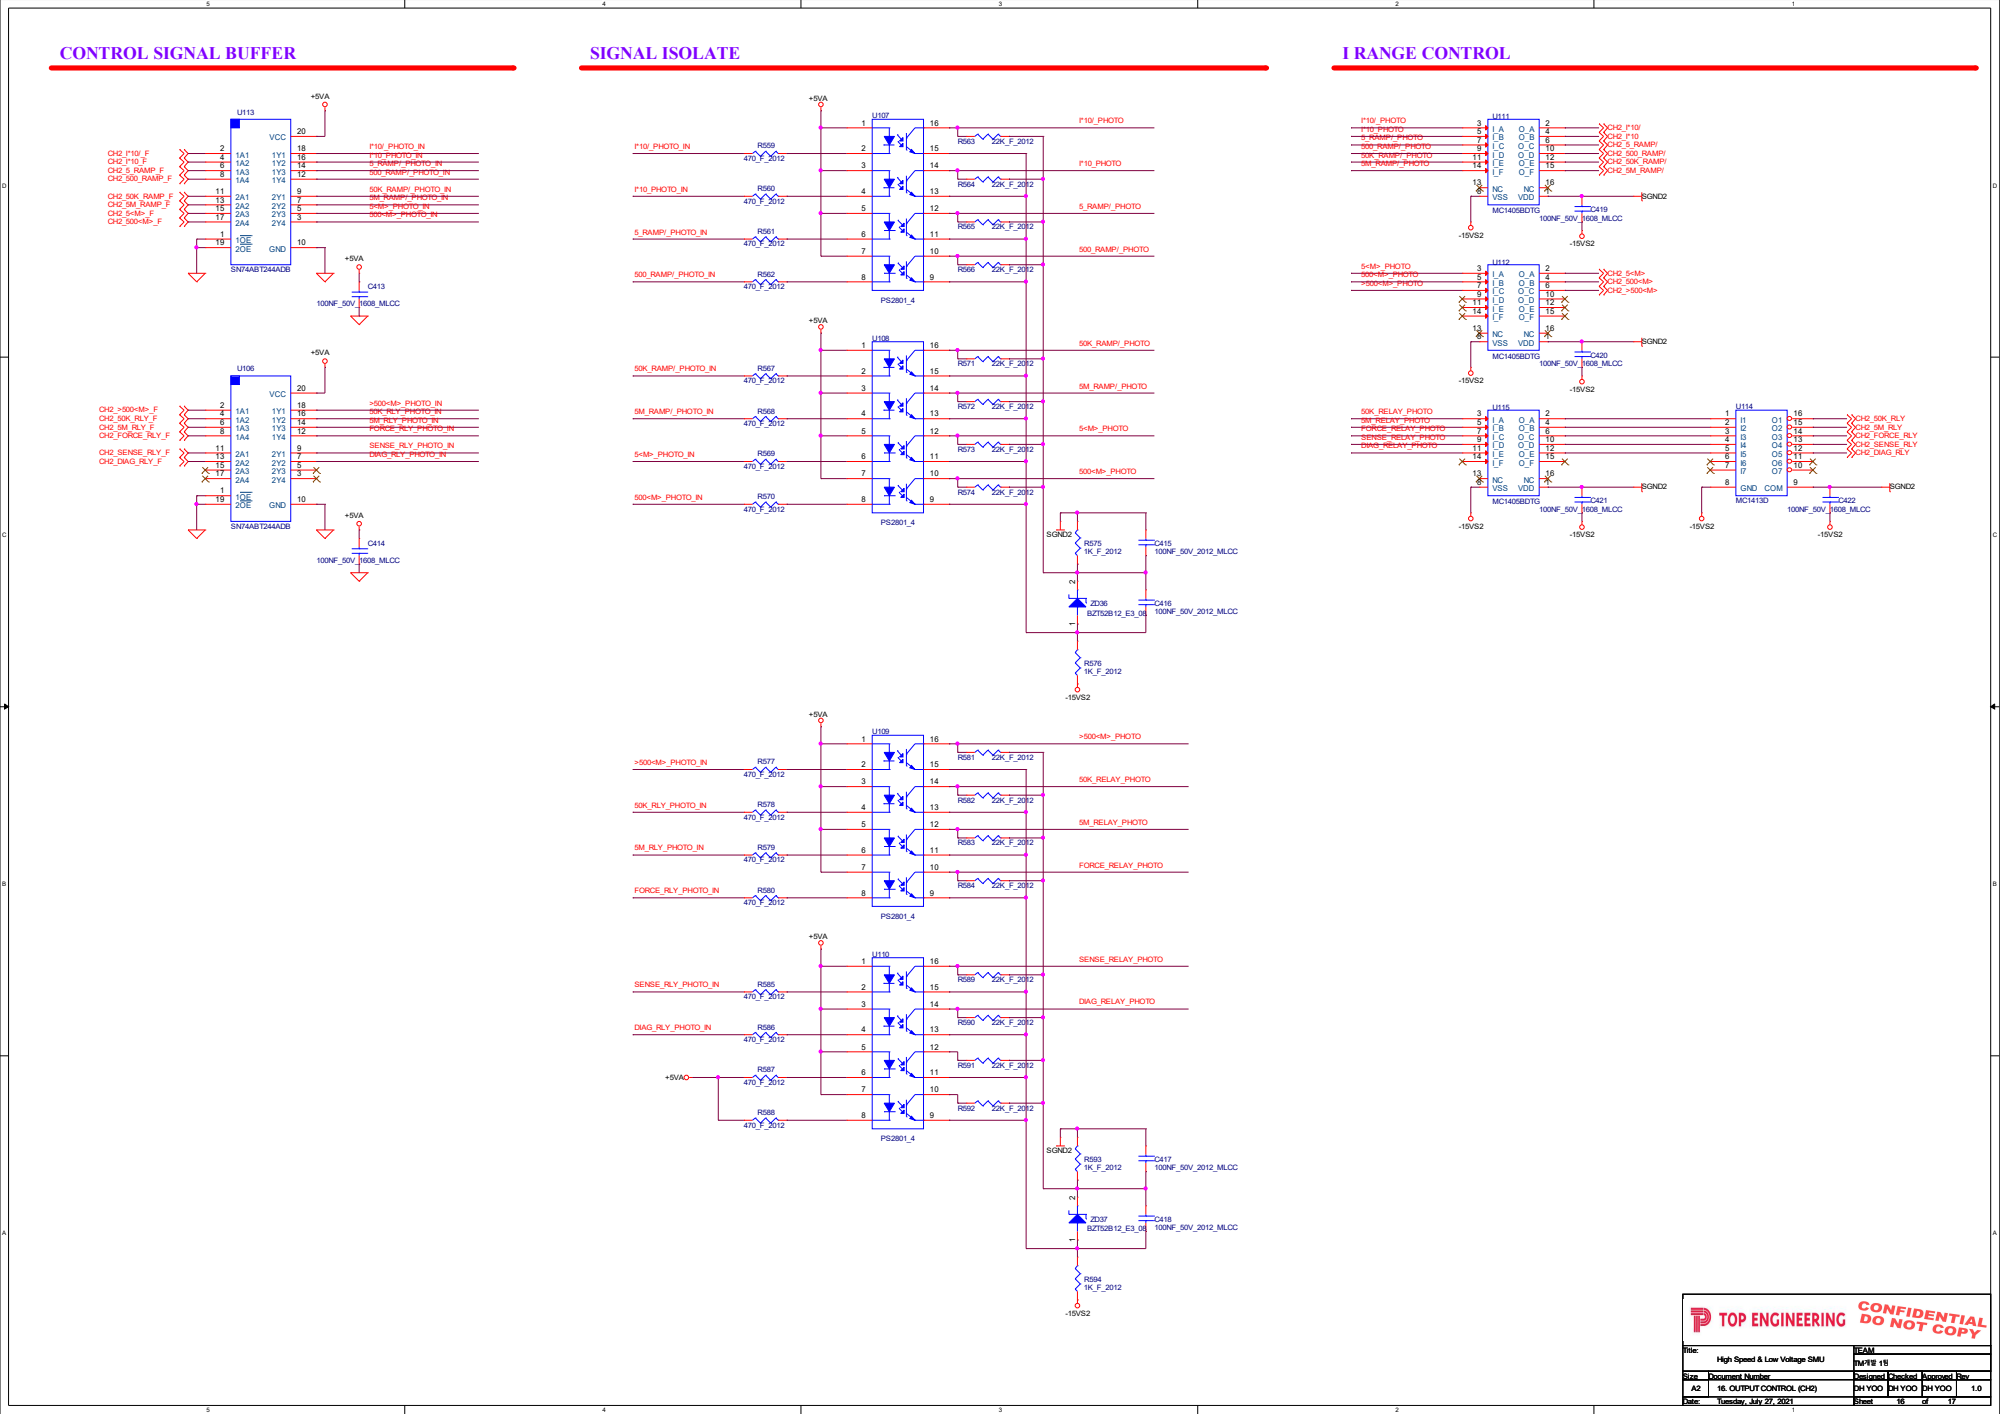
[picture p68: page 16]

## OUTPUT

## U74,U78 장착용 소켓

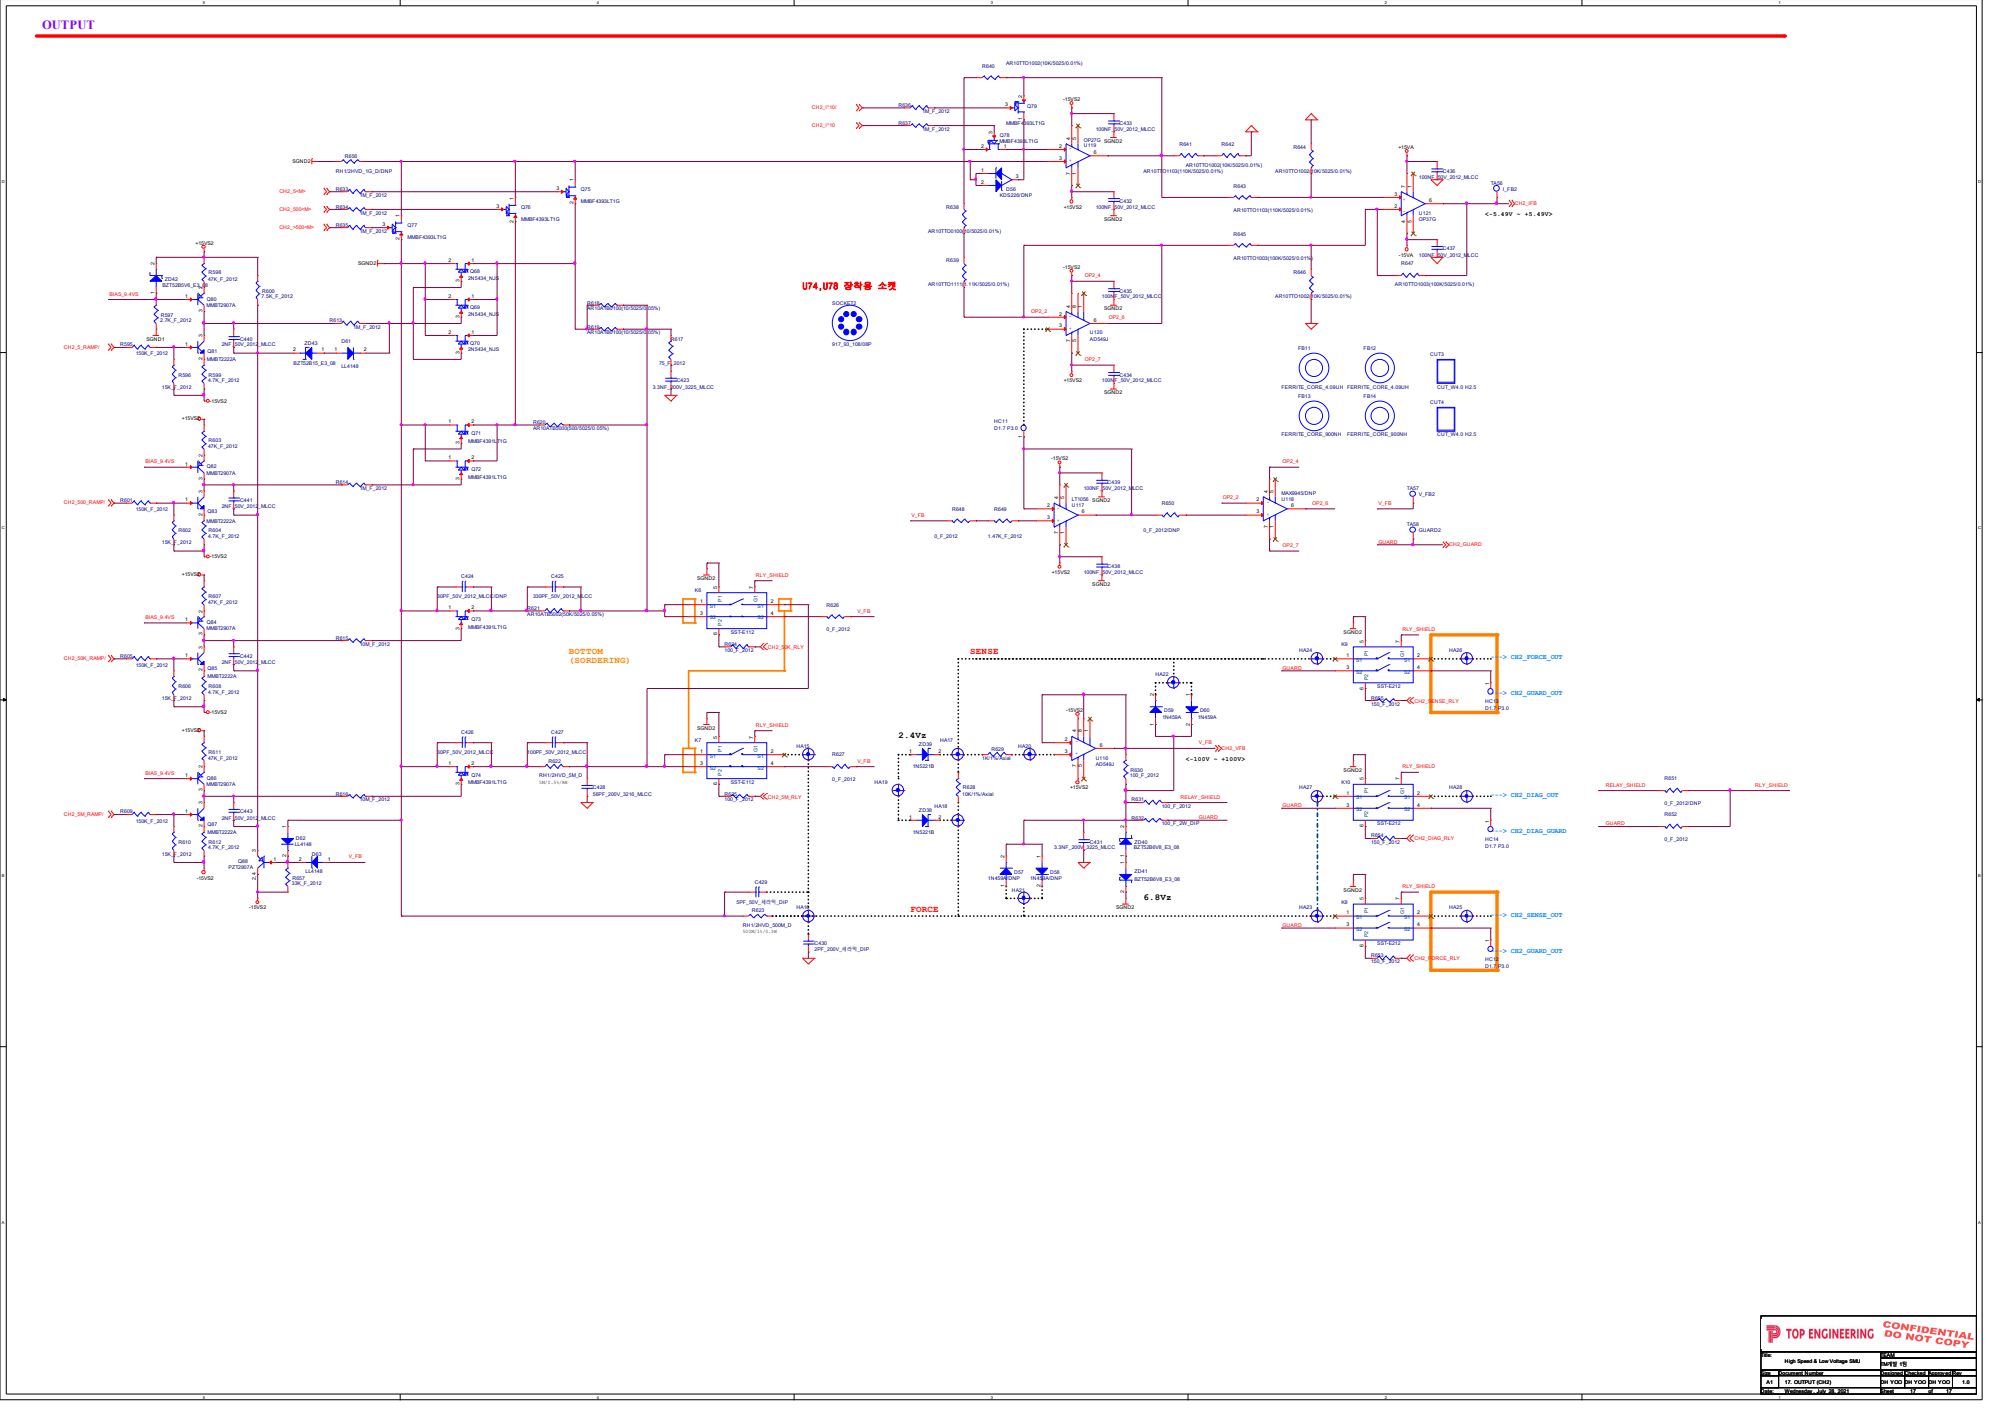
[picture p69: page 17]

Designed Checked Approv ed
