lastoyz/dsn_pgu_adda_s3100_git/dsn/1.sch/_ref/hvsmu2021_07_23.pdf

# Ver 1.1 : 2021.07.23

# Designed By: Yuheon Yi

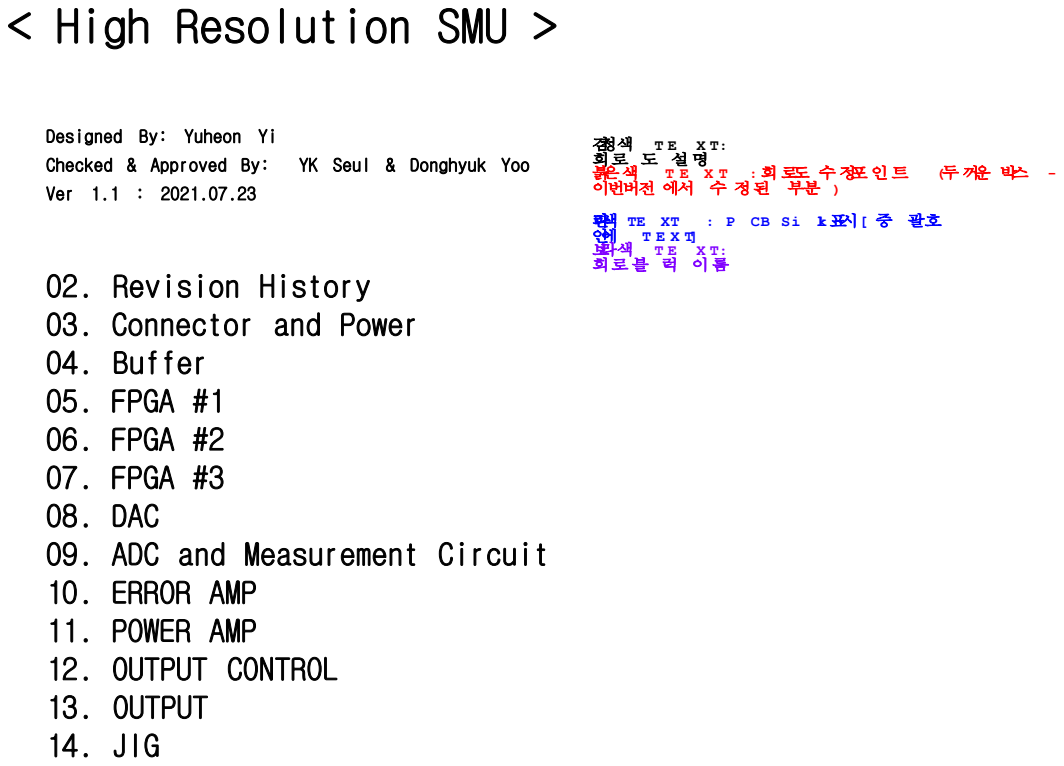
[picture p79: page 1]
Checked & Approved By:; YK Seul & Donghyuk Yoo; 검정색; 파란색 TE XT; 보라색; 회로블 럭 이름; 붉은색; : 회로도 수정포인트; (두꺼운 박스; Title:; Size; Document Number; Date:; Sheet; DesignedChecked Approved; TEAM; 01. Title; DH YOO; Seol YK; Monday, July 26, 2021; TM개발1팀

< High Resolution SMU >

이번버전 에서 수 정된 부분 )

02. Revision History
03. Connector and Power
04. Buffer
05. FPGA #1
06. FPGA #2
07. FPGA #3
08. DAC
09. ADC and Measurement Circuit
10. ERROR AMP
11. POWER AMP
12. OUTPUT CONTROL
13. OUTPUT
14. JIG

High Resoultion SMU

Date | Version
2019.09.16 | 24bit Resoultion ADC & New Range (500mV, 10pA)

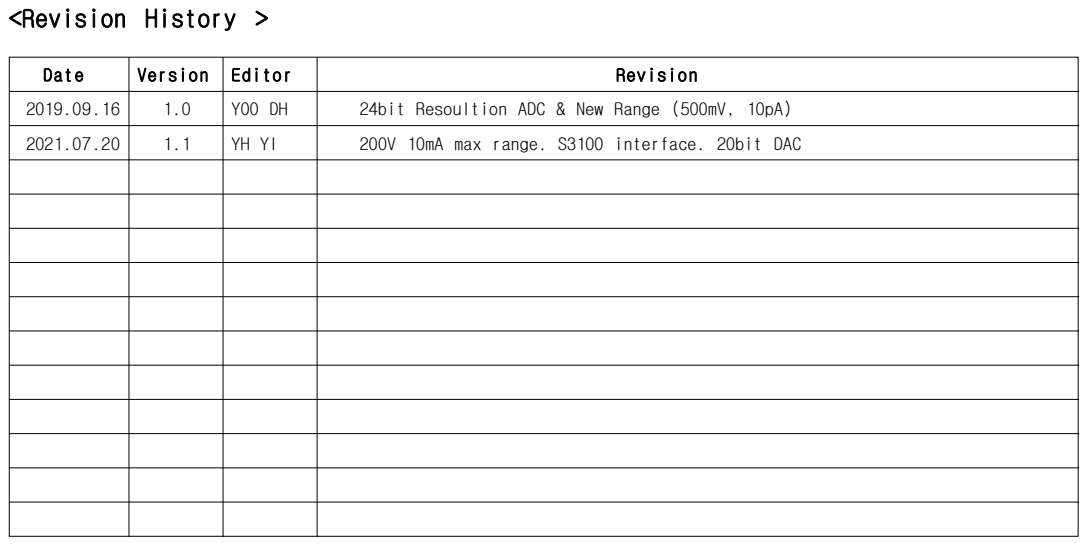
[picture p80: page 2]
Revision; <Revision History >; Editor; YOO DH; 200V 10mA max range. S3100 interface. 20bit DAC; 02. Revision History; Monday, July 26, 2021

# INPUT CONNECTOR

POWER FILTER | 커 페 시 터 | 간 격 유의하여 | A rt wo rk

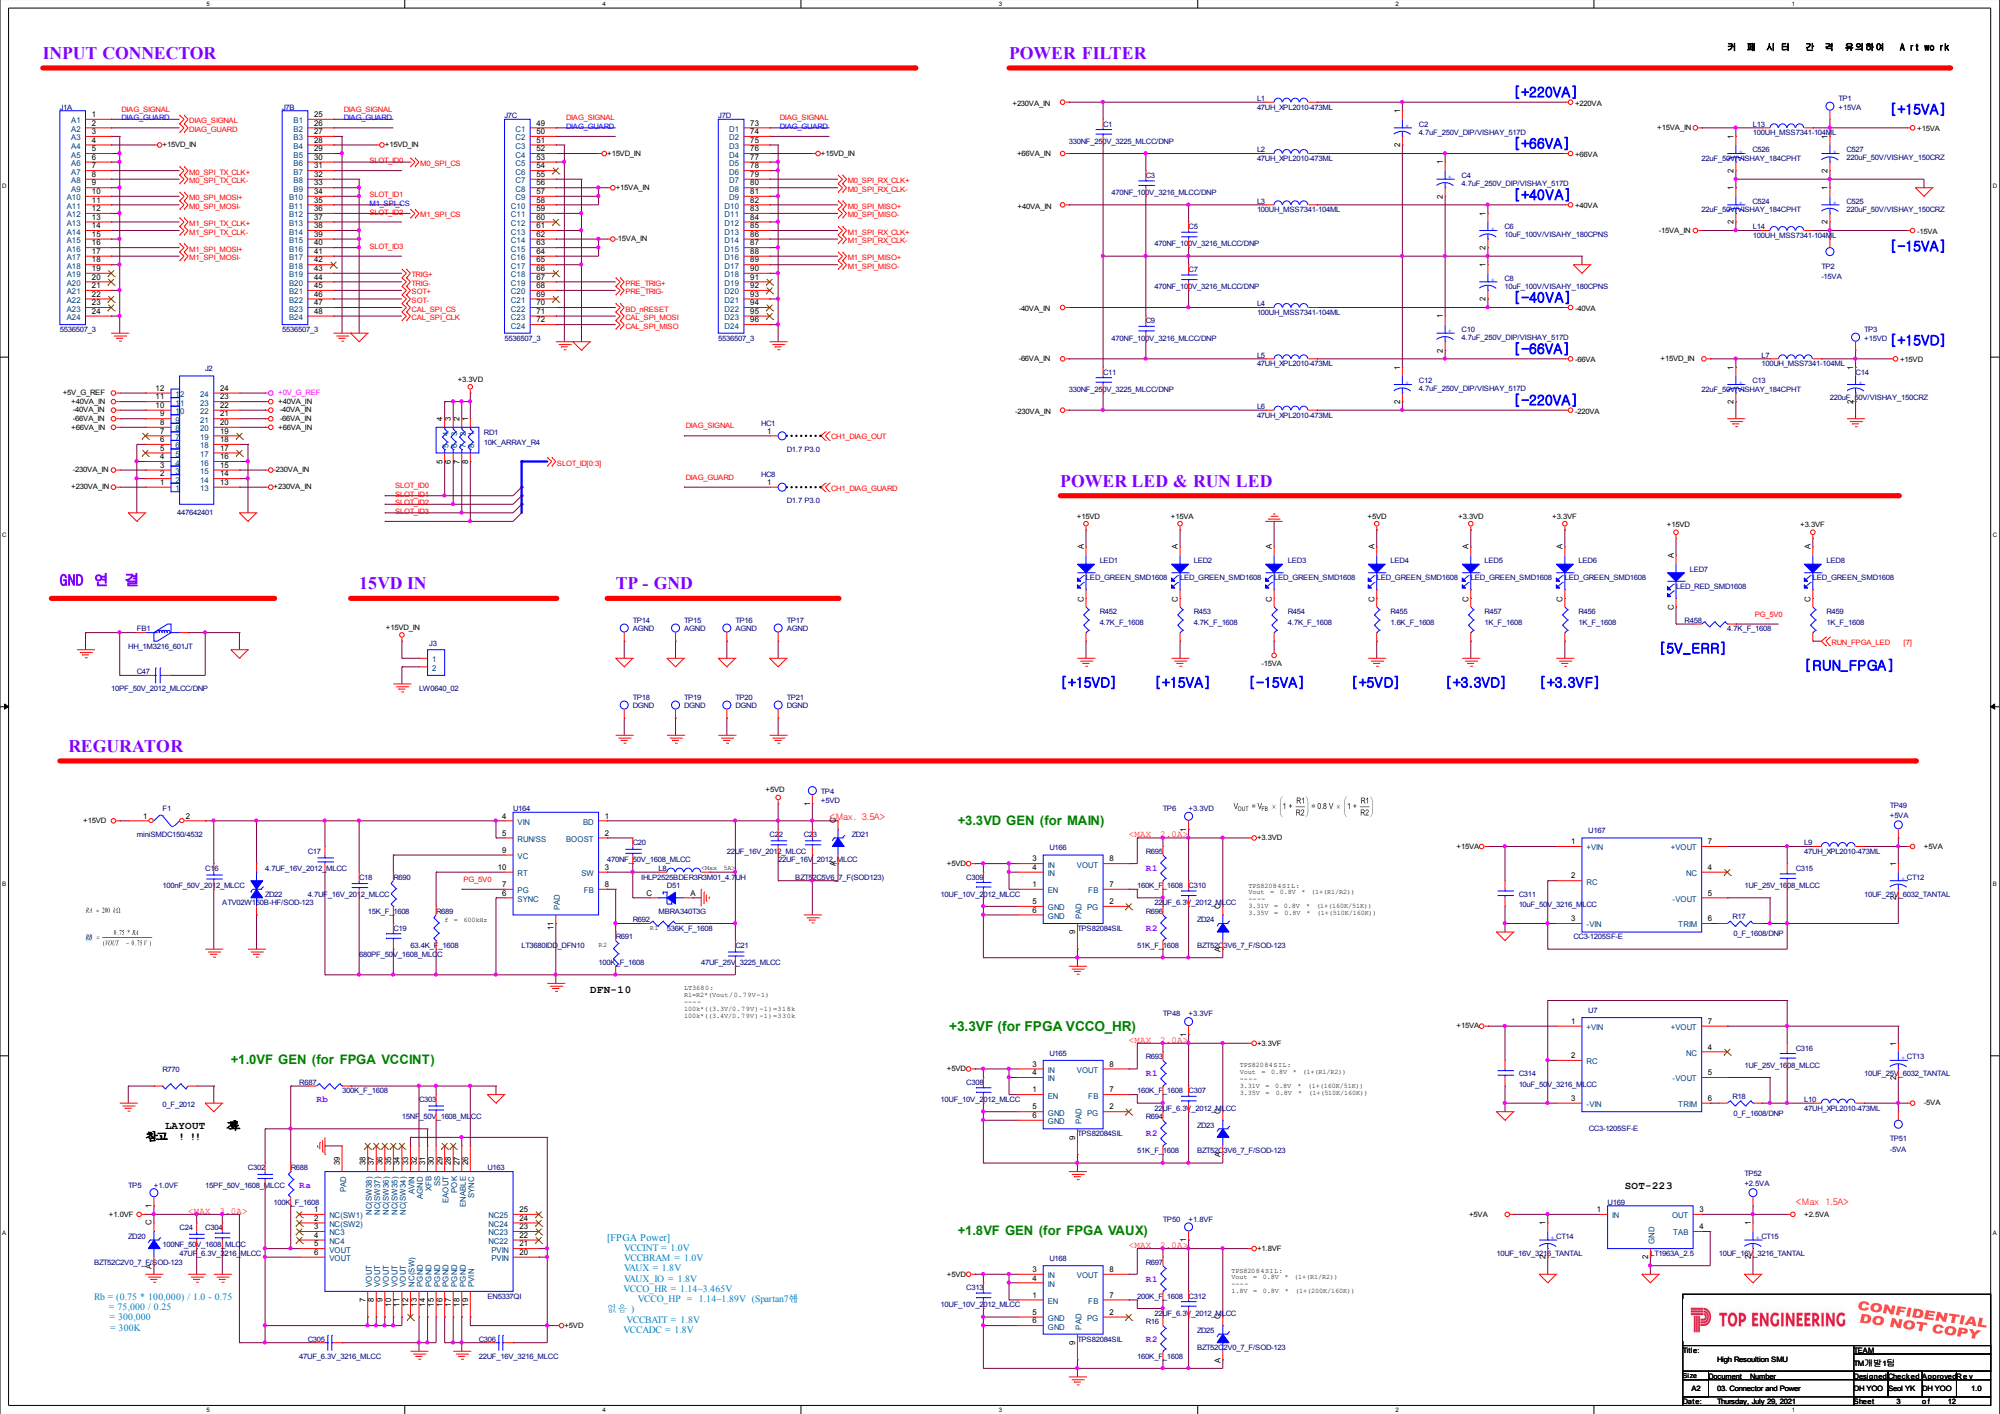
[picture p81: page 3]

POWER LED & RUN LED

+1.0VF GEN (for FPGA VCCINT)

+1.8VF GEN (for FPGA VAUX)

Differential 신 호 는 | 패 턴 | 길 이 | 동 일하게 적용
텀 저 항 | 및 | 풀 업 | 풀 다 운 | 저 항 은 수 신측 근처

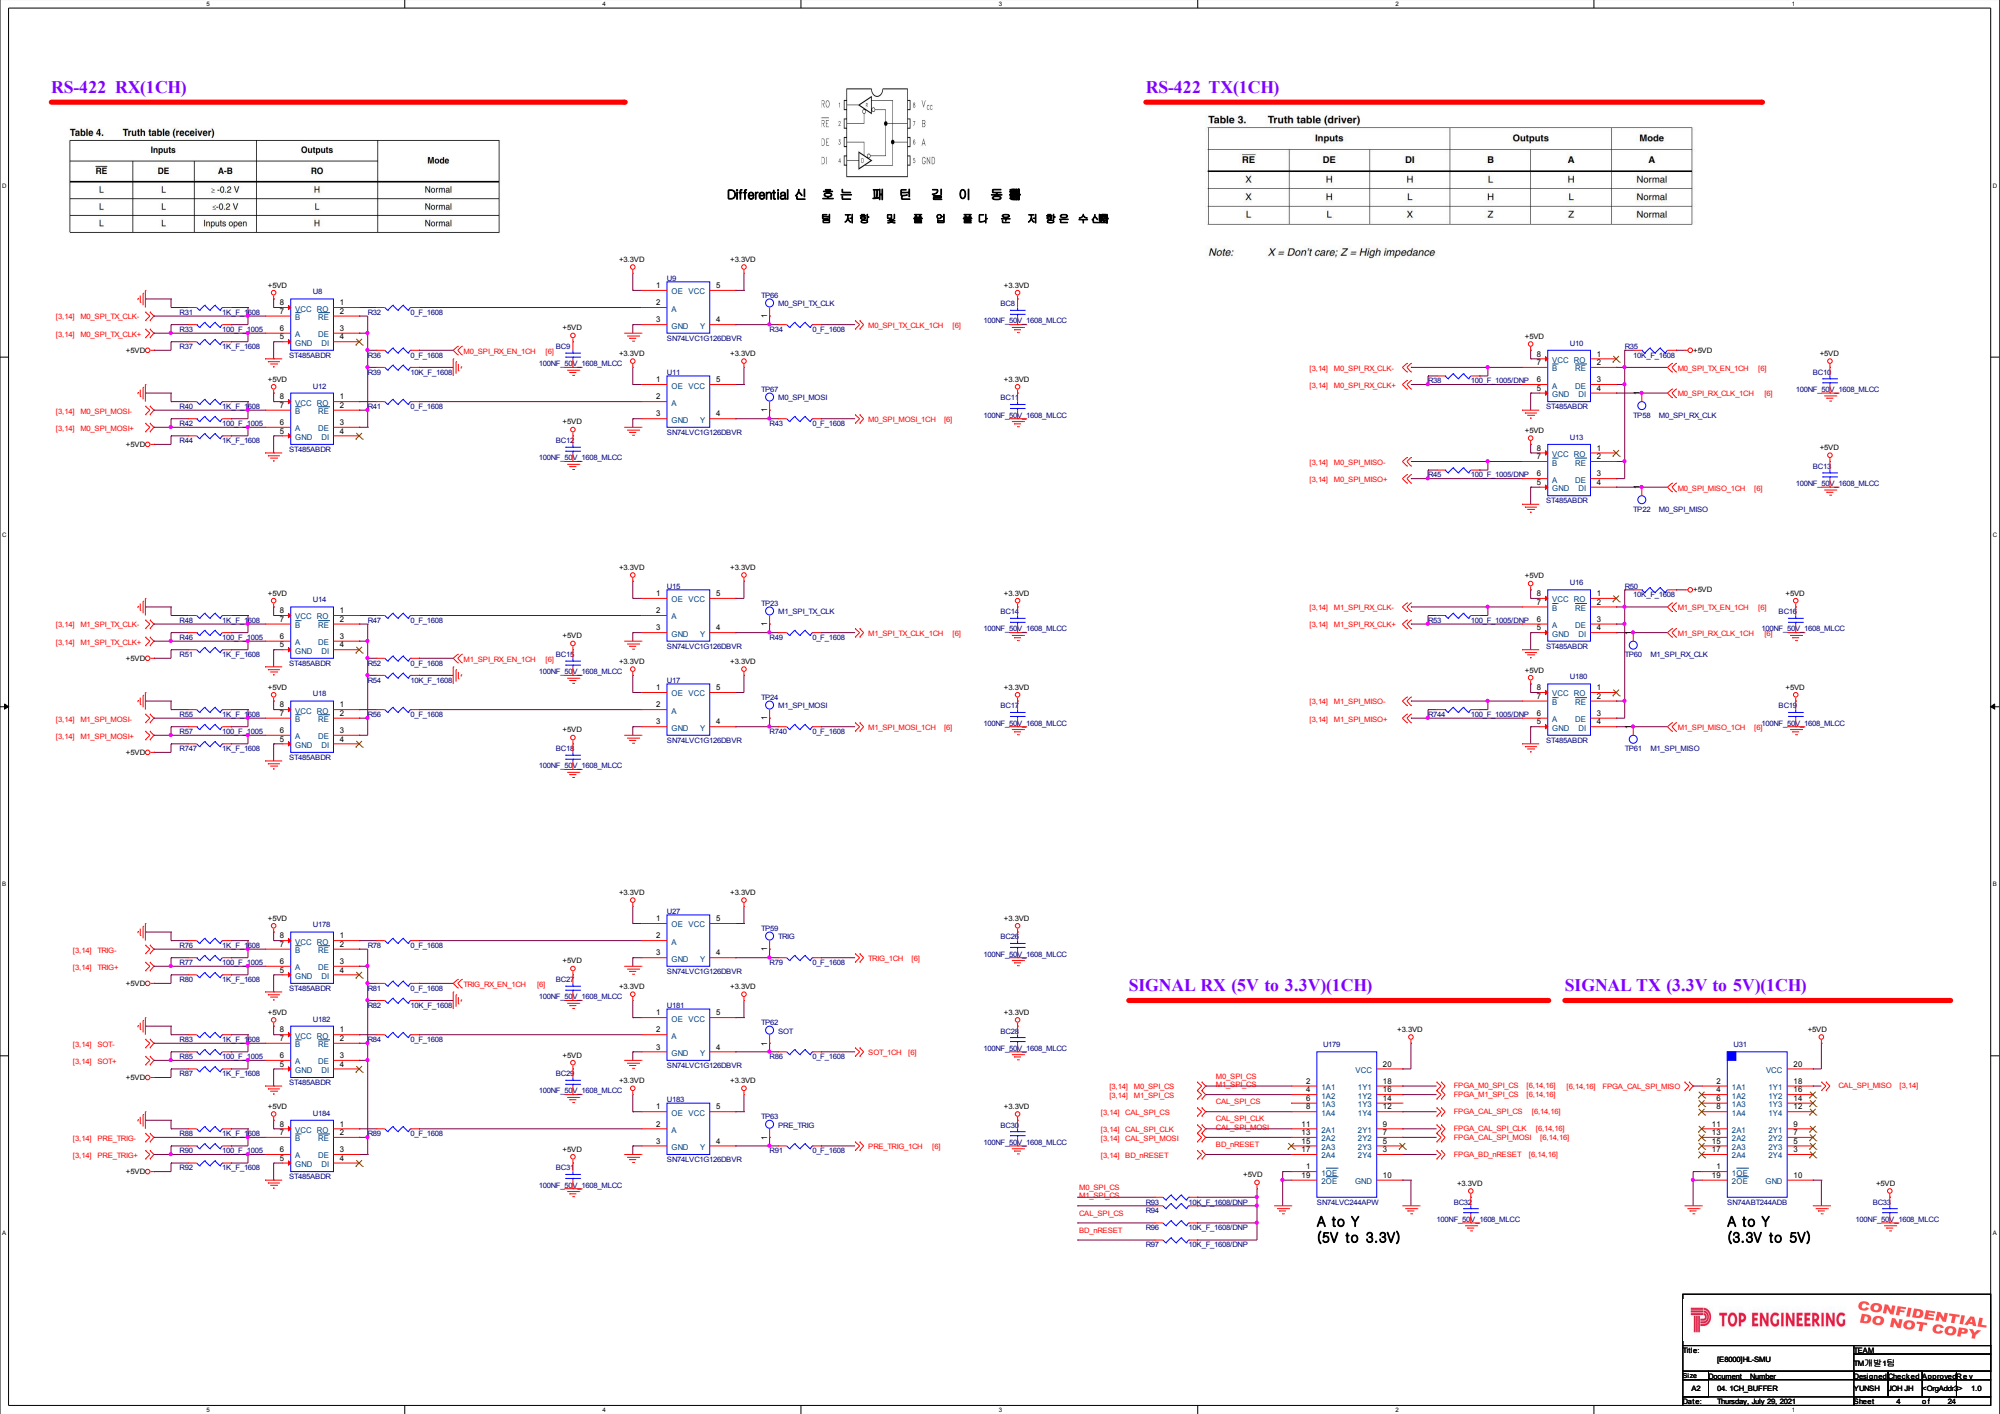
[picture p82: page 4]

# EEPROM 16K 2048X8 1.8V SERIAL EE IND(1CH)

FPGA IO(1CH) | SPI EEPROM(1CH) | Calibration DATA 저 장 용 Seri al EEPROM

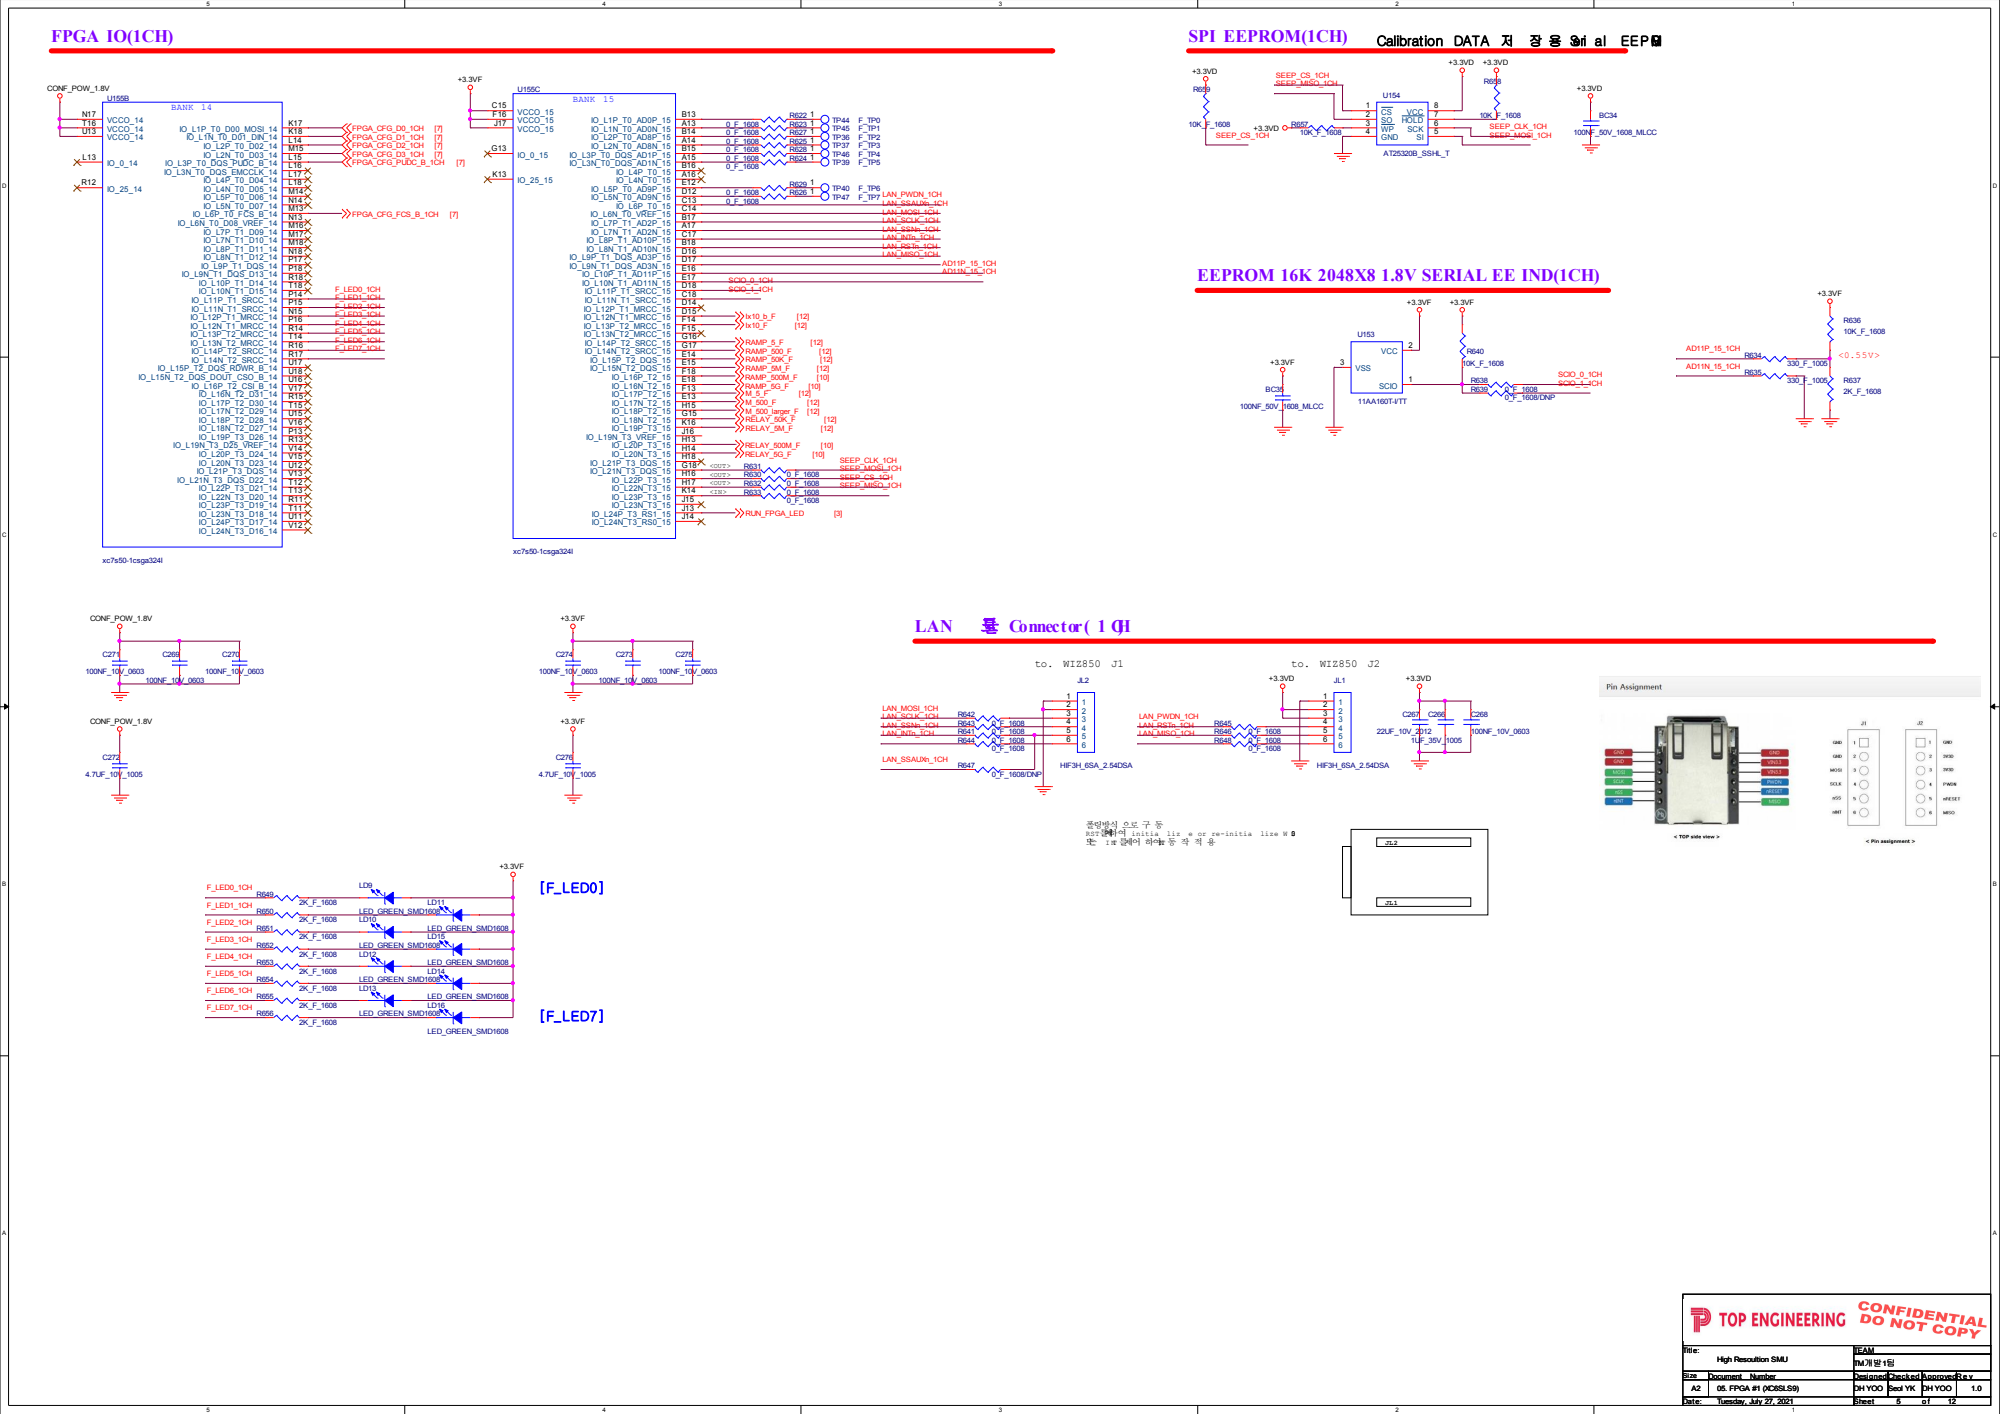
[picture p83: page 5]

폴링방식 으로 구 동
또는 I NT 를제어 하여INT 동 작 적 용

# FPGA IO(1CH)

## 200MHz_LVDS+_1CH

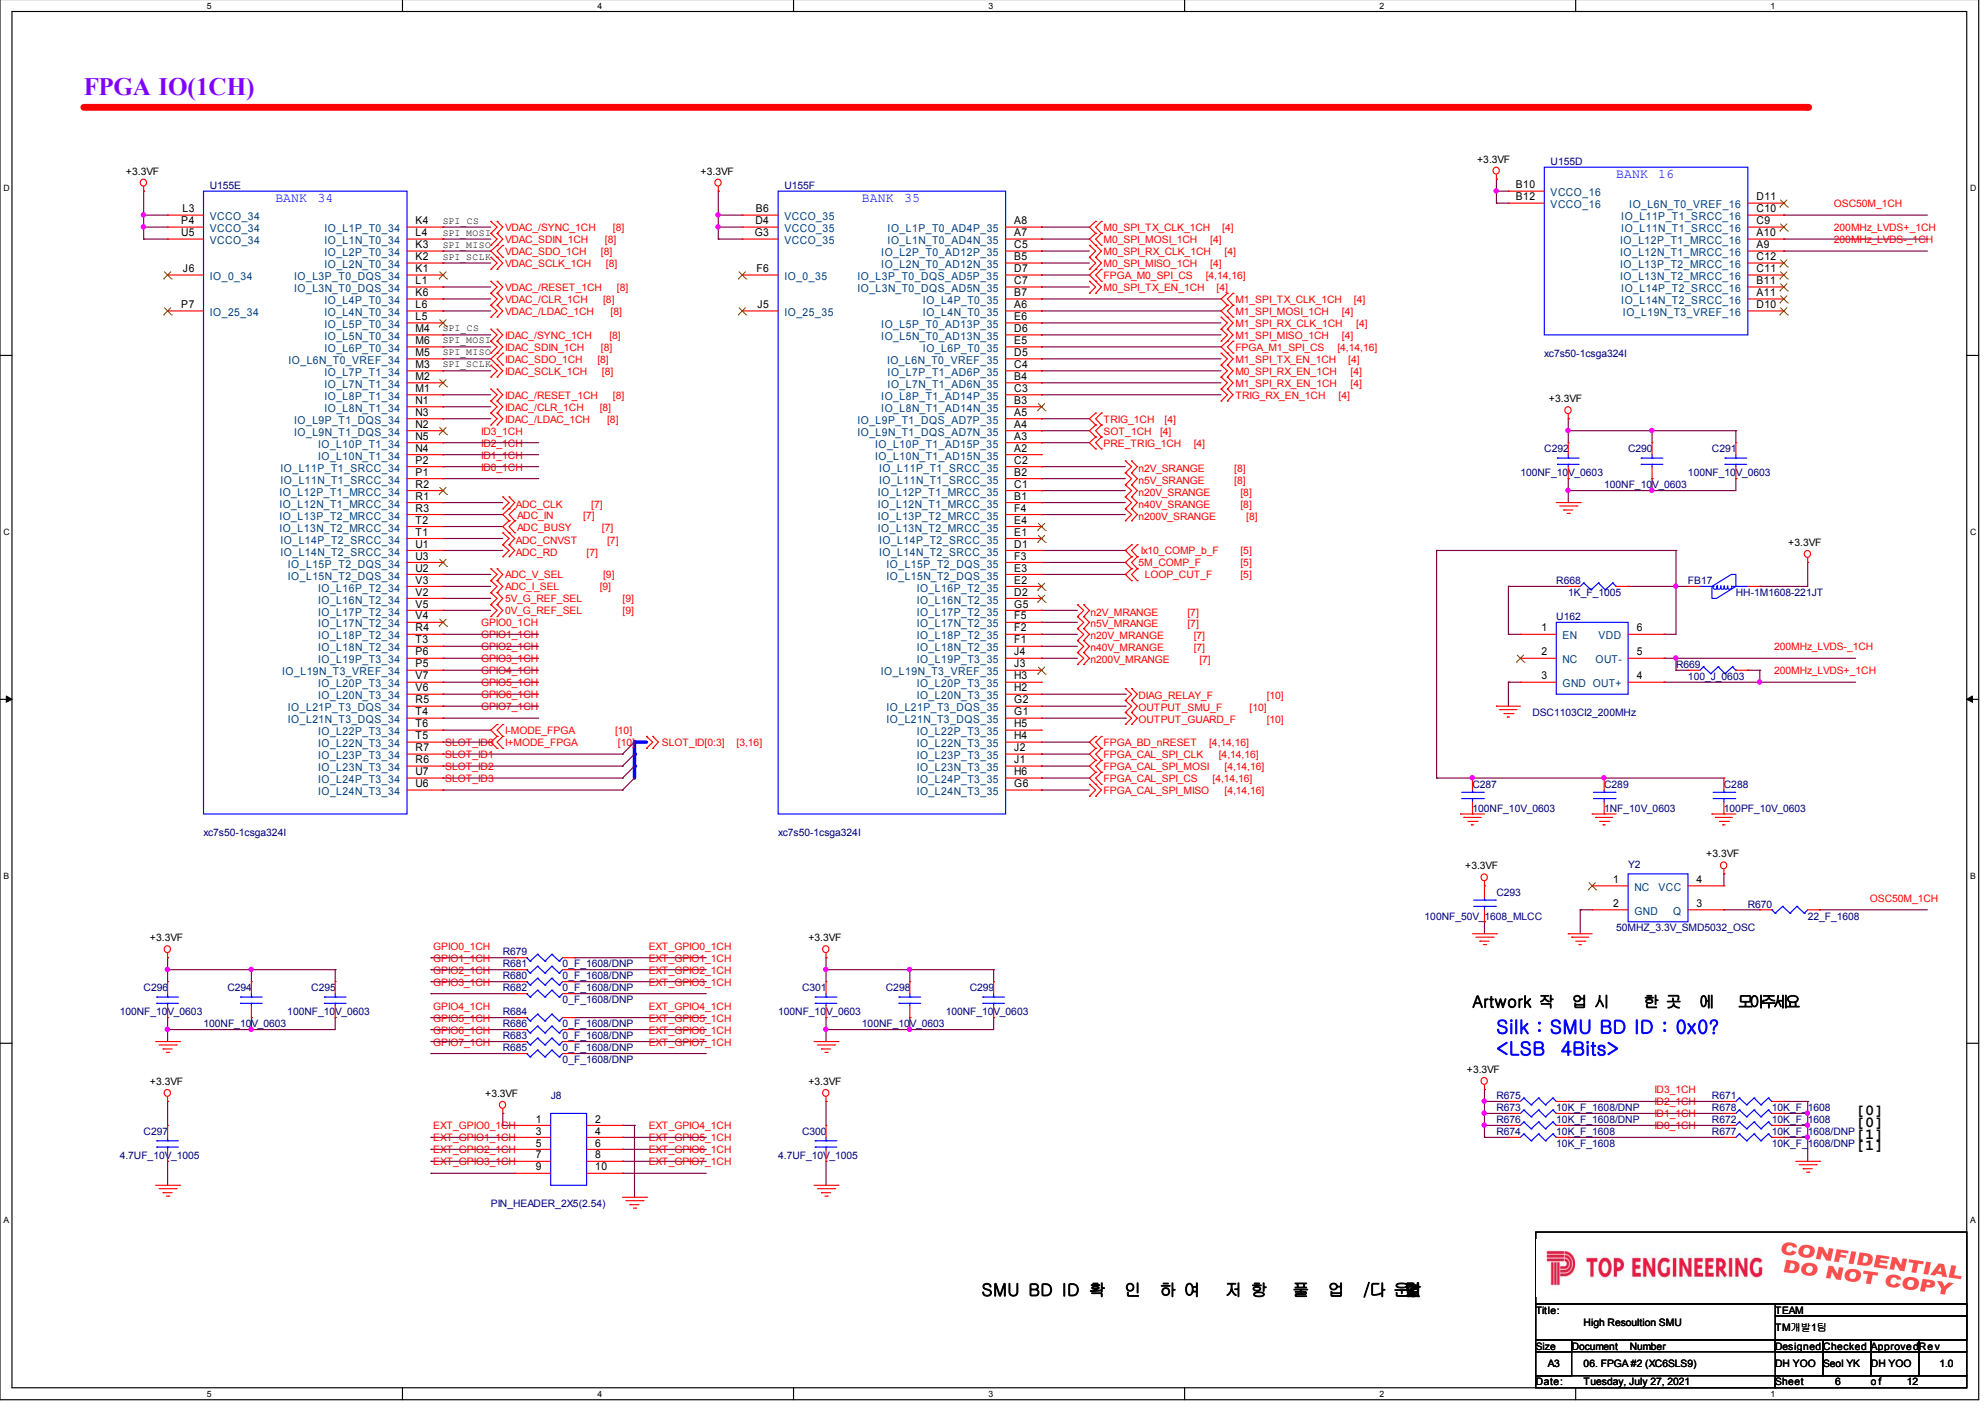
[picture p84: page 6]

Silk : SMU BD ID : 0x0?
<LSB 4Bits>

## 40VR : 44.55 x -0.099 = -4.4V

## 2VR : 2.18 x -2.014 = -4.4V

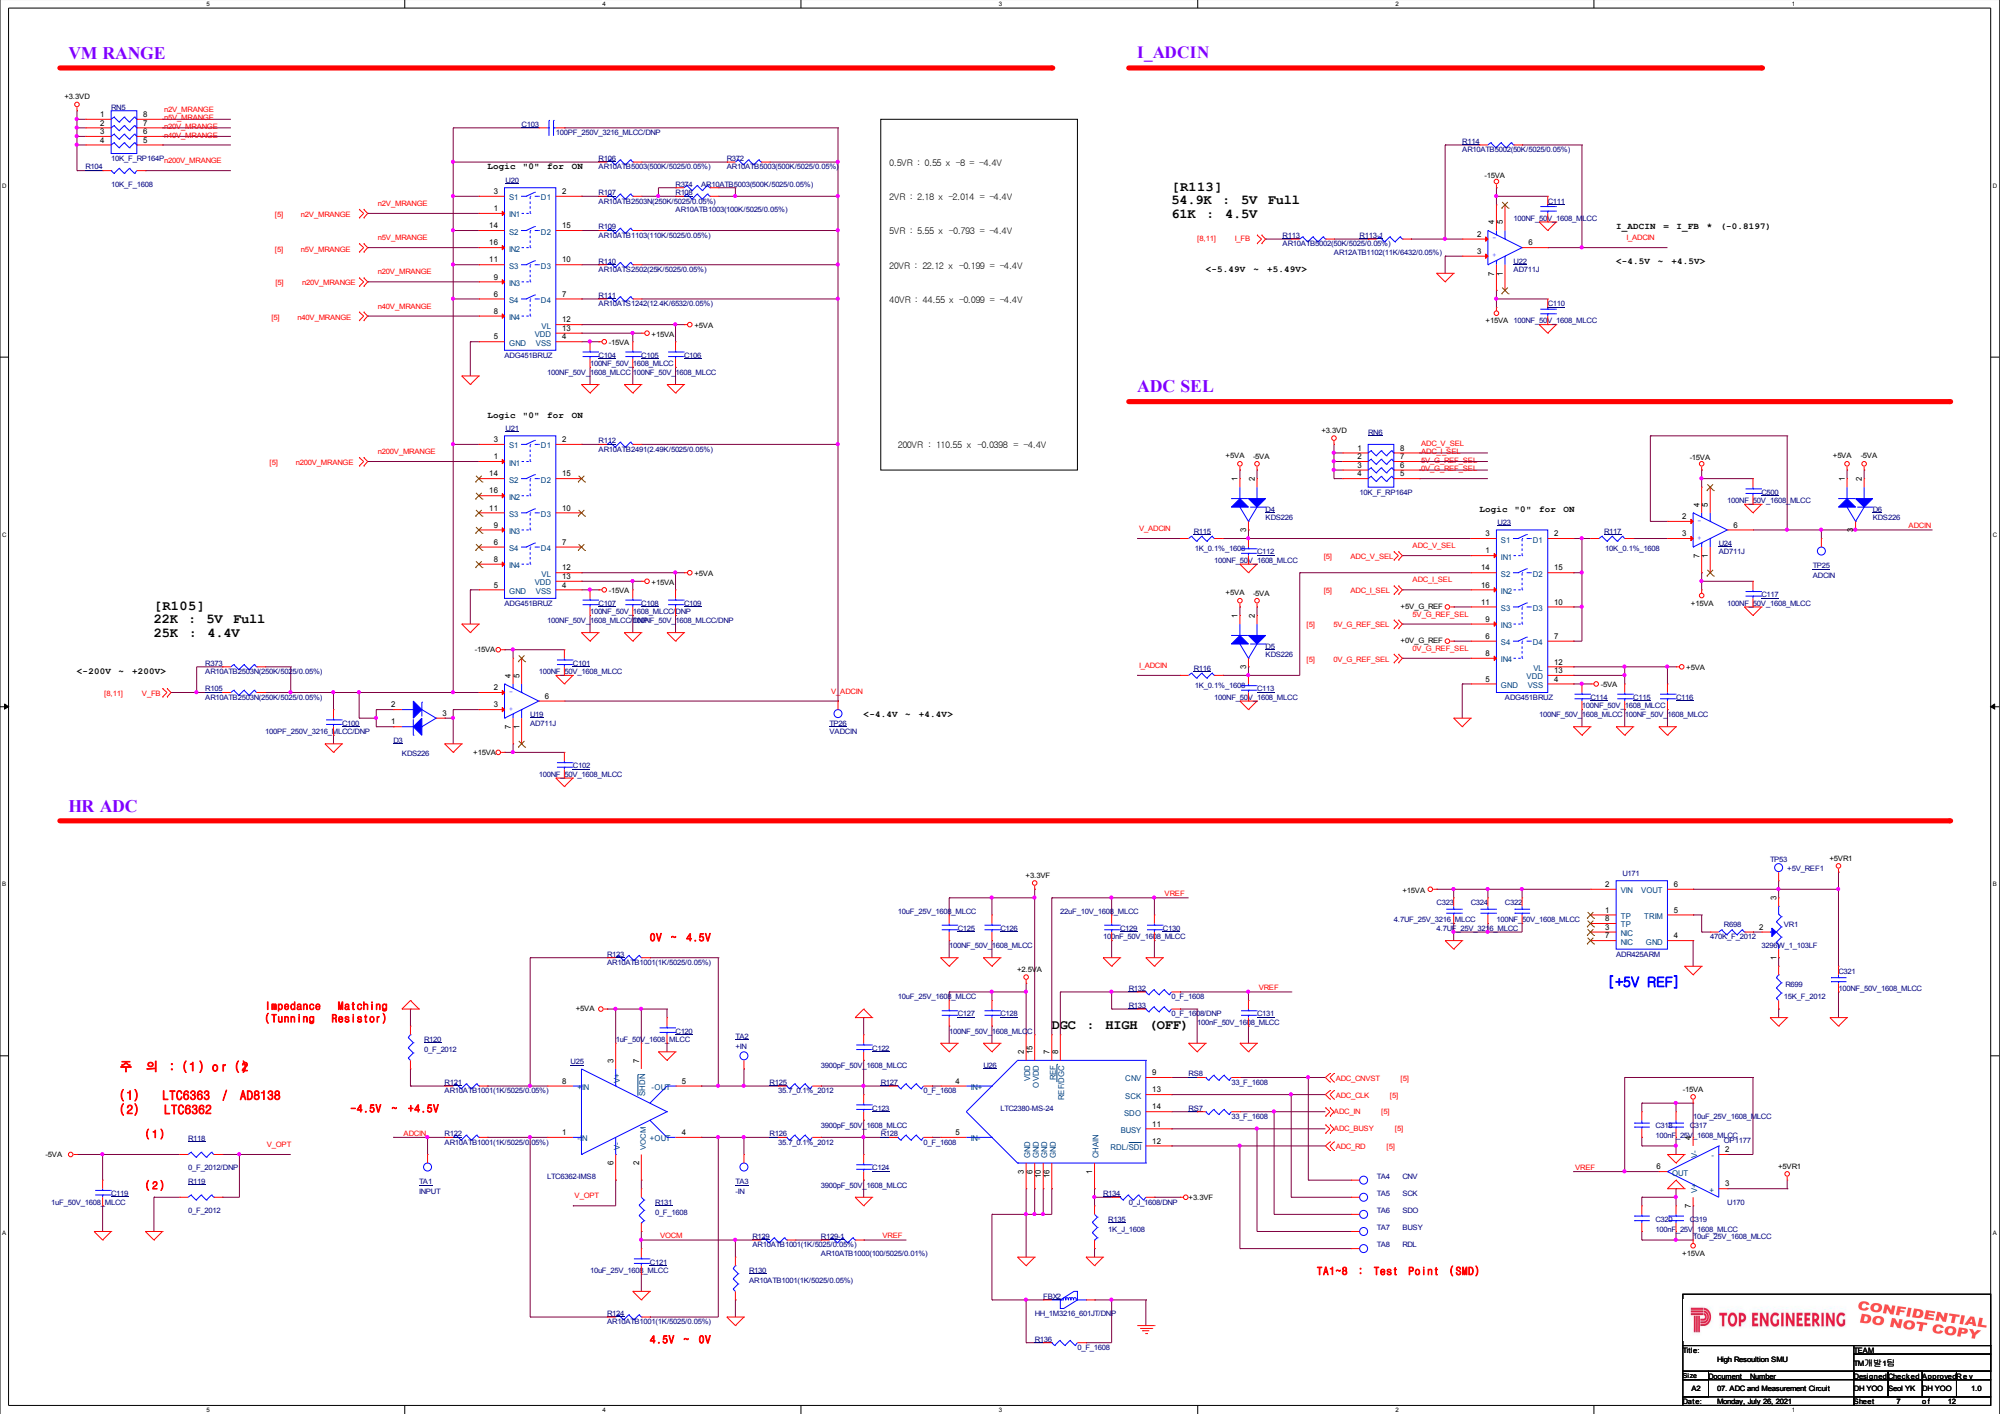
[picture p85: page 7]

D | D
C | C
B | B
A | A

# FPGA - POWER(1CH)

GND_ADC

GND_ADC

GND_ADC

# FPGA - Configuration Part(1CH)

# [FPGA Power] VCCADC = -0.5 ~ 2.0V [1.8V] VREF = -0.5 ~ 2.0V [1.25V] to GNDADC

# [FPGA Power] VCCINT = -0.5~1.1 [1.0V] VCCBRAM = -0.5~1.1 [1.0V] VCCAUX = -0.5 ~ 2.0V [1.8V] VCCAUX_IO = -0.5 ~ 2.0V [1.8V] VCCO_HR = 1.14~3.465V VCCO_HP = 1.14~1.89V (Artix7에는

없음 )

# VCCBATT = -0.5 ~ 2.0V [1.8V]

Temperature-sensing diode pins (Anode: DXP; Cathode:
DXN). The thermal diode is accessed by using the DXP and DXN pins in bank 0. When not used, tie to GND.

Initialization (bar)
Active-Low FPGA initialization pin or configuration error signal. The FPGA drives this pin Low when the
FPGA is in a configuration reset state, when the FPGA is initializing (clearing) its configuration memory, or when the FPGA has detected a configuration error. Upon completing the FPGA initialization process, INIT_B is released to high-Z at which time an external resistor is expected to pull INIT_B High. INIT_B can externally be held Low during power-up to stall the power-on configuration sequence at the end of the initialization process. When a High is detected at the INIT_B input after the initialization process, the FPGA proceeds with the remainder of the configuration sequence dictated by the M[2:0] pin settings.
Connect INIT_B to a ≤ | 4.7 kΩ | pull-u p resisto r t o VCCO_0
to ensure clean Low-to-High transitions.

# [JTAG]

Done
A High signal on the DONE pin indicates completion of the configuration sequence. The DONE output is an open-drain output by default.

Program (bar)
Active-Low reset to configuration logic. When PROGRAM_B is pulsed Low, the FPGA configuration is cleared and a new configuration sequence is initiated. Configuration reset initiated upon falling edge, and configuration (i.e. programming) sequence begins upon the following rising edge.
Connect PROGRAM_B to an external ≤ | 4.7 kΩ | pull-up
resistor to VCCO_0 to ensure a stable High input, and recommend push-button to GND to enable manual configuration reset.

## MT25QL = 2.7V ~ 3.6V MT25QU = 1.7V ~ 2.0V

Pull-Up During Configuration (bar)
Active-Low PUDC_B input enables internal pull-up resistors on the SelectIO pins after power-up and during configuration.
> When PUDC_B is Low, internal pull-up resistors are enabled on each SelectIO pin.
> When PUDC_B is High, internal pull-up resistors are disabled on each SelectIO pin.
PUDC_B must be tied either directly, or via a ≤ 1kΩ to VCCO_14 or GND.
Caution! Do not allow this pin to float before and during configuration

If the TCK signal is
buffered, connect the buffer input to an external weak (e.g. 10 kΩ ) pull-up resistor to maintain a valid High when no cable is connected.

If the TMS signal is buffered, connect the buffer
input to an external weak (e.g. 10 kΩ ) pull-up resistor to maintain a valid High when no cable is connected.

VCCBATT is required only when using bitstream encryption. If battery is not used, connect VCCBATT
to either ground or VCCAUX.

If the VCCO_0 supply for bank 0 is
supplied with 2.5V or 3.3V, then the CFGBVS pin must be tied High (i.e. connected to VCCO_0). Tie CFGBVS to Low (i.e. connected to GND), only if the VCCO_0 for bank 0 is less than or equal to 1.8V. If used during configuration, banks 14 and 15 should match the VCCO level applied to bank 0

Configuration Mode Sel (M2:0)
- Master SPI: 001
- Master Serial: 000
- JTAG: 101

## S25FL256SAGNFI001

## S25FL128SAGNFI001

## MT25QU256ABA1EW9_0SIT

# [FPGA Power] VCCINT = -0.5~1.1 [1.0V] VCCBRAM = -0.5~1.1 [1.0V] VCCAUX = -0.5 ~ 2.0V [1.8V] VCCAUX_IO = -0.5 ~ 2.0V [1.8V] VCCO_HR = 1.14~3.465V VCCO_HP = 1.14~1.89V (Spatan7에는

없음 )

# VCCBATT = -0.5 ~ 2.0V [1.8V] VCCADC = -0.5 ~ 2.0V [1.8V]

## <MAX 1.0A>

GND_ADC | GND_ADC

GND_ADC

## B0_XADC_VP_1CH B0_XADC_VN_1CH

## B0_XADC_VP_1CH B0_XADC_VN_1CH

## FPGA_VBATT_1CH

## FPGA_CCLK_1CH

## FPGA_M0_1CH FPGA_M1_1CH FPGA_M2_1CH

## FPGA_DONE_1CH

## FPGA_PROG_B_1CH

## FPGA_CFGBVS_1CH

## VREF+_1CH

## JTAG_TDO_1CH JTAG_TDI_1CH

## JTAG_TCK_1CH JTAG_TMS_1CH

## FPGA_INIT_B_1CH

## JTAG_TCK_1CH

## JTAG_TDO_1CH

## JTAG_TMS_1CH

## JTAG_TDI_1CH

## JTAG_TCK_1CH

## FPGA_DONE_1CH

## FPGA_PROG_B_1CH

## FPGA_INIT_B_1CH

## FPGA_M2_1CH

## FPGA_M0_1CH

## FPGA_M1_1CH

## FPGA_VBATT_1CH FPGA_CFGBVS_1CH

## FROM_nHOLD_1CH

## FROM_DQ2/nW_1CH

## FROM_nS_1CH

## FROM_nHOLD_1CH FROM_DQ2/nW_1CH

## FROM_nS_1CH

## FPGA_CCLK_1CH

## FPGA_CCLK_1CH

## VREF+_1CH

+1.0VF

+1.0VF | +1.8VF
+1.0VF | +1.8VF

+3.3VF

+1.8VF | CONF_POW_1.8V | CONF_POW_1.8V

## VCC_ADC

+1.0VF | +1.8VF | +1.0VF

## CONF_POW_1.8V

## CONF_POW_1.8V

CONF_POW_1.8V | CONF_POW_1.8V

## CONF_POW_1.8V

## CONF_POW_1.8V

## CONF_POW_1.8V

+1.8VF | VCC_ADC | VCC_ADC

+1.0VF

## [5] FPGA_CFG_PUDC_B_1CH

## [5] FPGA_CFG_D1_1CH

## FPGA_CFG_D0_1CH [5]

## [5] FPGA_CFG_FCS_B_1CH FPGA_CFG_D2_1CH [5]

## [5] FPGA_CFG_D3_1CH

Size | Document | Number | Re v

## Designed Checked Approved

07. 1CH_FPGA #3 (XC7S50) | 1.0

## [E8000]HL-SMU

A3 | YUNSH | JOH JH | <OrgAddr3>
Thursday, July 29, 2021 | 7 | 24
Size | Document | Number | Re v

## Designed Checked Approved

07. 1CH_FPGA #3 (XC7S50) | 1.0

## [E8000]HL-SMU

A3 | YUNSH | JOH JH | <OrgAddr3>
Thursday, July 29, 2021 | 7 | 24
Size | Document | Number | Re v

## Designed Checked Approved

07. 1CH_FPGA #3 (XC7S50) | 1.0

## [E8000]HL-SMU

A3 | YUNSH | JOH JH | <OrgAddr3>
Thursday, July 29, 2021 | 7 | 24

C64

## 100NF_50V_1005

R725

## 1K_F_1005/DNP

C69

## 100NF_50V_1608

C63

## 1UF_35V_1005

R702

## 1K_F_1608

C75

## 100NF_10V_0603

R708

## 0_F_1005

R723

## 1K_F_1005/DNP

R730

## 1K_F_1005

C61

## 10NF_6.3V_0603

R735

## 4.7K_F_1005

C84

## 100NF_10V_0603

R714

## 1K_F_1005

C65

## 470NF_6.3V_0603

R707

## 0_F_1005

R729
1K_F_1005 | R716

## 10K_F_1005

R739

## 100_F_1005/DNP

C83

## 100NF_10V_0603

U174

## REF3012AIDBZR

IN

1

## OUT 2

GND

3

R721

## 330_F_1005

C68

## 100NF_50V_1608

C503

## 22UF_6.3V_1608

C504

## 100NF_50V_1005

C72

## 100NF_10V_0603

## xc7s50-1csga324I

U155G

## GND A1 GND A12 GND A18 GND B9 GND C6 GND C16 GND D3 GND D13 GND E8 GND E10 GND F7 GND F9 GND F11 GND F17 GND G4 GND G8 GND G10 GND G12 GND G14 GND H1 GND H7 GND H11 GND J8 GND J12 GND J18

GND | K5
GND | K7
GND | K11
GND | K15
GND | L2
GND | L8
GND | L12
GND | M7
GND | M9
GND | M11
GND | N6
GND | N8
GND | N10
GND | N12
GND | N16
GND | P3
GND | P9
GND | P11
GND | R10
GND | T7
GND | T17
GND | U4
GND | U14
GND | V1
GND | V11
GND | V18

## xc7s50-1csga324I

U155H

## VCCINT E7 VCCINT E9 VCCINT E11 VCCINT F8 VCCINT F10 VCCINT G7 VCCINT G9 VCCINT G11 VCCINT H8 VCCINT J7 VCCINT J11 VCCINT K8 VCCINT L11 VCCINT M8 VCCINT M10 VCCINT N9 VCCINT N11 VCCINT P8 VCCINT P10

VCCAUX | F12
VCCAUX | H12
VCCAUX | K12
VCCAUX | M12
VCCAUX | P12
VCCBRAM | L7
VCCBRAM | N7

## 1K_F_1608

C90

## 100NF_50V_1005

C82

## 100NF_10V_0603

C70

## 100NF_50V_1005

R713

## 1K_F_1005/DNP

R712

## 0_F_1005

C88

## 100NF_10V_0603

TP43
+0.55V

1

C91

## 100NF_10V_0603

C71

## 100NF_10V_0603

R711

## 0_F_1005

C95

## 100NF_10V_0603

C87

## 100NF_10V_0603

R737

## 51_F_1005

C78

## 100NF_10V_0603

R728

## 1K_F_1005

C86

## 100NF_10V_0603

U173

## MT25QU128ABA1EW9_0SIT

## VCC 8

DQ0 5

S# 1

W/VPP/DQ2 | 3
C | 6

DQ1 2

VSS | 4
HOLD/DQ3 7 | EPAD

9

R718

## 10K_F_1005

R710

## 0_F_1005

R701

## 1K_F_1608

TP42
+0.275V

1

R726

## 1K_F_1005

R734

## 4.7K_F_1005

R736

## 51_F_1005

C99

## 4.7UF_10V_1005

C76

## 100NF_10V_0603

C62

## 22UF_10V_2012

R724

## 1K_F_1005

R717

## 10K_F_1005/DNP

BC38

## 390PF_50V_2012_MLCC

C81

## 100NF_10V_0603

R722

## 4.7K_F_1005

C89

## 100NF_10V_0603

R715

## 1K_F_1005

C92

## 100NF_10V_0603

FB19

## HH-1M1608-221JT

C502

## 4.7UF_10V_1005

## JTAG

J9

87831-1420

## GND 1

| CONF_POW | 2

## GND 3

| JTAG_TMS | 4

## GND 5

| JTAG_TCK | 6

## GND 7

| JTAG_TDO | 8

## GND 9

| JTAG_TDI | 10
GND 11 | N.C12 | 12
GND 13 | N.C14 | 14

R706

## 0_F_1005/DNP

R733

## 2.4K_F_1005

## 100_F_1005/DNP

C80

## 100NF_10V_0603

C74

## 100NF_10V_0603

C98

## 22UF_6.3V_1608

R188

## 51_F_1608

C79

## 100NF_50V_1005

## 10K_F_1608

R720

## 4.7K_F_1005

R731

## 51_F_1005

C94

## 100NF_10V_0603

R732

## 51_F_1608

C73

## 100NF_10V_0603

FB18

## HH-1M1608-221JT

C93

## 100NF_50V_1005

C97

## 100NF_10V_0603

ZD26

## BZT52C3V6_7_F/SOD-123

A | C

## BANK 0

## xc7s50-1csga324I

U155A

## VCCO_0 D8 VCCO_0 V10

## DONE_0 V8

## VCCBATT_0 B8

## CCLK_0 C8

M0_0

T10

M1_0

U10

M2_0

U9

## CFGBVS_0 V9

## PROGRAM_B_0 R8

## DXP_0

L10

GNDADC_0 | H9
VCCADC_0 | H10
VREFP_0 | K10

## VN_0

K9

## TCK_0 D9

## DXN_0

L9

## VREFN_0

J9

## VP_0

J10

## INIT_B_0

U8

## TDI_0

R9 TDO_0 | T8 TMS_0 | T9

C77

## 100NF_10V_0603

C67

## 10NF_6.3V_0603

R719

## 10K_F_1005

C85

## 100NF_10V_0603

C96

## 100NF_10V_0603

C66

## 100NF_10V_0603

## 1K_F_1608

R709

## 0_F_1005

R727

## 1K_F_1005/DNP

# S RANGE

## * PZT2907A, PZT222A

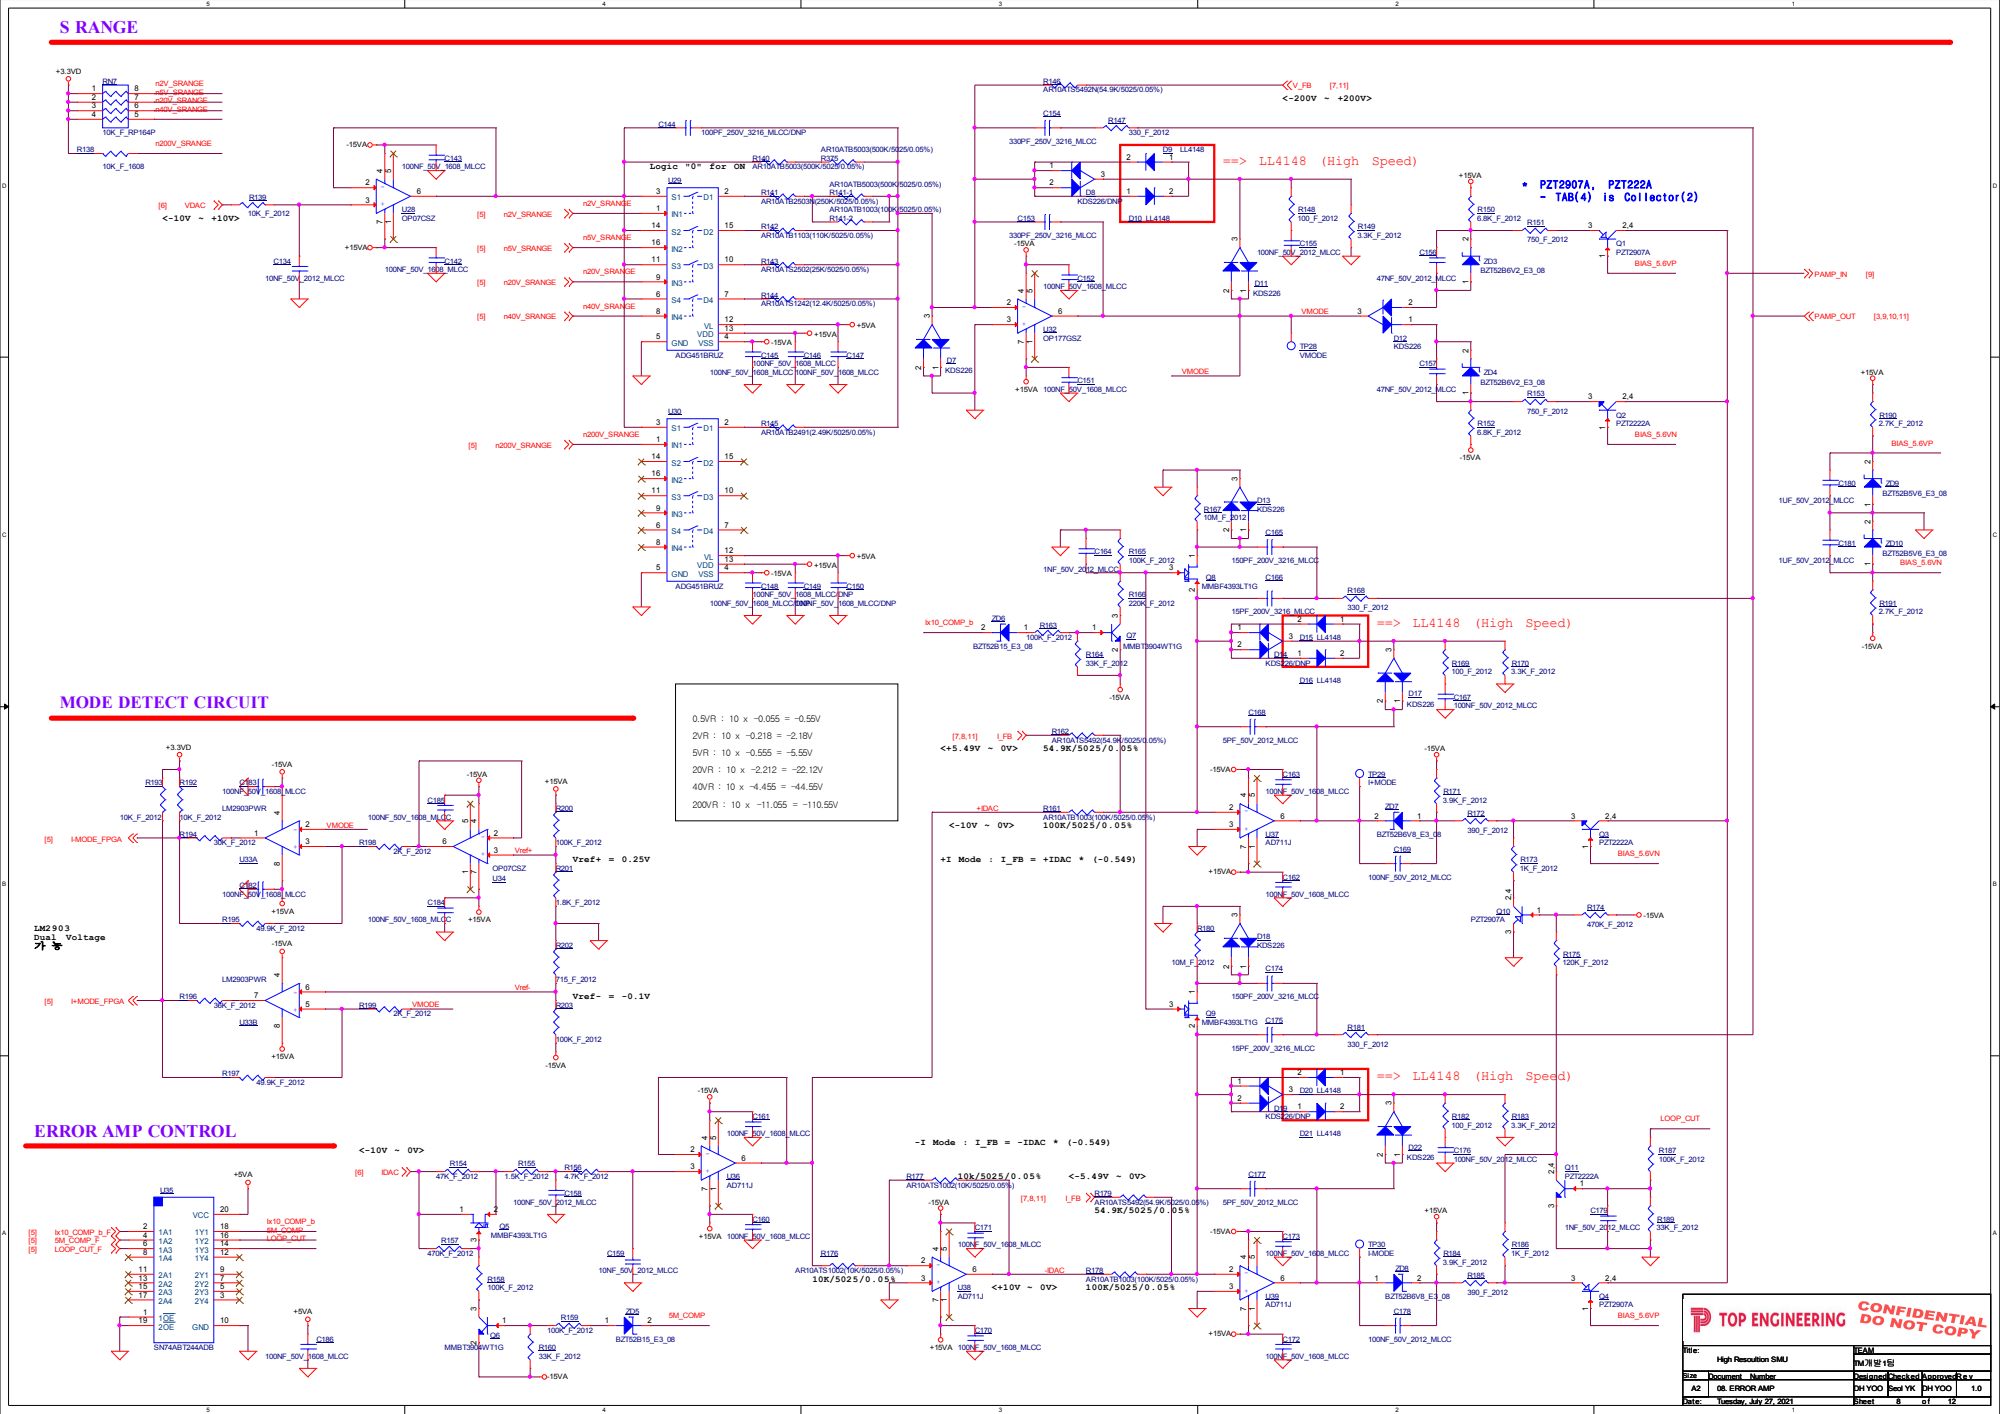
[picture p86: page 9]

U41(AD8676) | U47(AD8676) | U45(AD8675)
U42(AD8676) | U48(AD8676) | U146(AD8675)

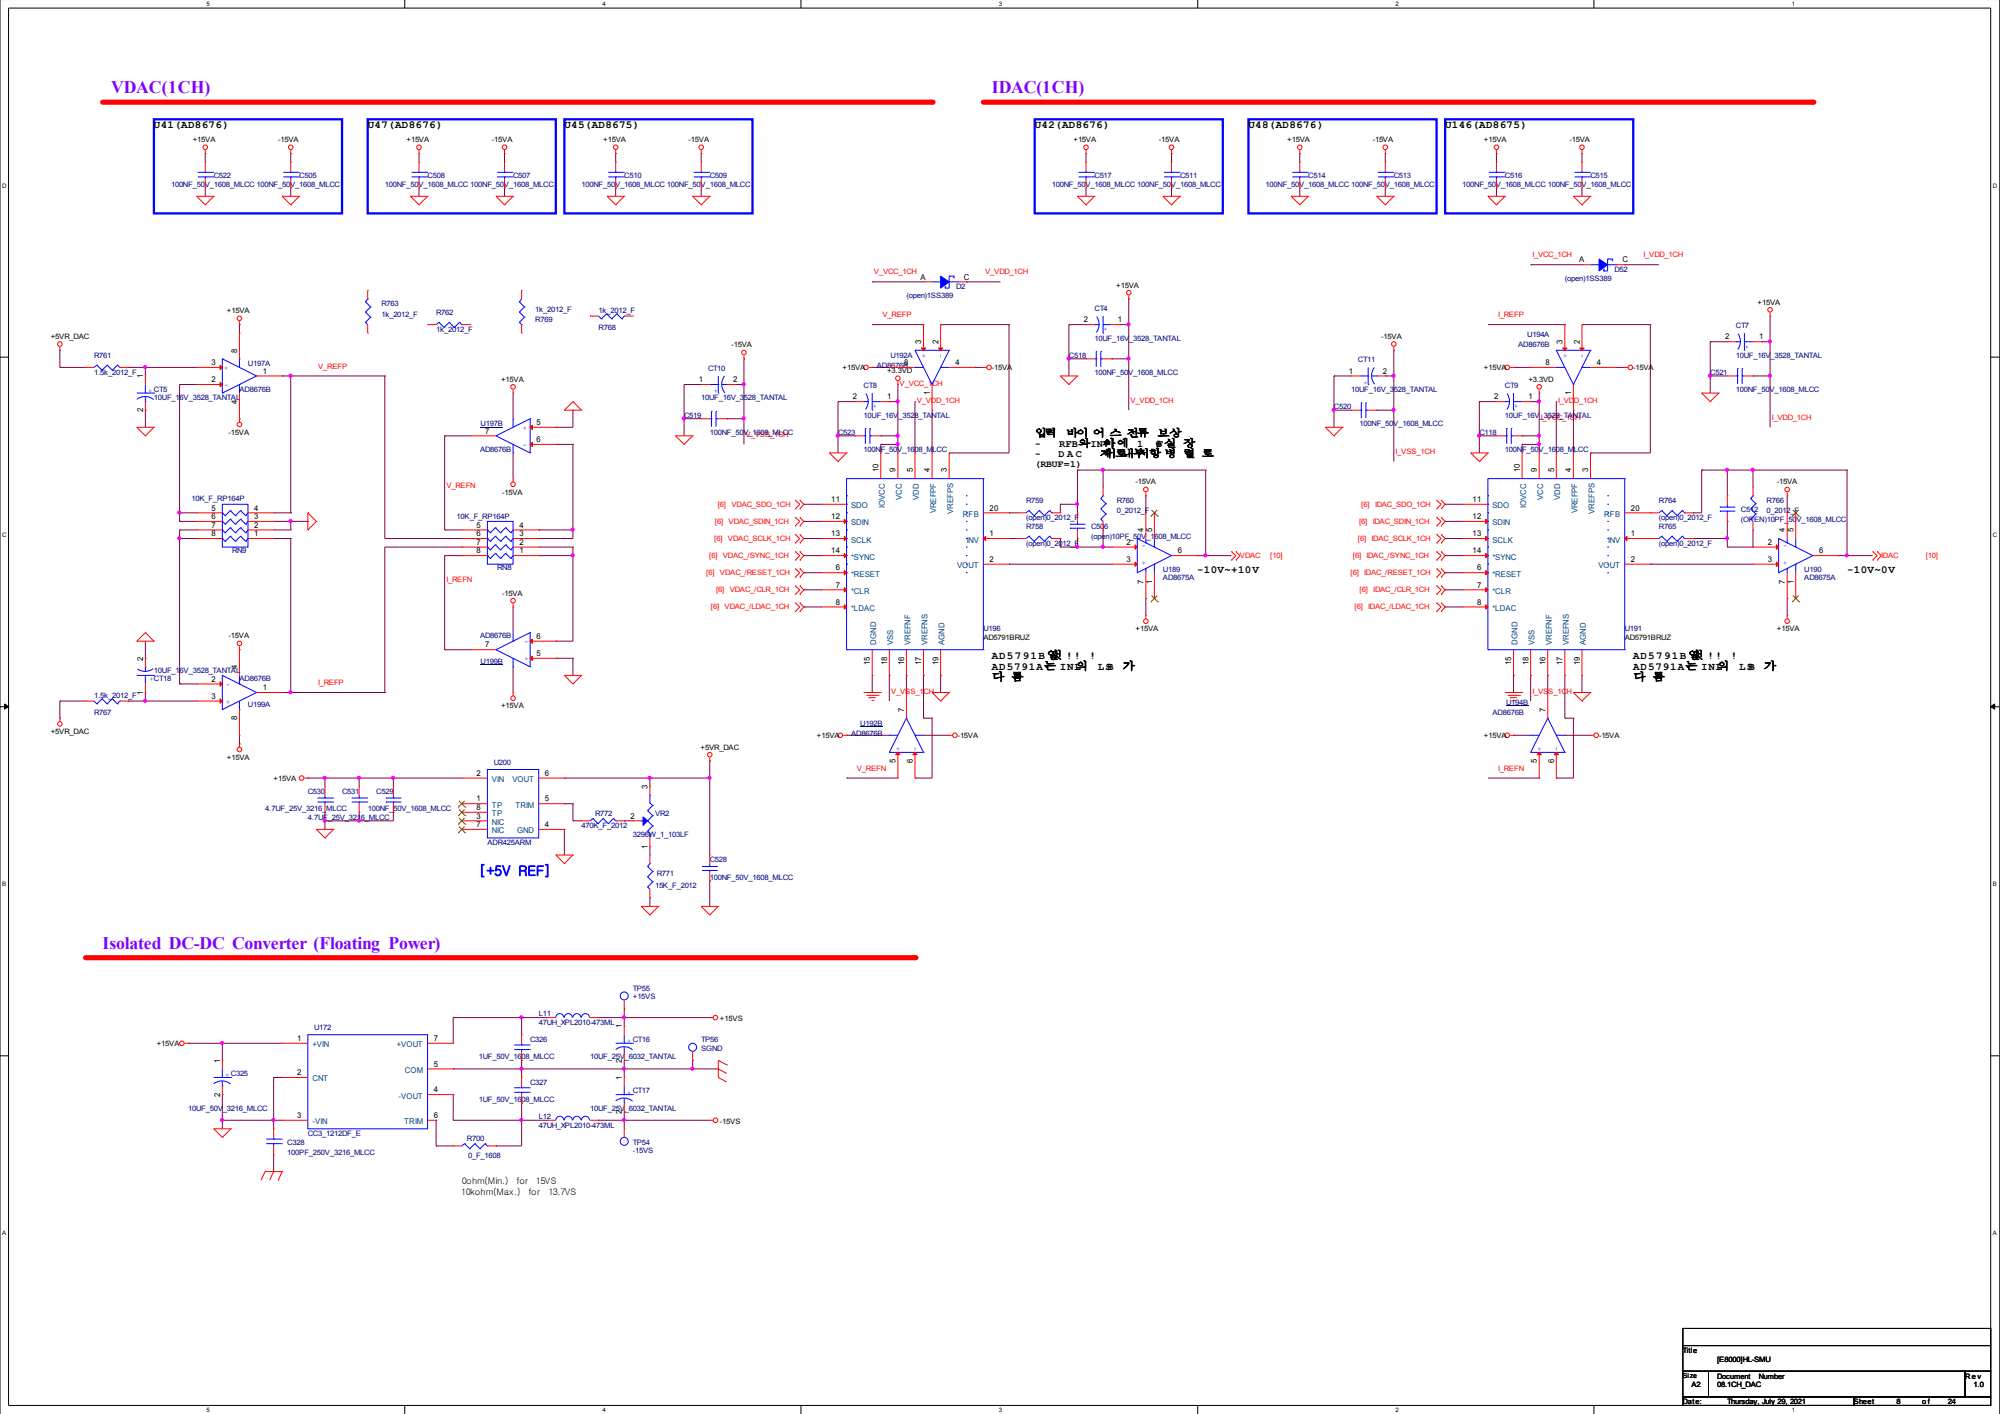
[picture p87: page 10]

(RBUF=1)

Isolated DC-DC Converter (Floating Power)

# POWER AMP

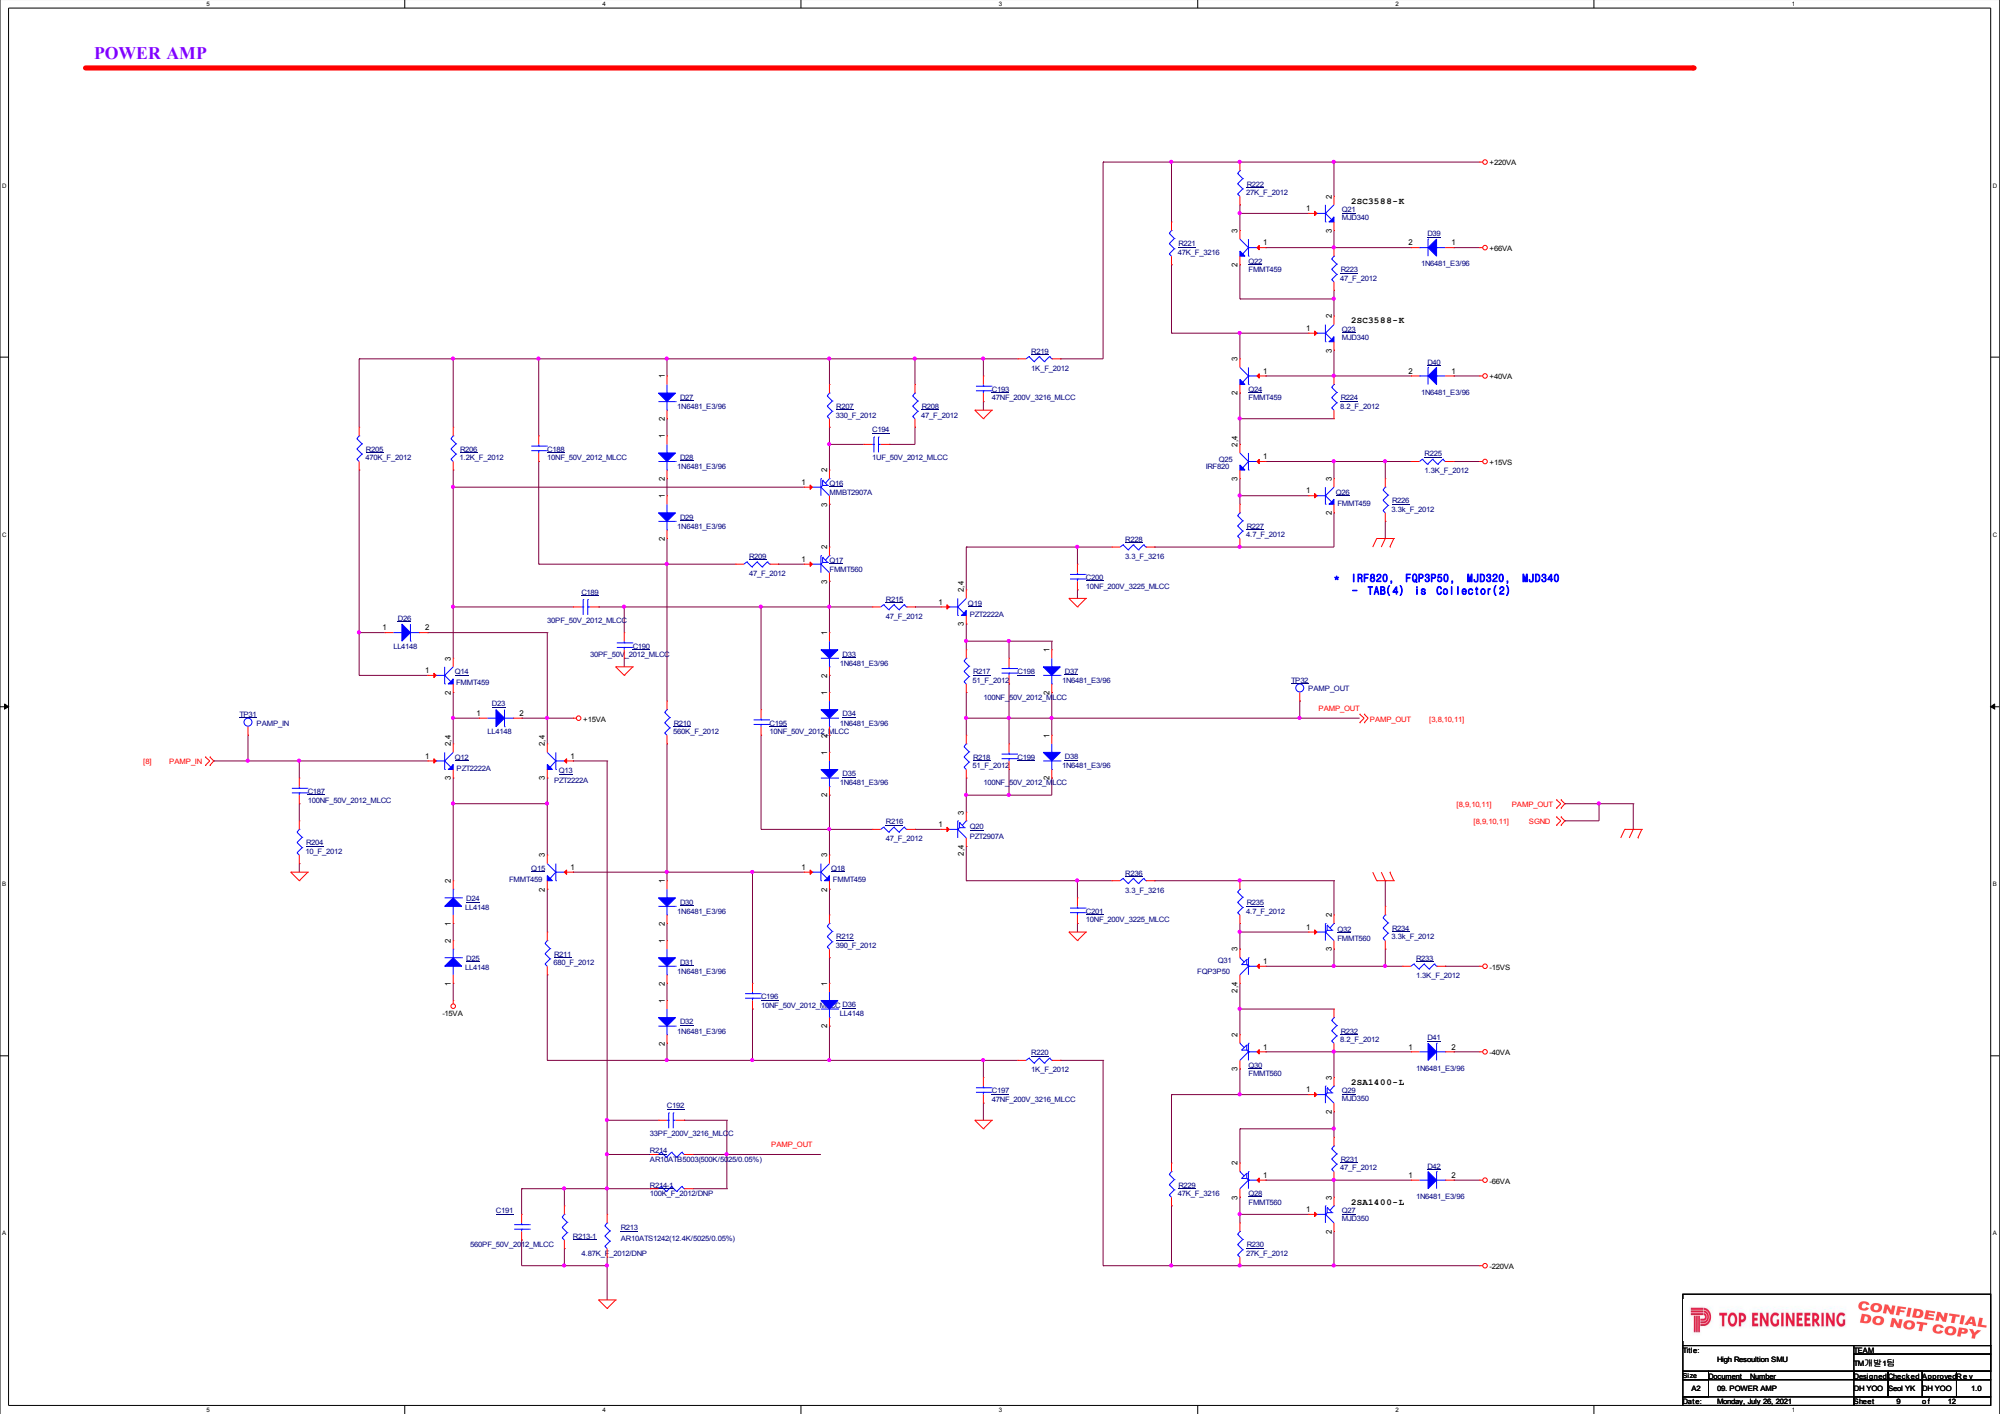
[picture p88: page 11]

CONTROL SIGNAL BUFFER | SIGNAL ISOLATE | I RANGE CONTROL

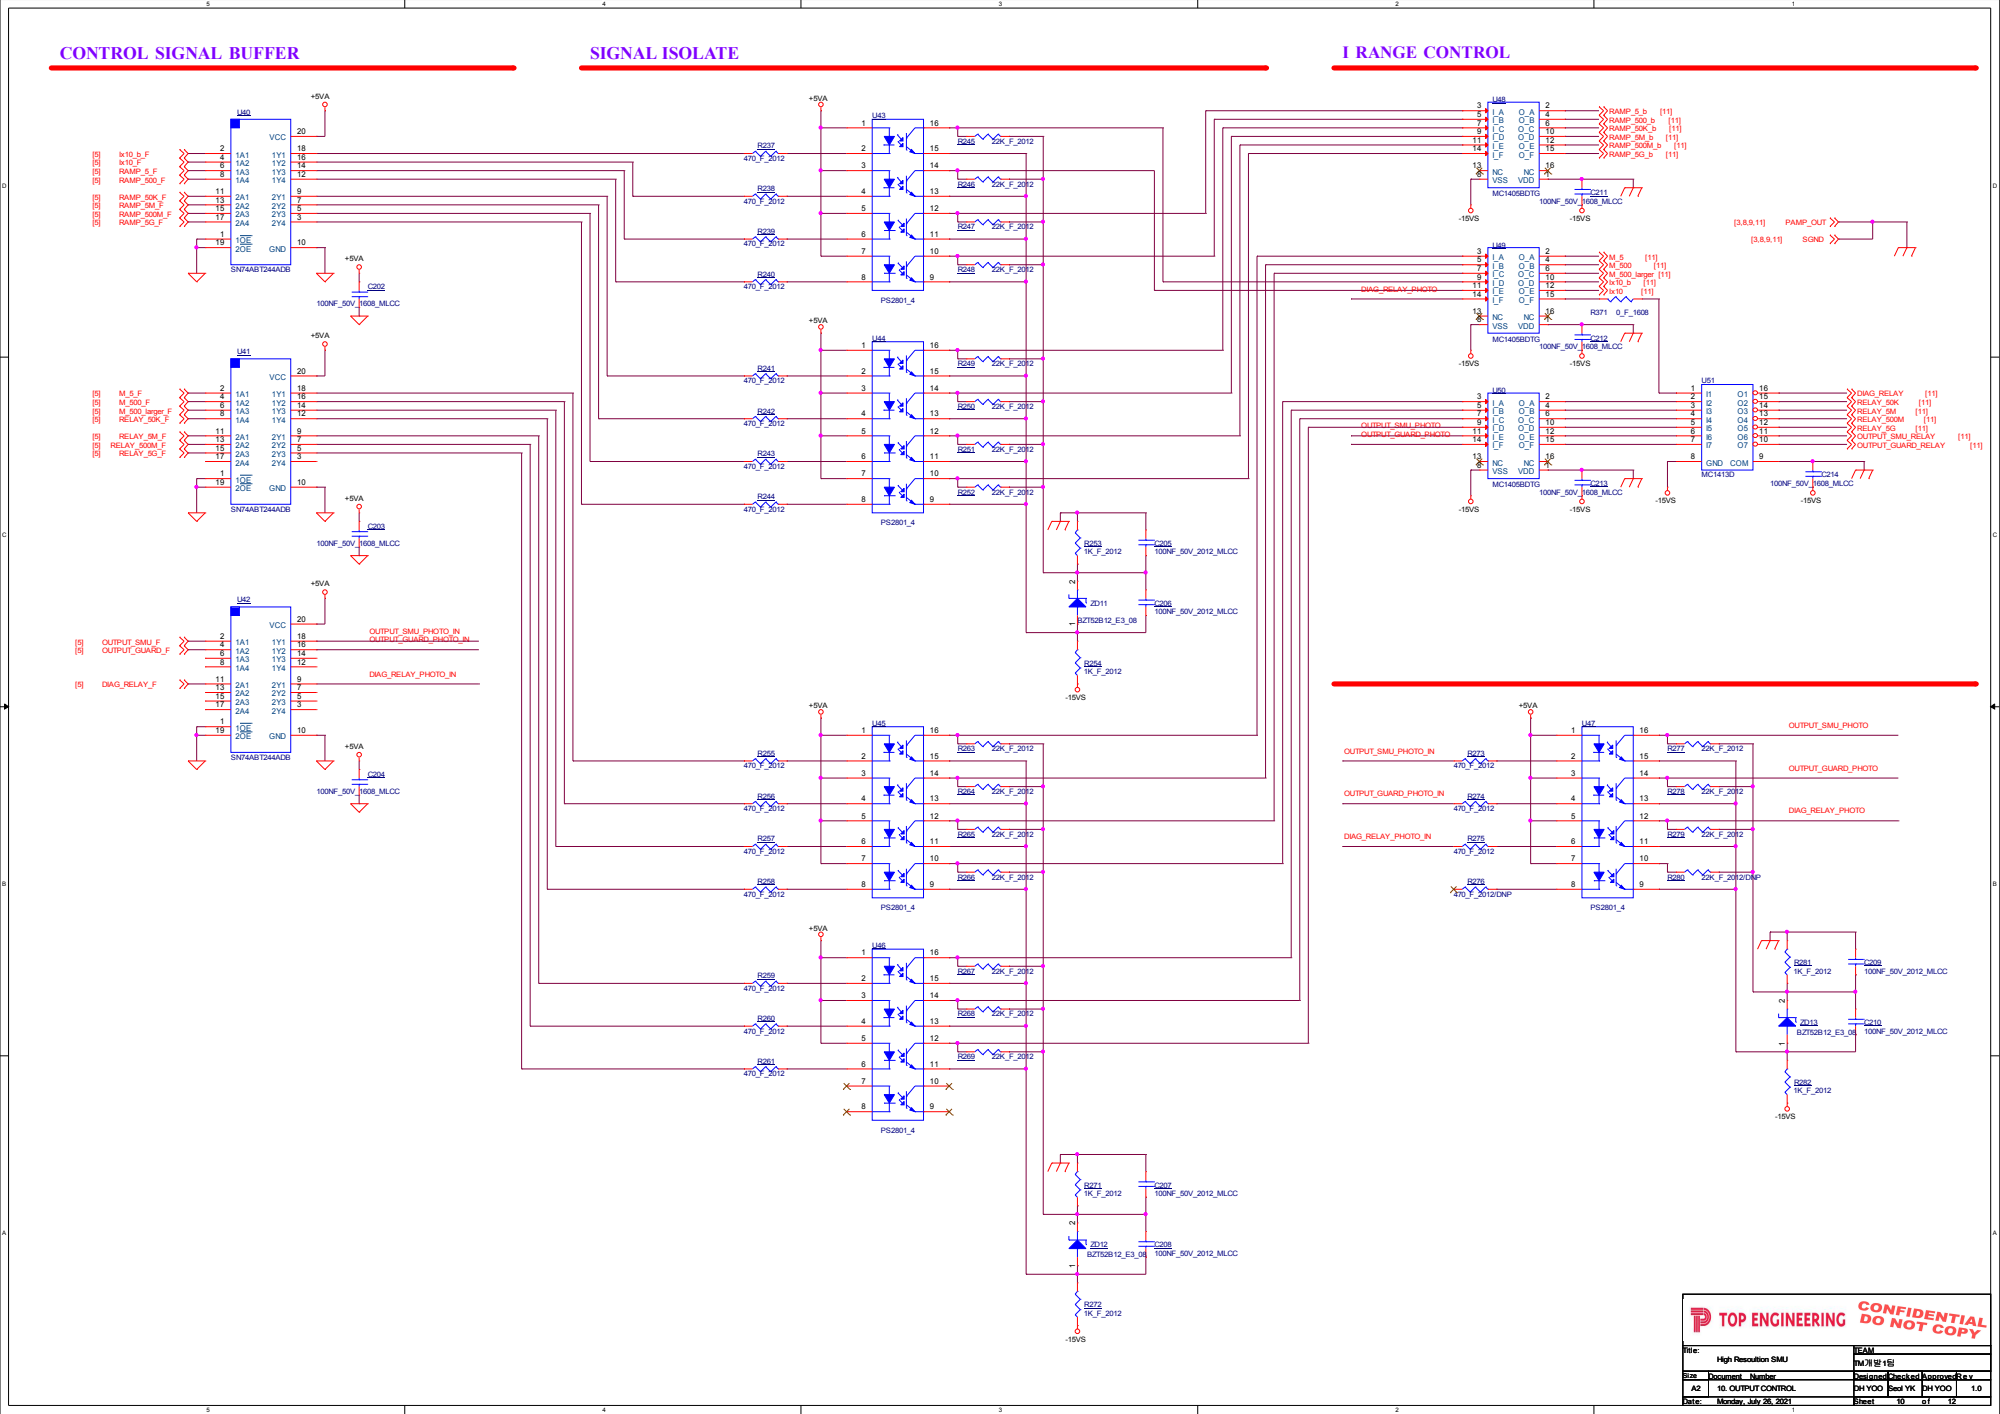
[picture p89: page 12]

## OUTPUT

## U55 장 착 용 소켓

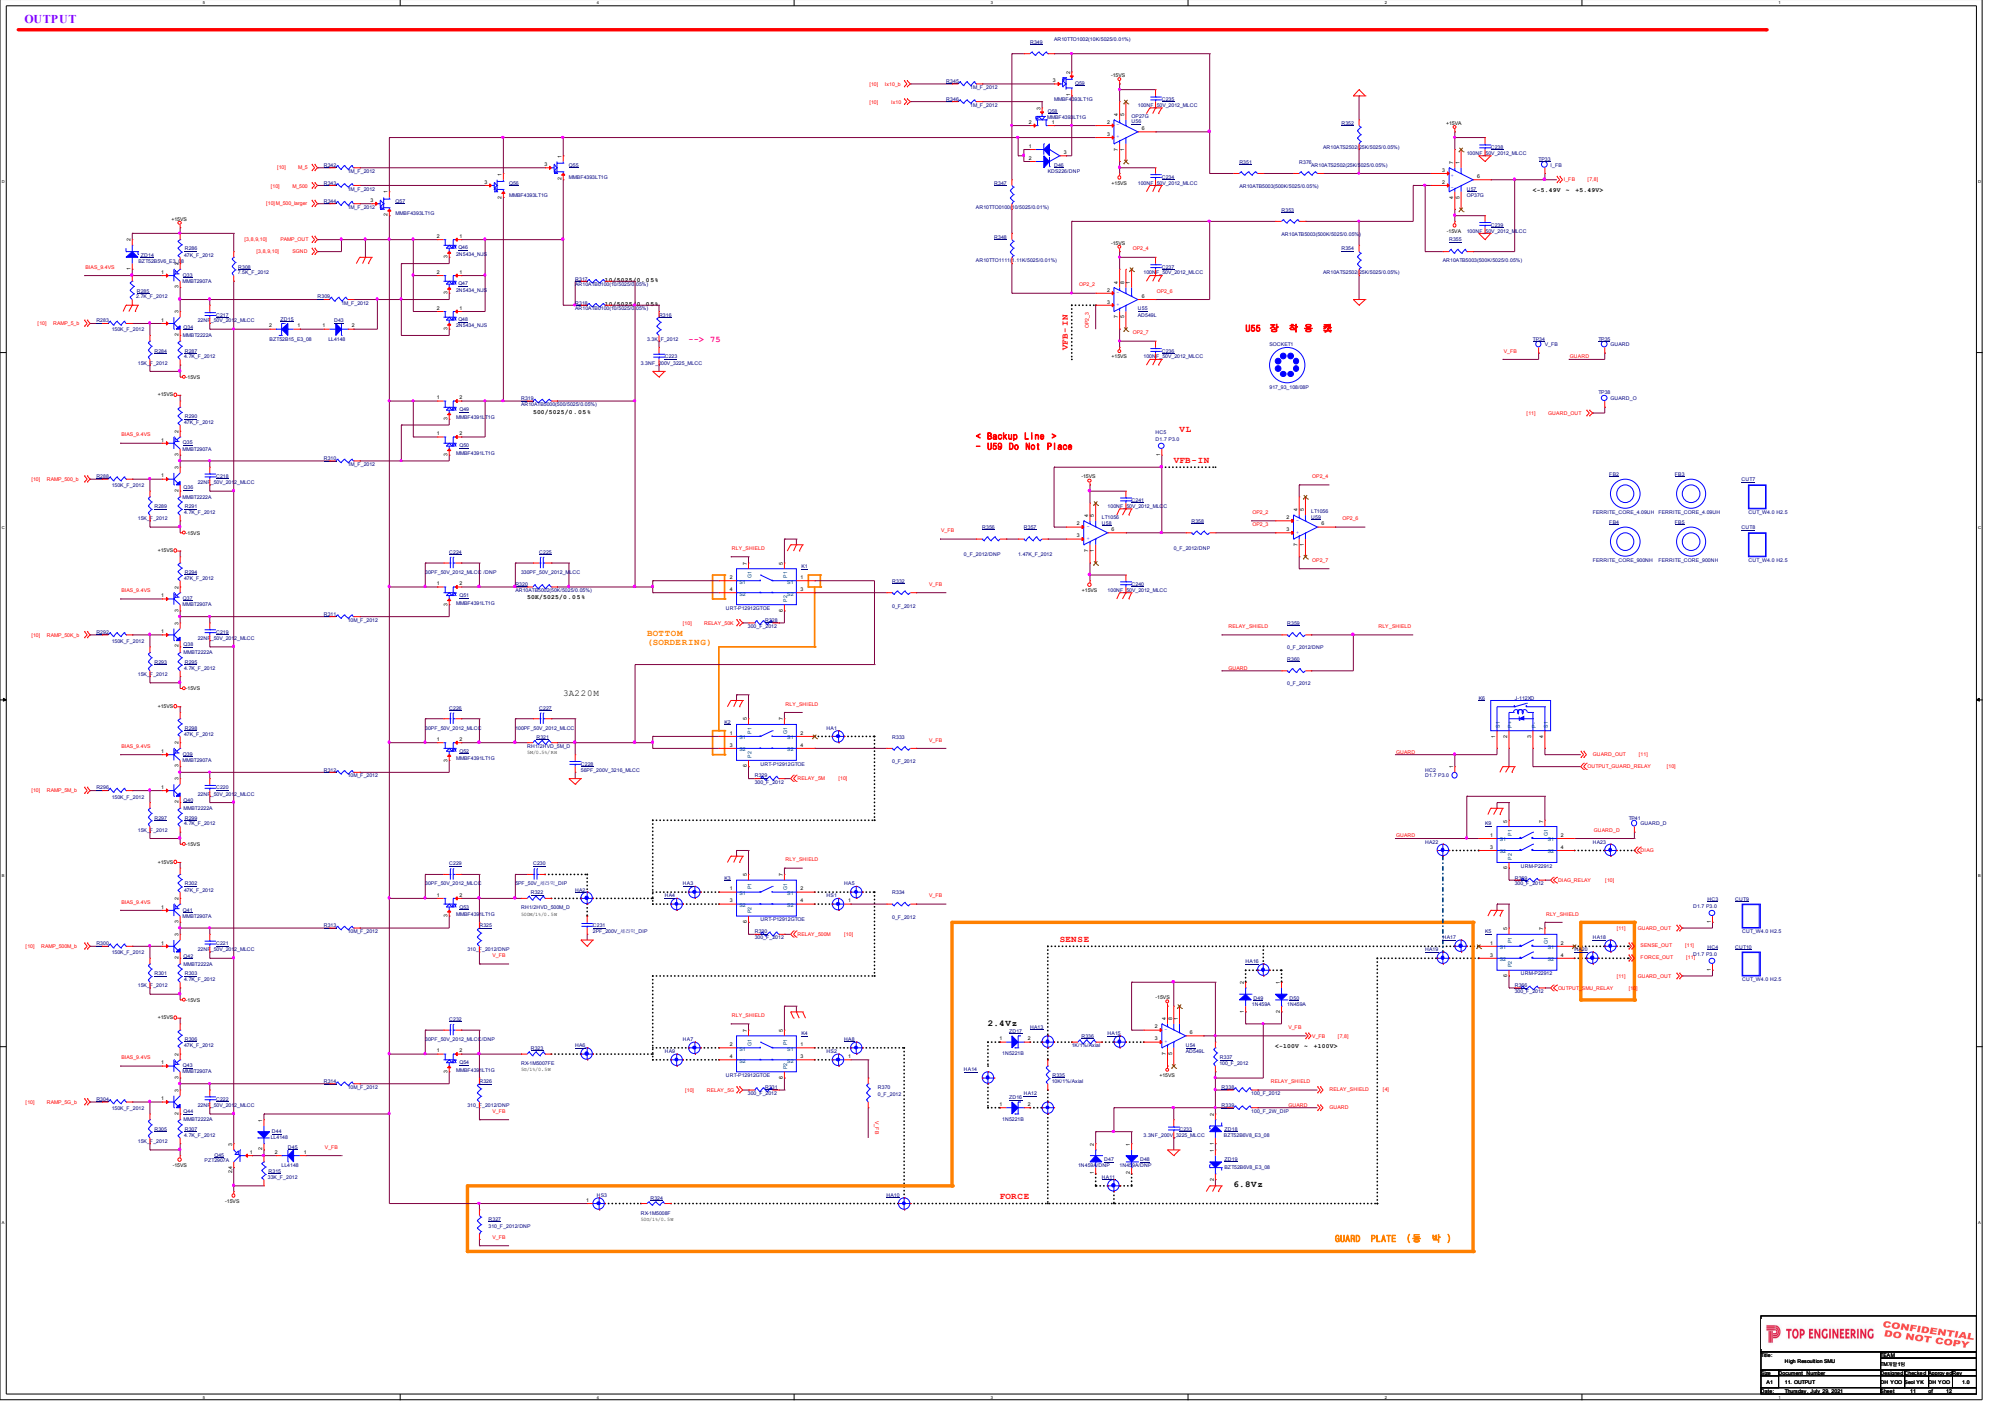
[picture p90: page 13]

Designed Checked Approv ed

## JIG2

## HRSMU_INPUT_SHIELD_COVER

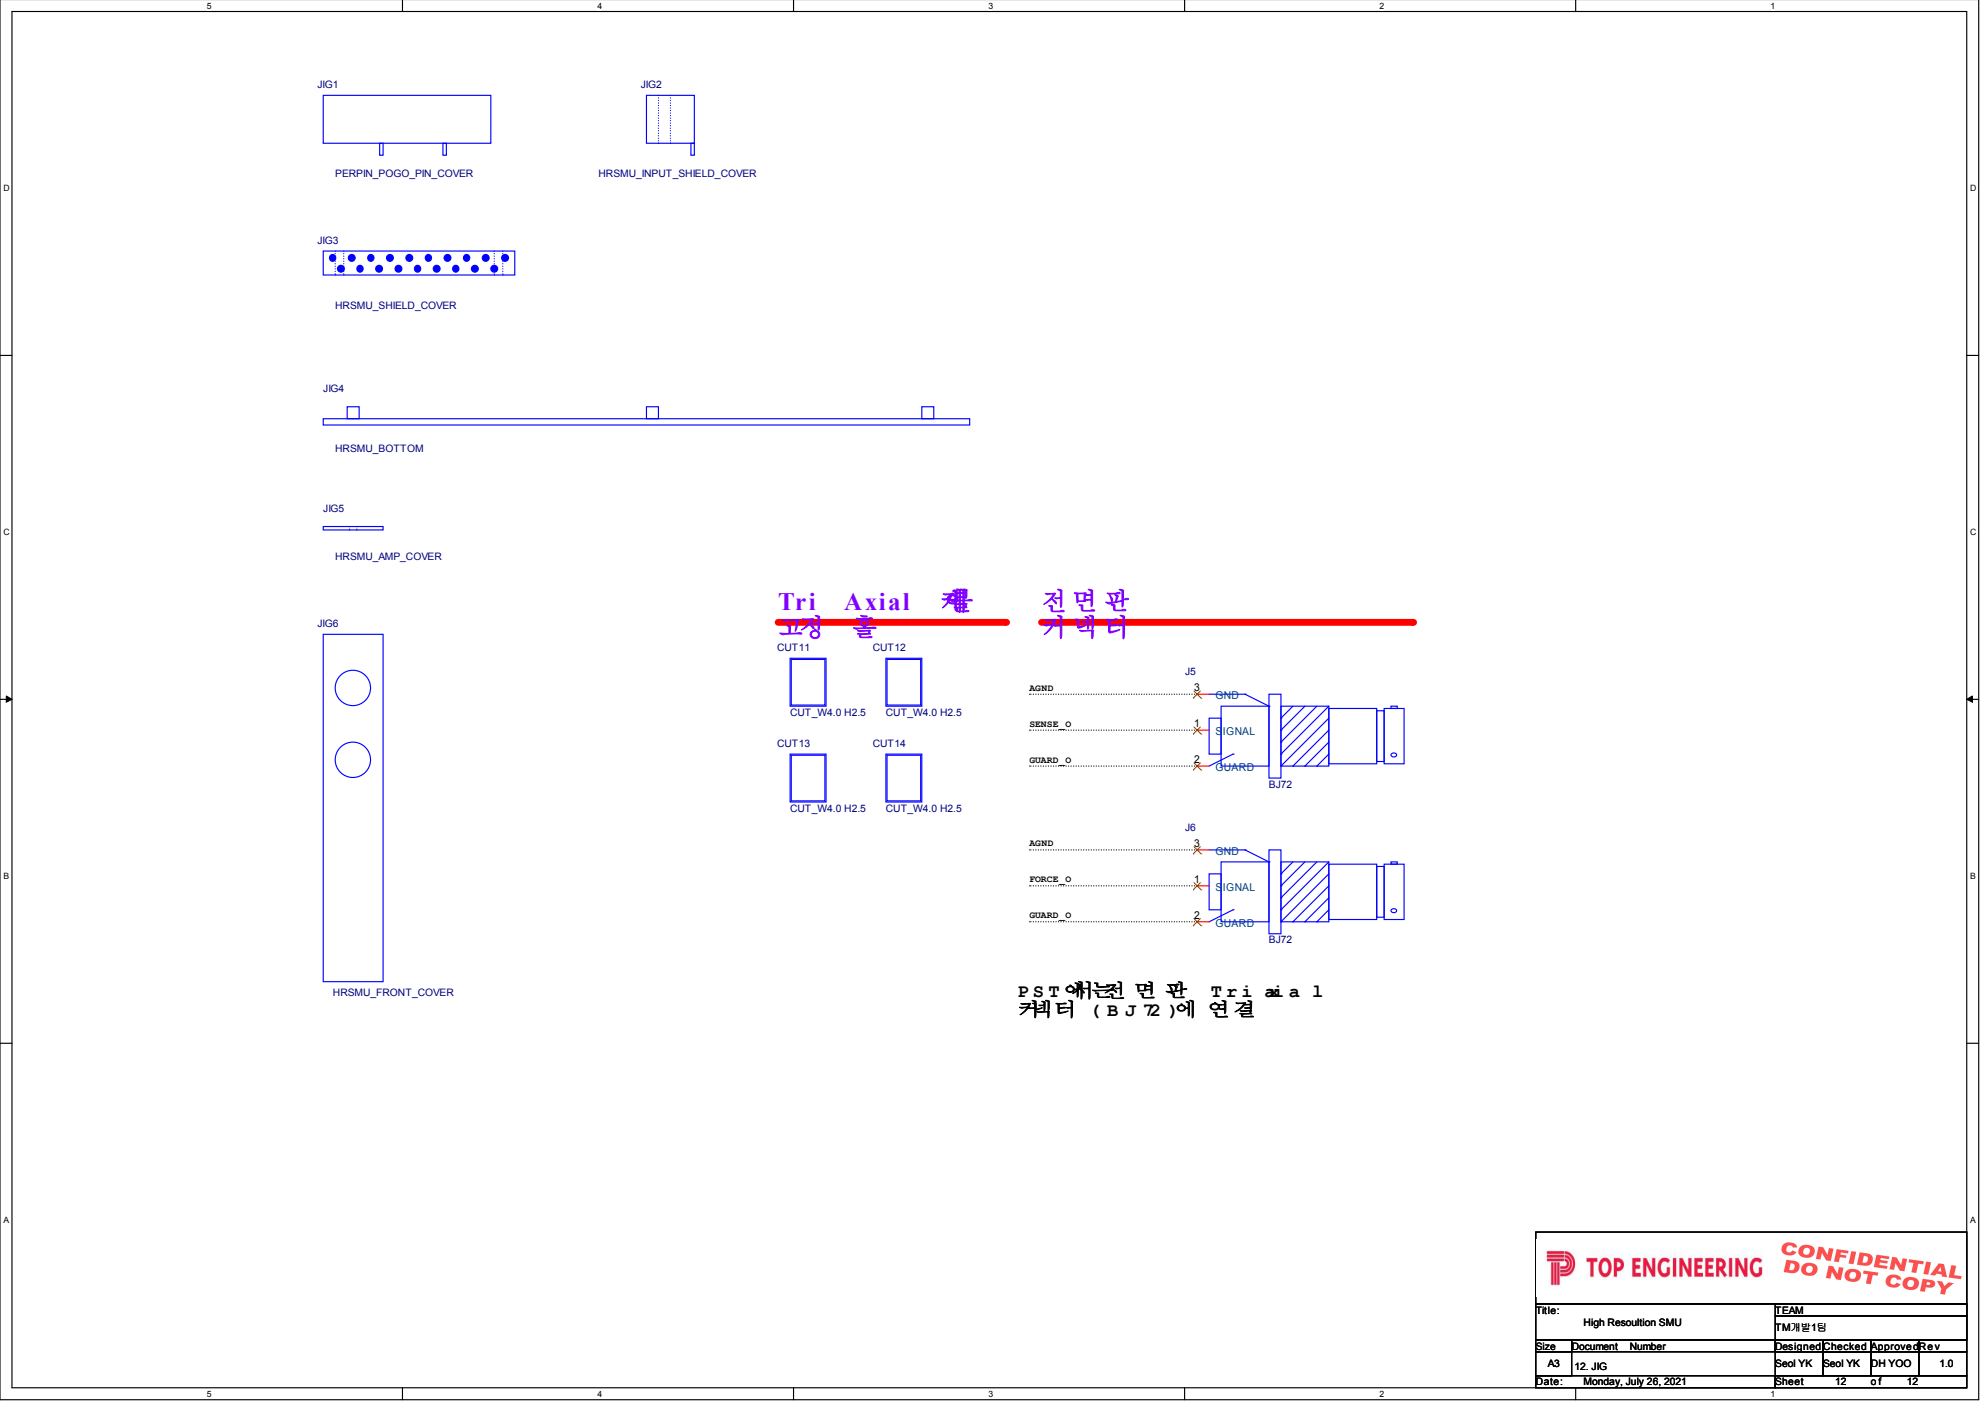
[picture p91: page 14]
Tri; Axial; 케이블; AGND; P S T 에서는전 면 판; T r i axi a l; 커넥터 ( B J 72 )에 연결; FORCE_O; GUARD_O; SENSE_O; Size; Document; Number; 12. JIG; Seol YK Seol YK DH YOO; Monday, July 26, 2021; JIG6; HRSMU_FRONT_COVER; CUT11; CUT_W4.0 H2.5; JIG1; PERPIN_POGO_PIN_COVER; CUT12; CUT13; CUT14; SIGNAL 1; GUARD 2; GND 3; JIG3; HRSMU_SHIELD_COVER; JIG4; HRSMU_BOTTOM; JIG5; HRSMU_AMP_COVER

Designed Checked Approved
