lastoyz/dsn_pgu_adda_s3100_git/(list of files, drawings)

Other design files:
dsn/1.sch/_ref/CMU_CPU_F5500_r190510__DEBUG_0709.DSN
dsn/1.sch/_ref/FPGA_MODULE_V11_20200812-4M.DSN
dsn/1.sch/_ref/HVPGU-210302-TOP_VER1_3.DSN
