lastoyz/dsn_pgu_adda_s3100_git/txem7310_pll/txem7310_pll.srcs/sources_1/imports/src_ref/txem7310_pll__s3100_sv_adda__top.v

// # this           : txem7310_pll__s3100_sv_adda__top.v
// # top xdc        : txem7310_pll__s3100_sv_adda__top.xdc
//
// # FPGA board     : NA
// # FPGA board_sch : NA
//
// # base board     : S3100-ADDA or S3100-CMU-ADDA
// # base board sch : S3100_CMU_ADDA__r210827__remap.pdf
//
// # note: artix-7 top design for S3100-ADDA slave spi side
//
// ############################################################################
// ## TODO: bank usage in xc7a200
// ############################################################################
// # B13 : CLK, SPIO1, S_IO, DACx_SPI, M2_SPI, CLK_COUT, TRIG  // 3.3V // (in MC1/MC2) 
// # B14 : CONF                                                // 1.8V
// # B15 : TP, LAN_SPI(, SCIO)                                 // 3.3V
// # B16 : LED                                                 // 3.3V
// # B34 : XADC, DAC0, ADC0, ADCx                              // 3.3V // (in MC1)
// # B35 : DAC1, ADC1, CLK_SPI                                 // 3.3V // (in MC2)
// # B216: not used


// ## TODO: EP locations : LAN-MCS interface, MTH slave interface
//
// to revise for S3100-ADDA
// * LAN-MCS interface : MTH spi master emulation for debugging without connecting mother board
//                       - FPGA_LED 
//                       - TEST
//                       - EEPROM from SCIO 
//                       - MEM 
//                       - SSPI
//                       - MSPI
//
// * MTH slave SPI interface : END-POINT for "device IO control"
//                             - SSPI 
//                             - TEST 
//                             - HRADC 
//


// ## S3100 MTH SPI frame format : 32 bits 
//
// * MOSI : 
//   FRAME MODE       // [1:0]
//   FRAME CONTROL    // [3:0]
//   FRAME ADDRESS    // [9:0]
//   FRAME WRITE DATA // [15:0]
//
// * MISO : 
//   zeros            // [1:0]
//   FRAME STATUS     // [3:0]
//   BOARD STATUS     // [7:0]
//   zeros            // [1:0]
//   FRAME READ DATA  // [15:0]


//// TODO: MTH slave SPI frame address map
// ## S3100-ADDA  // GNDU --> PGU --> ADDA
//                           
// +=======+===============+============+=========================================+================================+
// | Group | EP name       | frame adrs | type/index | Description                | contents (32-bit)              |
// |       |               | (10-bit)   |            |                            |                                |
// +=======+===============+============+============+============================+================================+
// | SSPI  | SSPI_TEST_WO  | 0x380      | wireout_E0 | Return known frame data.   | bit[31:16]=0x33AA              | 
// |       |               |            |            |                            | bit[15: 0]=0xCC55              |
// +-------+---------------+------------+------------+----------------------------+--------------------------------+
// | SSPI  | SSPI_CON_WI   | 0x008      | wire_in_02 | Control slave SPI bus.     | bit[30:28]=reserved            | 
// |       |               |            |            |                            | bit[25]=miso_one_bit_ahead_en  |
// |       |               |            |            |                            | bit[24]=loopback_en            |
// |       |               |            |            |                            | bit[20:16]=miso_timing_control | 
// |       |               |            |            |                            | bit[ 3]=HW_reset               |
// |       |               |            |            |                            | bit[ 1]=LAN_EPS_disable        |
// |       |               |            |            |                            | bit[ 0]=reserved               |
// +-------+---------------+------------+------------+----------------------------+--------------------------------+
// | SSPI  | SSPI_FLAG_WO  | 0x0C8      | wire_in_32 | Control slave SPI bus.     | bit[31:24]=board_status[7:0]   | 
// |       |               |            |            |                            | bit[23:16]=slot_id[7:0]        |
// |       |               |            |            |                            | bit[15: 0]=count_cs[15:0]      |
// +-------+---------------+------------+------------+----------------------------+--------------------------------+
// +-------+---------------+------------+------------+----------------------------+--------------------------------+
// | TEST  | F_IMAGE_ID_WO | 0x080      | wireout_20 | Return FPGA image ID.      | Image_ID[31:0]                 |
// +-------+---------------+------------+------------+----------------------------+--------------------------------+
// | TEST  | XADC_TEMP_WO  | 0x0E8      | wireout_3A | Return XADC values.[mC]    | MON_TEMP[31:0]                 |
// +-------+---------------+------------+------------+----------------------------+--------------------------------+
// | TEST  | XADC_VOLT_WO  | 0x0EC      | wireout_3B | Return XADC values.[mV]    | MON_VOLT[31:0] normial 1.1V    |
// +-------+---------------+------------+------------+----------------------------+--------------------------------+
// | TEST  | TIMESTAMP_WO  | 0x088      | wireout_22 | Return time stamp. (10MHz) | TIME_STAMP[31:0]               | 
// +-------+---------------+------------+------------+----------------------------+--------------------------------+
// | TEST  | TEST_MON_WO   | 0x08C      | wireout_23 | Return PLL status.         | bit[18]=MCS pll locked         | 
// |       |               |            |            |                            | bit[24]=DAC common pll locked  |
// |       |               |            |            |                            | bit[25]=DAC0 pll locked        |
// |       |               |            |            |                            | bit[26]=DAC1 pll locked        |
// +-------+---------------+------------+------------+----------------------------+--------------------------------+
// | TEST  | TEST_PI       | 0x228      | pipe_in_8A | Write data into test FIFO. | test_fifo_data[31:0]           |
// +-------+---------------+------------+------------+----------------------------+--------------------------------+
// | TEST  | TEST_PO       | 0x2A8      | pipeout_AA | Read data from test FIFO.  | test_fifo_data[31:0]           |
// +-------+---------------+------------+------------+----------------------------+--------------------------------+
// +-------+---------------+------------+------------+----------------------------+--------------------------------+
// | MEM   | MEM_WI        | 0x04C      | wire_in_13 | Control EEPROM interface.  | bit[  15]=disable_SBP_packet   | 
// |       |               |            |            |                            | bit[11:0]=num_bytes_DAT[11:0]  |
// +-------+---------------+------------+------------+----------------------------+--------------------------------+
// | MEM   | MEM_FDAT_WI   | 0x048      | wire_in_12 | Control EEPROM frame data. | bit[31:24]=frame_data_ADH[7:0] |
// |       |               |            |            |                            | bit[23:16]=frame_data_ADL[7:0] |
// |       |               |            |            |                            | bit[15: 8]=frame_data_STA[7:0] |
// |       |               |            |            |                            | bit[ 7: 0]=frame_data_CMD[7:0] |
// +-------+---------------+------------+------------+----------------------------+--------------------------------+
// | MEM   | MEM_TI        | 0x14C      | trig_in_53 | Trigger functions.         | bit[0]=trigger_reset           |
// |       |               |            |            |                            | bit[1]=trigger_fifo_reset      |
// |       |               |            |            |                            | bit[2]=trigger_frame           |
// +-------+---------------+------------+------------+----------------------------+--------------------------------+
// | MEM   | MEM_TO        | 0x1CC      | trigout_73 | Check status.              | bit[0]=MEM_valid_latch         |
// |       |               |            |            |                            | bit[1]=done_frame_latch        |
// |       |               |            |            |                            | bit[2]=done_frame (one pulse)  |
// |       |               |            |            |                            | bit[15:8]=frame_data_STA[7:0]  |
// +-------+---------------+------------+------------+----------------------------+--------------------------------+
// | MEM   | MEM_PI        | 0x24C      | pipe_in_93 | Write data into pipe.      | bit[7:0]=frame_data_DAT_w[7:0] |
// +-------+---------------+------------+------------+----------------------------+--------------------------------+
// | MEM   | MEM_PO        | 0x2CC      | pipeout_B3 | Read data from pipe.       | bit[7:0]=frame_data_DAT_r[7:0] |
// +-------+---------------+------------+------------+----------------------------+--------------------------------+
// +-------+---------------+------------+------------+----------------------------+--------------------------------+
// | DACX  | DACX_WI       | 0x014      | wire_in_05 | Control DAC IC interface.  | bit[30]   = dac1_dco_clk_rst   |
// |       |               |            |            |                            | bit[29]   = dac0_dco_clk_rst   |
// |       |               |            |            |                            | bit[28]   = clk_dac_clk_rst    |
// |       |               |            |            |                            | bit[27]   = dac1_clk_dis       |
// |       |               |            |            |                            | bit[26]   = dac0_clk_dis       |
// |       |               |            |            |                            | bit[24]   = DACx_CS_id         |
// |       |               |            |            |                            | bit[23]   = DACx_R_W_bar       |
// |       |               |            |            |                            | bit[22:21]= DACx_byte_mode[1:0]|
// |       |               |            |            |                            | bit[20:16]= DACx_reg_adrs [4:0]|
// |       |               |            |            |                            | bit[7:0]  = DACx_wr_D[7:0]     |
// +-------+---------------+------------+------------+----------------------------+--------------------------------+
// | DACX  | DACX_WO       | 0x094      | wireout_25 | Read DAC status.           | bit[25]   = done_DACx_SPI_frame|
// |       |               |            |            |                            | bit[24]   = done_DACx_LNG_reset|
// |       |               |            |            |                            | bit[7:0]  = DACx_rd_D[7:0]     |
// +-------+---------------+------------+------------+----------------------------+--------------------------------+
// | DACX  | DACX_TI       | 0x114      | trig_in_45 | Trigger functions.         | bit[0]    = trig_DACx_LNG_reset|
// |       |               |            |            |                            | bit[1]    = trig_DACx_SPI_frame|
// +-------+---------------+------------+------------+----------------------------+--------------------------------+
// +-------+---------------+------------+------------+----------------------------+--------------------------------+
// | DACZ  | DACZ_DAT_WI   | 0x020      | wire_in_08 | Control pattern gen.       | wire_in__dacz_data[31:0]       |
// +-------+---------------+------------+------------+----------------------------+--------------------------------+
// | DACZ  | DACZ_DAT_WO   | 0x0A0      | wireout_28 | Read pattern gen status.   | wire_out_dacz_data[31:0]       |
// +-------+---------------+------------+------------+----------------------------+--------------------------------+
// | DACZ  | DACZ_DAT_TI   | 0x120      | trig_in_48 | Trigger dacz data func.    | bit[ 4] = write_control        |
// |       |               |            |            |                            | bit[ 5] = read_status          |
// |       |               |            |            |                            | bit[ 6] = write_repeat_period  |
// |       |               |            |            |                            | bit[ 7] = read_repeat_period   |
// |       |               |            |            |                            | bit[ 8] = trig_cid_adrs_wr     |
// |       |               |            |            |                            | bit[ 9] = trig_cid_adrs_rd     |
// |       |               |            |            |                            | bit[10] = trig_cid_data_wr     |
// |       |               |            |            |                            | bit[11] = trig_cid_data_rd     |
// |       |               |            |            |                            | bit[12] = trig_cid_ctrl_wr     |
// |       |               |            |            |                            | bit[13] = trig_cid_ctrl_rd     |
// |       |               |            |            |                            |                                |
// |       |               |            |            |                            | bit[15] = trig_cid_stat_rd     |
// +-------+---------------+------------+------------+----------------------------+--------------------------------+
// | DACZ  | DAC0_DAT_PI   | 0x218      | pipe_in_86 | Write pattern data in fifo.| w_DAC0_DAT_INC_PI[31:0]        |
// +-------+---------------+------------+------------+----------------------------+--------------------------------+
// | DACZ  | DAC0_DUR_PI   | 0x21C      | pipe_in_87 | Write pattern data in fifo.| w_DAC0_DUR_PI[31:0]            |
// +-------+---------------+------------+------------+----------------------------+--------------------------------+
// | DACZ  | DAC1_DAT_PI   | 0x220      | pipe_in_88 | Write pattern data in fifo.| w_DAC1_DAT_INC_PI[31:0]        |
// +-------+---------------+------------+------------+----------------------------+--------------------------------+
// | DACZ  | DAC1_DUR_PI   | 0x224      | pipe_in_89 | Write pattern data in fifo.| w_DAC1_DUR_PI[31:0]            |
// +-------+---------------+------------+------------+----------------------------+--------------------------------+
// +-------+---------------+------------+------------+----------------------------+--------------------------------+
// | CLKD  | CLKD_WI       | 0x018      | wire_in_06 | Control DAC IC interface.  | bit[   31]= CLKD_R_W_bar       |
// |       |               |            |            |                            | bit[30:29]= CLKD_byte_mode[1:0]|
// |       |               |            |            |                            | bit[25:16]= CLKD_reg_adrs[9:0] |
// |       |               |            |            |                            | bit[ 7: 0]= CLKD_wr_D[7:0]     |
// +-------+---------------+------------+------------+----------------------------+--------------------------------+
// | CLKD  | CLKD_WO       | 0x098      | wireout_26 | Read DAC status.           | bit[31]   = CLKD_LD            |
// |       |               |            |            |                            | bit[30]   = CLKD_STAT          |
// |       |               |            |            |                            | bit[29]   = CLKD_REFM          |
// |       |               |            |            |                            | bit[28]   = CLKD_SDIO_rd       |
// |       |               |            |            |                            | bit[25]   = done_CLKD_SPI_frame|
// |       |               |            |            |                            | bit[24]   = done_CLKD_LNG_reset|
// |       |               |            |            |                            | bit[7:0]  = CLKD_rd_D          |
// +-------+---------------+------------+------------+----------------------------+--------------------------------+
// | CLKD  | CLKD_TI       | 0x118      | trig_in_46 | Trigger functions.         | bit[0]    = trig_CLKD_LNG_reset|
// |       |               |            |            |                            | bit[1]    = trig_CLKD_SPI_frame|
// +-------+---------------+------------+------------+----------------------------+--------------------------------+
// +-------+---------------+------------+------------+----------------------------+--------------------------------+
// | SPIO  | SPIO_WI       | 0x01C      | wire_in_07 | Control SPIO IC interface. | bit[28]   = SPIO_CS_id         |
// |       |               |            |            |                            | bit[27:25]= SPIO_pin_adrs[2:0] |
// |       |               |            |            |                            | bit[24]   = SPIO_R_W_bar       |
// |       |               |            |            |                            | bit[23:16]= SPIO_reg_adrs[7:0] |
// |       |               |            |            |                            | bit[15: 8]= SPIO_wr_DA   [7:0] |
// |       |               |            |            |                            | bit[ 7: 0]= SPIO_wr_DB   [7:0] |
// +-------+---------------+------------+------------+----------------------------+--------------------------------+
// | SPIO  | SPIO_WO       | 0x09C      | wireout_27 | Read SPIO status.          | bit[25]   = done_SPIO_SPI_frame|
// |       |               |            |            |                            | bit[24]   = done_SPIO_LNG_reset|
// |       |               |            |            |                            | bit[15:8] = SPIO_rd_DA         |
// |       |               |            |            |                            | bit[ 7:0] = SPIO_rd_DB         |
// +-------+---------------+------------+------------+----------------------------+--------------------------------+
// | SPIO  | SPIO_TI       | 0x11C      | trig_in_47 | Trigger functions.         | bit[0]    = trig_SPIO_LNG_reset|
// |       |               |            |            |                            | bit[1]    = trig_SPIO_SPI_frame|
// +-------+---------------+------------+------------+----------------------------+--------------------------------+
// +-------+---------------+------------+------------+----------------------------+--------------------------------+
// | TRIG  | TRIG_DAT_WI   | 0x024      | wire_in_09 | Control TRIG_DAT interface.| wire_in__trig_data[31:0]       |
// +-------+---------------+------------+------------+----------------------------+--------------------------------+
// | TRIG  | TRIG_DAT_WO   | 0x0A4      | wireout_29 | Read TRIG_DAT status.      | wire_out_trig_data[31:0]       |
// +-------+---------------+------------+------------+----------------------------+--------------------------------+
// | TRIG  | TRIG_DAT_TI   | 0x124      | trig_in_49 | Trigger TRIG_DAT func.     | bit[0] = trig_data_wr          |
// |       |               |            |            | (reserved)                 | bit[1] = trig_data_rd          |
// |       |               |            |            |                            | TBD (reserved)                 |
// +-------+---------------+------------+------------+----------------------------+--------------------------------+
// +-------+---------------+------------+------------+----------------------------+--------------------------------+
// | ADCH  | ADCH_WI       | 0x060      | wire_in_18 | TBC                        | TBC                            |
// +-------+---------------+------------+------------+----------------------------+--------------------------------+
// | ADCH  | ADCH_FREQ_WI  | 0x070      | wire_in_1C | TBC                        | TBC                            |
// +-------+---------------+------------+------------+----------------------------+--------------------------------+
// | ADCH  | ADCH_UPD_SM_WI| 0x074      | wire_in_1D | TBC                        | TBC                            |
// +-------+---------------+------------+------------+----------------------------+--------------------------------+
// | ADCH  | ADCH_SMP_PR_WI| 0x078      | wire_in_1E | TBC                        | TBC                            |
// +-------+---------------+------------+------------+----------------------------+--------------------------------+
// | ADCH  | ADCH_DLY_TP_WI| 0x07C      | wire_in_1F | TBC                        | TBC                            |
// +-------+---------------+------------+------------+----------------------------+--------------------------------+
// | ADCH  | ADCH_WO       | 0x0E0      | wireout_38 | TBC                        | TBC                            |
// +-------+---------------+------------+------------+----------------------------+--------------------------------+
// | ADCH  | ADCH_B_FRQ_WO | 0x0E4      | wireout_39 | TBC                        | TBC                            |
// +-------+---------------+------------+------------+----------------------------+--------------------------------+
// | ADCH  | ADCH_DOUT0_WO | 0x0F0      | wireout_3C | TBC                        | TBC                            |
// +-------+---------------+------------+------------+----------------------------+--------------------------------+
// | ADCH  | ADCH_DOUT1_WO | 0x0F4      | wireout_3D | TBC                        | TBC                            |
// +-------+---------------+------------+------------+----------------------------+--------------------------------+
// | ADCH  | ADCH_DOUT2_WO | 0x0F8      | wireout_3E | TBC                        | TBC                            |
// +-------+---------------+------------+------------+----------------------------+--------------------------------+
// | ADCH  | ADCH_DOUT3_WO | 0x0FC      | wireout_3F | TBC                        | TBC                            |
// +-------+---------------+------------+------------+----------------------------+--------------------------------+
// | ADCH  | ADCH_TI       | 0x160      | trig_in_58 | TBC                        | TBC                            |
// +-------+---------------+------------+------------+----------------------------+--------------------------------+
// | ADCH  | ADCH_TO       | 0x1E0      | trigout_78 | TBC                        | TBC                            |
// +-------+---------------+------------+------------+----------------------------+--------------------------------+
// | ADCH  | ADCH_DOUT0_PO | 0x2F0      | pipeout_BC | TBC                        | TBC                            |
// +-------+---------------+------------+------------+----------------------------+--------------------------------+
// | ADCH  | ADCH_DOUT1_PO | 0x2F4      | pipeout_BD | TBC                        | TBC                            |
// +-------+---------------+------------+------------+----------------------------+--------------------------------+
// +-------+---------------+------------+------------+----------------------------+--------------------------------+
// | DFT   | DFT_TI        | 0x170      | trig_in_5C | TBC                        | TBC                            |
// +-------+---------------+------------+------------+----------------------------+--------------------------------+
// | DFT   | DFT_COEF_RE_PI| 0x270      | pipe_in_9C | TBC                        | TBC                            |
// +-------+---------------+------------+------------+----------------------------+--------------------------------+
// | DFT   | DFT_COEF_IM_PI| 0x274      | pipe_in_9D | TBC                        | TBC                            |
// +-------+---------------+------------+------------+----------------------------+--------------------------------+
// +-------+---------------+------------+------------+----------------------------+--------------------------------+


//// TODO: LAN-MCS endpoint address map
// ## S3100-ADDA  LAN-MCS endpoint address map // GNDU --> PGU --> ADDA
//
// note: LAN access must have TEST, MCS, MEM and MSPI.
// note: MEM device is connected via pin B34_L5N, net S_IO_0 in case of S3100-PGU and S3000-PGU.
// note: MEM device is connected via pin IO_L11P_T1_SRCC_15, net SCIO_0 in case of S3100-CPU-BASE.
//
// +=======+===============+============+=========================================+================================+
// | Group | EP name       | MCS adrs   | type/index | Description                | contents (32-bit)              |
// |       |               | (32-bit)   |            |                            |                                |
// +=======+===============+============+=========================================+================================+
// | TEST  | F_IMAGE_ID_WO | TBD        | wireout_20 | Return FPGA image ID.      | Image_ID[31:0]                 | 
// +-------+---------------+------------+------------+----------------------------+--------------------------------+
// | TEST  | XADC_TEMP_WO  | TBD        | wireout_3A | Return XADC values.[mC]    | MON_TEMP[31:0]                 | 
// +-------+---------------+------------+------------+----------------------------+--------------------------------+
// | TEST  | XADC_VOLT_WO  | TBD        | wireout_3B | Return XADC values.[mV]    | MON_VOLT[31:0] normial 1.1V    |
// +-------+---------------+------------+------------+----------------------------+--------------------------------+
// | TEST  | TIMESTAMP_WO  | TBD        | wireout_22 | Return time stamp. (10MHz) | TIME_STAMP[31:0]               | 
// +-------+---------------+------------+------------+----------------------------+--------------------------------+
// | TEST  | TEST_MON_WO   | TBD        | wireout_23 | Return PLL status.         | bit[18]=MCS pll locked         | 
// |       |               |            |            |                            | bit[24]=DAC common pll locked  |
// |       |               |            |            |                            | bit[25]=DAC0 pll locked        |
// |       |               |            |            |                            | bit[26]=DAC1 pll locked        |
// +-------+---------------+------------+------------+----------------------------+--------------------------------+
// | TEST  | TEST_CON_WI   | TBD        | wireout_01 | Control test logics.       | bit[0]=count1_reset            | 
// |       |               |            |            |                            | bit[1]=count1_disable          |
// |       |               |            |            |                            | bit[2]=count2_auto_increase    |
// +-------+---------------+------------+------------+----------------------------+--------------------------------+
// | TEST  | TEST_OUT_WO   | TBD        | wireout_21 | Return test values.        | bit[15:8]=count2[7:0]          |
// |       |               |            |            |                            | bit[ 7:0]=count1[7:0]          |
// +-------+---------------+------------+------------+----------------------------+--------------------------------+
// | TEST  | TEST_TI       | TBD        | trig_in_40 | Trigger test functions.    | bit[0]=trigger_count2_reset    |
// |       |               |            |            |                            | bit[1]=trigger_count2_up       |
// |       |               |            |            |                            | bit[2]=trigger_count2_down     |
// +-------+---------------+------------+------------+----------------------------+--------------------------------+
// | TEST  | TEST_TO       | TBD        | trigout_60 | Check if trigger is done.  | bit[ 0]=done_count1eq00        |
// |       |               |            |            |                            | bit[ 1]=done_count1eq80        |
// |       |               |            |            |                            | bit[16]=done_count2eqFF        |
// +-------+---------------+------------+------------+----------------------------+--------------------------------+
// | TEST  | TEST_PI       | TBD__      | pipe_in_8A | Write data into test FIFO. | test_fifo_data[31:0]           |
// +-------+---------------+------------+------------+----------------------------+--------------------------------+
// | TEST  | TEST_PO       | TBD__      | pipeout_AA | Read data from test FIFO.  | test_fifo_data[31:0]           |
// +-------+---------------+------------+------------+----------------------------+--------------------------------+
// | TEST  | BRD_CON_WI    | TBD        | wire_in_03 | Control board from LAN.    | bit[ 0]=HW_reset               | 
// |       |               |            |            |                            | bit[ 8]=mcs_ep_po_enable       |
// |       |               |            |            |                            | bit[ 9]=mcs_ep_pi_enable       |
// |       |               |            |            |                            | bit[10]=mcs_ep_to_enable       |
// |       |               |            |            |                            | bit[11]=mcs_ep_ti_enable       |
// |       |               |            |            |                            | bit[12]=mcs_ep_wo_enable       |
// |       |               |            |            |                            | bit[13]=mcs_ep_wi_enable       |
// +-------+---------------+------------+------------+----------------------------+--------------------------------+
// +-------+---------------+------------+------------+----------------------------+--------------------------------+
// | MCS   | MCS_SETUP_WI  | TBD        | wire_in_19 | Control board for MCS.     | bit[31:16]=board_id[15:0]      | 
// |       |               |            |            |                            | bit[10]=lan_on_base_enable(NA) |
// |       |               |            |            |                            | bit[ 9]=eeprom_on_tp_enable(NA)|
// |       |               |            |            |                            | bit[ 8]=eeprom_lan_enable(NA)  |
// |       |               |            |            |                            | bit[ 7: 0]=slot_id             |
// +-------+---------------+------------+------------+----------------------------+--------------------------------+
// +-------+---------------+------------+------------+----------------------------+--------------------------------+
// | MSPI  | MSPI_EN_CS_WI | TBD        | wire_in_16 | Control MSPI CS enable.    | bit[12: 0]=MSPI_EN_CS[12: 0]   |
// |       |               |            |            |                            | bit[16]   =M0 group enable     |
// |       |               |            |            |                            | bit[17]   =M1 group enable     |
// |       |               |            |            |                            | bit[18]   =M2 group enable     |
// +-------+---------------+------------+------------+----------------------------+--------------------------------+
// | MSPI  | MSPI_CON_WI   | TBD        | wire_in_17 | Control MSPI MOSI frame.   | bit[31:26]=frame_data_C[ 5:0]  |
// |       |               |            |            |                            | bit[25:16]=frame_data_A[ 9:0]  |
// |       |               |            |            |                            | bit[15: 0]=frame_data_D[15:0]  |
// +-------+---------------+------------+------------+----------------------------+--------------------------------+
// | MSPI  | MSPI_FLAG_WO  | TBD        | wireout_24 | Return MSPI MISO frame.    | bit[31:16]=frame_data_E[15:0]  |
// |       |               |            |            |                            | bit[15: 0]=frame_data_B[15:0]  |
// +-------+---------------+------------+------------+----------------------------+--------------------------------+
// | MSPI  | MSPI_TI       | TBD        | trig_in_42 | Trigger functions.         | bit[0]=trigger_reset           |
// |       |               |            |            |                            | bit[1]=trigger_init            |
// |       |               |            |            |                            | bit[2]=trigger_frame           |
// |       |               |            |            |                            | bit[3]=trigger_reset_fifo      |
// |       |               |            |            |                            | bit[4]=trigger_frame_fifo      |
// +-------+---------------+------------+------------+----------------------------+--------------------------------+
// | MSPI  | MSPI_TO       | TBD        | trigout_62 | Check if trigger is done.  | bit[0]=done_reset              |
// |       |               |            |            |                            | bit[1]=done_init               |
// |       |               |            |            |                            | bit[2]=done_frame              |
// |       |               |            |            |                            | bit[3]=done_reset_fifo         |
// |       |               |            |            |                            | bit[4]=done_frame_fifo         |
// +-------+---------------+------------+------------+----------------------------+--------------------------------+
// | MSPI  | MSPI_PI       | TBD__      | pipe_in_92 | Send mosi data into pipe.  | bit[31:0]=frame_mosi[31:0]     |
// +-------+---------------+------------+------------+----------------------------+--------------------------------+
// | MSPI  | MSPI_PO       | TBD__      | pipeout_B2 | Read miso data from pipe.  | bit[31:0]=frame_miso[31:0]     |
// +-------+---------------+------------+------------+----------------------------+--------------------------------+
// +-------+---------------+------------+------------+----------------------------+--------------------------------+
// | MEM   | MEM_WI        | TBD__      | wire_in_13 | Control EEPROM interface.  | bit[  15]=disable_SBP_packet   | 
// |       |               |            |            |                            | bit[11:0]=num_bytes_DAT[11:0]  |
// +-------+---------------+------------+------------+----------------------------+--------------------------------+
// | MEM   | MEM_FDAT_WI   | TBD__      | wire_in_12 | Control EEPROM frame data. | bit[31:24]=frame_data_ADH[7:0] |
// |       |               |            |            |                            | bit[23:16]=frame_data_ADL[7:0] |
// |       |               |            |            |                            | bit[15: 8]=frame_data_STA[7:0] |
// |       |               |            |            |                            | bit[ 7: 0]=frame_data_CMD[7:0] |
// +-------+---------------+------------+------------+----------------------------+--------------------------------+
// | MEM   | MEM_TI        | TBD__      | trig_in_53 | Trigger functions.         | bit[0]=trigger_reset           |
// |       |               |            |            |                            | bit[1]=trigger_fifo_reset      |
// |       |               |            |            |                            | bit[2]=trigger_frame           |
// +-------+---------------+------------+------------+----------------------------+--------------------------------+
// | MEM   | MEM_TO        | TBD__      | trigout_73 | Check status.              | bit[0]=MEM_valid_latch         |
// |       |               |            |            |                            | bit[1]=done_frame_latch        |
// |       |               |            |            |                            | bit[2]=done_frame (one pulse)  |
// |       |               |            |            |                            | bit[15:8]=frame_data_STA[7:0]  |
// +-------+---------------+------------+------------+----------------------------+--------------------------------+
// | MEM   | MEM_PI        | TBD__      | pipe_in_93 | Write data into pipe.      | bit[7:0]=frame_data_DAT_w[7:0] |
// +-------+---------------+------------+------------+----------------------------+--------------------------------+
// | MEM   | MEM_PO        | TBD__      | pipeout_B3 | Read data from pipe.       | bit[7:0]=frame_data_DAT_r[7:0] |
// +-------+---------------+------------+------------+----------------------------+--------------------------------+
// +-------+---------------+------------+------------+----------------------------+--------------------------------+
// | DACX  | DACX_WI       | TBD__      | wire_in_05 | Control DAC IC interface.  | bit[30]   = dac1_dco_clk_rst   |
// |       |               |            |            |                            | bit[29]   = dac0_dco_clk_rst   |
// |       |               |            |            |                            | bit[28]   = clk_dac_clk_rst    |
// |       |               |            |            |                            | bit[27]   = dac1_clk_dis       |
// |       |               |            |            |                            | bit[26]   = dac0_clk_dis       |
// |       |               |            |            |                            | bit[24]   = DACx_CS_id         |
// |       |               |            |            |                            | bit[23]   = DACx_R_W_bar       |
// |       |               |            |            |                            | bit[22:21]= DACx_byte_mode[1:0]|
// |       |               |            |            |                            | bit[20:16]= DACx_reg_adrs [4:0]|
// |       |               |            |            |                            | bit[7:0]  = DACx_wr_D[7:0]     |
// +-------+---------------+------------+------------+----------------------------+--------------------------------+
// | DACX  | DACX_WO       | TBD__      | wireout_25 | Read DAC status.           | bit[25]   = done_DACx_SPI_frame|
// |       |               |            |            |                            | bit[24]   = done_DACx_LNG_reset|
// |       |               |            |            |                            | bit[7:0]  = DACx_rd_D[7:0]     |
// +-------+---------------+------------+------------+----------------------------+--------------------------------+
// | DACX  | DACX_TI       | TBD__      | trig_in_45 | Trigger functions.         | bit[0]    = trig_DACx_LNG_reset|
// |       |               |            |            |                            | bit[1]    = trig_DACx_SPI_frame|
// +-------+---------------+------------+------------+----------------------------+--------------------------------+
// +-------+---------------+------------+------------+----------------------------+--------------------------------+
// | DACZ  | DACZ_DAT_WI   | TBD__      | wire_in_08 | Control pattern gen.       | wire_in__dacz_data[31:0]       |
// +-------+---------------+------------+------------+----------------------------+--------------------------------+
// | DACZ  | DACZ_DAT_WO   | TBD__      | wireout_28 | Read pattern gen status.   | wire_out_dacz_data[31:0]       |
// +-------+---------------+------------+------------+----------------------------+--------------------------------+
// | DACZ  | DACZ_DAT_TI   | TBD__      | trig_in_48 | Trigger dacz data func.    | bit[ 4] = write_control        |
// |       |               |            |            |                            | bit[ 5] = read_status          |
// |       |               |            |            |                            | bit[ 6] = write_repeat_period  |
// |       |               |            |            |                            | bit[ 7] = read_repeat_period   |
// |       |               |            |            |                            | bit[ 8] = trig_cid_adrs_wr     |
// |       |               |            |            |                            | bit[ 9] = trig_cid_adrs_rd     |
// |       |               |            |            |                            | bit[10] = trig_cid_data_wr     |
// |       |               |            |            |                            | bit[11] = trig_cid_data_rd     |
// |       |               |            |            |                            | bit[12] = trig_cid_ctrl_wr     |
// |       |               |            |            |                            | bit[13] = trig_cid_ctrl_rd     |
// |       |               |            |            |                            |                                |
// |       |               |            |            |                            | bit[15] = trig_cid_stat_rd     |
// +-------+---------------+------------+------------+----------------------------+--------------------------------+
// | DACZ  | DAC0_DAT_PI   | TBD__      | pipe_in_86 | Write pattern data in fifo.| w_DAC0_DAT_INC_PI[31:0]        |
// +-------+---------------+------------+------------+----------------------------+--------------------------------+
// | DACZ  | DAC0_DUR_PI   | TBD__      | pipe_in_87 | Write pattern data in fifo.| w_DAC0_DUR_PI[31:0]            |
// +-------+---------------+------------+------------+----------------------------+--------------------------------+
// | DACZ  | DAC1_DAT_PI   | TBD__      | pipe_in_88 | Write pattern data in fifo.| w_DAC1_DAT_INC_PI[31:0]        |
// +-------+---------------+------------+------------+----------------------------+--------------------------------+
// | DACZ  | DAC1_DUR_PI   | TBD__      | pipe_in_89 | Write pattern data in fifo.| w_DAC1_DUR_PI[31:0]            |
// +-------+---------------+------------+------------+----------------------------+--------------------------------+
// +-------+---------------+------------+------------+----------------------------+--------------------------------+
// | CLKD  | CLKD_WI       | TBD__      | wire_in_06 | Control DAC IC interface.  | bit[   31]= CLKD_R_W_bar       |
// |       |               |            |            |                            | bit[30:29]= CLKD_byte_mode[1:0]|
// |       |               |            |            |                            | bit[25:16]= CLKD_reg_adrs[9:0] |
// |       |               |            |            |                            | bit[ 7: 0]= CLKD_wr_D[7:0]     |
// +-------+---------------+------------+------------+----------------------------+--------------------------------+
// | CLKD  | CLKD_WO       | TBD__      | wireout_26 | Read DAC status.           | bit[31]   = CLKD_LD            |
// |       |               |            |            |                            | bit[30]   = CLKD_STAT          |
// |       |               |            |            |                            | bit[29]   = CLKD_REFM          |
// |       |               |            |            |                            | bit[28]   = CLKD_SDIO_rd       |
// |       |               |            |            |                            | bit[25]   = done_CLKD_SPI_frame|
// |       |               |            |            |                            | bit[24]   = done_CLKD_LNG_reset|
// |       |               |            |            |                            | bit[7:0]  = CLKD_rd_D          |
// +-------+---------------+------------+------------+----------------------------+--------------------------------+
// | CLKD  | CLKD_TI       | TBD__      | trig_in_46 | Trigger functions.         | bit[0]    = trig_CLKD_LNG_reset|
// |       |               |            |            |                            | bit[1]    = trig_CLKD_SPI_frame|
// +-------+---------------+------------+------------+----------------------------+--------------------------------+
// +-------+---------------+------------+------------+----------------------------+--------------------------------+
// | SPIO  | SPIO_WI       | TBD__      | wire_in_07 | Control SPIO IC interface. | bit[28]   = SPIO_CS_id         |
// |       |               |            |            |                            | bit[27:25]= SPIO_pin_adrs[2:0] |
// |       |               |            |            |                            | bit[24]   = SPIO_R_W_bar       |
// |       |               |            |            |                            | bit[23:16]= SPIO_reg_adrs[7:0] |
// |       |               |            |            |                            | bit[15: 8]= SPIO_wr_DA   [7:0] |
// |       |               |            |            |                            | bit[ 7: 0]= SPIO_wr_DB   [7:0] |
// +-------+---------------+------------+------------+----------------------------+--------------------------------+
// | SPIO  | SPIO_WO       | TBD__      | wireout_27 | Read SPIO status.          | bit[25]   = done_SPIO_SPI_frame|
// |       |               |            |            |                            | bit[24]   = done_SPIO_LNG_reset|
// |       |               |            |            |                            | bit[15:8] = SPIO_rd_DA         |
// |       |               |            |            |                            | bit[ 7:0] = SPIO_rd_DB         |
// +-------+---------------+------------+------------+----------------------------+--------------------------------+
// | SPIO  | SPIO_TI       | TBD__      | trig_in_47 | Trigger functions.         | bit[0]    = trig_SPIO_LNG_reset|
// |       |               |            |            |                            | bit[1]    = trig_SPIO_SPI_frame|
// +-------+---------------+------------+------------+----------------------------+--------------------------------+
// +-------+---------------+------------+------------+----------------------------+--------------------------------+
// | TRIG  | TRIG_DAT_WI   | TBD__      | wire_in_09 | Control TRIG_DAT interface.| wire_in__trig_data[31:0]       |
// +-------+---------------+------------+------------+----------------------------+--------------------------------+
// | TRIG  | TRIG_DAT_WO   | TBD__      | wireout_29 | Read TRIG_DAT status.      | wire_out_trig_data[31:0]       |
// +-------+---------------+------------+------------+----------------------------+--------------------------------+
// | TRIG  | TRIG_DAT_TI   | TBD__      | trig_in_49 | Trigger TRIG_DAT func.     | bit[0] = trig_data_wr          |
// |       |               |            |            | (reserved)                 | bit[1] = trig_data_rd          |
// |       |               |            |            |                            | TBD (reserved)                 |
// +-------+---------------+------------+------------+----------------------------+--------------------------------+
// +-------+---------------+------------+------------+----------------------------+--------------------------------+
// | ADCH  | ADCH_WI       | TBD__      | wire_in_18 | TBC                        | TBC                            |
// +-------+---------------+------------+------------+----------------------------+--------------------------------+
// | ADCH  | ADCH_FREQ_WI  | TBD__      | wire_in_1C | TBC                        | TBC                            |
// +-------+---------------+------------+------------+----------------------------+--------------------------------+
// | ADCH  | ADCH_UPD_SM_WI| TBD__      | wire_in_1D | TBC                        | TBC                            |
// +-------+---------------+------------+------------+----------------------------+--------------------------------+
// | ADCH  | ADCH_SMP_PR_WI| TBD__      | wire_in_1E | TBC                        | TBC                            |
// +-------+---------------+------------+------------+----------------------------+--------------------------------+
// | ADCH  | ADCH_DLY_TP_WI| TBD__      | wire_in_1F | TBC                        | TBC                            |
// +-------+---------------+------------+------------+----------------------------+--------------------------------+
// | ADCH  | ADCH_WO       | TBD__      | wireout_38 | TBC                        | TBC                            |
// +-------+---------------+------------+------------+----------------------------+--------------------------------+
// | ADCH  | ADCH_B_FRQ_WO | TBD__      | wireout_39 | TBC                        | TBC                            |
// +-------+---------------+------------+------------+----------------------------+--------------------------------+
// | ADCH  | ADCH_DOUT0_WO | TBD__      | wireout_3C | TBC                        | TBC                            |
// +-------+---------------+------------+------------+----------------------------+--------------------------------+
// | ADCH  | ADCH_DOUT1_WO | TBD__      | wireout_3D | TBC                        | TBC                            |
// +-------+---------------+------------+------------+----------------------------+--------------------------------+
// | ADCH  | ADCH_DOUT2_WO | TBD__      | wireout_3E | TBC                        | TBC                            |
// +-------+---------------+------------+------------+----------------------------+--------------------------------+
// | ADCH  | ADCH_DOUT3_WO | TBD__      | wireout_3F | TBC                        | TBC                            |
// +-------+---------------+------------+------------+----------------------------+--------------------------------+
// | ADCH  | ADCH_TI       | TBD__      | trig_in_58 | TBC                        | TBC                            |
// +-------+---------------+------------+------------+----------------------------+--------------------------------+
// | ADCH  | ADCH_TO       | TBD__      | trigout_78 | TBC                        | TBC                            |
// +-------+---------------+------------+------------+----------------------------+--------------------------------+
// | ADCH  | ADCH_DOUT0_PO | TBD__      | pipeout_BC | TBC                        | TBC                            |
// +-------+---------------+------------+------------+----------------------------+--------------------------------+
// | ADCH  | ADCH_DOUT1_PO | TBD__      | pipeout_BD | TBC                        | TBC                            |
// +-------+---------------+------------+------------+----------------------------+--------------------------------+
// +-------+---------------+------------+------------+----------------------------+--------------------------------+
// | DFT   | DFT_TI        | TBD__      | trig_in_5C | TBC                        | TBC                            |
// +-------+---------------+------------+------------+----------------------------+--------------------------------+
// | DFT   | DFT_COEF_RE_PI| TBD__      | pipe_in_9C | TBC                        | TBC                            |
// +-------+---------------+------------+------------+----------------------------+--------------------------------+
// | DFT   | DFT_COEF_IM_PI| TBD__      | pipe_in_9D | TBC                        | TBC                            |
// +-------+---------------+------------+------------+----------------------------+--------------------------------+
// +-------+---------------+------------+------------+----------------------------+--------------------------------+



/* sub modules */

//// TODO:  sub_buf_16b //{
module sub_buf_16b ( //{
	input wire clk    ,
	input wire reset_n,
	//
	input  wire [15:0] i_buf, // 
	output wire [15:0] o_buf  // 
	);

reg  [15:0] r_DAT; // located at IOB //{

reg  [15:0] r_DAT_smp0;
reg  [15:0] r_DAT_smp1;
wire [15:0] w_DAT = i_buf;

always @(posedge clk, negedge reset_n) begin 
	if (!reset_n) begin 
		r_DAT        <=  16'b0;
		r_DAT_smp0   <=  16'b0;
		r_DAT_smp1   <=  16'b0;
	end
	else begin
		r_DAT        <= r_DAT_smp0;
		r_DAT_smp0   <= r_DAT_smp1;
		r_DAT_smp1   <= w_DAT     ;
	end
end

assign o_buf = r_DAT;
//}

endmodule //}

//}


//// TODO:  sub_trig_data //{

// test only

module sub_trig_data ( //{
	input wire clk    ,
	input wire reset_n,
	//
	input  wire [31:0] i_wire_in_trig_data, // 
	input  wire [31:0] i_trig_in_trig_data, // 
	output wire [31:0] o_wireout_trig_data  // 
	);

wire [31:0] w_data_in = i_wire_in_trig_data;
wire [31:0] w_trig    = i_trig_in_trig_data;
// bit[0] = trig_data_wr 
// bit[1] = trig_data_rd 

reg  [31:0] r_data    ;
reg  [31:0] r_port_out; //{

// mapping
assign o_wireout_trig_data = r_port_out;

always @(posedge clk, negedge reset_n) begin 
	if (!reset_n) begin 
		r_data     <=  32'b0;
		r_port_out <=  32'b0;
	end
	else begin
		//
		if (w_trig[0])
			r_data     <= w_data_in;
		//
		if (w_trig[1])
			r_port_out <= r_data   ;
		//
	end
end

//}

endmodule //}

//}


/* top module integration */
module txem7310_pll__s3100_sv_adda__top ( 

	//// note: BANK 14 15 16  signals // NOT compatible with TXEM7310 connectors

	//// BANK B14 //{
	
	//$$ no user pin used in S3100-CMU-ADDA
	
	// # IO_0_14                         # P20  # NA                        
	// # IO_B14_L1P_D00_MOSI             # P22  # FPGA_CFG_D0     (*)       
	// # IO_B14_L1N_D01_DIN              # R22  # FPGA_CFG_D1     (*)       
	// # IO_B14_L2P_D02                  # P21  # FPGA_CFG_D2     (*)       
	// # IO_B14_L2N_D03                  # R21  # FPGA_CFG_D3     (*)       
	// # IO_B14_L3P_PUDC_B               # U22  # FPGA_CFG_PUDC_B (*)       
	// # IO_B14_L3N                      # V22  # NA                        
	//output wire  o_B14_L4P        , // # T21  # NA
	//output wire  o_B14_L4N        , // # U21  # NA
	//output wire  o_B14_L5P        , // # P19  # NA
	//output wire  o_B14_L5N        , // # R19  # NA
	// # IO_B14_L6P_FCS_B                # T19  # FPGA_CFG_FCS_B  (*)       
	//output wire  o_B14_L6N        , // # T20  # NA
	//output wire  o_B14_L7P        , // # W21  # NA
	//output wire  o_B14_L7N        , // # W22  # NA
	//output wire  o_B14_L8P        , // # AA20 # NA
	//output wire  o_B14_L8N        , // # AA21 # NA
	//output wire  o_B14_L9P        , // # Y21  # NA
	//output wire  o_B14_L9N        , // # Y22  # NA
	//output wire  o_B14_L10P       , // # AB21 # NA
	// # IO_B14_L10N_                    # AB22 # NA                        
	//inout  wire  io_B14_L11P_SRCC , // # U20  # NA
	//inout  wire  io_B14_L11N_SRCC , // # V20  # NA
	//inout  wire  io_B14_L12P_MRCC , // # W19  # NA
	//inout  wire  io_B14_L12N_MRCC , // # W20  # NA
	//inout  wire  io_B14_L13P_MRCC , // # Y18  # NA
	//inout  wire  io_B14_L13N_MRCC , // # Y19  # NA
	//inout  wire  io_B14_L14P_SRCC , // # V18  # NA
	//inout  wire  io_B14_L14N_SRCC , // # V19  # NA
	// # IO_B14_L15P                     # AA19 # NA                        
	// # IO_B14_L15N                     # AB20 # NA                        
	// # IO_B14_L16P                     # V17  # NA                        
	//output wire  o_B14_L16N       , // # W17  # NA
	//output wire  o_B14_L17P       , // # AA18 # NA
	//output wire  o_B14_L17N       , // # AB18 # NA
	//output wire  o_B14_L18P       , // # U17  # NA
	//output wire  o_B14_L18N       , // # U18  # NA
	//output wire  o_B14_L19P       , // # P14  # NA
	//output wire  o_B14_L19N       , // # R14  # NA
	//output wire  o_B14_L20P       , // # R18  # NA
	//output wire  o_B14_L20N       , // # T18  # NA
	//output wire  o_B14_L21P       , // # N17  # NA
	//output wire  o_B14_L21N       , // # P17  # NA
	//output wire  o_B14_L22P       , // # P15  # NA
	//output wire  o_B14_L22N       , // # R16  # NA
	//input  wire  i_B14_L23P       , // # N13  # NA
	//input  wire  i_B14_L23N       , // # N14  # NA
	//input  wire  i_B14_L24P       , // # P16  # NA
	//input  wire  i_B14_L24N       , // # R17  # NA
	// # IO_B14_25                       # N15  # NA                        
	
	//}
	
	//// BANK B15 //{
	
	//                                                      ##[S3100-PGU-ADDA]                     ##[S3100-CMU-ADDA]
	//output wire   o_B15_0_        , // # J16  # NA
	// ## TPs 
	inout  wire io_B15_L1P_AD0P     , // # H13  # F_TP0       ## TP0 // test for eeprom : VCC_3.3V ## io_TP0
	inout  wire io_B15_L1N_AD0N     , // # G13  # F_TP1       ## TP1 // test for eeprom : VSS_GND  ## io_TP1
	inout  wire io_B15_L2P_AD8P     , // # G15  # F_TP2       ## TP2 // test for eeprom : SCIO     ## io_TP2
	inout  wire io_B15_L2N_AD8N     , // # G16  # F_TP3       ## TP3 // test for        : NA       ## io_TP3
	inout  wire io_B15_L3P_AD1P     , // # J14  # F_TP4       ## TP4 // test for        : NA       ## io_TP4
	inout  wire io_B15_L3N_AD1N     , // # H14  # F_TP5       ## TP5 // test for        : NA       ## io_TP5
	//input  wire  i_B15_L4P        , // # G17  # NA                                               ## NA
	//inout  wire io_B15_L4N        , // # G18  # NA                                               ## NA
	inout  wire io_B15_L5P_AD9P     , // # J15  # F_TP6       ## TP6 // test for        : NA       ## o_TP6
	inout  wire io_B15_L5N_AD9N     , // # H15  # F_TP7       ## TP7 // test for        : NA       ## o_TP7
	// ## LAN for END-POINTS       
	//output wire  o_B15_L6P        , // # H17  # LAN_PWDN    ## EP_LAN_PWDN                       ## NA
	//output wire  o_B15_L6N        , // # H18  # LAN_SSAUX_B //$$ ssn aux # NA                    ## NA
	input  wire   i_B15D_L7P        , // # J22  # LAN_MOSI    ## EP_LAN_MOSI                       ## i_ADC1_DA_P
	input  wire   i_B15D_L7N        , // # H22  # LAN_SCLK    ## EP_LAN_SCLK                       ## i_ADC1_DA_N
	input  wire   i_B15D_L8P        , // # H20  # LAN_SSN_B   ## EP_LAN_CS_B                       ## i_ADC1_DB_P
	input  wire   i_B15D_L8N        , // # G20  # LAN_INT_B   ## EP_LAN_INT_B                      ## i_ADC1_DB_N
	output wire   o_B15D_L9P        , // # K21  # LAN_RST_B   ## EP_LAN_RST_B                      ## o_ADCx_CLK_P
	output wire   o_B15D_L9N        , // # K22  # LAN_MISO    ## EP_LAN_MISO                       ## o_ADCx_CLK_N
	// ## ADC
	//input  wire  i_B15_L10P_AD11P , // # M21  # AUX_AD11P                                        ## AUX_AD11P // unused
	//input  wire  i_B15_L10N_AD11N , // # L21  # AUX_AD11N                                        ## AUX_AD11N // unused
	//
	//inout  wire io_B15_L11P_SRCC  , // # J20  # SCIO_0 //$$ 11AA160T # NA                        ## NA
	//inout  wire io_B15_L11N_SRCC  , // # J21  # SCIO_1 //$$ 11AA160T # NA                        ## NA
	input  wire   c_B15D_L12P_MRCC  , // # J19  # NA                                               ## i_ADC1_DCO_P
	input  wire   c_B15D_L12N_MRCC  , // # H19  # NA                                               ## i_ADC1_DCO_N
	input  wire   c_B15D_L13P_MRCC  , // # K18  # NA                                               ## i_ADC0_DCO_P
	input  wire   c_B15D_L13N_MRCC  , // # K19  # NA                                               ## i_ADC0_DCO_N
	//input  wire  i_B15_L14P_SRCC  , // # L19  # NA                                               ## NA
	//input  wire  i_B15_L14N_SRCC  , // # L20  # NA                                               ## NA
	output wire   o_B15D_L15P       , // # N22  # NA                                               ## o_ADCx_CNV_P
	output wire   o_B15D_L15N       , // # M22  # NA                                               ## o_ADCx_CNV_N
	//input  wire  i_B15_L16P       , // # M18  # NA                                               ## NA
	//output wire  o_B15_L16N       , // # L18  # NA                                               ## NA
	input  wire   i_B15D_L17P       , // # N18  # NA                                               ## i_ADC0_DA_P
	input  wire   i_B15D_L17N       , // # N19  # NA                                               ## i_ADC0_DA_N
	input  wire   i_B15D_L18P       , // # N20  # NA                                               ## i_ADC0_DB_P
	input  wire   i_B15D_L18N       , // # M20  # NA                                               ## i_ADC0_DB_N
	//input  wire  i_B15_L19P       , // # K13  # NA                                               ## NA
	//input  wire  i_B15_L19N       , // # K14  # NA                                               ## NA
	inout  wire  io_B15_L20P        , // # M13  # NA                                               ## io_SCIO_0  // for LAN EEPROM
	inout  wire  io_B15_L20N        , // # L13  # NA                                               ## io_SCIO_1  // for LAN EEPROM
	output wire   o_B15_L21P        , // # K17  # NA                                               ## o_LAN_PWDN
	input  wire   i_B15_L21N        , // # J17  # NA                                               ## i_LAN_INT_B
	input  wire   i_B15_L22P        , // # L14  # NA                                               ## i_LAN_MISO
	output wire   o_B15_L22N        , // # L15  # NA                                               ## o_LAN_RST_B
	output wire   o_B15_L23P        , // # L16  # NA                                               ## o_LAN_SSAUX_B
	output wire   o_B15_L23N        , // # K16  # NA                                               ## o_LAN_SSN_B
	output wire   o_B15_L24P        , // # M15  # NA                                               ## o_LAN_MOSI
	output wire   o_B15_L24N        , // # M16  # NA                                               ## o_LAN_SCLK
	output wire   o_B15_25          , // # M17  # NA                                               ## o_ADCx_TPT_B

	//}

	//// BANK B16 //{
	
	//                                          ##[S3100-PGU-ADDA]       ##[S3100-CMU-ADDA]
	//output wire  o_B16_0_         , // # F15  # NA                     ## NA
	//
	input  wire  i_B16_L1P          , // # F13  # NA                     ## i_GPIO_0
	input  wire  i_B16_L1N          , // # F14  # NA                     ## i_GPIO_1
	input  wire  i_B16_L2P          , // # F16  # NA                     ## i_GPIO_2
	input  wire  i_B16_L2N          , // # E17  # NA                     ## i_GPIO_3
	input  wire  i_B16_L3P          , // # C14  # NA                     ## i_GPIO_4
	input  wire  i_B16_L3N          , // # C15  # NA                     ## i_GPIO_5
	input  wire  i_B16_L4P          , // # E13  # NA                     ## i_GPIO_6
	input  wire  i_B16_L4N          , // # E14  # NA                     ## i_GPIO_7
	input  wire  i_B16_L5P          , // # E16  # NA                     ## i_SLOT_ID_0
	input  wire  i_B16_L5N          , // # D16  # NA                     ## i_SLOT_ID_1
	input  wire  i_B16_L6P          , // # D14  # NA                     ## i_SLOT_ID_2
	input  wire  i_B16_L6N          , // # D15  # NA                     ## i_SLOT_ID_3
	inout  wire io_B16_L7P          , // # B15  ## F_LED4                ## io_F_LED4
	inout  wire io_B16_L7N          , // # B16  ## F_LED6                ## io_F_LED6
	//inout  wire io_B16_L8P        , // # C13  # NA                     ## NA     
	inout  wire io_B16_L8N          , // # B13  ## F_LED1                ## io_F_LED1
	inout  wire io_B16_L9P          , // # A15  ## F_LED3                ## io_F_LED3
	inout  wire io_B16_L9N          , // # A16  ## F_LED5                ## io_F_LED5
	inout  wire io_B16_L10P         , // # A13  ## F_LED0                ## io_F_LED0
	inout  wire io_B16_L10N         , // # A14  ## F_LED2                ## io_F_LED2
	inout  wire io_B16_L11P         , // # B17  ## F_LED7                ## io_F_LED7
	//inout  wire io_B16_L11N       , // # B18  # NA                     ## NA
	inout  wire io_B16_L12P         , // # D17  # NA                     ## io_S_IO_0
	//inout  wire io_B16_L12N       , // # C17  # NA                     ## NA
	inout  wire io_B16_L13P         , // # C18  # NA                     ## io_S_IO_3
	//inout  wire io_B16_L13N       , // # C19  # NA                     ## NA
	inout  wire io_B16_L14P         , // # E19  # NA                     ## io_S_IO_4
	//inout  wire io_B16_L14N       , // # D19  # NA                     ## NA
	inout  wire io_B16_L15P         , // # F18  # NA                     ## io_S_IO_5
	//inout  wire io_B16_L15N       , // # E18  # NA                     ## NA
	input  wire  i_B16_L16P         , // # B20  # NA                     ## i_M2_SPI_CS_BUF
	input  wire  i_B16_L16N         , // # A20  # NA                     ## i_M2_SPI_MOSI
	output wire  o_B16_L17P         , // # A18  # NA                     ## o_M2_SPI_TX_EN_SLAVE
	output wire  o_B16_L17N         , // # A19  # NA                     ## o_M2_SPI_RX_CLK_B
	inout  wire io_B16_L18P         , // # F19  # NA                     ## io_S_IO_1
	//  # IO_B16_L18N_T2_16           // # F20  # NA                     ## NA
	//output wire  o_B16_L19P       , // # D20  # NA                     ## NA
	output wire  o_B16_L19N         , // # C20  # NA                     ## o_M2_SPI_MISO_B
	output wire  o_B16_L20P         , // # C22  # NA                     ## o_SPIOx_SCLK
	output wire  o_B16_L20N         , // # B22  # NA                     ## o_SPIO1_CS
	input  wire  i_B16_L21P         , // # B21  # NA                     ## i_M2_SPI_TX_CLK
	output wire  o_B16_L21N         , // # A21  # NA                     ## o_M2_SPI_RX_EN_SLAVE
	input  wire  i_B16_L22P         , // # E22  # NA                     ## i_SPIOx_MISO
	output wire  o_B16_L22N         , // # D22  # NA                     ## o_SPIOx_MOSI
	input  wire  i_B16_L23P         , // # E21  # NA                     ## i_ID_3
	input  wire  i_B16_L23N         , // # D21  # NA                     ## i_ID_2
	input  wire  i_B16_L24P         , // # G21  # NA                     ## i_ID_1
	input  wire  i_B16_L24N         , // # G22  # NA                     ## i_ID_0
	//
	//output wire  o_B16_25         , // # F21  # NA                     ## NA
	
	//}


	//// BANK 13 34 35 signals in previous connectors
	
	//// BANK B13 //{
	
	//                                                  ##[S3100-PGU-ADDA]                 ##[S3100-CMU-ADDA]
	inout  wire  io_B13_0_        , // # Y17            # NA                               ## io_S_IO_2
	//output wire o_B13_L1P       , // # Y16  # MC1-75  ## SPIO1_CS                        ## NA
	input  wire   i_B13_L1N       , // # AA16 # MC1-76  ## S_IO_2                          ## i_CLKD_LD
	input  wire   i_B13_L2P       , // # AB16 # MC1-67  ## M2_SPI_RX_EN_SLAVE              ## i_CLKD_STAT
	output wire   o_B13_L2N       , // # AB17 # MC1-69  ## SPIOx_SCLK                      ## o_CLKD_SYNC
	output wire   o_B13_L3P       , // # AA13 # MC1-68  ## DACx_SDIO                       ## o_CLKD_RST_B
	inout  wire  io_B13_L3N       , // # AB13 # MC1-70  ## DACx_SDO                        ## io_CLKD_SDIO
	output wire   o_B13_L4P       , // # AA15 # MC1-71  ## SPIOx_MOSI                      ## o_CLKD_SCLK
	input  wire   i_B13_L4N       , // # AB15 # MC1-73  ## SPIOx_MISO                      ## i_CLKD_REFM
	input  wire   i_B13_L5P       , // # Y13  # MC1-64  ## DAC1_CS                         ## i_CLKD_SDO
	output wire   o_B13_L5N       , // # AA14 # MC1-66  ## DACx_SCLK                       ## o_CLKD_CS_B
	output wire   o_B13_L6P       , // # W14  # MC2-72  ## M2_SPI_CS_BUF                   ## o_TRIG_OUT_P
	output wire   o_B13_L6N       , // # Y14  # MC2-74  ## M2_SPI_TX_CLK                   ## o_TRIG_OUT_N
	output wire   o_B13_L7P       , // # AB11 # MC1-8   ## DACx_RST_B                      ## o_DAC1_CS
	output wire   o_B13_L7N       , // # AB12 # MC2-11  ## CLKD_SYNC                       ## o_DACx_RST_B
	output wire   o_B13_L8P       , // # AA9            # NA                               ## o_DAC0_CS
	input  wire   i_B13_L8N       , // # AB10           # NA                               ## i_DACx_SDO
	output wire   o_B13_L9P       , // # AA10           # NA                               ## o_DACx_SDIO
	output wire   o_B13_L9N       , // # AA11           # NA                               ## o_DACx_SCLK
	//input  wire  i_B13_L10P     , // # V10            # NA                               ## NA
	//input  wire  i_B13_L10N     , // # W10            # NA                               ## NA
	//output wire  o_B13_L11P_SRCC, // # Y11  # MC2-75  ## M2_SPI_TX_EN_SLAVE              ## NA
	//input  wire  i_B13_L11N_SRCC, // # Y12  # MC2-76  ## M2_SPI_MOSI                     ## NA
	// # IO_B13_L12P_MRCC         , // # W11            ## clocks sys_clkp (*)             ## ...
	// # IO_B13_L12N_MRCC         , // # W12            ## clocks sys_clkn (*)             ## ...
	input  wire   c_B13D_L13P_MRCC, // # V13  # MC2-71  ## CLKD_COUT_P                     ## i_CLKD_COUT_P
	input  wire   c_B13D_L13N_MRCC, // # V14  # MC2-73  ## CLKD_COUT_N                     ## i_CLKD_COUT_N
	input  wire   i_B13D_L14P_SRCC, // # U15  # MC2-64  ## TRIG_IN_P    //                 ## i_TRIG_IN_P  
	input  wire   i_B13D_L14N_SRCC, // # V15  # MC2-66  ## TRIG_IN_N    //                 ## i_TRIG_IN_N  
	//output wire  o_B13_L15P     , // # T14  # MC2-68  ## TRIG_OUT_P   //$$ B13 LVCMOS25  ## NA
	//output wire  o_B13_L15N     , // # T15  # MC2-70  ## TRIG_OUT_N   //$$ B13 LVCMOS25  ## NA
	//output wire  o_B13_L16P     , // # W15  # MC1-72  ## DAC0_CS                         ## NA
	//inout  wire io_B13_L16N     , // # W16  # MC1-74  ## S_IO_1                          ## NA
	//output wire  o_B13_L17P     , // # T16  # MC2-67  ## M2_SPI_MISO_B                   ## NA
	//output wire  o_B13_L17N     , // # U16  # MC2-69  ## M2_SPI_RX_CLK_B                 ## NA
	
	//}
		
	//// BANK B34 //{
	
	//                                                   ##[S3100-PGU-ADDA]       ##[S3100-CMU-ADDA]
	//input  wire  i_B34_0_       , // # T3    # NA      ...                      ...
	output wire  o_B34D_L1P       , // # T1    # MC1-59  ## DAC0_DAT_P2           ## o_DAC1_DAT_N1 // swap
	output wire  o_B34D_L1N       , // # U1    # MC1-61  ## DAC0_DAT_N2           ## o_DAC1_DAT_P1 // swap
	output wire  o_B34D_L2P       , // # U2    # MC1-49  ## DAC0_DAT_P4           ## o_DAC1_DAT_N2 // swap
	output wire  o_B34D_L2N       , // # V2    # MC1-51  ## DAC0_DAT_N4           ## o_DAC1_DAT_P2 // swap
	output wire  o_B34D_L3P       , // # R3    # MC1-41  ## DAC0_DAT_P6           ## o_DAC1_DAT_P0
	output wire  o_B34D_L3N       , // # R2    # MC1-43  ## DAC0_DAT_N6	          ## o_DAC1_DAT_N0
	output wire  o_B34D_L4P       , // # W2    # MC1-53  ## DAC0_DAT_P3           ## o_DAC1_DAT_N5 // swap
	output wire  o_B34D_L4N       , // # Y2    # MC1-57  ## DAC0_DAT_N3           ## o_DAC1_DAT_P5 // swap
	output wire  o_B34D_L5P       , // # W1    # MC1-54  ## ADCx_TPT_B            ## o_DAC1_DAT_N4 // swap
	output wire  o_B34D_L5N       , // # Y1    # MC1-58  ## S_IO_0 --> MEM_SIO    ## o_DAC1_DAT_P4 // swap
	output wire  o_B34D_L6P       , // # U3    # MC1-50  ## ADCx_CNV_P            ## o_DAC1_DAT_N3 // swap
	output wire  o_B34D_L6N       , // # V3    # MC1-52  ## ADCx_CNV_N            ## o_DAC1_DAT_P3 // swap
	output wire  o_B34D_L7P       , // # AA1   # MC1-63  ## DAC0_DAT_P1           ## o_DAC1_DAT_N6 // swap
	output wire  o_B34D_L7N       , // # AB1   # MC1-65  ## DAC0_DAT_N1           ## o_DAC1_DAT_P6 // swap
	output wire  o_B34D_L8P       , // # AB3   # MC1-60  ## ADCx_CLK_P            ## o_DAC1_DAT_P8
	output wire  o_B34D_L8N       , // # AB2   # MC1-62  ## ADCx_CLK_N            ## o_DAC1_DAT_N8
	output wire  o_B34D_L9P       , // # Y3    # MC1-45  ## DAC0_DAT_P5           ## o_DAC1_DAT_N7 // swap
	output wire  o_B34D_L9N       , // # AA3   # MC1-47  ## DAC0_DAT_N5           ## o_DAC1_DAT_P7 // swap
	output wire  o_B34D_L10P      , // # AA5   # MC1-31  ## DAC0_DCI_P            ## o_DAC1_DAT_P9
	output wire  o_B34D_L10N      , // # AB5   # MC1-33  ## DAC0_DCI_N            ## o_DAC1_DAT_N9
	//input  wire c_B34D_L11P_SRCC, // # Y4    # MC1-38  ## ADC0_DCO_P            ## NA
	//input  wire c_B34D_L11N_SRCC, // # AA4   # MC1-40  ## ADC0_DCO_N            ## NA
	input  wire  c_B34D_L12P_MRCC , // # V4    # MC1-77  ## DAC0_DAT_P0           ## c_DAC1_DCO_N  // swap
	input  wire  c_B34D_L12N_MRCC , // # W4    # MC1-79  ## DAC0_DAT_N0           ## c_DAC1_DCO_P  // swap
	output wire  o_B34D_L13P_MRCC , // # R4    # MC1-32  ## DAC0_DAT_P11          ## o_DAC1_DCI_N  // swap
	output wire  o_B34D_L13N_MRCC , // # T4    # MC1-34  ## DAC0_DAT_N11          ## o_DAC1_DCI_P  // swap
	//input  wire c_B34D_L14P_SRCC, // # T5    # MC1-27  ## DAC0_DCO_P            ## NA
	//input  wire c_B34D_L14N_SRCC, // # U5    # MC1-29  ## DAC0_DCO_N            ## NA
	output wire  o_B34D_L15P      , // # W6    # MC1-28  ## DAC0_DAT_N15 // swap  ## o_DAC1_DAT_P12
	output wire  o_B34D_L15N      , // # W5    # MC1-30  ## DAC0_DAT_P15 // swap  ## o_DAC1_DAT_N12
	//output wire  o_B34D_L16P    , // # U6    # MC1-23  ## DAC0_DAT_N10 // swap  ## NA
	//output wire  o_B34D_L16N    , // # V5    # MC1-25  ## DAC0_DAT_P10 // swap  ## NA
	//output wire  o_B34D_L17P    , // # R6    # MC1-19  ## DAC0_DAT_N9  // swap  ## NA
	//output wire  o_B34D_L17N    , // # T6    # MC1-21  ## DAC0_DAT_P9  // swap  ## NA
	output wire  o_B34D_L18P      , // # Y6    # MC1-42  ## ADC0_DA_P             ## o_DAC1_DAT_P13
	output wire  o_B34D_L18N      , // # AA6   # MC1-44  ## ADC0_DA_N             ## o_DAC1_DAT_N13
	//output wire  o_B34D_L19P    , // # V7    # MC1-20  ## DAC0_DAT_N13 // swap  ## NA
	//output wire  o_B34D_L19N    , // # W7    # MC1-22  ## DAC0_DAT_P13 // swap  ## NA
	output wire  o_B34D_L20P      , // # AB7   # MC1-37  ## DAC0_DAT_P7           ## o_DAC1_DAT_P10
	output wire  o_B34D_L20N      , // # AB6   # MC1-39  ## DAC0_DAT_N7           ## o_DAC1_DAT_N10
	//output wire  o_B34D_L21P    , // # V9    # MC1-16  ## DAC0_DAT_N12 // swap  ## NA
	//output wire  o_B34D_L21N    , // # V8    # MC1-18  ## DAC0_DAT_P12 // swap  ## NA
	output wire  o_B34D_L22P      , // # AA8   # MC1-46  ## ADC0_DB_P             ## o_DAC1_DAT_P11
	output wire  o_B34D_L22N      , // # AB8   # MC1-48  ## ADC0_DB_N             ## o_DAC1_DAT_N11
	output wire  o_B34D_L23P      , // # Y8    # MC1-24  ## DAC0_DAT_N14 // swap  ## o_DAC1_DAT_P14
	output wire  o_B34D_L23N      , // # Y7    # MC1-26  ## DAC0_DAT_P14 // swap  ## o_DAC1_DAT_N14
	output wire  o_B34D_L24P      , // # W9    # MC1-15  ## DAC0_DAT_N8  // swap  ## o_DAC1_DAT_P15
	output wire  o_B34D_L24N      , // # Y9    # MC1-17  ## DAC0_DAT_P8  // swap  ## o_DAC1_DAT_N15
	
	//output wire  o_B34_25       , // # U7    # NA      ...                      ...

	//}

	//// BANK B35 //{
	
	//                                                   ##[S3100-PGU-ADDA]       ##[S3100-CMU-ADDA]
	//output wire  o_B35_0_       , // # F4    # MC2-10  ## CLKD_RST_B            ## NA
	//
	output wire  o_B35D_L1P       , // # B1    # MC2-59  ## DAC1_DAT_N13 // swap  ## o_DAC0_DAT_P0
	output wire  o_B35D_L1N       , // # A1    # MC2-61  ## DAC1_DAT_P13 // swap  ## o_DAC0_DAT_N0
	output wire  o_B35D_L2P       , // # C2    # MC2-60  ## DAC1_DAT_N12 // swap  ## o_DAC0_DAT_P1
	output wire  o_B35D_L2N       , // # B2    # MC2-62  ## DAC1_DAT_P12 // swap  ## o_DAC0_DAT_N1
	output wire  o_B35D_L3P       , // # E1    # MC2-54  ## DAC1_DAT_N11 // swap  ## o_DAC0_DAT_P2
	output wire  o_B35D_L3N       , // # D1    # MC2-58  ## DAC1_DAT_P11 // swap  ## o_DAC0_DAT_N2
	output wire  o_B35D_L4P       , // # E2    # MC2-49  ## CLKD_SCLK             ## o_DAC0_DAT_P3
	output wire  o_B35D_L4N       , // # D2    # MC2-51  ## CLKD_CS_B             ## o_DAC0_DAT_N3
	output wire  o_B35D_L5P       , // # G1    # MC2-50  ## DAC1_DAT_N10 // swap  ## o_DAC0_DAT_P4
	output wire  o_B35D_L5N       , // # F1    # MC2-52  ## DAC1_DAT_P10 // swap  ## o_DAC0_DAT_N4
	//input  wire  i_B35_L6P      , // # F3    # MC2-53  ## CLKD_SDO              ## NA
	//inout  wire io_B35_L6N      , // # E3    # MC2-57  ## CLKD_SDIO             ## NA
	output wire  o_B35D_L7P       , // # K1    # MC2-41  ## ADC1_DA_P             ## o_DAC0_DAT_P6
	output wire  o_B35D_L7N       , // # J1    # MC2-43  ## ADC1_DA_N             ## o_DAC0_DAT_N6
	output wire  o_B35D_L8P       , // # H2    # MC2-46  ## DAC1_DAT_N9  // swap  ## o_DAC0_DAT_P5
	output wire  o_B35D_L8N       , // # G2    # MC2-48  ## DAC1_DAT_P9  // swap  ## o_DAC0_DAT_N5
	output wire  o_B35D_L9P       , // # K2    # MC2-37  ## ADC1_DB_P             ## o_DAC0_DAT_P7
	output wire  o_B35D_L9N       , // # J2    # MC2-39  ## ADC1_DB_N             ## o_DAC0_DAT_N7
	//output wire  o_B35D_L10P    , // # J5    # MC2-42  ## DAC1_DAT_N8  // swap  ## NA
	//output wire  o_B35D_L10N    , // # H5    # MC2-44  ## DAC1_DAT_P8  // swap  ## NA
	output wire  o_B35D_L11P_SRCC , // # H3    # MC2-45  ## ADC1_DCO_P            ## o_DAC0_DCI_P
	output wire  o_B35D_L11N_SRCC , // # G3    # MC2-47  ## ADC1_DCO_N            ## o_DAC0_DCI_N
	input  wire  c_B35D_L12P_MRCC , // # H4    # MC2-67  ## DAC1_DAT_N15 // swap  ## c_DAC0_DCO_P
	input  wire  c_B35D_L12N_MRCC , // # G4    # MC2-69  ## DAC1_DAT_P15 // swap  ## c_DAC0_DCO_N
	output wire  o_B35D_L13P_MRCC , // # K4    # MC2-63  ## DAC1_DAT_N14 // swap  ## o_DAC0_DAT_P12
	output wire  o_B35D_L13N_MRCC , // # J4    # MC2-65  ## DAC1_DAT_P14 // swap  ## o_DAC0_DAT_N12
	output wire  o_B35D_L14P_SRCC , // # L3    # MC2-38  ## DAC1_DCO_N   // swap  ## o_DAC0_DAT_P13
	output wire  o_B35D_L14N_SRCC , // # K3    # MC2-40  ## DAC1_DCO_P   // swap  ## o_DAC0_DAT_N13
	output wire  o_B35D_L15P      , // # M1    # MC2-31  ## CLKD_STAT             ## o_DAC0_DAT_P8
	output wire  o_B35D_L15N      , // # L1    # MC2-33  ## CLKD_REFM             ## o_DAC0_DAT_N8
	output wire  o_B35D_L16P      , // # M3    # MC2-28  ## DAC1_DAT_P4           ## o_DAC0_DAT_P9
	output wire  o_B35D_L16N      , // # M2    # MC2-30  ## DAC1_DAT_N4           ## o_DAC0_DAT_N9
	//output wire  o_B35D_L17P    , // # K6    # MC2-32  ## DAC1_DCI_N   // swap  ## NA
	//output wire  o_B35D_L17N    , // # J6    # MC2-34  ## DAC1_DCI_P   // swap  ## NA
	output wire  o_B35D_L18P      , // # L5    # MC2-23  ## DAC1_DAT_P1           ## o_DAC0_DAT_P14
	output wire  o_B35D_L18N      , // # L4    # MC2-25  ## DAC1_DAT_N1           ## o_DAC0_DAT_N14
	output wire  o_B35D_L19P      , // # N4    # MC2-19  ## DAC1_DAT_P2           ## o_DAC0_DAT_P15
	output wire  o_B35D_L19N      , // # N3    # MC2-21  ## DAC1_DAT_N2           ## o_DAC0_DAT_N15
	output wire  o_B35D_L20P      , // # R1    # MC2-24  ## DAC1_DAT_P5           ## o_DAC0_DAT_P11
	output wire  o_B35D_L20N      , // # P1    # MC2-26  ## DAC1_DAT_N5           ## o_DAC0_DAT_N11
	//output wire  o_B35D_L21P    , // # P5    # MC2-15  ## DAC1_DAT_P3           ## NA
	//output wire  o_B35D_L21N    , // # P4    # MC2-17  ## DAC1_DAT_N3           ## NA
	output wire  o_B35D_L22P      , // # P2    # MC2-20  ## DAC1_DAT_P6           ## o_DAC0_DAT_P10
	output wire  o_B35D_L22N      , // # N2    # MC2-22  ## DAC1_DAT_N6           ## o_DAC0_DAT_N10
	//output wire  o_B35D_L23P    , // # M6    # MC2-27  ## DAC1_DAT_P0           ## NA
	//output wire  o_B35D_L23N    , // # M5    # MC2-29  ## DAC1_DAT_N0           ## NA
	//output wire  o_B35D_L24P    , // # P6    # MC2-16  ## DAC1_DAT_P7           ## NA
	//output wire  o_B35D_L24N    , // # N5    # MC2-18  ## DAC1_DAT_N7           ## NA
	//
	//input  wire  i_B35_25       , // # L6    # MC2-12  ## CLKD_LD               ## NA
	
	//}
	
	//// external clock ports on B13 //{
	input  wire  sys_clkp,  // # i_B13_L12P_MRCC  # W11 
	input  wire  sys_clkn,  // # i_B13_L12N_MRCC  # W12 
	//}

	//// XADC input on B0 //{
	input  wire  i_XADC_VP, // # L10   VP_0      CONFIG    // # MC1-12  # XADC_VP // external ADC ports 
	input  wire  i_XADC_VN  // # M9    VN_0      CONFIG    // # MC1-10  # XADC_VN // external ADC ports 
	//}

	);


/*parameter common */  //{
	
// TODO: FPGA_IMAGE_ID = h_A6_21_1231   //{
//parameter FPGA_IMAGE_ID = 32'h_BD_21_0310; // PGU-CPU-F5500 // dac pattern gen : dsp maacro test // with XEM7310
//parameter FPGA_IMAGE_ID = 32'h_A4_21_0521; // S3100-PGU // pin map io buf convert from PGU-CPU-F5500 with TXEM7310
//parameter FPGA_IMAGE_ID = 32'h_A4_21_0607; // S3100-PGU // update ENDPOINT map
//parameter FPGA_IMAGE_ID = 32'h_A4_21_0611; // S3100-PGU // activate slave SPI endpoints
//parameter FPGA_IMAGE_ID = 32'h_A4_21_0615; // S3100-PGU // revise LAN and EEPROM endpoints
//parameter FPGA_IMAGE_ID = 32'h_A4_21_0619; // S3100-PGU // update SSPI endpoints
//parameter FPGA_IMAGE_ID = 32'h_A4_21_0628; // S3100-PGU // update SSPI emulation mode : endpoint switch ... LAN, SSPI, SSPI_emulation(MSPI_by_LAN, others_by_SSPI)
//parameter FPGA_IMAGE_ID = 32'h_A4_21_0702; // S3100-PGU // update MSPI endpoint map 
//parameter FPGA_IMAGE_ID = 32'h_A4_21_07A2; // S3100-PGU // debug M2_SPI_TX_EN_SLAVE 
//parameter FPGA_IMAGE_ID = 32'h_A4_21_0723; // S3100-PGU // revise MSPI timing
//parameter FPGA_IMAGE_ID = 32'h_A4_21_0728; // S3100-PGU // revise slave SPI trig out level detect
//parameter FPGA_IMAGE_ID = 32'h_A6_21_0813; // S3100-ADDA // initial setup
//parameter FPGA_IMAGE_ID = 32'h_A6_21_0824; // S3100-ADDA // CMU adc endpoint added
//parameter FPGA_IMAGE_ID = 32'h_A6_21_0907; // S3100-ADDA // revise miso timing control
//parameter FPGA_IMAGE_ID = 32'h_A6_21_0915; // S3100-ADDA // img test adc control
//parameter FPGA_IMAGE_ID = 32'h_A6_21_0923; // S3100-ADDA // adc timing revision 
//parameter FPGA_IMAGE_ID = 32'h_A6_21_0924; // S3100-ADDA // adc/eeprom fifo timing debug
//parameter FPGA_IMAGE_ID = 32'h_A6_21_0928; // S3100-ADDA // rev adc fifo read latency one with fifo FWFT.
//parameter FPGA_IMAGE_ID = 32'h_A6_21_1001; // S3100-ADDA // rev adc data line swap fixed
//parameter FPGA_IMAGE_ID = 32'h_A6_21_1006; // S3100-ADDA // add pattern gen linked adc-upate
//parameter FPGA_IMAGE_ID = 32'h_A6_21_1008; // S3100-ADDA // adc base freq test 210MHz --> 189MHz
//parameter FPGA_IMAGE_ID = 32'h_A6_21_1019; // S3100-ADDA // adc base freq support 210MHz, 189MHz; fifo for 63MHz.
//parameter FPGA_IMAGE_ID = 32'h_A6_21_1126; // S3100-ADDA // rev SSPI control for disabling LAN EP
//parameter FPGA_IMAGE_ID = 32'h_A6_21_1127; // S3100-ADDA // rev hsadc reset and enable to hole parameter setting.
//parameter FPGA_IMAGE_ID = 32'h_A6_21_1129; // S3100-ADDA // rev ADC ready control 
//parameter FPGA_IMAGE_ID = 32'h_A6_21_1201; // S3100-CMU-ADDA // new pinmap
//parameter FPGA_IMAGE_ID = 32'h_A6_21_1214; // S3100-CMU-ADDA // dac output retiming // DAC1 pin map revision
parameter FPGA_IMAGE_ID = 32'h_A6_21_1231; // S3100-CMU-ADDA // MSPI fifo frame trigger added // in revision

//}


//}


///TODO: //-------------------------------------------------------//


/* TODO: IO BUF assignment */ //{


//// BANK B14 IOBUF //{

// NA

//}


//// BANK B15 IOBUF //{

//// TP ...
wire [7:0] o_TP_tri = 8'b1;  wire [7:0] o_TP = 8'b0;  wire [7:0] i_TP; // 
IOBUF iobuf__TP0__inst(.IO( io_B15_L1P_AD0P  ), .T(o_TP_tri[0]), .I(o_TP[0] ), .O(i_TP[0] ) ); //
IOBUF iobuf__TP1__inst(.IO( io_B15_L1N_AD0N  ), .T(o_TP_tri[1]), .I(o_TP[1] ), .O(i_TP[1] ) ); //
IOBUF iobuf__TP2__inst(.IO( io_B15_L2P_AD8P  ), .T(o_TP_tri[2]), .I(o_TP[2] ), .O(i_TP[2] ) ); //
IOBUF iobuf__TP3__inst(.IO( io_B15_L2N_AD8N  ), .T(o_TP_tri[3]), .I(o_TP[3] ), .O(i_TP[3] ) ); //
IOBUF iobuf__TP4__inst(.IO( io_B15_L3P_AD1P  ), .T(o_TP_tri[4]), .I(o_TP[4] ), .O(i_TP[4] ) ); //
IOBUF iobuf__TP5__inst(.IO( io_B15_L3N_AD1N  ), .T(o_TP_tri[5]), .I(o_TP[5] ), .O(i_TP[5] ) ); //
IOBUF iobuf__TP6__inst(.IO( io_B15_L5P_AD9P  ), .T(o_TP_tri[6]), .I(o_TP[6] ), .O(i_TP[6] ) ); //
IOBUF iobuf__TP7__inst(.IO( io_B15_L5N_AD9N  ), .T(o_TP_tri[7]), .I(o_TP[7] ), .O(i_TP[7] ) ); //

//// ADC
//  i_B15D_L7P       ## i_ADC1_DA_P  
//  i_B15D_L7N       ## i_ADC1_DA_N  
//  i_B15D_L8P       ## i_ADC1_DB_P  
//  i_B15D_L8N       ## i_ADC1_DB_N  
//  c_B15D_L12P_MRCC ## i_ADC1_DCO_P 
//  c_B15D_L12N_MRCC ## i_ADC1_DCO_N 
//  c_B15D_L13P_MRCC ## i_ADC0_DCO_P 
//  c_B15D_L13N_MRCC ## i_ADC0_DCO_N 
//  i_B15D_L17P      ## i_ADC0_DA_P  
//  i_B15D_L17N      ## i_ADC0_DA_N  
//  i_B15D_L18P      ## i_ADC0_DB_P  
//  i_B15D_L18N      ## i_ADC0_DB_N  
//  o_B15D_L15P      ## o_ADCx_CNV_P 
//  o_B15D_L15N      ## o_ADCx_CNV_N 
//  o_B15D_L9P       ## o_ADCx_CLK_P 
//  o_B15D_L9N       ## o_ADCx_CLK_N 
//  o_B15_25         ## o_ADCx_TPT_B

wire   ADC0_DCO;
wire c_ADC0_DCO;
IBUFDS ibufds_ADC0_DCO_inst (.I(c_B15D_L13P_MRCC), .IB(c_B15D_L13N_MRCC), .O(c_ADC0_DCO) );
BUFG     bufg_ADC0_DCO_inst (.I(c_ADC0_DCO), .O(ADC0_DCO) ); 

wire   ADC1_DCO;
wire c_ADC1_DCO;
IBUFDS ibufds_ADC1_DCO_inst (.I(c_B15D_L12P_MRCC), .IB(c_B15D_L12N_MRCC), .O(c_ADC1_DCO) );
BUFG     bufg_ADC1_DCO_inst (.I(c_ADC1_DCO), .O(ADC1_DCO) ); 

wire ADC0_DA;
wire ADC0_DB;
IBUFDS ibufds_ADC0_DA_inst  (.I(i_B15D_L17P), .IB(i_B15D_L17N), .O(ADC0_DA) );
IBUFDS ibufds_ADC0_DB_inst  (.I(i_B15D_L18P), .IB(i_B15D_L18N), .O(ADC0_DB) );

wire ADC1_DA;
wire ADC1_DB;
IBUFDS ibufds_ADC1_DA_inst (.I(i_B15D_L7P ), .IB(i_B15D_L7N ), .O(ADC1_DA) );
IBUFDS ibufds_ADC1_DB_inst (.I(i_B15D_L8P ), .IB(i_B15D_L8N ), .O(ADC1_DB) );

wire ADCx_CNV ;
wire ADCx_CLK ;
OBUFDS obufds_ADCx_CNV_inst (.O(o_B15D_L15P ), .OB(o_B15D_L15N), .I(ADCx_CNV)	); //
OBUFDS obufds_ADCx_CLK_inst (.O(o_B15D_L9P  ), .OB(o_B15D_L9N ), .I(ADCx_CLK)	); //

wire ADCx_TPT_B;
OBUF obuf_ADCx_TPT_B_inst   (.O(o_B15_25    ), .I(ADCx_TPT_B   ) ); // 



//// MEM_SIO or EEPROM LAN
// io_B15_L20P      ## io_SCIO_0  // for LAN EEPROM // MEM_SIO
// io_B15_L20N      ## io_SCIO_1  // for LAN EEPROM // reserved
wire  MEM_SIO_out; wire  MEM_SIO_tri; wire  MEM_SIO_in; // high-Z control style ports 
IOBUF iobuf_MEM_SIO_inst  (.IO(io_B15_L20P  ), .T(MEM_SIO_tri), .I(MEM_SIO_out ), .O(MEM_SIO_in ) ); //


//// LAN IF
//  o_B15_L21P      ## o_LAN_PWDN
//  i_B15_L21N      ## i_LAN_INT_B
//  i_B15_L22P      ## i_LAN_MISO
//  o_B15_L22N      ## o_LAN_RST_B
//  o_B15_L23P      ## o_LAN_SSAUX_B
//  o_B15_L23N      ## o_LAN_SSN_B
//  o_B15_L24P      ## o_LAN_MOSI
//  o_B15_L24N      ## o_LAN_SCLK
wire  o_LAN_PWDN     = 1'b0; // unused // fixed
wire  o_LAN_SSAUX_B  = 1'b1; // unused // fixed
wire  o_LAN_MOSI  ; // PT_FMOD_EP_LAN_MOSI ; 
wire  o_LAN_SCLK  ; // PT_FMOD_EP_LAN_SCLK ; 
wire  o_LAN_SSN_B ; // PT_FMOD_EP_LAN_CS_B ; 
wire  i_LAN_INT_B ; // PT_FMOD_EP_LAN_INT_B;
wire  o_LAN_RST_B ; // PT_FMOD_EP_LAN_RST_B; 
wire  i_LAN_MISO  ; // PT_FMOD_EP_LAN_MISO ;
OBUF obuf__LAN_PWDN_____inst (.O( o_B15_L21P ), .I( o_LAN_PWDN     ) ); // 
OBUF obuf__LAN_SSAUX_B__inst (.O( o_B15_L23P ), .I( o_LAN_SSAUX_B  ) ); // 
OBUF obuf__EP_LAN_MOSI__inst (.O( o_B15_L24P ), .I( o_LAN_MOSI     ) ); // PT_FMOD_EP_LAN_MOSI 
OBUF obuf__EP_LAN_SCLK__inst (.O( o_B15_L24N ), .I( o_LAN_SCLK     ) ); // PT_FMOD_EP_LAN_SCLK 
OBUF obuf__EP_LAN_CS_B__inst (.O( o_B15_L23N ), .I( o_LAN_SSN_B    ) ); // PT_FMOD_EP_LAN_CS_B 
IBUF ibuf__EP_LAN_INT_B_inst (.I( i_B15_L21N ), .O( i_LAN_INT_B    ) ); // PT_FMOD_EP_LAN_INT_B
OBUF obuf__EP_LAN_RST_B_inst (.O( o_B15_L22N ), .I( o_LAN_RST_B    ) ); // PT_FMOD_EP_LAN_RST_B
IBUF ibuf__EP_LAN_MISO__inst (.I( i_B15_L22P ), .O( i_LAN_MISO     ) ); // PT_FMOD_EP_LAN_MISO 


//// ADC on FPGA
//	input  wire  i_B15_L10P, // # H20    AUX_AD11P
//	input  wire  i_B15_L10N, // # G20    AUX_AD11N

//}


//// BANK B16 IOBUF //{

//// LED 
wire [7:0] led;
wire [7:0] o_F_LED_tri = led;  wire [7:0] o_F_LED = 8'b0;  wire [7:0] i_F_LED; // 
IOBUF iobuf__F_LED4__inst(.IO( io_B16_L7P   ), .T(o_F_LED_tri[4]), .I(o_F_LED[4] ), .O(i_F_LED[4] ) ); //
IOBUF iobuf__F_LED6__inst(.IO( io_B16_L7N   ), .T(o_F_LED_tri[6]), .I(o_F_LED[6] ), .O(i_F_LED[6] ) ); //
IOBUF iobuf__F_LED1__inst(.IO( io_B16_L8N   ), .T(o_F_LED_tri[1]), .I(o_F_LED[1] ), .O(i_F_LED[1] ) ); //
IOBUF iobuf__F_LED3__inst(.IO( io_B16_L9P   ), .T(o_F_LED_tri[3]), .I(o_F_LED[3] ), .O(i_F_LED[3] ) ); //
IOBUF iobuf__F_LED5__inst(.IO( io_B16_L9N   ), .T(o_F_LED_tri[5]), .I(o_F_LED[5] ), .O(i_F_LED[5] ) ); //
IOBUF iobuf__F_LED0__inst(.IO( io_B16_L10P  ), .T(o_F_LED_tri[0]), .I(o_F_LED[0] ), .O(i_F_LED[0] ) ); //
IOBUF iobuf__F_LED2__inst(.IO( io_B16_L10N  ), .T(o_F_LED_tri[2]), .I(o_F_LED[2] ), .O(i_F_LED[2] ) ); //
IOBUF iobuf__F_LED7__inst(.IO( io_B16_L11P  ), .T(o_F_LED_tri[7]), .I(o_F_LED[7] ), .O(i_F_LED[7] ) ); //

//// GPIO
wire [7:0] i_GPIO; // reserved
//  i_B16_L1P  ## i_GPIO_0
//  i_B16_L1N  ## i_GPIO_1
//  i_B16_L2P  ## i_GPIO_2
//  i_B16_L2N  ## i_GPIO_3
//  i_B16_L3P  ## i_GPIO_4
//  i_B16_L3N  ## i_GPIO_5
//  i_B16_L4P  ## i_GPIO_6
//  i_B16_L4N  ## i_GPIO_7
IBUF ibuf__GPIO0__inst(.I( i_B16_L1P  ), .O(i_GPIO[0] ) ); //
IBUF ibuf__GPIO1__inst(.I( i_B16_L1N  ), .O(i_GPIO[1] ) ); //
IBUF ibuf__GPIO2__inst(.I( i_B16_L2P  ), .O(i_GPIO[2] ) ); //
IBUF ibuf__GPIO3__inst(.I( i_B16_L2N  ), .O(i_GPIO[3] ) ); //
IBUF ibuf__GPIO4__inst(.I( i_B16_L3P  ), .O(i_GPIO[4] ) ); //
IBUF ibuf__GPIO5__inst(.I( i_B16_L3N  ), .O(i_GPIO[5] ) ); //
IBUF ibuf__GPIO6__inst(.I( i_B16_L4P  ), .O(i_GPIO[6] ) ); //
IBUF ibuf__GPIO7__inst(.I( i_B16_L4N  ), .O(i_GPIO[7] ) ); //


//// SLOT_ID
//  i_B16_L5P  ## i_SLOT_ID_0
//  i_B16_L5N  ## i_SLOT_ID_1
//  i_B16_L6P  ## i_SLOT_ID_2
//  i_B16_L6N  ## i_SLOT_ID_3
wire  i_SLOT_ID_0 ;
wire  i_SLOT_ID_1 ;
wire  i_SLOT_ID_2 ;
wire  i_SLOT_ID_3 ; //{
IBUF ibuf__SLOT_ID_0__inst( .I( i_B16_L5P ), .O( i_SLOT_ID_0 ) );
IBUF ibuf__SLOT_ID_1__inst( .I( i_B16_L5N ), .O( i_SLOT_ID_1 ) );
IBUF ibuf__SLOT_ID_2__inst( .I( i_B16_L6P ), .O( i_SLOT_ID_2 ) );
IBUF ibuf__SLOT_ID_3__inst( .I( i_B16_L6N ), .O( i_SLOT_ID_3 ) );
//}
(* keep = "true" *) wire [3:0] w_MTH_SLOT_ID;
assign w_MTH_SLOT_ID    = {i_SLOT_ID_3, i_SLOT_ID_2, i_SLOT_ID_1, i_SLOT_ID_0};


//// board class ID
//  i_B16_L23P ## i_ID_3
//  i_B16_L23N ## i_ID_2
//  i_B16_L24P ## i_ID_1
//  i_B16_L24N ## i_ID_0
(* keep = "true" *) wire  i_ID_3           ;
(* keep = "true" *) wire  i_ID_2           ;
(* keep = "true" *) wire  i_ID_1           ;
(* keep = "true" *) wire  i_ID_0           ; //{
IBUF ibuf__ID_3__inst(.I( i_B16_L23P ), .O( i_ID_3 ) );
IBUF ibuf__ID_2__inst(.I( i_B16_L23N ), .O( i_ID_2 ) );
IBUF ibuf__ID_1__inst(.I( i_B16_L24P ), .O( i_ID_1 ) );
IBUF ibuf__ID_0__inst(.I( i_B16_L24N ), .O( i_ID_0 ) );
//}
(* keep = "true" *) wire [3:0] w_board_class_ID;
assign w_board_class_ID    = {     i_ID_3,      i_ID_2,      i_ID_1,      i_ID_0};


//// MTH SPI 
//  i_B16_L16P  ## i_M2_SPI_CS_BUF
//  i_B16_L16N  ## i_M2_SPI_MOSI
//  i_B16_L21P  ## i_M2_SPI_TX_CLK
//  o_B16_L19N  ## o_M2_SPI_MISO_B
//  o_B16_L17N  ## o_M2_SPI_RX_CLK_B
//  o_B16_L21N  ## o_M2_SPI_RX_EN_SLAVE
//  o_B16_L17P  ## o_M2_SPI_TX_EN_SLAVE
wire  i_M2_SPI_CS_BUF      ; // i
wire  i_M2_SPI_MOSI        ; // i
wire  i_M2_SPI_TX_CLK      ; // i
wire  o_M2_SPI_MISO_B      ; // o
wire  o_M2_SPI_RX_CLK_B    ; // o
wire  o_M2_SPI_RX_EN_SLAVE ; // o
wire  o_M2_SPI_TX_EN_SLAVE ; // o
IBUF ibuf__M2_SPI_CS_BUF_______inst (.I( i_B16_L16P ), .O( i_M2_SPI_CS_BUF      ) ); //
IBUF ibuf__M2_SPI_MOSI_________inst (.I( i_B16_L16N ), .O( i_M2_SPI_MOSI        ) ); //
IBUF ibuf__M2_SPI_TX_CLK_______inst (.I( i_B16_L21P ), .O( i_M2_SPI_TX_CLK      ) ); //
OBUF ibuf__M2_SPI_MISO_B_______inst (.O( o_B16_L19N ), .I( o_M2_SPI_MISO_B      ) ); //
OBUF ibuf__M2_SPI_RX_CLK_B_____inst (.O( o_B16_L17N ), .I( o_M2_SPI_RX_CLK_B    ) ); //
OBUF obuf__M2_SPI_RX_EN_SLAVE__inst (.O( o_B16_L21N ), .I( o_M2_SPI_RX_EN_SLAVE ) ); // 
OBUF obuf__M2_SPI_TX_EN_SLAVE__inst (.O( o_B16_L17P ), .I( o_M2_SPI_TX_EN_SLAVE ) ); // 
//
wire  o_M2_SPI_MISO        ; assign  o_M2_SPI_MISO_B   = ~o_M2_SPI_MISO   ;
wire  o_M2_SPI_RX_CLK      ; assign  o_M2_SPI_RX_CLK_B = ~o_M2_SPI_RX_CLK ;

//// SPIO
//  o_B16_L20P  ## o_SPIOx_SCLK
//  o_B16_L20N  ## o_SPIO1_CS
//  i_B16_L22P  ## i_SPIOx_MISO
//  o_B16_L22N  ## o_SPIOx_MOSI
wire o_SPIOx_SCLK ; 
wire o_SPIO0_CS   ; // removed in S3100
wire o_SPIO1_CS   ; 
wire i_SPIOx_MISO ; 
wire o_SPIOx_MOSI ; 
OBUF obuf_SPIOx_SCLK_inst (.O( o_B16_L20P ), .I(o_SPIOx_SCLK          ) ); 
OBUF obuf_SPIO1_CS_inst   (.O( o_B16_L20N ), .I(o_SPIO1_CS | o_SPIO0_CS ) ); // share
IBUF ibuf_SPIOx_MISO_inst (.I( i_B16_L22P ), .O(i_SPIOx_MISO          ) );
OBUF obuf_SPIOx_MOSI_inst (.O( o_B16_L22N ), .I(o_SPIOx_MOSI          ) ); 


//// S_IO  // reserved
// io_B16_L12P  ## io_S_IO_0 // U59,  11AA160T-I/TT/SOT-23-3
// io_B16_L18P  ## io_S_IO_1 // U62,  MAX6576ZUT+T/SOT23-6
// io_B13_0_    ## io_S_IO_2 // U98,  MAX6576ZUT+T/SOT23-6
// io_B16_L13P  ## io_S_IO_3 // U167, 11AA160T-I/TT/SOT-23-3
// io_B16_L14P  ## io_S_IO_4 // U168, 11AA160T-I/TT/SOT-23-3
// io_B16_L15P  ## io_S_IO_5 // U169, 11AA160T-I/TT/SOT-23-3
wire S_IO_0_tri = 1'b1;  wire S_IO_0_wr = 1'b0;  wire S_IO_0_rd; //$$ not activated
wire S_IO_1_tri = 1'b1;  wire S_IO_1_wr = 1'b0;  wire S_IO_1_rd; //$$ not activated
wire S_IO_2_tri = 1'b1;  wire S_IO_2_wr = 1'b0;  wire S_IO_2_rd; //$$ not activated
wire S_IO_3_tri = 1'b1;  wire S_IO_3_wr = 1'b0;  wire S_IO_3_rd; //$$ not activated
wire S_IO_4_tri = 1'b1;  wire S_IO_4_wr = 1'b0;  wire S_IO_4_rd; //$$ not activated
wire S_IO_5_tri = 1'b1;  wire S_IO_5_wr = 1'b0;  wire S_IO_5_rd; //$$ not activated
IOBUF iobuf_S_IO_0_inst (.IO( io_B16_L12P ), .T(S_IO_0_tri), .I(S_IO_0_wr), .O(S_IO_0_rd) ); //
IOBUF iobuf_S_IO_1_inst (.IO( io_B16_L18P ), .T(S_IO_1_tri), .I(S_IO_1_wr), .O(S_IO_1_rd) ); //
IOBUF iobuf_S_IO_2_inst (.IO( io_B13_0_   ), .T(S_IO_2_tri), .I(S_IO_2_wr), .O(S_IO_2_rd) ); //
IOBUF iobuf_S_IO_3_inst (.IO( io_B16_L13P ), .T(S_IO_3_tri), .I(S_IO_3_wr), .O(S_IO_3_rd) ); //
IOBUF iobuf_S_IO_4_inst (.IO( io_B16_L14P ), .T(S_IO_4_tri), .I(S_IO_4_wr), .O(S_IO_4_rd) ); //
IOBUF iobuf_S_IO_5_inst (.IO( io_B16_L15P ), .T(S_IO_5_tri), .I(S_IO_5_wr), .O(S_IO_5_rd) ); //


//}


//// BANK B13 IOBUF //{


//// CLKD
//  i_B13_L1N        ## i_CLKD_LD
//  i_B13_L2P        ## i_CLKD_STAT
//  o_B13_L2N        ## o_CLKD_SYNC
//  o_B13_L3P        ## o_CLKD_RST_B
// io_B13_L3N        ## io_CLKD_SDIO
//  o_B13_L4P        ## o_CLKD_SCLK
//  i_B13_L4N        ## i_CLKD_REFM
//  i_B13_L5P        ## i_CLKD_SDO
//  o_B13_L5N        ## o_CLKD_CS_B
//  c_B13D_L13P_MRCC ## i_CLKD_COUT_P
//  c_B13D_L13N_MRCC ## i_CLKD_COUT_N

wire   CLKD_COUT; wire c_CLKD_COUT;
IBUFDS ibufds_CLKD_COUT_inst (.I(c_B13D_L13P_MRCC), .IB(c_B13D_L13N_MRCC), .O(c_CLKD_COUT) );
BUFG     bufg_CLKD_COUT_inst (.I(c_CLKD_COUT), .O(CLKD_COUT) ); //$$ use BUFG

wire o_CLKD_SYNC = 1'b0; // reserved
wire o_CLKD_RST_B;
wire i_CLKD_LD   ;
wire i_CLKD_STAT ;
wire i_CLKD_REFM ;
OBUF obuf_CLKD_SYNC_inst  (.O(o_B13_L2N   ), .I(o_CLKD_SYNC  ) ); // 
OBUF obuf_CLKD_RST_B_inst (.O(o_B13_L3P   ), .I(o_CLKD_RST_B ) ); // 
IBUF ibuf_CLKD_LD_inst    (.I(i_B13_L1N   ), .O(i_CLKD_LD    ) ); //
IBUF ibuf_CLKD_STAT_inst  (.I(i_B13_L2P   ), .O(i_CLKD_STAT  ) ); //
IBUF ibuf_CLKD_REFM_inst  (.I(i_B13_L4N   ), .O(i_CLKD_REFM  ) ); //
//
wire o_CLKD_SCLK    ;
wire o_CLKD_CS_B    ;
wire i_CLKD_SDO     ; // read for 4-wire SPI
//
wire CLKD_SDIO_wr ; // open-drain write for AD9516-1
wire CLKD_SDIO_rd ; // test read // reserved
//
OBUF   obuf_CLKD_SCLK_inst ( .O( o_B13_L4P  ), .I(o_CLKD_SCLK ) ); // 
OBUF   obuf_CLKD_CS_B_inst ( .O( o_B13_L5N  ), .I(o_CLKD_CS_B ) ); // 
IBUF   ibuf_CLKD_SDO__inst ( .I( i_B13_L5P  ), .O(i_CLKD_SDO  ) ); //
IOBUF iobuf_CLKD_SDIO_inst (.IO(io_B13_L3N  ), .T(CLKD_SDIO_wr), .I(CLKD_SDIO_wr ), .O(CLKD_SDIO_rd ) ); //


//// TRIG
//  o_B13_L6P       ## o_TRIG_OUT_P
//  o_B13_L6N       ## o_TRIG_OUT_N
//  i_B13D_L14P_SRCC ## i_TRIG_IN_P  
//  i_B13D_L14N_SRCC ## i_TRIG_IN_N  

//wire   TRIG_OUT;
//OBUFDS obufds_TRIG_OUT_inst (.O(o_B13_L6P), .OB(o_B13_L6N), .I(TRIG_OUT)	); // LVDS_25 //$$ NG
wire o_TRIG_OUT_P; // o
wire o_TRIG_OUT_N; // o
OBUF obuf_TRIG_OUT_P_inst (.O(o_B13_L6P       ), .I( o_TRIG_OUT_P ) );  // LVCMOS25
OBUF obuf_TRIG_OUT_N_inst (.O(o_B13_L6N       ), .I( o_TRIG_OUT_N ) );  // LVCMOS25

wire   i_TRIG_IN; // reserved
IBUFDS ibufds_TRIG_IN_inst  (.I(i_B13D_L14P_SRCC), .IB(i_B13D_L14N_SRCC), .O(i_TRIG_IN) );


//// DACx
//  o_B13_L7N  ## o_DACx_RST_B
//  o_B13_L8P  ## o_DAC0_CS
//  o_B13_L7P  ## o_DAC1_CS
//  o_B13_L9N  ## o_DACx_SCLK
//  o_B13_L9P  ## o_DACx_SDIO
//  i_B13_L8N  ## i_DACx_SDO
	
wire o_DACx_RST_B ; 
wire o_DAC0_CS    ; 
wire o_DAC1_CS    ; 
wire o_DACx_SCLK  ; 
wire o_DACx_SDIO  ; 
wire i_DACx_SDO   ; 
OBUF obuf_DACx_RST_B_inst (.O( o_B13_L7N ), .I( o_DACx_RST_B ) ); // 
OBUF obuf_DAC0_CS_inst    (.O( o_B13_L8P ), .I( o_DAC0_CS    ) ); // 
OBUF obuf_DAC1_CS_inst    (.O( o_B13_L7P ), .I( o_DAC1_CS    ) ); // 
OBUF obuf_DACx_SCLK_inst  (.O( o_B13_L9N ), .I( o_DACx_SCLK  ) ); // 
OBUF obuf_DACx_SDIO_inst  (.O( o_B13_L9P ), .I( o_DACx_SDIO  ) ); // 
IBUF ibuf_DACx_SDO_inst   (.I( i_B13_L8N ), .O( i_DACx_SDO   ) ); //

//}

//// BANK B35 IOBUF //{

//// DAC0

//  o_B35D_L19P        ## o_DAC0_DAT_P15      ///  o_B35D_L19N        ## o_DAC0_DAT_N15
//  o_B35D_L18P        ## o_DAC0_DAT_P14      ///  o_B35D_L18N        ## o_DAC0_DAT_N14
//  o_B35D_L14P_SRCC   ## o_DAC0_DAT_P13      ///  o_B35D_L14N_SRCC   ## o_DAC0_DAT_N13
//  o_B35D_L13P_MRCC   ## o_DAC0_DAT_P12      ///  o_B35D_L13N_MRCC   ## o_DAC0_DAT_N12
//  o_B35D_L20P        ## o_DAC0_DAT_P11      ///  o_B35D_L20N        ## o_DAC0_DAT_N11
//  o_B35D_L22P        ## o_DAC0_DAT_P10      ///  o_B35D_L22N        ## o_DAC0_DAT_N10
//  o_B35D_L16P        ## o_DAC0_DAT_P9       ///  o_B35D_L16N        ## o_DAC0_DAT_N9
//  o_B35D_L15P        ## o_DAC0_DAT_P8       ///  o_B35D_L15N        ## o_DAC0_DAT_N8
//  o_B35D_L9P         ## o_DAC0_DAT_P7       ///  o_B35D_L9N         ## o_DAC0_DAT_N7
//  o_B35D_L7P         ## o_DAC0_DAT_P6       ///  o_B35D_L7N         ## o_DAC0_DAT_N6
//  o_B35D_L8P         ## o_DAC0_DAT_P5       ///  o_B35D_L8N         ## o_DAC0_DAT_N5
//  o_B35D_L5P         ## o_DAC0_DAT_P4       ///  o_B35D_L5N         ## o_DAC0_DAT_N4
//  o_B35D_L4P         ## o_DAC0_DAT_P3       ///  o_B35D_L4N         ## o_DAC0_DAT_N3
//  o_B35D_L3P         ## o_DAC0_DAT_P2       ///  o_B35D_L3N         ## o_DAC0_DAT_N2
//  o_B35D_L2P         ## o_DAC0_DAT_P1       ///  o_B35D_L2N         ## o_DAC0_DAT_N1
//  o_B35D_L1P         ## o_DAC0_DAT_P0       ///  o_B35D_L1N         ## o_DAC0_DAT_N0
//  o_B35D_L11P_SRCC   ## o_DAC0_DCI_P        ///  o_B35D_L11N_SRCC   ## o_DAC0_DCI_N
//  c_B35D_L12P_MRCC   ## c_DAC0_DCO_P        ///  c_B35D_L12N_MRCC   ## c_DAC0_DCO_N

(* keep = "true" *) wire [15:0] DAC0_DAT; 

// IOB consideration - PN swap //{
wire        w_DAC0_DAT__IOB_clk;
wire        w_DAC0_DAT__IOB_rst_n;
wire [15:0] w_DAC0_DAT__IOB_in ;
wire [15:0] w_DAC0_DAT__IOB_out;

sub_buf_16b  sub_buf_16b__DAC0__inst (
	.clk      (w_DAC0_DAT__IOB_clk  ),
	.reset_n  (w_DAC0_DAT__IOB_rst_n),
	//
	.i_buf    (w_DAC0_DAT__IOB_in ), // [15:0]
	.o_buf    (w_DAC0_DAT__IOB_out)  // [15:0]
	);

assign w_DAC0_DAT__IOB_in[15] =  DAC0_DAT[15]; 
assign w_DAC0_DAT__IOB_in[14] =  DAC0_DAT[14]; 
assign w_DAC0_DAT__IOB_in[13] =  DAC0_DAT[13]; 
assign w_DAC0_DAT__IOB_in[12] =  DAC0_DAT[12]; 
assign w_DAC0_DAT__IOB_in[11] =  DAC0_DAT[11]; 
assign w_DAC0_DAT__IOB_in[10] =  DAC0_DAT[10]; 
assign w_DAC0_DAT__IOB_in[9 ] =  DAC0_DAT[9 ]; 
assign w_DAC0_DAT__IOB_in[8 ] =  DAC0_DAT[8 ]; 
assign w_DAC0_DAT__IOB_in[7 ] =  DAC0_DAT[7 ];
assign w_DAC0_DAT__IOB_in[6 ] =  DAC0_DAT[6 ];
assign w_DAC0_DAT__IOB_in[5 ] =  DAC0_DAT[5 ];
assign w_DAC0_DAT__IOB_in[4 ] =  DAC0_DAT[4 ];
assign w_DAC0_DAT__IOB_in[3 ] =  DAC0_DAT[3 ];
assign w_DAC0_DAT__IOB_in[2 ] =  DAC0_DAT[2 ];
assign w_DAC0_DAT__IOB_in[1 ] =  DAC0_DAT[1 ];
assign w_DAC0_DAT__IOB_in[0 ] =  DAC0_DAT[0 ];

//}

OBUFDS obufds_DAC0_DAT15_inst 	(.O( o_B35D_L19P      ), .OB( o_B35D_L19N      ), .I(w_DAC0_DAT__IOB_out[15])	);
OBUFDS obufds_DAC0_DAT14_inst 	(.O( o_B35D_L18P      ), .OB( o_B35D_L18N      ), .I(w_DAC0_DAT__IOB_out[14])	);
OBUFDS obufds_DAC0_DAT13_inst 	(.O( o_B35D_L14P_SRCC ), .OB( o_B35D_L14N_SRCC ), .I(w_DAC0_DAT__IOB_out[13])	);
OBUFDS obufds_DAC0_DAT12_inst 	(.O( o_B35D_L13P_MRCC ), .OB( o_B35D_L13N_MRCC ), .I(w_DAC0_DAT__IOB_out[12])	);
OBUFDS obufds_DAC0_DAT11_inst 	(.O( o_B35D_L20P      ), .OB( o_B35D_L20N      ), .I(w_DAC0_DAT__IOB_out[11])	);
OBUFDS obufds_DAC0_DAT10_inst 	(.O( o_B35D_L22P      ), .OB( o_B35D_L22N      ), .I(w_DAC0_DAT__IOB_out[10])	);
OBUFDS obufds_DAC0_DAT9__inst 	(.O( o_B35D_L16P      ), .OB( o_B35D_L16N      ), .I(w_DAC0_DAT__IOB_out[9 ])	);
OBUFDS obufds_DAC0_DAT8__inst 	(.O( o_B35D_L15P      ), .OB( o_B35D_L15N      ), .I(w_DAC0_DAT__IOB_out[8 ])	);
OBUFDS obufds_DAC0_DAT7__inst 	(.O( o_B35D_L9P       ), .OB( o_B35D_L9N       ), .I(w_DAC0_DAT__IOB_out[7 ])	);
OBUFDS obufds_DAC0_DAT6__inst 	(.O( o_B35D_L7P       ), .OB( o_B35D_L7N       ), .I(w_DAC0_DAT__IOB_out[6 ])	);
OBUFDS obufds_DAC0_DAT5__inst 	(.O( o_B35D_L8P       ), .OB( o_B35D_L8N       ), .I(w_DAC0_DAT__IOB_out[5 ])	);
OBUFDS obufds_DAC0_DAT4__inst 	(.O( o_B35D_L5P       ), .OB( o_B35D_L5N       ), .I(w_DAC0_DAT__IOB_out[4 ])	);
OBUFDS obufds_DAC0_DAT3__inst 	(.O( o_B35D_L4P       ), .OB( o_B35D_L4N       ), .I(w_DAC0_DAT__IOB_out[3 ])	);
OBUFDS obufds_DAC0_DAT2__inst 	(.O( o_B35D_L3P       ), .OB( o_B35D_L3N       ), .I(w_DAC0_DAT__IOB_out[2 ])	);
OBUFDS obufds_DAC0_DAT1__inst 	(.O( o_B35D_L2P       ), .OB( o_B35D_L2N       ), .I(w_DAC0_DAT__IOB_out[1 ])	);
OBUFDS obufds_DAC0_DAT0__inst 	(.O( o_B35D_L1P       ), .OB( o_B35D_L1N       ), .I(w_DAC0_DAT__IOB_out[0 ])	);
//                                                           
wire          DAC0_DCI;                                      
OBUFDS obufds_DAC0_DCI_inst 	(.O(o_B35D_L11P_SRCC), .OB(o_B35D_L11N_SRCC), .I( DAC0_DCI)	); //
//
wire          DAC0_DCO;  wire        c_DAC0_DCO; // not used
IBUFDS ibufds_DAC0_DCO_inst 	(.I(c_B35D_L12P_MRCC), .IB(c_B35D_L12N_MRCC), .O(c_DAC0_DCO) );
BUFG     bufg_DAC0_DCO_inst 	(.I(c_DAC0_DCO), .O(DAC0_DCO) ); 




//}

//// BANK B34 IOBUF //{

//// DAC1 
//  o_B34D_L24P       ## o_DAC1_DAT_P15          ///  o_B34D_L24N       ## o_DAC1_DAT_N15
//  o_B34D_L23P       ## o_DAC1_DAT_P14          ///  o_B34D_L23N       ## o_DAC1_DAT_N14
//  o_B34D_L18P       ## o_DAC1_DAT_P13          ///  o_B34D_L18N       ## o_DAC1_DAT_N13
//  o_B34D_L15P       ## o_DAC1_DAT_P12          ///  o_B34D_L15N       ## o_DAC1_DAT_N12
//  o_B34D_L22P       ## o_DAC1_DAT_P11          ///  o_B34D_L22N       ## o_DAC1_DAT_N11
//  o_B34D_L20P       ## o_DAC1_DAT_P10          ///  o_B34D_L20N       ## o_DAC1_DAT_N10
//  o_B34D_L10P       ## o_DAC1_DAT_P9           ///  o_B34D_L10N       ## o_DAC1_DAT_N9
//  o_B34D_L8P        ## o_DAC1_DAT_P8           ///  o_B34D_L8N        ## o_DAC1_DAT_N8
//  o_B34D_L9P        ## o_DAC1_DAT_N7 // swap   ///  o_B34D_L9N        ## o_DAC1_DAT_P7 // swap
//  o_B34D_L7P        ## o_DAC1_DAT_N6 // swap   ///  o_B34D_L7N        ## o_DAC1_DAT_P6 // swap
//  o_B34D_L4P        ## o_DAC1_DAT_N5 // swap   ///  o_B34D_L4N        ## o_DAC1_DAT_P5 // swap
//  o_B34D_L5P        ## o_DAC1_DAT_N4 // swap   ///  o_B34D_L5N        ## o_DAC1_DAT_P4 // swap
//  o_B34D_L6P        ## o_DAC1_DAT_N3 // swap   ///  o_B34D_L6N        ## o_DAC1_DAT_P3 // swap
//  o_B34D_L2P        ## o_DAC1_DAT_N2 // swap   ///  o_B34D_L2N        ## o_DAC1_DAT_P2 // swap
//  o_B34D_L1P        ## o_DAC1_DAT_N1 // swap   ///  o_B34D_L1N        ## o_DAC1_DAT_P1 // swap
//  o_B34D_L3P        ## o_DAC1_DAT_P0           ///  o_B34D_L3N        ## o_DAC1_DAT_N0
//  c_B34D_L12P_MRCC  ## c_DAC1_DCO_N  // swap   ///  c_B34D_L12N_MRCC  ## c_DAC1_DCO_P  // swap
//  o_B34D_L13P_MRCC  ## o_DAC1_DCI_N  // swap   ///  o_B34D_L13N_MRCC  ## o_DAC1_DCI_P  // swap
(* keep = "true" *) wire [15:0] DAC1_DAT;

// IOB consideration - PN swap //{
wire        w_DAC1_DAT__IOB_clk;
wire        w_DAC1_DAT__IOB_rst_n;
wire [15:0] w_DAC1_DAT__IOB_in ;
wire [15:0] w_DAC1_DAT__IOB_out;

sub_buf_16b  sub_buf_16b__DAC1__inst (
	.clk      (w_DAC1_DAT__IOB_clk  ),
	.reset_n  (w_DAC1_DAT__IOB_rst_n),
	//
	.i_buf    (w_DAC1_DAT__IOB_in ), // [15:0]
	.o_buf    (w_DAC1_DAT__IOB_out)  // [15:0]
	);

assign w_DAC1_DAT__IOB_in[15] =  DAC1_DAT[15];
assign w_DAC1_DAT__IOB_in[14] =  DAC1_DAT[14];
assign w_DAC1_DAT__IOB_in[13] =  DAC1_DAT[13];
assign w_DAC1_DAT__IOB_in[12] =  DAC1_DAT[12];
assign w_DAC1_DAT__IOB_in[11] =  DAC1_DAT[11];
assign w_DAC1_DAT__IOB_in[10] =  DAC1_DAT[10];
assign w_DAC1_DAT__IOB_in[9 ] =  DAC1_DAT[9 ];
assign w_DAC1_DAT__IOB_in[8 ] =  DAC1_DAT[8 ]; 
assign w_DAC1_DAT__IOB_in[7 ] = ~DAC1_DAT[7 ]; // PN swap
assign w_DAC1_DAT__IOB_in[6 ] = ~DAC1_DAT[6 ]; // PN swap
assign w_DAC1_DAT__IOB_in[5 ] = ~DAC1_DAT[5 ]; // PN swap
assign w_DAC1_DAT__IOB_in[4 ] = ~DAC1_DAT[4 ]; // PN swap
assign w_DAC1_DAT__IOB_in[3 ] = ~DAC1_DAT[3 ]; // PN swap
assign w_DAC1_DAT__IOB_in[2 ] = ~DAC1_DAT[2 ]; // PN swap
assign w_DAC1_DAT__IOB_in[1 ] = ~DAC1_DAT[1 ]; // PN swap
assign w_DAC1_DAT__IOB_in[0 ] =  DAC1_DAT[0 ];

//}

OBUFDS obufds_DAC1_DAT14_inst 	(.O( o_B34D_L24P ), .OB( o_B34D_L24N ), .I(w_DAC1_DAT__IOB_out[15])	);
OBUFDS obufds_DAC1_DAT15_inst 	(.O( o_B34D_L23P ), .OB( o_B34D_L23N ), .I(w_DAC1_DAT__IOB_out[14])	);
OBUFDS obufds_DAC1_DAT13_inst 	(.O( o_B34D_L18P ), .OB( o_B34D_L18N ), .I(w_DAC1_DAT__IOB_out[13])	);
OBUFDS obufds_DAC1_DAT12_inst 	(.O( o_B34D_L15P ), .OB( o_B34D_L15N ), .I(w_DAC1_DAT__IOB_out[12])	);
OBUFDS obufds_DAC1_DAT11_inst 	(.O( o_B34D_L22P ), .OB( o_B34D_L22N ), .I(w_DAC1_DAT__IOB_out[11])	);
OBUFDS obufds_DAC1_DAT10_inst 	(.O( o_B34D_L20P ), .OB( o_B34D_L20N ), .I(w_DAC1_DAT__IOB_out[10])	);
OBUFDS obufds_DAC1_DAT9__inst 	(.O( o_B34D_L10P ), .OB( o_B34D_L10N ), .I(w_DAC1_DAT__IOB_out[9 ])	);
OBUFDS obufds_DAC1_DAT8__inst 	(.O( o_B34D_L8P  ), .OB( o_B34D_L8N  ), .I(w_DAC1_DAT__IOB_out[8 ])	);
OBUFDS obufds_DAC1_DAT7__inst 	(.O( o_B34D_L9P  ), .OB( o_B34D_L9N  ), .I(w_DAC1_DAT__IOB_out[7 ])	); 
OBUFDS obufds_DAC1_DAT6__inst 	(.O( o_B34D_L7P  ), .OB( o_B34D_L7N  ), .I(w_DAC1_DAT__IOB_out[6 ])	); 
OBUFDS obufds_DAC1_DAT5__inst 	(.O( o_B34D_L4P  ), .OB( o_B34D_L4N  ), .I(w_DAC1_DAT__IOB_out[5 ])	); 
OBUFDS obufds_DAC1_DAT4__inst 	(.O( o_B34D_L5P  ), .OB( o_B34D_L5N  ), .I(w_DAC1_DAT__IOB_out[4 ])	); 
OBUFDS obufds_DAC1_DAT3__inst 	(.O( o_B34D_L6P  ), .OB( o_B34D_L6N  ), .I(w_DAC1_DAT__IOB_out[3 ])	); 
OBUFDS obufds_DAC1_DAT2__inst 	(.O( o_B34D_L2P  ), .OB( o_B34D_L2N  ), .I(w_DAC1_DAT__IOB_out[2 ])	); 
OBUFDS obufds_DAC1_DAT1__inst 	(.O( o_B34D_L1P  ), .OB( o_B34D_L1N  ), .I(w_DAC1_DAT__IOB_out[1 ])	); 
OBUFDS obufds_DAC1_DAT0__inst 	(.O( o_B34D_L3P  ), .OB( o_B34D_L3N  ), .I(w_DAC1_DAT__IOB_out[0 ])	); 
//
wire          DAC1_DCI ;
OBUFDS obufds_DAC1_DCI_inst 	(.O(o_B34D_L13P_MRCC     ), .OB(o_B34D_L13N_MRCC     ), .I( DAC1_DCI  )	); // PN swap by PLL
//
wire          DAC1_DCO;  wire        c_DAC1_DCO; // not used
IBUFDS ibufds_DAC1_DCO_inst 	(.I(c_B34D_L12P_MRCC), .IB(c_B34D_L12N_MRCC), .O(c_DAC1_DCO) );
BUFG     bufg_DAC1_DCO_inst 	(.I(c_DAC1_DCO), .O(DAC1_DCO) ); // PN swap by PLL 180 degree


//}


//}


///TODO: //-------------------------------------------------------//


/* TODO: clock/pll and reset */ //{

// clock pll0 //{
wire clk_out1_200M ; // REFCLK 200MHz for IDELAYCTRL // for pll1
wire clk_out2_140M ; // for pll2 ... 140M
wire clk_out3_10M  ; // for slow logic / I2C //
wire clk_out4_10M ; // for XADC 
//
wire clk_locked_pre;
clk_wiz_0  clk_wiz_0_inst(
	// MMCM
	// VCO 700MHz
	// Clock out ports  
	.clk_out1_200M (clk_out1_200M ), // BUFG
	.clk_out2_140M (clk_out2_140M ), // BUFG
	// Status and control signals               
	.locked(clk_locked_pre),
	// Clock in ports
	.clk_in1_p(sys_clkp), // diff clock pin
	.clk_in1_n(sys_clkn)
);
////
clk_wiz_0_0_1  clk_wiz_0_0_1_inst(
	// Clock out ports  
	.clk_out1_10M (clk_out3_10M), // BUFGCE // due to soft-startup
	.clk_out2_10M (clk_out4_10M), // BUFGCE // due to soft-startup
	// Status and control signals     
	.resetn(clk_locked_pre),          
	.locked(), // not used
	// Clock in ports
	.clk_in1_200M(clk_out1_200M) // no buf
);

//}

// clock pll1 //{

wire clk1_locked = 1'b1; // unused // to remove

//}

// clock pll2 //{


wire clk2_locked = 1'b1; // unused // to remove



//}

// clock pll3 //{
wire clk3_out1_72M ; // MCS core; IO bridge
wire clk3_out2_144M; // LAN-SPI control 144MHz 
wire clk3_out3_12M ; // slow logic // not used yet
wire clk3_out4_72M ; // eeprom fifo
//
wire clk3_locked;
//
clk_wiz_0_3_1  clk_wiz_0_3_1_inst(
	// Clock out ports  
	.clk_out1_72M (clk3_out1_72M ), // BUFGCE // due to soft-startup 
	.clk_out2_144M(clk3_out2_144M), // BUFGCE // due to soft-startup
	.clk_out3_12M (clk3_out3_12M ), // BUFGCE // due to soft-startup
	.clk_out4_72M (clk3_out4_72M ), // BUFGCE // due to soft-startup 
	// Status and control signals     
	.resetn(clk_locked_pre),          
	.locked(clk3_locked),
	// Clock in ports
	.clk_in1_200M(clk_out1_200M) // no buf
);

//}

// clock pll4 //{

wire clk4_locked = 1'b1; // to remove

//}

// clock pll for DAC 400MHz  //{

// add more clocks for DAC0_DCI DAC1_DCI
//  DCI pin swap info:
//    DAC0_DCI_P/N - pin noraml
//    DAC1_DCI_P/N - pin swap

//$$ note ... 
//    clk_wiz_1 setting : eventually 1:1
//                        output 400MHz --> 200MHz 
//                        input             200MHz
//    input clock from CLKD 400MHz 
//    clk_wiz_1 --> clk_wiz_1_3 removed unused

wire clk_dac_out1_400M; // DAC update rate 
wire clk_dac_out2_400M_0;   // for DAC0_DCI //$$ alternative to DAC0_DCO
wire clk_dac_out3_400M_180; // for DAC1_DCI //$$ alternative to DAC1_DCO
//
wire clk_dac_locked;
wire clk_dac_clk_in; // from  CLKD_COUT or c_B13D_L13P_MRCC // for DAC/CLK 400MHz pll
wire clk_dac_clk_rst;
//

clk_wiz_1_2  clk_wiz_1_2_inst (
	// PLL
	// VCO 800MHz
	// Clock out ports  
	.clk_out1_200M      (clk_dac_out1_400M     ), // BUFGCE // same buf type for phase align 
	.clk_out2_200M_0    (clk_dac_out2_400M_0   ), // BUFGCE // same buf type for phase align
	.clk_out3_200M_180  (clk_dac_out3_400M_180 ), // BUFGCE // same buf type for phase align
	// clock en ports
	.clk_out1_200M_ce     (1'b1),
	.clk_out2_200M_0_ce   (1'b1),
	.clk_out3_200M_180_ce (1'b1),
	// Status and control signals     
	.resetn(clk_locked_pre & ~clk_dac_clk_rst),          
	.locked(clk_dac_locked),
	// Clock in ports
	.clk_in1_200M       (clk_dac_clk_in) // no buf
);


//   
wire dac0_dco_clk_out1_400M; // DAC0 update rate 
//wire dac0_dco_clk_out2_200M; // DAC0 DMA rate     //$$ unused
wire dac0_dco_clk_out5_400M; // DAC0 DCI
wire dac1_dco_clk_out1_400M; // DAC1 update rate 
//wire dac1_dco_clk_out2_200M; // DAC1 DMA rate     //$$ unused
wire dac1_dco_clk_out5_400M; // DAC1 DCI
//
wire dac0_dco_clk_locked;
wire dac0_dco_clk_in;
wire dac0_dco_clk_rst; 
wire dac1_dco_clk_locked;
wire dac1_dco_clk_in;
wire dac1_dco_clk_rst; 
//
wire dac0_clk_dis; // clock disable
wire dac1_clk_dis; // clock disable
//
assign dac0_dco_clk_in = clk_dac_out2_400M_0; // for common clock 
// TODO: must see polarity ... --------////
// note DAC1_DCI and DAC1_DCO are both PN swapped in board 
// note in PGU board... DCI and DAC codes are directly generated from FPGA... in this case, DCO is not necessary.
// in case of DCI coming from external pll, DCO must be used.
assign dac1_dco_clk_in = clk_dac_out3_400M_180; // for common clock //$$ emulation for PN swap of DAC1_DCO
//
//

//$$ for common 
//$$ wire dac0_dco_clk_locked = clk_dac_locked;
//$$ wire dac1_dco_clk_locked = clk_dac_locked;


clk_wiz_1_2  clk_wiz_1_2_0_inst ( // VCO 1200MHz
	// Clock out ports  
	.clk_out1_200M     (dac0_dco_clk_out1_400M), // BUFGCE // //$$ for dac0_clk
	.clk_out2_200M_0   (dac0_dco_clk_out5_400M), // BUFGCE // //$$ for DAC0_DCI
	.clk_out3_200M_180 (),
	// clock en ports
	.clk_out1_200M_ce     (1'b1 & (~dac0_clk_dis) ),
	.clk_out2_200M_0_ce   (1'b1 & (~dac0_clk_dis) ),
	.clk_out3_200M_180_ce (1'b0),
	// Status and control signals            
	.resetn(clk_locked_pre & ~dac0_dco_clk_rst),          
	.locked(dac0_dco_clk_locked),
	// Clock in ports
	.clk_in1_200M      (dac0_dco_clk_in) // no buf
);
//
clk_wiz_1_2  clk_wiz_1_2_1_inst (
	// Clock out ports  
	.clk_out1_200M     (dac1_dco_clk_out5_400M), // BUFGCE // 0 deg for dci same phase with clk in //$$ for DAC1_DCI 
	.clk_out2_200M_0   (),
	.clk_out3_200M_180 (dac1_dco_clk_out1_400M), // BUFGCE // 180 deg for clock in PN swap //$$ for dac1_clk
	// clock en ports
	.clk_out1_200M_ce     (1'b1 & (~dac1_clk_dis) ),
	.clk_out2_200M_0_ce   (1'b0),
	.clk_out3_200M_180_ce (1'b1 & (~dac1_clk_dis) ),
	// Status and control signals            
	.resetn(clk_locked_pre & ~dac1_dco_clk_rst),          
	.locked(dac1_dco_clk_locked),
	// Clock in ports
	.clk_in1_200M      (dac1_dco_clk_in) // no buf // 0 deg
);


//}

// test clock out //{
wire w_trig_p_oddr_out; // to TRIG_OUT_P
wire w_trig_n_oddr_out; // to TRIG_OUT_N
wire w_oddr_in = clk_dac_out1_400M; // OK ... xdc set_output_delay
//
ODDR #(
	.DDR_CLK_EDGE("SAME_EDGE"), // "OPPOSITE_EDGE" or "SAME_EDGE" 
	.INIT(1'b0),    // Initial value of Q: 1'b0 or 1'b1
	.SRTYPE("SYNC") // Set/Reset type: "SYNC" or "ASYNC" 
) ODDR_TRIG_P_inst (
	.Q(w_trig_p_oddr_out),   // 1-bit DDR output
	.C(w_oddr_in),   // 1-bit clock input
	.CE(1'b1), // 1-bit clock enable input
	.D1(1'b1), // 1-bit data input (positive edge) // normal
	.D2(1'b0), // 1-bit data input (negative edge) // normal
	.R(1'b0),   // 1-bit reset
	.S(1'b0)    // 1-bit set
);
//
ODDR #(
	.DDR_CLK_EDGE("SAME_EDGE"), // "OPPOSITE_EDGE" or "SAME_EDGE" 
	.INIT(1'b0),    // Initial value of Q: 1'b0 or 1'b1
	.SRTYPE("SYNC") // Set/Reset type: "SYNC" or "ASYNC" 
) ODDR_TRIG_N_inst (
	.Q(w_trig_n_oddr_out),   // 1-bit DDR output
	.C(w_oddr_in),   // 1-bit clock input
	.CE(1'b1), // 1-bit clock enable input
	.D1(1'b0), // 1-bit data input (positive edge) // inverted
	.D2(1'b1), // 1-bit data input (negative edge) // inverted
	.R(1'b0),   // 1-bit reset
	.S(1'b0)    // 1-bit set
);

//}

// clock locked //{
wire clk_locked = clk1_locked & clk2_locked & clk3_locked & clk4_locked;
//}

// system clock //{
wire sys_clk	= clk_out3_10M;
//}

// system reset //{
wire reset_n	= clk_locked;
wire reset		= ~reset_n;
//}

// other alias clocks //{
wire mcs_clk             = clk3_out1_72M;
wire lan_clk             = clk3_out2_144M;
wire mcs_eeprom_fifo_clk = clk3_out4_72M;
wire xadc_clk            = clk_out4_10M;
//}

// DAC clocks //{
	
wire dac0_clk   = dac0_dco_clk_out1_400M; 
wire dac1_clk   = dac1_dco_clk_out1_400M; 

wire dac0_reset_n = dac0_dco_clk_locked;
wire dac1_reset_n = dac1_dco_clk_locked;

// for IOB registers
assign w_DAC0_DAT__IOB_clk   = dac0_clk;
assign w_DAC1_DAT__IOB_clk   = dac1_clk;
assign w_DAC0_DAT__IOB_rst_n = reset_n;
assign w_DAC1_DAT__IOB_rst_n = reset_n;



// dac dci oddr output //{
wire w_dac0_dci_oddr_out; // to DAC0_DCI
wire w_dac1_dci_oddr_out; // to DAC1_DCI
wire w_dac0_dci_oddr_in = dac0_dco_clk_out5_400M; 
wire w_dac1_dci_oddr_in = dac1_dco_clk_out5_400M; // PN swap in pll 180 degree
// use common clock 
//wire w_dac0_dci_oddr_in = clk_dac_out2_400M_0  ; 
//wire w_dac1_dci_oddr_in = clk_dac_out3_400M_180; // PN swap in pll 180 degree
//
ODDR #(
	.DDR_CLK_EDGE("SAME_EDGE"), // "OPPOSITE_EDGE" or "SAME_EDGE" 
	.INIT(1'b0),    // Initial value of Q: 1'b0 or 1'b1
	.SRTYPE("SYNC") // Set/Reset type: "SYNC" or "ASYNC" 
)   ODDR_dac0_dci_inst (
	.Q(w_dac0_dci_oddr_out),   // 1-bit DDR output
	.C(w_dac0_dci_oddr_in),   // 1-bit clock input
	.CE(1'b1), // 1-bit clock enable input
	.D1(1'b1), // 1-bit data input (positive edge)
	.D2(1'b0), // 1-bit data input (negative edge)
	.R(1'b0),   // 1-bit reset
	.S(1'b0)    // 1-bit set
);
//
ODDR #(
	.DDR_CLK_EDGE("SAME_EDGE"), // "OPPOSITE_EDGE" or "SAME_EDGE" 
	.INIT(1'b0),    // Initial value of Q: 1'b0 or 1'b1
	.SRTYPE("SYNC") // Set/Reset type: "SYNC" or "ASYNC" 
)   ODDR_dac1_dci_inst (
	.Q(w_dac1_dci_oddr_out),   // 1-bit DDR output
	.C(w_dac1_dci_oddr_in),   // 1-bit clock input
	.CE(1'b1), // 1-bit clock enable input
	.D1(1'b1), // 1-bit data input (positive edge)
	.D2(1'b0), // 1-bit data input (negative edge)
	.R(1'b0),   // 1-bit reset
	.S(1'b0)    // 1-bit set
);
//
	
//}	
	
//}


// clock for MTH SPI //{

wire base_sspi_clk; // base clock for slave SPI // 104MHz
wire p_sspi_clk;    // p_clk for SSPI // 13MHz = base / 8

wire clk_2_locked = 1'b1;

// clk_wiz_2_2
wire clk_2_2_locked; //$$ unused
clk_wiz_2_2  clk_wiz_2_2_inst (
	// Clock out ports  
	.clk_out1_104M(base_sspi_clk),  
	.clk_out2_13M (p_sspi_clk   ),  
	// Status and control signals     
	.resetn(clk_2_locked),          
	.locked(clk_2_2_locked),
	// Clock in ports
	.clk_in1(clk_out1_200M)
);

//}


// clock for ADC //{

//$$ note : best ADC base frequency for 5MHz, 10MHz test 
//     among ....         189, 224, 244MHz
//  
//  base adc freq : 210, 189, 224, 244 MHz

wire base_adc_clk; // base clock for ADC  
wire base_adc_clk0;
wire base_adc_clk1;
wire adc_fifo_clk; // // adc fifo clock // 60MHz or 63MHz

// ref clock for adc buffer 
wire ref_200M_clk = clk_out1_200M;

wire clk_0_2_3_locked; //$$ unused

//  //clk_wiz_0_2_3    clk_wiz_0_2_3_inst ( //$$ for 210MHz
//  clk_wiz_0_2_3_1  clk_wiz_0_2_3_inst ( //$$ for 189MHz
//  //clk_wiz_0_2_3_2  clk_wiz_0_2_3_inst ( //$$ for 224MHz
//  //clk_wiz_0_2_3_3  clk_wiz_0_2_3_inst ( //$$ for 244MHz
//  	// Clock out ports  
//  	//.clk_out1_210M(base_adc_clk ),  //$$ for 210MHz
//  	.clk_out1_189M(base_adc_clk ),  //$$ for 189MHz
//  	//.clk_out1_224M(base_adc_clk ),  //$$ for 224MHz
//  	//.clk_out1_244M(base_adc_clk ),  //$$ for 244MHz
//  	.clk_out2_30M (             ),  
//  	.clk_out3_60M (adc_fifo_clk ),  
//  	// Status and control signals     
//  	.resetn       (clk_locked_pre),          
//  	.locked       (clk_0_2_3_locked   ),
//  	// Clock in ports
//  	.clk_in1_140M (clk_out2_140M ) //
//  );

// to-do: use clock mux after this
clk_wiz_0_2_3_4  clk_wiz_0_2_3_inst ( //$$ for 210MHz or 189MHz
	// Clock out ports  
	.clk_out1_210M(base_adc_clk0),  // CLKOUT0 $$ for 210MHz
	.clk_out2_189M(base_adc_clk1),  // CLKOUT1 $$ for 189MHz
	.clk_out3_63M (adc_fifo_clk ),  // CLKOUT2
	// Status and control signals     
	.resetn       (clk_locked_pre),          
	.locked       (clk_0_2_3_locked   ),
	// Clock in ports
	.clk_in1_140M (clk_out2_140M ) //
);

wire w_sel__base_adc_clk;
assign base_adc_clk = (w_sel__base_adc_clk==1'b0)? base_adc_clk0 : base_adc_clk1;

//parameter PERIOD_CLK_LOGIC_NS = 4.76190476; // // ns // for 210MHz @ clk_logic   // also for 189MHz
//parameter PERIOD_CLK_LOGIC_NS = 5.29100529; // // ns // for 189MHz @ clk_logic
//parameter PERIOD_CLK_LOGIC_NS = 4.46428571; // // ns // for 224MHz @ clk_logic
//parameter PERIOD_CLK_LOGIC_NS = 4.09836066; // // ns // for 244MHz @ clk_logic

parameter ADC_DELAY_CLK         = 14; // 65ns min < 1/(210MHz)*14=66.7ns @210MHz   // also for 189MHz
//parameter DELAY_CLK           = 13; // 65ns min < 1/(189MHz)*13=68.8ns @189MHz
//parameter DELAY_CLK           = 15; // 65ns min < 1/(224MHz)*15=67.0ns @224MHz
//parameter DELAY_CLK           = 16; // 65ns min < 1/(244MHz)*16=65.6ns @244MHz

// to-do: use WIDTH_CLK_RESET and WIDTH_IO_RESET, instead of PERIOD_CLK_LOGIC_NS
//
// parameter WIDTH_CLK_RESET_NS = 32'd50; // ns
// parameter WIDTH_CLK_RESET = WIDTH_CLK_RESET_NS/PERIOD_CLK_LOGIC_NS; // period count of r_clk_reset
parameter ADC_WIDTH_CLK_RESET   = 11; //  50ns min < 1/(210MHz)*11=52.38ns @210MHz // also for 189MHz
//   //  50ns min < 1/(189MHz)*10=52.91ns @189MHz
// 
// parameter WIDTH_IO_RESET_NS = 32'd150; // ns
// parameter WIDTH_IO_RESET = WIDTH_IO_RESET_NS/PERIOD_CLK_LOGIC_NS; // period count of r_io_reset
parameter ADC_WIDTH_IO_RESET    = 32; // 150ns min < 1/(210MHz)*32=152.381ns @210MHz // also for 189MHz
//   // 150ns min < 1/(189MHz)*29=153.439ns @189MHz

//}


//}


///TODO: //-------------------------------------------------------//


/* TODO: end-point wires */ //{

// end-points : SSPI vs LAN 
//
// endpoint modules :
//
// (USB) ok_endpoint_wrapper : usb host interface <--> end-points //$$ removed
//    okHost okHI
//    ok...
//
// (LAN) lan_endpoint_wrapper : lan spi  interface <--> end-points
//    microblaze_mcs_1  soft_cpu_mcs_inst
//    mcs_io_bridge_ext  mcs_io_bridge_inst2
//    master_spi_wz850_ext  master_spi_wz850_inst
//    fifo_generator_3  LAN_fifo_wr_inst
//    fifo_generator_3  LAN_fifo_rd_inst
//
// (SSPI) slave_spi_mth_brd : MTH slave SPI <--> end-points
//   


//// TODO: USB --> SSPI end-point wires: //{
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
