lastoyz/dsn_pgu_adda_s3100_git/txem7310_pll/txem7310_pll.srcs/constrs_1/new/debug_net.xdc

##== TIME STAMP ==##
#set_property MARK_DEBUG true [get_nets {w_TIMESTAMP_WO[*]}]
#set_property MARK_DEBUG true [get_nets {sub_timestamp_inst/r_global_time_idx[*]}]


##== MTH SPI ==##

## ports for master_spi_mth_brd__inst

#set_property MARK_DEBUG true [get_nets master_spi_mth_brd__inst/i_trig_init  ]
#set_property MARK_DEBUG true [get_nets master_spi_mth_brd__inst/o_done_init  ]
#set_property MARK_DEBUG true [get_nets master_spi_mth_brd__inst/i_trig_frame ]
#set_property MARK_DEBUG true [get_nets master_spi_mth_brd__inst/o_done_frame ]

#set_property MARK_DEBUG true [get_nets master_spi_mth_brd__inst/i_frame_data_C[*]]
#set_property MARK_DEBUG true [get_nets master_spi_mth_brd__inst/i_frame_data_A[*]]
#set_property MARK_DEBUG true [get_nets master_spi_mth_brd__inst/i_frame_data_D[*]]
#set_property MARK_DEBUG true [get_nets master_spi_mth_brd__inst/o_frame_data_B[*]]
#set_property MARK_DEBUG true [get_nets master_spi_mth_brd__inst/o_frame_data_E[*]]


#set_property MARK_DEBUG true [get_nets w_SSPI_TEST_trig_frame]
#set_property MARK_DEBUG true [get_nets w_SSPI_TEST_done_frame]
#set_property MARK_DEBUG true [get_nets w_SSPI_TEST_trig_init]

#set_property MARK_DEBUG true [get_nets w_SSPI_TEST_SS_B]
#set_property MARK_DEBUG true [get_nets w_SSPI_TEST_MOSI]
#set_property MARK_DEBUG true [get_nets w_SSPI_TEST_MCLK]
#set_property MARK_DEBUG true [get_nets w_SSPI_TEST_MISO_EN]
#set_property MARK_DEBUG true [get_nets w_SSPI_TEST_MISO]
#set_property MARK_DEBUG true [get_nets w_SSPI_TEST_SCLK]


##set_property MARK_DEBUG true [get_nets FPGA_M0_SPI_nCS0_ ]
##set_property MARK_DEBUG true [get_nets FPGA_M0_SPI_nCS1_ ]
##set_property MARK_DEBUG true [get_nets FPGA_M0_SPI_nCS2_ ]
##set_property MARK_DEBUG true [get_nets FPGA_M0_SPI_nCS3_ ]
##set_property MARK_DEBUG true [get_nets FPGA_M0_SPI_nCS4_ ]
##set_property MARK_DEBUG true [get_nets FPGA_M0_SPI_nCS5_ ]
##set_property MARK_DEBUG true [get_nets FPGA_M0_SPI_nCS6_ ]
##set_property MARK_DEBUG true [get_nets FPGA_M0_SPI_nCS7_ ]
##set_property MARK_DEBUG true [get_nets FPGA_M0_SPI_nCS8_ ]
##set_property MARK_DEBUG true [get_nets FPGA_M0_SPI_nCS9_ ]
##set_property MARK_DEBUG true [get_nets FPGA_M0_SPI_nCS10 ]
##set_property MARK_DEBUG true [get_nets FPGA_M0_SPI_nCS11 ]
##set_property MARK_DEBUG true [get_nets FPGA_M0_SPI_nCS12 ]


## ports for slave_spi_mth_brd__M2_inst 

#set_property MARK_DEBUG true [get_nets w_SSPI_CS_B   ]
#set_property MARK_DEBUG true [get_nets w_SSPI_CLK    ]
#set_property MARK_DEBUG true [get_nets w_SSPI_MOSI   ]
#set_property MARK_DEBUG true [get_nets w_SSPI_MISO   ]
#set_property MARK_DEBUG true [get_nets w_SSPI_MISO_EN]

set_property MARK_DEBUG true [get_nets slave_spi_mth_brd__M2_inst/i_SPI_CS_B    ]
set_property MARK_DEBUG true [get_nets slave_spi_mth_brd__M2_inst/i_SPI_CLK     ]
set_property MARK_DEBUG true [get_nets slave_spi_mth_brd__M2_inst/i_SPI_MOSI    ]
set_property MARK_DEBUG true [get_nets slave_spi_mth_brd__M2_inst/o_SPI_MISO    ]
set_property MARK_DEBUG true [get_nets slave_spi_mth_brd__M2_inst/o_SPI_MISO_EN ]

#set_property MARK_DEBUG true [get_nets slave_spi_mth_brd__M2_inst/o_port_pi_sadrs_h228[*] ]
#set_property MARK_DEBUG true [get_nets slave_spi_mth_brd__M2_inst/i_port_po_sadrs_h2A8[*] ]

#set_property MARK_DEBUG true [get_nets slave_spi_mth_brd__M2_inst/o_cnt_sspi_cs[*] ]

set_property MARK_DEBUG true [get_nets slave_spi_mth_brd__M2_inst/r_frame_ctrl[*] ]
set_property MARK_DEBUG true [get_nets slave_spi_mth_brd__M2_inst/r_frame_adrs[*] ]
set_property MARK_DEBUG true [get_nets slave_spi_mth_brd__M2_inst/r_frame_mosi[*] ]
set_property MARK_DEBUG true [get_nets slave_spi_mth_brd__M2_inst/r_frame_miso[*] ]
set_property MARK_DEBUG true [get_nets slave_spi_mth_brd__M2_inst/r_frame_miso_trig ]

## # eeprom fifo
## set_property MARK_DEBUG true [get_nets slave_spi_mth_brd__M2_inst/o_wr__sadrs_h24C        ]
## set_property MARK_DEBUG true [get_nets slave_spi_mth_brd__M2_inst/o_port_pi_sadrs_h24C[*] ]
## set_property MARK_DEBUG true [get_nets slave_spi_mth_brd__M2_inst/o_rd__sadrs_h2CC        ]
## set_property MARK_DEBUG true [get_nets slave_spi_mth_brd__M2_inst/i_port_po_sadrs_h2CC[*] ]
## 
## # adc fifo
## set_property MARK_DEBUG true [get_nets slave_spi_mth_brd__M2_inst/o_rd__sadrs_h2F0        ] 
## set_property MARK_DEBUG true [get_nets slave_spi_mth_brd__M2_inst/i_port_po_sadrs_h2F0[*] ]
## set_property MARK_DEBUG true [get_nets slave_spi_mth_brd__M2_inst/o_rd__sadrs_h2F4        ]
## set_property MARK_DEBUG true [get_nets slave_spi_mth_brd__M2_inst/i_port_po_sadrs_h2F4[*] ]


##== LAN ==##

#lan_endpoint_wrapper_inst

## set_property MARK_DEBUG true [get_nets lan_endpoint_wrapper_inst/ep93pipe[*] ] ;# MEM_PI
## set_property MARK_DEBUG true [get_nets lan_endpoint_wrapper_inst/ep93wr      ]
## set_property MARK_DEBUG true [get_nets lan_endpoint_wrapper_inst/epB3pipe[*] ] ;# MEM_PO
## set_property MARK_DEBUG true [get_nets lan_endpoint_wrapper_inst/epB3rd      ]
## set_property MARK_DEBUG true [get_nets lan_endpoint_wrapper_inst/epBCpipe[*] ] ;# ADCH_DOUT0_PO
## set_property MARK_DEBUG true [get_nets lan_endpoint_wrapper_inst/epBCrd      ]
## set_property MARK_DEBUG true [get_nets lan_endpoint_wrapper_inst/epBDpipe[*] ] ;# ADCH_DOUT1_PO
## set_property MARK_DEBUG true [get_nets lan_endpoint_wrapper_inst/epBDrd      ]


##== DAC Pattern Gen ==##

set_property MARK_DEBUG true [get_nets {DAC0_DAT[*]}]
set_property MARK_DEBUG true [get_nets {DAC1_DAT[*]}]

set_property MARK_DEBUG true [get_nets dac_pattern_gen_wrapper__inst/dac_pattern_gen_inst/flag_fcid_pulse_active_dac0]
set_property MARK_DEBUG true [get_nets dac_pattern_gen_wrapper__inst/dac_pattern_gen_inst/flag_fcid_pulse_active_dac1]


##== EEPROM ==##

## ## EEPROM_fifo_wr_inst : framer <-- pipe-in
## set_property MARK_DEBUG true [get_nets control_eeprom__11AA160T_inst/EEPROM_fifo_wr_inst/rst    ]
## # set_property MARK_DEBUG true [get_nets control_eeprom__11AA160T_inst/EEPROM_fifo_wr_inst/wr_en  ]
## #set_property MARK_DEBUG true [get_nets control_eeprom__11AA160T_inst/EEPROM_fifo_wr_inst/din[*] ]
## set_property MARK_DEBUG true [get_nets control_eeprom__11AA160T_inst/EEPROM_fifo_wr_inst/rd_en  ]
## set_property MARK_DEBUG true [get_nets control_eeprom__11AA160T_inst/EEPROM_fifo_wr_inst/dout[*]]
##  
## ## EEPROM_fifo_rd_inst : framer --> pipe-out
## set_property MARK_DEBUG true [get_nets control_eeprom__11AA160T_inst/EEPROM_fifo_rd_inst/rst    ]
## set_property MARK_DEBUG true [get_nets control_eeprom__11AA160T_inst/EEPROM_fifo_rd_inst/wr_en  ]
## set_property MARK_DEBUG true [get_nets control_eeprom__11AA160T_inst/EEPROM_fifo_rd_inst/din[*] ]
## #set_property MARK_DEBUG true [get_nets control_eeprom__11AA160T_inst/EEPROM_fifo_rd_inst/rd_en  ]
## #set_property MARK_DEBUG true [get_nets control_eeprom__11AA160T_inst/EEPROM_fifo_rd_inst/dout[*]]


##== ADC ==##

# adc_wrapper__inst/control_hsadc_dual__inst/

#set_property MARK_DEBUG true [get_nets {adc_wrapper__inst/control_hsadc_dual__inst/state[*]}]
#set_property MARK_DEBUG true [get_nets  adc_wrapper__inst/control_hsadc_dual__inst/r_clk_adc]
#set_property MARK_DEBUG true [get_nets  adc_wrapper__inst/control_hsadc_dual__inst/r_cnv_adc]
#set_property MARK_DEBUG true [get_nets  adc_wrapper__inst/control_hsadc_dual__inst/r_clk_reset]
#set_property MARK_DEBUG true [get_nets  adc_wrapper__inst/control_hsadc_dual__inst/r_io_reset]
#set_property MARK_DEBUG true [get_nets  adc_wrapper__inst/control_hsadc_dual__inst/r_pin_dlln_frc_low]
#set_property MARK_DEBUG true [get_nets  adc_wrapper__inst/control_hsadc_dual__inst/r_pttn_cnt_up_en]
#set_property MARK_DEBUG true [get_nets  adc_wrapper__inst/control_hsadc_dual__inst/w_delay_locked]
#set_property MARK_DEBUG true [get_nets  adc_wrapper__inst/control_hsadc_dual__inst/w_io_reset]
#set_property MARK_DEBUG true [get_nets  adc_wrapper__inst/control_hsadc_dual__inst/w_valid_serdes]
#set_property MARK_DEBUG true [get_nets  adc_wrapper__inst/control_hsadc_dual__inst/check_cnt_cnv]
#set_property MARK_DEBUG true [get_nets  adc_wrapper__inst/control_hsadc_dual__inst/w_cnv_adc_en]

#set_property MARK_DEBUG true [get_nets  adc_wrapper__inst/control_hsadc_dual__inst/r_init_trig]
#set_property MARK_DEBUG true [get_nets  adc_wrapper__inst/control_hsadc_dual__inst/r_init_busy]
#set_property MARK_DEBUG true [get_nets  adc_wrapper__inst/control_hsadc_dual__inst/r_init_done]
#set_property MARK_DEBUG true [get_nets  adc_wrapper__inst/control_hsadc_dual__inst/w_adc_done_init]
#set_property MARK_DEBUG true [get_nets  adc_wrapper__inst/control_hsadc_dual__inst/check_cnt_cnv__init]
#set_property MARK_DEBUG true [get_nets  adc_wrapper__inst/control_hsadc_dual__inst/check_cnt_cnv__init__adc0]
#set_property MARK_DEBUG true [get_nets  adc_wrapper__inst/control_hsadc_dual__inst/check_cnt_cnv__init__adc1]
#set_property MARK_DEBUG true [get_nets {adc_wrapper__inst/control_hsadc_dual__inst/cnt_wr_fifo[0]__0[*]}]
#set_property MARK_DEBUG true [get_nets {adc_wrapper__inst/control_hsadc_dual__inst/cnt_wr_fifo[1]__0[*]}]
#set_property MARK_DEBUG true [get_nets {adc_wrapper__inst/control_hsadc_dual__inst/cnt_cnv[*]}]

set_property MARK_DEBUG true [get_nets  adc_wrapper__inst/o_hsadc_pin_conv    ]
set_property MARK_DEBUG true [get_nets  adc_wrapper__inst/o_hsadc_pin_sclk    ]
#set_property MARK_DEBUG true [get_nets  adc_wrapper__inst/o_hsadc_pin_test    ]
#
#set_property MARK_DEBUG true [get_nets  adc_wrapper__inst/i_hsadc_dco__adc_0  ]
set_property MARK_DEBUG true [get_nets  adc_wrapper__inst/control_hsadc_dual__inst/serdes[0].serdes_ddr_2lane_in_20bit_out_inst/i_data_s[*] ]
#set_property MARK_DEBUG true [get_nets  adc_wrapper__inst/i_hsadc_dat2_adc_0  ] # NG
#set_property MARK_DEBUG true [get_nets  adc_wrapper__inst/i_hsadc_dat1_adc_0  ] # NG

#set_property MARK_DEBUG true [get_nets  adc_wrapper__inst/i_hsadc_dco__adc_1  ]
set_property MARK_DEBUG true [get_nets  adc_wrapper__inst/control_hsadc_dual__inst/serdes[1].serdes_ddr_2lane_in_20bit_out_inst/i_data_s[*] ]
#set_property MARK_DEBUG true [get_nets  adc_wrapper__inst/i_hsadc_dat2_adc_1  ] # NG
#set_property MARK_DEBUG true [get_nets  adc_wrapper__inst/i_hsadc_dat1_adc_1  ] # NG

set_property MARK_DEBUG true [get_nets  adc_wrapper__inst/i_hsadc_reset           ]
#set_property MARK_DEBUG true [get_nets  adc_wrapper__inst/i_hsadc_en              ]
set_property MARK_DEBUG true [get_nets  adc_wrapper__inst/i_hsadc_init            ]
set_property MARK_DEBUG true [get_nets  adc_wrapper__inst/i_hsadc_update          ]
#set_property MARK_DEBUG true [get_nets  adc_wrapper__inst/i_hsadc_test            ]
set_property MARK_DEBUG true [get_nets  adc_wrapper__inst/i_hsadc_fifo_rst        ] 
set_property MARK_DEBUG true [get_nets  adc_wrapper__inst/o_hsadc_init_done       ]
set_property MARK_DEBUG true [get_nets  adc_wrapper__inst/o_hsadc_update_done     ]
#set_property MARK_DEBUG true [get_nets  adc_wrapper__inst/o_hsadc_test_done       ]
#set_property MARK_DEBUG true [get_nets  adc_wrapper__inst/o_hsadc_init_done_to    ]
#set_property MARK_DEBUG true [get_nets  adc_wrapper__inst/o_hsadc_update_done_to  ]
#set_property MARK_DEBUG true [get_nets  adc_wrapper__inst/o_hsadc_test_done_to    ]

set_property MARK_DEBUG true [get_nets  adc_wrapper__inst/i_HSADC_UPD_SMP[*] ]
set_property MARK_DEBUG true [get_nets  adc_wrapper__inst/i_HSADC_SMP_PRD[*] ]
set_property MARK_DEBUG true [get_nets  adc_wrapper__inst/i_HSADC_DLY_TAP0[*]]
set_property MARK_DEBUG true [get_nets  adc_wrapper__inst/i_HSADC_DLY_TAP1[*]]

set_property MARK_DEBUG true [get_nets  w_mcs_ep_disable    ]
#set_property MARK_DEBUG true [get_nets  w_mcs_ep_po_en      ]
#set_property MARK_DEBUG true [get_nets  w_mcs_ep_pi_en      ]
#set_property MARK_DEBUG true [get_nets  w_mcs_ep_to_en      ]
#set_property MARK_DEBUG true [get_nets  w_mcs_ep_ti_en      ]
#set_property MARK_DEBUG true [get_nets  w_mcs_ep_wo_en      ]
set_property MARK_DEBUG true [get_nets  w_mcs_ep_wi_en      ]
set_property MARK_DEBUG true [get_nets  w_SSPI_TEST_mode_en ]

set_property MARK_DEBUG true [get_nets  adc_wrapper__inst/o_hsadc_fifo_adc0_din[*] ]
set_property MARK_DEBUG true [get_nets  adc_wrapper__inst/o_hsadc_fifo_adc0_wr_ack ]
set_property MARK_DEBUG true [get_nets  adc_wrapper__inst/o_hsadc_fifo_adc0_dout[*]]
set_property MARK_DEBUG true [get_nets  adc_wrapper__inst/i_hsadc_fifo_adc0_rd_en  ]
set_property MARK_DEBUG true [get_nets  adc_wrapper__inst/o_hsadc_fifo_adc1_din[*] ]
set_property MARK_DEBUG true [get_nets  adc_wrapper__inst/o_hsadc_fifo_adc1_wr_ack ]
set_property MARK_DEBUG true [get_nets  adc_wrapper__inst/o_hsadc_fifo_adc1_dout[*]]
set_property MARK_DEBUG true [get_nets  adc_wrapper__inst/i_hsadc_fifo_adc1_rd_en  ]


#set_property MARK_DEBUG true [get_nets  w_ADCH_WI[*] ]
#set_property MARK_DEBUG true [get_nets  w_ADCH_FREQ_WI[*] ]
#set_property MARK_DEBUG true [get_nets  w_ADCH_UPD_SM_WI[*] ]
#set_property MARK_DEBUG true [get_nets  w_ADCH_SMP_PR_WI[*] ]
#set_property MARK_DEBUG true [get_nets  w_ADCH_DLY_TP_WI[*] ]
#set_property MARK_DEBUG true [get_nets  w_ADCH_WO[*] ]
#set_property MARK_DEBUG true [get_nets  w_ADCH_B_FRQ_WO[*] ]
#set_property MARK_DEBUG true [get_nets  w_ADCH_DOUT0_WO[*] ]
#set_property MARK_DEBUG true [get_nets  w_ADCH_DOUT1_WO[*] ]
#set_property MARK_DEBUG true [get_nets  w_ADCH_DOUT2_WO[*] ]
#set_property MARK_DEBUG true [get_nets  w_ADCH_DOUT3_WO[*] ]
#set_property MARK_DEBUG true [get_nets  w_ADCH_TI[*] ]
#set_property MARK_DEBUG true [get_nets  w_ADCH_TO[*] ]
#set_property MARK_DEBUG true [get_nets  w_ADCH_DOUT0_PO[*] ]
#set_property MARK_DEBUG true [get_nets  w_ADCH_DOUT1_PO[*] ]
#set_property MARK_DEBUG true [get_nets  w_ADCH_DOUT0_PO_rd  ]
#set_property MARK_DEBUG true [get_nets  w_ADCH_DOUT1_PO_rd  ]


##== DFT ==##

#set_property MARK_DEBUG true [get_nets  w_DFT_TI[*] ]
#set_property MARK_DEBUG true [get_nets  w_DFT_COEF_RE_PI[*] ]
#set_property MARK_DEBUG true [get_nets  w_DFT_COEF_IM_PI[*] ]
#set_property MARK_DEBUG true [get_nets  w_DFT_COEF_RE_PI_wr ]
#set_property MARK_DEBUG true [get_nets  w_DFT_COEF_IM_PI_wr ]

#set_property MARK_DEBUG true [get_nets w_ADC_HS_DOUT0[*]]
#set_property MARK_DEBUG true [get_nets w_ADC_HS_DOUT1[*]]
#set_property MARK_DEBUG true [get_nets w_ADC_HS_DOUT2[*]]
#set_property MARK_DEBUG true [get_nets w_ADC_HS_DOUT3[*]]

# # based on adc fifo clock
# set_property MARK_DEBUG true [get_nets calculate_dft_wrapper__inst/blk_mem_gen_dft_re__inst0/addra[*] ]
# set_property MARK_DEBUG true [get_nets calculate_dft_wrapper__inst/blk_mem_gen_dft_re__inst0/dina[*]  ]
# set_property MARK_DEBUG true [get_nets calculate_dft_wrapper__inst/blk_mem_gen_dft_re__inst0/wea[*]   ]
# set_property MARK_DEBUG true [get_nets calculate_dft_wrapper__inst/blk_mem_gen_dft_im__inst0/addra[*] ]
# set_property MARK_DEBUG true [get_nets calculate_dft_wrapper__inst/blk_mem_gen_dft_im__inst0/dina[*]  ]
# set_property MARK_DEBUG true [get_nets calculate_dft_wrapper__inst/blk_mem_gen_dft_im__inst0/wea[*]   ]
# 
# # based on mcs clock
# set_property MARK_DEBUG true [get_nets lan_endpoint_wrapper_inst/mcs_io_bridge_inst2/o_port_wr_9C    ]
# set_property MARK_DEBUG true [get_nets lan_endpoint_wrapper_inst/mcs_io_bridge_inst2/o_port_pi_9C[*] ]
# set_property MARK_DEBUG true [get_nets lan_endpoint_wrapper_inst/mcs_io_bridge_inst2/o_port_wr_9D    ]
# set_property MARK_DEBUG true [get_nets lan_endpoint_wrapper_inst/mcs_io_bridge_inst2/o_port_pi_9D[*] ]



##------------------------------------------------------------------------##

#### LOC for mmcm pll ####

## set_property LOC MMCME2_ADV_X0Y1 [get_cells -quiet [list clk_wiz_0_inst/inst/mmcm_adv_inst]]

set_property LOC PLLE2_ADV_X0Y0 [get_cells clk_wiz_0_3_1_inst/inst/plle2_adv_inst] ;# MCS LAN clocks

# note: DAC1 located in B34 (X1Y2); DAC0 located in B35 (X1Y3)
set_property LOC PLLE2_ADV_X0Y1 [get_cells clk_wiz_1_2_inst/inst/plle2_adv_inst]   ;# DAC clocks // i_CLKD_COUT in B13
set_property LOC PLLE2_ADV_X1Y3 [get_cells clk_wiz_1_2_0_inst/inst/plle2_adv_inst] ;# dac0_dci
set_property LOC PLLE2_ADV_X1Y2 [get_cells clk_wiz_1_2_1_inst/inst/plle2_adv_inst] ;# dac1_dci


#### pblock ####

# note: LAN located in B15
create_pblock pblock_lan_endpnt_wrpr_inst
add_cells_to_pblock [get_pblocks pblock_lan_endpnt_wrpr_inst] [get_cells -quiet [list lan_endpoint_wrapper_inst]]
##resize_pblock [get_pblocks pblock_lan_endpnt_wrpr_inst] -add {CLOCKREGION_X0Y0:CLOCKREGION_X1Y1}
##resize_pblock [get_pblocks pblock_lan_endpnt_wrpr_inst] -add {CLOCKREGION_X0Y2:CLOCKREGION_X0Y4 CLOCKREGION_X1Y4:CLOCKREGION_X1Y4}
resize_pblock [get_pblocks pblock_lan_endpnt_wrpr_inst] -add {CLOCKREGION_X0Y2:CLOCKREGION_X0Y4}


# note: MTH located in B16
create_pblock pblock_mth
add_cells_to_pblock [get_pblocks pblock_mth] [get_cells -quiet [list  master_spi_mth_brd__inst slave_spi_mth_brd__M2_inst]]
#resize_pblock [get_pblocks pblock_mth] -add {CLOCKREGION_X0Y0:CLOCKREGION_X0Y1}
resize_pblock [get_pblocks pblock_mth] -add {CLOCKREGION_X0Y3:CLOCKREGION_X0Y4}

# note: ADC located in B15
create_pblock pblock_adc_wrapper__inst
add_cells_to_pblock [get_pblocks pblock_adc_wrapper__inst] [get_cells -quiet [list  adc_wrapper__inst]]
#resize_pblock [get_pblocks pblock_adc_wrapper__inst] -add {CLOCKREGION_X1Y0:CLOCKREGION_X1Y4}
resize_pblock [get_pblocks pblock_adc_wrapper__inst] -add {CLOCKREGION_X0Y0:CLOCKREGION_X0Y4}

# note: DAC located in B34 and B35
create_pblock pblock_dac
add_cells_to_pblock [get_pblocks pblock_dac] [get_cells -quiet [list dac_pattern_gen_wrapper__inst/dac_pattern_gen_inst/dsp48__AP_C__r_*]]
resize_pblock [get_pblocks pblock_dac] -add {CLOCKREGION_X1Y2:CLOCKREGION_X1Y3}


create_pblock pblock_dac0_fifo_datinc
add_cells_to_pblock [get_pblocks pblock_dac0_fifo_datinc] [get_cells -quiet [list dac_pattern_gen_wrapper__inst/dac0_fifo_datinc__inst ]]
resize_pblock [get_pblocks pblock_dac0_fifo_datinc] -add {RAMB36_X6Y22:RAMB36_X6Y23}
#set_property PARENT pblock_dac0 [get_pblocks pblock_dac0_fifo_datinc]
set_property PARENT pblock_dac [get_pblocks pblock_dac0_fifo_datinc]

create_pblock pblock_dac0_fifo_dur
add_cells_to_pblock [get_pblocks pblock_dac0_fifo_dur] [get_cells -quiet [list dac_pattern_gen_wrapper__inst/dac0_fifo_dur_____inst]]
resize_pblock [get_pblocks pblock_dac0_fifo_dur] -add {RAMB36_X6Y20:RAMB36_X6Y21}
#set_property PARENT pblock_dac0 [get_pblocks pblock_dac0_fifo_dur]
set_property PARENT pblock_dac [get_pblocks pblock_dac0_fifo_dur]

#GRID_RANGES	RAMB36_X6Y20:RAMB36_X6Y24, RAMB18_X6Y40:RAMB18_X6Y49, DSP48_X5Y40:DSP48_X6Y49, SLICE_X92Y100:SLICE_X117Y124  for dac0
create_pblock pblock_dac0
#add_cells_to_pblock [get_pblocks pblock_dac0] [get_cells -quiet [list dac_pattern_gen_wrapper__inst/dac_pattern_gen_inst/dsp48__AP_C__r_fcid_cnt_idx_dac0__inst dac_pattern_gen_wrapper__inst/dac_pattern_gen_inst/dsp48__AP_C__r_fcid_cnt_rpt_dac0__inst]]
add_cells_to_pblock [get_pblocks pblock_dac0] [get_cells -quiet [list dac_pattern_gen_wrapper__inst/dac_pattern_gen_inst/dsp48__AP_C__r_fcid_cnt_idx_dac0__inst]]
resize_pblock [get_pblocks pblock_dac0] -add {SLICE_X92Y100:SLICE_X117Y124}
set_property PARENT pblock_dac [get_pblocks pblock_dac0]

#create_pblock pblock_dac0_cnt_dur
#add_cells_to_pblock [get_pblocks pblock_dac0_cnt_dur] [get_cells -quiet [list dac_pattern_gen_wrapper__inst/dac_pattern_gen_inst/dsp48__AP_C__r_fcid_cnt_dur_dac0__inst]]
#resize_pblock [get_pblocks pblock_dac0_cnt_dur] -add {SLICE_X102Y100:SLICE_X108Y119}
#set_property PARENT pblock_dac0 [get_pblocks pblock_dac0_cnt_dur]

#create_pblock pblock_dac0_dat_out
#add_cells_to_pblock [get_pblocks pblock_dac0_dat_out] [get_cells -quiet [list dac_pattern_gen_wrapper__inst/dac_pattern_gen_inst/dsp48__AP_C__r_fcid_dat_out_dac0__inst]]
#resize_pblock [get_pblocks pblock_dac0_dat_out] -add {SLICE_X104Y100:SLICE_X107Y119}
#set_property PARENT pblock_dac0 [get_pblocks pblock_dac0_dat_out]


create_pblock pblock_dac1_fifo_datinc
add_cells_to_pblock [get_pblocks pblock_dac1_fifo_datinc] [get_cells -quiet [list dac_pattern_gen_wrapper__inst/dac1_fifo_datinc__inst ]]
resize_pblock [get_pblocks pblock_dac1_fifo_datinc] -add {RAMB36_X6Y27:RAMB36_X6Y28}
#set_property PARENT pblock_dac1 [get_pblocks pblock_dac1_fifo_datinc]
set_property PARENT pblock_dac [get_pblocks pblock_dac1_fifo_datinc]

create_pblock pblock_dac1_fifo_dur
add_cells_to_pblock [get_pblocks pblock_dac1_fifo_dur] [get_cells -quiet [list dac_pattern_gen_wrapper__inst/dac1_fifo_dur_____inst]]
resize_pblock [get_pblocks pblock_dac1_fifo_dur] -add {RAMB36_X6Y25:RAMB36_X6Y26}
#set_property PARENT pblock_dac1 [get_pblocks pblock_dac1_fifo_dur]
set_property PARENT pblock_dac [get_pblocks pblock_dac1_fifo_dur]

#GRID_RANGES	RAMB36_X6Y25:RAMB36_X6Y29, RAMB18_X6Y50:RAMB18_X6Y59, DSP48_X5Y50:DSP48_X6Y59, SLICE_X92Y125:SLICE_X117Y149  for dac1
create_pblock pblock_dac1
#add_cells_to_pblock [get_pblocks pblock_dac1] [get_cells -quiet [list dac_pattern_gen_wrapper__inst/dac_pattern_gen_inst/dsp48__AP_C__r_fcid_cnt_idx_dac1__inst dac_pattern_gen_wrapper__inst/dac_pattern_gen_inst/dsp48__AP_C__r_fcid_cnt_rpt_dac1__inst]]
add_cells_to_pblock [get_pblocks pblock_dac1] [get_cells -quiet [list dac_pattern_gen_wrapper__inst/dac_pattern_gen_inst/dsp48__AP_C__r_fcid_cnt_idx_dac1__inst]]
resize_pblock [get_pblocks pblock_dac1] -add {SLICE_X92Y125:SLICE_X117Y149}
set_property PARENT pblock_dac [get_pblocks pblock_dac1]

#create_pblock pblock_dac1_cnt_dur
#add_cells_to_pblock [get_pblocks pblock_dac1_cnt_dur] [get_cells -quiet [list dac_pattern_gen_wrapper__inst/dac_pattern_gen_inst/dsp48__AP_C__r_fcid_cnt_dur_dac1__inst]]
#resize_pblock [get_pblocks pblock_dac1_cnt_dur] -add {SLICE_X102Y150:SLICE_X108Y169}
#set_property PARENT pblock_dac1 [get_pblocks pblock_dac1_cnt_dur]

#create_pblock pblock_dac1_dat_out
#add_cells_to_pblock [get_pblocks pblock_dac1_dat_out] [get_cells -quiet [list dac_pattern_gen_wrapper__inst/dac_pattern_gen_inst/dsp48__AP_C__r_fcid_dat_out_dac1__inst]]
#resize_pblock [get_pblocks pblock_dac1_dat_out] -add {SLICE_X104Y150:SLICE_X107Y169}
#set_property PARENT pblock_dac1 [get_pblocks pblock_dac1_dat_out]
