lastoyz/dsn_pgu_adda_s3100_git/txem7310_pll/txem7310_pll.srcs/constrs_1/new/debug_cores.xdc

create_debug_core u_ila_0 ila
set_property ALL_PROBE_SAME_MU true [get_debug_cores u_ila_0]
set_property ALL_PROBE_SAME_MU_CNT 1 [get_debug_cores u_ila_0]
set_property C_ADV_TRIGGER false [get_debug_cores u_ila_0]
set_property C_DATA_DEPTH 1024 [get_debug_cores u_ila_0]
set_property C_EN_STRG_QUAL false [get_debug_cores u_ila_0]
set_property C_INPUT_PIPE_STAGES 2 [get_debug_cores u_ila_0]
set_property C_TRIGIN_EN false [get_debug_cores u_ila_0]
set_property C_TRIGOUT_EN false [get_debug_cores u_ila_0]
set_property port_width 1 [get_debug_ports u_ila_0/clk]
connect_debug_port u_ila_0/clk [get_nets [list clk_wiz_1_2_0_inst/inst/clk_out1_200M]]
set_property PROBE_TYPE DATA_AND_TRIGGER [get_debug_ports u_ila_0/probe0]
set_property port_width 16 [get_debug_ports u_ila_0/probe0]
connect_debug_port u_ila_0/probe0 [get_nets [list {DAC0_DAT[0]} {DAC0_DAT[1]} {DAC0_DAT[2]} {DAC0_DAT[3]} {DAC0_DAT[4]} {DAC0_DAT[5]} {DAC0_DAT[6]} {DAC0_DAT[7]} {DAC0_DAT[8]} {DAC0_DAT[9]} {DAC0_DAT[10]} {DAC0_DAT[11]} {DAC0_DAT[12]} {DAC0_DAT[13]} {DAC0_DAT[14]} {DAC0_DAT[15]}]]
create_debug_core u_ila_1 ila
set_property ALL_PROBE_SAME_MU true [get_debug_cores u_ila_1]
set_property ALL_PROBE_SAME_MU_CNT 1 [get_debug_cores u_ila_1]
set_property C_ADV_TRIGGER false [get_debug_cores u_ila_1]
set_property C_DATA_DEPTH 1024 [get_debug_cores u_ila_1]
set_property C_EN_STRG_QUAL false [get_debug_cores u_ila_1]
set_property C_INPUT_PIPE_STAGES 2 [get_debug_cores u_ila_1]
set_property C_TRIGIN_EN false [get_debug_cores u_ila_1]
set_property C_TRIGOUT_EN false [get_debug_cores u_ila_1]
set_property port_width 1 [get_debug_ports u_ila_1/clk]
connect_debug_port u_ila_1/clk [get_nets [list clk_wiz_1_2_1_inst/inst/clk_out3_200M_180]]
set_property PROBE_TYPE DATA_AND_TRIGGER [get_debug_ports u_ila_1/probe0]
set_property port_width 16 [get_debug_ports u_ila_1/probe0]
connect_debug_port u_ila_1/probe0 [get_nets [list {DAC1_DAT[0]} {DAC1_DAT[1]} {DAC1_DAT[2]} {DAC1_DAT[3]} {DAC1_DAT[4]} {DAC1_DAT[5]} {DAC1_DAT[6]} {DAC1_DAT[7]} {DAC1_DAT[8]} {DAC1_DAT[9]} {DAC1_DAT[10]} {DAC1_DAT[11]} {DAC1_DAT[12]} {DAC1_DAT[13]} {DAC1_DAT[14]} {DAC1_DAT[15]}]]
create_debug_core u_ila_2 ila
set_property ALL_PROBE_SAME_MU true [get_debug_cores u_ila_2]
set_property ALL_PROBE_SAME_MU_CNT 1 [get_debug_cores u_ila_2]
set_property C_ADV_TRIGGER false [get_debug_cores u_ila_2]
set_property C_DATA_DEPTH 1024 [get_debug_cores u_ila_2]
set_property C_EN_STRG_QUAL false [get_debug_cores u_ila_2]
set_property C_INPUT_PIPE_STAGES 2 [get_debug_cores u_ila_2]
set_property C_TRIGIN_EN false [get_debug_cores u_ila_2]
set_property C_TRIGOUT_EN false [get_debug_cores u_ila_2]
set_property port_width 1 [get_debug_ports u_ila_2/clk]
connect_debug_port u_ila_2/clk [get_nets [list clk_wiz_0_2_3_inst/inst/clk_out1_210M]]
set_property PROBE_TYPE DATA_AND_TRIGGER [get_debug_ports u_ila_2/probe0]
set_property port_width 2 [get_debug_ports u_ila_2/probe0]
connect_debug_port u_ila_2/probe0 [get_nets [list {adc_wrapper__inst/control_hsadc_dual__inst/serdes[1].serdes_ddr_2lane_in_20bit_out_inst/i_data_s[0]} {adc_wrapper__inst/control_hsadc_dual__inst/serdes[1].serdes_ddr_2lane_in_20bit_out_inst/i_data_s[1]}]]
create_debug_core u_ila_3 ila
set_property ALL_PROBE_SAME_MU true [get_debug_cores u_ila_3]
set_property ALL_PROBE_SAME_MU_CNT 1 [get_debug_cores u_ila_3]
set_property C_ADV_TRIGGER false [get_debug_cores u_ila_3]
set_property C_DATA_DEPTH 1024 [get_debug_cores u_ila_3]
set_property C_EN_STRG_QUAL false [get_debug_cores u_ila_3]
set_property C_INPUT_PIPE_STAGES 2 [get_debug_cores u_ila_3]
set_property C_TRIGIN_EN false [get_debug_cores u_ila_3]
set_property C_TRIGOUT_EN false [get_debug_cores u_ila_3]
set_property port_width 1 [get_debug_ports u_ila_3/clk]
connect_debug_port u_ila_3/clk [get_nets [list clk_wiz_0_2_3_inst/inst/clk_out3_63M]]
set_property PROBE_TYPE DATA_AND_TRIGGER [get_debug_ports u_ila_3/probe0]
set_property port_width 18 [get_debug_ports u_ila_3/probe0]
connect_debug_port u_ila_3/probe0 [get_nets [list {adc_wrapper__inst/o_hsadc_fifo_adc0_din[0]} {adc_wrapper__inst/o_hsadc_fifo_adc0_din[1]} {adc_wrapper__inst/o_hsadc_fifo_adc0_din[2]} {adc_wrapper__inst/o_hsadc_fifo_adc0_din[3]} {adc_wrapper__inst/o_hsadc_fifo_adc0_din[4]} {adc_wrapper__inst/o_hsadc_fifo_adc0_din[5]} {adc_wrapper__inst/o_hsadc_fifo_adc0_din[6]} {adc_wrapper__inst/o_hsadc_fifo_adc0_din[7]} {adc_wrapper__inst/o_hsadc_fifo_adc0_din[8]} {adc_wrapper__inst/o_hsadc_fifo_adc0_din[9]} {adc_wrapper__inst/o_hsadc_fifo_adc0_din[10]} {adc_wrapper__inst/o_hsadc_fifo_adc0_din[11]} {adc_wrapper__inst/o_hsadc_fifo_adc0_din[12]} {adc_wrapper__inst/o_hsadc_fifo_adc0_din[13]} {adc_wrapper__inst/o_hsadc_fifo_adc0_din[14]} {adc_wrapper__inst/o_hsadc_fifo_adc0_din[15]} {adc_wrapper__inst/o_hsadc_fifo_adc0_din[16]} {adc_wrapper__inst/o_hsadc_fifo_adc0_din[17]}]]
create_debug_core u_ila_4 ila
set_property ALL_PROBE_SAME_MU true [get_debug_cores u_ila_4]
set_property ALL_PROBE_SAME_MU_CNT 1 [get_debug_cores u_ila_4]
set_property C_ADV_TRIGGER false [get_debug_cores u_ila_4]
set_property C_DATA_DEPTH 1024 [get_debug_cores u_ila_4]
set_property C_EN_STRG_QUAL false [get_debug_cores u_ila_4]
set_property C_INPUT_PIPE_STAGES 2 [get_debug_cores u_ila_4]
set_property C_TRIGIN_EN false [get_debug_cores u_ila_4]
set_property C_TRIGOUT_EN false [get_debug_cores u_ila_4]
set_property port_width 1 [get_debug_ports u_ila_4/clk]
connect_debug_port u_ila_4/clk [get_nets [list clk_wiz_2_2_inst/inst/clk_out1_104M]]
set_property PROBE_TYPE DATA_AND_TRIGGER [get_debug_ports u_ila_4/probe0]
set_property port_width 18 [get_debug_ports u_ila_4/probe0]
connect_debug_port u_ila_4/probe0 [get_nets [list {adc_wrapper__inst/o_hsadc_fifo_adc1_dout[0]} {adc_wrapper__inst/o_hsadc_fifo_adc1_dout[1]} {adc_wrapper__inst/o_hsadc_fifo_adc1_dout[2]} {adc_wrapper__inst/o_hsadc_fifo_adc1_dout[3]} {adc_wrapper__inst/o_hsadc_fifo_adc1_dout[4]} {adc_wrapper__inst/o_hsadc_fifo_adc1_dout[5]} {adc_wrapper__inst/o_hsadc_fifo_adc1_dout[6]} {adc_wrapper__inst/o_hsadc_fifo_adc1_dout[7]} {adc_wrapper__inst/o_hsadc_fifo_adc1_dout[8]} {adc_wrapper__inst/o_hsadc_fifo_adc1_dout[9]} {adc_wrapper__inst/o_hsadc_fifo_adc1_dout[10]} {adc_wrapper__inst/o_hsadc_fifo_adc1_dout[11]} {adc_wrapper__inst/o_hsadc_fifo_adc1_dout[12]} {adc_wrapper__inst/o_hsadc_fifo_adc1_dout[13]} {adc_wrapper__inst/o_hsadc_fifo_adc1_dout[14]} {adc_wrapper__inst/o_hsadc_fifo_adc1_dout[15]} {adc_wrapper__inst/o_hsadc_fifo_adc1_dout[16]} {adc_wrapper__inst/o_hsadc_fifo_adc1_dout[17]}]]
create_debug_core u_ila_5 ila
set_property ALL_PROBE_SAME_MU true [get_debug_cores u_ila_5]
set_property ALL_PROBE_SAME_MU_CNT 1 [get_debug_cores u_ila_5]
set_property C_ADV_TRIGGER false [get_debug_cores u_ila_5]
set_property C_DATA_DEPTH 1024 [get_debug_cores u_ila_5]
set_property C_EN_STRG_QUAL false [get_debug_cores u_ila_5]
set_property C_INPUT_PIPE_STAGES 2 [get_debug_cores u_ila_5]
set_property C_TRIGIN_EN false [get_debug_cores u_ila_5]
set_property C_TRIGOUT_EN false [get_debug_cores u_ila_5]
set_property port_width 1 [get_debug_ports u_ila_5/clk]
connect_debug_port u_ila_5/clk [get_nets [list clk_wiz_0_0_1_inst/inst/clk_out1_10M]]
set_property PROBE_TYPE DATA_AND_TRIGGER [get_debug_ports u_ila_5/probe0]
set_property port_width 1 [get_debug_ports u_ila_5/probe0]
connect_debug_port u_ila_5/probe0 [get_nets [list adc_wrapper__inst/i_hsadc_fifo_rst]]
create_debug_port u_ila_0 probe
set_property PROBE_TYPE DATA_AND_TRIGGER [get_debug_ports u_ila_0/probe1]
set_property port_width 1 [get_debug_ports u_ila_0/probe1]
connect_debug_port u_ila_0/probe1 [get_nets [list dac_pattern_gen_wrapper__inst/dac_pattern_gen_inst/flag_fcid_pulse_active_dac0]]
create_debug_port u_ila_1 probe
set_property PROBE_TYPE DATA_AND_TRIGGER [get_debug_ports u_ila_1/probe1]
set_property port_width 1 [get_debug_ports u_ila_1/probe1]
connect_debug_port u_ila_1/probe1 [get_nets [list dac_pattern_gen_wrapper__inst/dac_pattern_gen_inst/flag_fcid_pulse_active_dac1]]
create_debug_port u_ila_2 probe
set_property PROBE_TYPE DATA_AND_TRIGGER [get_debug_ports u_ila_2/probe1]
set_property port_width 2 [get_debug_ports u_ila_2/probe1]
connect_debug_port u_ila_2/probe1 [get_nets [list {adc_wrapper__inst/control_hsadc_dual__inst/serdes[0].serdes_ddr_2lane_in_20bit_out_inst/i_data_s[0]} {adc_wrapper__inst/control_hsadc_dual__inst/serdes[0].serdes_ddr_2lane_in_20bit_out_inst/i_data_s[1]}]]
create_debug_port u_ila_2 probe
set_property PROBE_TYPE DATA_AND_TRIGGER [get_debug_ports u_ila_2/probe2]
set_property port_width 1 [get_debug_ports u_ila_2/probe2]
connect_debug_port u_ila_2/probe2 [get_nets [list adc_wrapper__inst/o_hsadc_pin_conv]]
create_debug_port u_ila_2 probe
set_property PROBE_TYPE DATA_AND_TRIGGER [get_debug_ports u_ila_2/probe3]
set_property port_width 1 [get_debug_ports u_ila_2/probe3]
connect_debug_port u_ila_2/probe3 [get_nets [list adc_wrapper__inst/o_hsadc_pin_sclk]]
create_debug_port u_ila_3 probe
set_property PROBE_TYPE DATA_AND_TRIGGER [get_debug_ports u_ila_3/probe1]
set_property port_width 18 [get_debug_ports u_ila_3/probe1]
connect_debug_port u_ila_3/probe1 [get_nets [list {adc_wrapper__inst/o_hsadc_fifo_adc1_din[0]} {adc_wrapper__inst/o_hsadc_fifo_adc1_din[1]} {adc_wrapper__inst/o_hsadc_fifo_adc1_din[2]} {adc_wrapper__inst/o_hsadc_fifo_adc1_din[3]} {adc_wrapper__inst/o_hsadc_fifo_adc1_din[4]} {adc_wrapper__inst/o_hsadc_fifo_adc1_din[5]} {adc_wrapper__inst/o_hsadc_fifo_adc1_din[6]} {adc_wrapper__inst/o_hsadc_fifo_adc1_din[7]} {adc_wrapper__inst/o_hsadc_fifo_adc1_din[8]} {adc_wrapper__inst/o_hsadc_fifo_adc1_din[9]} {adc_wrapper__inst/o_hsadc_fifo_adc1_din[10]} {adc_wrapper__inst/o_hsadc_fifo_adc1_din[11]} {adc_wrapper__inst/o_hsadc_fifo_adc1_din[12]} {adc_wrapper__inst/o_hsadc_fifo_adc1_din[13]} {adc_wrapper__inst/o_hsadc_fifo_adc1_din[14]} {adc_wrapper__inst/o_hsadc_fifo_adc1_din[15]} {adc_wrapper__inst/o_hsadc_fifo_adc1_din[16]} {adc_wrapper__inst/o_hsadc_fifo_adc1_din[17]}]]
create_debug_port u_ila_3 probe
set_property PROBE_TYPE DATA_AND_TRIGGER [get_debug_ports u_ila_3/probe2]
set_property port_width 1 [get_debug_ports u_ila_3/probe2]
connect_debug_port u_ila_3/probe2 [get_nets [list adc_wrapper__inst/o_hsadc_fifo_adc0_wr_ack]]
create_debug_port u_ila_3 probe
set_property PROBE_TYPE DATA_AND_TRIGGER [get_debug_ports u_ila_3/probe3]
set_property port_width 1 [get_debug_ports u_ila_3/probe3]
connect_debug_port u_ila_3/probe3 [get_nets [list adc_wrapper__inst/o_hsadc_fifo_adc1_wr_ack]]
create_debug_port u_ila_4 probe
set_property PROBE_TYPE DATA_AND_TRIGGER [get_debug_ports u_ila_4/probe1]
set_property port_width 18 [get_debug_ports u_ila_4/probe1]
connect_debug_port u_ila_4/probe1 [get_nets [list {adc_wrapper__inst/o_hsadc_fifo_adc0_dout[0]} {adc_wrapper__inst/o_hsadc_fifo_adc0_dout[1]} {adc_wrapper__inst/o_hsadc_fifo_adc0_dout[2]} {adc_wrapper__inst/o_hsadc_fifo_adc0_dout[3]} {adc_wrapper__inst/o_hsadc_fifo_adc0_dout[4]} {adc_wrapper__inst/o_hsadc_fifo_adc0_dout[5]} {adc_wrapper__inst/o_hsadc_fifo_adc0_dout[6]} {adc_wrapper__inst/o_hsadc_fifo_adc0_dout[7]} {adc_wrapper__inst/o_hsadc_fifo_adc0_dout[8]} {adc_wrapper__inst/o_hsadc_fifo_adc0_dout[9]} {adc_wrapper__inst/o_hsadc_fifo_adc0_dout[10]} {adc_wrapper__inst/o_hsadc_fifo_adc0_dout[11]} {adc_wrapper__inst/o_hsadc_fifo_adc0_dout[12]} {adc_wrapper__inst/o_hsadc_fifo_adc0_dout[13]} {adc_wrapper__inst/o_hsadc_fifo_adc0_dout[14]} {adc_wrapper__inst/o_hsadc_fifo_adc0_dout[15]} {adc_wrapper__inst/o_hsadc_fifo_adc0_dout[16]} {adc_wrapper__inst/o_hsadc_fifo_adc0_dout[17]}]]
create_debug_port u_ila_4 probe
set_property PROBE_TYPE DATA_AND_TRIGGER [get_debug_ports u_ila_4/probe2]
set_property port_width 10 [get_debug_ports u_ila_4/probe2]
connect_debug_port u_ila_4/probe2 [get_nets [list {slave_spi_mth_brd__M2_inst/r_frame_adrs[0]} {slave_spi_mth_brd__M2_inst/r_frame_adrs[1]} {slave_spi_mth_brd__M2_inst/r_frame_adrs[2]} {slave_spi_mth_brd__M2_inst/r_frame_adrs[3]} {slave_spi_mth_brd__M2_inst/r_frame_adrs[4]} {slave_spi_mth_brd__M2_inst/r_frame_adrs[5]} {slave_spi_mth_brd__M2_inst/r_frame_adrs[6]} {slave_spi_mth_brd__M2_inst/r_frame_adrs[7]} {slave_spi_mth_brd__M2_inst/r_frame_adrs[8]} {slave_spi_mth_brd__M2_inst/r_frame_adrs[9]}]]
create_debug_port u_ila_4 probe
set_property PROBE_TYPE DATA_AND_TRIGGER [get_debug_ports u_ila_4/probe3]
set_property port_width 6 [get_debug_ports u_ila_4/probe3]
connect_debug_port u_ila_4/probe3 [get_nets [list {slave_spi_mth_brd__M2_inst/r_frame_ctrl[0]} {slave_spi_mth_brd__M2_inst/r_frame_ctrl[1]} {slave_spi_mth_brd__M2_inst/r_frame_ctrl[2]} {slave_spi_mth_brd__M2_inst/r_frame_ctrl[3]} {slave_spi_mth_brd__M2_inst/r_frame_ctrl[4]} {slave_spi_mth_brd__M2_inst/r_frame_ctrl[5]}]]
create_debug_port u_ila_4 probe
set_property PROBE_TYPE DATA_AND_TRIGGER [get_debug_ports u_ila_4/probe4]
set_property port_width 16 [get_debug_ports u_ila_4/probe4]
connect_debug_port u_ila_4/probe4 [get_nets [list {slave_spi_mth_brd__M2_inst/r_frame_miso[0]} {slave_spi_mth_brd__M2_inst/r_frame_miso[1]} {slave_spi_mth_brd__M2_inst/r_frame_miso[2]} {slave_spi_mth_brd__M2_inst/r_frame_miso[3]} {slave_spi_mth_brd__M2_inst/r_frame_miso[4]} {slave_spi_mth_brd__M2_inst/r_frame_miso[5]} {slave_spi_mth_brd__M2_inst/r_frame_miso[6]} {slave_spi_mth_brd__M2_inst/r_frame_miso[7]} {slave_spi_mth_brd__M2_inst/r_frame_miso[8]} {slave_spi_mth_brd__M2_inst/r_frame_miso[9]} {slave_spi_mth_brd__M2_inst/r_frame_miso[10]} {slave_spi_mth_brd__M2_inst/r_frame_miso[11]} {slave_spi_mth_brd__M2_inst/r_frame_miso[12]} {slave_spi_mth_brd__M2_inst/r_frame_miso[13]} {slave_spi_mth_brd__M2_inst/r_frame_miso[14]} {slave_spi_mth_brd__M2_inst/r_frame_miso[15]}]]
create_debug_port u_ila_4 probe
set_property PROBE_TYPE DATA_AND_TRIGGER [get_debug_ports u_ila_4/probe5]
set_property port_width 16 [get_debug_ports u_ila_4/probe5]
connect_debug_port u_ila_4/probe5 [get_nets [list {slave_spi_mth_brd__M2_inst/r_frame_mosi[0]} {slave_spi_mth_brd__M2_inst/r_frame_mosi[1]} {slave_spi_mth_brd__M2_inst/r_frame_mosi[2]} {slave_spi_mth_brd__M2_inst/r_frame_mosi[3]} {slave_spi_mth_brd__M2_inst/r_frame_mosi[4]} {slave_spi_mth_brd__M2_inst/r_frame_mosi[5]} {slave_spi_mth_brd__M2_inst/r_frame_mosi[6]} {slave_spi_mth_brd__M2_inst/r_frame_mosi[7]} {slave_spi_mth_brd__M2_inst/r_frame_mosi[8]} {slave_spi_mth_brd__M2_inst/r_frame_mosi[9]} {slave_spi_mth_brd__M2_inst/r_frame_mosi[10]} {slave_spi_mth_brd__M2_inst/r_frame_mosi[11]} {slave_spi_mth_brd__M2_inst/r_frame_mosi[12]} {slave_spi_mth_brd__M2_inst/r_frame_mosi[13]} {slave_spi_mth_brd__M2_inst/r_frame_mosi[14]} {slave_spi_mth_brd__M2_inst/r_frame_mosi[15]}]]
create_debug_port u_ila_4 probe
set_property PROBE_TYPE DATA_AND_TRIGGER [get_debug_ports u_ila_4/probe6]
set_property port_width 1 [get_debug_ports u_ila_4/probe6]
connect_debug_port u_ila_4/probe6 [get_nets [list adc_wrapper__inst/i_hsadc_fifo_adc0_rd_en]]
create_debug_port u_ila_4 probe
set_property PROBE_TYPE DATA_AND_TRIGGER [get_debug_ports u_ila_4/probe7]
set_property port_width 1 [get_debug_ports u_ila_4/probe7]
connect_debug_port u_ila_4/probe7 [get_nets [list adc_wrapper__inst/i_hsadc_fifo_adc1_rd_en]]
create_debug_port u_ila_4 probe
set_property PROBE_TYPE DATA_AND_TRIGGER [get_debug_ports u_ila_4/probe8]
set_property port_width 1 [get_debug_ports u_ila_4/probe8]
connect_debug_port u_ila_4/probe8 [get_nets [list slave_spi_mth_brd__M2_inst/i_SPI_CLK]]
create_debug_port u_ila_4 probe
set_property PROBE_TYPE DATA_AND_TRIGGER [get_debug_ports u_ila_4/probe9]
set_property port_width 1 [get_debug_ports u_ila_4/probe9]
connect_debug_port u_ila_4/probe9 [get_nets [list slave_spi_mth_brd__M2_inst/i_SPI_CS_B]]
create_debug_port u_ila_4 probe
set_property PROBE_TYPE DATA_AND_TRIGGER [get_debug_ports u_ila_4/probe10]
set_property port_width 1 [get_debug_ports u_ila_4/probe10]
connect_debug_port u_ila_4/probe10 [get_nets [list slave_spi_mth_brd__M2_inst/i_SPI_MOSI]]
create_debug_port u_ila_4 probe
set_property PROBE_TYPE DATA_AND_TRIGGER [get_debug_ports u_ila_4/probe11]
set_property port_width 1 [get_debug_ports u_ila_4/probe11]
connect_debug_port u_ila_4/probe11 [get_nets [list slave_spi_mth_brd__M2_inst/o_SPI_MISO]]
create_debug_port u_ila_4 probe
set_property PROBE_TYPE DATA_AND_TRIGGER [get_debug_ports u_ila_4/probe12]
set_property port_width 1 [get_debug_ports u_ila_4/probe12]
connect_debug_port u_ila_4/probe12 [get_nets [list slave_spi_mth_brd__M2_inst/o_SPI_MISO_EN]]
create_debug_port u_ila_4 probe
set_property PROBE_TYPE DATA_AND_TRIGGER [get_debug_ports u_ila_4/probe13]
set_property port_width 1 [get_debug_ports u_ila_4/probe13]
connect_debug_port u_ila_4/probe13 [get_nets [list slave_spi_mth_brd__M2_inst/r_frame_miso_trig]]
create_debug_port u_ila_4 probe
set_property PROBE_TYPE DATA_AND_TRIGGER [get_debug_ports u_ila_4/probe14]
set_property port_width 1 [get_debug_ports u_ila_4/probe14]
connect_debug_port u_ila_4/probe14 [get_nets [list w_mcs_ep_disable]]
create_debug_port u_ila_4 probe
set_property PROBE_TYPE DATA_AND_TRIGGER [get_debug_ports u_ila_4/probe15]
set_property port_width 1 [get_debug_ports u_ila_4/probe15]
connect_debug_port u_ila_4/probe15 [get_nets [list w_SSPI_TEST_mode_en]]
create_debug_port u_ila_5 probe
set_property PROBE_TYPE DATA_AND_TRIGGER [get_debug_ports u_ila_5/probe1]
set_property port_width 1 [get_debug_ports u_ila_5/probe1]
connect_debug_port u_ila_5/probe1 [get_nets [list adc_wrapper__inst/i_hsadc_init]]
create_debug_port u_ila_5 probe
set_property PROBE_TYPE DATA_AND_TRIGGER [get_debug_ports u_ila_5/probe2]
set_property port_width 1 [get_debug_ports u_ila_5/probe2]
connect_debug_port u_ila_5/probe2 [get_nets [list adc_wrapper__inst/i_hsadc_reset]]
create_debug_port u_ila_5 probe
set_property PROBE_TYPE DATA_AND_TRIGGER [get_debug_ports u_ila_5/probe3]
set_property port_width 1 [get_debug_ports u_ila_5/probe3]
connect_debug_port u_ila_5/probe3 [get_nets [list adc_wrapper__inst/i_hsadc_update]]
create_debug_port u_ila_5 probe
set_property PROBE_TYPE DATA_AND_TRIGGER [get_debug_ports u_ila_5/probe4]
set_property port_width 1 [get_debug_ports u_ila_5/probe4]
connect_debug_port u_ila_5/probe4 [get_nets [list adc_wrapper__inst/o_hsadc_init_done]]
create_debug_port u_ila_5 probe
set_property PROBE_TYPE DATA_AND_TRIGGER [get_debug_ports u_ila_5/probe5]
set_property port_width 1 [get_debug_ports u_ila_5/probe5]
connect_debug_port u_ila_5/probe5 [get_nets [list adc_wrapper__inst/o_hsadc_update_done]]
set_property C_CLK_INPUT_FREQ_HZ 300000000 [get_debug_cores dbg_hub]
set_property C_ENABLE_CLK_DIVIDER false [get_debug_cores dbg_hub]
set_property C_USER_SCAN_CHAIN 1 [get_debug_cores dbg_hub]
connect_debug_port dbg_hub/clk [get_nets clk_out3_10M]
