lastoyz/dsn_pgu_adda_s3100_git/txem7310_pll/txem7310_pll.srcs/_sdk/s3100_mcs_lan_eps/src/BOARD_BASE_LIB/s3100_pgu_config.h

#ifndef __S3100_PGU_CONFIG_H_		/* prevent circular inclusions */
#define __S3100_PGU_CONFIG_H_		/* by using protection macros */

#ifdef __cplusplus
extern "C" {
#endif


#include "xiomodule_l.h" // low-level driver
// for XPAR_IOMODULE_0_IO_BASEADDR
// for XIomodule_In32() and XIomodule_Out32()

#include "xil_printf.h"

// macro for CMU-CPU board support
//#define _CMU_CPU_

// macro for PGU-CPU board support
//#define _PGU_CPU_

// macro for S3100-CPU-BASE board support
//#define _S3100_CPU_

// macro for S3100-PGU board support
#define _S3100_PGU_

// offset definition for mcs_io_bridge.v //{
//#define MCS_IO_INST_OFFSET              0x00000000 // for LAN
//#define MCS_IO_INST_OFFSET_CMU          0x00010000 // for CMU
//#define MCS_IO_INST_OFFSET_PGU          0x00020000 // for PGU
//#define MCS_IO_INST_OFFSET_EXT          0x00030000 // for MHVSU_BASE (port end-points + lan end-points)
//#define MCS_IO_INST_OFFSET_EXT_CMU      0x00040000 // for NEW CMU (port end-points + lan end-points)
//#define MCS_IO_INST_OFFSET_EXT_PGU      0x00050000 // for S3000-PGU       (port end-points + lan end-points)
//#define MCS_IO_INST_OFFSET_EXT_S3100    0x00060000 // for S3100-CPU-BASE  (port end-points + lan end-points)
#define MCS_IO_INST_OFFSET_EXT_S3100_PGU  0x00070000 // for S3100-PGU       (port end-points + lan end-points)
//}

// BASE //{
//#define ADRS_BASE           XPAR_IOMODULE_0_IO_BASEADDR + MCS_IO_INST_OFFSET     // not used
//#define ADRS_BASE_CMU       XPAR_IOMODULE_0_IO_BASEADDR + MCS_IO_INST_OFFSET_CMU // not used
//#define ADRS_BASE_PGU       XPAR_IOMODULE_0_IO_BASEADDR + MCS_IO_INST_OFFSET_PGU // not used
//#define ADRS_BASE_MHVSU     XPAR_IOMODULE_0_IO_BASEADDR + MCS_IO_INST_OFFSET_EXT // not used
//#define ADRS_BASE_EXT_CMU       XPAR_IOMODULE_0_IO_BASEADDR + MCS_IO_INST_OFFSET_EXT_CMU
//#define ADRS_BASE_EXT_PGU       XPAR_IOMODULE_0_IO_BASEADDR + MCS_IO_INST_OFFSET_EXT_PGU
//#define ADRS_BASE_EXT_S3100     XPAR_IOMODULE_0_IO_BASEADDR + MCS_IO_INST_OFFSET_EXT_S3100
#define ADRS_BASE_EXT_S3100_PGU   XPAR_IOMODULE_0_IO_BASEADDR + MCS_IO_INST_OFFSET_EXT_S3100_PGU

//#define MCS_EP_BASE         ADRS_BASE_EXT_PGU       // S3000-PGU
//#define MCS_EP_BASE         ADRS_BASE_EXT_S3100     // S3100-CPU-BASE
#define MCS_EP_BASE           ADRS_BASE_EXT_S3100_PGU // S3100-PGU

//}


// TODO: common offset for end point address //{

// ADRS_PORT_WI_xx_OFST ... //{ 
#define ADRS_PORT_WI_00_OFST     0x00000000 // output wire [31:0] 
#define ADRS_PORT_WI_01_OFST     0x00000010 // output wire [31:0] 
#define ADRS_PORT_WI_02_OFST     0x00000020 // output wire [31:0]
#define ADRS_PORT_WI_03_OFST     0x00000030 // output wire [31:0] 
#define ADRS_PORT_WI_04_OFST     0x00000040 // output wire [31:0] 
#define ADRS_PORT_WI_05_OFST     0x00000050 // output wire [31:0] 
#define ADRS_PORT_WI_06_OFST     0x00000060 // output wire [31:0] 
#define ADRS_PORT_WI_07_OFST     0x00000070 // output wire [31:0] 
#define ADRS_PORT_WI_08_OFST     0x00000080 // output wire [31:0]
#define ADRS_PORT_WI_09_OFST     0x00000090 // output wire [31:0]
#define ADRS_PORT_WI_0A_OFST     0x000000A0 // output wire [31:0]
#define ADRS_PORT_WI_0B_OFST     0x000000B0 // output wire [31:0]
#define ADRS_PORT_WI_0C_OFST     0x000000C0 // output wire [31:0]
#define ADRS_PORT_WI_0D_OFST     0x000000D0 // output wire [31:0]
#define ADRS_PORT_WI_0E_OFST     0x000000E0 // output wire [31:0]
#define ADRS_PORT_WI_0F_OFST     0x000000F0 // output wire [31:0]
#define ADRS_PORT_WI_10_OFST     0x00000100 // output wire [31:0]
#define ADRS_PORT_WI_11_OFST     0x00000110 // output wire [31:0]
#define ADRS_PORT_WI_12_OFST     0x00000120 // output wire [31:0]
#define ADRS_PORT_WI_13_OFST     0x00000130 // output wire [31:0]
#define ADRS_PORT_WI_14_OFST     0x00000140 // output wire [31:0]
#define ADRS_PORT_WI_15_OFST     0x00000150 // output wire [31:0]
#define ADRS_PORT_WI_16_OFST     0x00000160 // output wire [31:0]
#define ADRS_PORT_WI_17_OFST     0x00000170 // output wire [31:0]
#define ADRS_PORT_WI_18_OFST     0x00000180 // output wire [31:0]
#define ADRS_PORT_WI_19_OFST     0x00000190 // output wire [31:0]
#define ADRS_PORT_WI_1A_OFST     0x000001A0 // output wire [31:0]
#define ADRS_PORT_WI_1B_OFST     0x000001B0 // output wire [31:0]
#define ADRS_PORT_WI_1C_OFST     0x000001C0 // output wire [31:0]
#define ADRS_PORT_WI_1D_OFST     0x000001D0 // output wire [31:0]
#define ADRS_PORT_WI_1E_OFST     0x000001E0 // output wire [31:0]
#define ADRS_PORT_WI_1F_OFST     0x000001F0 // output wire [31:0]
//}

// ADRS_PORT_WO_xx_OFST ... //{
#define ADRS_PORT_WO_20_OFST     0x00000200 // input wire [31:0]
#define ADRS_PORT_WO_21_OFST     0x00000210 // input wire [31:0]
#define ADRS_PORT_WO_22_OFST     0x00000220 // input wire [31:0]
#define ADRS_PORT_WO_23_OFST     0x00000230 // input wire [31:0]
#define ADRS_PORT_WO_24_OFST     0x00000240 // input wire [31:0]
#define ADRS_PORT_WO_25_OFST     0x00000250 // input wire [31:0]
#define ADRS_PORT_WO_26_OFST     0x00000260 // input wire [31:0]
#define ADRS_PORT_WO_27_OFST     0x00000270 // input wire [31:0]
#define ADRS_PORT_WO_28_OFST     0x00000280 // input wire [31:0]
#define ADRS_PORT_WO_29_OFST     0x00000290 // input wire [31:0]
#define ADRS_PORT_WO_2A_OFST     0x000002A0 // input wire [31:0]
#define ADRS_PORT_WO_2B_OFST     0x000002B0 // input wire [31:0]
#define ADRS_PORT_WO_2C_OFST     0x000002C0 // input wire [31:0]
#define ADRS_PORT_WO_2D_OFST     0x000002D0 // input wire [31:0]
#define ADRS_PORT_WO_2E_OFST     0x000002E0 // input wire [31:0]
#define ADRS_PORT_WO_2F_OFST     0x000002F0 // input wire [31:0]
#define ADRS_PORT_WO_30_OFST     0x00000300 // input wire [31:0]
#define ADRS_PORT_WO_31_OFST     0x00000310 // input wire [31:0]
#define ADRS_PORT_WO_32_OFST     0x00000320 // input wire [31:0]
#define ADRS_PORT_WO_33_OFST     0x00000330 // input wire [31:0]
#define ADRS_PORT_WO_34_OFST     0x00000340 // input wire [31:0]
#define ADRS_PORT_WO_35_OFST     0x00000350 // input wire [31:0]
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
#define ADRS_PORT_PI_9D_OFST     0x000009D0 // output wire, output wire [31:0]
#define ADRS_PORT_PI_9E_OFST     0x000009E0 // output wire, output wire [31:0]
#define ADRS_PORT_PI_9F_OFST     0x000009F0 // output wire, output wire [31:0]
//}

// ADRS_PORT_PO_xx_OFST ... //{
#define ADRS_PORT_PO_A0_OFST     0x00000A00 // output wire, input wire [31:0]
#define ADRS_PORT_PO_A1_OFST     0x00000A10 // output wire, input wire [31:0]
#define ADRS_PORT_PO_A2_OFST     0x00000A20 // output wire, input wire [31:0]
#define ADRS_PORT_PO_A3_OFST     0x00000A30 // output wire, input wire [31:0]
#define ADRS_PORT_PO_A4_OFST     0x00000A40 // output wire, input wire [31:0]
#define ADRS_PORT_PO_A5_OFST     0x00000A50 // output wire, input wire [31:0]
#define ADRS_PORT_PO_A6_OFST     0x00000A60 // output wire, input wire [31:0]
#define ADRS_PORT_PO_A7_OFST     0x00000A70 // output wire, input wire [31:0]
#define ADRS_PORT_PO_A8_OFST     0x00000A80 // output wire, input wire [31:0]
#define ADRS_PORT_PO_A9_OFST     0x00000A90 // output wire, input wire [31:0]
#define ADRS_PORT_PO_AA_OFST     0x00000AA0 // output wire, input wire [31:0]
#define ADRS_PORT_PO_AB_OFST     0x00000AB0 // output wire, input wire [31:0]
#define ADRS_PORT_PO_AC_OFST     0x00000AC0 // output wire, input wire [31:0]
#define ADRS_PORT_PO_AD_OFST     0x00000AD0 // output wire, input wire [31:0]
#define ADRS_PORT_PO_AE_OFST     0x00000AE0 // output wire, input wire [31:0]
#define ADRS_PORT_PO_AF_OFST     0x00000AF0 // output wire, input wire [31:0]
#define ADRS_PORT_PO_B0_OFST     0x00000B00 // output wire, input wire [31:0]
#define ADRS_PORT_PO_B1_OFST     0x00000B10 // output wire, input wire [31:0]
#define ADRS_PORT_PO_B2_OFST     0x00000B20 // output wire, input wire [31:0]
#define ADRS_PORT_PO_B3_OFST     0x00000B30 // output wire, input wire [31:0]
#define ADRS_PORT_PO_B4_OFST     0x00000B40 // output wire, input wire [31:0]
#define ADRS_PORT_PO_B5_OFST     0x00000B50 // output wire, input wire [31:0]
#define ADRS_PORT_PO_B6_OFST     0x00000B60 // output wire, input wire [31:0]
#define ADRS_PORT_PO_B7_OFST     0x00000B70 // output wire, input wire [31:0]
#define ADRS_PORT_PO_B8_OFST     0x00000B80 // output wire, input wire [31:0]
#define ADRS_PORT_PO_B9_OFST     0x00000B90 // output wire, input wire [31:0]
#define ADRS_PORT_PO_BA_OFST     0x00000BA0 // output wire, input wire [31:0]
#define ADRS_PORT_PO_BB_OFST     0x00000BB0 // output wire, input wire [31:0]
#define ADRS_PORT_PO_BC_OFST     0x00000BC0 // output wire, input wire [31:0]
#define ADRS_PORT_PO_BD_OFST     0x00000BD0 // output wire, input wire [31:0]
#define ADRS_PORT_PO_BE_OFST     0x00000BE0 // output wire, input wire [31:0]
#define ADRS_PORT_PO_BF_OFST     0x00000BF0 // output wire, input wire [31:0]
//}

//// dedicated lan interface //{
	
// 'b_0000_XXHH_hhxx_xx00
//
//         1100 (C)
//         1101 (D)
//         1110 (E)
//         
// 'b_0000_1100_00xx_xx00 -- LAN_WI_00
// 'b_0000_1100_01xx_xx00 -- LAN_WI_10
// 'b_0000_1100_10xx_xx00 -- LAN_WO_20
// 'b_0000_1100_11xx_xx00 -- LAN_WO_30
// 'b_0000_1101_00xx_xx00 -- LAN_TI_40
// 'b_0000_1101_01xx_xx00 -- LAN_TI_50
// 'b_0000_1101_10xx_xx00 -- LAN_TO_60
// 'b_0000_1101_11xx_xx00 -- LAN_TO_70
// 'b_0000_1110_00xx_xx00 -- LAN_PI_80
// 'b_0000_1110_01xx_xx00 -- LAN_PI_90
// 'b_0000_1110_10xx_xx00 -- LAN_PO_A0
// 'b_0000_1110_11xx_xx00 -- LAN_PO_B0

#define ADRS_LAN_WI_00_OFST      0x00000C00 // output wire [31:0]
#define ADRS_LAN_WI_01_OFST      0x00000C04 // output wire [31:0]
#define ADRS_LAN_WO_20_OFST      0x00000C80 // input wire [31:0]
#define ADRS_LAN_WO_21_OFST      0x00000C84 // input wire [31:0]
#define ADRS_LAN_TI_40_OFST      0x00000D00 // input wire, output wire [31:0],
#define ADRS_LAN_TI_41_OFST      0x00000D04 // input wire, output wire [31:0],
#define ADRS_LAN_TO_60_OFST      0x00000D80 // input wire, input wire [31:0],
#define ADRS_LAN_TO_61_OFST      0x00000D84 // input wire, input wire [31:0],
#define ADRS_LAN_PI_80_OFST      0x00000E00 // output wire, output wire [31:0],
#define ADRS_LAN_PI_81_OFST      0x00000E04 // output wire, output wire [31:0],
#define ADRS_LAN_PO_A0_OFST      0x00000E80 // output wire, input wire [31:0],
#define ADRS_LAN_PO_A1_OFST      0x00000E84 // output wire, input wire [31:0],
//
#define ADRS_FPGA_IMAGE_OFST     0x00000F00 // image id
#define ADRS_TEST_REG___OFST     0x00000F04 // test reg 
#define ADRS_MASK_ALL___OFST     0x00000F08 // mask all //$$
#define ADRS_MASK_WI____OFST     0x00000F10 // mask
#define ADRS_MASK_WO____OFST     0x00000F14 // mask
#define ADRS_MASK_TI____OFST     0x00000F18 // mask
#define ADRS_MASK_TO____OFST     0x00000F1C // mask	
//
#define ADRS_LAN_CONF_00_OFST    0x00000FC0 //input  wire [31:0]   i_lan_conf_00  // (BASE_ADRS_IP_32B  + i_adrs_offset_ip_32b )
#define ADRS_LAN_CONF_01_OFST    0x00000FC4 //input  wire [31:0]   i_lan_conf_01  // (BASE_ADRS_MAC_48B[31: 0] + i_adrs_offset_mac_48b[31: 0] )
#define ADRS_LAN_CONF_02_OFST    0x00000FC8 //input  wire [31:0]   i_lan_conf_02  // ( {16'b0,BASE_ADRS_MAC_48B[47:32]} + {16'b0,i_adrs_offset_mac_48b[47:32]} )
#define ADRS_LAN_CONF_03_OFST    0x00000FCC //input  wire [31:0]   i_lan_conf_03  // ( i_lan_timeout_rtr_16b , i_lan_timeout_rcr_16b )
//

//}

//}


// TODO: ADRS_PORT_xx and ADRS_LAN_xx with MCS_EP_BASE //{
	
// ADRS_PORT_WI_xx ... //{
#define ADRS_PORT_WI_00     MCS_EP_BASE + ADRS_PORT_WI_00_OFST // output wire [31:0]
#define ADRS_PORT_WI_01     MCS_EP_BASE + ADRS_PORT_WI_01_OFST // output wire [31:0]
#define ADRS_PORT_WI_02     MCS_EP_BASE + ADRS_PORT_WI_02_OFST // output wire [31:0]
#define ADRS_PORT_WI_03     MCS_EP_BASE + ADRS_PORT_WI_03_OFST // output wire [31:0]
#define ADRS_PORT_WI_04     MCS_EP_BASE + ADRS_PORT_WI_04_OFST // output wire [31:0]
#define ADRS_PORT_WI_05     MCS_EP_BASE + ADRS_PORT_WI_05_OFST // output wire [31:0]
#define ADRS_PORT_WI_06     MCS_EP_BASE + ADRS_PORT_WI_06_OFST // output wire [31:0]
#define ADRS_PORT_WI_07     MCS_EP_BASE + ADRS_PORT_WI_07_OFST // output wire [31:0]
#define ADRS_PORT_WI_08     MCS_EP_BASE + ADRS_PORT_WI_08_OFST // output wire [31:0]
#define ADRS_PORT_WI_09     MCS_EP_BASE + ADRS_PORT_WI_09_OFST // output wire [31:0]
#define ADRS_PORT_WI_0A     MCS_EP_BASE + ADRS_PORT_WI_0A_OFST // output wire [31:0]
#define ADRS_PORT_WI_0B     MCS_EP_BASE + ADRS_PORT_WI_0B_OFST // output wire [31:0]
#define ADRS_PORT_WI_0C     MCS_EP_BASE + ADRS_PORT_WI_0C_OFST // output wire [31:0]
#define ADRS_PORT_WI_0D     MCS_EP_BASE + ADRS_PORT_WI_0D_OFST // output wire [31:0]
#define ADRS_PORT_WI_0E     MCS_EP_BASE + ADRS_PORT_WI_0E_OFST // output wire [31:0]
#define ADRS_PORT_WI_0F     MCS_EP_BASE + ADRS_PORT_WI_0F_OFST // output wire [31:0]
#define ADRS_PORT_WI_10     MCS_EP_BASE + ADRS_PORT_WI_10_OFST // output wire [31:0]
#define ADRS_PORT_WI_11     MCS_EP_BASE + ADRS_PORT_WI_11_OFST // output wire [31:0]
#define ADRS_PORT_WI_12     MCS_EP_BASE + ADRS_PORT_WI_12_OFST // output wire [31:0]
#define ADRS_PORT_WI_13     MCS_EP_BASE + ADRS_PORT_WI_13_OFST // output wire [31:0]
#define ADRS_PORT_WI_14     MCS_EP_BASE + ADRS_PORT_WI_14_OFST // output wire [31:0]
#define ADRS_PORT_WI_15     MCS_EP_BASE + ADRS_PORT_WI_15_OFST // output wire [31:0]
#define ADRS_PORT_WI_16     MCS_EP_BASE + ADRS_PORT_WI_16_OFST // output wire [31:0]
#define ADRS_PORT_WI_17     MCS_EP_BASE + ADRS_PORT_WI_17_OFST // output wire [31:0]
#define ADRS_PORT_WI_18     MCS_EP_BASE + ADRS_PORT_WI_18_OFST // output wire [31:0]
#define ADRS_PORT_WI_19     MCS_EP_BASE + ADRS_PORT_WI_19_OFST // output wire [31:0]
#define ADRS_PORT_WI_1A     MCS_EP_BASE + ADRS_PORT_WI_1A_OFST // output wire [31:0]
#define ADRS_PORT_WI_1B     MCS_EP_BASE + ADRS_PORT_WI_1B_OFST // output wire [31:0]
#define ADRS_PORT_WI_1C     MCS_EP_BASE + ADRS_PORT_WI_1C_OFST // output wire [31:0]
#define ADRS_PORT_WI_1D     MCS_EP_BASE + ADRS_PORT_WI_1D_OFST // output wire [31:0]
#define ADRS_PORT_WI_1E     MCS_EP_BASE + ADRS_PORT_WI_1E_OFST // output wire [31:0]
#define ADRS_PORT_WI_1F     MCS_EP_BASE + ADRS_PORT_WI_1F_OFST // output wire [31:0]
//}

// ADRS_PORT_WO_xx ... //{
#define ADRS_PORT_WO_20     MCS_EP_BASE + ADRS_PORT_WO_20_OFST // input wire [31:0]
#define ADRS_PORT_WO_21     MCS_EP_BASE + ADRS_PORT_WO_21_OFST // input wire [31:0]
#define ADRS_PORT_WO_22     MCS_EP_BASE + ADRS_PORT_WO_22_OFST // input wire [31:0]
#define ADRS_PORT_WO_23     MCS_EP_BASE + ADRS_PORT_WO_23_OFST // input wire [31:0]
#define ADRS_PORT_WO_24     MCS_EP_BASE + ADRS_PORT_WO_24_OFST // input wire [31:0]
#define ADRS_PORT_WO_25     MCS_EP_BASE + ADRS_PORT_WO_25_OFST // input wire [31:0]
#define ADRS_PORT_WO_26     MCS_EP_BASE + ADRS_PORT_WO_26_OFST // input wire [31:0]
#define ADRS_PORT_WO_27     MCS_EP_BASE + ADRS_PORT_WO_27_OFST // input wire [31:0]
#define ADRS_PORT_WO_28     MCS_EP_BASE + ADRS_PORT_WO_28_OFST // input wire [31:0]
#define ADRS_PORT_WO_29     MCS_EP_BASE + ADRS_PORT_WO_29_OFST // input wire [31:0]
#define ADRS_PORT_WO_2A     MCS_EP_BASE + ADRS_PORT_WO_2A_OFST // input wire [31:0]
#define ADRS_PORT_WO_2B     MCS_EP_BASE + ADRS_PORT_WO_2B_OFST // input wire [31:0]
#define ADRS_PORT_WO_2C     MCS_EP_BASE + ADRS_PORT_WO_2C_OFST // input wire [31:0]
#define ADRS_PORT_WO_2D     MCS_EP_BASE + ADRS_PORT_WO_2D_OFST // input wire [31:0]
#define ADRS_PORT_WO_2E     MCS_EP_BASE + ADRS_PORT_WO_2E_OFST // input wire [31:0]
#define ADRS_PORT_WO_2F     MCS_EP_BASE + ADRS_PORT_WO_2F_OFST // input wire [31:0]
#define ADRS_PORT_WO_30     MCS_EP_BASE + ADRS_PORT_WO_30_OFST // input wire [31:0]
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
#define ADRS_PORT_PO_B5     MCS_EP_BASE + ADRS_PORT_PO_B5_OFST // output wire, input wire [31:0],
#define ADRS_PORT_PO_B6     MCS_EP_BASE + ADRS_PORT_PO_B6_OFST // output wire, input wire [31:0],
#define ADRS_PORT_PO_B7     MCS_EP_BASE + ADRS_PORT_PO_B7_OFST // output wire, input wire [31:0],
#define ADRS_PORT_PO_B8     MCS_EP_BASE + ADRS_PORT_PO_B8_OFST // output wire, input wire [31:0],
#define ADRS_PORT_PO_B9     MCS_EP_BASE + ADRS_PORT_PO_B9_OFST // output wire, input wire [31:0],
#define ADRS_PORT_PO_BA     MCS_EP_BASE + ADRS_PORT_PO_BA_OFST // output wire, input wire [31:0],
#define ADRS_PORT_PO_BB     MCS_EP_BASE + ADRS_PORT_PO_BB_OFST // output wire, input wire [31:0],
#define ADRS_PORT_PO_BC     MCS_EP_BASE + ADRS_PORT_PO_BC_OFST // output wire, input wire [31:0],
#define ADRS_PORT_PO_BD     MCS_EP_BASE + ADRS_PORT_PO_BD_OFST // output wire, input wire [31:0],
#define ADRS_PORT_PO_BE     MCS_EP_BASE + ADRS_PORT_PO_BE_OFST // output wire, input wire [31:0],
#define ADRS_PORT_PO_BF     MCS_EP_BASE + ADRS_PORT_PO_BF_OFST // output wire, input wire [31:0],
//}


//// dedicated lan interface: //{

// 'b_0000_XXHH_hhxx_xx00
//
//         1100 (C)
//         1101 (D)
//         1110 (E)
//         
// 'b_0000_1100_00xx_xx00 -- LAN_WI_00
// 'b_0000_1100_01xx_xx00 -- LAN_WI_10
// 'b_0000_1100_10xx_xx00 -- LAN_WO_20
// 'b_0000_1100_11xx_xx00 -- LAN_WO_30
// 'b_0000_1101_00xx_xx00 -- LAN_TI_40
// 'b_0000_1101_01xx_xx00 -- LAN_TI_50
// 'b_0000_1101_10xx_xx00 -- LAN_TO_60
// 'b_0000_1101_11xx_xx00 -- LAN_TO_70
// 'b_0000_1110_00xx_xx00 -- LAN_PI_80
// 'b_0000_1110_01xx_xx00 -- LAN_PI_90
// 'b_0000_1110_10xx_xx00 -- LAN_PO_A0
// 'b_0000_1110_11xx_xx00 -- LAN_PO_B0
//
#define ADRS_LAN_WI_00      MCS_EP_BASE + ADRS_LAN_WI_00_OFST // output wire [31:0]
#define ADRS_LAN_WI_01      MCS_EP_BASE + ADRS_LAN_WI_01_OFST // output wire [31:0]
#define ADRS_LAN_WO_20      MCS_EP_BASE + ADRS_LAN_WO_20_OFST // input wire [31:0]
#define ADRS_LAN_WO_21      MCS_EP_BASE + ADRS_LAN_WO_21_OFST // input wire [31:0]
#define ADRS_LAN_TI_40      MCS_EP_BASE + ADRS_LAN_TI_40_OFST // input wire, output wire [31:0],
#define ADRS_LAN_TI_41      MCS_EP_BASE + ADRS_LAN_TI_41_OFST // input wire, output wire [31:0],
#define ADRS_LAN_TO_60      MCS_EP_BASE + ADRS_LAN_TO_60_OFST // input wire, input wire [31:0],
#define ADRS_LAN_TO_61      MCS_EP_BASE + ADRS_LAN_TO_61_OFST // input wire, input wire [31:0],
#define ADRS_LAN_PI_80      MCS_EP_BASE + ADRS_LAN_PI_80_OFST // output wire, output wire [31:0],
#define ADRS_LAN_PI_81      MCS_EP_BASE + ADRS_LAN_PI_81_OFST // output wire, output wire [31:0],
#define ADRS_LAN_PO_A0      MCS_EP_BASE + ADRS_LAN_PO_A0_OFST // output wire, input wire [31:0],
#define ADRS_LAN_PO_A1      MCS_EP_BASE + ADRS_LAN_PO_A1_OFST // output wire, input wire [31:0],
//
#define ADRS_FPGA_IMAGE     MCS_EP_BASE + ADRS_FPGA_IMAGE_OFST // image id
#define ADRS_TEST_REG__     MCS_EP_BASE + ADRS_TEST_REG___OFST // test reg 
#define ADRS_MASK_ALL__     MCS_EP_BASE + ADRS_MASK_ALL___OFST // mask all //$$
#define ADRS_MASK_WI___     MCS_EP_BASE + ADRS_MASK_WI____OFST // mask for port IO
#define ADRS_MASK_WO___     MCS_EP_BASE + ADRS_MASK_WO____OFST // mask for port IO
#define ADRS_MASK_TI___     MCS_EP_BASE + ADRS_MASK_TI____OFST // mask for port IO
#define ADRS_MASK_TO___     MCS_EP_BASE + ADRS_MASK_TO____OFST // mask for port IO
//
#define ADRS_LAN_CONF_00    MCS_EP_BASE + ADRS_LAN_CONF_00_OFST //input  wire [31:0]   i_lan_conf_00  // (BASE_ADRS_IP_32B  + i_adrs_offset_ip_32b )
#define ADRS_LAN_CONF_01    MCS_EP_BASE + ADRS_LAN_CONF_01_OFST //input  wire [31:0]   i_lan_conf_01  // (BASE_ADRS_MAC_48B[31: 0] + i_adrs_offset_mac_48b[31: 0] )
#define ADRS_LAN_CONF_02    MCS_EP_BASE + ADRS_LAN_CONF_02_OFST //input  wire [31:0]   i_lan_conf_02  // ( {16'b0,BASE_ADRS_MAC_48B[47:32]} + {16'b0,i_adrs_offset_mac_48b[47:32]} )
#define ADRS_LAN_CONF_03    MCS_EP_BASE + ADRS_LAN_CONF_03_OFST //input  wire [31:0]   i_lan_conf_03  // ( i_lan_timeout_rtr_16b , i_lan_timeout_rcr_16b )
//

//}
	
//}


// parameters common //{
#define MASK_ALL                      0xFFFFFFFF
//}

// TODO: S3100 endpoints adrs //{

#ifdef _S3100_PGU_
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
