lastoyz/dsn_pgu_adda_s3100_git/txem7310_pll/txem7310_pll.srcs/sources_1/imports/src_ref/tb_xem7310_top.v

`timescale 1ns / 1ps
//////////////////////////////////////////////////////////////////////////////////
// Module Name: tb_xem7310_top
//  simulation testbench to call top file
//  just to see code correctness...
//
// http://www.asic-world.com/verilog/art_testbench_writing1.html
// http://www.asic-world.com/verilog/art_testbench_writing2.html
// https://www.xilinx.com/support/documentation/sw_manuals/xilinx2016_1/ug937-vivado-design-suite-simulation-tutorial.pdf
//
//////////////////////////////////////////////////////////////////////////////////


module tb_xem7310_top;
reg clk; // assume 10MHz or 100ns
reg reset_n;
reg en;
//
reg clk_osc; //$$ 5ns for external osc 200MHz
//
reg clk_bus; //$$ 9.92ns for USB3.0	
//
reg init;
reg update;
reg test;
reg [31:0] test_sdi_pdata;
wire [31:0] test_sdo_pdata;
//
reg [31:0] r_sdo;
wire sdo = r_sdo[31];
wire sclk;

// test loopback
wire w_loopback_p;
wire w_loopback_n;

// DUT
xem7310__cmu_cpu__top  xem7310_inst ( // test for CMU-CPU-TEST-F5500
//xem7310__serdes_reg_quad_test__top xem7310_inst ( // test for CMU-1MHZ-SUB
//xem7310__cmu_1MHz_sub__top xem7310_inst ( // test for CMU-1MHZ-SUB
	//
	.sys_clkp         (clk_osc),
	.sys_clkn         (~clk_osc),
	//
	//
	.o_B34D_L21P      (w_loopback_p),       //$$ ADC_XX_CNV_P
	.o_B34D_L21N      (w_loopback_n),       //$$ ADC_XX_CNV_N
	//
	.i_B35D_L12P_MRCC (w_loopback_p),   //$$ OSC_IN_P // DAC_DCO_P
	.i_B35D_L12N_MRCC (w_loopback_n),   //$$ OSC_IN_N // DAC_DCO_N
	//
	.led()
);

// force signals
initial begin
#0_000 	force tb_xem7310_top.xem7310_inst.sys_clkp = 1'b0;	
#1_000 	release tb_xem7310_top.xem7310_inst.sys_clkp; // 1us
end
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
