lastoyz/dsn_pgu_adda_s3100_git/(commit log)

2021-04-14 up pin assign
2021-04-20 add img test // spi test // inital debug setup
2021-04-20 add test eps // up MSPI wires
2021-04-22 up test spi frame
2021-05-20 up s3100-pgu pin map io buf
2021-06-02 up // test MTH spi comment out // synth error issue
    [debug_net.xdc, txem7310_pll__s3100_sv_pgu__top.v]
2021-06-03 up xdc // fix timing
    [txem7310_pll__s3100_sv_pgu__top.xdc]
2021-06-11 up // S3100-PGU MTH slave SPI frame address map
2021-06-15 add new ports in slave spi
2021-06-15 up test img mth spi emulation
2021-06-15 up test // lan eeprom setup // led/dac/adc powers check on S3100-PGU
2021-06-18 add py // test for spi // draft
2021-06-25 up c# lib // spi emul to come
2021-06-27 up c# lib // spi emul wireout done
2021-06-28 up logic // revise spi emulation mode // drfat for eeprom only
2021-06-28 up logic // spi emulation // test fifo revised
2021-06-28 up logic // spi emulation // test fifo revised // debug
2021-06-28 rev logic // spi emulation // draft
2021-06-29 up logic // spi endpoint switch debug
2021-06-29 add img // spi emulation test done
2021-07-02 up img // spi emul revision
2021-07-14 rev xsdk // dac power control seq
2021-07-28 up img test // rev slave spi
2021-08-18 add ref sch
    [HVPGU-210302-TOP_VER1_3.DSN]
2021-08-18 add dsn
    [CMU_CPU_F5500_r190510__DEBUG_0709.DSN]
2021-08-20 add sch art ref for fpga module
    [FPGA_MODULE_V11_20200812-4M.DSN]
2021-08-24 up ip clock for adc
2021-08-24 up ep wires
2021-08-25 up adc dual sim // draft
2021-09-07 up sim // up top // slave spi miso timing 5-bit step
2021-09-07 add sim // adc model
2021-09-08 up sim // add adc controller // bug
    [adc_wrapper.v, txem7310_pll__s3100_sv_adda__top.v]
2021-09-09 up sim // adc test model
2021-09-09 up sim // adc controller test done // slave spi cowork to come
2021-09-09 rev adc control for dual mode
2021-09-09 up sspi adc sim // draft
2021-09-14 up sim // adc sspi
2021-09-14 up sim // adc sspi cowork done
2021-09-14 up top // adc io
2021-09-14 up top // adc sspi
2021-09-15 up xdc // adc clocks
2021-09-15 up adc clock xdc
2021-09-15 up adc debug net
2021-09-16 up xdc debug adc delay input
2021-09-16 add img h_A6_21_0915 // adc fifo test // dft test to come
2021-09-16 add sdk for S3100-ADDA // new pinmap to come // adc test
2021-09-23 up adc xdc // up test adc
2021-09-24 add img test // h_A6_21_0923 // adc test done // DFT logic to come
2021-09-24 up logic // adc fifo reading clock mux
2021-09-28 add img test // h_A6_21_0928 // // rev adc fifo read latency one with fifo FWFT.
2021-09-29 up test code // adc data log // draft
2021-09-30 up // add adc float
2021-09-30 up // add relay control
2021-10-01 up // adc 18bit plot
2021-10-01 fix adc line swap
    [control_adc_ddr_two_lane_LTC2387_reg_serdes_dual.v, txem7310_pll__s3100_sv_adda__top.v]
2021-10-08 up // adc base clock test 210 --> 189MHz
2021-10-08 add img test // h_A6_21_1008 // adc base freq test 210MHz --> 189MHz
2021-10-08 up cs code // back to normal setup for adc 100kHz test
2021-10-08 up logic // adc base clock switch
2021-10-19 add adc base freq switch
2021-10-19 up xdc // alt clock for adc
2021-10-20 add img test // h_A6_21_1019; // S3100-ADDA // adc base freq support 210MHz, 189MHz; fifo for 63MHz.
2021-10-21 add S3100-ADDA class using SPI emulation
2021-10-26 up dac adc macro done // DFT cal to come
2021-10-27 add test case // 1kHz normal sampling
2021-10-28 up test code // S3100 slot selection
2021-10-28 rev edf log // adc data in use
2021-11-26 add ref code // TSPACE for S3000-PGU // to test it with S3100-PGU-ADDA
    [BJT_IcVc.csv, CMU1.csv, CMU2.csv, IGZO_350_1.csv, IGZO_350_2.csv, IGZO_350_3.csv, IGZO_350_4.csv, NMOS_Id-Vg3.csv]
2021-11-26 up sdk // revise PGU TRIG scpi command for S3100-ADDA dac-adc-linked triiger
    [Sta2CLI.cfg]
2021-11-26 up // NG tlan eps disabled.
    [Sta2CLI - 복사본.cfg, Sta2CLI.cfg]
2021-11-27 rev logic // adc en always // only reset works.
    [debug_cores.xdc, debug_net.xdc, txem7310_pll__s3100_sv_adda__top.v]
2021-11-29 up img // h_A6_21_1129
    [Sta2CLI.cfg]
2021-12-12 up tspace
    [2021.04.16.WY_C-CYTOP_100 10min.csv, 2021.04.16.WY_C-CYTOP_100 10min_200 1h.csv, 2021.04.16.WY_C-CYTOP_100 10min_350 1h.csv, 2021.04.16.WY_CYTOP_100 10min.csv, 2021.04.16.WY_CYTOP_100 10min_200 1h.csv, 2021.04.16.WY_CYTOP_100 10min_350 1h.csv, BJT_IcVc.csv, CMU1.csv]
2021-12-13 up test // dac range and resolution
    [Sta2CLI.cfg]
2021-12-14 up img test // h_A6_21_1214
    [Sta2CLI.cfg]
2021-12-14 up img // rev dac pin map
2021-12-16 add new heat spreader for fpga ic // draft
2021-12-16 up dim // heat spreader
2021-12-27 add arm fw ref code
2021-12-28 up MSPI frame trigger with fifo
2021-12-28 add base code for ARM FW style CMU-ADDA
2021-12-28 up scan slot
2021-12-29 up fifo frame trigger // eeprom test done
2021-12-30 up dsn files
    [CPU_CORE_CORTEX_M7_BOM_2021_1201.xlsx, S3100_CPU_BASE_VER1.0_SCH_210818_BOM_OPMODE 수정.xlsx, fpga_hs_top__rev_b1.skp, fpga_hs_top__rev_b1.stp]
2021-12-30 up // test on spi emul
2022-01-05 up test setup for 10us pulse TSPACE ADC cowork
    [Sta2CLI.cfg]
2022-01-05 up I_CMU // dac adc test done.
2022-01-07 up // test code // 500kHz cmu case done
