lastoyz/dsn_pgu_adda_s3100_git/(notices)

Notices in the files:
fw_arm_c/02_Library/04_ThirdParty/LwIP/src/include/lwip/opt.h:
Copyright (c) 2001-2004 Swedish Institute of Computer Science.
All rights reserved.
